aspro648/KiCad/README.md

# KiCad
My design files. Abandon all hope ye who enter here.
