aspro648/KiCad/projects/translator/README.md

ISP Translator
----------------

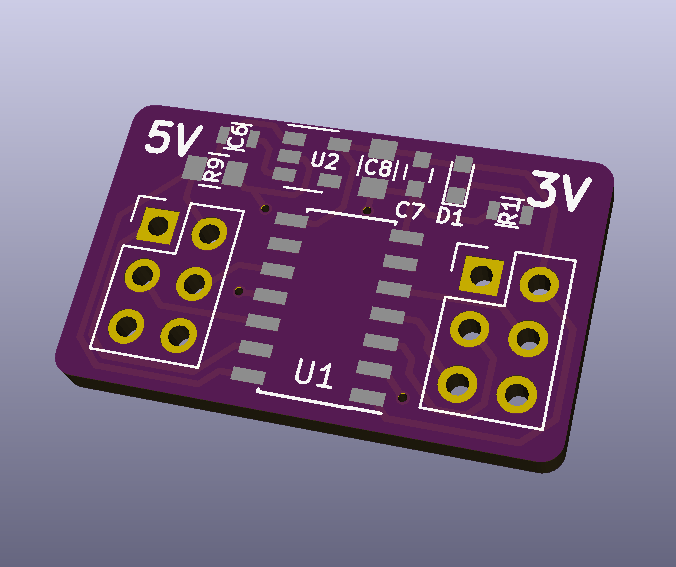
[picture p6: projects/translator/images/project.png]
 
Intro

Bill Of Materials
----------------
  
- 1 ea., Perfect Purple PCB from OSH Park, with not so perfect layout from [design_files](design_files/) folder.
- 1 ea., U1, IC TRNSLTR BIDIRECTIONAL 14SOIC, TI TXB0104D, https://www.digikey.com/short/j5d3ph
- 1 ea., U2, IC REG LINEAR 3.3V 150MA SOT23-5, MIC5225-3.3YM5-TR, https://www.digikey.com/short/jb2rq8
- 2 ea., C1, C3, 10uF SMD 0805, https://www.digikey.com/short/j5d39w 
- 1 ea., C2 1uF SMD 0603, https://www.digikey.com/short/j5d397
- 1 ea., R1, RES SMD 330 OHM 5% 1/10W 0603, Yageo RC0603JR-07330RL, https://www.digikey.com/short/3wzz20
- 1 ea., R2, 100K ohm 0603 SMD resistor, https://www.digikey.com/short/j5d3b3
- 1 ea., D1, 603 SMD LED amber, https://www.digikey.com/short/j5h3h5
- 2 ea., CON1, CON2, CONN HEADER 6POS .100 STR TIN, http://www.digikey.com/short/3m33n0
- 2 ea., CONN SOCKET IDC 6POS DL SR 30AU, https://www.digikey.com/short/71rdpt
- ribbon cable

Design Files
----------------
This project is designed using Open Source [KiCad](http://kicad-pcb.org/). Design files are located in the [design_files](design_files/) folder.  You can oogle the [schematic](docs/project.sch.pdf).

Firmware
----------------
TBD

Assembly Instructions
----------------
TBD

License
----------------
[Attribution-ShareAlike 3.0 United States (CC BY-SA 3.0 US)](https://creativecommons.org/licenses/by-sa/3.0/us/)

You are free to:

- Share — copy and redistribute the material in any medium or format
- Adapt — remix, transform, and build upon the material

Under the following terms:

- Attribution — You must give appropriate credit, provide a link to the license, and indicate if changes were made. You may do so in any reasonable manner, but not in any way that suggests the licensor endorses you or your use.
- ShareAlike — If you remix, transform, or build upon the material, you must distribute your contributions under the same license as the original.
