aspro648/KiCad/projects/Beetje/design_files_SD_card/readme.md

Beetje Blok SD Card Rev 0.0

Project website: https://hackaday.io/project/160638-beetje-bloks

Project website: https://hackaday.io/project/160638-beetje-bloks

https://learn.adafruit.com/adafruit-micro-sd-breakout-board-card-tutorial?view=all

Bill Of Materials
----------------
  
- 1 ea., Perfect Purple PCB from OSH Park, with not so perfect layout from [design_files](design_files/) folder.
- 1 ea., J1 CONN MICRO SD CARD PUSH-PULL, Hirose DM3D-SF, https://www.digikey.com/short/jfh304
- 1 ea., C1 CAP CER 0.1UF 50V X7R 0805, https://www.digikey.com/short/j58qjp
- 1 ea., D1 LED 0805 SMD
- 1 ea., R1 RES 1K OHM 5% 0805, https://www.digikey.com/short/j2d0wt
- 1 ea., R2 10K SMD 0805, https://www.digikey.com/short/j2d0w4 
- 1 ea., CONN HEADER .100" SNGL STR 40POS, https://www.digikey.com/short/jfcn42
- 1 ea., 64-pin header(enough for 4.5 boards) Mill-max 311-43-164-41-001000, https://www.digikey.com/short/jnqdm2

License
----------------
[Attribution-ShareAlike 3.0 United States (CC BY-SA 3.0 US)](https://creativecommons.org/licenses/by-sa/3.0/us/)

You are free to:

- Share — copy and redistribute the material in any medium or format
- Adapt — remix, transform, and build upon the material

Under the following terms:

- Attribution — You must give appropriate credit, provide a link to the license, and indicate if changes were made. You may do so in any reasonable manner, but not in any way that suggests the licensor endorses you or your use.
- ShareAlike — If you remix, transform, or build upon the material, you must distribute your contributions under the same license as the original.
