aspro648/KiCad/projects/Beetje/design_files_OLED/readme.md

Beetje OLED

Beetje Block 

Project website: https://hackaday.io/project/160638-beetje-bloks

Based on SparkFun's [Micro OLED Breakout](https://www.sparkfun.com/products/13003)

Bill Of Materials
----------------

- 1 ea., Perfect Purple PCB from OSH Park, with not so perfect layout from [design_files](design_files/) folder.
- 1 ea., CrystalFonts display CFAL4864A, https://www.crystalfontz.com/product/cfal6448a066bw-64x48-small-graphic-oled
- 2 ea., R1, R2 RES 4K7 OHM 5% 0805, https://www.digikey.com/short/j2d0wd 
- 4 ea., R3 - R6 RES 10K OHM 5% 0805, 
- 1 ea., C1 CAP 1uF 0805, https://www.digikey.com/short/jwjfn1
- 2 ea., C2, C3 CAP CER 0.1UF 0805
- 1 ea., CONN FPC TOP 12POS 0.50MM R/A, TE 1-1734839-2, https://www.digikey.com/short/pzh9vc

Optional
----------------

- Headers

Revisions
------------------

License
----------------
[Attribution-ShareAlike 3.0 United States (CC BY-SA 3.0 US)](https://creativecommons.org/licenses/by-sa/3.0/us/)

You are free to:

- Share — copy and redistribute the material in any medium or format
- Adapt — remix, transform, and build upon the material

Under the following terms:

- Attribution — You must give appropriate credit, provide a link to the license, and indicate if changes were made. You may do so in any reasonable manner, but not in any way that suggests the licensor endorses you or your use.
- ShareAlike — If you remix, transform, or build upon the material, you must distribute your contributions under the same license as the original.
