aspro648/KiCad/projects/Beetje/design_files_EEPROM/readme.md

Beetje Blok Template

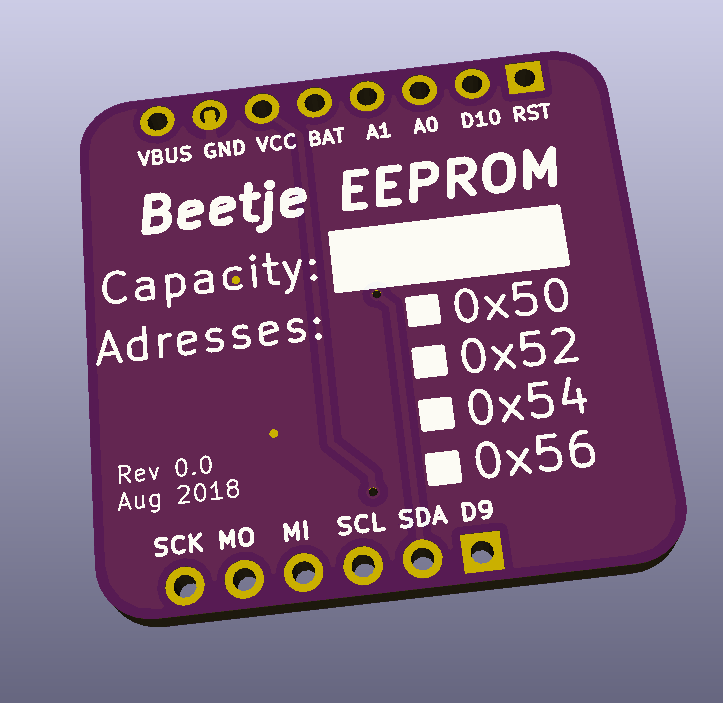
[picture p18: projects/Beetje/design_files_EEPROM/project.png]
Beetje Block


Based on https://jeelabs.org/2009/09/19/memory-plug-v1/

https://playground.arduino.cc/code/I2CEEPROM
https://www.instructables.com/id/Add-I2C-EEPROM-to-Arduino/
https://learn.sparkfun.com/tutorials/reading-and-writing-serial-eeproms

Bill Of Materials
----------------
  
- 1 ea., Perfect Purple PCB from OSH Park, with not so perfect layout from [project.kicad_pcb](project.kicad_pcb) file.
- 1 ea., C1 CAP CER 0.1UF 50V X7R 0805, https://www.digikey.com/short/j58qjp
- 1 ea., R1, R2 4K7 0805 SMD Resistor, https://www.digikey.com/short/j2d0wd

- 1 ea., U1, 24LC1025-I/SN-ND 1Mbit 8-SOIC, https://www.digikey.com/short/jwmp8v ($2.95), or
- 1 ea., U1, CAT24M01WI-GT3IC 1Mbit 8-SOIC, https://www.digikey.com/short/jwmpp7 ($1.33), or
RM24C512C FRAM 512K, https://www.digikey.com/short/jwmpqm ???
 or
- 1 ea., U1, IC EEPROM 1M I2C 400KHZ 8SOIC, https://www.digikey.com/short/jf10h0

Revisions
----------------
0.1 Sep 2018 Footprints from 0603 to 0805

License
----------------
[Attribution-ShareAlike 3.0 United States (CC BY-SA 3.0 US)](https://creativecommons.org/licenses/by-sa/3.0/us/)

You are free to:

- Share — copy and redistribute the material in any medium or format
- Adapt — remix, transform, and build upon the material

Under the following terms:

- Attribution — You must give appropriate credit, provide a link to the license, and indicate if changes were made. You may do so in any reasonable manner, but not in any way that suggests the licensor endorses you or your use.
- ShareAlike — If you remix, transform, or build upon the material, you must distribute your contributions under the same license as the original.
