aspro648/KiCad/projects/HotWheels/Attiny/readme.md

Hot Wheels Arduino

 

Project website: MakersBox.us

Bill Of Materials
----------------
- 1 ea., Perfect Purple PCB from OSH Park, with not so perfect layout from [design_files/project.kicad_pcb](project.kicad_pcb) file.
- 1 ea., IC MCU 8BIT 2KB FLASH 8SOIC, ATTINY25V-10SNR, https://www.digikey.com/short/33rrdb4v
- 1 ea., CAP CER 0.1UF 50V X7R 0805, https://www.digikey.com/short/0b2z0pmw
- 1 ea., Smallest 3.7 LiPo you can find (VERIFY CONNECTOR AND POLARITY).
	- TinyCircuits ASR0011 70mAh (16.0mm x 15.0mm x 5.0mm), https://www.digikey.com/short/z40wd0 (JST SH)
    - https://ebay.us/EZ1Aa7 (no connectors)
	
- 2 ea., PTC RESET FUSE 15V 100MA 0805, Bel Fuse 0ZCK0010FF2G, https://www.digikey.com/short/v24142q9
- 1 ea., JST SH CONN HEADER SMD R/A 2POS 1MM, SM02B-SRSS-TB(LF)(SN), https://www.digikey.com/short/z4vw0z
- 1 ea., PicoBlade CONN HEADER VERT 2POS 1.25MM, Molex 0530470210, https://www.digikey.com/short/bqtjcqnz
- 8 ea., RES SMD 100 OHM 5% 1/8W 0805, https://www.digikey.com/short/pm4bcz0b
- 3 ea., LED RED DIFFUSED 0805 SMD,  OSRAM LS R976-NR-1, https://www.digikey.com/short/438bvp
- 1 ea., LED blue SMD 0805, https://www.digikey.com/short/zz54h8 (UND, Dash) 
- 1 ea., SMD SPST switch, C&K JS102011SCQN, https://www.digikey.com/short/5m7mwm1b
- 2 ea., LED WHITE CLEAR 1204 SMD, Inlux IN-S124BRUW, https://www.digikey.com/short/5512nmf0 (headlights)

Revisions
------------------

License
----------------
[Attribution-ShareAlike 3.0 United States (CC BY-SA 3.0 US)](https://creativecommons.org/licenses/by-sa/3.0/us/)

You are free to:

- Share — copy and redistribute the material in any medium or format
- Adapt — remix, transform, and build upon the material

Under the following terms:

- Attribution — You must give appropriate credit, provide a link to the license, and indicate if changes were made. You may do so in any reasonable manner, but not in any way that suggests the licensor endorses you or your use.
- ShareAlike — If you remix, transform, or build upon the material, you must distribute your contributions under the same license as the original.
