aspro648/KiCad/projects/HotWheels/LiPo/readme.md

LiPo Battery Charger

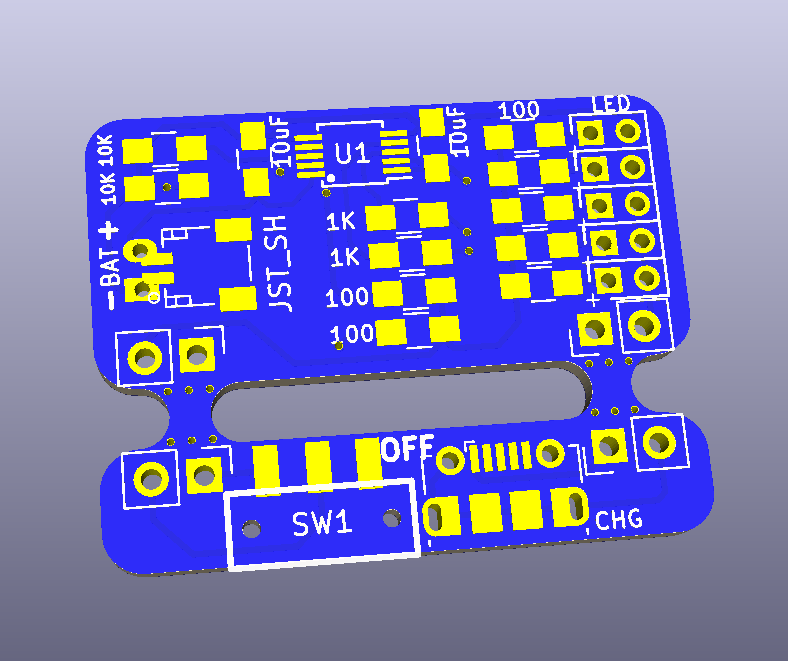
[picture p27: projects/HotWheels/LiPo/project.png]
LiPo
 

Project website: MakersBox.us

Based on Adafruit's [USB LiIon/LiPoly charger - v1.2](https://learn.adafruit.com/li-ion-and-lipoly-batteries/downloads)

Bill Of Materials
----------------
- 1 ea., Perfect Purple PCB from OSH Park, with not so perfect layout from [design_files/project.kicad_pcb](project.kicad_pcb) file.
- 2 ea., CAP CER 10UF 10V X5R 0805, https://www.digikey.com/short/zz5p5h
- 1 ea., U1 IC LI-ION/LI-POLY CTRLR 10MSOP, MCP73833T-AMI/UN, https://www.digikey.com/short/zjdzwb
- 1 ea., Picoblade CONN HEADER R/A 2POS 1.25MM, Molex 0530480210, https://www.digikey.com/short/9zm95cz3
- 2 ea., Resistor 10K SMD 0805, https://www.digikey.com/short/j2d0w4
- 2 ea., Resistor 1K SMD 0805, https://www.digikey.com/short/j2d0wt
- 1 ea., LED green SMD 0805, https://www.digikey.com/short/j20p1h
- 1 ea., LED RED DIFFUSED 0805 SMD,  OSRAM LS R976-NR-1, https://www.digikey.com/short/438bvp
- 1 ea., CONN RCPT MICRO USB R/A SMD, Molex 1050170001, https://www.digikey.com/short/jb2205
- 2 ea., Picoblade CONN HOUSING 3POS 1.25MM NATURAL, Molex 0510210200, https://www.digikey.com/short/bbprj5rf
- 1 ea., 10" PRE-CRIMP 1852 RED, https://www.digikey.com/short/p937zh
- 1 ea., 10" PRE-CRIMP 1852 BLACK, https://www.digikey.com/short/p937zv

Revisions
------------------
- 0.0 April 2020 Initial Design (untested, but based on working Beetje LiPo schematic).
- 0.6 Feb 2021 Simplfied layout for charging only

License
----------------
[Attribution-ShareAlike 3.0 United States (CC BY-SA 3.0 US)](https://creativecommons.org/licenses/by-sa/3.0/us/)

You are free to:

- Share — copy and redistribute the material in any medium or format
- Adapt — remix, transform, and build upon the material

Under the following terms:

- Attribution — You must give appropriate credit, provide a link to the license, and indicate if changes were made. You may do so in any reasonable manner, but not in any way that suggests the licensor endorses you or your use.
- ShareAlike — If you remix, transform, or build upon the material, you must distribute your contributions under the same license as the original.
