aspro648/KiCad/projects/HotWheels/IR/readme.md

IR Track Sensor
============

Project 

Bill Of Materials
=================
  
- 1 ea. Perfect Purple PCB from OSH Park, https://oshpark.com/shared_projects/lpA38MDw

- 1 ea., U1, ATMEGA32U4-AU, IC MCU 8BIT 32KB FLASH 44TQFP, https://www.digikey.com/short/jb25pc
- 1 ea,, CAP CER 10UF 16V X5R 0805, https://www.digikey.com/short/j5d39w 
- 1 ea., CAP CER 1UF 16V Y5V 0805, https://www.digikey.com/short/z9ff39
- 1 ea., CAP CER 0.1UF 25V Y5V 0805, https://www.digikey.com/short/z9fft1
- 1 ea., F1 PTC 1206, Bel 0ZCJ0025AF2E, https://www.digikey.com/short/jfcbc8
- 1 ea., CONN RCPT MICRO USB R/A SMD, Molex 1050170001, https://www.digikey.com/short/jb2205
- 1 ea., Resonator 8MHZ, CSTNE8M00G55Z000R0, https://www.digikey.com/short/jb22j1
- 2 ea., Photo Transistor, [Everlight PT928-6B-F](https://www.digikey.com/short/qtrp5m)
- 2 ea., IR Emitter, [Everlight IR928-6C-F](https://www.digikey.com/short/jzr3b8)
- 1 ea., CONN MOD JACK 8P8C R/A UNSHLD, https://www.digikey.com/short/z9fffp
- 2 ea., RES SMD 4.7K OHM 5% 1/8W 0805, https://www.digikey.com/short/z9ffzz
- 2 ea., 22 Ohm 5% 0805 SMD resistor, https://www.digikey.com/short/z9ffp2
- 2 ea., RES SMD 330 OHM 5% 1/8W 0805, Yageo RC0805JR-07330RL, https://www.digikey.com/short/3wzz2f 
- 2 ea., RES SMD 180 OHM 5% 1/8W 0805, Yageo RC0805JR-07180RL, https://www.digikey.com/short/zmwcbj
- 2 ea., RES SMD 10K OHM 5% 1/4W 0805, Yageo RC0805JR-0710KL, https://www.digikey.com/short/zmwc28
- 1 ea., 6mm tactile
- 2 ea., 5 mm LED
- 2 ea., 3 pin RA
- 1 ea., CONN HEADER R/A 4POS 1.25MM, https://www.digikey.com/short/z9f2qn
- 1 ea., CONN HOUSING 4POS 1.25MM NATURAL, https://www.digikey.com/short/z9f2j3
- 4 ea., 12" PRE-CRIMP 1852 BLACK, https://www.digikey.com/short/z9f2mj

Design Files
============
This project is designed using Open Source [KiCad](http://kicad-pcb.org/). Design files are located in the [design_files](design_files/) folder.  You can oogle the [schematic](images/base.sch.png).

Firmware
========
This project is programed using the Open Source [Arduino](https://www.arduino.cc/). I use my Open Source [AVR Programming Shield](https://www.tindie.com/products/MakersBox/yet-another-programming-shield/) to program the Attiny85. The firmware is located in the [firmware](firmware/) folder.

Assembly Instructions
=====================
You are on your own for now . . .

License
=======
[Attribution-ShareAlike 3.0 United States (CC BY-SA 3.0 US)](https://creativecommons.org/licenses/by-sa/3.0/us/)

You are free to:

- Share — copy and redistribute the material in any medium or format
- Adapt — remix, transform, and build upon the material

Under the following terms:

- Attribution — You must give appropriate credit, provide a link to the license, and indicate if changes were made. You may do so in any reasonable manner, but not in any way that suggests the licensor endorses you or your use.
- ShareAlike — If you remix, transform, or build upon the material, you must distribute your contributions under the same license as the original.
