aspro648/KiCad/projects/Nerf/ArduStryfe_MOSFET/readme.md

ArduStryfe MOSFET

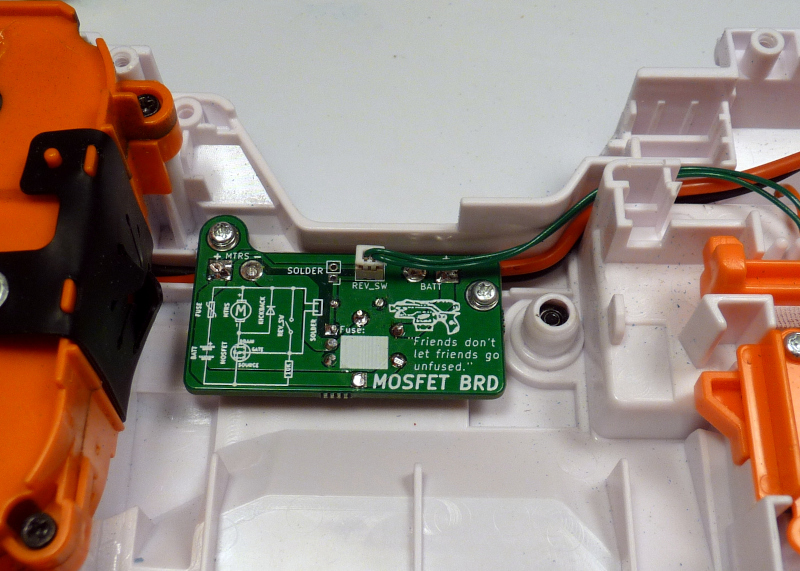
[picture p30: projects/Nerf/ArduStryfe_MOSFET/project.jpg]
 

Main Board
----------------
- 1 ea., 1N4001 1A Gen Purpose diode, https://www.digikey.com/short/p9ffm9
- 1 ea., MOSFET N-CH 30V 62A TO-220AB, Infineon IRLB8721PBF, https://www.digikey.com/short/p4fhcm
- 1 ea., PTC RESET FUSE, based on use case:
  - 2.5A @ 2s: AHEF050: https://www.digikey.com/short/prwn0r
  - 3.5A @ 2s: AHEF070: https://www.digikey.com/short/prwnv9
  - 5A @ 2s: MF-R090-2: https://www.digikey.com/short/prd0d7
  - 5A @ 3s: AHEF100: https://www.digikey.com/short/prd00r
- 1 ea., 10K Resistors, 1/8W 5% generic, https://www.digikey.com/short/p4frj2 
- 1 ea., 2POS Picoblade vertical header, https://www.digikey.com/short/p9twrj
- 1 ea., 2POS PicoBlade housing, https://www.digikey.com/short/p4wz0d
- 2 ea., 12" PRE-CRIMP 1852 BLACK, https://www.digikey.com/short/pbfbnd

Instructions:
---------------
- Introduction: https://youtu.be/5wztz3zYocw
- Board Assembly: https://youtu.be/rl1lUju0amI
- Blaster Prep: https://youtu.be/Yv6PZLno3lg
- Board Integration: https://youtu.be/C6j1vpwMKu0

Revisions
----------------

License
----------------
[Attribution-ShareAlike 3.0 United States (CC BY-SA 3.0 US)](https://creativecommons.org/licenses/by-sa/3.0/us/)

You are free to:

- Share — copy and redistribute the material in any medium or format
- Adapt — remix, transform, and build upon the material

Under the following terms:

- Attribution — You must give appropriate credit, provide a link to the license, and indicate if changes were made. You may do so in any reasonable manner, but not in any way that suggests the licensor endorses you or your use.
- ShareAlike — If you remix, transform, or build upon the material, you must distribute your contributions under the same license as the original.
