aspro648/KiCad/projects/Nerf/Ardu RapidStrike/readme.md

ArduStrike

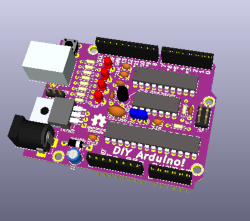
[picture p36: projects/Nerf/Ardu RapidStrike/images/project.png]
 

MOSFET Board
-------------
- 1 ea., MOSFET N-CH 30V 62A TO-220AB, Infineon IRLB8721PBF, https://www.digikey.com/short/p4fhcm
- 1 ea., 1N4001 1A Gen Purpose diode, https://www.digikey.com/short/p9ffm9
- 1 ea., 10K Resistors, 1/8W 5% generic, https://www.digikey.com/short/p4frj2 
- 1 ea., PTC RESET FUSE 16V 5A RADIAL, https://www.digikey.com/short/ph7qmn
- 3 ea., 2 POS 5.08mm terminal, https://www.digikey.com/short/p9tv29
high current options:
	- PTC RESET FUSE 16V 10A RADIAL, https://www.digikey.com/short/p9t07c
	- PTC RESET FUSE 16V 14A RADIAL, https://www.digikey.com/short/p9t07f
	or: Automotive Mini Blade Fuses
	- FUSE HOLDER BLADE 500V PCB, Keystone 3568, https://www.digikey.com/short/pmwt83
	- FUSE AUTO 15A 32VDC BLADE MINI, https://www.digikey.com/short/p9t0tm
	- FUSE AUTO 20A 32VDC BLADE MINI, https://www.digikey.com/short/p9t07f
	- FUSE AUTO 30A 32VDC BLADE MINI, https://www.digikey.com/short/pmwt4h

Pusher Board
-------------
- 1 ea., L293 H-Bridge, STMicroelectronics L293NE, https://www.digikey.com/short/pm20fd
- 2 ea., 10K Resistors, 1/8W 5% generic, https://www.digikey.com/short/p4frj2 
- 1 ea., CER 0.1UF 25V Y5V RADIAL 2.5mm lead spacing, generic, https://www.digikey.com/short/jn9pm2
- 1 ea., CER 1UF 25V X7R RADIAL 2.5 lead spacing, generic https://www.digikey.com/short/p4fr3w
- 1 ea., 5POS Picoblade header VERT, Molex 0530470510, https://www.digikey.com/short/pm2n8f
- 1 ea., PTC RESET FUSE 16V 2.5A RADIAL, https://www.digikey.com/short/pm20nc
- 2 ea., 2 POS 3.5mm terminal, https://www.digikey.com/short/p9tvn0
- 1 ea., 2 POS 5.08mm header, https://www.digikey.com/short/p9tv29

Trigger Board
--------------
- 1 ea., IC INVERTER SCHMITT 6CH 14DIP, TI SN74HC14N, https://www.digikey.com/short/pmzjfv
- 4 ea., CER 0.1UF 25V Y5V RADIAL 2.5mm lead spacing, generic, https://www.digikey.com/short/jn9pm2
- 4 ea., 1K Ohm Resistors, 1/8W 5% generic, https://www.digikey.com/short/p4fr81
- 4 ea., 10K Resistors, 1/8W 5% generic, https://www.digikey.com/short/p4frj2 
- 1 ea., 6POS PicoBlade header, https://www.digikey.com/short/p4wz22
- 1 ea., 2POS Picoblade header, https://www.digikey.com/short/p4wz0w

Main Board
----------------
- 1 ea., Atmega328P-PU https://www.digikey.com/short/jn57wj
- 1 ea., CER RES 16.0000MHZ 30PF T/H, ECS ZTT-16.00MX, https://www.digikey.com/short/jn9pjv
- 1 ea., IC REG LINEAR 5V 250MA TO92-3, Microchip MCP1702-5002E/TO, https://www.digikey.com/short/pm2nmj
- 3 ea., Hall Effect Sensor, Diodes Incorporated AH9246-P-B, https://www.digikey.com/short/p4f5dw
- 1 ea., 0.96 Inch 128x64 I2C OLED, https://www.amazon.com/gp/product/B072Q2X2LL/
- 1 ea., Header 6 POS RA, 

- 2 ea., CER 0.1UF 25V Y5V RADIAL 2.5mm lead spacing, generic, https://www.digikey.com/short/jn9pm2
- 2 ea., CER 1UF 25V X7R RADIAL 2.5 lead spacing, generic https://www.digikey.com/short/p4fr3w

- 1 ea., 3mm LED red, https://www.digikey.com/short/pmwzdf
- 1 ea., 3mm IR LED, https://www.digikey.com/short/pmwzdq
- 1 ea., NPN photo transistor, https://www.digikey.com/short/pmwzdb

- 1 ea., 100 ohm resistor 1/8W 5% generic, https://www.digikey.com/short/pmwz22
- 1 ea., 1K ohm resistor 1/8W 5% generic, https://www.digikey.com/short/pmwzwq
- 2 ea., 10K Resistors, 1/8W 5% generic, https://www.digikey.com/short/p4frj2 

- 1 ea., 10K Resistors, 1/4W 1%, https://www.digikey.com/short/p4fr2q
- 1 ea., 100K Resistors, 1/4W 1%, https://www.digikey.com/short/p9tnc3

- 1 ea., SWITCH TACTILE SPST-NO 0.05A 24V, https://www.digikey.com/short/p4w42v
- 1 ea., Piezo speaker, TDK PS1240P02CT3,  https://www.digikey.com/short/pmwzfc

- 1 ea., 2POS Picoblade header, https://www.digikey.com/short/p4wz0w
- 1 ea., 2POS PicoBlade housing, https://www.digikey.com/short/p4wz0d

- 1 ea., 3POS Picoblade header, https://www.digikey.com/short/pmwzfb
- 1 ea., 3POS PicoBlade housing, https://www.digikey.com/short/pmwzf2

- 1 ea., 4POS Picoblade header, https://www.digikey.com/short/p4wz0m
- 2 ea., 4POS PicoBlade housing, https://www.digikey.com/short/p4wzd1

- 1 ea., 5POS Picoblade header, https://www.digikey.com/short/p4wzdp
- 2 ea., 5POS PicoBlade housing, https://www.digikey.com/short/p4wzdb

- 1 ea., 6POS PicoBlade header, https://www.digikey.com/short/p4wz22
- 2 ea., 6POS PicoBlade housing, https://www.digikey.com/short/p4wz28

12" PRE-CRIMP 1853 RED, https://www.digikey.com/short/p4wzvf
12" PRE-CRIMP 1853 BLACK, https://www.digikey.com/short/p4wz1p
12" PRE-CRIMP 1853 BLUE, https://www.digikey.com/short/p4wz14
12" PRE-CRIMP 1853 ORANGE, https://www.digikey.com/short/p4wz1r
12" PRE-CRIMP 1853 GREEN, https://www.digikey.com/short/p4w4c4

10" PRE-CRIMP 1852 RED, https://www.digikey.com/short/p937zh
10" PRE-CRIMP 1852 BLACK, https://www.digikey.com/short/p937zv
10" PRE-CRIMP 1852 YELLOW, https://www.digikey.com/short/p9374t
10" PRE-CRIMP 1852 GREEN, https://www.digikey.com/short/p9374z
10" PRE-CRIMP 1852 ORANGE, https://www.digikey.com/short/p9374f
10" PRE-CRIMP 1852 BLUE, https://www.digikey.com/short/p937mc

16 AWG Silicone wire, https://www.amazon.com/BNTECHGO-Silicone-Flexible-Strands-Stranded/dp/B00TG1TRL2
18 AWG Silicone wire (7.5A, $0.40/ft), https://www.amazon.com/Silicone-Electrical-Conductor-Parallel-Flexible/dp/B07FMRDP87
16 AWG Silicone wire (12A, $0.70/ft), https://www.amazon.com/Silicone-Electrical-Conductor-Parallel-Flexible/dp/B07FMLVF84

XT60 connector male

Optional:
FTDI SERIAL TTL-232 USB CABLE, https://www.digikey.com/short/p4w47d
SPARKFUN FT231X BREAKOUT, https://www.digikey.com/short/p4w4qb

Motor Spec Sheet:
----------------
https://docs.google.com/spreadsheets/d/12gOU-GbuqdGVzpOjZJvQ_gq1Nmw63c_sd13Wt4bfn1E/edit#gid=0

Revisions
----------------
0.1 Added push button to A0.
0.3 Removed XT30 connectors, added PTC, fuse holder.
0.4 Major component repositioning
0.5 Trigger moved clip connector
	Pusher Bat conn to 5.08mm.
	Mosfet layout change

License
----------------
[Attribution-ShareAlike 3.0 United States (CC BY-SA 3.0 US)](https://creativecommons.org/licenses/by-sa/3.0/us/)

You are free to:

- Share — copy and redistribute the material in any medium or format
- Adapt — remix, transform, and build upon the material

Under the following terms:

- Attribution — You must give appropriate credit, provide a link to the license, and indicate if changes were made. You may do so in any reasonable manner, but not in any way that suggests the licensor endorses you or your use.
- ShareAlike — If you remix, transform, or build upon the material, you must distribute your contributions under the same license as the original.
