aspro648/KiCad/projects/Nerf/NerfMuzzleFlash/readme.md

Muzzle Flash for Nerf

Project 

Bill Of Materials
----------------
  
- 1 ea., Perfect Purple PCB from OSH Park, with not so perfect layout from [design_files/project.kicad_pcb](design_files/project.kicad_pcb) file.
- 1 ea., Q1 MOSFET N-CH 20V 530MA TO92-3, Microchip TN0702N3-G, https://www.digikey.com/short/pjvt3t
- 5 ea., White 5mm LED, large viewing angle, high intensity, https://www.digikey.com/short/pjvt8v
- 5 ea., current limiting resistors, based on 3Vf, 20mA:
  - 3.7V (1S) = 39 ohm
  - 4.5V (3AA) = 82 ohm
  - 7.2V (2S) = 220 ohm 
  - 11V (3S) = 470 ohm
- 1 ea., 10K pulldown resistor, https://www.digikey.com/short/7thw1q

Revisions
------------------

License
----------------
[Attribution-ShareAlike 3.0 United States (CC BY-SA 3.0 US)](https://creativecommons.org/licenses/by-sa/3.0/us/)

You are free to:

- Share — copy and redistribute the material in any medium or format
- Adapt — remix, transform, and build upon the material

Under the following terms:

- Attribution — You must give appropriate credit, provide a link to the license, and indicate if changes were made. You may do so in any reasonable manner, but not in any way that suggests the licensor endorses you or your use.
- ShareAlike — If you remix, transform, or build upon the material, you must distribute your contributions under the same license as the original.
