aspro648/KiCad/projects/Nerf/NerfMuzzleFlash 2/readme.md

Muzzle Flash for Nerf

Project 

Bill Of Materials
----------------
  
- 1 ea., Perfect Purple PCB from OSH Park, with not so perfect layout from [design_files/project.kicad_pcb](design_files/project.kicad_pcb) file.
- 1 ea., Q1 MOSFET N-CH 20V 530MA TO92-3, Microchip TN0702N3-G, https://www.digikey.com/short/pjvt3t
- 5 ea., White 5mm LED, large viewing angle, high intensity, https://www.digikey.com/short/pjvt8v
- 5 ea., 39 ohm 1/8W 5% current limiting resistors, based on 3Vf, 20mA, https://www.digikey.com/short/pzhb8q
- 1 ea., 10K 1/8W 5% pulldown resistor, https://www.digikey.com/short/7thw1q
- 1 ea. Photo Transistor, [Everlight PT928-6B-F](https://www.digikey.com/short/qtrp5m)
- 1 ea. IR Emitter, [Everlight IR928-6C-F](https://www.digikey.com/short/jzr3b8)
- 1 ea. 100 ohm resistor 1/8W 5%, [Stackpole CF18JT100R](https://www.digikey.com/short/q72818)
- 1 ea., male-male 12" jumper wires, [Adafruit 1955], (https://www.digikey.com/short/pzhhrt)
- 1 ea., Adafruit ItsyBitys 8Mhz 3V, [Adafruit 3675], (https://www.digikey.com/short/pzhhwj )

Revisions
------------------
0.1 - Moved Mosfet to low-side. Resized to fit over 3/4" PVC.  Added photo gate.

License
----------------
[Attribution-ShareAlike 3.0 United States (CC BY-SA 3.0 US)](https://creativecommons.org/licenses/by-sa/3.0/us/)

You are free to:

- Share — copy and redistribute the material in any medium or format
- Adapt — remix, transform, and build upon the material

Under the following terms:

- Attribution — You must give appropriate credit, provide a link to the license, and indicate if changes were made. You may do so in any reasonable manner, but not in any way that suggests the licensor endorses you or your use.
- ShareAlike — If you remix, transform, or build upon the material, you must distribute your contributions under the same license as the original.
