aspro648/KiCad/projects/Attiny/Cylon sew 2/README.md

Introduction
============

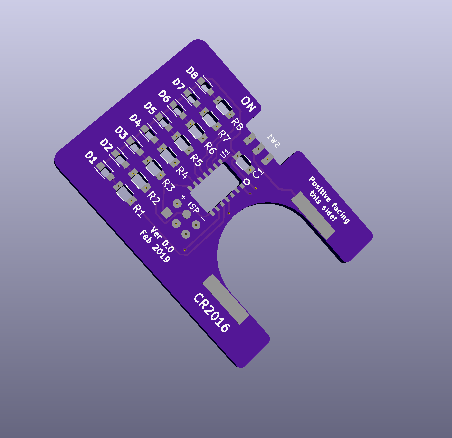
[picture p38: projects/Attiny/Cylon sew 2/images/project.png]
Project
 

A test PCB to see about mounting components in cutouts.

Bill Of Materials
================= 

Design Files
============
This project is designed using Open Source [KiCad](http://kicad-pcb.org/). Design files are located in the [design_files](design_files/) folder.  You can oogle the [schematic](images/project.sch.png).

Firmware
========
This project is programed using the Open Source [Arduino](https://www.arduino.cc/). I use my Open Source [AVR Programming Shield](https://www.tindie.com/products/MakersBox/yet-another-programming-shield/) to program the Attiny. The firmware is located in the [firmware](firmware/) folder.

Assembly Instructions
=====================
I have posted [minimal instructions at HackADay](https://hackaday.io/project/25265-an-unfortunate-smd-project).

License
=======
[Attribution-ShareAlike 3.0 United States (CC BY-SA 3.0 US)](https://creativecommons.org/licenses/by-sa/3.0/us/)

You are free to:

- Share — copy and redistribute the material in any medium or format
- Adapt — remix, transform, and build upon the material

Under the following terms:

- Attribution — You must give appropriate credit, provide a link to the license, and indicate if changes were made. You may do so in any reasonable manner, but not in any way that suggests the licensor endorses you or your use.
- ShareAlike — If you remix, transform, or build upon the material, you must distribute your contributions under the same license as the original.
