aspro648/KiCad/projects/HotWheels/Attiny/design_files Attiny826 LIS2 V1/readme.md

LIS2 board for LED Lights

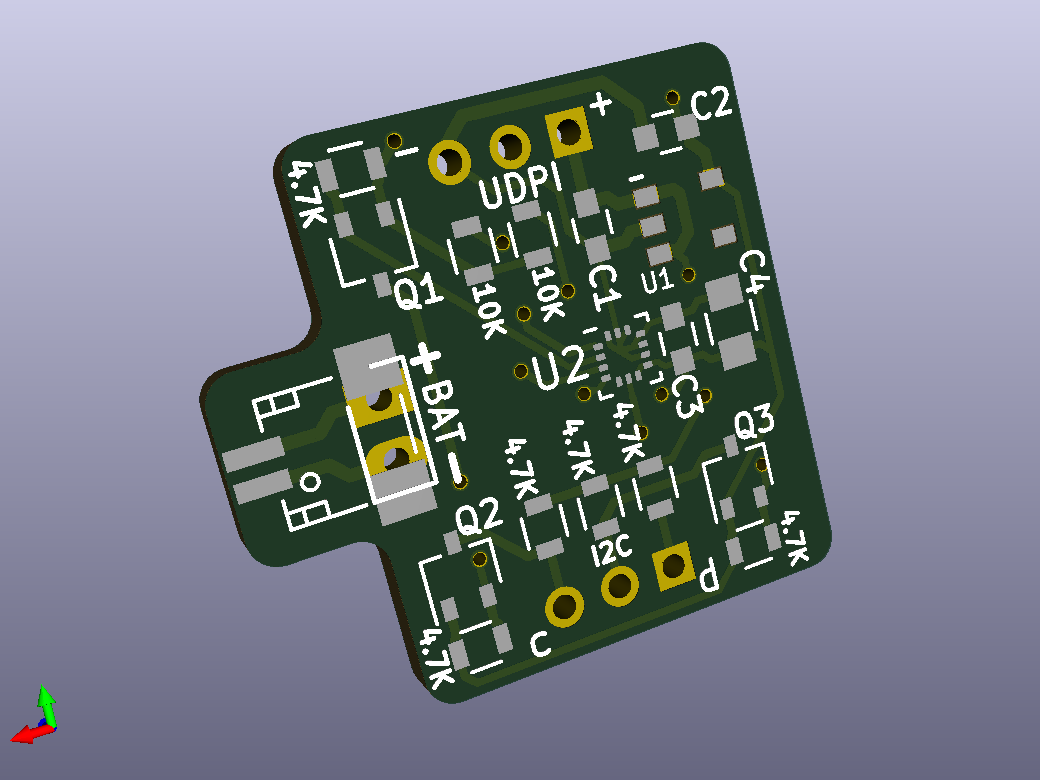
[picture p48: projects/HotWheels/Attiny/design_files Attiny826 LIS2 V1/project.png]
 

Project website: MakersBox.us

Bill Of Materials
----------------
- 1 ea., Perfect Purple PCB from OSH Park, with not so perfect layout from [design_files/project.kicad_pcb](project.kicad_pcb) file.
- 1 ea., LIS2DH12TR, ACCEL 2-16G I2C/SPI 12LGA, https://www.digikey.com/short/2hhnjtq9
- 1 ea., LIS2HH12TR, ACCELEROMETER 2-8G I2C/SPI 12LGA, https://www.digikey.com/short/5dww281d
- 1 ea., IC REG LINEAR 3.3V 200MA SMV SOT-753
    - Toshiba TCR2EF33, https://www.digikey.com/short/twnnv0q2
	- Diodes Incorporated AP7354-33W5-7, https://www.digikey.com/short/mwt0cr4v
- 3 ea., MOSFET N-CH 60V 280MA SOT323-3
    - Nexperia USA Inc., BSS138PW, https://www.digikey.com/short/zbn8bp5t
    - Infineon Technologies, BSS138WH6433XTMA1, https://www.digikey.com/short/9pr0qbn3
	- Diodes Inc BSS138W-7-F, https://www.digikey.com/short/ptn4zw78 
- 1 ea., CAP CER 10uF 0805, https://www.digikey.com/short/hbvp3nn5 
- 3 ea., CAP CER 0.1uF 0605, https://www.digikey.com/short/h3jddqhm 
- 6 ea., 4.7K SMD 0605, https://www.digikey.com/short/54v5jbfm
- 2 ea., 10K SMD 0605, https://www.digikey.com/short/2cd3frf7

Revisions
------------------

License
----------------
[Attribution-ShareAlike 3.0 United States (CC BY-SA 3.0 US)](https://creativecommons.org/licenses/by-sa/3.0/us/)

You are free to:

- Share — copy and redistribute the material in any medium or format
- Adapt — remix, transform, and build upon the material

Under the following terms:

- Attribution — You must give appropriate credit, provide a link to the license, and indicate if changes were made. You may do so in any reasonable manner, but not in any way that suggests the licensor endorses you or your use.
- ShareAlike — If you remix, transform, or build upon the material, you must distribute your contributions under the same license as the original.
