aspro648/KiCad/projects/Nerf/ArduStryfe/design_files Stryfe V05/readme.md

ArduStryfe 

 

Main Board
----------------
- 1 ea., Atmega328P-PU https://www.digikey.com/short/jn57wj
- 1 ea., CER RES 16.0000MHZ 30PF T/H, ECS ZTT-16.00MX, https://www.digikey.com/short/jn9pjv
- 1 ea., IC REG LINEAR 5V 250MA TO92-3, Microchip MCP1702-5002E/TO, https://www.digikey.com/short/pm2nmj
- 1 ea., 1N4001 1A Gen Purpose diode, https://www.digikey.com/short/p9ffm9
- 3 ea., Hall Effect Sensor, Diodes Incorporated AH9246-P-B, https://www.digikey.com/short/p4f5dw
- 1 ea., MOSFET N-CH 30V 58A DPAK, Infineon IRLR8729, https://www.digikey.com/short/pm0rdq
- 1 ea., PTC RESET FUSE 16V 2.5A RADIAL, Littlefuse RGEF250, https://www.digikey.com/short/pbfb9c
- 4 ea., CER 0.1UF 25V Y5V RADIAL 2.5mm lead spacing, generic, https://www.digikey.com/short/jn9pm2
- 2 ea., CER 1UF 25V X7R RADIAL 2.5 lead spacing, generic https://www.digikey.com/short/p4fr3w
- 1 ea., 0.96 Inch 128x64 I2C OLED, https://www.amazon.com/gp/product/B072Q2X2LL/
- 1 ea., Header 40POS, https://www.digikey.com/short/p9tntc
- 1 ea., 3mm LED red, https://www.digikey.com/short/pmwzdf
- 1 ea., 3mm IR LED, https://www.digikey.com/short/pmwzdq
- 1 ea., NPN photo transistor, https://www.digikey.com/short/pmwzdb

- 1 ea., 100 ohm resistor 1/8W 5% generic, https://www.digikey.com/short/pmwz22
- 1 ea., 330 ohm resistor 1/8W 5% generic, 
- 2 ea., 1K ohm resistor 1/8W 5% generic, https://www.digikey.com/short/pmwzwq
- 5 ea., 10K Resistors, 1/8W 5% generic, https://www.digikey.com/short/p4frj2 

- 1 ea., 10K Resistors, 1/4W 1%, https://www.digikey.com/short/p4fr2q
- 1 ea., 100K Resistors, 1/4W 1%, https://www.digikey.com/short/p9tnc3

- 1 ea., SWITCH TACTILE SPST-NO 0.05A 24V, https://www.digikey.com/short/p4w42v
- 1 ea., Piezo speaker, TDK PS1240P02CT3,  https://www.digikey.com/short/pmwzfc

- 4 ea., 2POS Picoblade vertical header, https://www.digikey.com/short/p9twrj
- 4 ea., 2POS PicoBlade housing, https://www.digikey.com/short/p4wz0d

- 1 ea., 3POS Picoblade vertical header, https://www.digikey.com/short/p9twr2
- 1 ea., 3POS PicoBlade housing, https://www.digikey.com/short/pmwzf2

- 1 ea., 4POS Picoblade header, https://www.digikey.com/short/p9tw2z or https://www.mouser.com/ProductDetail/Molex/53047-0410?qs=DcEdecHHM4i8IPBxVAuJtg%3D%3D#.XR5yWR8Gu1Y.gmail
- 1 ea., 4POS PicoBlade housing, https://www.digikey.com/short/p4wzd1

- 2 ea., 12" PRE-CRIMP 1852 RED, https://www.digikey.com/short/pbfbnb
- 2 ea., 12" PRE-CRIMP 1852 BLACK, https://www.digikey.com/short/pbfbnd
- 1.5 ea., 12" PRE-CRIMP 1852 BLUE, https://www.digikey.com/short/pbfb03
- 2 ea., 12" PRE-CRIMP 1852 ORANGE, https://www.digikey.com/short/pbfb0m
- 2 ea., 12" PRE-CRIMP 1852 GREEN, https://www.digikey.com/short/pbfbdj
- 1 ea., 12" PRE-CRIMP 1852 YELLOW, https://www.digikey.com/short/pbfbdn

18 AWG Silicone wire https://www.amazon.com/gp/product/B01C5CANVG/ref=ox_sc_act_title_1?smid=AITZO53LNBA1K&psc=1

XT60 connector male, https://hobbyking.com/en_us/xt60u-xt60-upgrade-male-5-pieces.html
https://www.banggood.com/5X-Upgraded-Amass-XT60U-Male-Female-Bullet-Connectors-Plugs-for-Lipo-Battery-1-Pairs-p-1045338.html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

Optional:
FTDI SERIAL TTL-232 USB CABLE, https://www.digikey.com/short/p4w47d
SPARKFUN FT231X BREAKOUT, https://www.digikey.com/short/p4w4qb
PTC RESET FUSE 16V 5A RADIAL, https://www.digikey.com/short/ph7qmn
PTC RESET FUSE 16V 900MA RADIAL, https://www.digikey.com/short/pbw32n

Motor Spec Sheet:
----------------
https://docs.google.com/spreadsheets/d/12gOU-GbuqdGVzpOjZJvQ_gq1Nmw63c_sd13Wt4bfn1E/edit#gid=0

Revisions
----------------

License
----------------
[Attribution-ShareAlike 3.0 United States (CC BY-SA 3.0 US)](https://creativecommons.org/licenses/by-sa/3.0/us/)

You are free to:

- Share — copy and redistribute the material in any medium or format
- Adapt — remix, transform, and build upon the material

Under the following terms:

- Attribution — You must give appropriate credit, provide a link to the license, and indicate if changes were made. You may do so in any reasonable manner, but not in any way that suggests the licensor endorses you or your use.
- ShareAlike — If you remix, transform, or build upon the material, you must distribute your contributions under the same license as the original.
