aspro648/KiCad/projects/ICanSolder/iTeam I Can Solder/design_files/readme.md

 - Designed with [KiCad 4.0.7](http://kicad-pcb.org/).  
 - All footprints located in [/footprints.pretty](/footprints.pretty) folder. 
 - All schematic symbols locaated in [/lib_sch](/lib_sch) folder.
 -  See [Anool Mahidharia's post](https://hackaday.com/2017/05/18/kicad-best-practises-library-management/) for hints on KiCad workflow and library management.
