aspro648/KiCad/projects/clock/design_files_MCP7940/project.html

# C:/Users/Maker's Box/Documents/git/KiCad/projects/MCP7940/design_files/project.sch

2/25/2018 4:36:58 PM

Eeschema 4.0.7

Component Count:17

Ref | Qnty | Value | Part | Datasheet | Description | Vendor
C1 | 1 | 0.1uF | device:C | | Unpolarized capacitor
C2 | 1 | 100pF | device:C | | Unpolarized capacitor
CX1, CX2 | 2 | 10pF | device:C | | Unpolarized capacitor
Crystal1 | 1 | 32.768 | device:Crystal | | Two pin crystal
D1 | 1 | D_Schottky | device:D_Schottky | | Schottky diode
JL1, JR1 | 2 | Conn_01x04 | conn:Conn_01x04 | | Generic connector, single row, 01x04
P1, P2, P3, P4 | 4 | Pin | conn:Conn_01x01 | | Generic connector, single row, 01x01
R1 | 1 | 1K | device:R | | Resistor
R2, R3 | 2 | 2K | device:R | | Resistor
R4 | 1 | 10K | device:R | | Resistor
U1 | 1 | RTC | maxim:DS1307+
