aspro648/KiCad/projects/Beetje/design_files_press_diff/resistors.ods

Vin | r1 | r2 | Vout | Val
3.3 | 10000 | 0 | 0.00 | 1023
3.3 | 10000 | 470 | 0.15 | 977
3.3 | 10000 | 1000 | 0.30 | 930
3.3 | 4700 | 1000 | 0.58 | 844
3.3 | 10000 | 4700 | 1.06 | 696
3.3 | 4700 | 4700 | 1.65 | 512
3.3 | 4700 | 10000 | 2.24 | 327
3.3 | 1000 | 10000 | 3.00 | 93
3.3 | NP | 10000 | 3.30 | 0
