aspro648/KiCad/projects/Nerf/Ardu RapidStrike/design_files V08 SMD 2 MOSFET/MOSFET_duracell_unfused.csv

Adafruit INA260 Test
Found INA260 chip
time (ms) | rpm | mA | V
1352 | 0 | 0.00 | 6.33
1363 | 0 | 1187.50 | 6.33
1374 | 0 | 3040.00 | 4.82
1385 | 0 | 2985.00 | 4.84
1396 | 0 | 2868.75 | 4.86
1408 | 0 | 2826.25 | 4.89
1420 | 42 | 2722.50 | 4.97
1432 | 42 | 2585.00 | 4.93
1444 | 1988 | 2598.75 | 5.03
1455 | 1988 | 2488.75 | 5.02
1466 | 2773 | 2393.75 | 4.98
1477 | 2773 | 2352.50 | 5.08
1488 | 3315 | 2308.75 | 5.09
1499 | 3783 | 2203.75 | 5.12
1511 | 4156 | 2263.75 | 5.10
1523 | 4503 | 2131.25 | 5.15
1534 | 4807 | 2038.75 | 5.16
1545 | 4807 | 2026.25 | 5.16
1556 | 5084 | 1968.75 | 5.18
1567 | 5574 | 1903.75 | 5.22
1579 | 5793 | 1895.00 | 5.24
1590 | 6000 | 1791.25 | 5.24
1601 | 6195 | 1795.00 | 5.25
1612 | 6377 | 1760.00 | 5.29
1623 | 6550 | 1692.50 | 5.28
1634 | 6874 | 1718.75 | 5.32
1645 | 7029 | 1628.75 | 5.34
1656 | 7190 | 1583.75 | 5.35
1667 | 7299 | 1556.25 | 5.35
1679 | 7591 | 1551.25 | 5.39
1690 | 7712 | 1491.25 | 5.38
1702 | 7936 | 1518.75 | 5.37
1713 | 8156 | 1450.00 | 5.41
1724 | 8264 | 1402.50 | 5.42
1735 | 8474 | 1435.00 | 5.45
1746 | 8556 | 1353.75 | 5.43
1757 | 8741 | 1341.25 | 5.45
1768 | 8833 | 1333.75 | 5.46
1780 | 9003 | 1358.75 | 5.49
1793 | 9168 | 1333.75 | 5.49
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
