aspro648/KiCad/projects/LEGO/design_files_attiny826_LiPo V0/readme.md

Beetje Blok 32U4

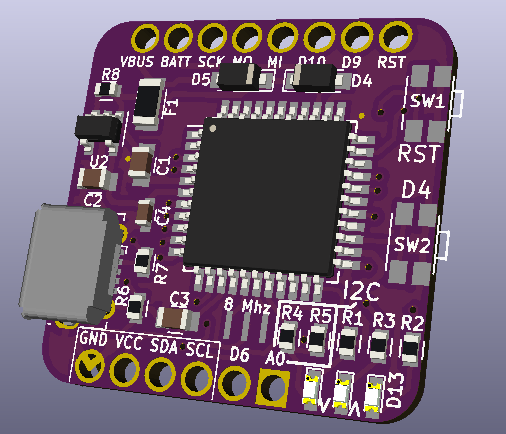
[picture p49: projects/LEGO/design_files_attiny826_LiPo V0/project.png]
Beetje Block
 

Based on Adafruit's [ItsyBitsy](https://learn.adafruit.com/introducting-itsy-bitsy-32u4) and SparkFun's [Pro Micro](https://www.sparkfun.com/products/12587) 3.3V/8Mhz versions.

Project page on [Hack-A-Day](https://hackaday.io/project/160638-beetje-bloks).

This is the first "dev blok" for this proof-of-concept project.  It is a KiCad mash-up of Adafruit's [ItsyBity](https://learn.adafruit.com/introducting-itsy-bitsy-32u4) and SparkFun's [Pro Micro](https://www.sparkfun.com/products/12587), jammed into Hack-A-Day's [Once Square Inch Scheme](https://hackaday.io/project/7813-the-square-inch-project) ("HADOSIS").

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

Headers:
--------

- J2, CONN HEADER FEMALE 6POS .1" GOLD, https://www.digikey.com/short/jfcnz3
- J4, CONN HEADER FEMALE 8POS .1" GOLD, https://www.digikey.com/short/jfcnzj
   or
- Stacking Arduino headers like https://www.digikey.com/short/jfcnz3
   or
- 1 ea., 64-pin header(enough for 4.5 boards) Mill-max 311-43-164-41-001000, https://www.digikey.com/short/jnqdm2
   or
- 1 ea., CONN SOCKET SIP 8POS GOLD, Mill-Max 315-47-108-41-001000, https://www.digikey.com/short/jn51q5
- 1 ea., CONN SOCKET SIP 6POS GOLD, Mill-Max 315-47-106-41-001000, https://www.digikey.com/short/jn5188

Revisions
----------------
- Revision 0.1 - Diodes and polyfuse to front.
- Revision 0.2 - I2C pullups, added SW2, enlarge holes for headers.
- Revision 0.3 - Pinout change, rerouted. NOT BACKWARD COMPATIBLE.
- Revision 0.4 - Renumbering, reordering references.
- Revision 0.5 - Enlarge holes again (for 801 series headers).
                 Switch to global beetje_footprints library.

License
----------------
[Attribution-ShareAlike 3.0 United States (CC BY-SA 3.0 US)](https://creativecommons.org/licenses/by-sa/3.0/us/)

You are free to:

- Share — copy and redistribute the material in any medium or format
- Adapt — remix, transform, and build upon the material

Under the following terms:

- Attribution — You must give appropriate credit, provide a link to the license, and indicate if changes were made. You may do so in any reasonable manner, but not in any way that suggests the licensor endorses you or your use.
- ShareAlike — If you remix, transform, or build upon the material, you must distribute your contributions under the same license as the original.
