aspro648/KiCad/Inkscape/63Chevy2/body and chassis.jpg

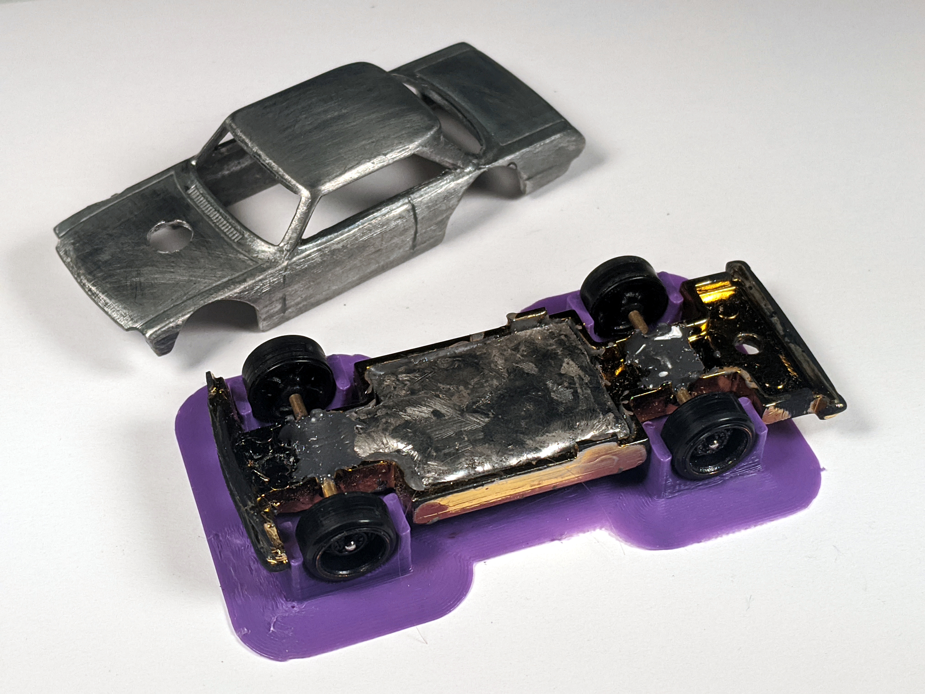
Inkscape/63Chevy2/body and chassis.jpg
