aspro648/KiCad/Inkscape/63Chevy2/chassis and weight.jpg

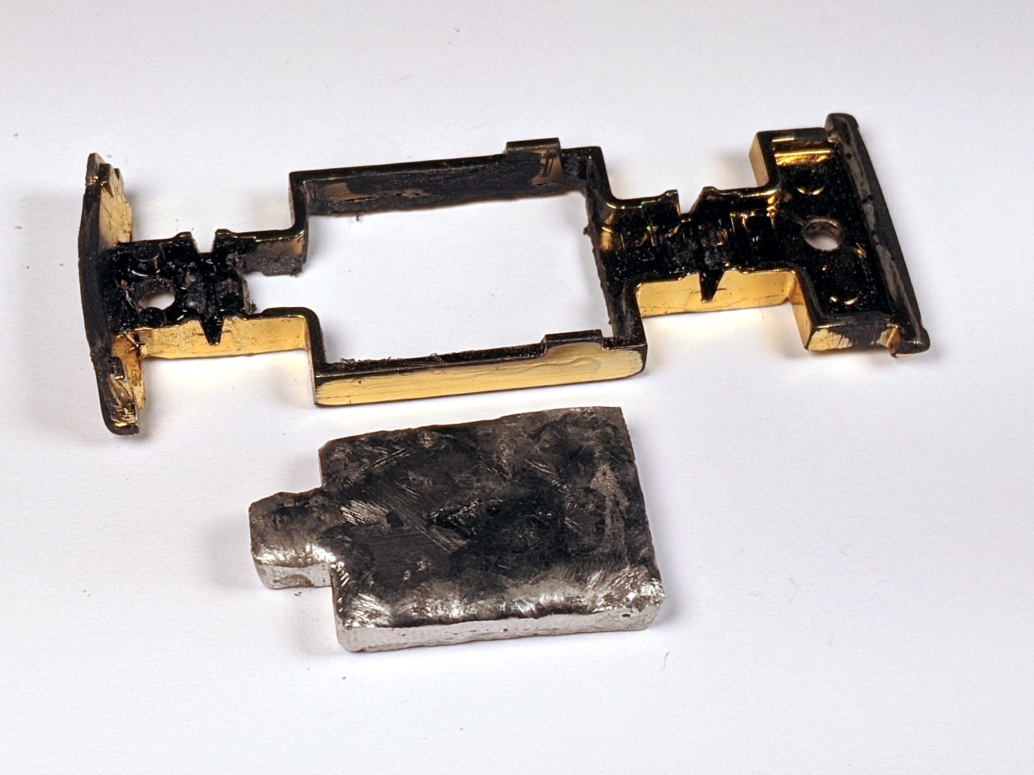
Inkscape/63Chevy2/chassis and weight.jpg
