aspro648/KiCad/Inkscape/Catzilla/seamless-grunge-stained-paper-texture.jpg

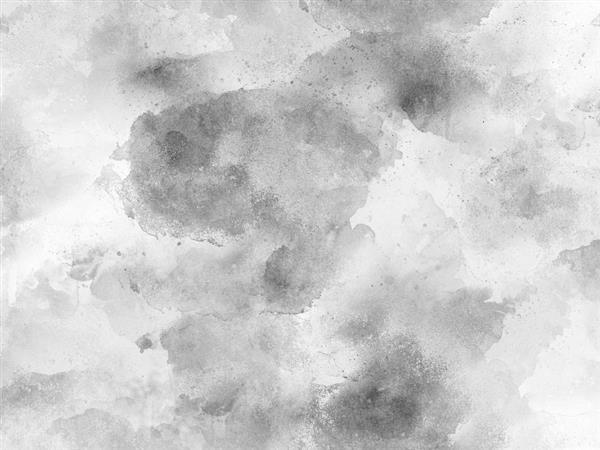
Inkscape/Catzilla/seamless-grunge-stained-paper-texture.jpg
