aspro648/KiCad/projects/Altimeter2/images/LEDeyes2.jpg

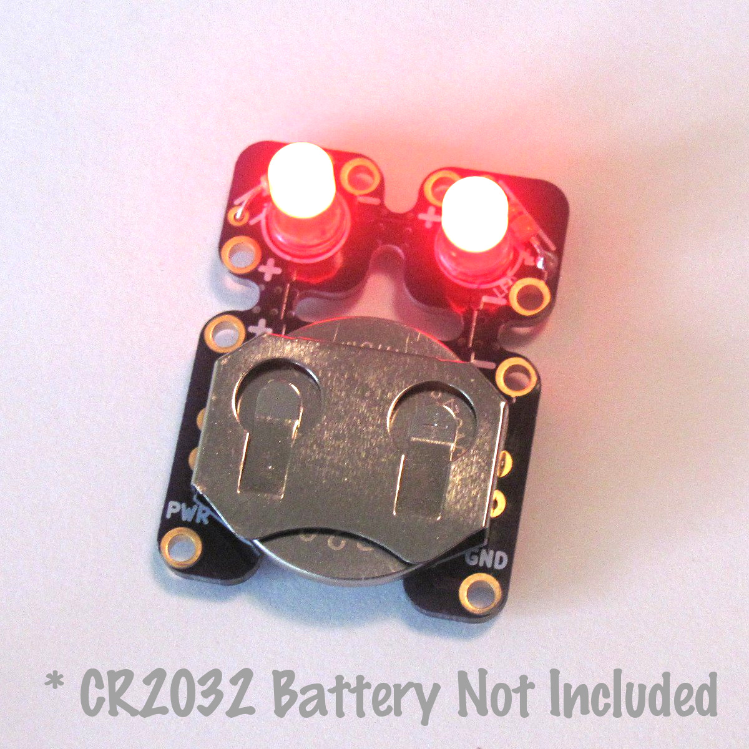
projects/Altimeter2/images/LEDeyes2.jpg
