aspro648/KiCad/projects/Altimeter2/images/LEDeyes label.png

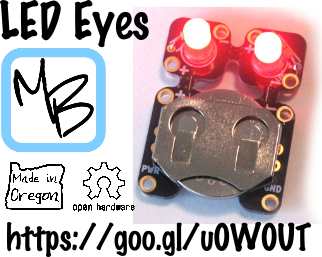
projects/Altimeter2/images/LEDeyes label.png
