aspro648/KiCad/projects/Altimeter2/images/LEDeyes.jpg

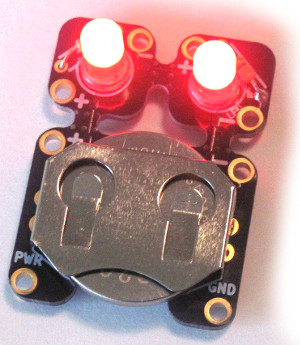
projects/Altimeter2/images/LEDeyes.jpg
