aspro648/KiCad/projects/Art/images/cube_copper.png

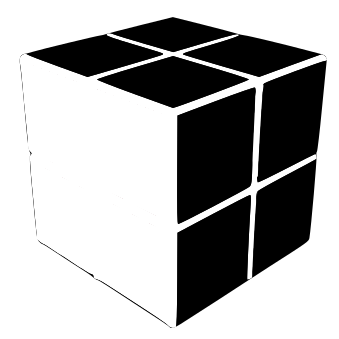
projects/Art/images/cube_copper.png
