aspro648/KiCad/projects/Art/images/cube_mask.png

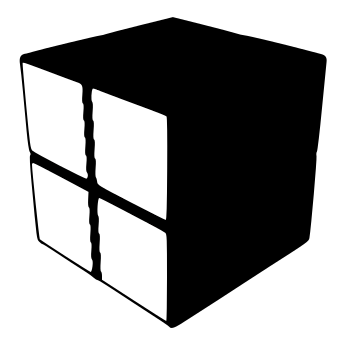
projects/Art/images/cube_mask.png
