aspro648/KiCad/projects/Art/images/cube_paste.png

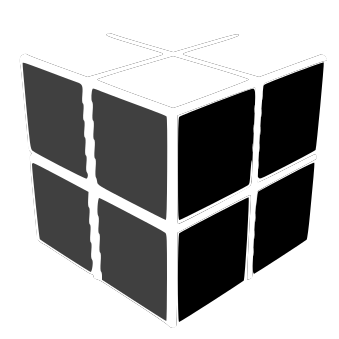
projects/Art/images/cube_paste.png
