aspro648/KiCad/projects/Art/images/cube_silk.png

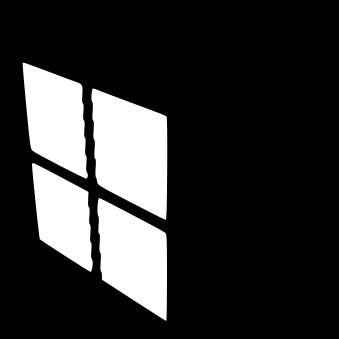
projects/Art/images/cube_silk.png
