aspro648/KiCad/projects/Art/images/layers.png

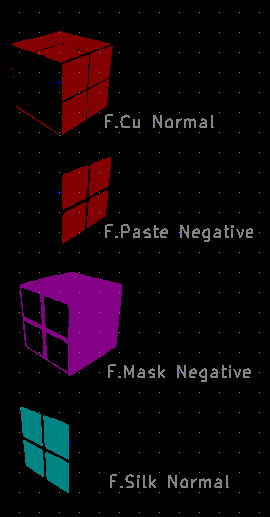
projects/Art/images/layers.png
