aspro648/KiCad/projects/Attiny/Attiny84SpinnerSMD_R2 AVI/images/01_GeekSpinnerSMD.JPG

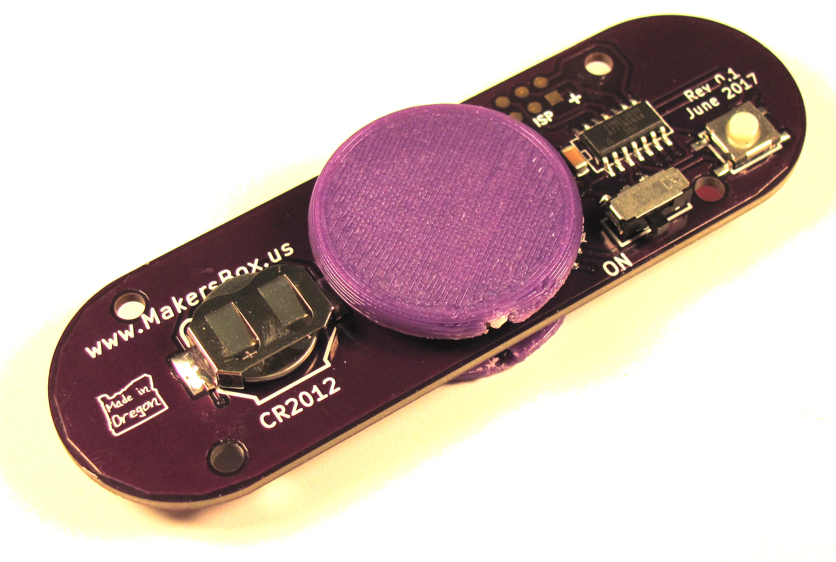
projects/Attiny/Attiny84SpinnerSMD_R2 AVI/images/01_GeekSpinnerSMD.JPG
