aspro648/KiCad/projects/Attiny/Attiny84SpinnerSMD_R2 AVI/images/spinner SMD label.png

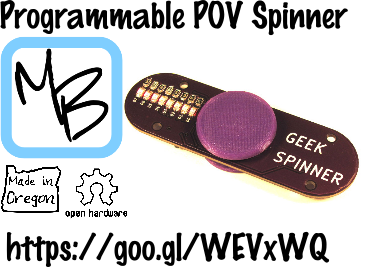
projects/Attiny/Attiny84SpinnerSMD_R2 AVI/images/spinner SMD label.png
