aspro648/KiCad/projects/Attiny/Attiny84SpinnerSMD_R2/images/00_GeekSpinnerSMD text.JPG

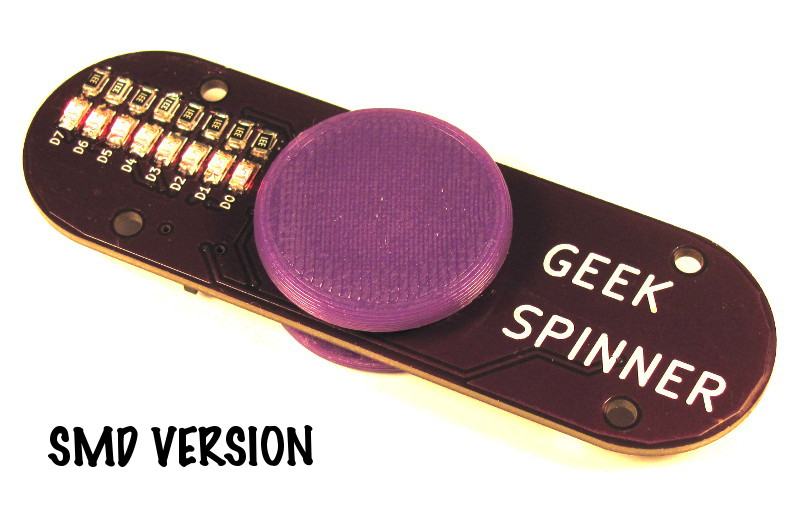
projects/Attiny/Attiny84SpinnerSMD_R2/images/00_GeekSpinnerSMD text.JPG
