aspro648/KiCad/projects/Attiny/Attiny84ToorCon/images/3.png

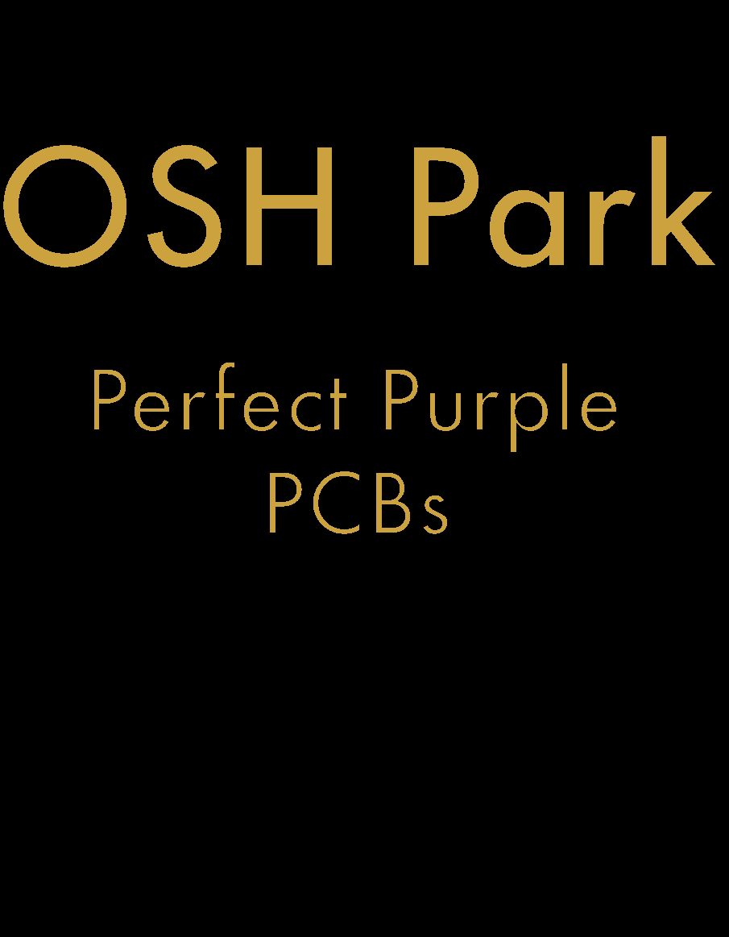
projects/Attiny/Attiny84ToorCon/images/3.png
