aspro648/KiCad/projects/Attiny/Attiny84ToorCon/images/fingerprint2.png

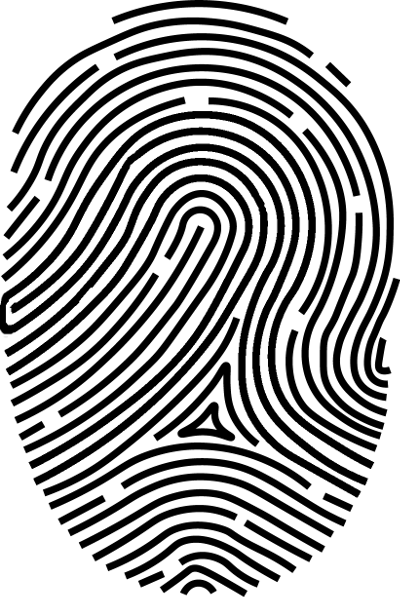
projects/Attiny/Attiny84ToorCon/images/fingerprint2.png
