aspro648/KiCad/projects/Attiny/Attiny84ToorCon/images/schematic.png

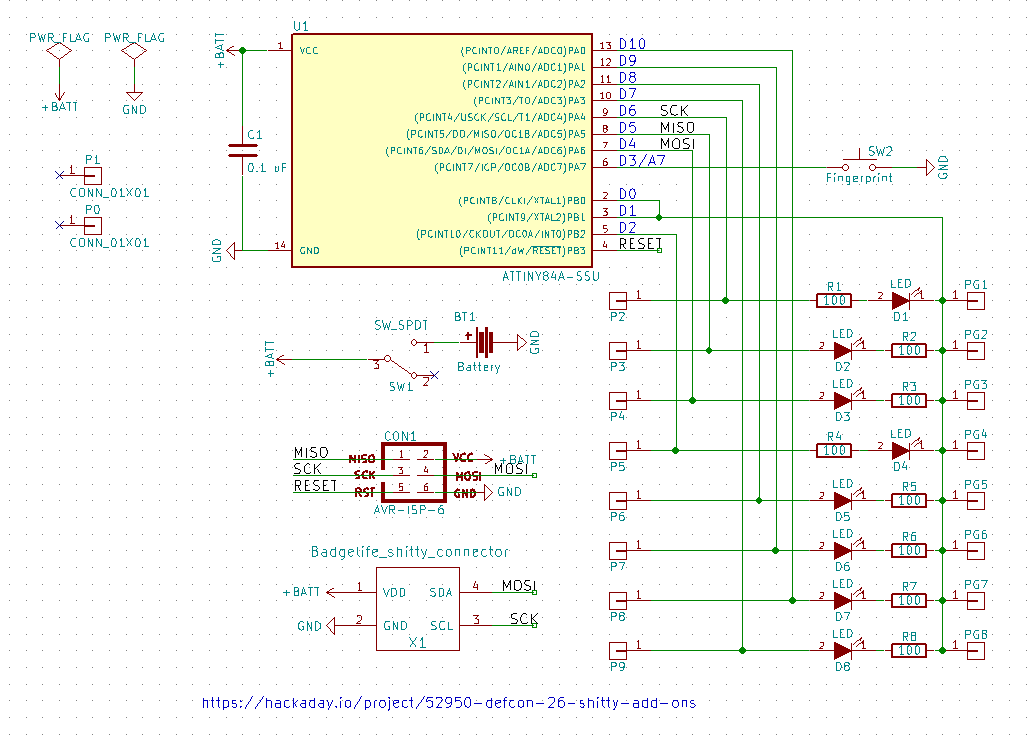
projects/Attiny/Attiny84ToorCon/images/schematic.png
