aspro648/KiCad/projects/Attiny/Attiny84ToorCon/images/ToorCon.jpg

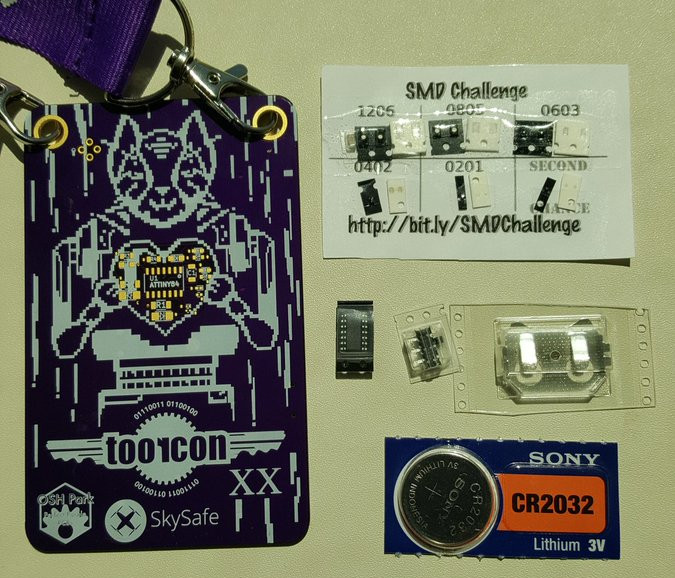
projects/Attiny/Attiny84ToorCon/images/ToorCon.jpg
