aspro648/KiCad/projects/Attiny/Attiny85Challenge2/docs/certificates/Adam Sachitano.png

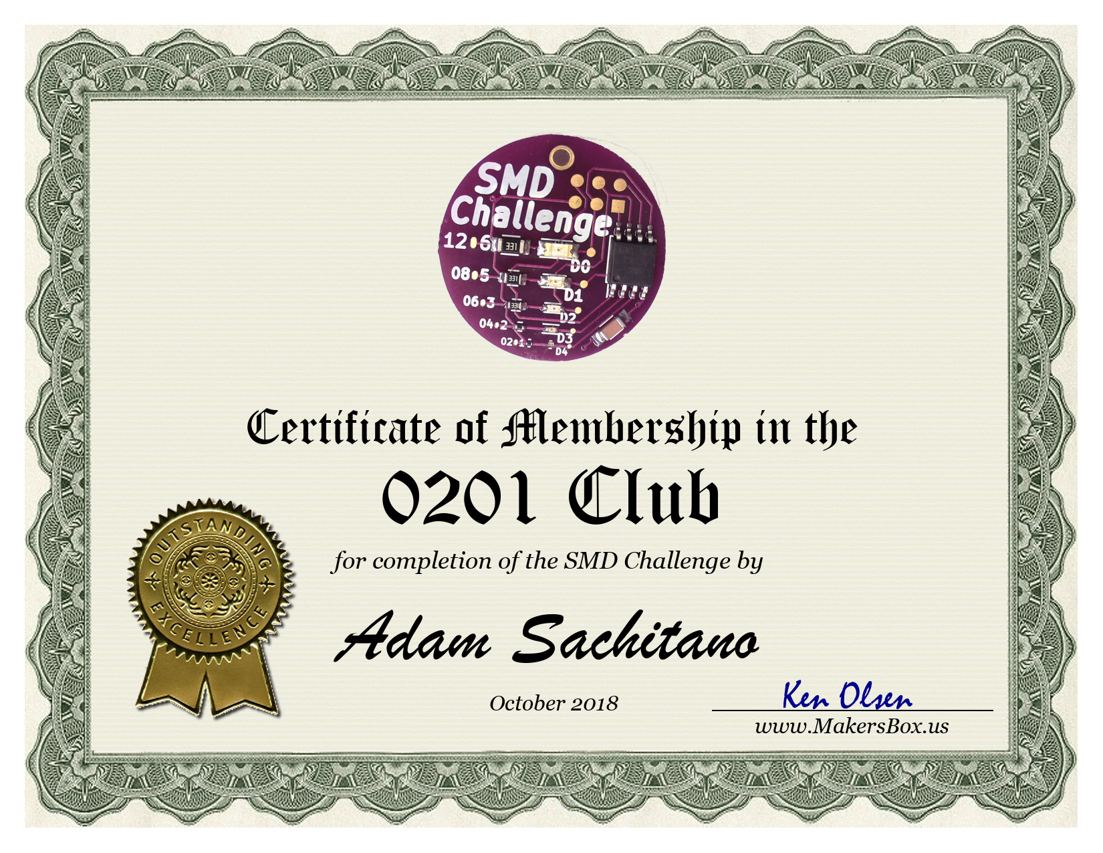
projects/Attiny/Attiny85Challenge2/docs/certificates/Adam Sachitano.png
