aspro648/KiCad/projects/Attiny/Attiny85Challenge2/docs/certificates/Andrew Mackenzie.png

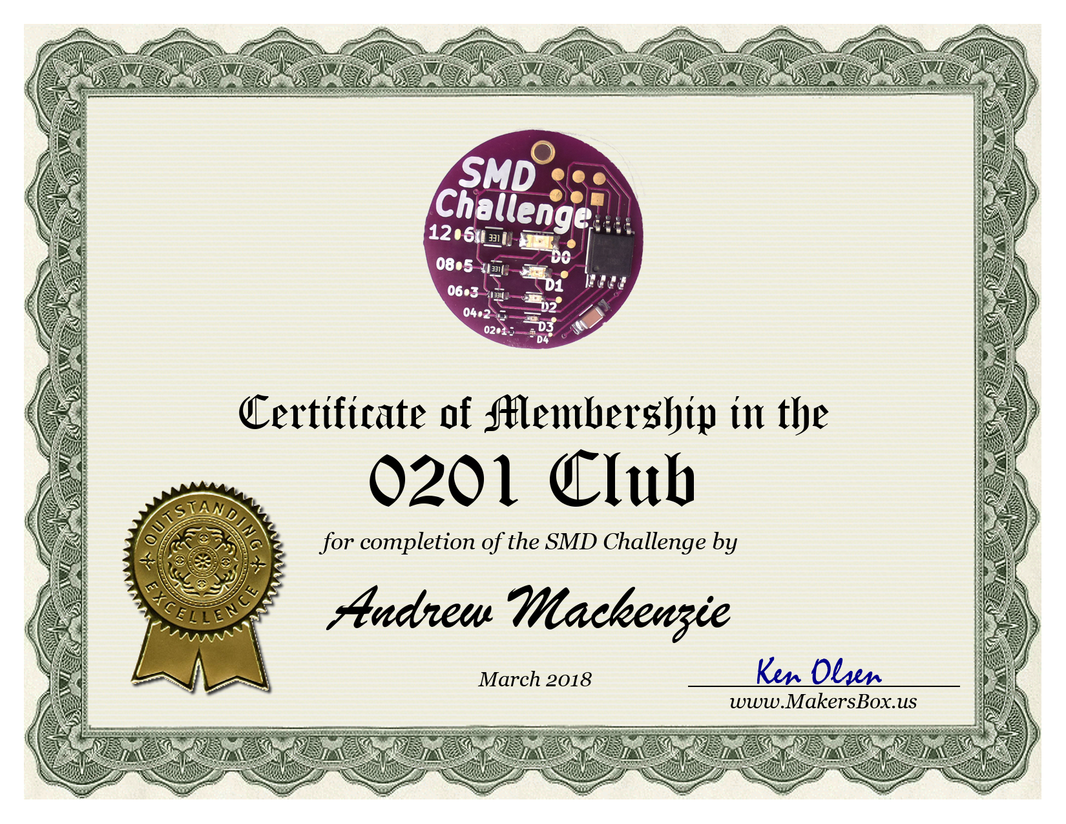
projects/Attiny/Attiny85Challenge2/docs/certificates/Andrew Mackenzie.png
