aspro648/KiCad/projects/Attiny/Attiny85Challenge2/docs/certificates/Dave Adams.png

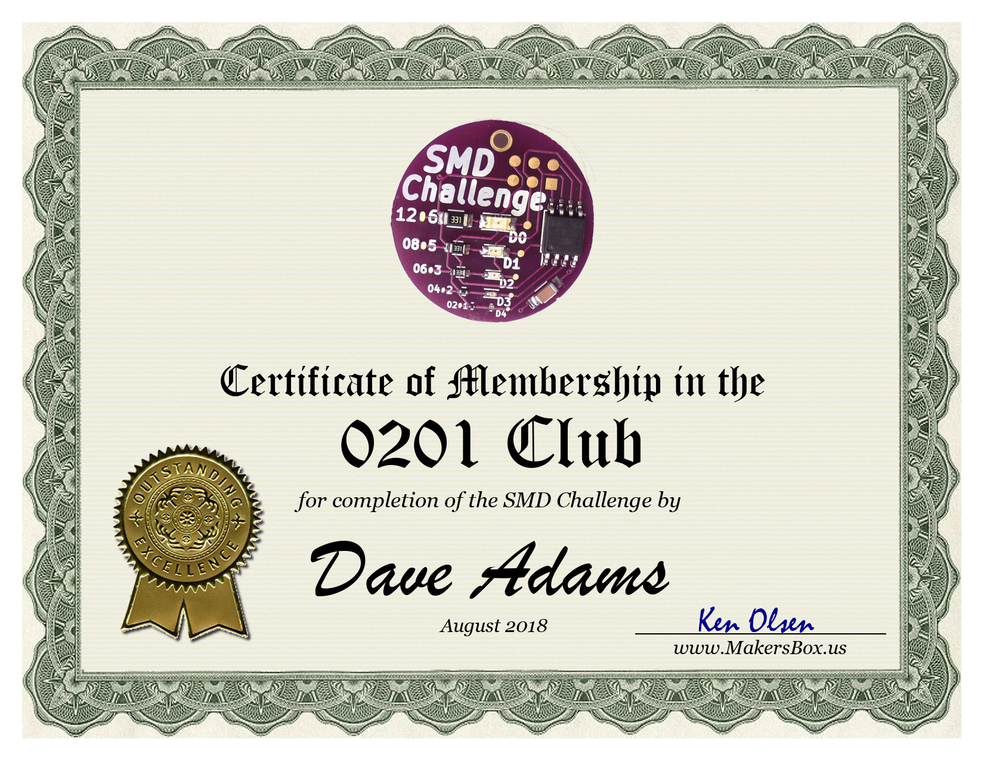
projects/Attiny/Attiny85Challenge2/docs/certificates/Dave Adams.png
