aspro648/KiCad/projects/Attiny/Attiny85Challenge2/docs/certificates/Jeff Bogusz.png

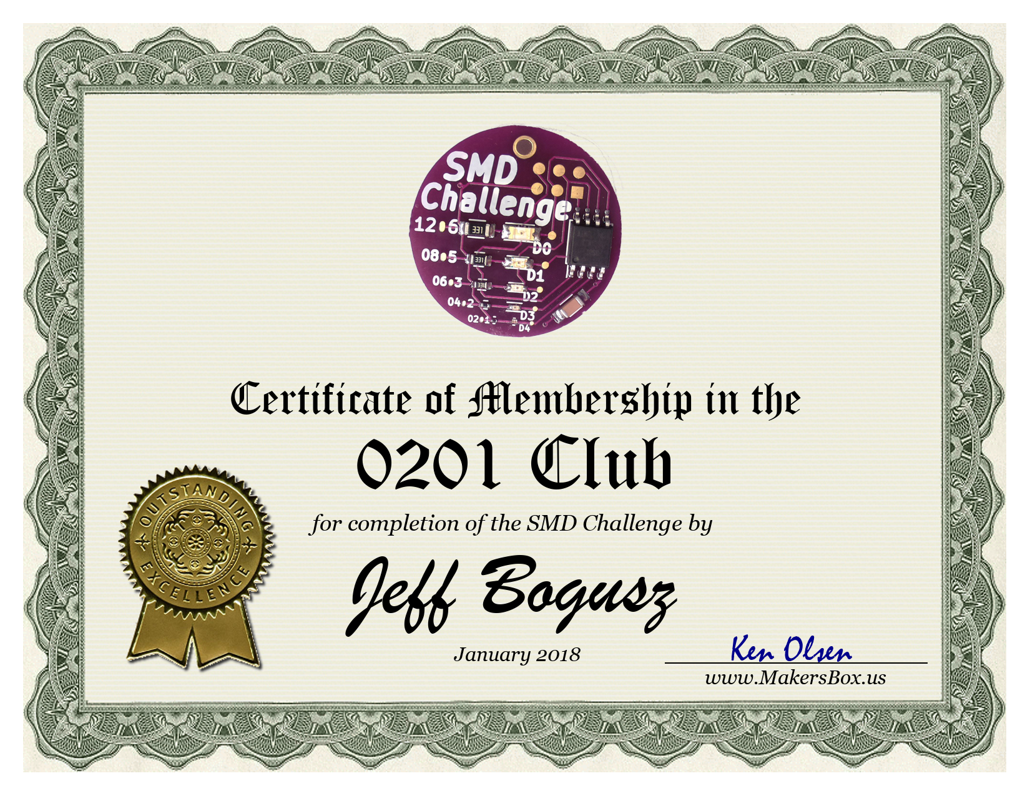
projects/Attiny/Attiny85Challenge2/docs/certificates/Jeff Bogusz.png
