aspro648/KiCad/projects/Attiny/Attiny85Challenge2/docs/files/2014cake - Copy.png

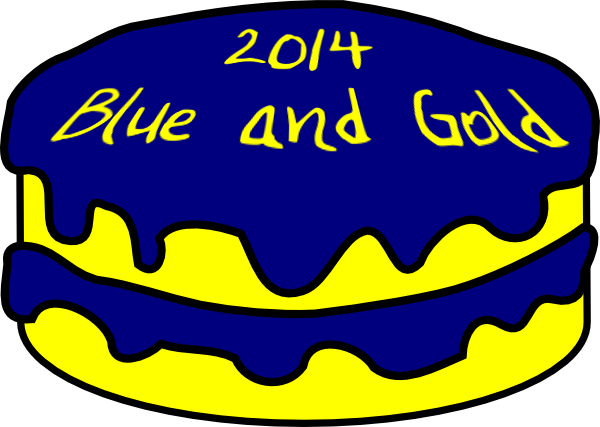
projects/Attiny/Attiny85Challenge2/docs/files/2014cake - Copy.png
