aspro648/KiCad/projects/Attiny/Attiny85Challenge2/docs/files/HP.jpg

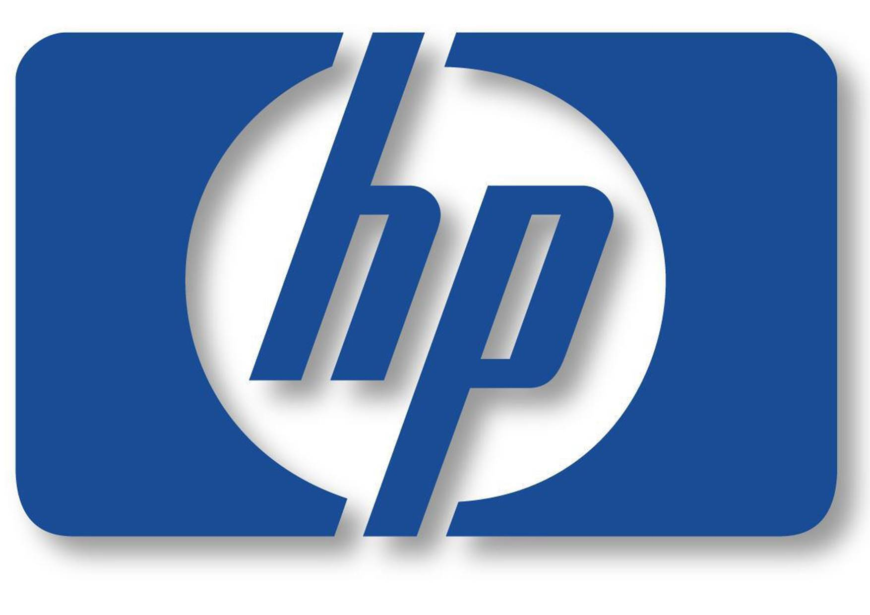
projects/Attiny/Attiny85Challenge2/docs/files/HP.jpg
