aspro648/KiCad/projects/Attiny/Attiny85Challenge2/docs/files/seal.png

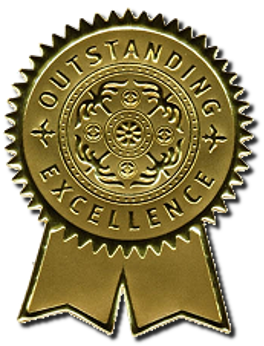
projects/Attiny/Attiny85Challenge2/docs/files/seal.png
