aspro648/KiCad/projects/Attiny/Attiny85Challenge2/docs/SMD Challenge Green Label.png

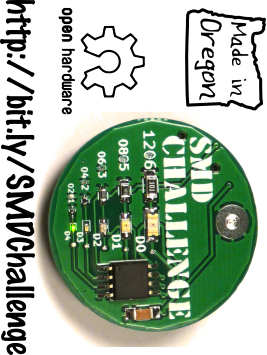
projects/Attiny/Attiny85Challenge2/docs/SMD Challenge Green Label.png
