aspro648/KiCad/projects/Attiny/Attiny85Challenge2/docs/SMD Challenge Purple Label.png

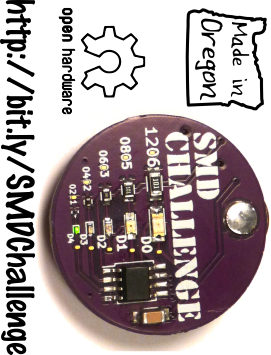
projects/Attiny/Attiny85Challenge2/docs/SMD Challenge Purple Label.png
