aspro648/KiCad/projects/Attiny/Attiny85Challenge2/images/Challenge_OSHPark.JPG

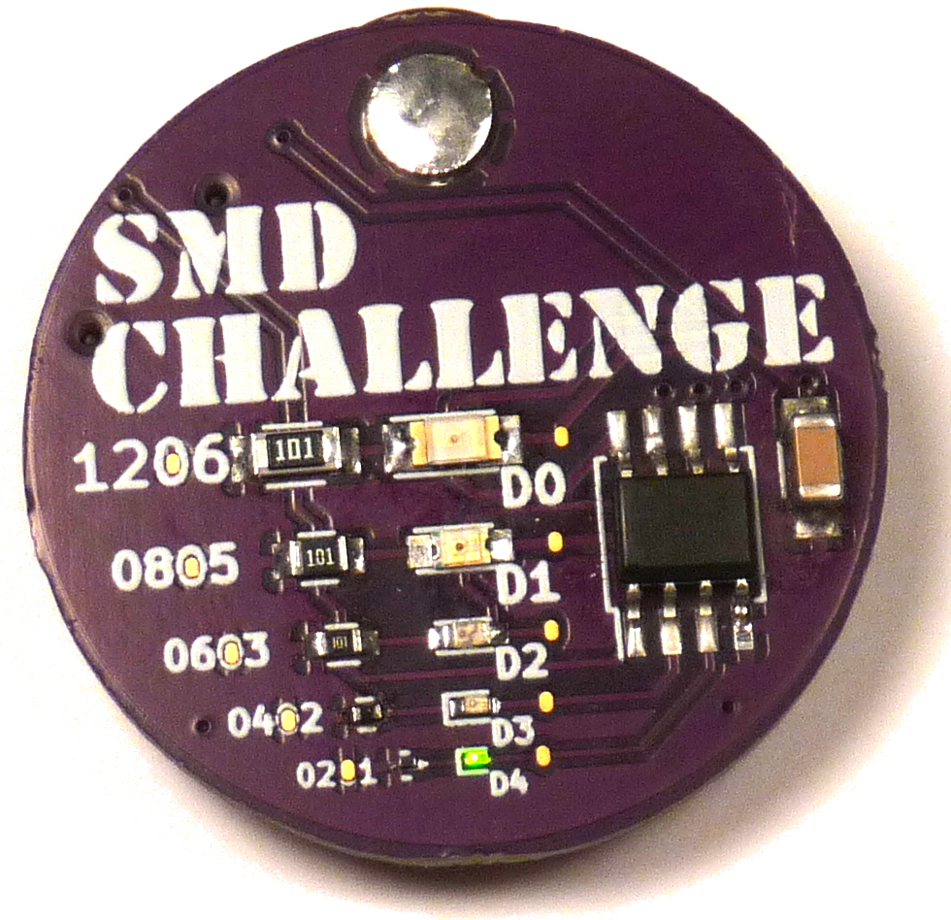
projects/Attiny/Attiny85Challenge2/images/Challenge_OSHPark.JPG
