aspro648/KiCad/projects/Attiny/Attiny85Challenge2019/docs/SMD Challenge Label.png

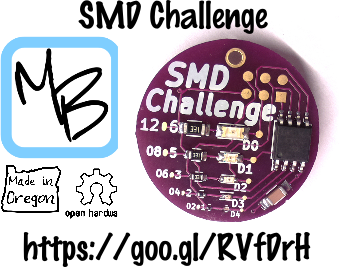
projects/Attiny/Attiny85Challenge2019/docs/SMD Challenge Label.png
