aspro648/KiCad/projects/Attiny/Attiny85Challenge2019/images/received_10215317138695330.png

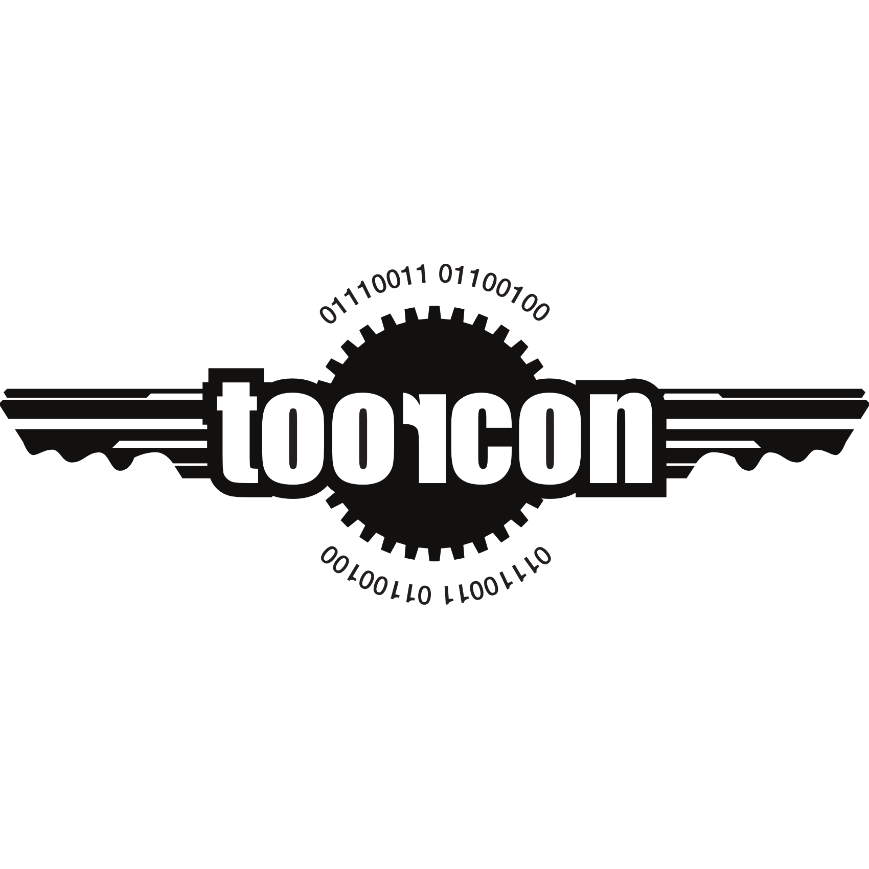
projects/Attiny/Attiny85Challenge2019/images/received_10215317138695330.png
