aspro648/KiCad/projects/Attiny/Attiny85Challenge2019/images/toorcamp_invert.gif

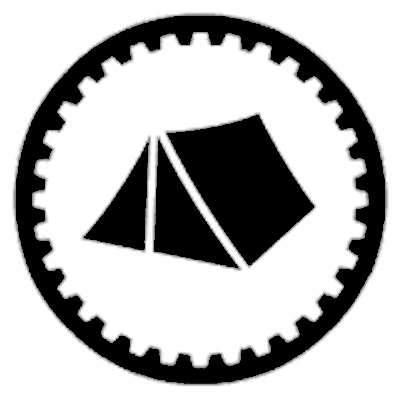
projects/Attiny/Attiny85Challenge2019/images/toorcamp_invert.gif
