aspro648/KiCad/projects/Attiny/Attiny85Challenge2019/images/toorcamp_notext_400x400.gif

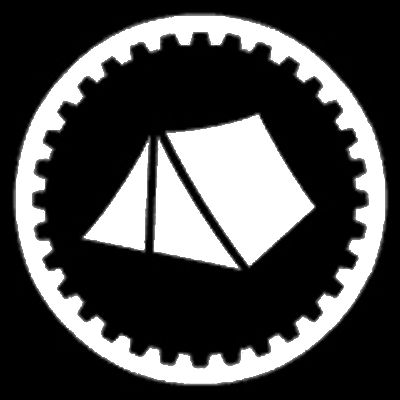
projects/Attiny/Attiny85Challenge2019/images/toorcamp_notext_400x400.gif
