aspro648/KiCad/projects/Attiny/Attiny85Challenge2019/images/toorcon.png

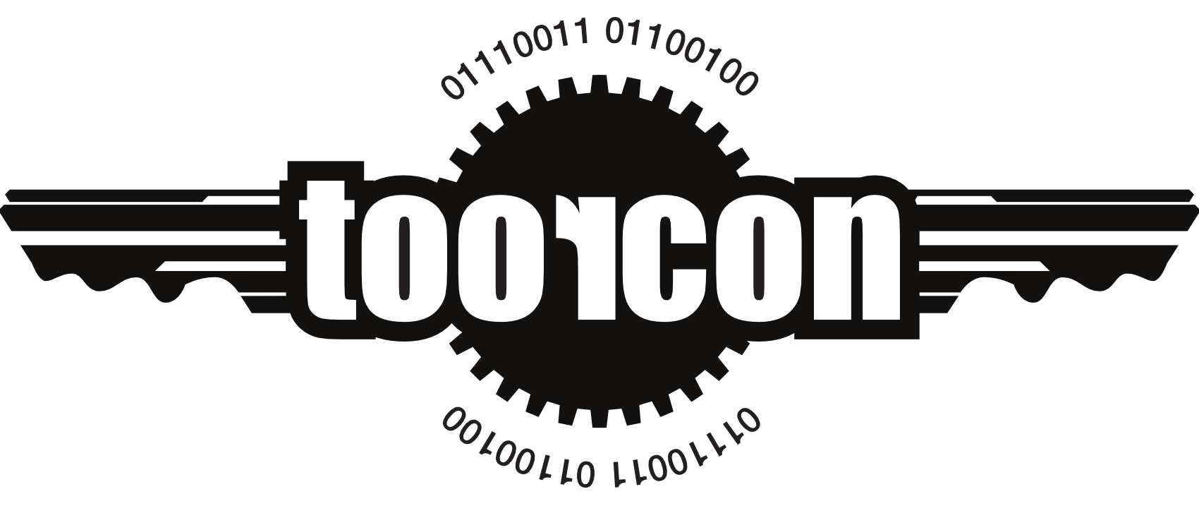
projects/Attiny/Attiny85Challenge2019/images/toorcon.png
