aspro648/KiCad/projects/Attiny/Attiny85Challenge/docs/SMD Challenge Label2.png

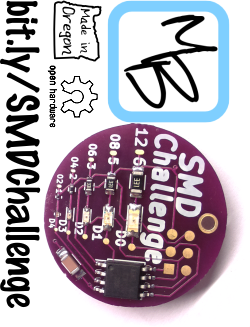
projects/Attiny/Attiny85Challenge/docs/SMD Challenge Label2.png
