aspro648/KiCad/projects/Attiny/Attiny85Challenge/docs/SMD Challenge Label Lemon.png

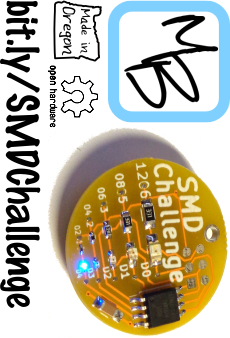
projects/Attiny/Attiny85Challenge/docs/SMD Challenge Label Lemon.png
