aspro648/KiCad/projects/Attiny/Attiny85Challenge/docs/SMD challenge part 2.png

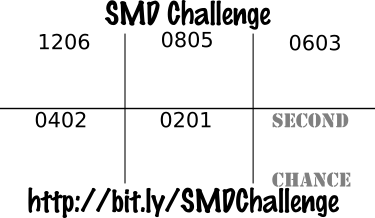
projects/Attiny/Attiny85Challenge/docs/SMD challenge part 2.png
