aspro648/KiCad/projects/Attiny/Attiny85ChallengeBodge/docs/SMD Bodge part card.png

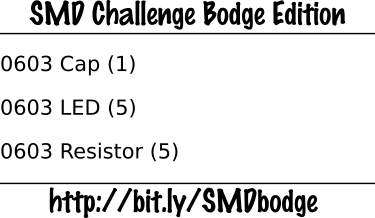
projects/Attiny/Attiny85ChallengeBodge/docs/SMD Bodge part card.png
