aspro648/KiCad/projects/Attiny/Attiny85ChallengeHackaday2020/design_files/Hackaday Challenge.png

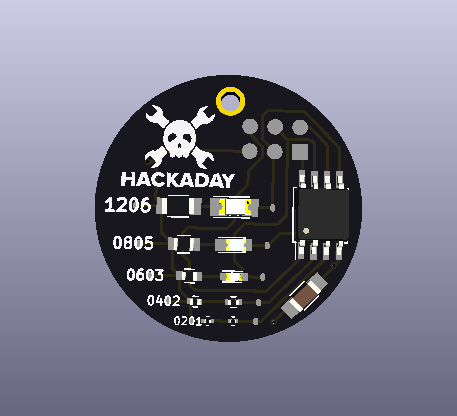
projects/Attiny/Attiny85ChallengeHackaday2020/design_files/Hackaday Challenge.png
