aspro648/KiCad/projects/Attiny/Attiny85ChallengeHackaday2020/docs/Hackaday_label2.png

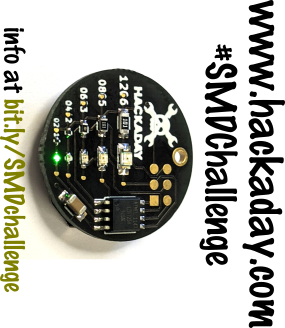
projects/Attiny/Attiny85ChallengeHackaday2020/docs/Hackaday_label2.png
