aspro648/KiCad/projects/Attiny/Attiny85ChallengeHackaday2020/images/hackaday-min.jpg

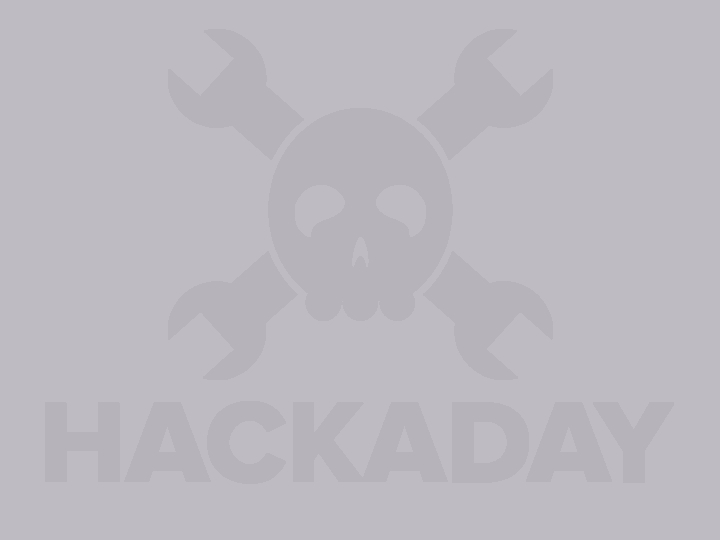
projects/Attiny/Attiny85ChallengeHackaday2020/images/hackaday-min.jpg
