aspro648/KiCad/projects/Attiny/Attiny85ChallengeHackaday/images/HackadaySMDChallenge-label2.jpg

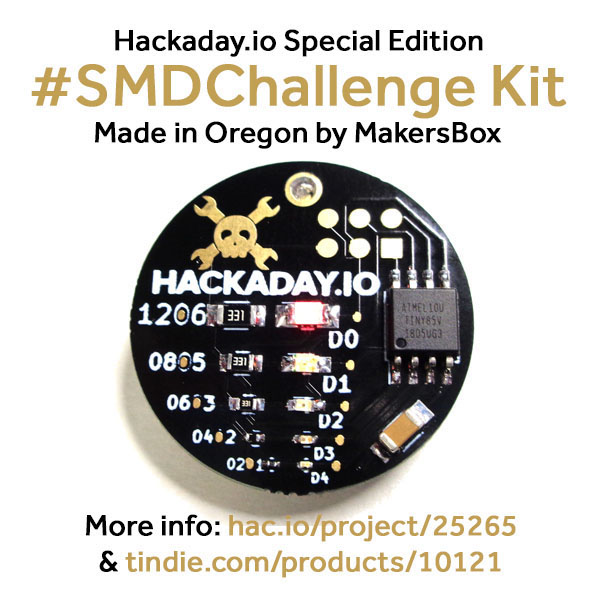
projects/Attiny/Attiny85ChallengeHackaday/images/HackadaySMDChallenge-label2.jpg
