aspro648/KiCad/projects/Attiny/Attiny85ChallengeHackFest/design_files/panel/pannel_Combined_Bottom.png

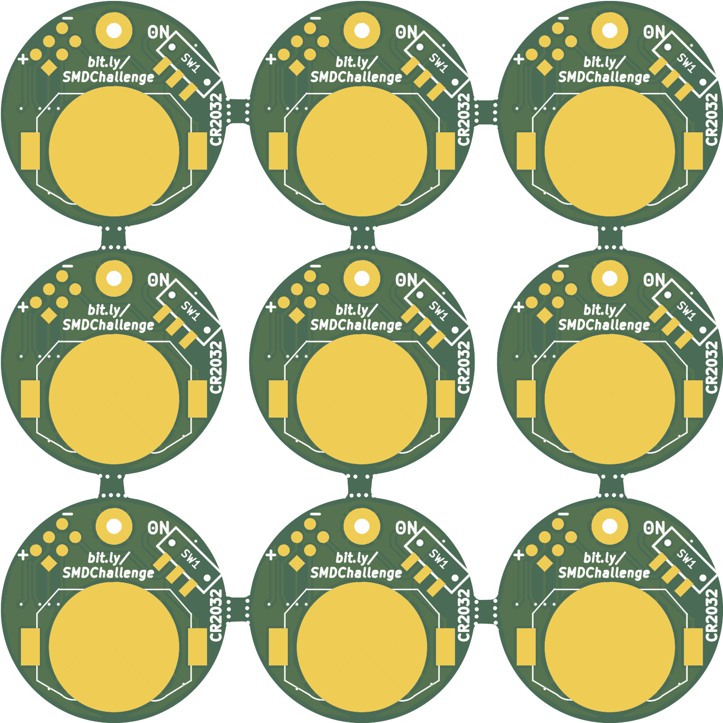
projects/Attiny/Attiny85ChallengeHackFest/design_files/panel/pannel_Combined_Bottom.png
