aspro648/KiCad/projects/Attiny/Attiny85ChallengeHackFest/design_files/panel/pannel_Combined_Top.png

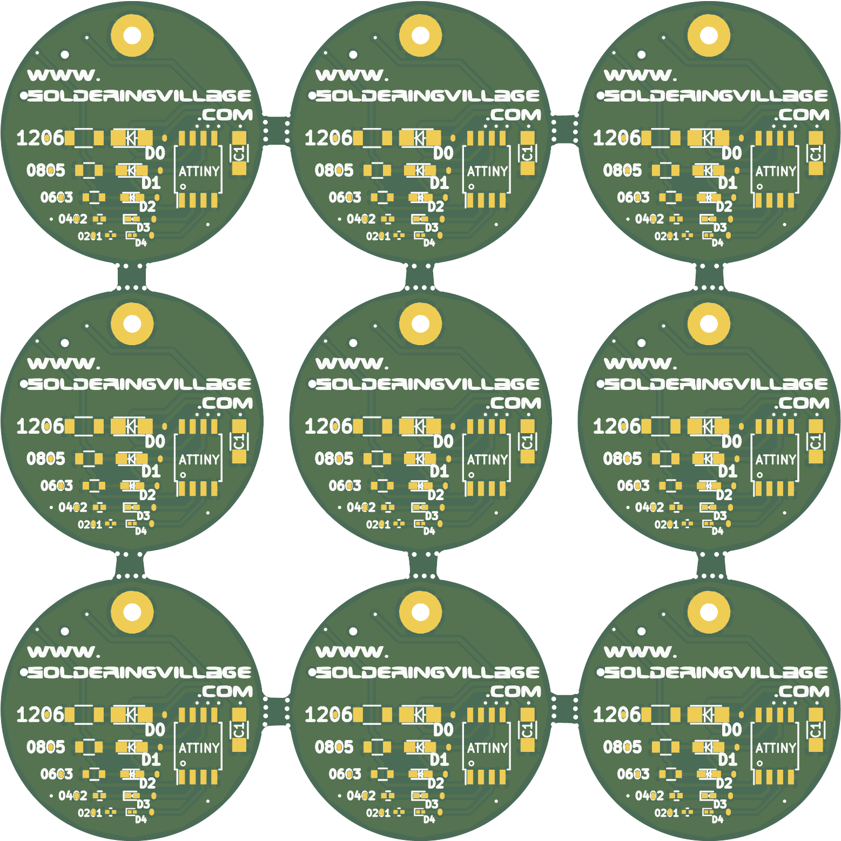
projects/Attiny/Attiny85ChallengeHackFest/design_files/panel/pannel_Combined_Top.png
