aspro648/KiCad/projects/Attiny/Attiny85ChallengeHackFest/design_files/panel/Untitled_Combined_Top.png

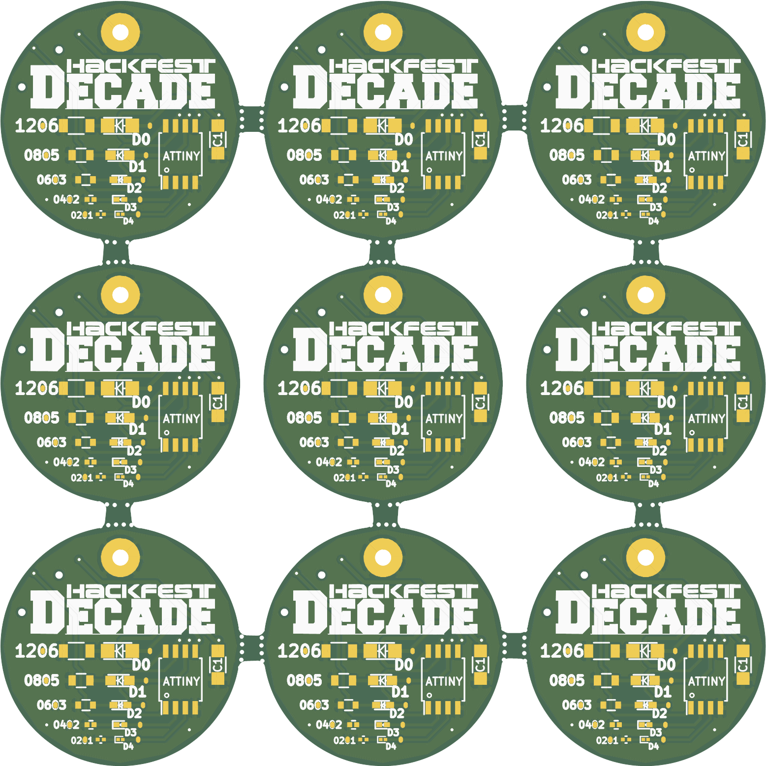
projects/Attiny/Attiny85ChallengeHackFest/design_files/panel/Untitled_Combined_Top.png
