aspro648/KiCad/projects/Attiny/Attiny85ChallengeHackFest/images/DSC02445.JPG

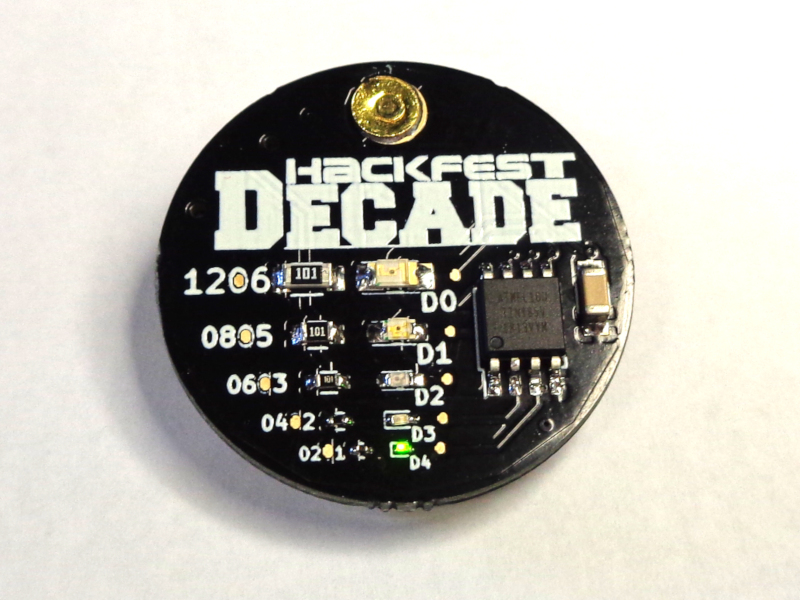
projects/Attiny/Attiny85ChallengeHackFest/images/DSC02445.JPG
