aspro648/KiCad/projects/Attiny/Attiny85ChallengeTindie/design_files/panel/panel_Combined_Top.png

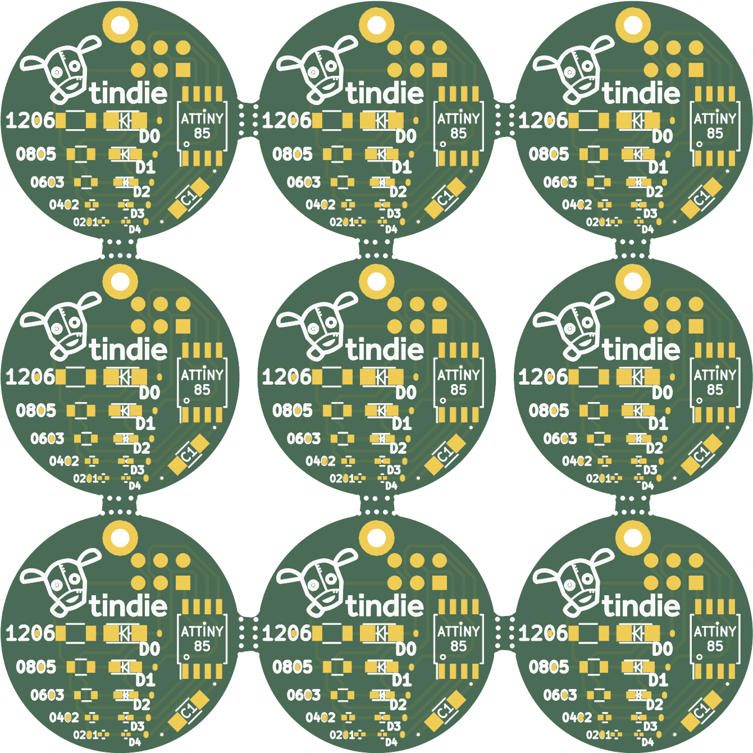
projects/Attiny/Attiny85ChallengeTindie/design_files/panel/panel_Combined_Top.png
