aspro648/KiCad/projects/Attiny/Attiny85ChallengeTindie/images/tindie-invert.png

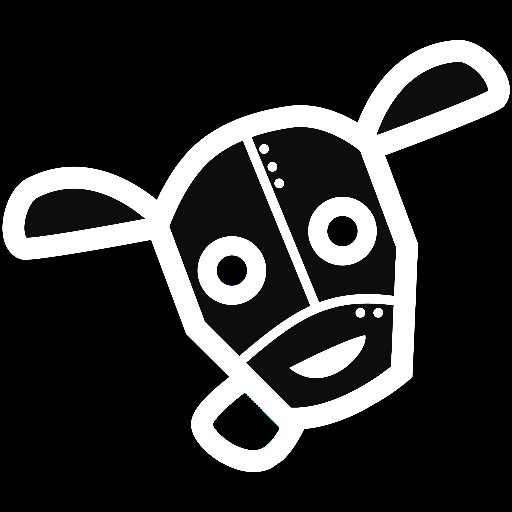
projects/Attiny/Attiny85ChallengeTindie/images/tindie-invert.png
