aspro648/KiCad/projects/Attiny/Attiny85ChallengeToorCamp/images/tindie.jpg

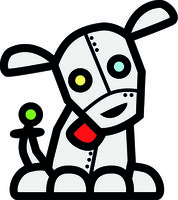
projects/Attiny/Attiny85ChallengeToorCamp/images/tindie.jpg
