aspro648/KiCad/projects/Attiny/Attiny85HeartSMD1/docs/0047_20170609_1449.png

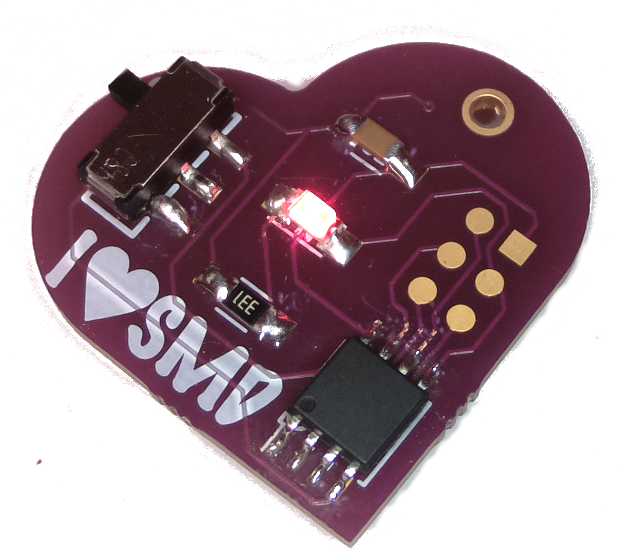
projects/Attiny/Attiny85HeartSMD1/docs/0047_20170609_1449.png
