aspro648/KiCad/projects/Attiny/Attiny85HeartSMD1/images/base.sch.png

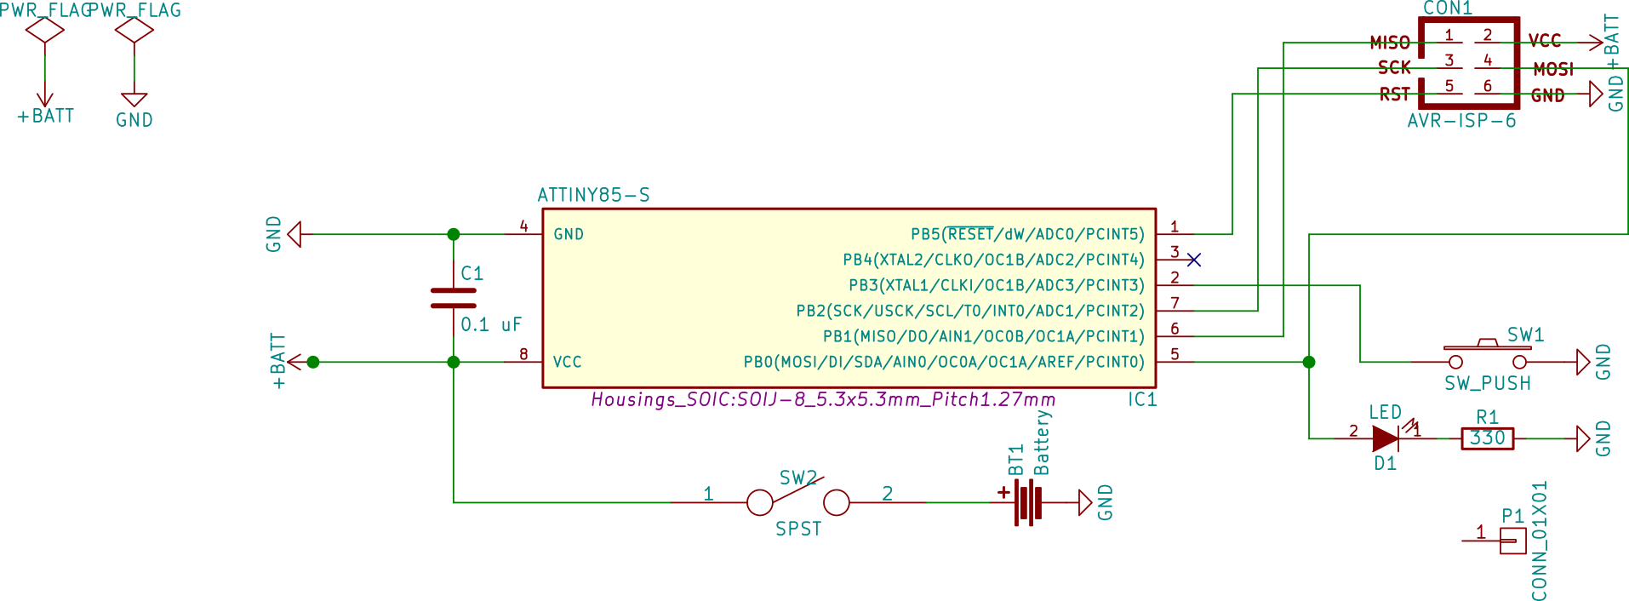
projects/Attiny/Attiny85HeartSMD1/images/base.sch.png
