aspro648/KiCad/projects/Attiny/Attiny85HeartSMD/design_files/panel/panel_Combined_Bottom.png

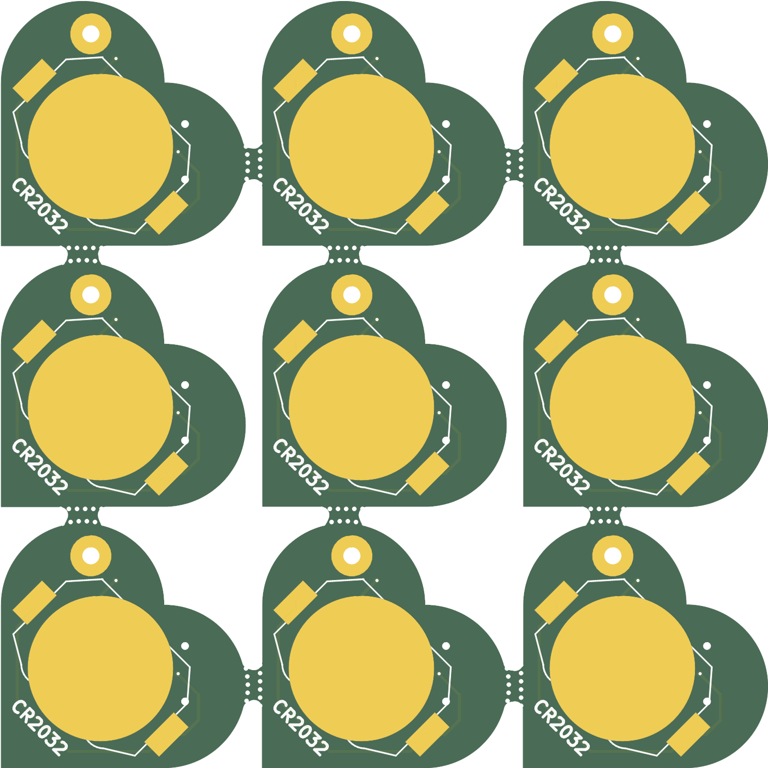
projects/Attiny/Attiny85HeartSMD/design_files/panel/panel_Combined_Bottom.png
