aspro648/KiCad/projects/Attiny/Attiny85HeartSMD/docs/ICanSMD Purple Label.png

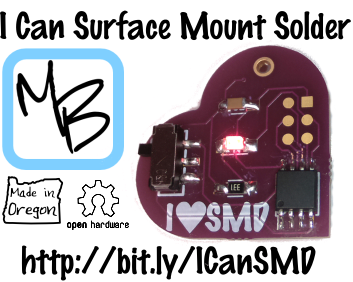
projects/Attiny/Attiny85HeartSMD/docs/ICanSMD Purple Label.png
