aspro648/KiCad/projects/Attiny/Attiny85HeartSMD/images/heart_red_sm.JPG

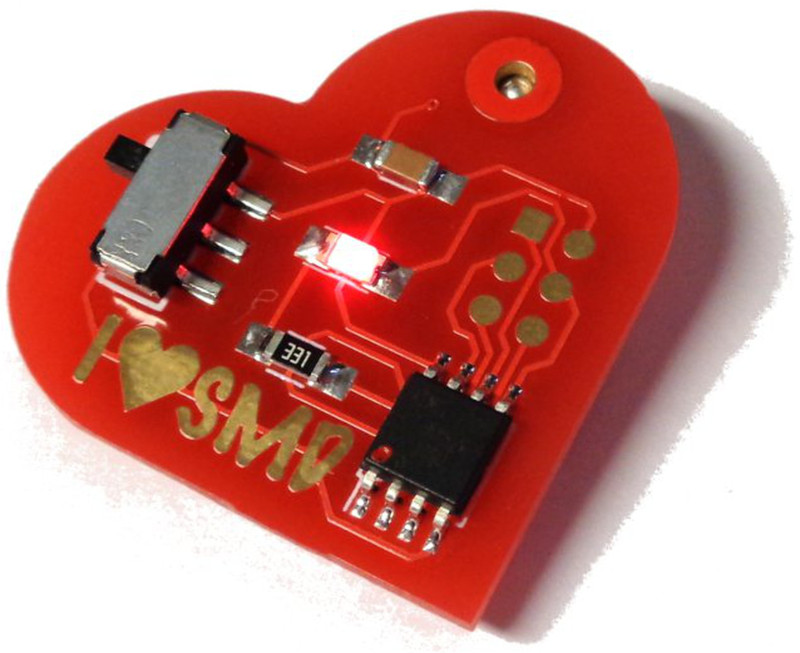
projects/Attiny/Attiny85HeartSMD/images/heart_red_sm.JPG
