aspro648/KiCad/projects/Attiny/Attiny85HeartSMD/images/P1090202.JPG

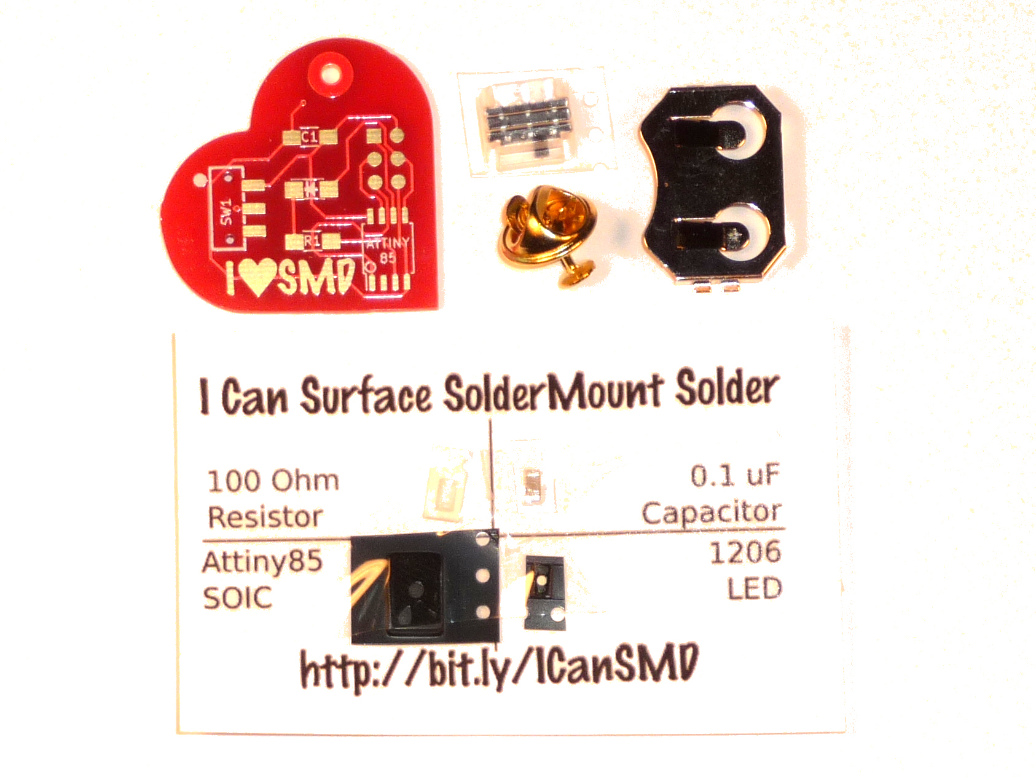
projects/Attiny/Attiny85HeartSMD/images/P1090202.JPG
