aspro648/KiCad/projects/Attiny/Attiny85SMD_OSHPark/docs/OHS17_1.png

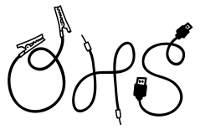
projects/Attiny/Attiny85SMD_OSHPark/docs/OHS17_1.png
