aspro648/KiCad/projects/Attiny/Attiny85SMD_OSHPark/docs/OSHWAcert.png

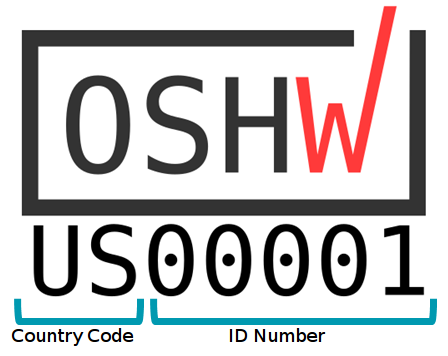
projects/Attiny/Attiny85SMD_OSHPark/docs/OSHWAcert.png
