aspro648/KiCad/projects/Attiny/Cylon sew 2/design_files - MCU/project.png

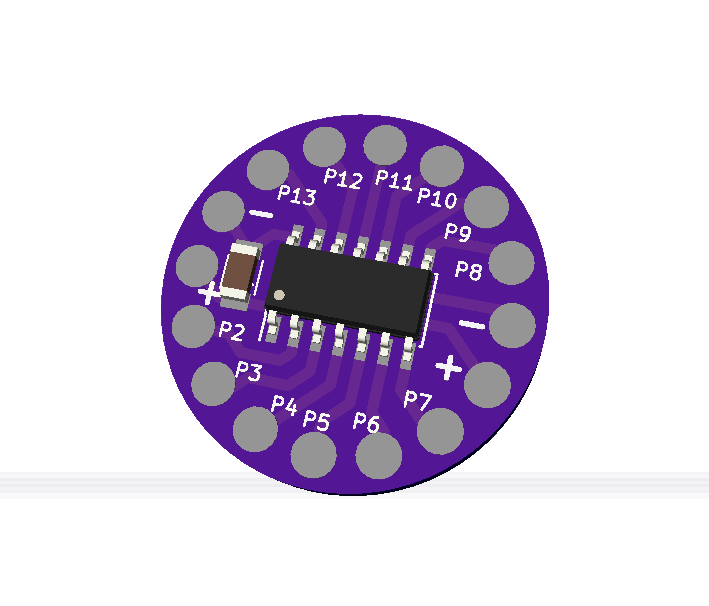
projects/Attiny/Cylon sew 2/design_files - MCU/project.png
