aspro648/KiCad/projects/Attiny/Cylon sew 2/docs/SMD Misery Label.png

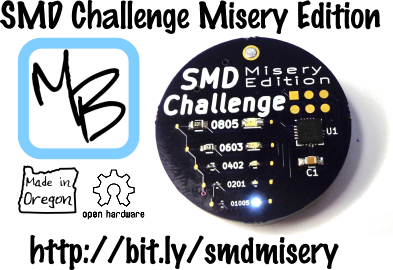
projects/Attiny/Cylon sew 2/docs/SMD Misery Label.png
