aspro648/KiCad/projects/Attiny/Cylon sew 2/images/project_front.png

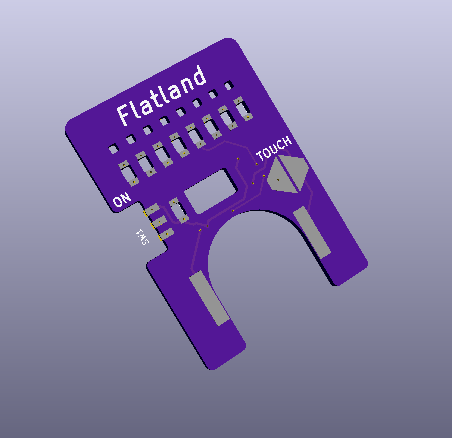
projects/Attiny/Cylon sew 2/images/project_front.png
