aspro648/KiCad/projects/Attiny/Cylon sew/docs/SMD Misery Second Chance.png

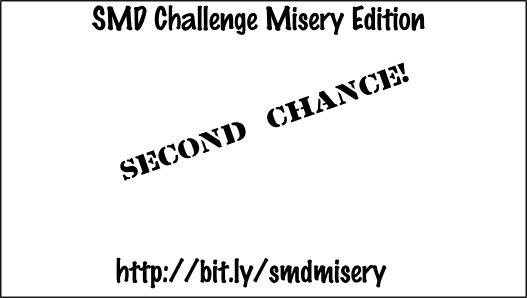
projects/Attiny/Cylon sew/docs/SMD Misery Second Chance.png
