aspro648/KiCad/projects/Attiny/GeekHeart/images/Screenshot_20170912-104640.jpg

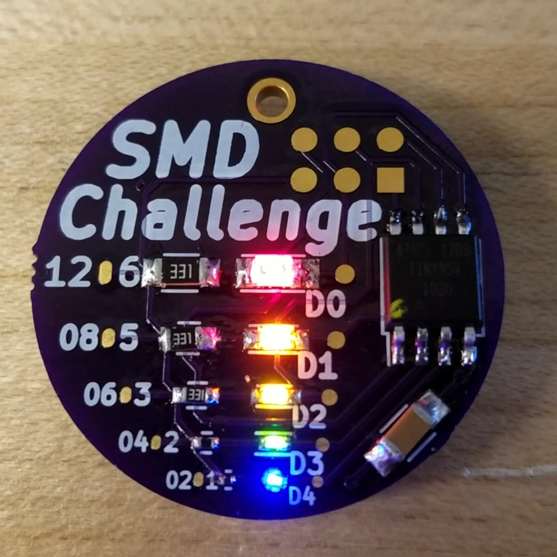
projects/Attiny/GeekHeart/images/Screenshot_20170912-104640.jpg
