aspro648/KiCad/projects/Attiny/TARDIS/images/back.JPG

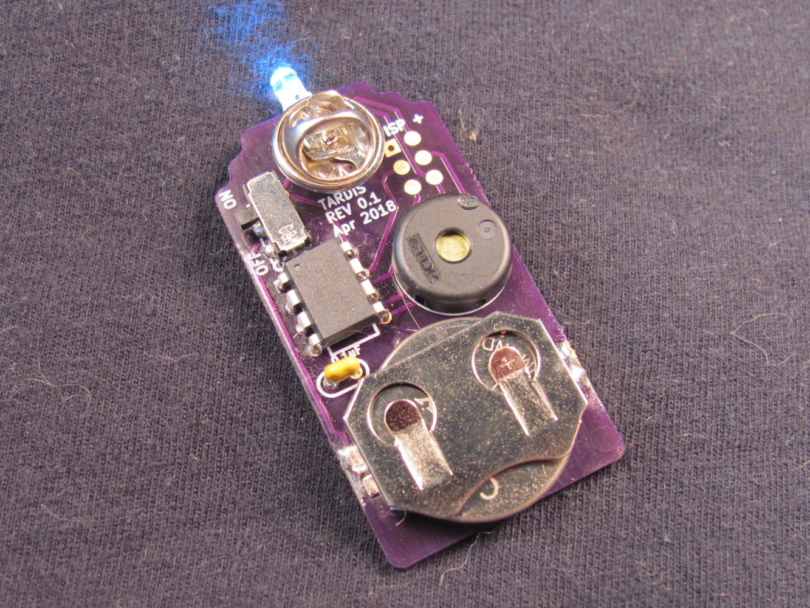
projects/Attiny/TARDIS/images/back.JPG
