aspro648/KiCad/projects/Attiny/TARDIS/images/front.JPG

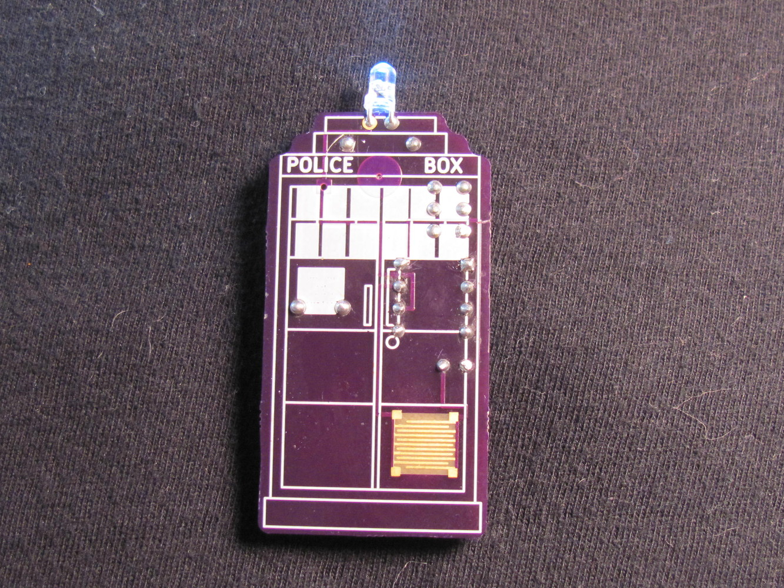
projects/Attiny/TARDIS/images/front.JPG
