aspro648/KiCad/projects/Attiny/TARDIS/images/IMG_0756.JPG

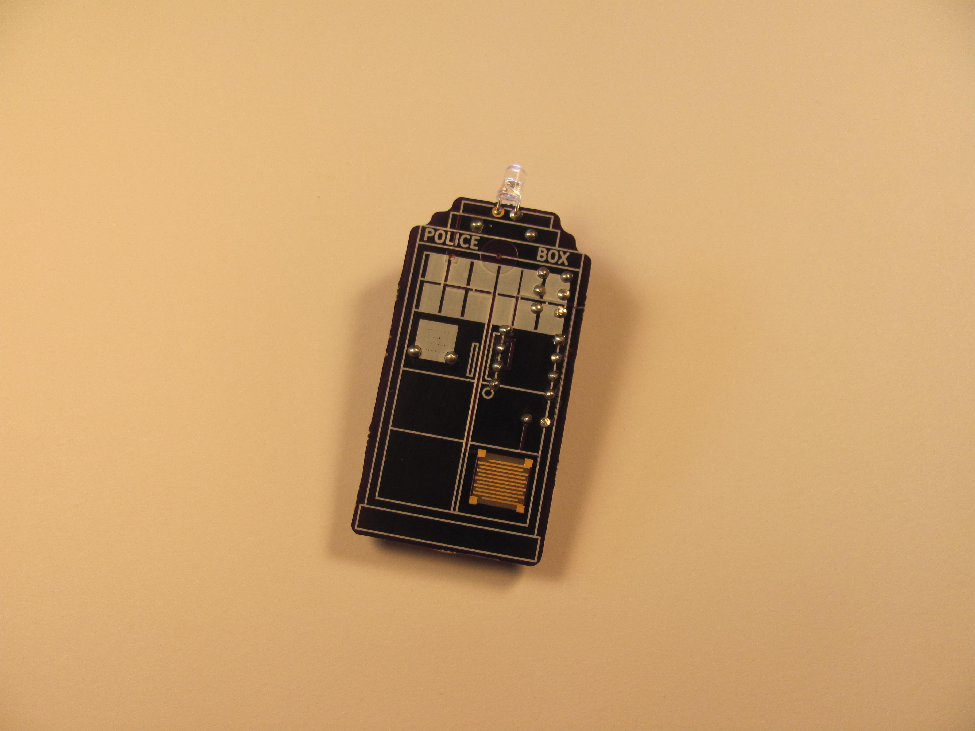
projects/Attiny/TARDIS/images/IMG_0756.JPG
