aspro648/KiCad/projects/Attiny/TARDIS/images/P1080612.JPG

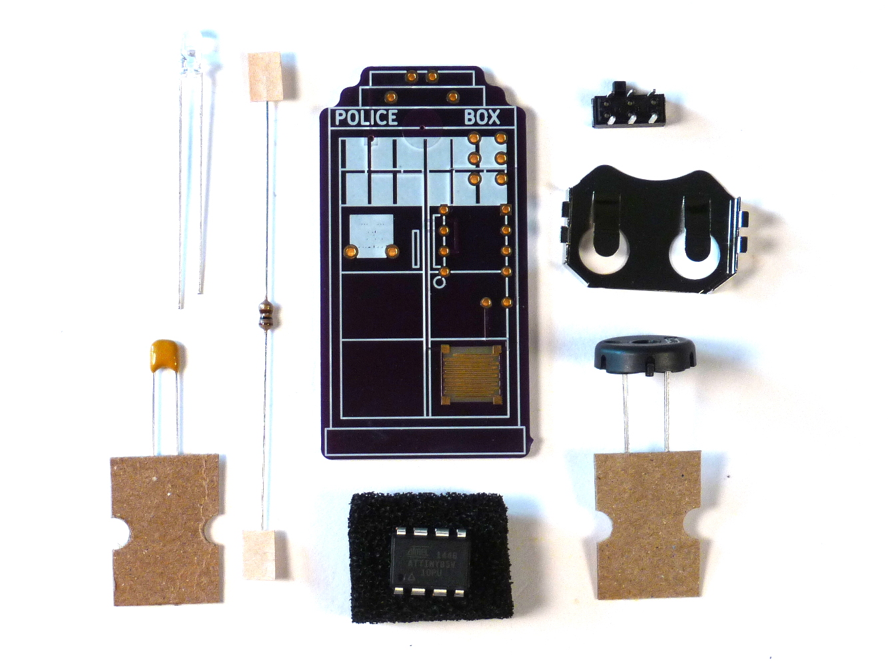
projects/Attiny/TARDIS/images/P1080612.JPG
