aspro648/KiCad/projects/Attiny/TARDIS/images/P1080614.JPG

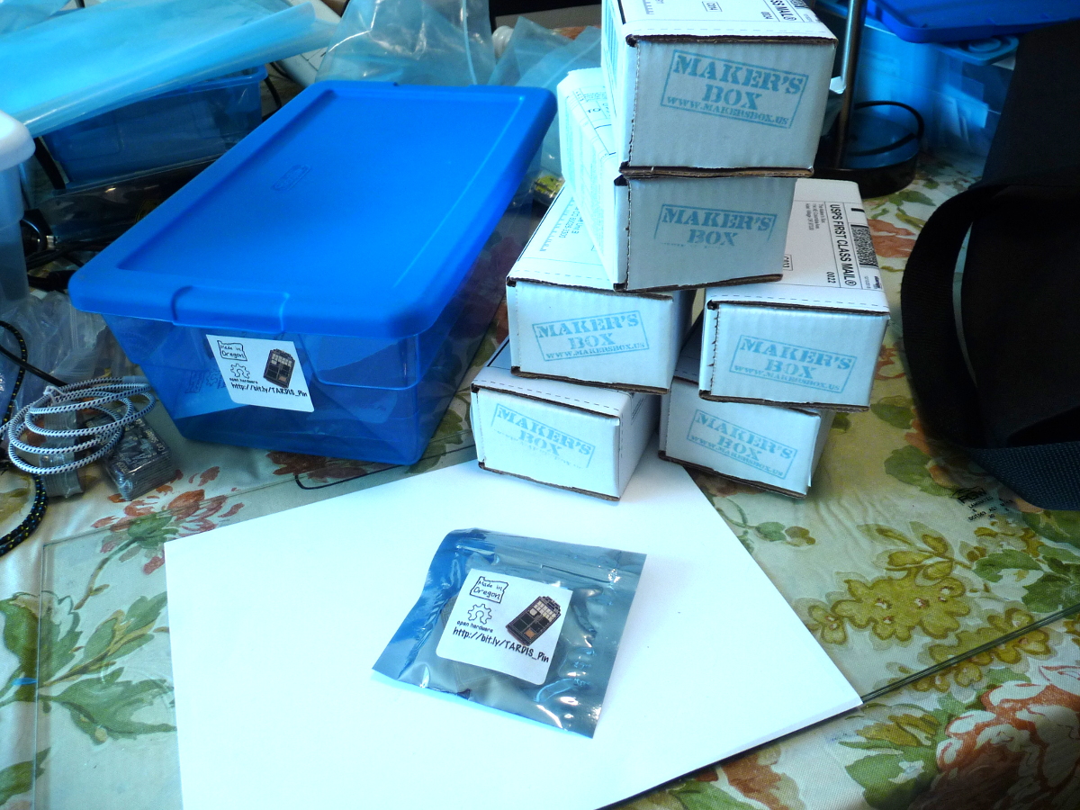
projects/Attiny/TARDIS/images/P1080614.JPG
