aspro648/KiCad/projects/Attiny/TARDIS/images/project.sch.png

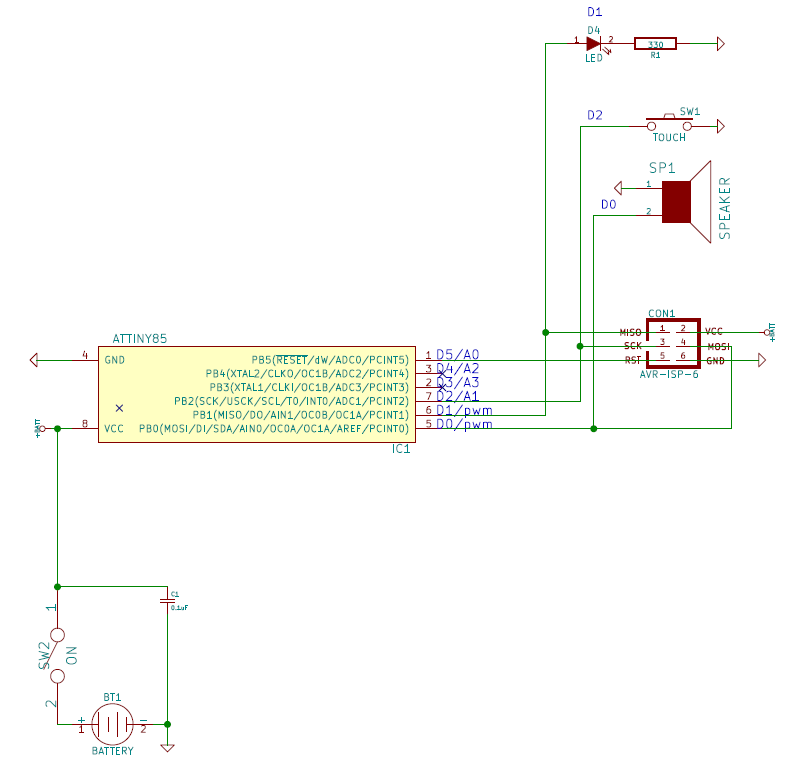
projects/Attiny/TARDIS/images/project.sch.png
