aspro648/KiCad/projects/Beetje/design_files_CNTRL-ATL-DEL/schematic.png

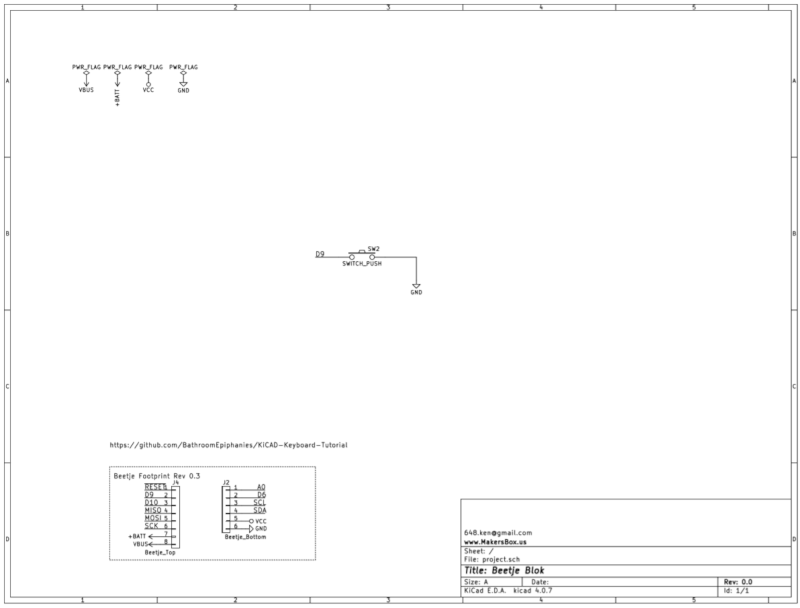
projects/Beetje/design_files_CNTRL-ATL-DEL/schematic.png
