aspro648/KiCad/projects/Beetje/design_files_Full_Bridge/docs/adafruit_products_schem.png

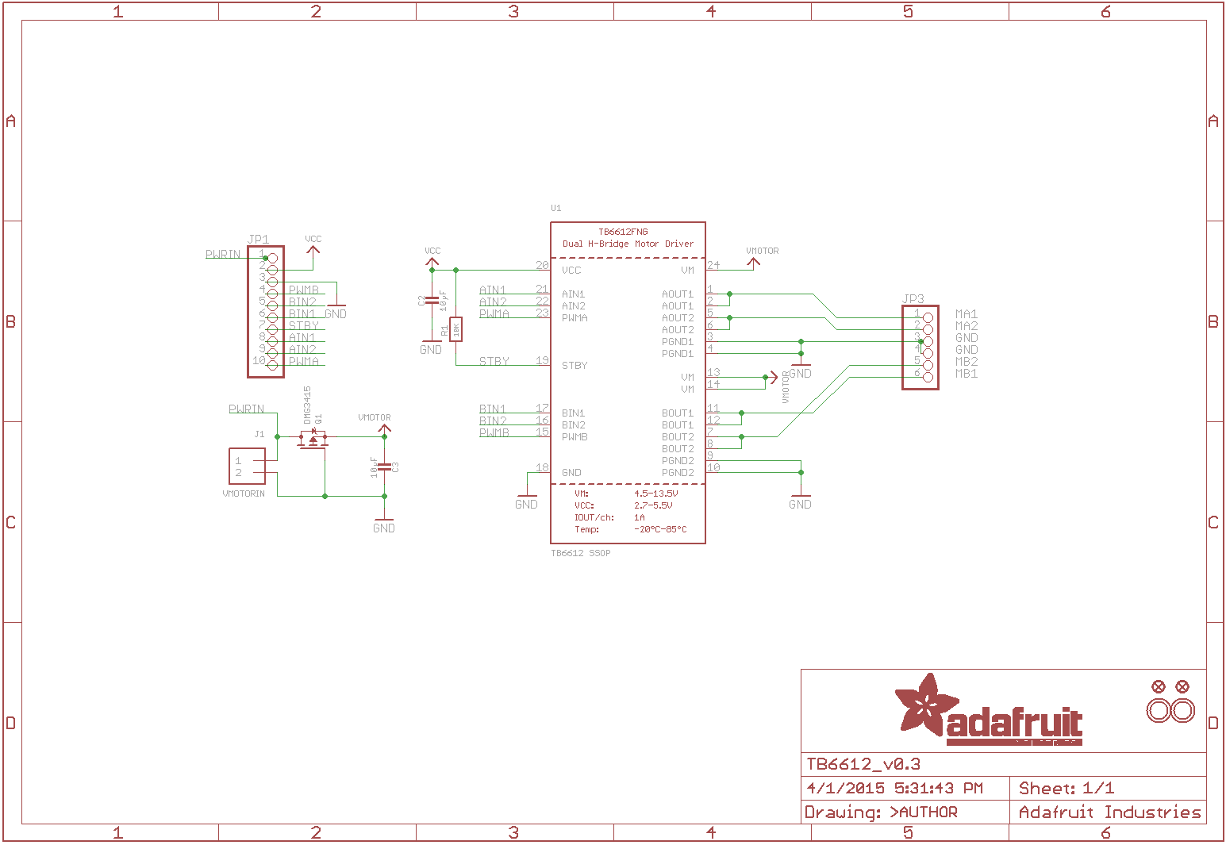
projects/Beetje/design_files_Full_Bridge/docs/adafruit_products_schem.png
