aspro648/KiCad/projects/Beetje/design_files_shield/project.sch.png

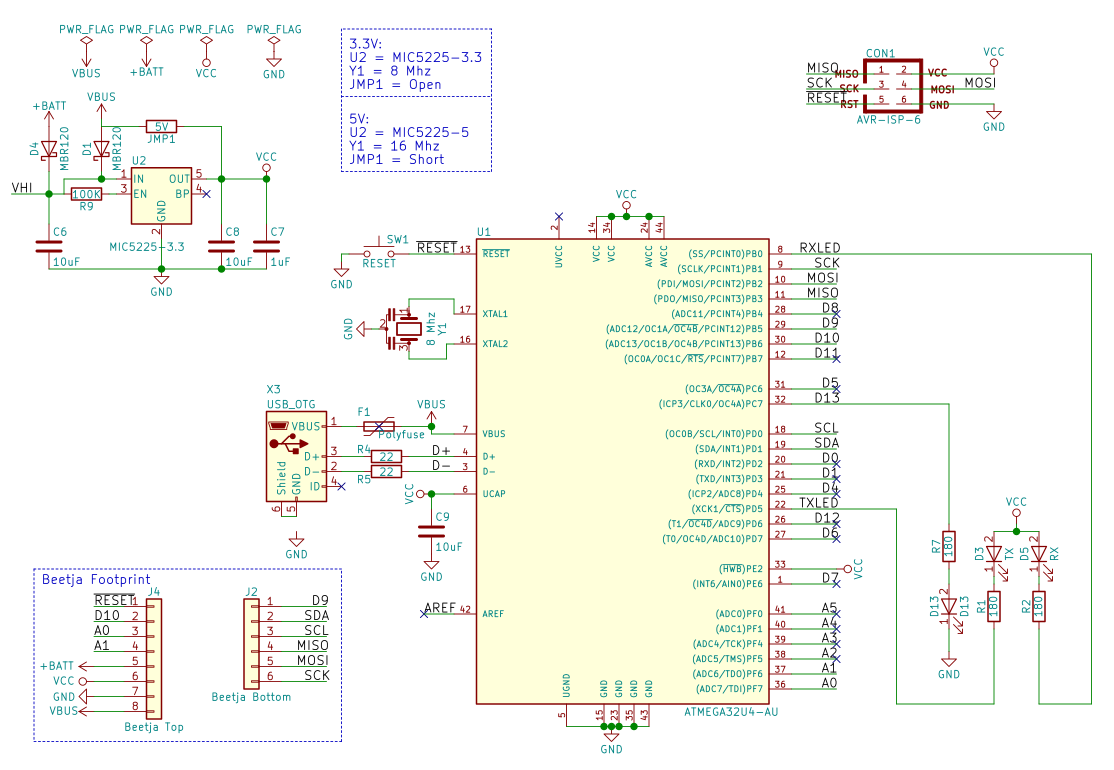
projects/Beetje/design_files_shield/project.sch.png
