aspro648/KiCad/projects/clock2/images/project.png

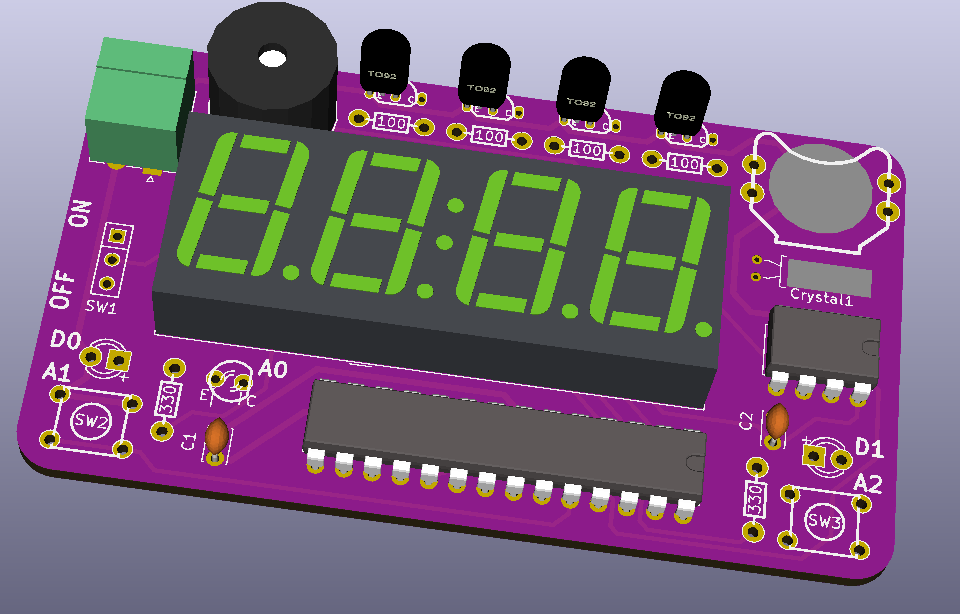
projects/clock2/images/project.png
