aspro648/KiCad/projects/clock/design_files_clock_shield_DS1302/images/project.png

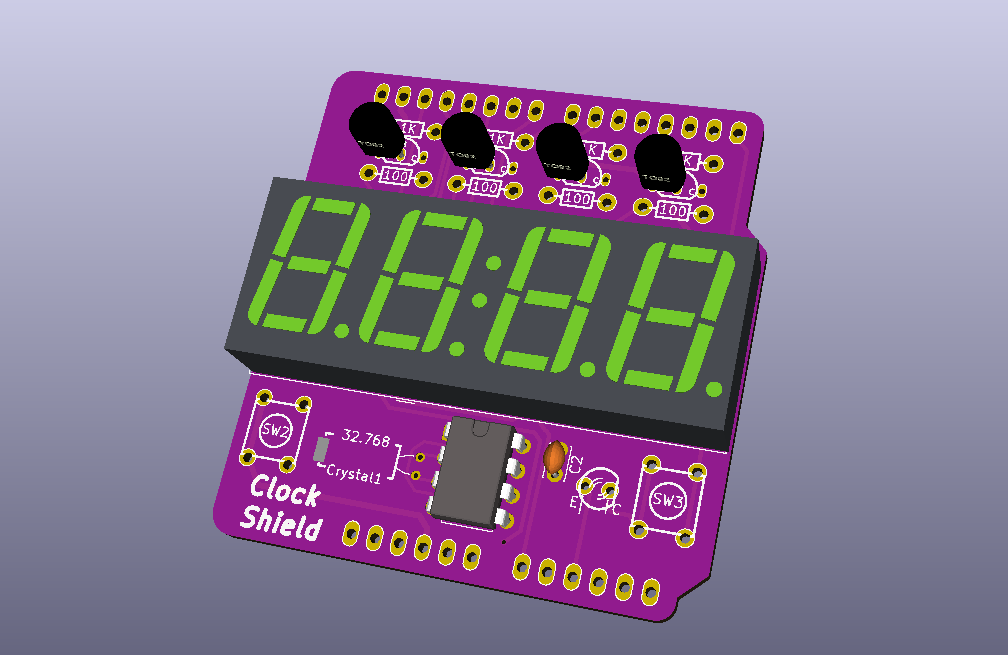
projects/clock/design_files_clock_shield_DS1302/images/project.png
