aspro648/KiCad/projects/HotWheels/IR/design_files/project.png

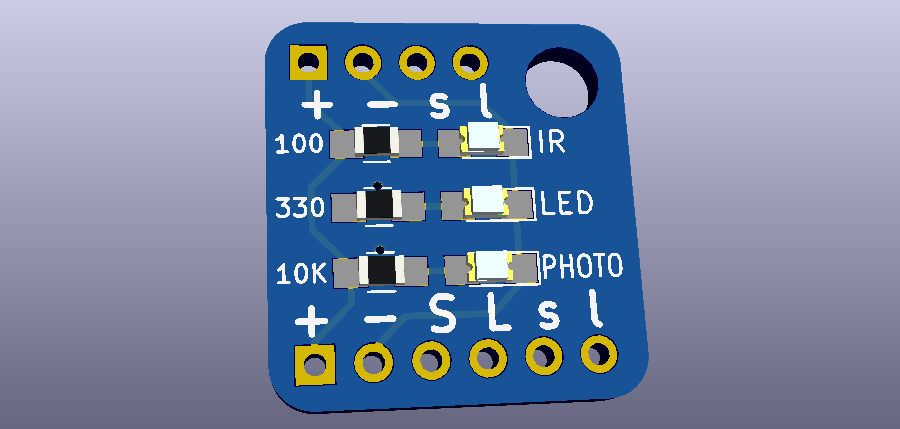
projects/HotWheels/IR/design_files/project.png
