aspro648/KiCad/projects/ICanSolder/design_files 0-2/pannel/Untitled_Combined_Bottom.png

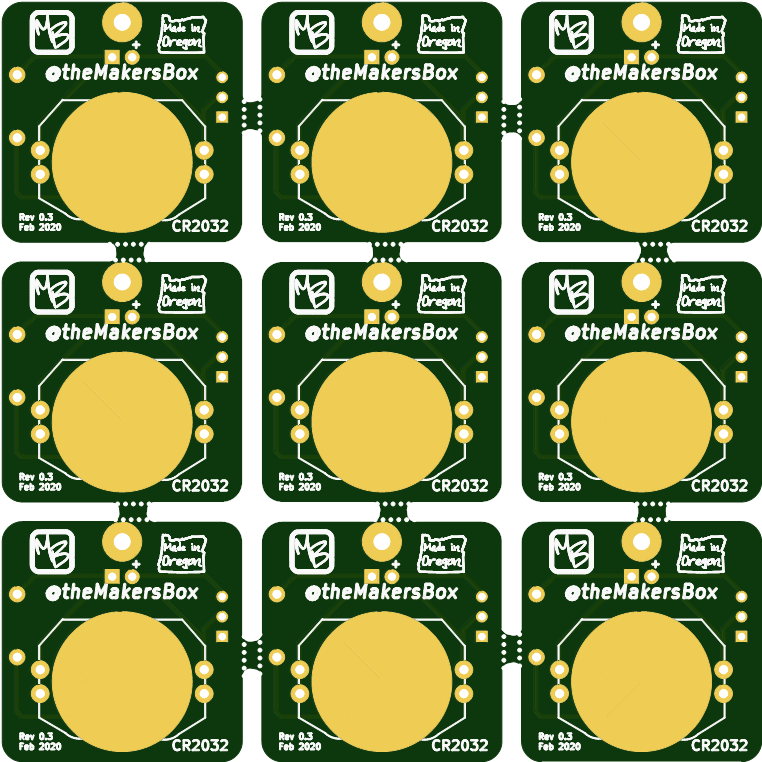
projects/ICanSolder/design_files 0-2/pannel/Untitled_Combined_Bottom.png
