aspro648/KiCad/projects/ICanSolder/design_files NJ State Fair/pannel/pannel_Combined_Top.png

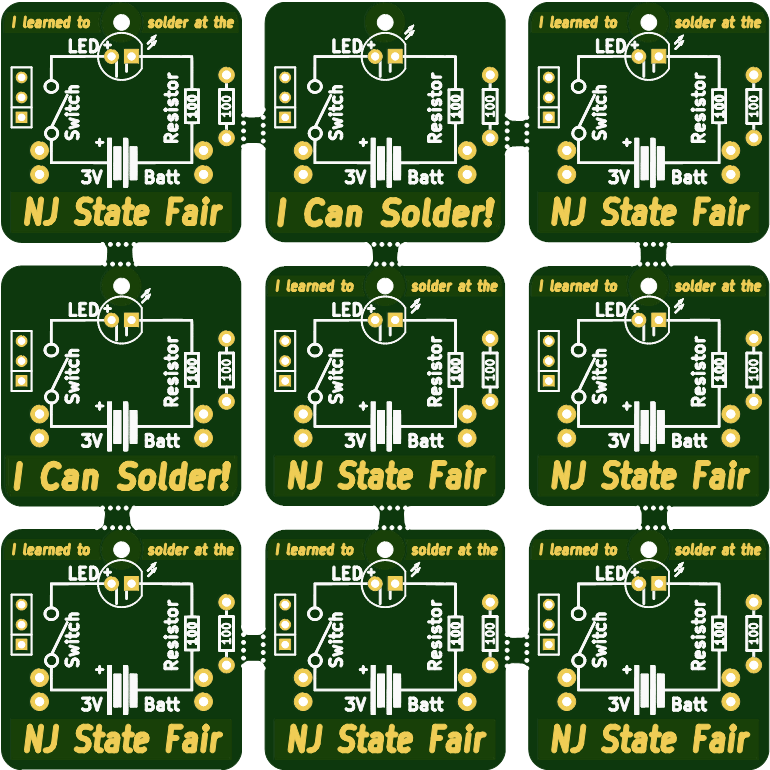
projects/ICanSolder/design_files NJ State Fair/pannel/pannel_Combined_Top.png
