aspro648/KiCad/projects/ICanSolder/design_files Saintcon2022/controller.png

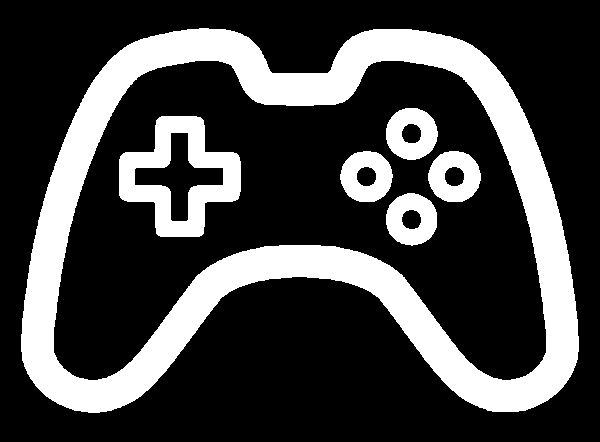
projects/ICanSolder/design_files Saintcon2022/controller.png
