aspro648/KiCad/projects/ICanSolder/design_files Saintcon2022/esports_only.png

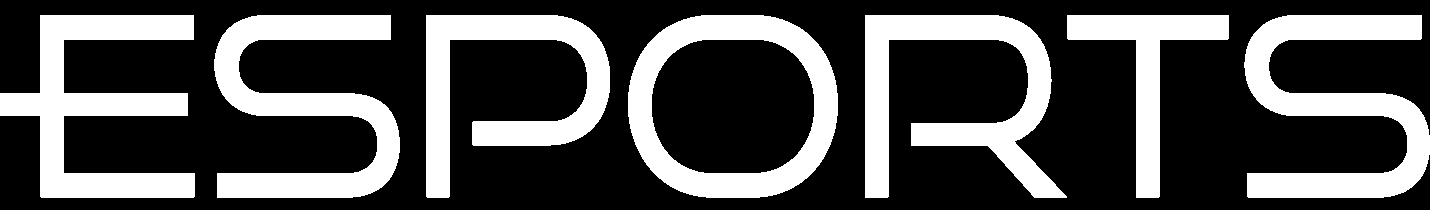
projects/ICanSolder/design_files Saintcon2022/esports_only.png
