aspro648/KiCad/projects/ICanSolder/design_files Saintcon2022/pannel/Untitled_Combined_Top.png

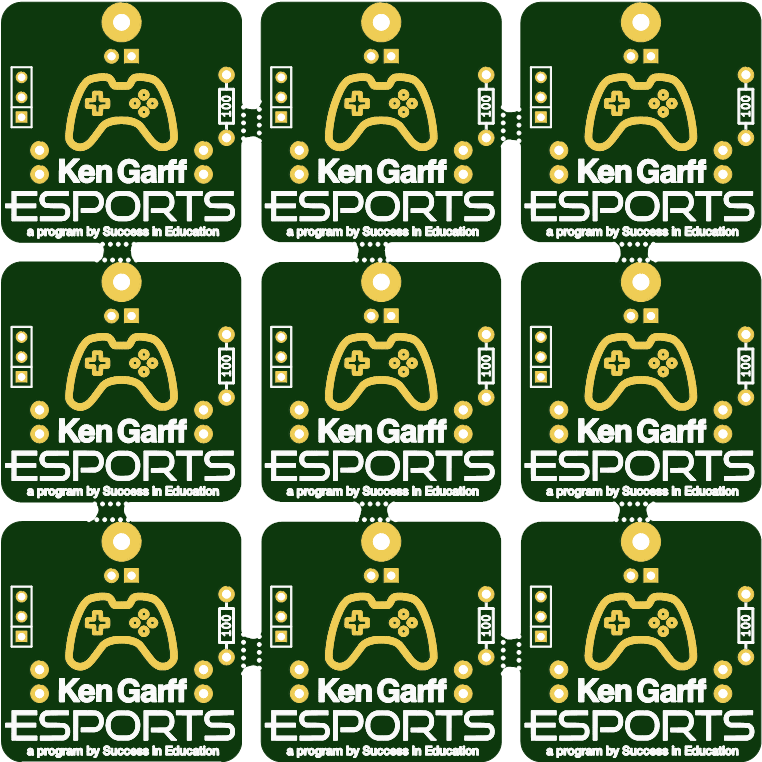
projects/ICanSolder/design_files Saintcon2022/pannel/Untitled_Combined_Top.png
