aspro648/KiCad/projects/ICanSolder/design_files Saintcon2022/project.png

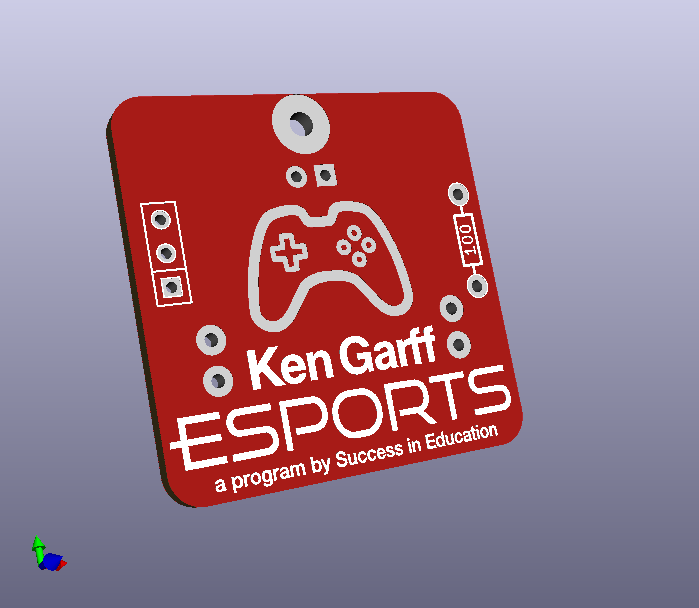
projects/ICanSolder/design_files Saintcon2022/project.png
