aspro648/KiCad/projects/JouleThief/docs/JouleThiefLabel3.png

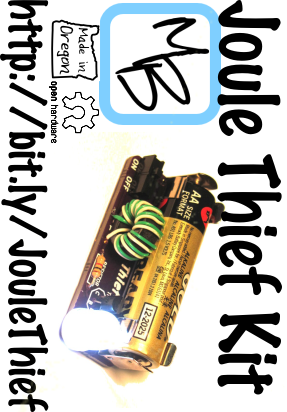
projects/JouleThief/docs/JouleThiefLabel3.png
