aspro648/KiCad/projects/JouleThief/Images/01_coil.png

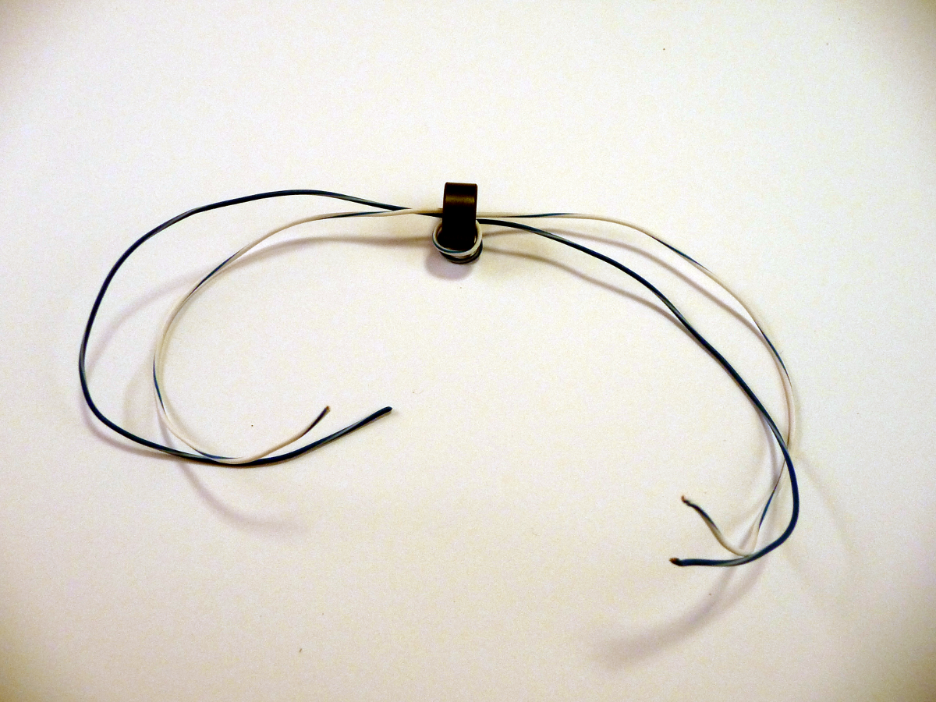
projects/JouleThief/Images/01_coil.png
