aspro648/KiCad/projects/JouleThief/Images/02_wind.png

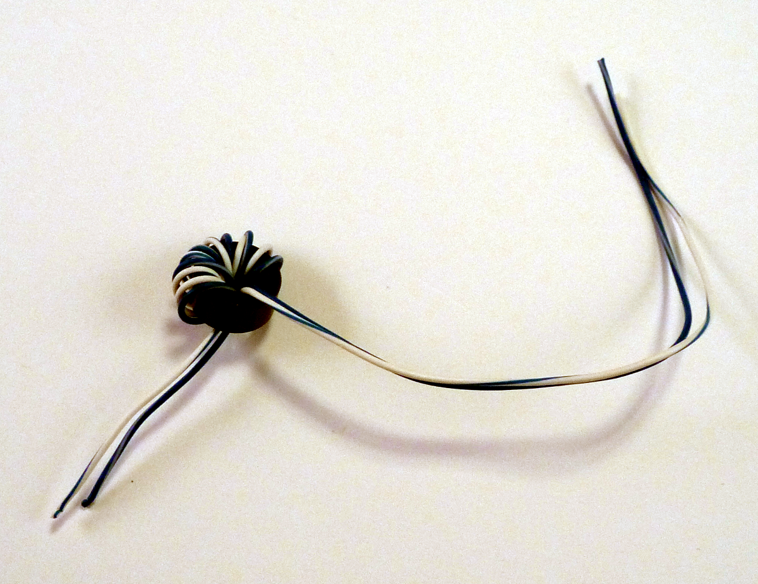
projects/JouleThief/Images/02_wind.png
