aspro648/KiCad/projects/JouleThief/Images/04_tin.png

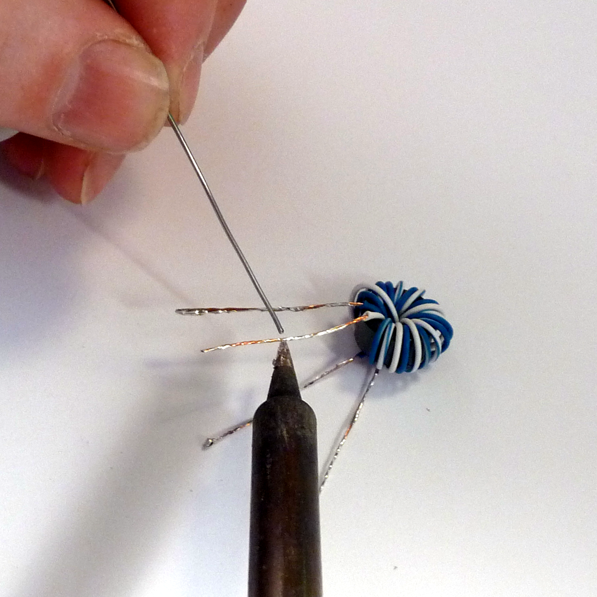
projects/JouleThief/Images/04_tin.png
