aspro648/KiCad/projects/JouleThief/Images/07_coil_finished.png

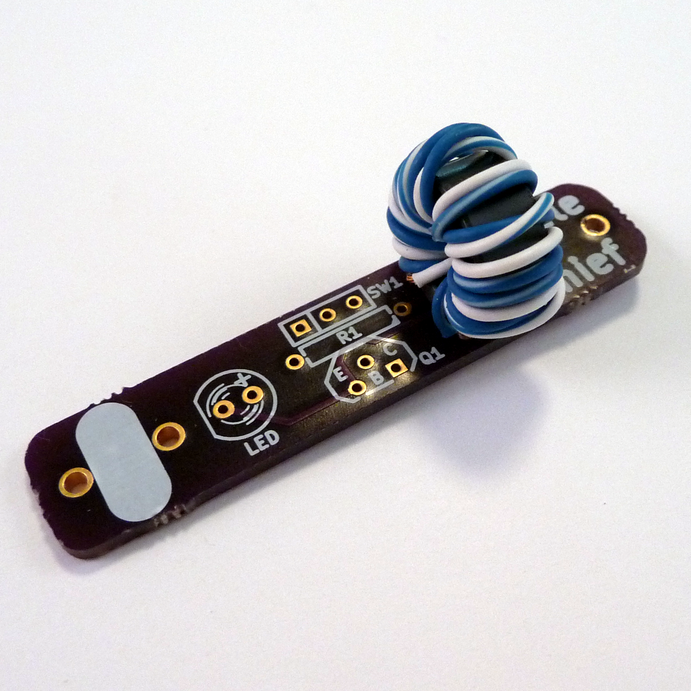
projects/JouleThief/Images/07_coil_finished.png
