aspro648/KiCad/projects/JouleThief/Images/08_resistor.png

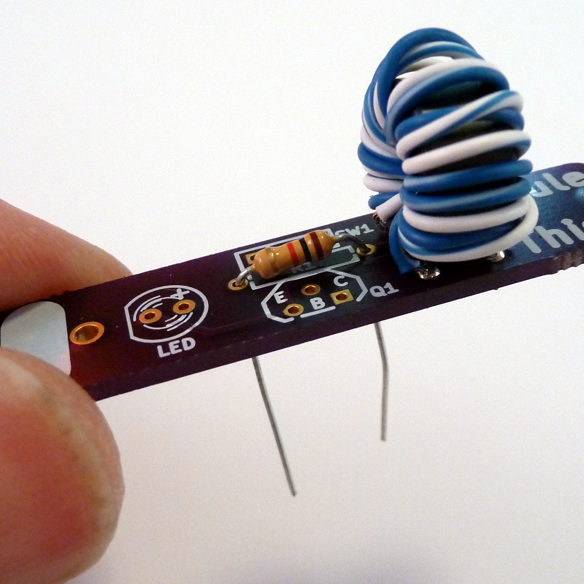
projects/JouleThief/Images/08_resistor.png
