aspro648/KiCad/projects/JouleThief/Images/11_LED.png

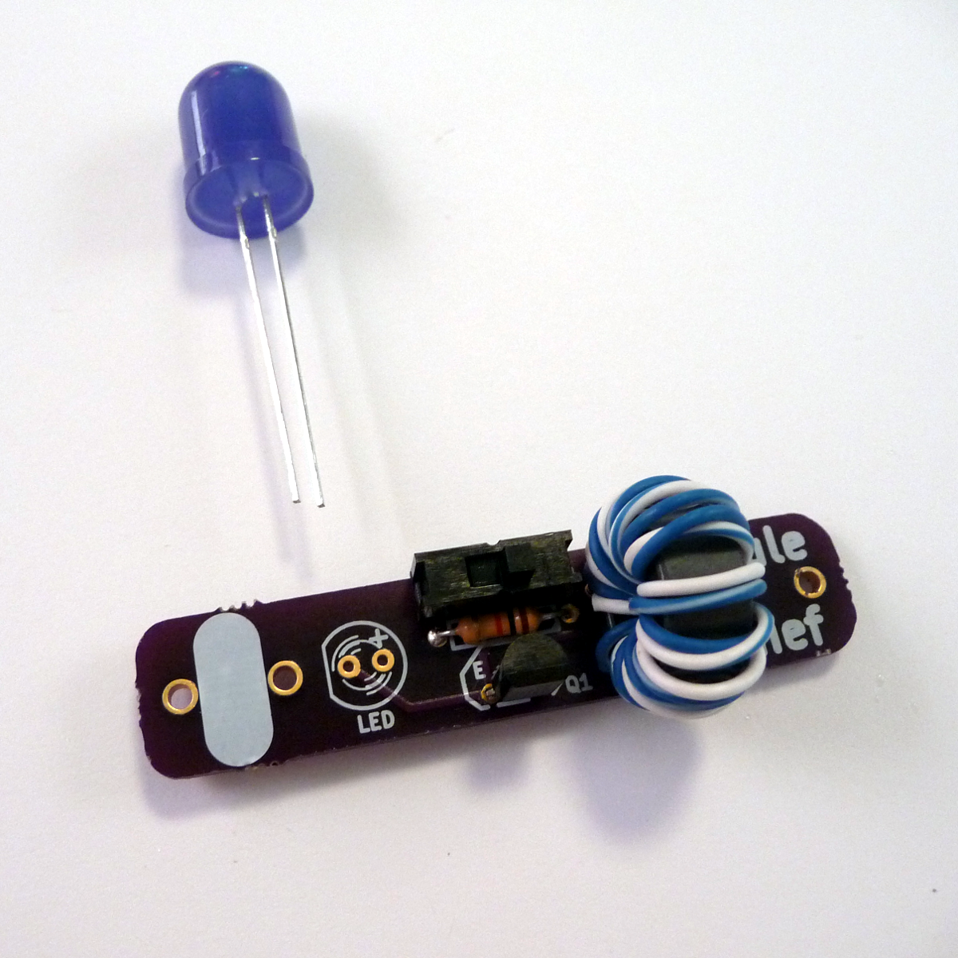
projects/JouleThief/Images/11_LED.png
