aspro648/KiCad/projects/JouleThief/Images/12_clips.png

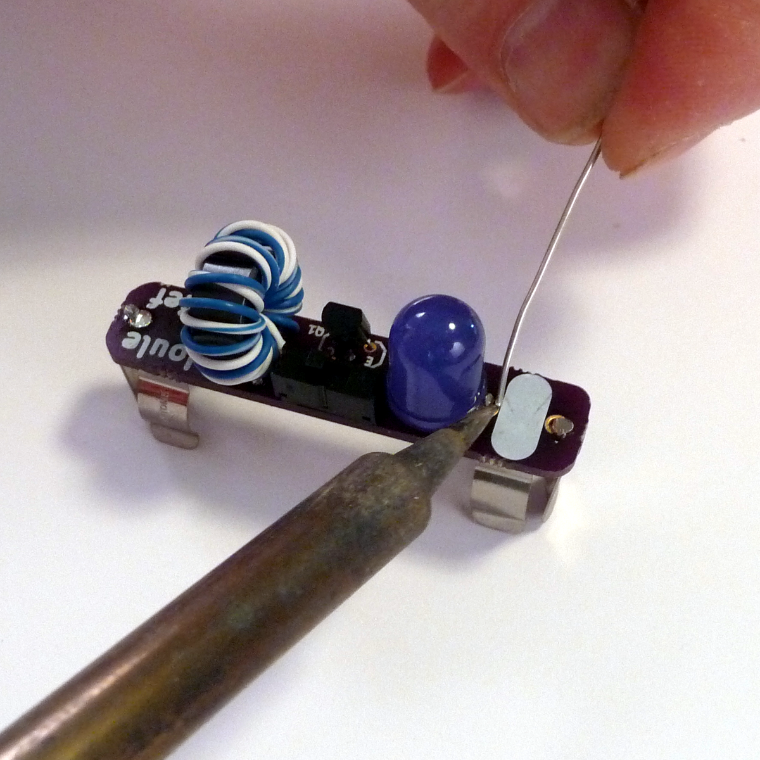
projects/JouleThief/Images/12_clips.png
