aspro648/KiCad/projects/JouleThief/Images/13_finished.png

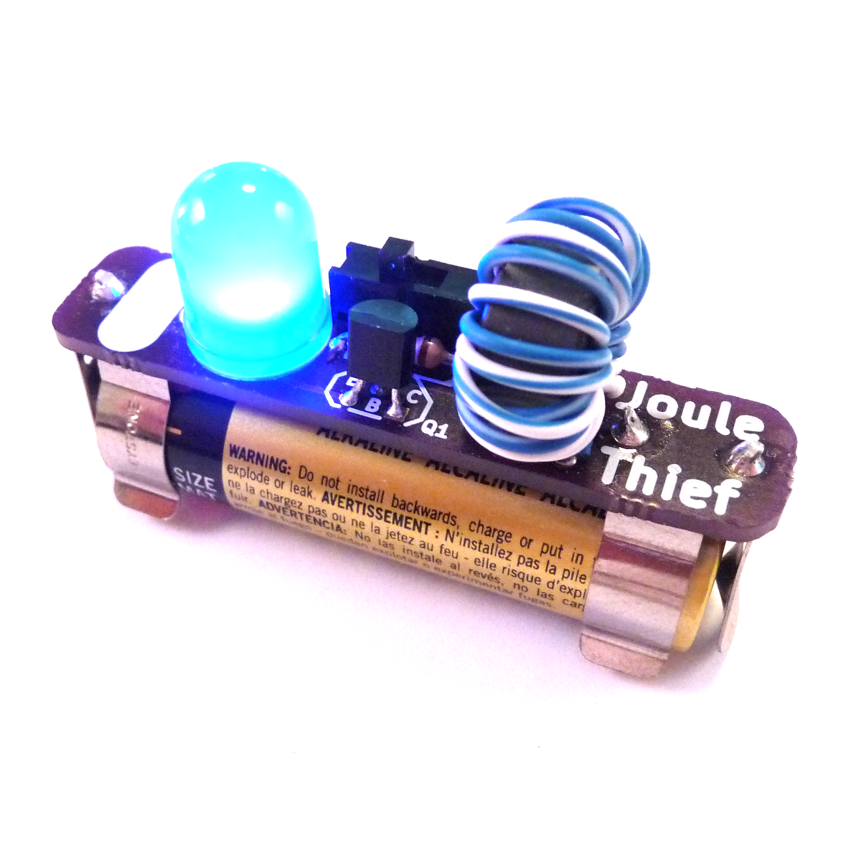
projects/JouleThief/Images/13_finished.png
