aspro648/KiCad/projects/JouleThief/Images/JouleThiefLabel.gif

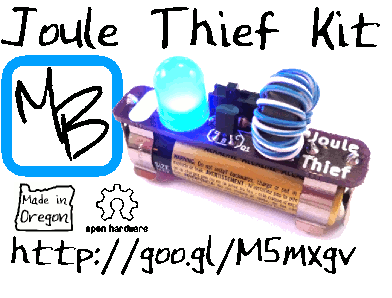
projects/JouleThief/Images/JouleThiefLabel.gif
