aspro648/KiCad/projects/JouleThief/Images/P1050560.JPG

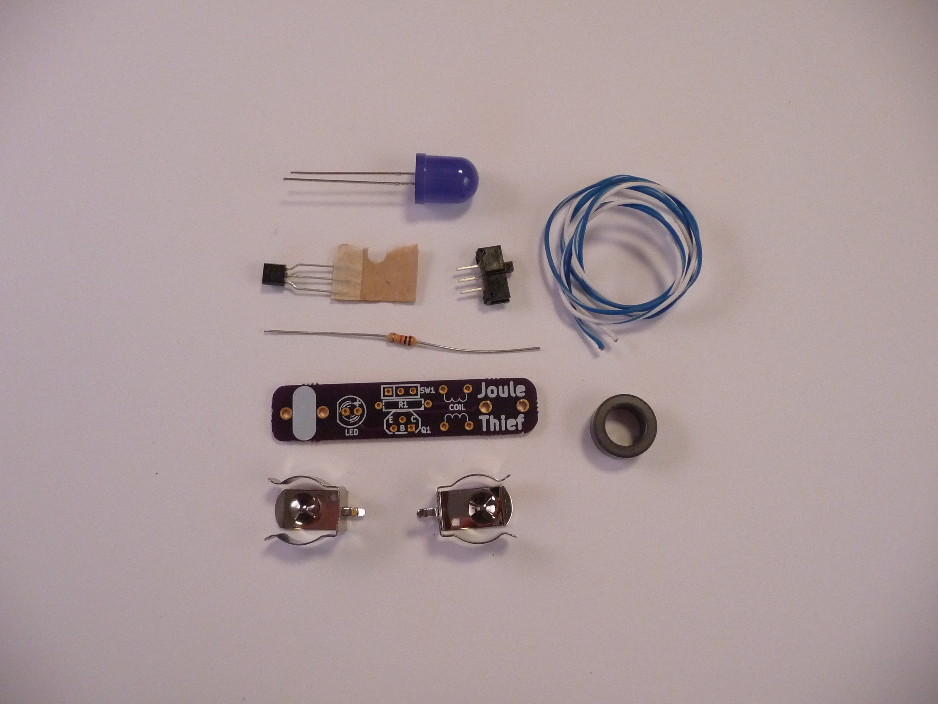
projects/JouleThief/Images/P1050560.JPG
