aspro648/KiCad/projects/JouleThief/Images/P1050562.JPG

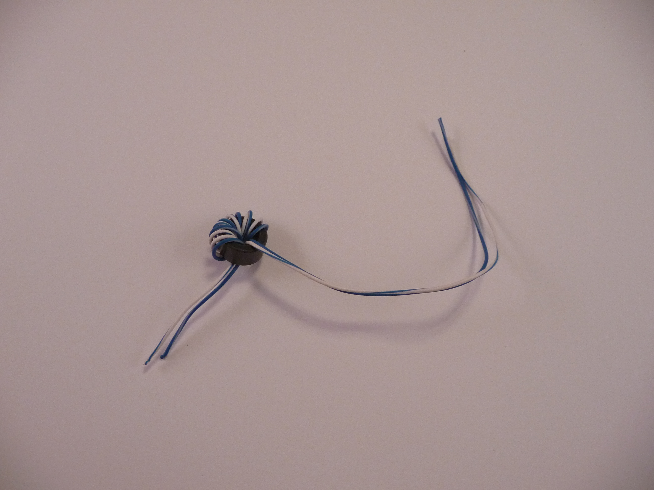
projects/JouleThief/Images/P1050562.JPG
