aspro648/KiCad/projects/JouleThief/Images/P1050565.JPG

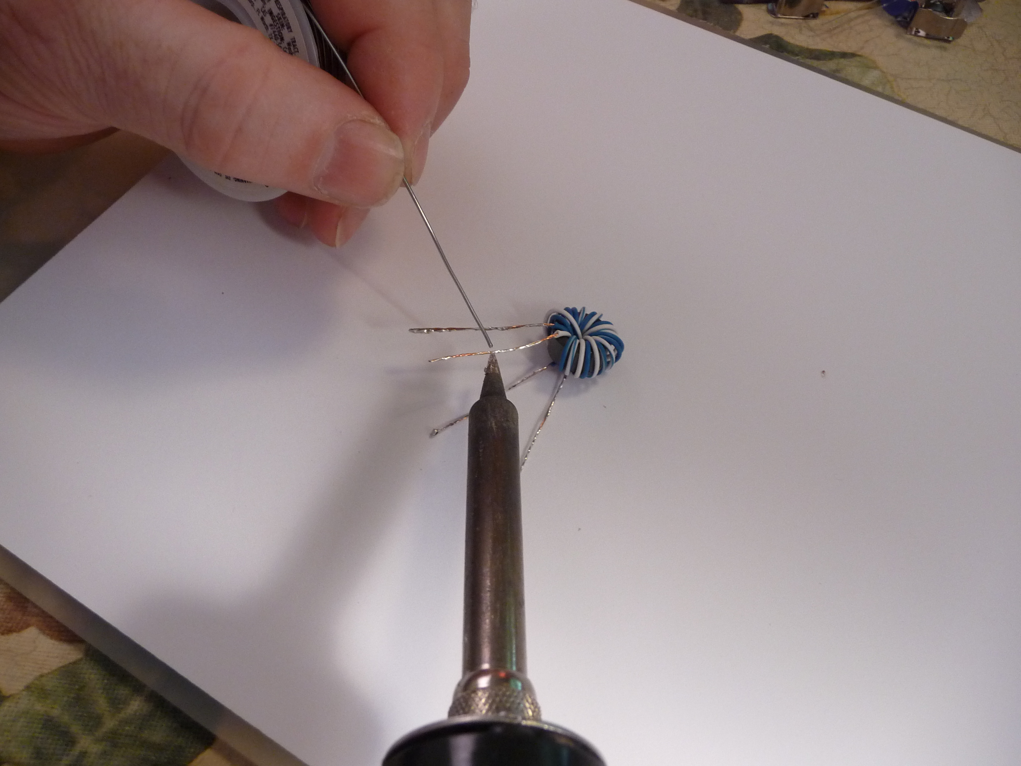
projects/JouleThief/Images/P1050565.JPG
