aspro648/KiCad/projects/JouleThief/Images/P1050573.JPG

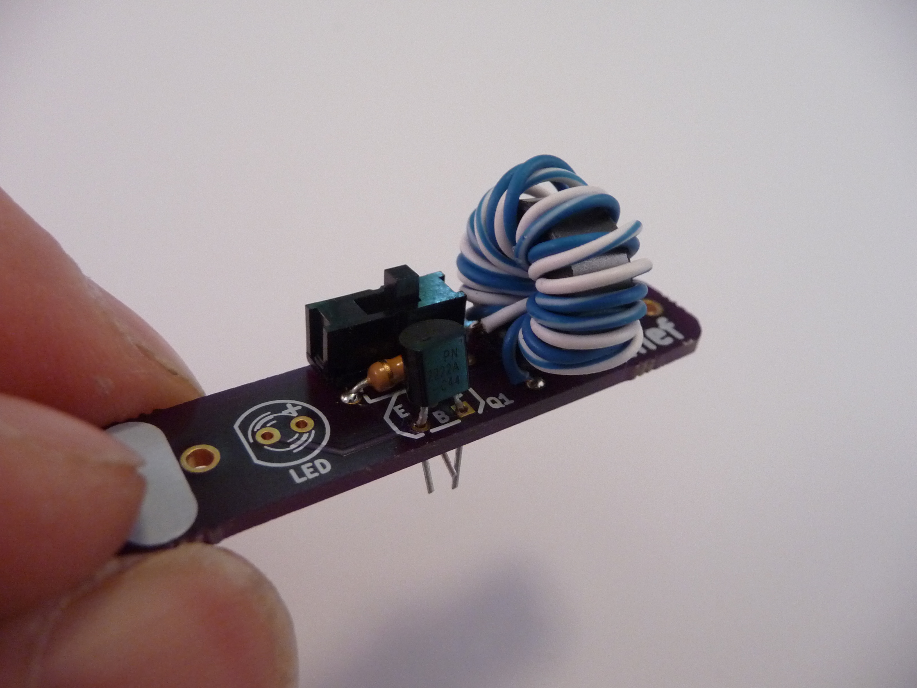
projects/JouleThief/Images/P1050573.JPG
