aspro648/KiCad/projects/JouleThief/Images/P1050575.JPG

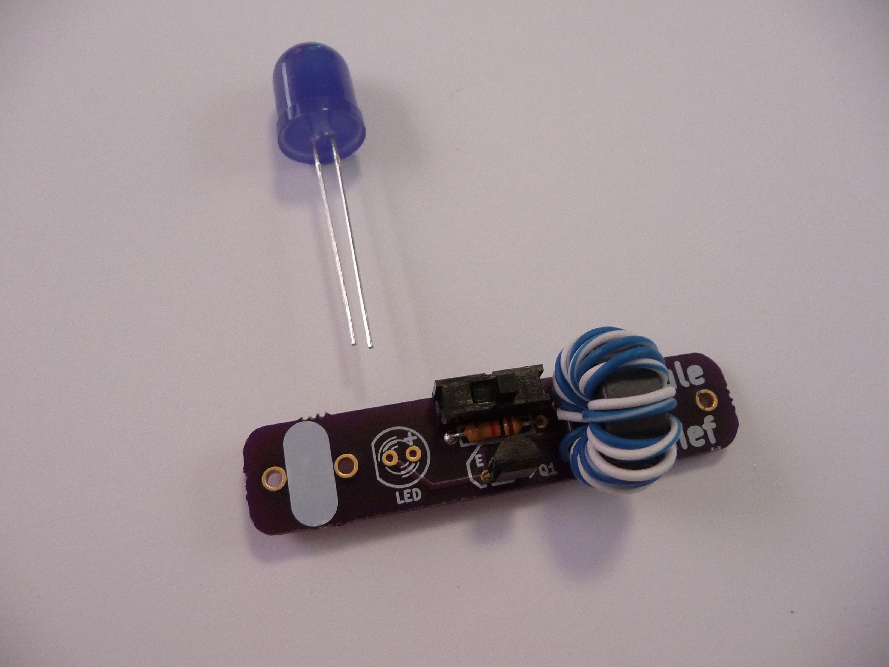
projects/JouleThief/Images/P1050575.JPG
