aspro648/KiCad/projects/JouleThief/Images/P1050577.JPG

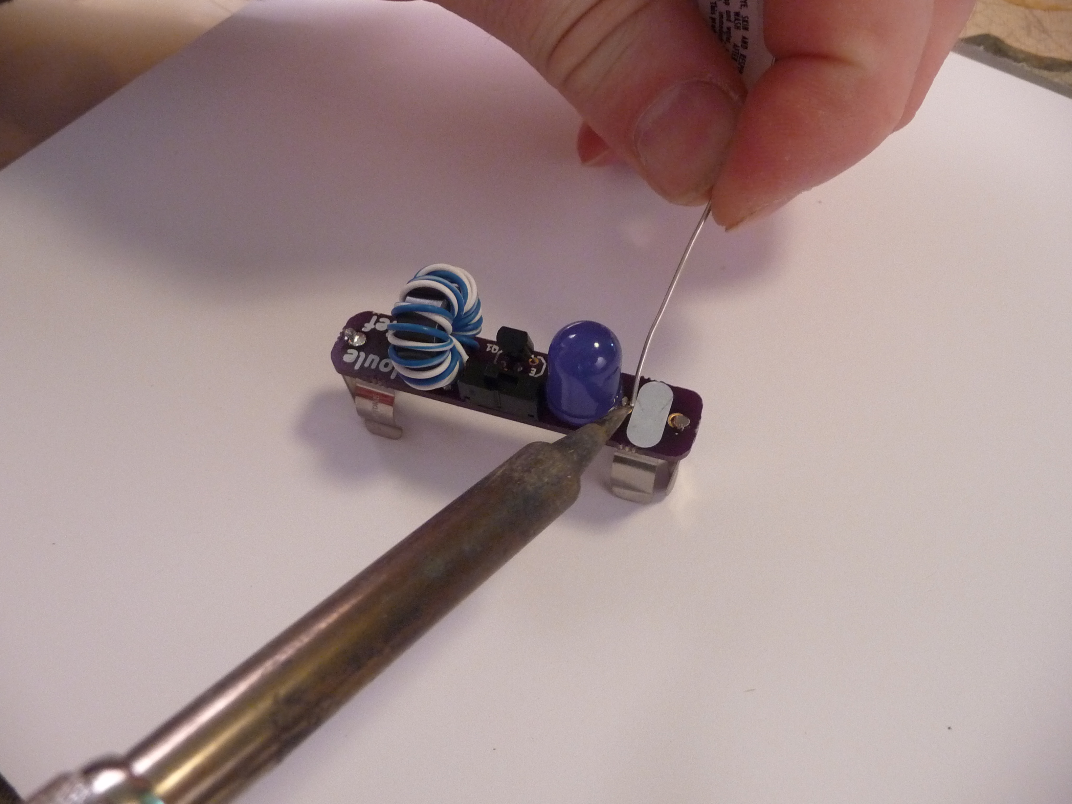
projects/JouleThief/Images/P1050577.JPG
