aspro648/KiCad/projects/JouleThief/Images/P1050579.JPG

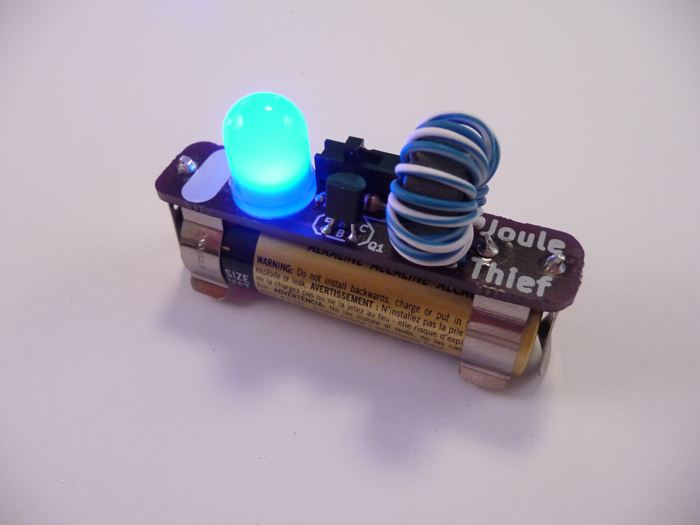
projects/JouleThief/Images/P1050579.JPG
