aspro648/KiCad/projects/LEGO/design_files_attiny826_LiPo V1/project.png

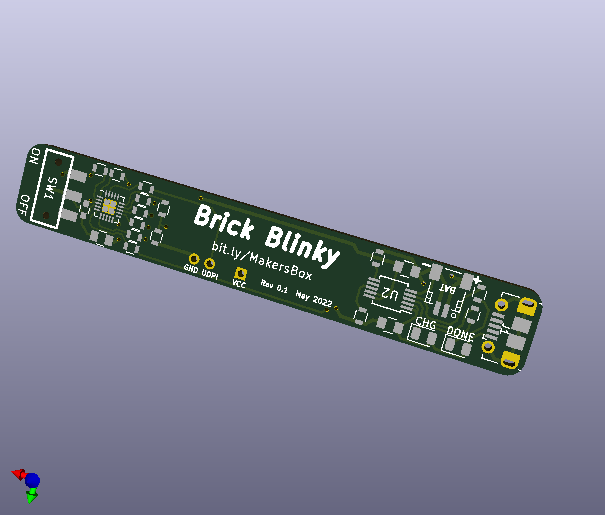
projects/LEGO/design_files_attiny826_LiPo V1/project.png
