aspro648/KiCad/projects/MOSFET_jr/images/Mosfet.png

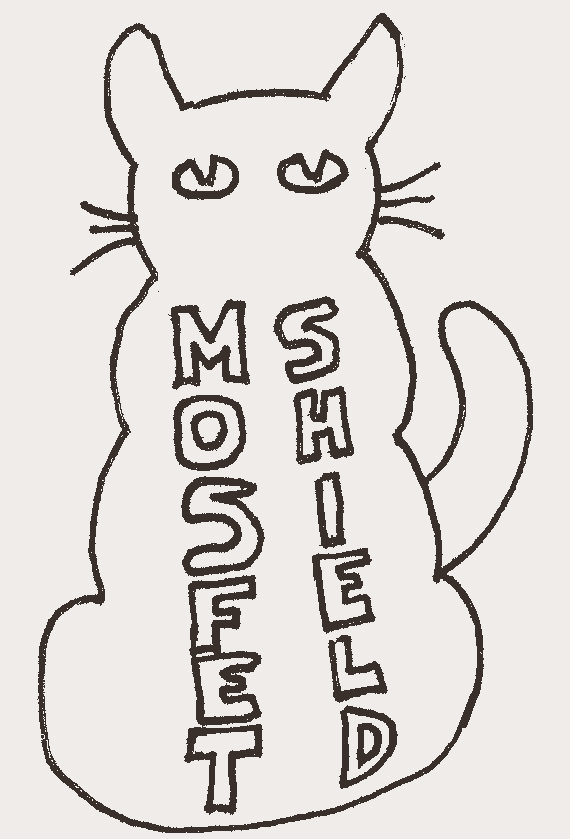
projects/MOSFET_jr/images/Mosfet.png
