aspro648/KiCad/projects/MOSFET_jr/images/MOSFET_3D.png

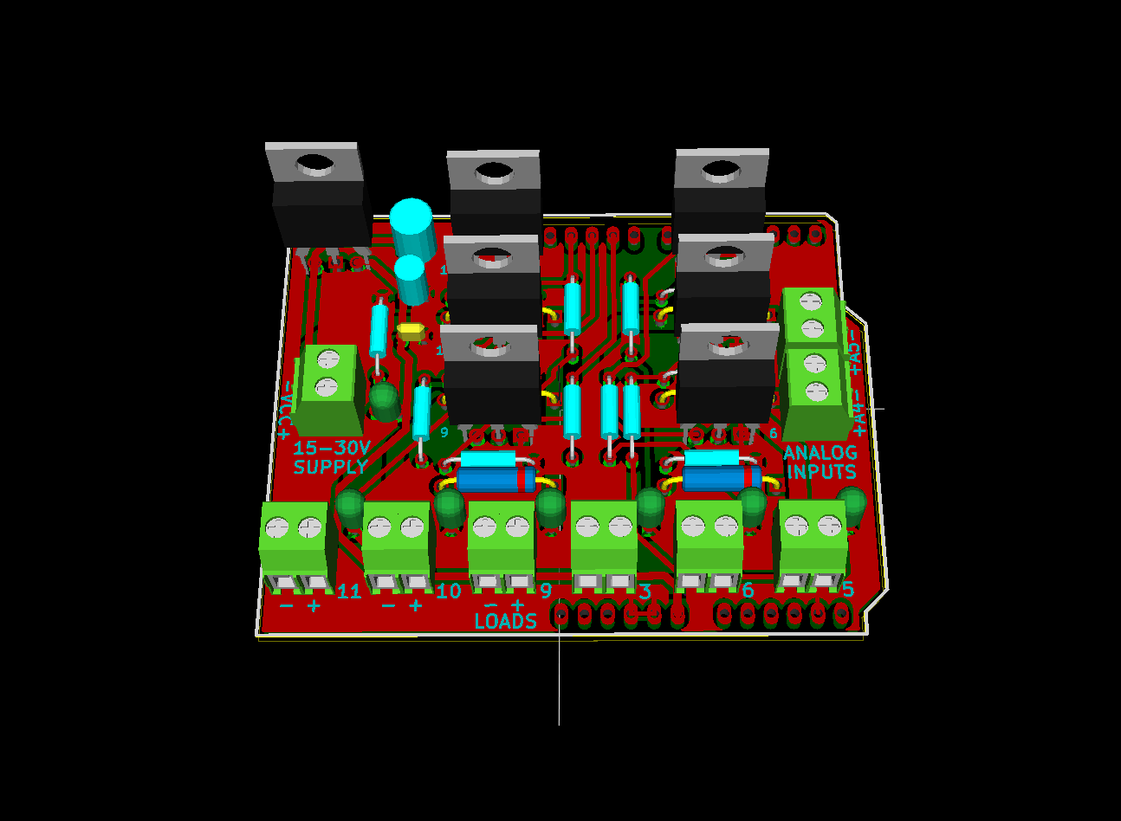
projects/MOSFET_jr/images/MOSFET_3D.png
