aspro648/KiCad/projects/MOSFET_jr/images/MOSFET_jr_schematic.png

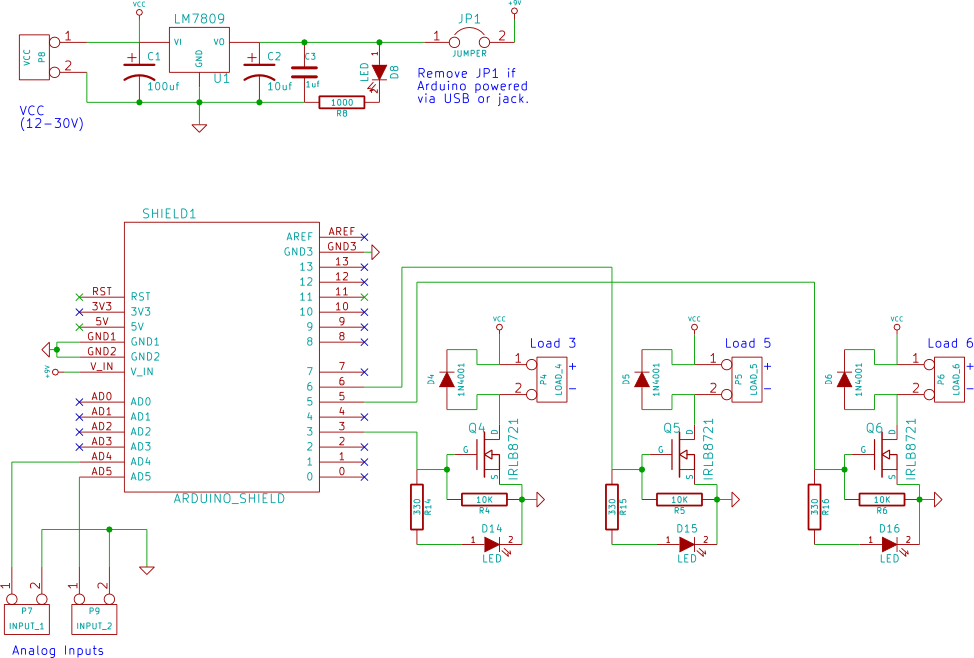
projects/MOSFET_jr/images/MOSFET_jr_schematic.png
