aspro648/KiCad/projects/MOSFET_jr/images/Mosfet_Label.png

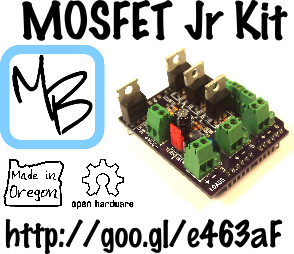
projects/MOSFET_jr/images/Mosfet_Label.png
