aspro648/KiCad/projects/Nerf/Ardu RapidStrike/design_files Stryfe V03pretearup/stryfe.bmp

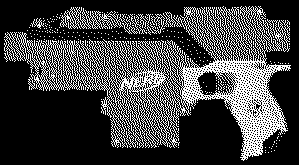
projects/Nerf/Ardu RapidStrike/design_files Stryfe V03pretearup/stryfe.bmp
