aspro648/KiCad/projects/Nerf/Ardu RapidStrike/images/02_1k_ohm.png

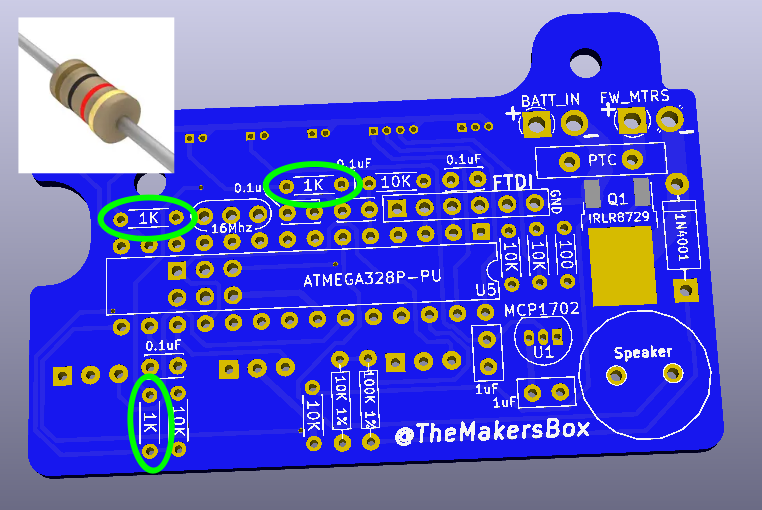
projects/Nerf/Ardu RapidStrike/images/02_1k_ohm.png
