aspro648/KiCad/projects/Nerf/Ardu RapidStrike/images/07_1N4001.png

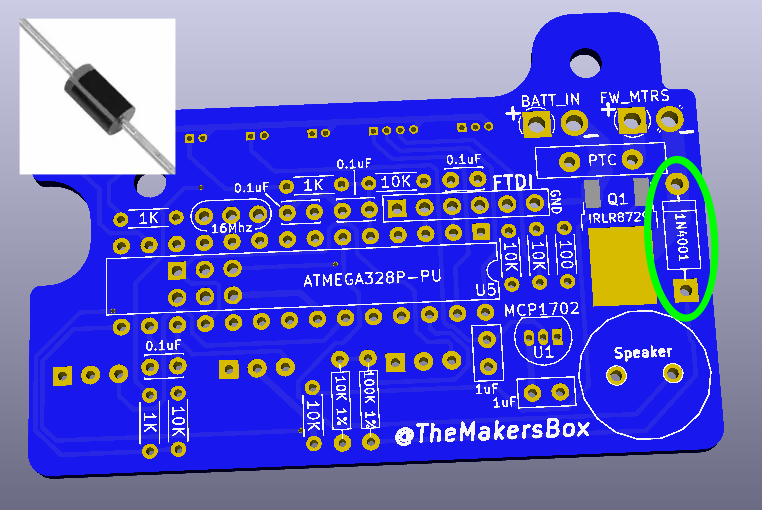
projects/Nerf/Ardu RapidStrike/images/07_1N4001.png
