aspro648/KiCad/projects/Nerf/Ardu RapidStrike/images/09_cap105.png

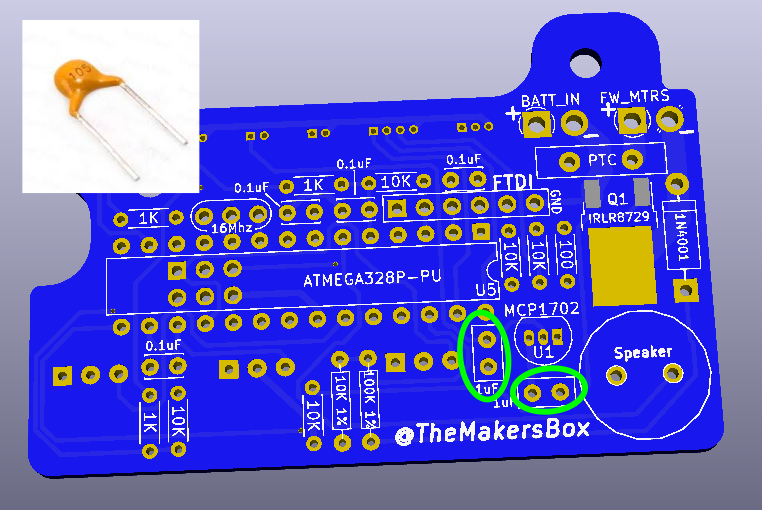
projects/Nerf/Ardu RapidStrike/images/09_cap105.png
