aspro648/KiCad/projects/Nerf/Ardu RapidStrike/images/10_328.png

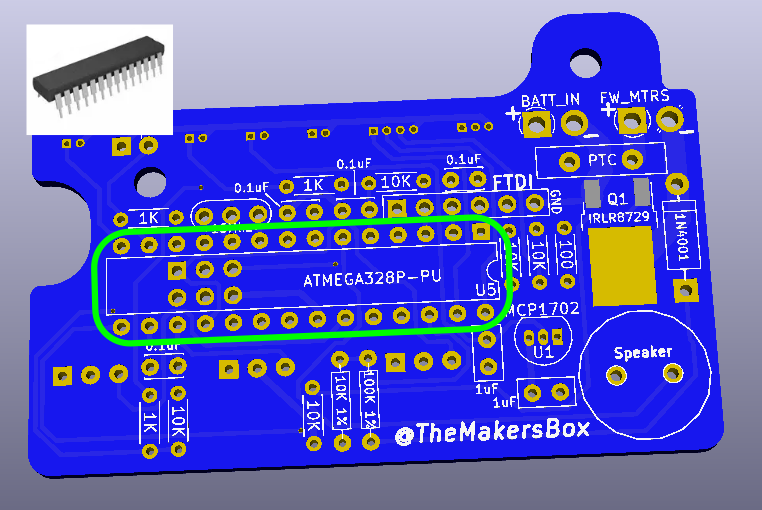
projects/Nerf/Ardu RapidStrike/images/10_328.png
