aspro648/KiCad/projects/Nerf/Ardu RapidStrike/images/12 piezo.png

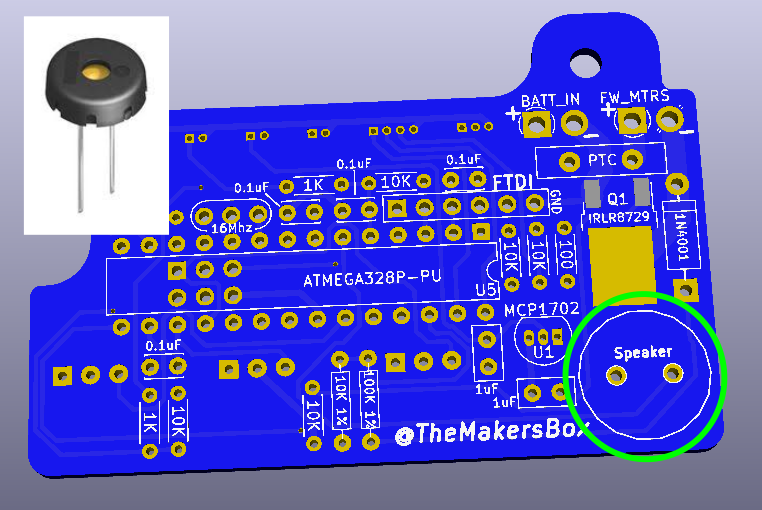
projects/Nerf/Ardu RapidStrike/images/12 piezo.png
