aspro648/KiCad/projects/Nerf/Ardu RapidStrike/images/14 PTC.png

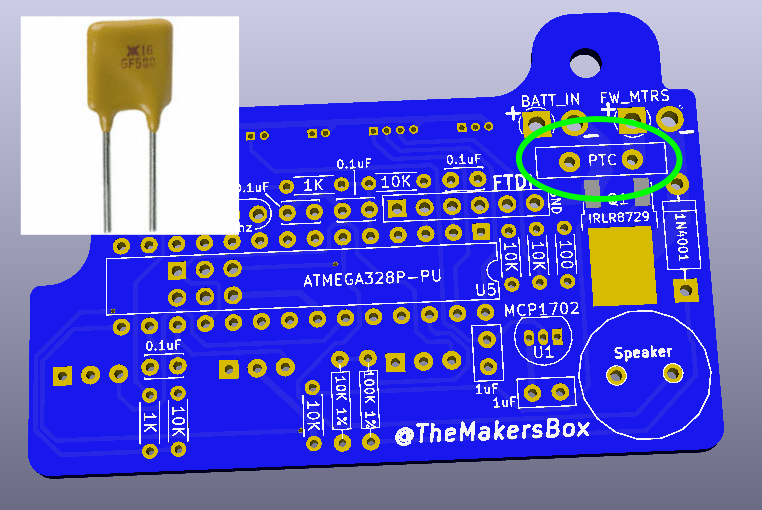
projects/Nerf/Ardu RapidStrike/images/14 PTC.png
