aspro648/KiCad/projects/Nerf/Ardu RapidStrike/images/20 Hall.png

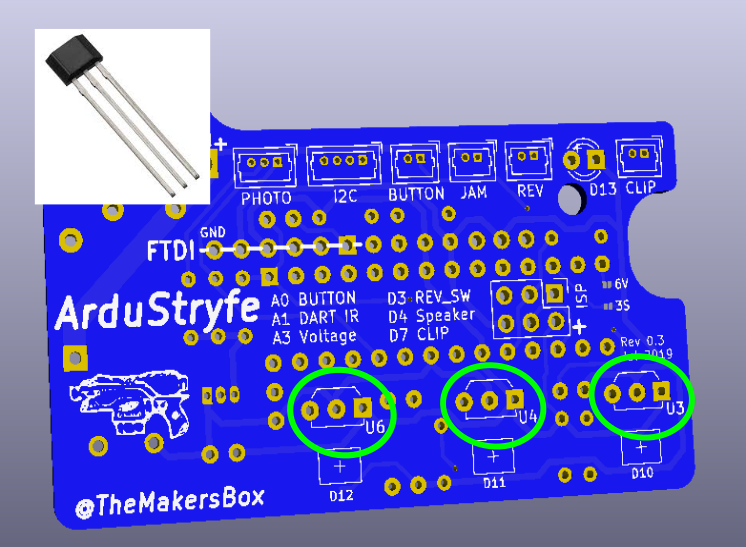
projects/Nerf/Ardu RapidStrike/images/20 Hall.png
