aspro648/KiCad/projects/Nerf/Ardu RapidStrike/images/22 2PIN.png

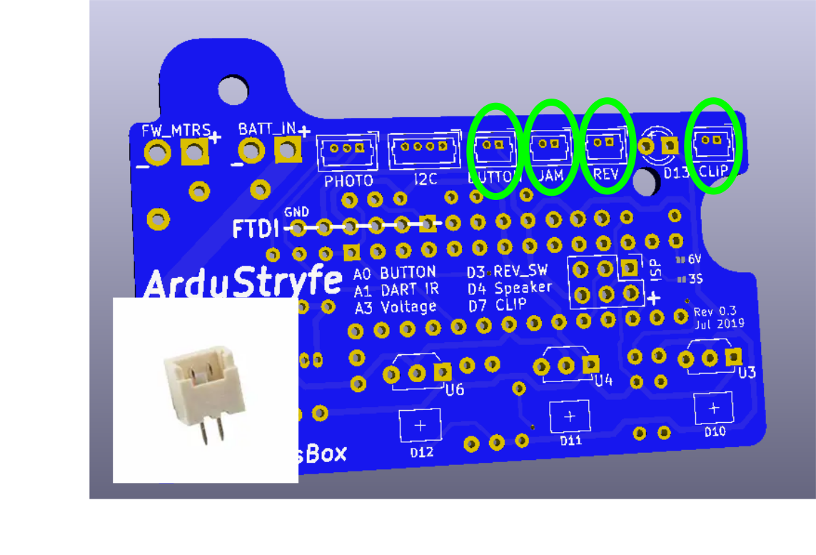
projects/Nerf/Ardu RapidStrike/images/22 2PIN.png
