aspro648/KiCad/projects/Nerf/Ardu RapidStrike/images/stryfe_instrument.JPG

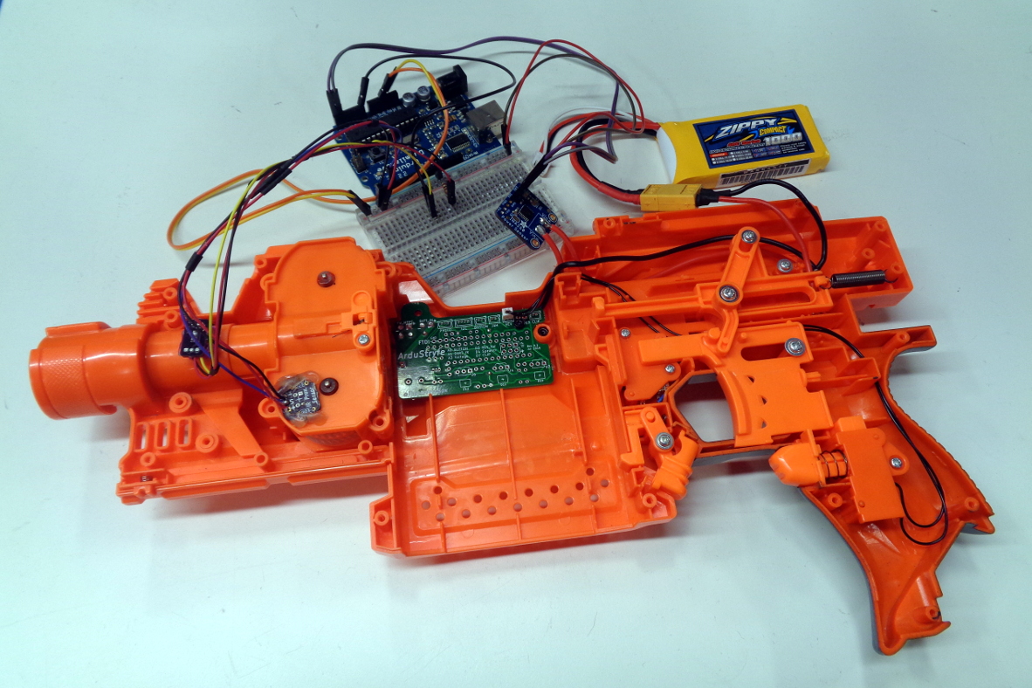
projects/Nerf/Ardu RapidStrike/images/stryfe_instrument.JPG
