aspro648/KiCad/projects/Nerf/ArduStryfe_MOSFET/design_files Stryfe MOSFET V01/img/P1090154.JPG

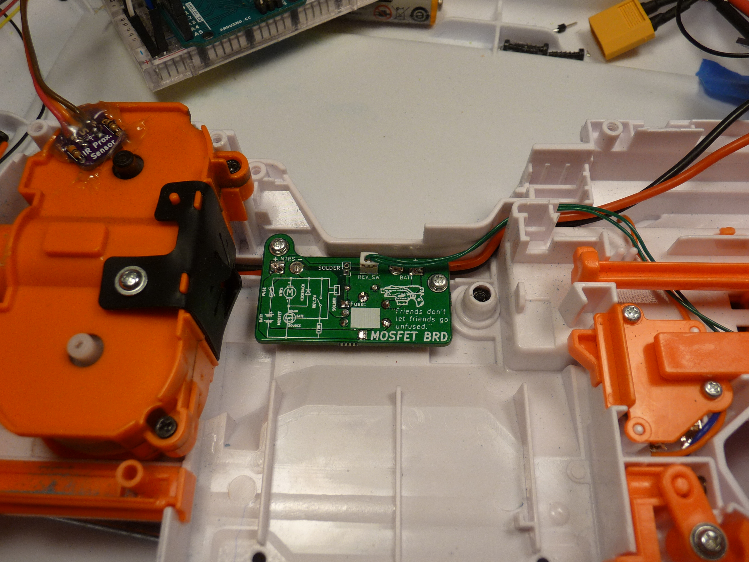
projects/Nerf/ArduStryfe_MOSFET/design_files Stryfe MOSFET V01/img/P1090154.JPG
