aspro648/KiCad/projects/Nerf/ArduStryfe_MOSFET/design_files Stryfe MOSFET V01/pannel/pannell_Combined_Top.png

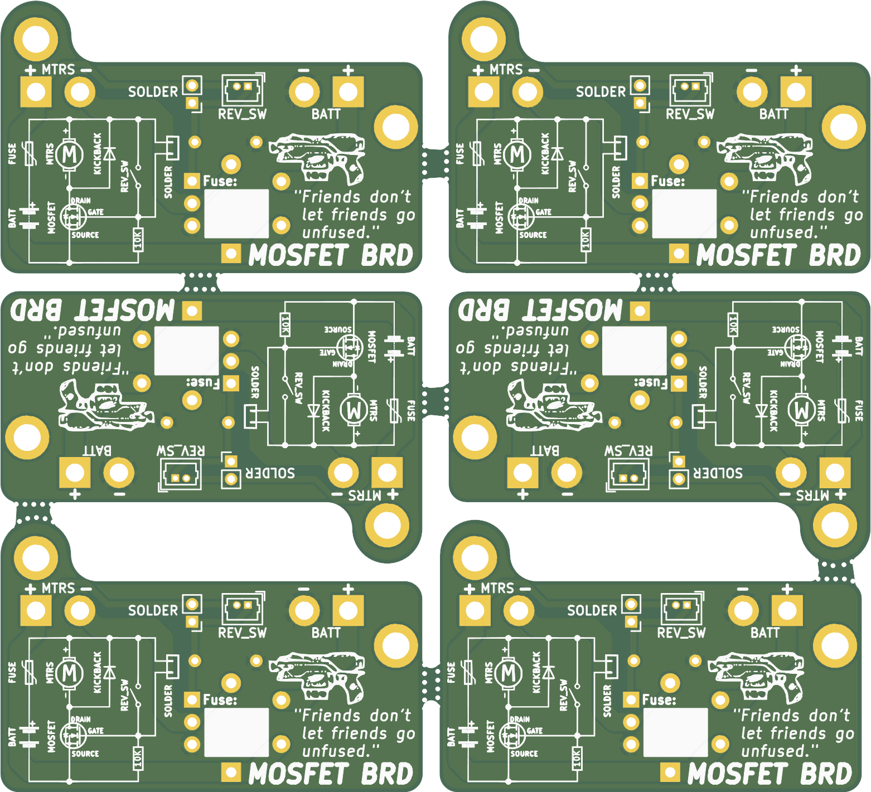
projects/Nerf/ArduStryfe_MOSFET/design_files Stryfe MOSFET V01/pannel/pannell_Combined_Top.png
