aspro648/KiCad/projects/Nerf/ArduStryfe_MOSFET/design_files Stryfe MOSFET V01/project_front.png

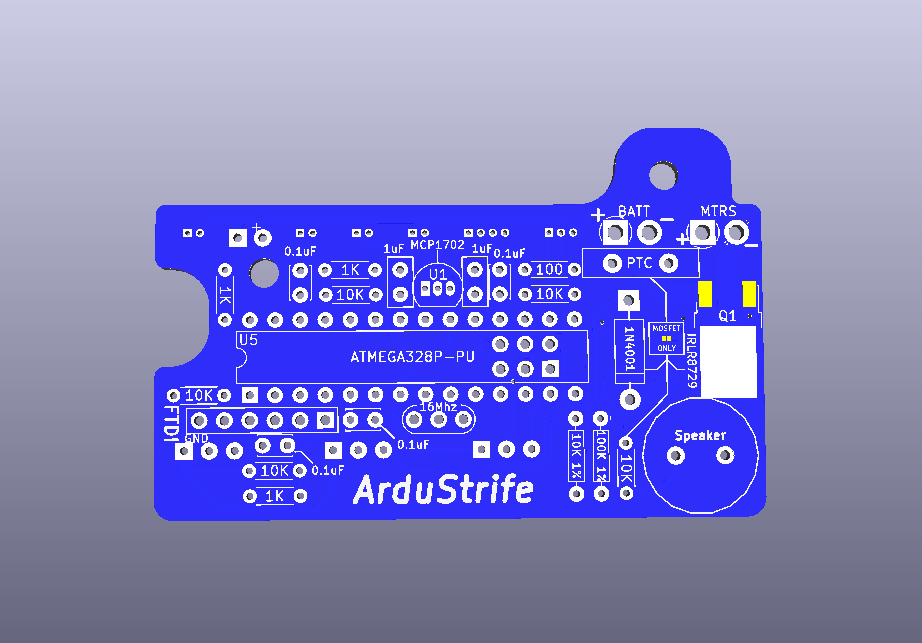
projects/Nerf/ArduStryfe_MOSFET/design_files Stryfe MOSFET V01/project_front.png
