aspro648/KiCad/projects/Nerf/ArduStryfe_MOSFET/design_files Stryfe MOSFET V01/schematic.png

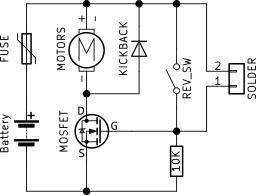
projects/Nerf/ArduStryfe_MOSFET/design_files Stryfe MOSFET V01/schematic.png
