aspro648/KiCad/projects/Nerf/NerfChrono3/design_files/project.png

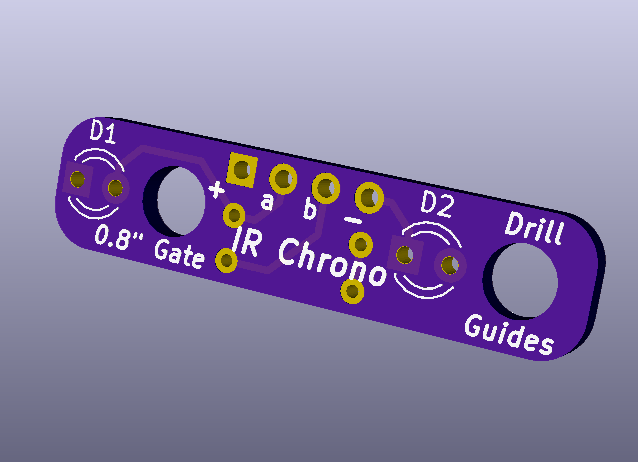
projects/Nerf/NerfChrono3/design_files/project.png
