aspro648/KiCad/projects/Nerf/NerfLED/design_files/project.png

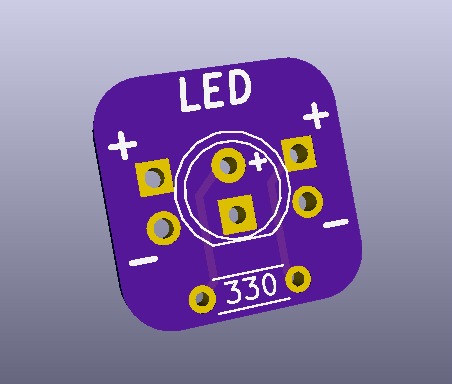
projects/Nerf/NerfLED/design_files/project.png
