aspro648/KiCad/projects/Nerf/NerfMuzzleFlash 2/design_files/images/connector.png

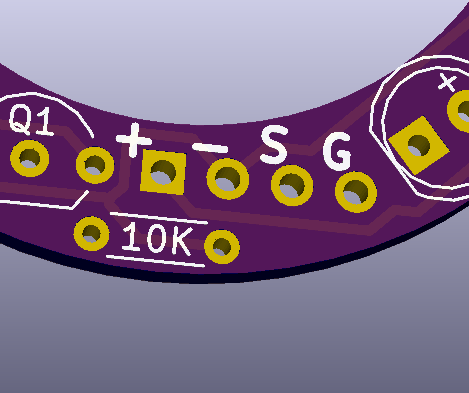
projects/Nerf/NerfMuzzleFlash 2/design_files/images/connector.png
