aspro648/KiCad/projects/Nerf/NerfMuzzleFlash 2/design_files/images/detect.png

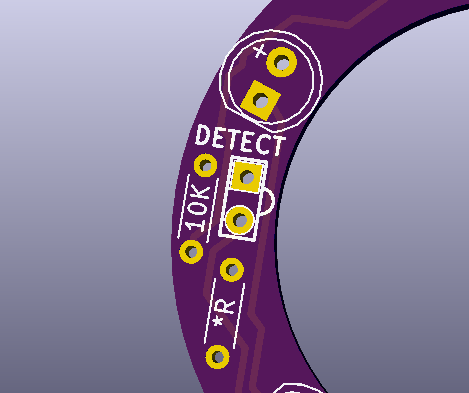
projects/Nerf/NerfMuzzleFlash 2/design_files/images/detect.png
