aspro648/KiCad/projects/Nerf/NerfMuzzleFlash 2/design_files/images/emitter.png

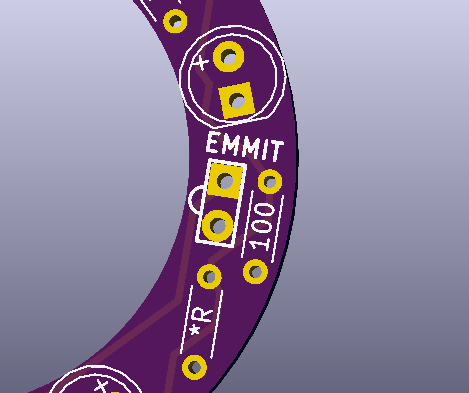
projects/Nerf/NerfMuzzleFlash 2/design_files/images/emitter.png
