aspro648/KiCad/projects/Nerf/NerfMuzzleFlash 2/design_files/images/NPN.png

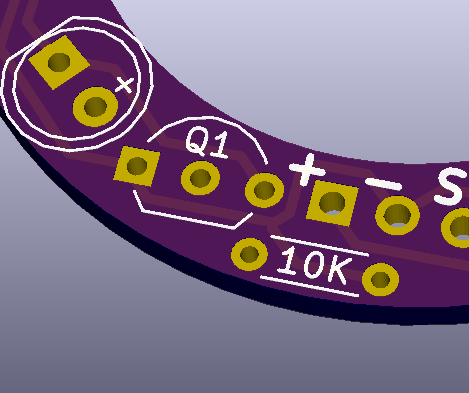
projects/Nerf/NerfMuzzleFlash 2/design_files/images/NPN.png
