aspro648/KiCad/projects/Nerf/NerfMuzzleFlash 2/design_files/pannel/pannel_Combined_Bottom.png

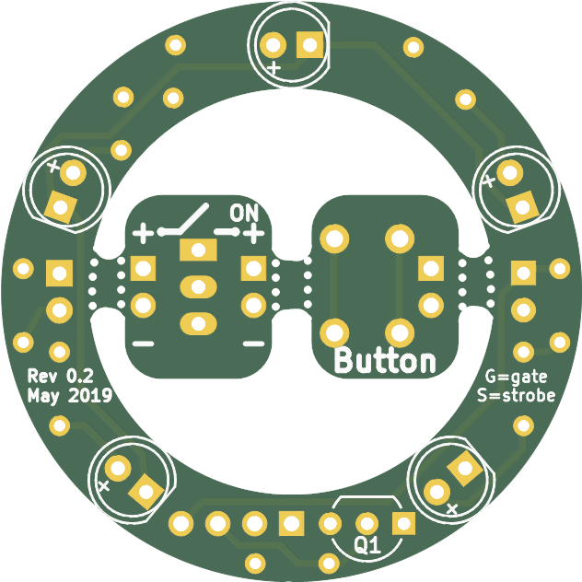
projects/Nerf/NerfMuzzleFlash 2/design_files/pannel/pannel_Combined_Bottom.png
