aspro648/KiCad/projects/Nerf/NerfMuzzleFlash 2/design_files/pannel/pannel_Combined_Top.png

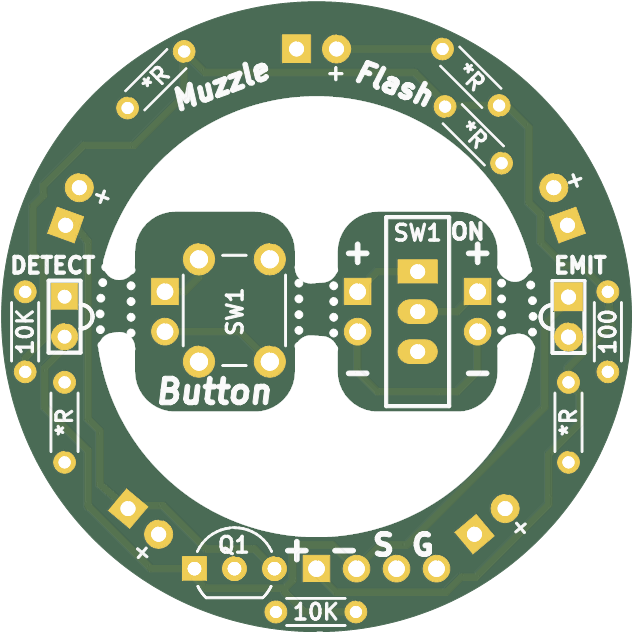
projects/Nerf/NerfMuzzleFlash 2/design_files/pannel/pannel_Combined_Top.png
