aspro648/KiCad/projects/Nerf/NerfMuzzleFlash 2/design_files/project.png

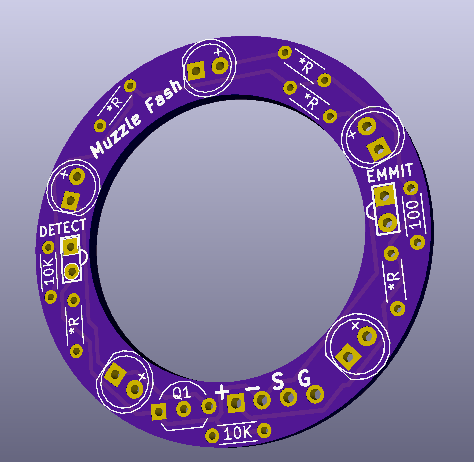
projects/Nerf/NerfMuzzleFlash 2/design_files/project.png
