aspro648/KiCad/projects/Nerf/NerfMuzzleFlash/design_files/project.png

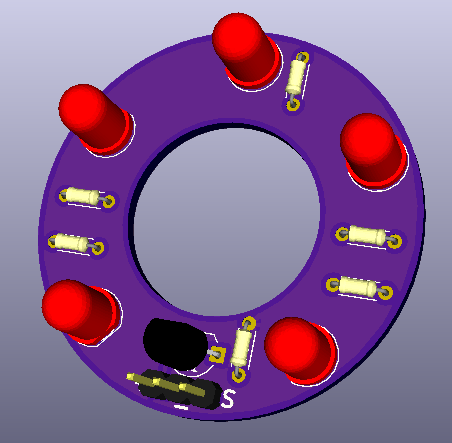
projects/Nerf/NerfMuzzleFlash/design_files/project.png
