aspro648/KiCad/projects/OSH Park I Can Solder/images/schematic.png

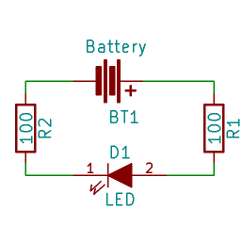
projects/OSH Park I Can Solder/images/schematic.png
