aspro648/KiCad/projects/tacuino R3/Docs/tacuino.sch.png

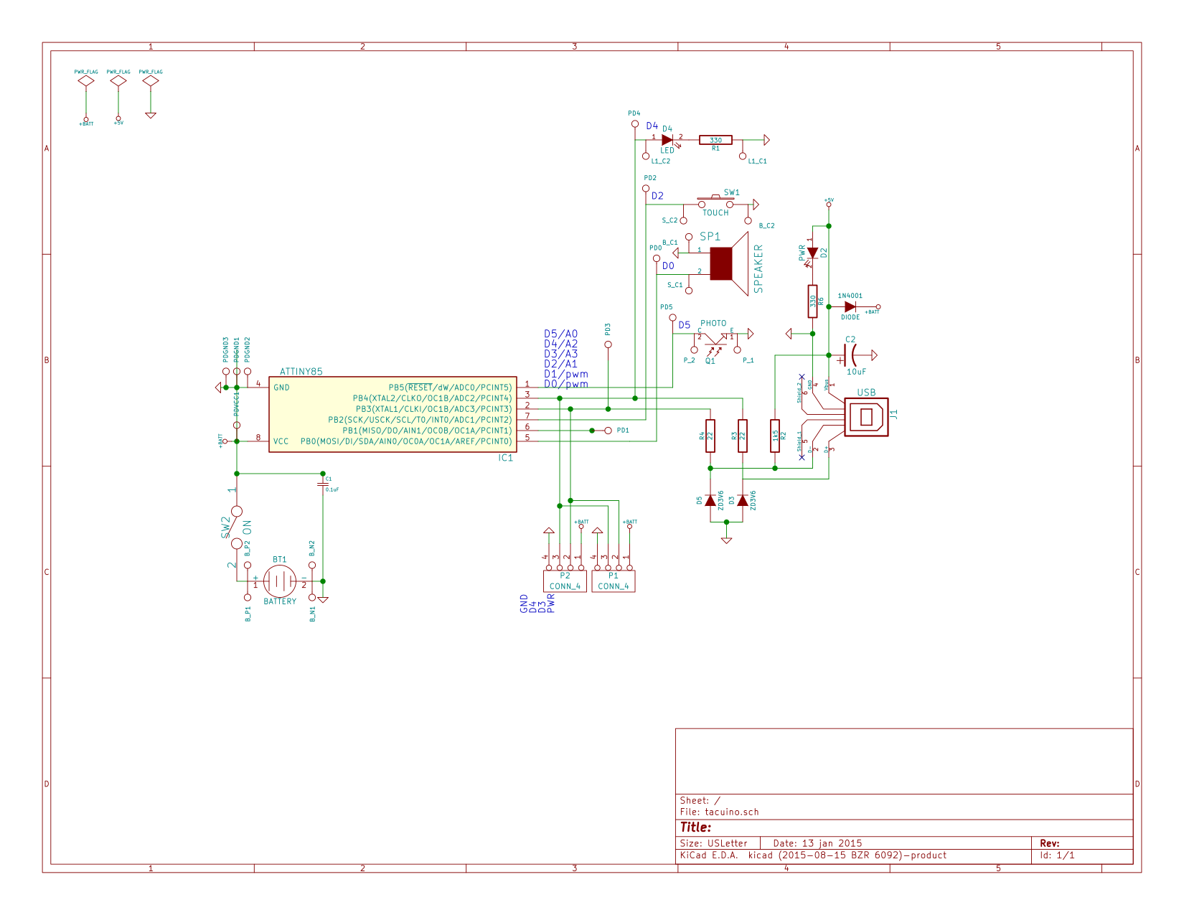
projects/tacuino R3/Docs/tacuino.sch.png
