aspro648/KiCad/projects/tacuino R3/Docs/tacuino_clip2.png

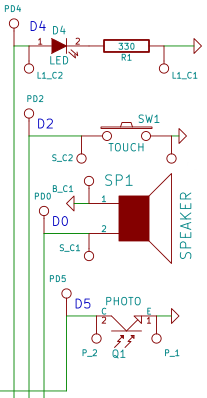
projects/tacuino R3/Docs/tacuino_clip2.png
