aspro648/KiCad/projects/tacuino R3/Docs/Tacuino_schematic.png

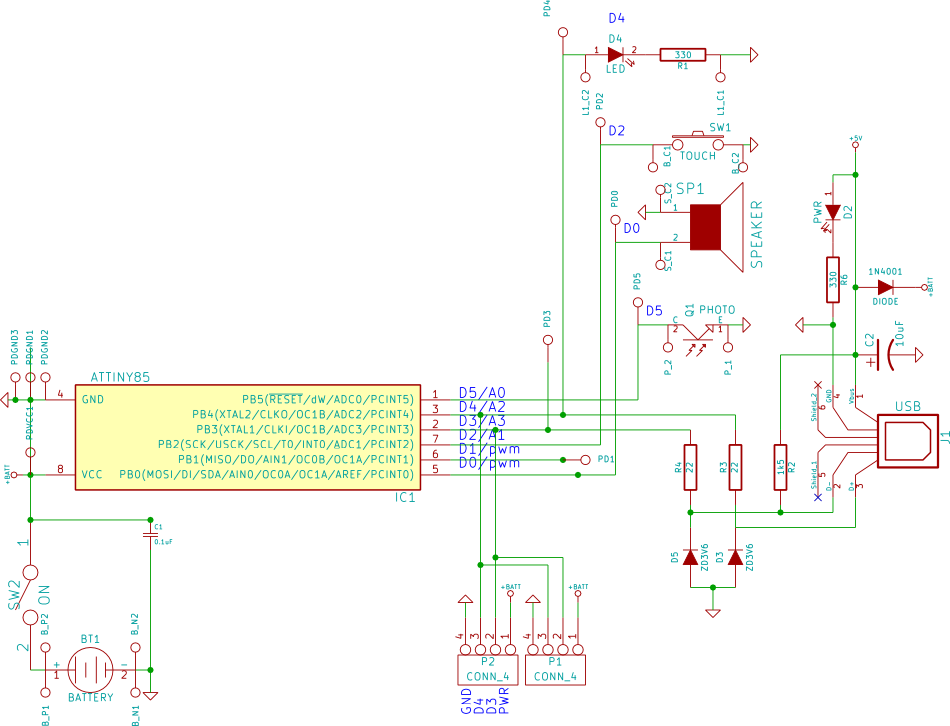
projects/tacuino R3/Docs/Tacuino_schematic.png
