aspro648/KiCad/projects/tacuino R3/Docs/Tacunio_R3_top.png

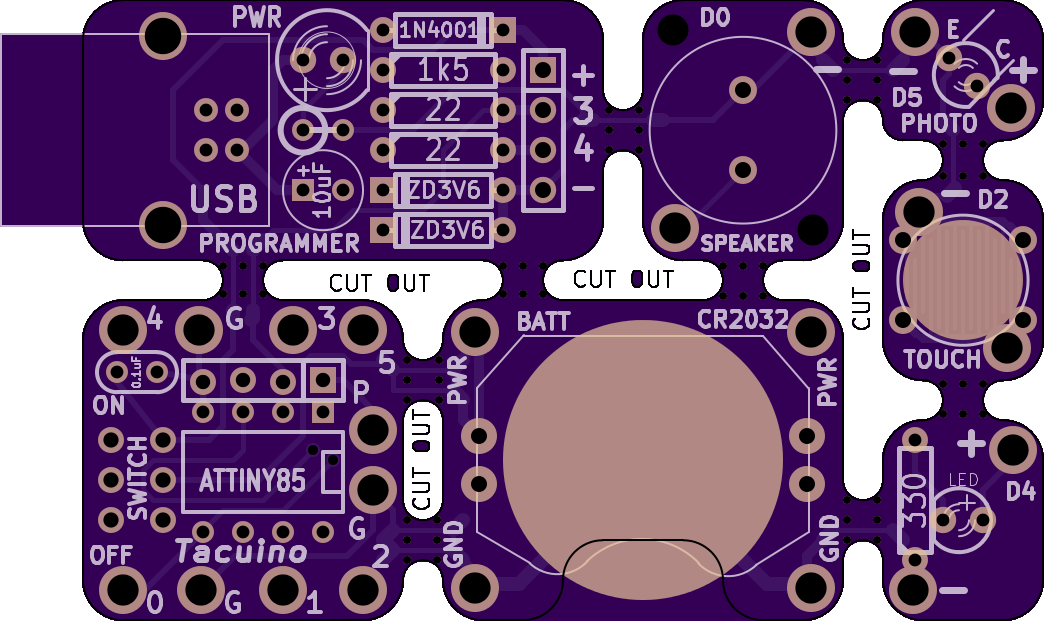
projects/tacuino R3/Docs/Tacunio_R3_top.png
