aspro648/KiCad/projects/tester/UCT3/design_files26/3D/aztec-snake.jpg

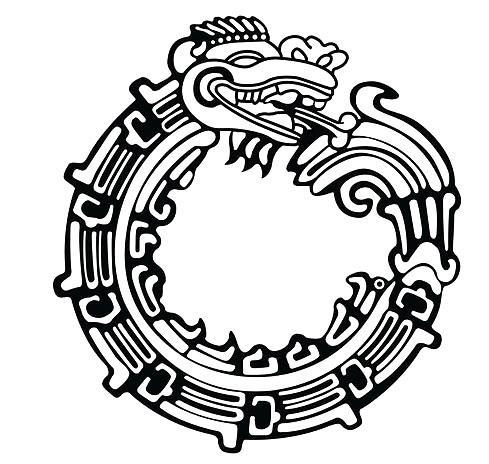
projects/tester/UCT3/design_files26/3D/aztec-snake.jpg
