aspro648/KiCad/projects/tester/UCT3/design_files26/3D/quetzalcoatl-mark-holsapple.jpg

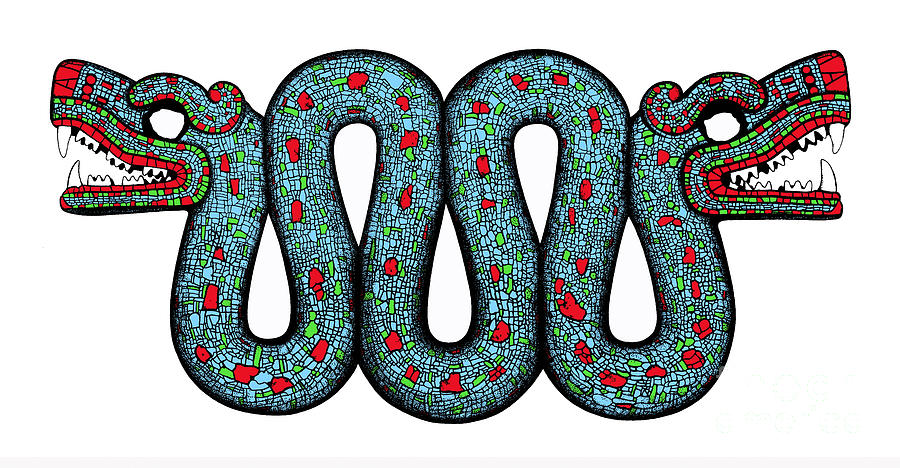
projects/tester/UCT3/design_files26/3D/quetzalcoatl-mark-holsapple.jpg
