aspro648/KiCad/projects/tester/UCT3/design_files26/3D/quetzalcotal.png

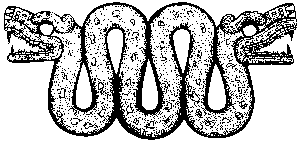
projects/tester/UCT3/design_files26/3D/quetzalcotal.png
