aspro648/KiCad/projects/Badge SAM/BOM.md

Badge V0 Bill of Materials 
===============================================

Electronics:

- 1 ea., Park Purfect Purple PCB, 
- 1 ea., ATMEGA328P-AU-ND 32TQFP, https://www.digikey.com/short/jbpvp7
- 1 ea., SWITCH TACTILE SPST, C&K PTS525SM15SMTR2 LFS, Digikey CKN9104CT-ND
- 1 ea., SWITCH SLIDE SPDT, C&K JS102011SAQN, http://www.digikey.com/short/3rbvmh
- 1 ea., SMD Battery holder, Linx BAT-HLD-001, Digikey BAT-HLD-001-ND
- 1 ea., CAP CER 0.1UF 50V X8R 0805, TDK C2012X8R1H104K125AA, https://www.digikey.com/short/j4vc1n
- 16 ea., TRANS NPN 40V 0.2A SOT23, MMBT3904-TP, https://www.digikey.com/short/jbpvh0
- 8 ea., 100 ohm 0805 resistors, RMCF0805JT100R, https://www.digikey.com/short/jbp100
- 64 ea., 0805 Blue SMD LED, 150080BS75000, https://www.digikey.com/short/jbp11p
- 1 ea., Tie tack (optional)

* Substitute at your own risk
