aspro648/KiCad/projects/clock2/Clock BOM.txt

Arduino Clock Bill Of Materials
=================
  
- 1 ea. Perfect Purple PCB from OSH Park
- 1 ea., Atmega328P-PU, https://www.digikey.com/product-detail/en/microchip-technology/ATMEGA328P-PU/ATMEGA328P-PU-ND/1914589
- 1 ea., MCP7940N RTC, https://www.digikey.com/product-detail/en/microchip-technology/MCP7940N-I-P/MCP7940N-I-P-ND/3872279
- 1 ea., 0.56in 4-Digit 7-Segment Display https://www.digikey.com/product-detail/en/adafruit-industries-llc/811/1528-1509-ND/5774235
- 1 ea., CRYSTAL 32.7680KHZ 12.5PF T/H, http://www.digikey.com/short/39p5fr
- 1 ea., RETAINER BATT CR1216/1225 PC PIN, http://www.digikey.com/short/39p52t
- 2 ea., 6mm Tactile button, https://www.digikey.com/product-detail/en/te-connectivity-alcoswitch-switches/1825910-6/450-1650-ND/1632536
- 2 ea., 0.1uF Cap, http://www.digikey.com/short/7j4hb0
- 1 ea., Photo transistor, www.digikey.com/product-detail/en/LTR-4206/160-1988-ND/214965

- 2 ea., RES 330 OHM 1/8W 5% CF AXIAL, 
- 4 ea., TRANS NPN 40V 1A TO92, https://www.digikey.com/product-detail/en/PN2222ATA/PN2222ATACT-ND/3042489
- 1 ea., TERMINAL BLOCK 3.5MM 2POS PCB, On Shore ED555/2DS, http://www.digikey.com/short/7zj1f4
- 1 ea., SWITCH SLIDE SPDT 200MA 30V, E-Switch EG128, https://www.digikey.com/product-detail/en/EG1218/EG1903-ND/101726

- 1 ea., AUDIO PIEZO TRANSDUCER 30V TH, TDK PS1240P02CT3, http://www.digikey.com/short/7hcrp1
- 2 ea., 3mm LEDS
- 4 ea., RES 100 OHM 1/8W 5% CF AXIAL, Stackpole CF18JT100R, https://www.digikey.com/product-detail/en/stackpole-electronics-inc/CF18JT100R/CF18JT100RCT-ND/2022718 
- 2 ea., RES 330 OHM 1/8W 5% CF AXIAL, Stackpole CF18JT330R, https://www.digikey.com/product-detail/en/stackpole-electronics-inc/CF18JT330R/CF18JT330RCT-ND/2022730
- 4 ea., RES 1K OHM 1/8W 5% CF AXIAL, Stackpole CF18JT1K00, https://www.digikey.com/product-detail/en/stackpole-electronics-inc/CF18JT1K00/CF18JT1K00CT-ND/2022742
- 2 ea., RES 4K7 OHM 1/8W 5% CF AXIAL, Stackpole CF18JT4K70, https://www.digikey.com/product-detail/en/stackpole-electronics-inc/CF18JT4K70/CF18JT4K70CT-ND/2022758
- 1 ea., 28-pin socket, https://www.digikey.com/product-detail/en/on-shore-technology-inc/ED281DT/ED3050-5-ND/4147600
- 1 ea., 8-pin socket, https://www.digikey.com/product-detail/en/assmann-wsw-components/A-08-LC-TR/AE9988-ND/821742
