aspro648/KiCad/projects/buzz/BIZZ_PCB_BOM.txt

QTY   Description   Link
2     10MM LED
1     Piezo   http://www.digikey.com/product-detail/en/0/445-2525-1-ND
