aspro648/KiCad/projects/HW/HW_Breakout/BOM.md

BOM Breakout

- 1 ea. PCB

- 2 ea., 6POS PicoBlade header, https://www.digikey.com/short/p4wz22
- 2 ea. CONN MOD JACK 4P4C R/A UNSHLD, https://www.digikey.com/short/4j55m43v
- 1 ea. CONN MOD JACK 8P8C R/A UNSHLD, https://www.digikey.com/short/q0tzftqt
- 1 ea. CONN HDR 4POS 0.1 GOLD PCB, https://www.digikey.com/short/vjtb59qp
- 1 ea. CABLE MOD 4P4C PLUG TO PLUG 7', https://www.digikey.com/short/pv3q20v2

Ethernet Cable: 
	https://www.amazon.com/Cables-Go-09600-Straight-Modular/dp/B0002J1QV6 or
	https://www.amazon.com/dp/B086JV1HTS

Note: Phone cable is normaly RJ14 (6P4C), and the handset RJ10 (4P4C).  They are different sizes!
