aspro648/KiCad/projects/HW/HW_IR Featherwing/BOM.md

BOM IR Gate Featherwing

- 1 ea. PCB
- 1 ea. ADAFRUIT FEATHER NRF52840 EXPRES, Adafruit 4062 https://www.digikey.com/short/nfj7dzdr
- 1 ea. FEATHER HEADER KIT FML, Adafruit 2886, https://www.digikey.com/short/fr42fq1v
- 5 ea. RES SMD 10K OHM 5% 1/8W 0805, https://www.digikey.com/short/r4qfbrrn
- 1 ea. Tactitle switch, [TE 1825910-6](https://www.digikey.com/short/q32j9w)
- 1 ea. pin male header, [Sullins PREC040SAAN-RC](https://www.digikey.com/short/jzr38f)
- 2 ea., 6POS PicoBlade header, https://www.digikey.com/short/p4wz22
- 2 ea., 5POS Picoblade header, https://www.digikey.com/short/p4wzdp
- 1 ea. 3mm LED (blue or green)
- 1 ea. Molex SL 171971-0003 vertical connector (optional, remote)

RJ-12 https://www.digikey.com/en/products/detail/stewart-connector/SS-90000-003/14548962
Cable: https://www.amazon.com/Cables-Go-09600-Straight-Modular/dp/B0002J1QV6
