aspro648/KiCad/projects/HW/HW_Light Tree 2/BOM.md

BOM Light Tree

1 ea. PCB

- 1 ea. MCP23018 24QFN, https://www.digikey.com/short/2zmq0qvm
- 4 ea. Blue 3mm LED
- 6 ea. Yellow 3mm LED
- 2 ea. Green 3mm LED
- 2 ea. Red 3mm LED

- 14 ea. RES SMD 330 OHM 5% 0.4W 0805, https://www.digikey.com/short/znfwv2tw
- 2 ea. RES SMD 4.7K OHM 5% 1/8W 0805, https://www.digikey.com/short/pmj5mfz8

- 1 ea. CONN HEADER R/A 4POS 2.54MM, https://www.digikey.com/short/7jp9z3q3
