aspro648/KiCad/projects/HW/HW_Shield/BOM.md

BOM HW Shield

- 1 ea. PCB
- 1 ea. Arduino Uno
- 2 ea. Tactitle switch, [TE 1825910-6](https://www.digikey.com/short/q32j9w)
- 1 ea. pin male header, [Sullins PREC040SAAN-RC](https://www.digikey.com/short/jzr38f)
- 2 ea. 6POS PicoBlade header, https://www.digikey.com/short/p4wz22
- 2 ea. RJ-45 8POS, https://www.digikey.com/short/q0tzftqt
- 1 ea. CONN HDR 4POS 0.1 GOLD PCB, https://www.digikey.com/short/vjtb59qp
- 2 ea. 3mm or 5mm LED
- 2 ea. CONN HEADER VERT 3POS 2.54MM, https://www.digikey.com/short/5hr08f4v
- 2 ea. CONN HSG 3POS .100 SINGLE VER C, https://www.digikey.com/short/0z0znjph
- 2 ea. CONN HOUSING 2POS .100 W/LATCH, https://www.digikey.com/short/5q3hrb93
- 2 ea. CONN HEADER VERT 2POS 2.54MM, 
- 2 ea. SL 2POS VERT
- 8 ea. 10K resistors
- 2 ea. 4K7 resistors
- 2 ea. 330 resistors

RJ-12 https://www.digikey.com/en/products/detail/stewart-connector/SS-90000-003/14548962
Cable: https://www.amazon.com/Cables-Go-09600-Straight-Modular/dp/B0002J1QV6
