aspro648/KiCad/projects/HW/HW_Light Tree/BOM.md

BOM Light Tree

1 ea. PCB

- 1 ea. MCP23017 SSOP-28, https://www.digikey.com/short/9crv9dzn 
- 8 ea. LED WHITE DIFFUSED 0402 SMD, https://www.digikey.com/short/9mf79r25
- 6 ea. LED YELLOW CLEAR 0805 SMD 79mcd 130deg https://www.digikey.com/short/q498phqj
- 2 ea. LED GREEN DIFFUSED 0805 SMD 50mcd 170deg, https://www.digikey.com/short/8jwdnhtd
- 2 ea. LED RED CLEAR 0805 SMD 69mcd 140deg, https://www.digikey.com/short/4m5474qw

- 8 ea. CRGCQ 0402 330R 5%, https://www.digikey.com/short/q74cfp3b
- 10 ea. RES SMD 330 OHM 5% 0.4W 0805, https://www.digikey.com/short/znfwv2tw
- 2 ea. RES SMD 4.7K OHM 5% 1/8W 0805, https://www.digikey.com/short/pmj5mfz8 (optional)

- 1 ea., 5POS Picoblade header, https://www.digikey.com/short/p4wzdp
- 2 ea., 5POS PicoBlade housing, https://www.digikey.com/short/p4wzdb
- 12" PRE-CRIMP 1853 BLACK, https://www.digikey.com/short/p4wz1p
