aspro648/KiCad/projects/BinDecHex/design_files/BOM V0.txt

BinDecHex Clock Bill Of Materials
=================
  
- 1 ea. Perfect Purple PCB from OSH Park
- 2 ea. 7-segment LED CC 0.56" green, https://www.digikey.com/product-detail/en/kingbright/SC56-21GWA/754-1704-5-ND/3084593 
- 3 ea., RES 100 OHM 1/8W 5% CF AXIAL, Stackpole CF18JT100R, https://www.digikey.com/product-detail/en/stackpole-electronics-inc/CF18JT100R/CF18JT100RCT-ND/2022718
- 8 ea., RES 470 OHM 1/8W 5% CF AXIAL, https://www.digikey.com/product-detail/en/stackpole-electronics-inc/CF18JT470R/CF18JT470RCT-ND/2022734
- 1 ea., RES 10K OHM 1/8W 5% CF AXIAL,  https://www.digikey.com/product-detail/en/stackpole-electronics-inc/CF18JT10K0/CF18JT10K0CT-ND/2022766
- 3 ea., TRANS NPN 40V 1A TO92, https://www.digikey.com/product-detail/en/PN2222ATA/PN2222ATACT-ND/3042489
- 3 ea., SWITCH SLIDE SPDT 200MA 30V, E-Switch EG128, https://www.digikey.com/product-detail/en/EG1218/EG1903-ND/101726
- 2 ea., SWITCH TACTILE SPST-NO 6mm black, https://www.digikey.com/short/q32j9w
- 1 ea., SWITCH TACTILE SPST-NO 6mm red https://www.digikey.com/product-detail/en/te-connectivity-alcoswitch-switches/1825910-7/450-1804-ND/1731414
- 1 ea., AUDIO PIEZO TRANSDUCER 30V TH, TDK PS1240P02CT3, http://www.digikey.com/short/7hcrp1
- 8 ea., 3mm LED green, http://www.digikey.com/short/3335hz
- 1 ea., IC 8-BIT SHIFT REGISTER 16-DIP 74HTC595, http://www.digikey.com/short/7htcpz
- 1 ea., CONN HEADER .100" SNGL STR 40POS, https://www.digikey.com/product-detail/en/PREC040SAAN-RC/S1012EC-40-ND/2774814
