aspro648/KiCad/projects/Altimeter/docs/Altimeter BOM.xlsx

Line | Parent Part Number | QTY | U/M | Description | Manufacture | Manufacture Part Number | Supplier | Supplier Part Number | CAT | SP | SING FAB | Unit Cost | Total Cost (USD) | Rev | PDF | Stock | Drawing File Name | Comments
 |  | 1 | EA | PCB | OSH Park | Altermeter V0 | OSH Park |  |  |  |  | 1.92 | $1.92 |  |  |  |  | https://oshpark.com/shared_projects/hurBuvG8
 |  | 1 | EA | I2C OLED Display Module 0.91 Inch | MakerFocus |  | Amazon |  |  |  |  | 5.50 | $5.50 |  |  |  |  | https://www.amazon.com/dp/B0761LV1SD/ref=cm_sw_r_cp_ep_dp_z.pwBb1FPK4CH
 |  | 1 | EA | SWITCH REED SPST-NO 500MA 140V | Coto | CT10-1530-G1 | Digikey | 306-1125-1-ND |  |  |  | 1.08 | $1.08 |  |  |  |  | https://www.digikey.com/short/j58cd0
 |  | 1 | EA | SWITCH SLIDE SPDT | C&K | JS102011SAQN | Digikey | 401-1999-1-ND |  |  |  | 0.59 | $0.59 |  |  |  |  | https://www.digikey.com/short/j58qp5
 |  | 1 | EA | IC MCU 8BIT 32KB FLASH 32TQFP | Microchip Technology | ATMEGA328P-AU | Digikey | ATMEGA328P-AU-ND |  |  |  | 2.07 | $2.07 |  |  |  |  | https://www.digikey.com/short/jbpvp7
 |  | 1 | EA | IC ALTIMETER I2C VERSION 8LGA | NXP USA Inc. | MPL3115A2R1 | Digikey | MPL3115A2R1CT-ND |  |  |  | 6.38 | $6.38 |  |  |  |  | https://www.digikey.com/short/j587bt
 |  | 3 | EA | CAP CER 0.1UF 50V X7R 0805 | Generic | Substituition OK | Digikey | 490-8049-1-ND |  |  |  | 0.37 | $1.11 |  |  |  |  | https://www.digikey.com/short/j58qjp
 |  | 1 | EA | CAP CER 10UF 10V X5R 1206 | Generic | Substituition OK | Digikey | 1276-1148-1-ND |  |  |  | 0.23 | $0.23 |  |  |  |  | https://www.digikey.com/short/j58q80
 |  | 1 | EA | LED ORANGE CLEAR 0805 SMD | Generic | Substituition OK | Digikey | 350-2040-1-ND |  |  |  | 0.44 | $0.44 |  |  |  |  | https://www.digikey.com/short/j58qzz
 |  | 3 | EA | RES 1K OHM 5% 1/8W 0805 | Generic | Substituition OK | Digikey | RMCF0805JT1K00CT-ND |  |  |  | 0.10 | $0.30 |  |  |  |  | https://www.digikey.com/short/j58q4m
 |  | 1 | EA | BATTERY RETAINER COIN 20MM SMD | Linx Technologies Inc. | BAT-HLD-001 | Digikey | BAT-HLD-001-ND |  |  |  | 0.29 | $0.29 |  |  |  |  | https://www.digikey.com/short/j58q42
 |  | 1 | EA | BATTERY LITHIUM 3V COIN 20MM | Generic | Substituition OK | Digikey | P189-ND |  |  |  | 0.35 | $0.35 |  |  |  |  | https://www.digikey.com/short/ppz8cd
 |  |  |  |  |  |  |  |  |  |  |  | Total | $20.25
