aspro648/KiCad/projects/ICanSolder/docs/I Can Solder kitting.ods

I Can Solder Kitting
 | 7 | Kit Part Count
 | 20 | Kits to Assemble
Kitting Quantity | BOM Quantity | Description | Manufacturer | Digi-Key Part Number | Unit Price | Extended Price
20 | 1 | I Can Solder PCB | OSH Park | 1.4 in2 | $1.41 | $1.41
20 | 1 | SWITCH SLIDE SPDT 200MA 30V | E-Switch | EG1903-ND | $0.61 | $0.61
20 | 1 | BATTERY RETAINER COIN PC PIN | Linx Technologies Inc. | BAT-HLD-001-THM-ND | $0.29 | $0.29
20 | 1 | RES 100 OHM 1/4W 5% AXIAL | Yageo | 100QBK-ND | $0.10 | $0.10
20 | 1 | BAG 3X3" ZIP STATIC SHIELD 1=1EA | SCS | SCP404-ND | $0.11 | $0.11
20 | 1 | 5mm RGB Multicolor Slow Flashing | Chanzon | http://a.co/d/8MpfUT4 | $0.08 | $0.08
20 | 1 | Tie-tack clutch pin & clasp | DHGate (https://www.dhgate.com/product/10mm-post-nails-post-gold-silver-brass-tie/391539398.html) |  | $0.10 | $0.10
 |  |  |  | TOTAL |  | $2.70
Prep:
 | PCBs Ordered, received: ___________________
 | Parts Ordered, received: ____________________
 | Separate PCBs, remove mouse-bites, file edges
 | Print labels | https://github.com/aspro648/KiCad/blob/master/projects/ICanSolder/docs/I Can Solder labels.odt
 | Labels on bags
 | Assemble clutch pin & clasp
Notes:
