aspro648/KiCad/projects/Attiny/Attiny85Challenge2/images/parts.JPG

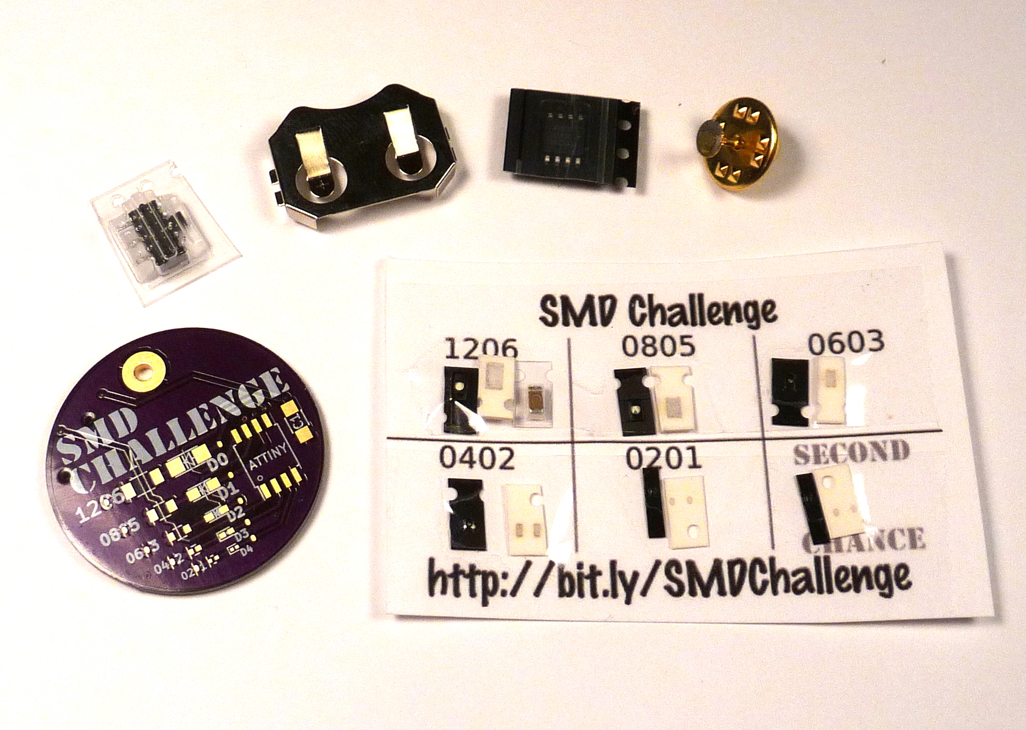
projects/Attiny/Attiny85Challenge2/images/parts.JPG
