aspro648/KiCad/projects/Attiny/Attiny85ChallengeBodge/images/Bodge Parts.JPG

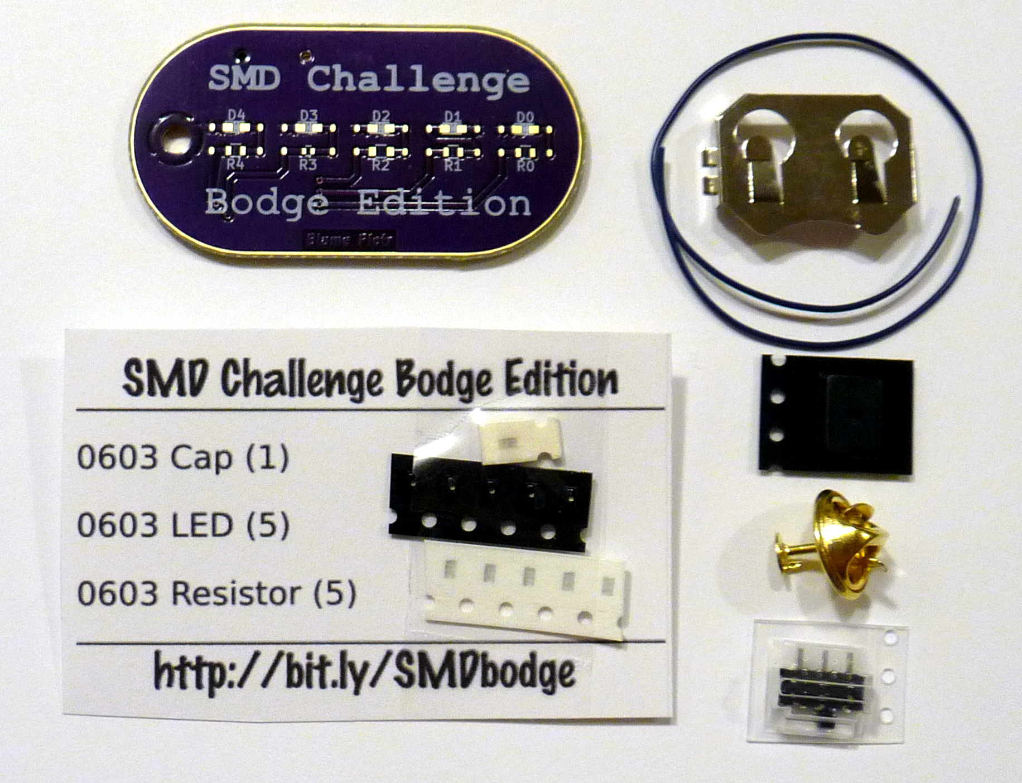
projects/Attiny/Attiny85ChallengeBodge/images/Bodge Parts.JPG
