aspro648/KiCad/projects/Attiny/Attiny85ChallengeHackaday2020/images/2018-11-22T19 25 25.932Z-parts.JPG

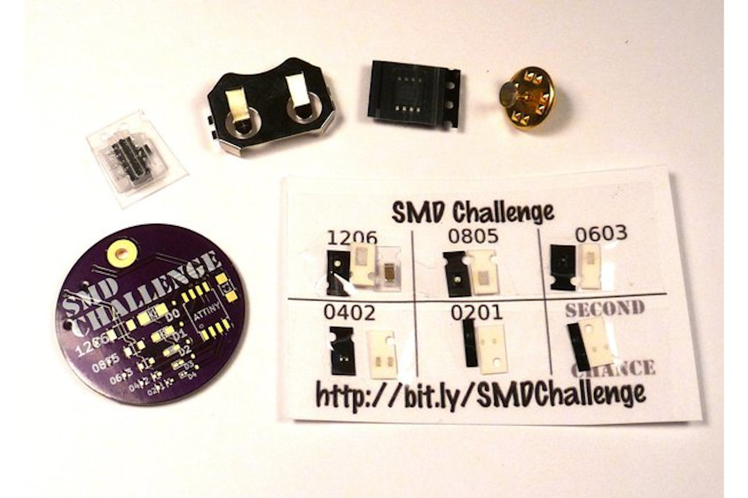
projects/Attiny/Attiny85ChallengeHackaday2020/images/2018-11-22T19 25 25.932Z-parts.JPG
