aspro648/KiCad/projects/Attiny/Attiny85ChallengeHackaday2020/images/parts.jpg

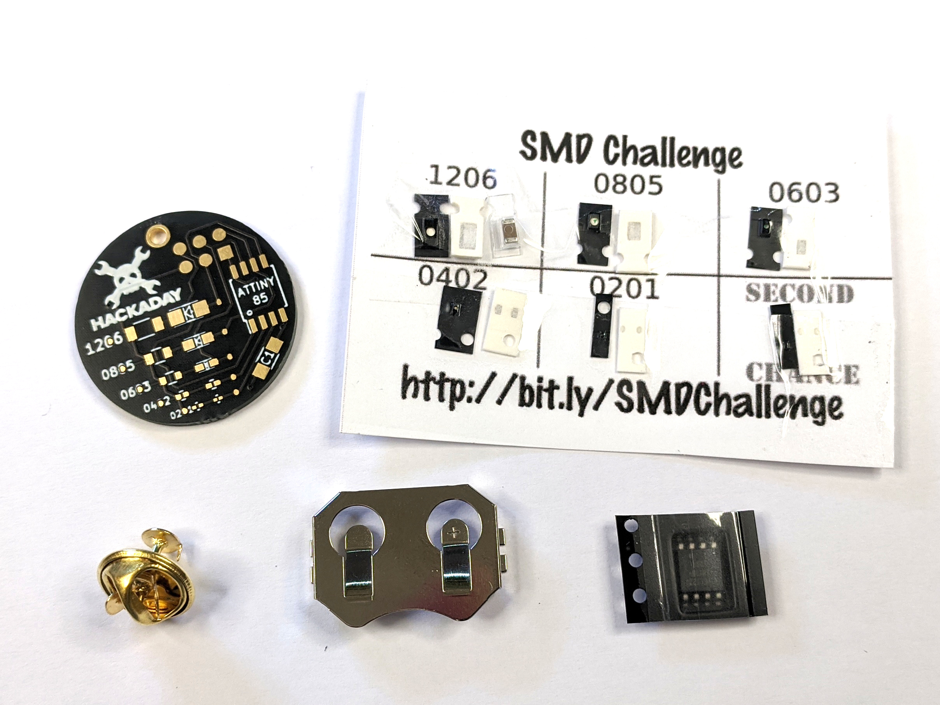
projects/Attiny/Attiny85ChallengeHackaday2020/images/parts.jpg
