aspro648/KiCad/projects/Attiny/Attiny85HeartSMD1/docs/Attiny85 Heart SMD Parts Card.png

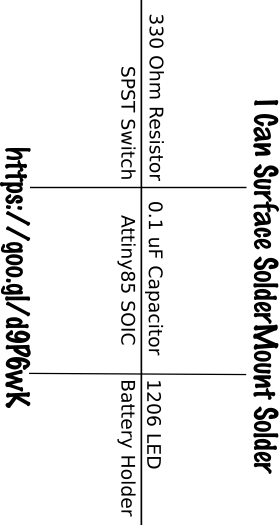
projects/Attiny/Attiny85HeartSMD1/docs/Attiny85 Heart SMD Parts Card.png
