aspro648/KiCad/projects/Attiny/Attiny85HeartSMD/docs/Attiny85 Heart SMD Parts Card 2.png

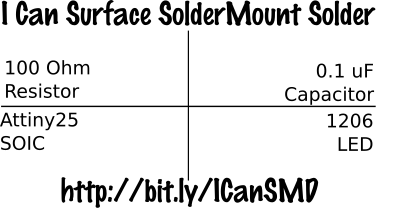
projects/Attiny/Attiny85HeartSMD/docs/Attiny85 Heart SMD Parts Card 2.png
