aspro648/KiCad/projects/JouleThief/Images/00_parts.png

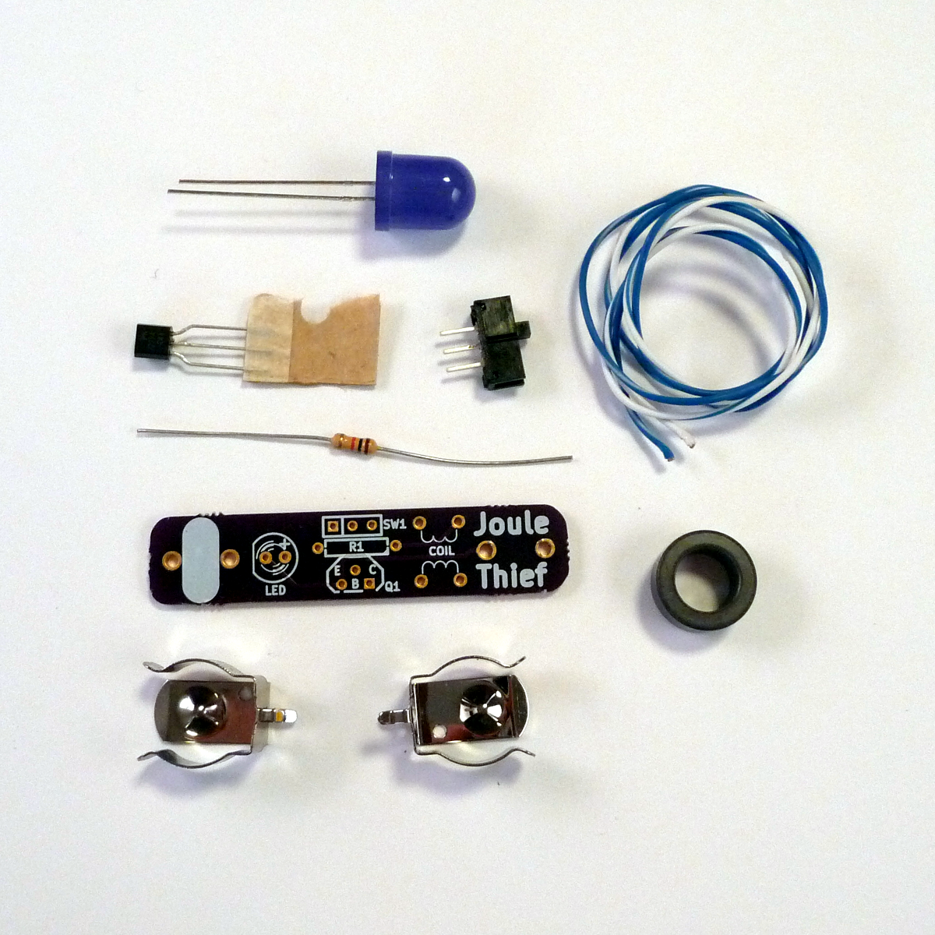
projects/JouleThief/Images/00_parts.png
