aspro648/KiCad/projects/Nerf/ArduStryfe_MOSFET/design_files Stryfe MOSFET V01/main_brd.stl

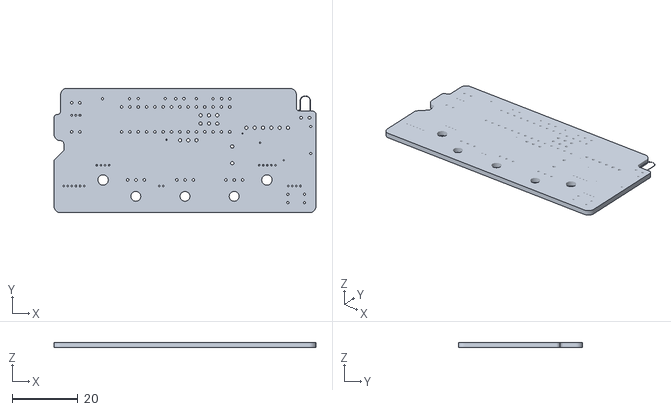
[picture p217: CAD file, 2019-06-26]
projects/Nerf/ArduStryfe_MOSFET/design_files Stryfe MOSFET V01/main_brd.stl
80.0 x 38.0 x 1.70
