aspro648/KiCad/FreeCad/pipes.FCStd

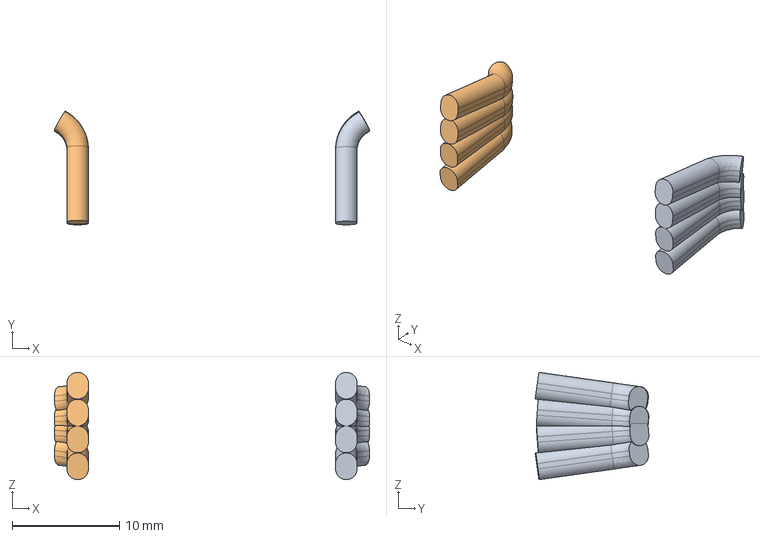
[picture p218: CAD file, 2021-11-24]
FreeCad/pipes.FCStd
29.3 x 10.6 x 9.98 mm
