aspro648/KiCad/FreeCad/stls/speeder.stl

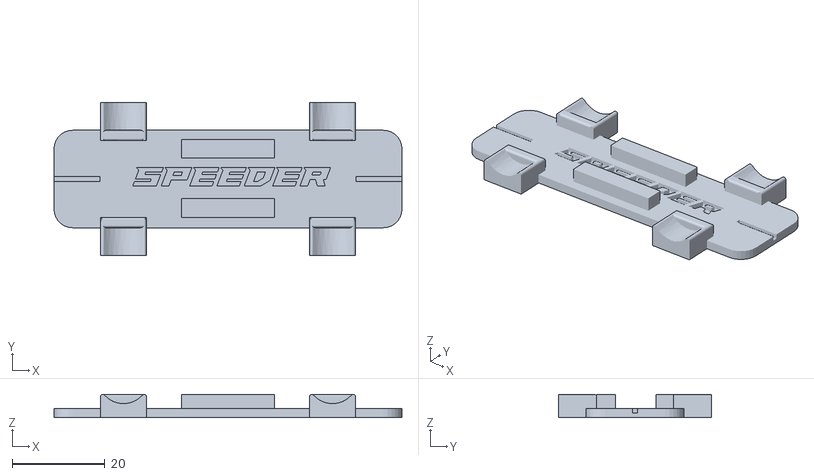
[picture p219: CAD file, 2021-09-26]
FreeCad/stls/speeder.stl
74.9 x 33.0 x 5.00
