aspro648/KiCad/projects/Attiny/SnapNSewSMD/design_files/gerbers/project-brd_R14.dxf

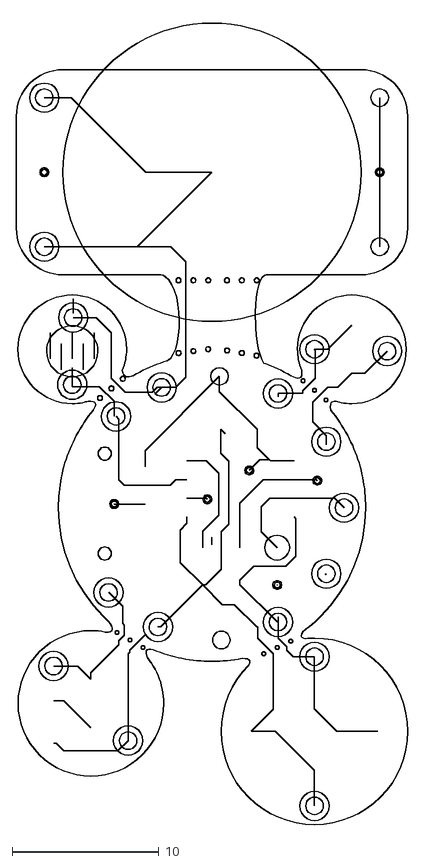
[picture p220: CAD file, 2019-04-09]
projects/Attiny/SnapNSewSMD/design_files/gerbers/project-brd_R14.dxf
26.7 x 55.1
