aspro648/KiCad/projects/HW/mechanical/Display/DisplayBase.FCStd

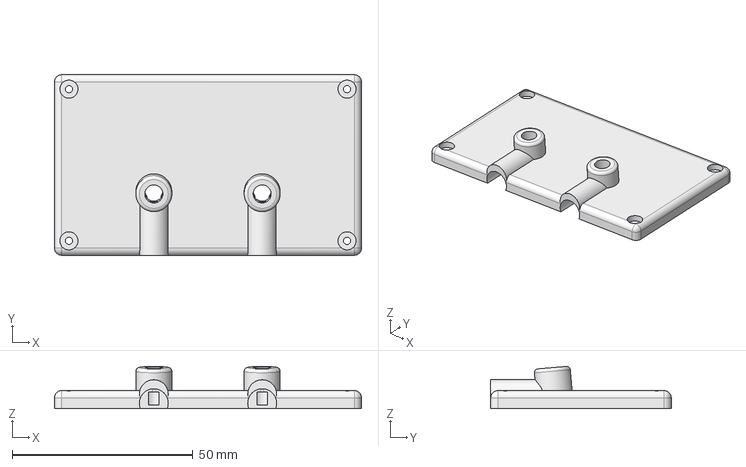
[picture p221: CAD file, 2021-12-08]
projects/HW/mechanical/Display/DisplayBase.FCStd
85.0 x 50.0 x 11.7 mm
