aspro648/KiCad/projects/HW/mechanical/ServoBase-Top.stl

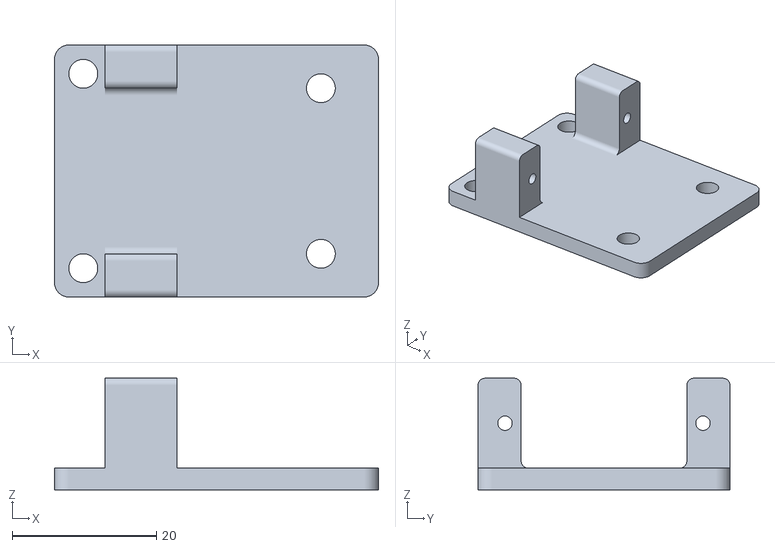
[picture p222: CAD file, 2021-11-24]
projects/HW/mechanical/ServoBase-Top.stl
45.0 x 35.0 x 15.5
