aspro648/KiCad/projects/ICanSolder/design_files SaintCon 2019/sc-logo-2019.dxf

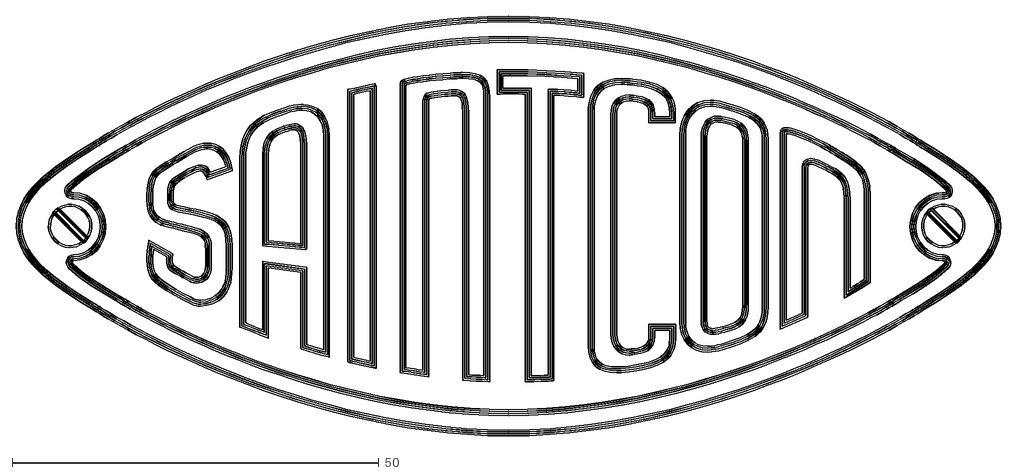
[picture p223: CAD file, 2019-10-06]
projects/ICanSolder/design_files SaintCon 2019/sc-logo-2019.dxf
134.3 x 57.2
