aspro648/KiCad/projects/MOSFET_jr/design_files/MOSFET_jr.stl

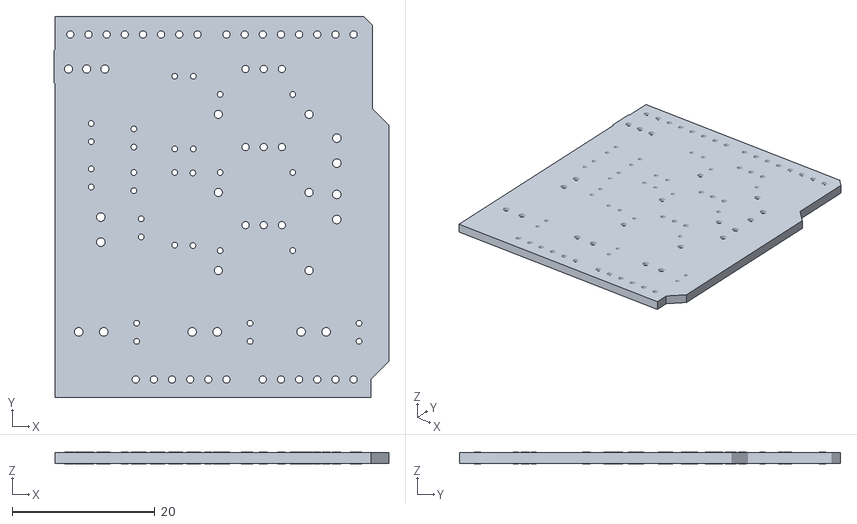
[picture p224: CAD file, 2019-05-10]
projects/MOSFET_jr/design_files/MOSFET_jr.stl
46.9 x 53.3 x 1.70
