aspro648/KiCad/projects/Nerf/ArduStryfe_MOSFET/design_files Stryfe MOSFET V01/3D/OLED_frame_face.stl

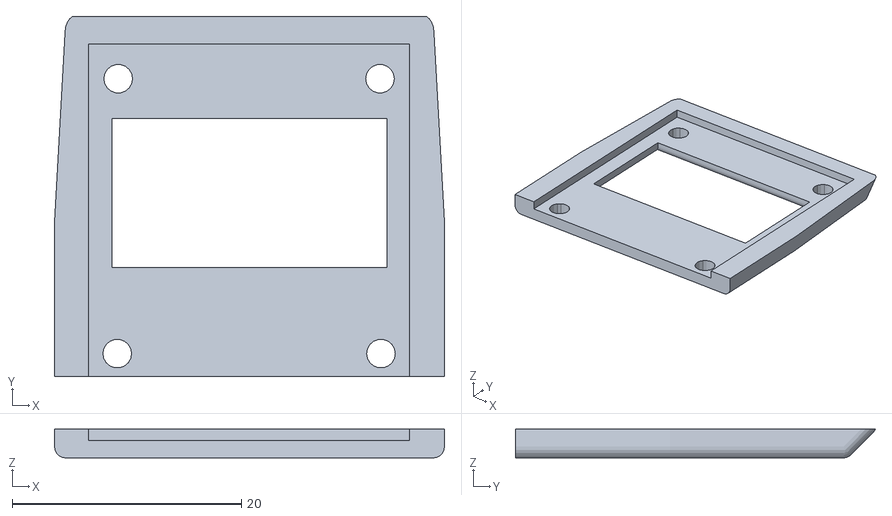
[picture p225: CAD file, 2019-08-01]
projects/Nerf/ArduStryfe_MOSFET/design_files Stryfe MOSFET V01/3D/OLED_frame_face.stl
34.0 x 31.4 x 2.52
