aspro648/KiCad/projects/Nerf/ArduStryfe_MOSFET/design_files Stryfe MOSFET V01/project.sch.dxf

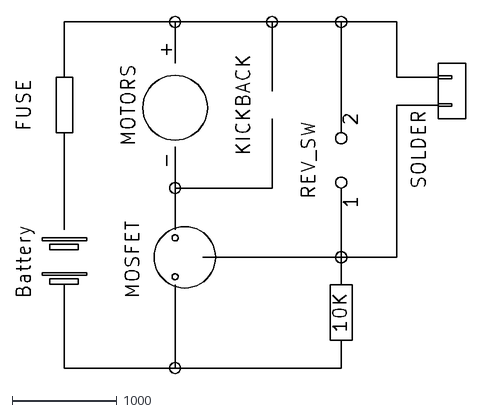
[picture p226: CAD file, 2019-08-24]
projects/Nerf/ArduStryfe_MOSFET/design_files Stryfe MOSFET V01/project.sch.dxf
4296.8 x 3417.9
