aspro648/KiCad/projects/Nerf/NerfMuzzleFlash 2/3D_files/Nerf Chrono Cap.stl

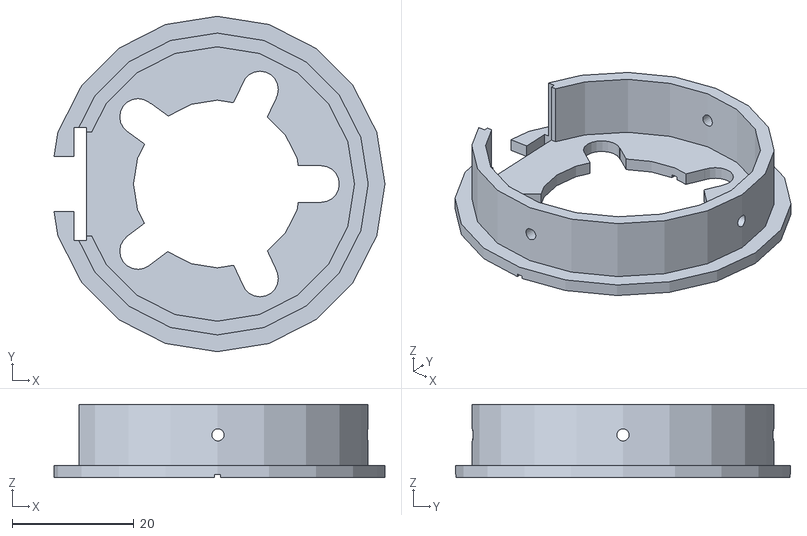
[picture p227: CAD file, 2019-05-31]
projects/Nerf/NerfMuzzleFlash 2/3D_files/Nerf Chrono Cap.stl
54.3 x 55.0 x 12.0
