aspro648/KiCad/projects/Nerf/NerfMuzzleFlash 2/design_files/board.stl

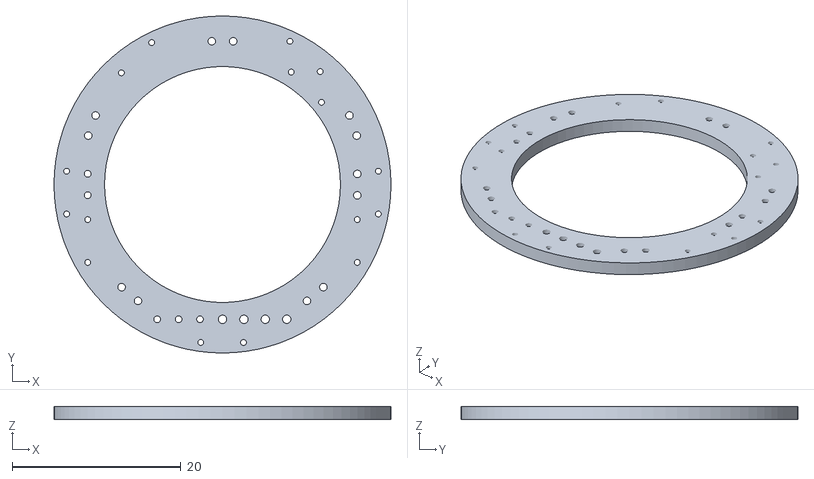
[picture p228: CAD file, 2019-05-10]
projects/Nerf/NerfMuzzleFlash 2/design_files/board.stl
40.0 x 40.0 x 1.60
