aspro648/KiCad/projects/OSTR/3D/Wheel.stl

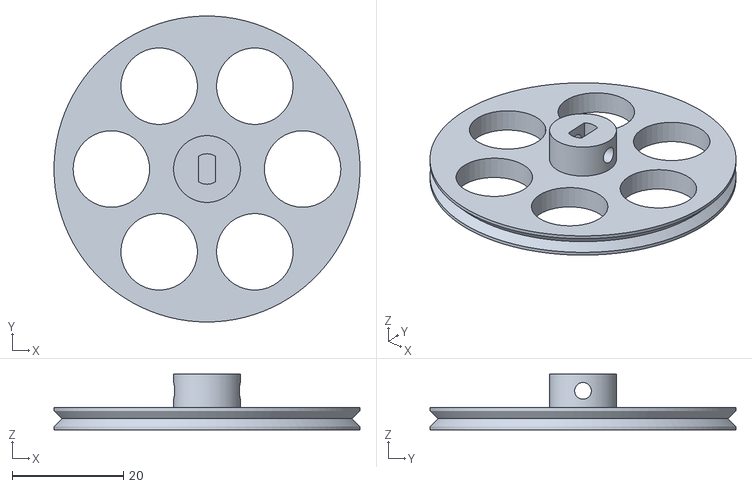
[picture p229: CAD file, 2018-04-21]
projects/OSTR/3D/Wheel.stl
55.0 x 55.0 x 10.0
