aspro648/KiCad/projects/tester/JST_XSRS/JST_XSRS breakout.step

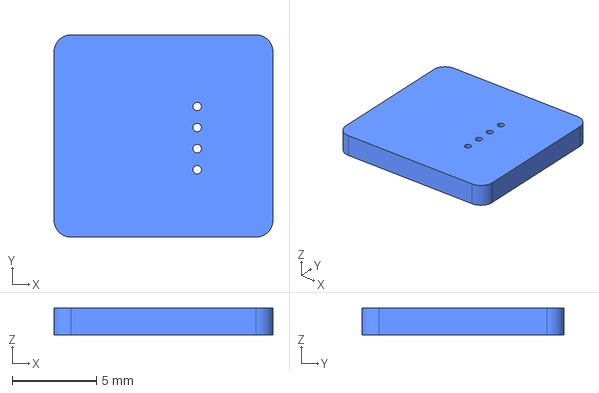
[picture p230: CAD file, 2021-02-09]
projects/tester/JST_XSRS/JST_XSRS breakout.step
13.0 x 12.0 x 1.60 mm
