aspro648/KiCad/projects/tester/UCT3/design_files/3D/mec8-113-02-l-d-ra1.stp

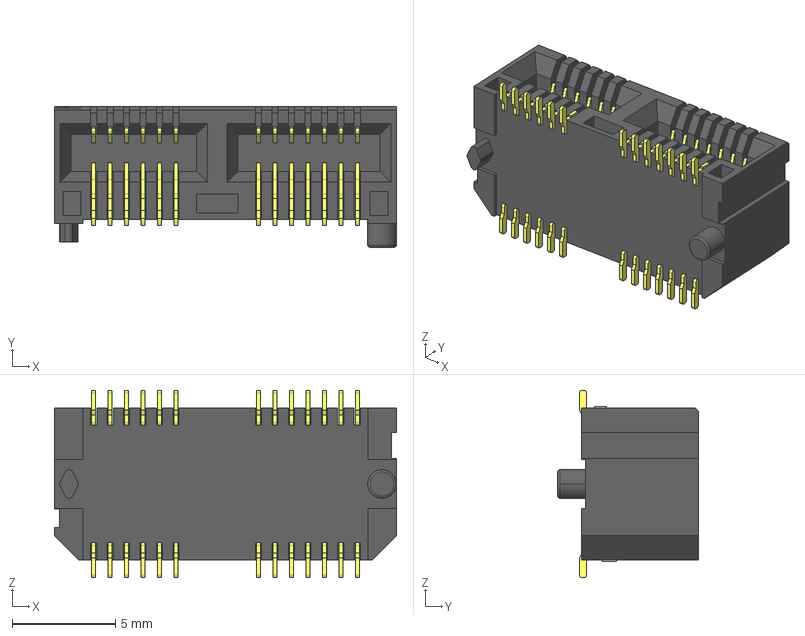
[picture p231: CAD file, 2022-12-13]
projects/tester/UCT3/design_files/3D/mec8-113-02-l-d-ra1.stp
16.6 x 6.83 x 9.10 mm
