aspro648/KiCad/projects/tester/UCT3/design_files_card Gecko/3D/G125-MV11005L0P.stp

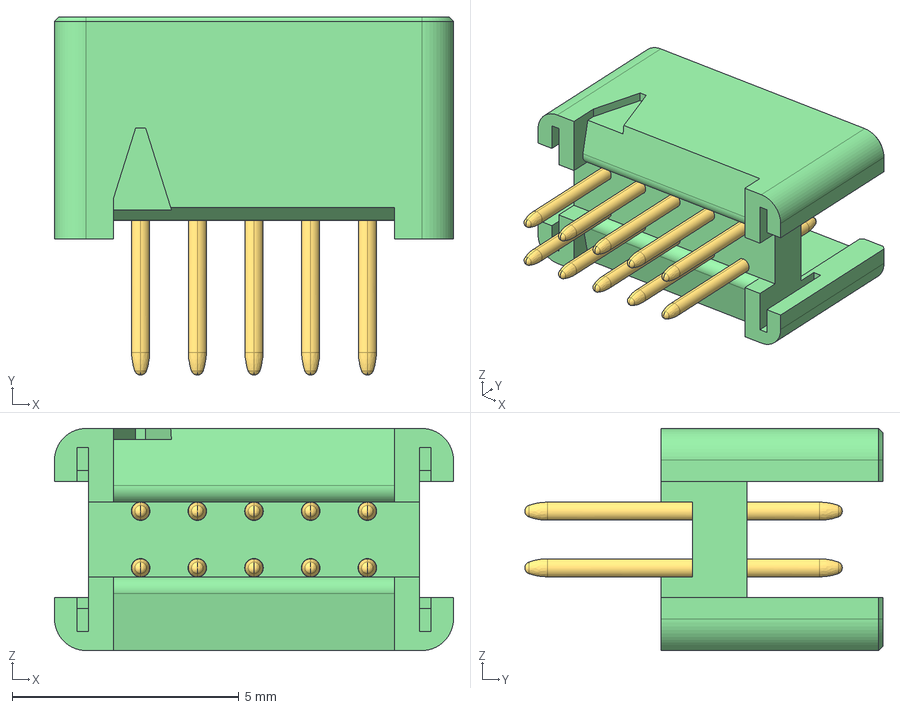
[picture p232: CAD file, 2022-12-13]
projects/tester/UCT3/design_files_card Gecko/3D/G125-MV11005L0P.stp
8.80 x 7.90 x 4.90 mm
G125-3011096
G125-1030005 x 10
