aspro648/KiCad/projects/tester/UCT3/design_files_card template/3D/G125-MV10605L0P.stp

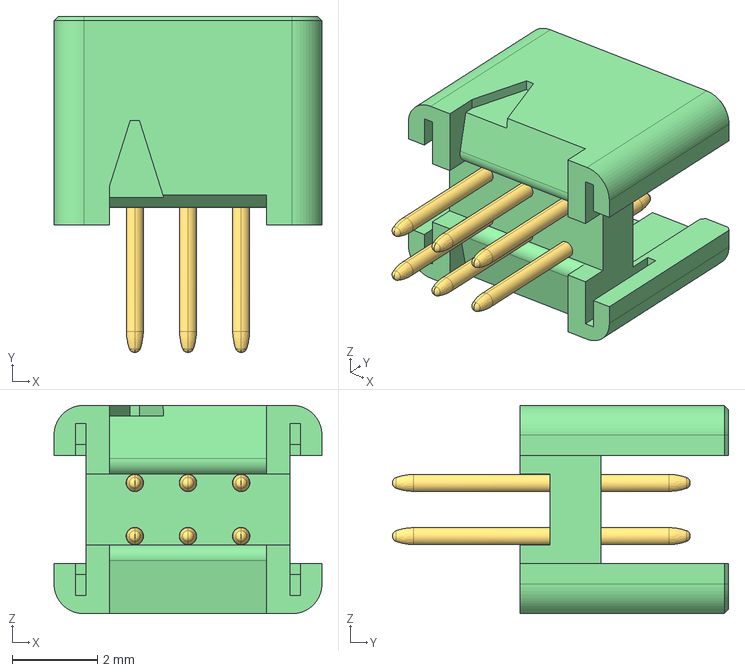
[picture p233: CAD file, 2022-11-14]
projects/tester/UCT3/design_files_card template/3D/G125-MV10605L0P.stp
6.30 x 7.90 x 4.90 mm
G125-3010696
G125-1030005 x 6
