aspro648/KiCad/FreeCad/axleJig6.FCStd

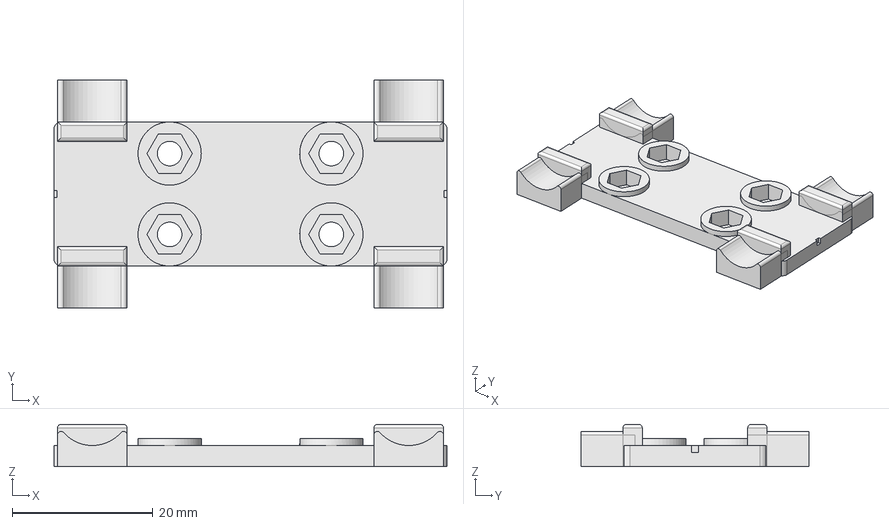
[picture p234: CAD file, 2021-11-24]
FreeCad/axleJig6.FCStd
55.9 x 32.5 x 6.00 mm
