aspro648/KiCad/FreeCad/stls/axleJig3c.stl

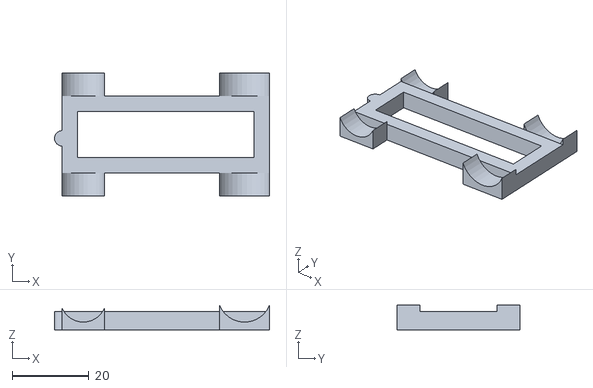
[picture p235: CAD file, 2021-09-07]
FreeCad/stls/axleJig3c.stl
56.0 x 32.0 x 6.40
