aspro648/KiCad/projects/Attiny/SnapNSewSMD/design_files/gerbers/project-brd_R12.dxf

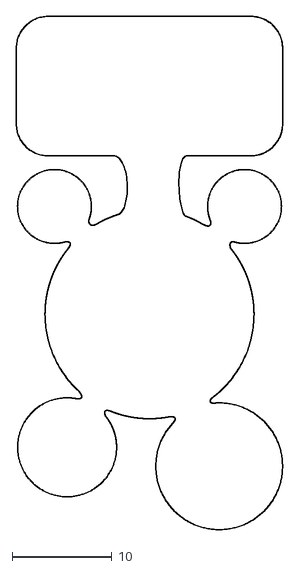
[picture p236: CAD file, 2019-04-09]
projects/Attiny/SnapNSewSMD/design_files/gerbers/project-brd_R12.dxf
26.7 x 51.4
