aspro648/KiCad/projects/HW/mechanical/Display/DisplayBack.FCStd

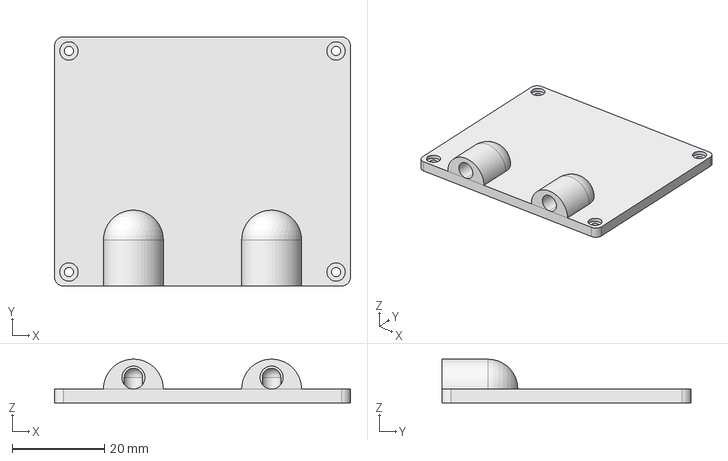
[picture p237: CAD file, 2021-12-08]
projects/HW/mechanical/Display/DisplayBack.FCStd
64.3 x 54.1 x 9.50 mm
