aspro648/KiCad/projects/HW/mechanical/ServoArm.FCStd

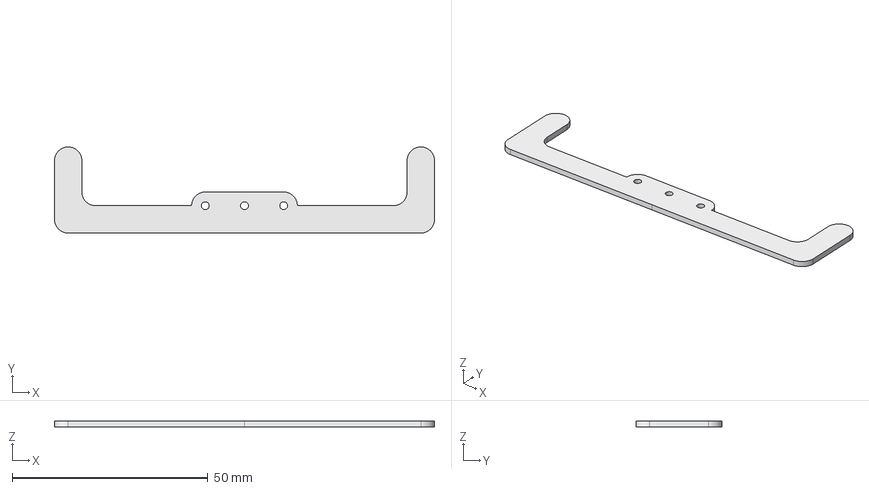
[picture p238: CAD file, 2021-11-24]
projects/HW/mechanical/ServoArm.FCStd
97.0 x 22.0 x 1.50 mm
