aspro648/KiCad/projects/Nerf/ArduStryfe_MOSFET/design_files Stryfe MOSFET V01/3D/OLED_frame_back.stl

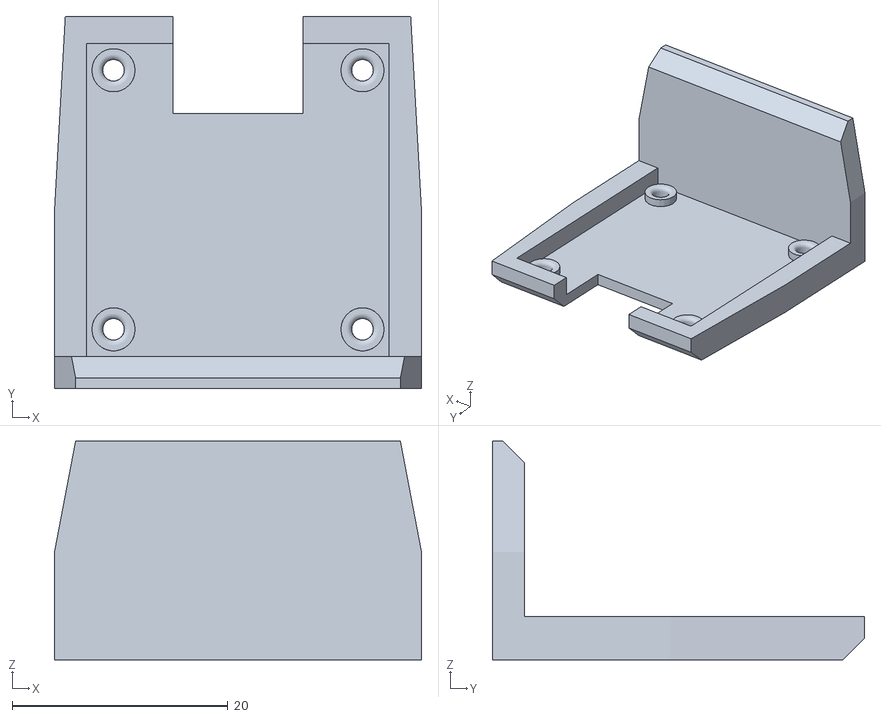
[picture p239: CAD file, 2019-08-01]
projects/Nerf/ArduStryfe_MOSFET/design_files Stryfe MOSFET V01/3D/OLED_frame_back.stl
34.0 x 34.5 x 20.2
