aspro648/KiCad/projects/Nerf/NerfMuzzleFlash 2/3D_files/Nerf Chrono Body.stl

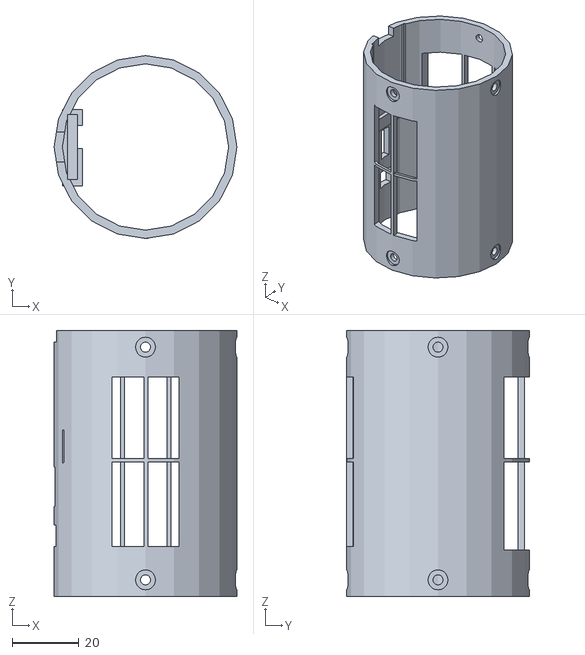
[picture p240: CAD file, 2019-05-31]
projects/Nerf/NerfMuzzleFlash 2/3D_files/Nerf Chrono Body.stl
55.0 x 55.0 x 80.0
