aspro648/KiCad/projects/OSTR/3D/Caster.stl

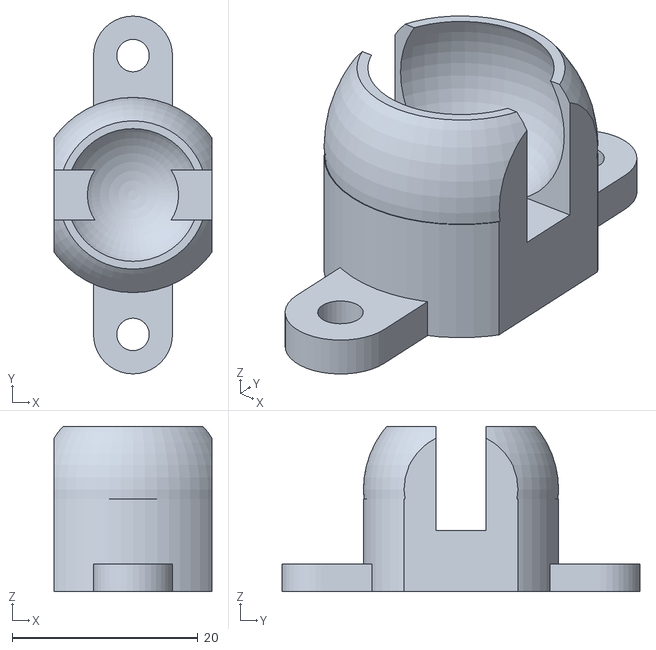
[picture p241: CAD file, 2018-04-21]
projects/OSTR/3D/Caster.stl
17.0 x 38.5 x 17.8
