aspro648/KiCad/projects/tester/RPB/Board/3D/1655.step

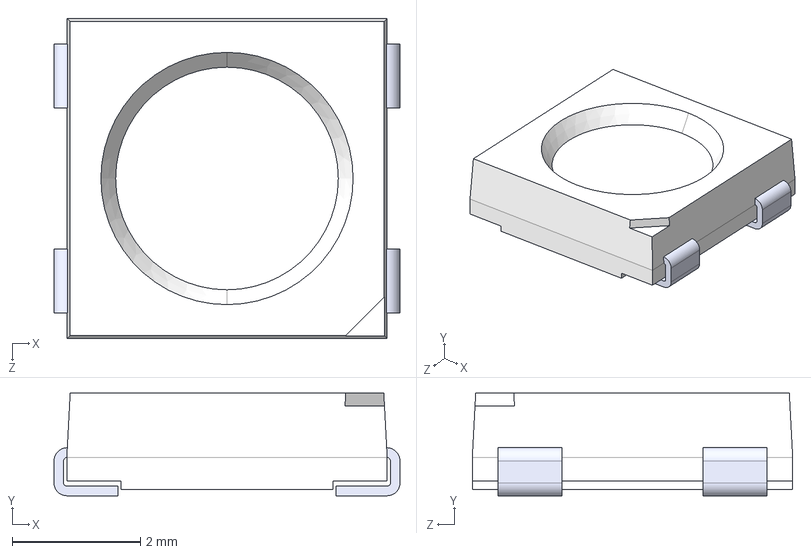
[picture p242: CAD file, 2022-12-13]
projects/tester/RPB/Board/3D/1655.step
5.40 x 1.60 x 5.00 mm
