aspro648/KiCad/projects/tester/UCT3/design_files_card 254 pitch/3D/G125-MS12005L0P.stp

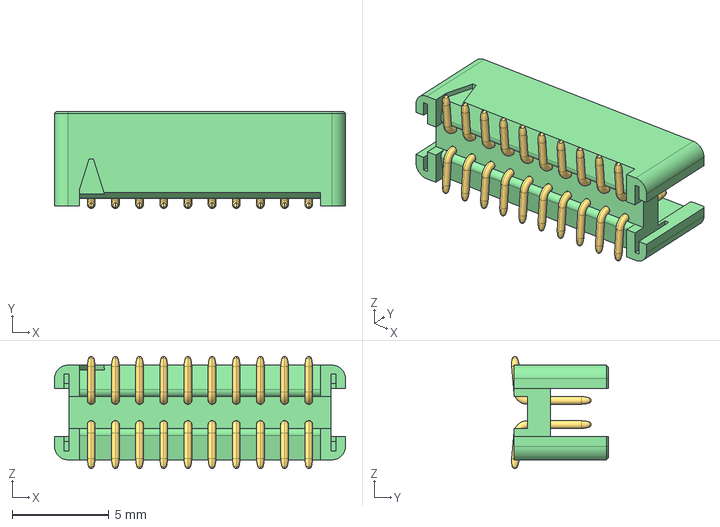
[picture p243: CAD file, 2022-11-14]
projects/tester/UCT3/design_files_card 254 pitch/3D/G125-MS12005L0P.stp
15.1 x 5.02 x 5.80 mm
G125-3012096
G125-1050005_BENT x 20
