aspro648/KiCad/projects/tester/UCT3/design_files_card Gecko/3D/G125-FV10605L0P.stp

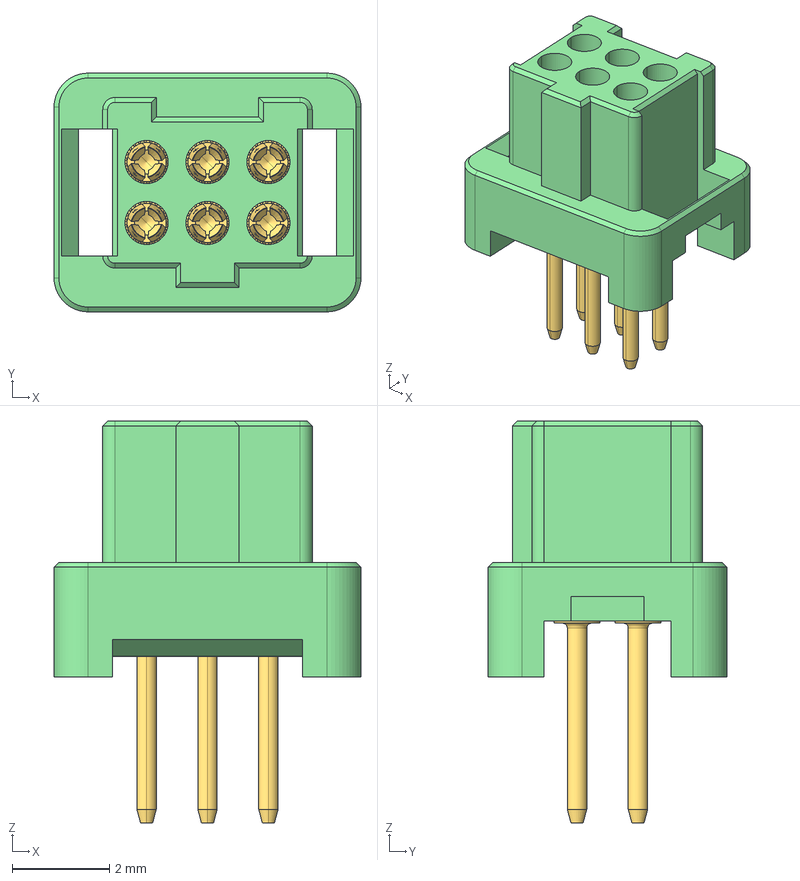
[picture p244: CAD file, 2022-12-13]
projects/tester/UCT3/design_files_card Gecko/3D/G125-FV10605L0P.stp
6.30 x 4.90 x 8.25 mm
G125-2010696
G125-0030005 x 6
