aspro648/KiCad/projects/tester/UCT3/design_files_card template/3D/G125-MV11205L0P.stp

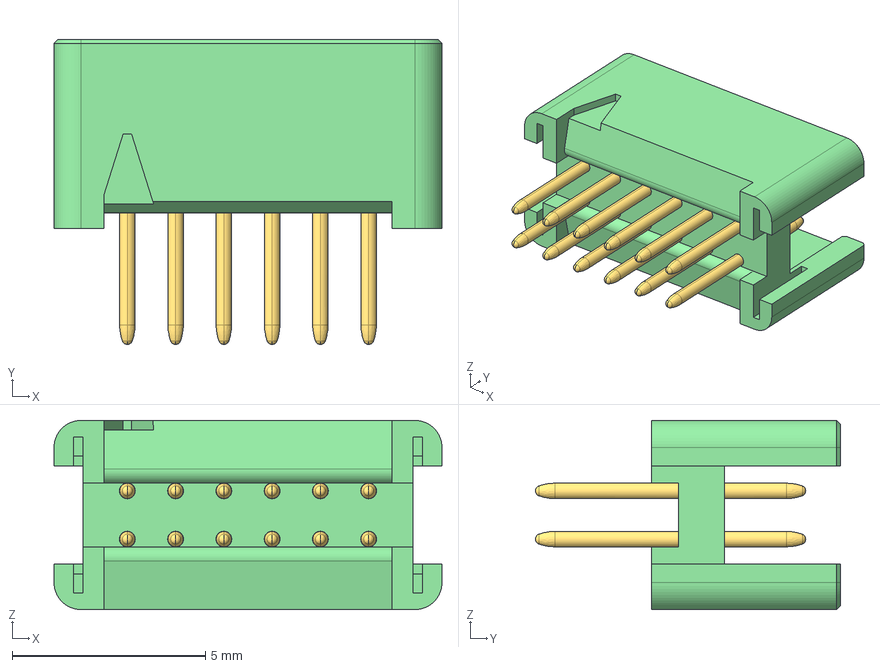
[picture p245: CAD file, 2022-11-14]
projects/tester/UCT3/design_files_card template/3D/G125-MV11205L0P.stp
10.1 x 7.90 x 4.90 mm
G125-3011296
G125-1030005 x 12
