aspro648/KiCad/FreeCad/SpeedDriverClip3.FCStd

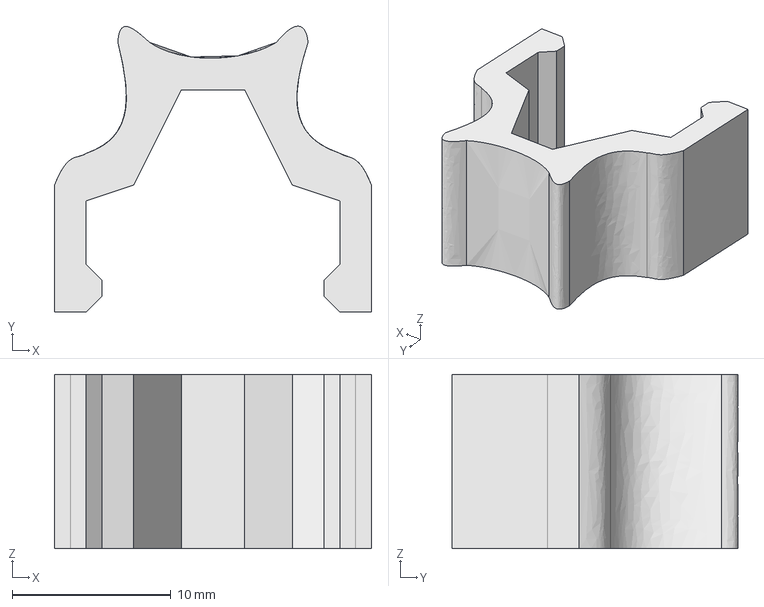
[picture p246: CAD file, 2021-11-01]
FreeCad/SpeedDriverClip3.FCStd
20.0 x 18.0 x 11.0 mm
