aspro648/KiCad/FreeCad/stls/axleJig-CivicSi.stl

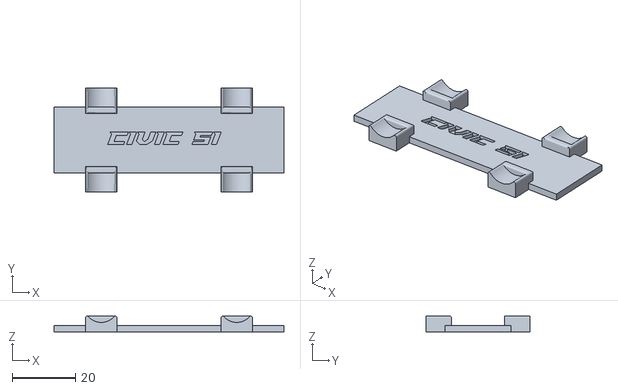
[picture p247: CAD file, 2021-09-07]
FreeCad/stls/axleJig-CivicSi.stl
72.8 x 33.0 x 5.00
