aspro648/KiCad/projects/HW/mechanical/Display/DisplayEnclosure.FCStd

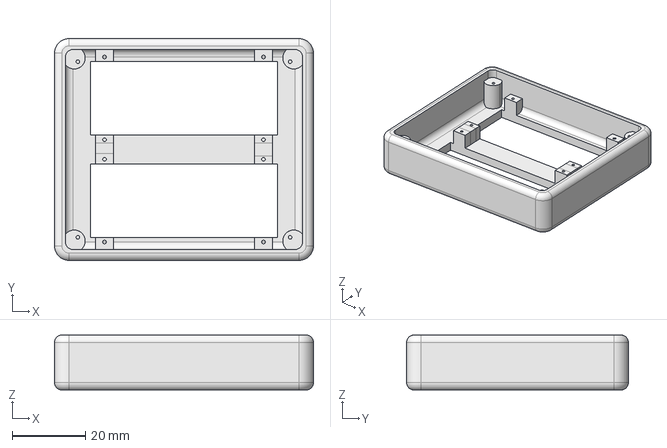
[picture p248: CAD file, 2021-12-08]
projects/HW/mechanical/Display/DisplayEnclosure.FCStd
70.8 x 60.6 x 15.0 mm
