aspro648/KiCad/projects/HW/mechanical/ServoBase-Bottom.stl

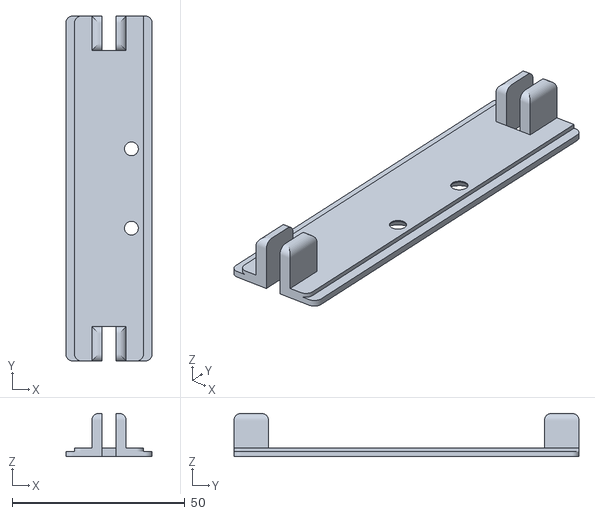
[picture p249: CAD file, 2021-11-24]
projects/HW/mechanical/ServoBase-Bottom.stl
25.0 x 100.0 x 12.5
