aspro648/KiCad/projects/Nerf/ArduStryfe_MOSFET/design_files Stryfe MOSFET V01/project.stl

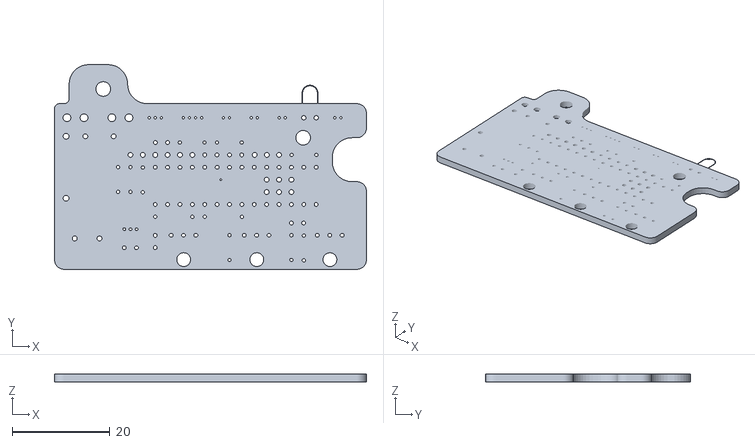
[picture p250: CAD file, 2019-06-26]
projects/Nerf/ArduStryfe_MOSFET/design_files Stryfe MOSFET V01/project.stl
64.0 x 42.0 x 1.70
