aspro648/KiCad/projects/Nerf/NerfMuzzleFlash 2/3D_files/Nerf Barrel Adapter.stl

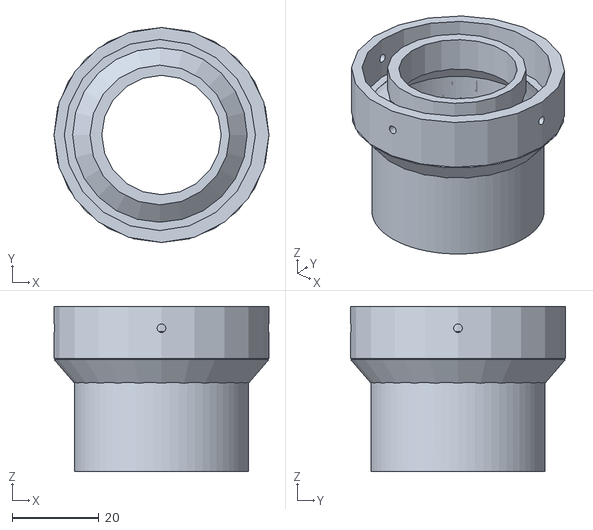
[picture p251: CAD file, 2019-05-31]
projects/Nerf/NerfMuzzleFlash 2/3D_files/Nerf Barrel Adapter.stl
49.5 x 49.5 x 38.0
