aspro648/KiCad/projects/OSTR/3D/Pen_Collar.stl

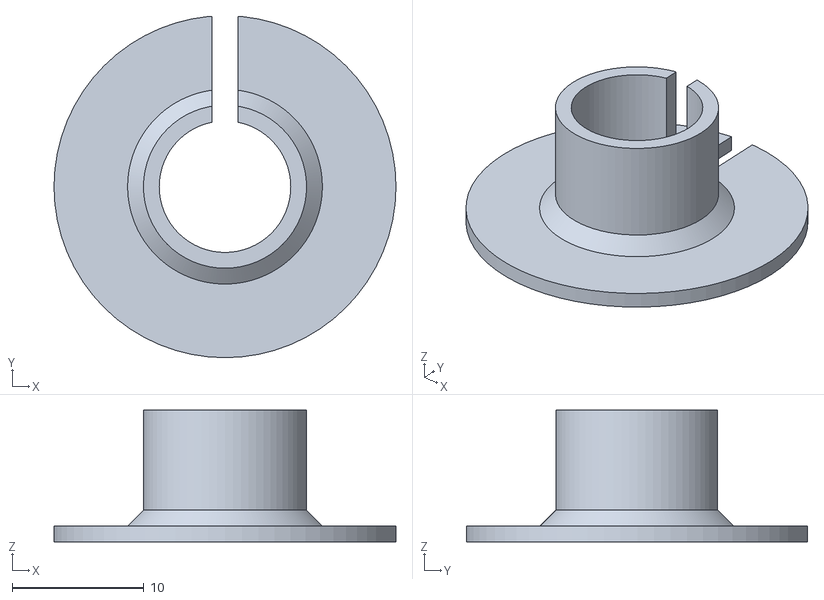
[picture p252: CAD file, 2018-04-21]
projects/OSTR/3D/Pen_Collar.stl
26.0 x 26.0 x 10.0
