aspro648/KiCad/projects/tester/UCT3/design_files_card Vectornav/3D/G125-MV11605L0P.stp

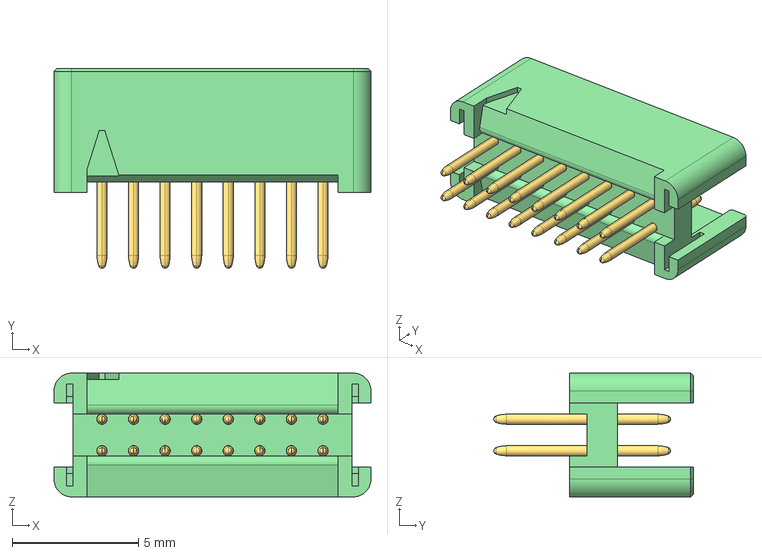
[picture p253: CAD file, 2022-11-14]
projects/tester/UCT3/design_files_card Vectornav/3D/G125-MV11605L0P.stp
12.6 x 7.90 x 4.90 mm
G125-3011696
G125-1030005 x 16
