aspro648/KiCad/FreeCad/SpeedDriverInvert2.FCStd

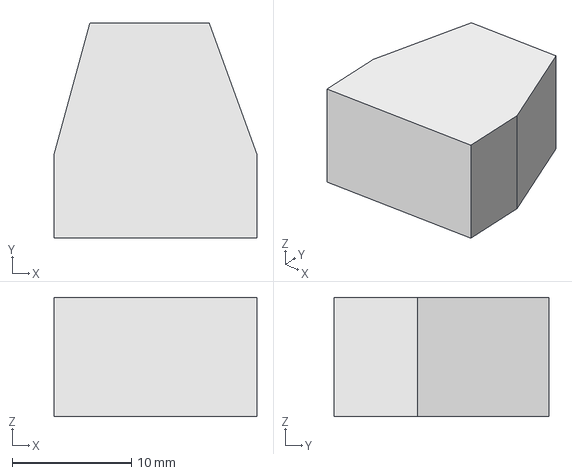
[picture p254: CAD file, 2021-11-01]
FreeCad/SpeedDriverInvert2.FCStd
17.0 x 18.0 x 10.0 mm
