aspro648/KiCad/FreeCad/stls/axleJig5-Cut007.stl

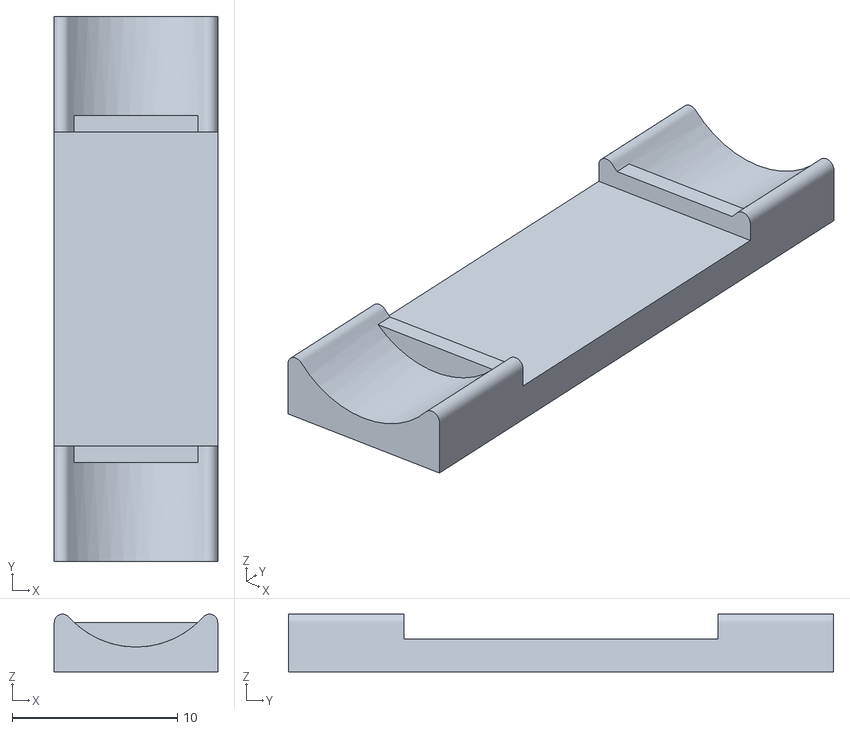
[picture p255: CAD file, 2021-09-07]
FreeCad/stls/axleJig5-Cut007.stl
9.90 x 33.0 x 3.50
