aspro648/KiCad/projects/OSTR/3D/Blank_Badge.stl

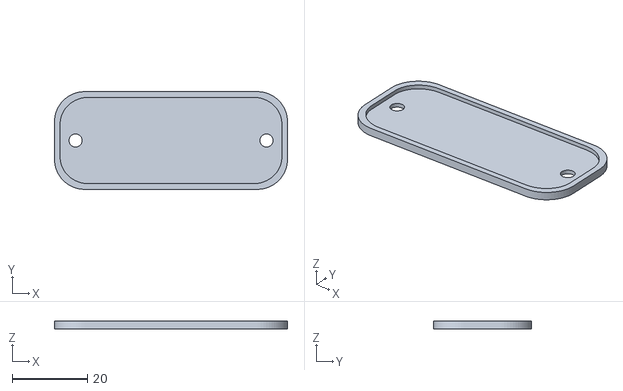
[picture p256: CAD file, 2017-10-24]
projects/OSTR/3D/Blank_Badge.stl
62.0 x 26.0 x 2.00
