aspro648/KiCad/projects/tester/RPB/Board/3D/R_0805_2012Metric.step

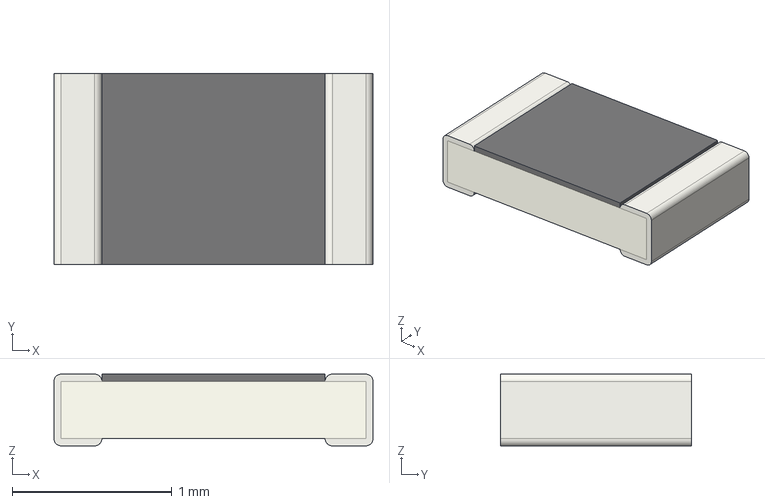
[picture p257: CAD file, 2022-11-14]
projects/tester/RPB/Board/3D/R_0805_2012Metric.step
2.00 x 1.20 x 0.45 mm
