aspro648/KiCad/projects/tester/UCT3/design_files26/3D/resontator_CSTNE16M0V530000R0.STEP

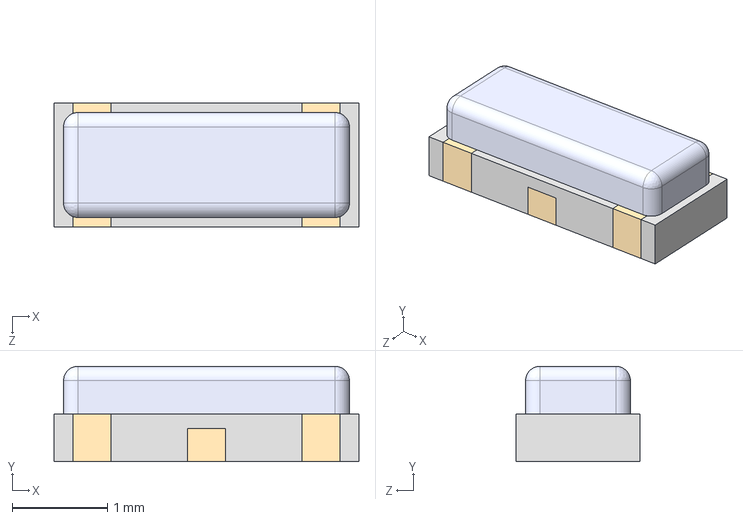
[picture p258: CAD file, 2022-11-14]
projects/tester/UCT3/design_files26/3D/resontator_CSTNE16M0V530000R0.STEP
3.20 x 1.00 x 1.30 mm
