aspro648/KiCad/projects/tester/UCT3/design_files_card 254 pitch/3D/G125-MV12005L0P.stp

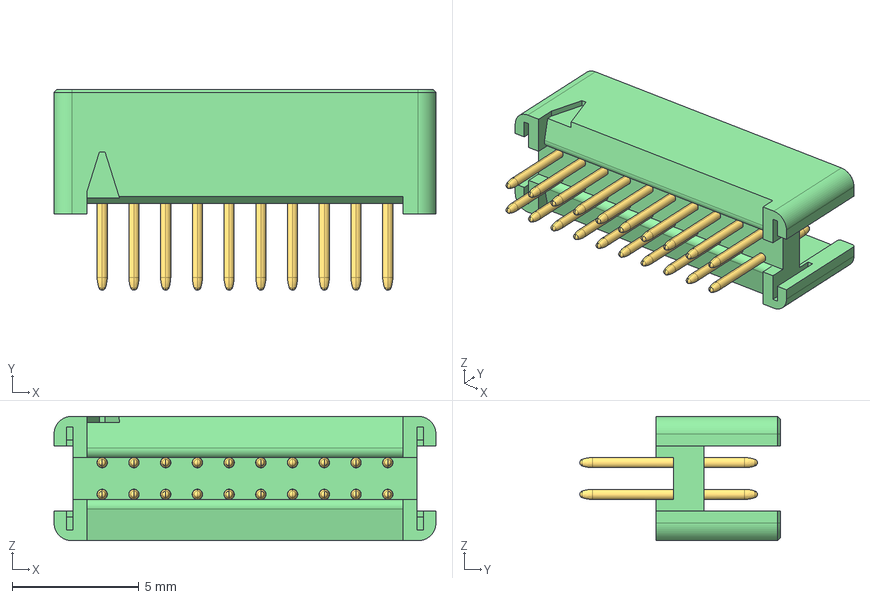
[picture p259: CAD file, 2022-11-14]
projects/tester/UCT3/design_files_card 254 pitch/3D/G125-MV12005L0P.stp
15.1 x 7.90 x 4.90 mm
G125-3012096
G125-1030005 x 20
