aspro648/KiCad/FreeCad/SpeedDriverInvert.FCStd

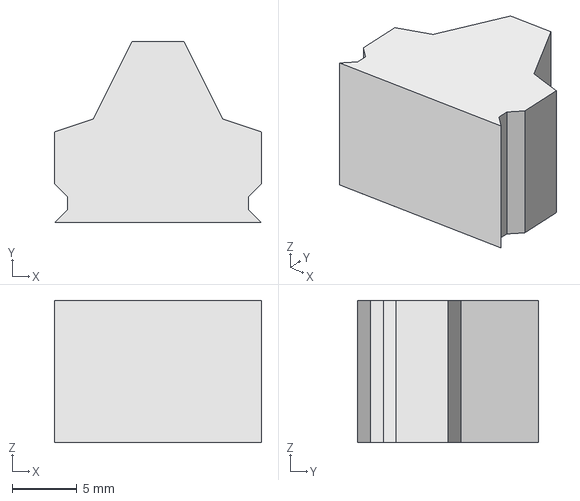
[picture p260: CAD file, 2021-11-01]
FreeCad/SpeedDriverInvert.FCStd
16.0 x 14.0 x 11.0 mm
