aspro648/KiCad/FreeCad/stls/axleJig5-FrontAxle.stl

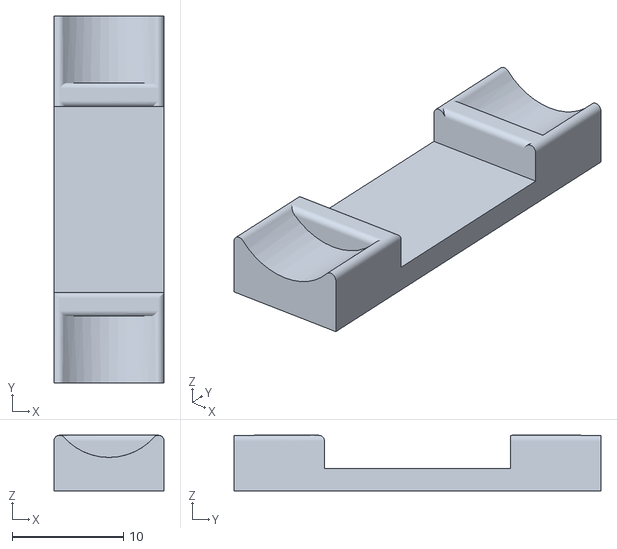
[picture p261: CAD file, 2021-09-07]
FreeCad/stls/axleJig5-FrontAxle.stl
9.90 x 33.0 x 5.00
