aspro648/KiCad/projects/HW/mechanical/ServoBase.FCStd

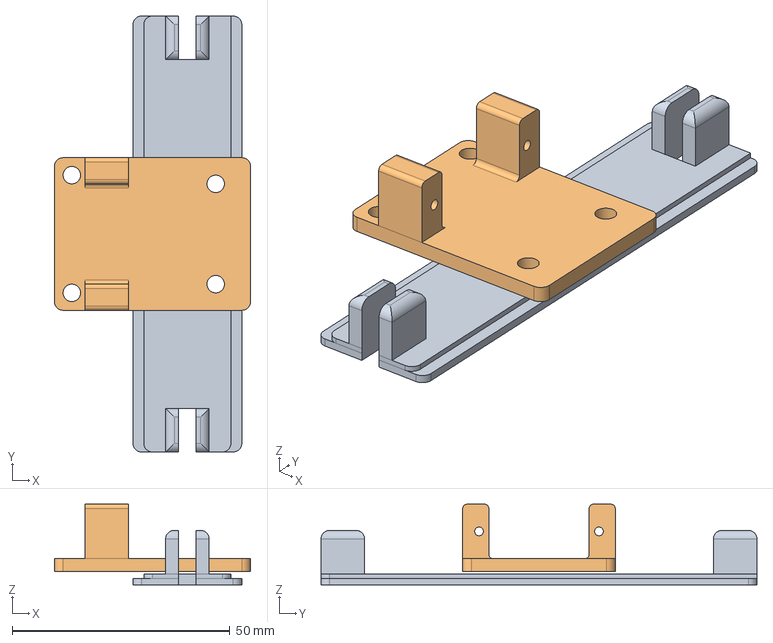
[picture p262: CAD file, 2021-11-24]
projects/HW/mechanical/ServoBase.FCStd
45.0 x 100.0 x 18.5 mm
BOTTOM
TOP
