aspro648/KiCad/projects/OSTR/3D/Chassis.stl

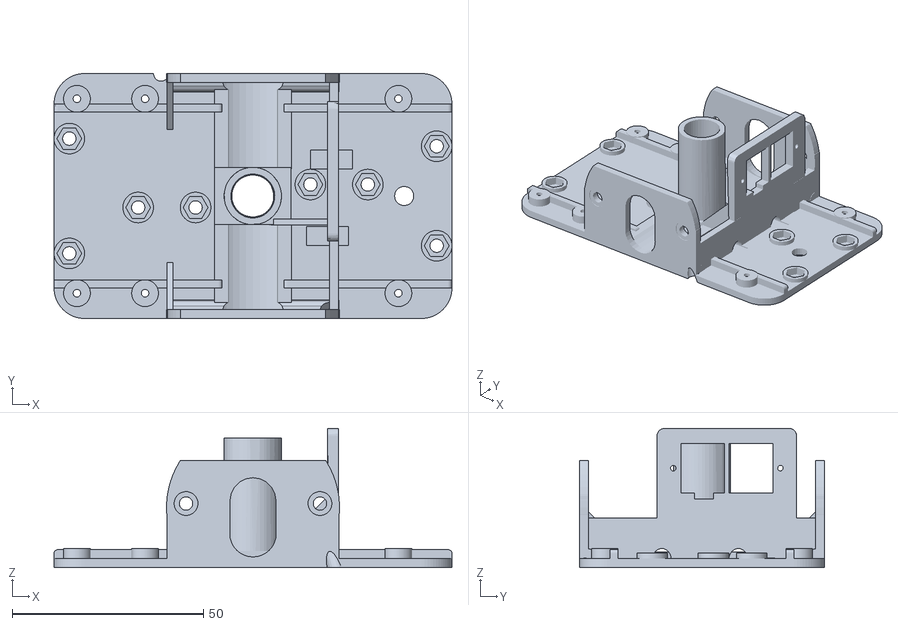
[picture p263: CAD file, 2017-10-24]
projects/OSTR/3D/Chassis.stl
104.0 x 64.0 x 36.4
