aspro648/KiCad/projects/tester/RPB/Board/3D/C_0603_1608Metric.step

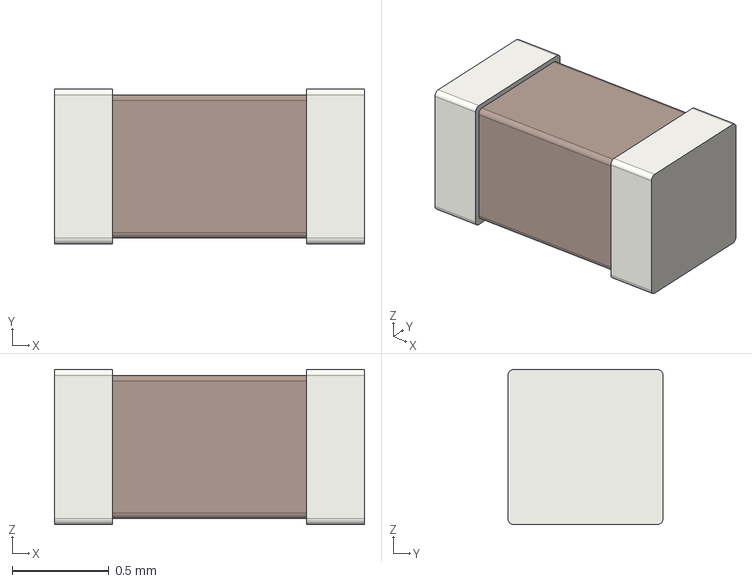
[picture p264: CAD file, 2022-11-14]
projects/tester/RPB/Board/3D/C_0603_1608Metric.step
1.60 x 0.8 x 0.8 mm
