aspro648/KiCad/projects/tester/UCT3/design_files26/3D/USB_micro_105017-0001.stp

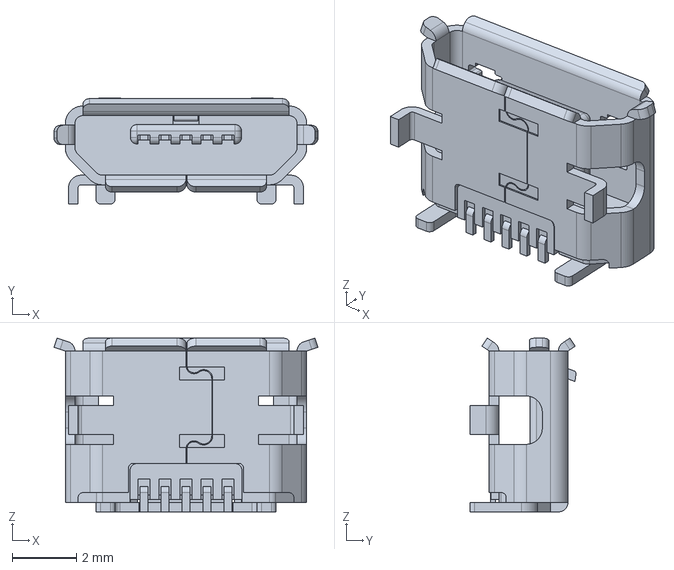
[picture p265: CAD file, 2022-11-14]
projects/tester/UCT3/design_files26/3D/USB_micro_105017-0001.stp
8.20 x 3.30 x 5.40 mm
