aspro648/KiCad/FreeCad/SpeedDriverClip.FCStd

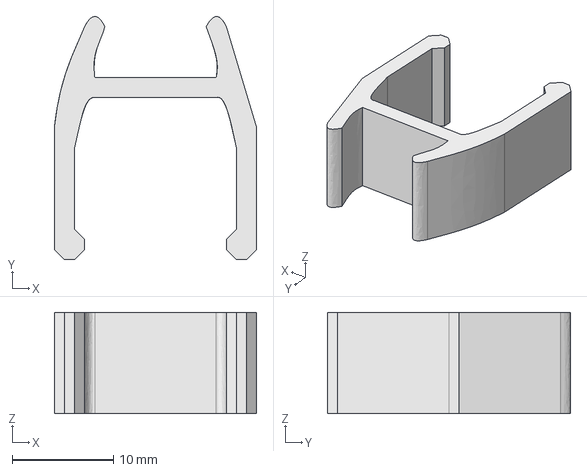
[picture p266: CAD file, 2021-11-01]
FreeCad/SpeedDriverClip.FCStd
20.0 x 24.0 x 10.0 mm
