aspro648/KiCad/FreeCad/stls/Chevy2short.stl

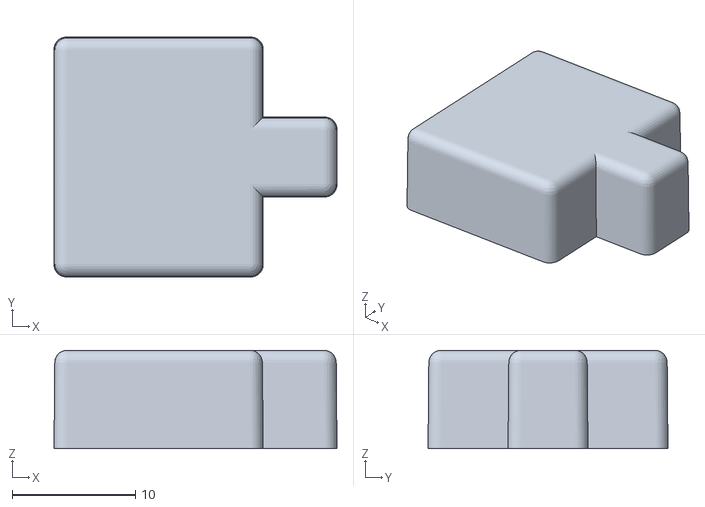
[picture p267: CAD file, 2021-07-11]
FreeCad/stls/Chevy2short.stl
23.0 x 19.5 x 8.00
