aspro648/KiCad/projects/HW/mechanical/standoff2.FCStd

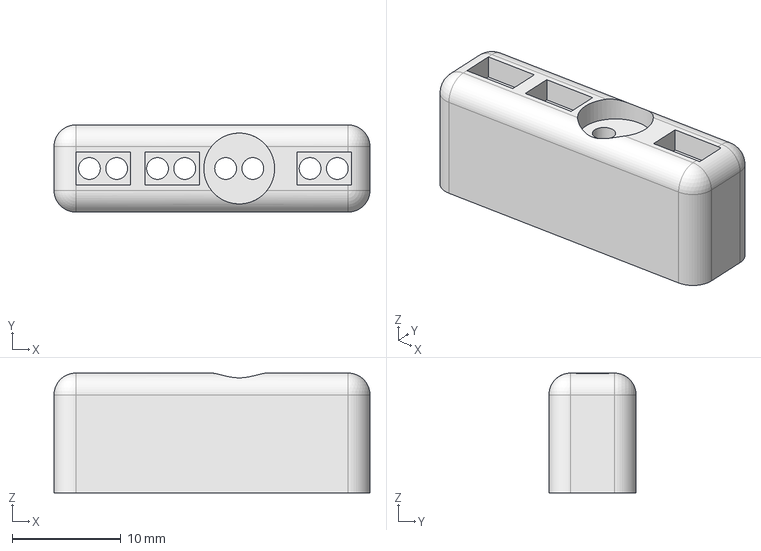
[picture p268: CAD file, 2021-10-29]
projects/HW/mechanical/standoff2.FCStd
29.0 x 8.00 x 11.0 mm
