aspro648/KiCad/projects/tester/RPB/Board/3D/ATMEGA32U4-AUR--3DModel-STEP-56544.STEP

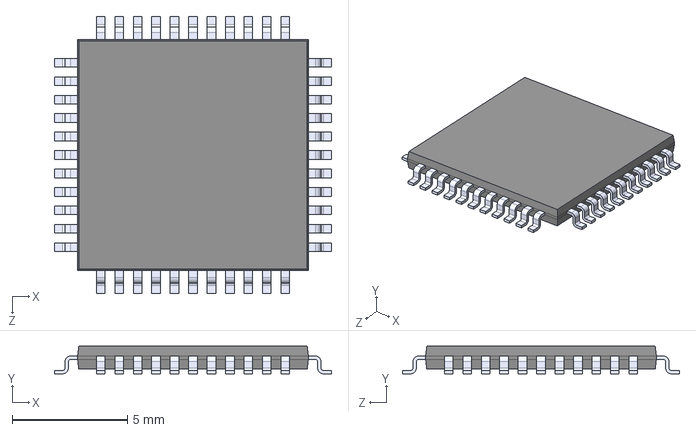
[picture p269: CAD file, 2022-11-14]
projects/tester/RPB/Board/3D/ATMEGA32U4-AUR--3DModel-STEP-56544.STEP
12.0 x 1.20 x 12.0 mm
