aspro648/KiCad/projects/tester/UCT3/design_files26/3D/standoff9774027151R (rev1).stp

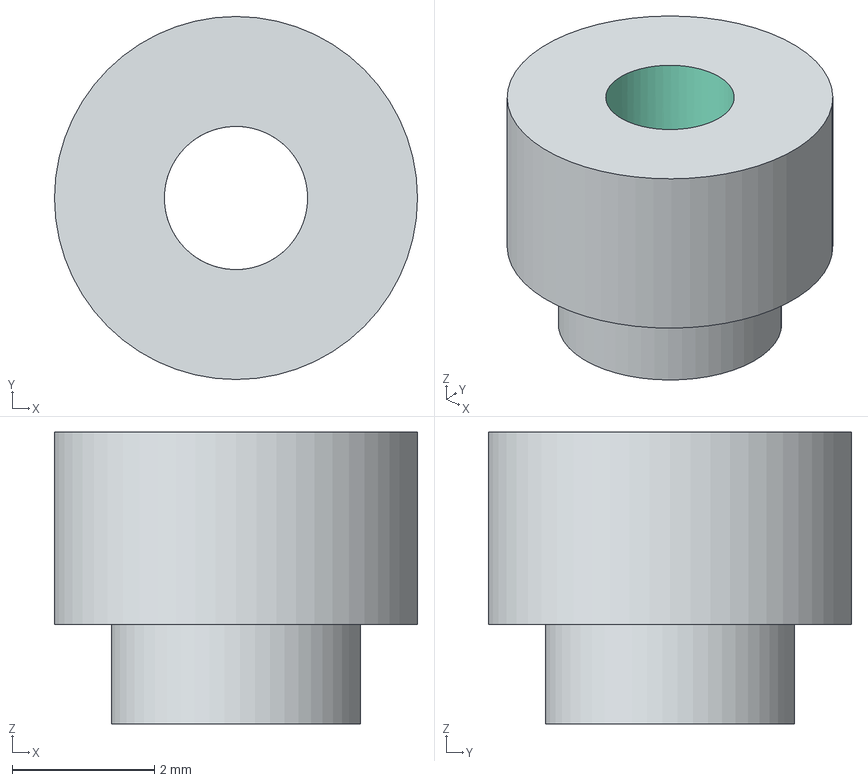
[picture p270: CAD file, 2022-11-14]
projects/tester/UCT3/design_files26/3D/standoff9774027151R (rev1).stp
5.10 x 5.10 x 4.10 mm
