aspro648/KiCad/FreeCad/axleJig5.FCStd

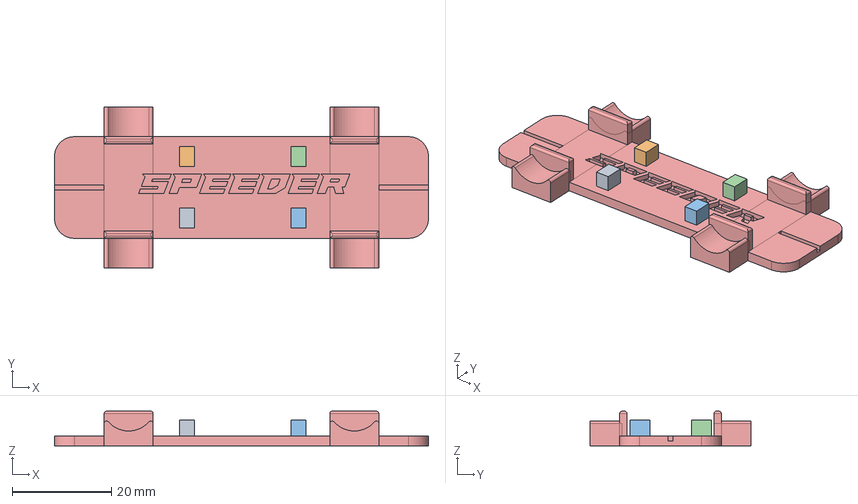
[picture p271: CAD file, 2021-10-04]
FreeCad/axleJig5.FCStd
75.4 x 32.5 x 7.00 mm
