aspro648/KiCad/FreeCad/stls/axlejig2b.stl

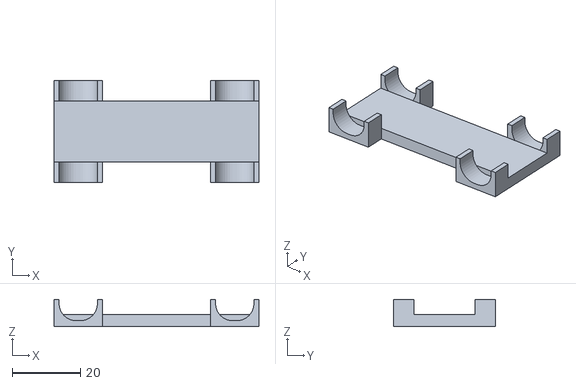
[picture p272: CAD file, 2021-07-11]
FreeCad/stls/axlejig2b.stl
60.2 x 30.0 x 8.00
