aspro648/KiCad/projects/HW/mechanical/standoff.FCStd

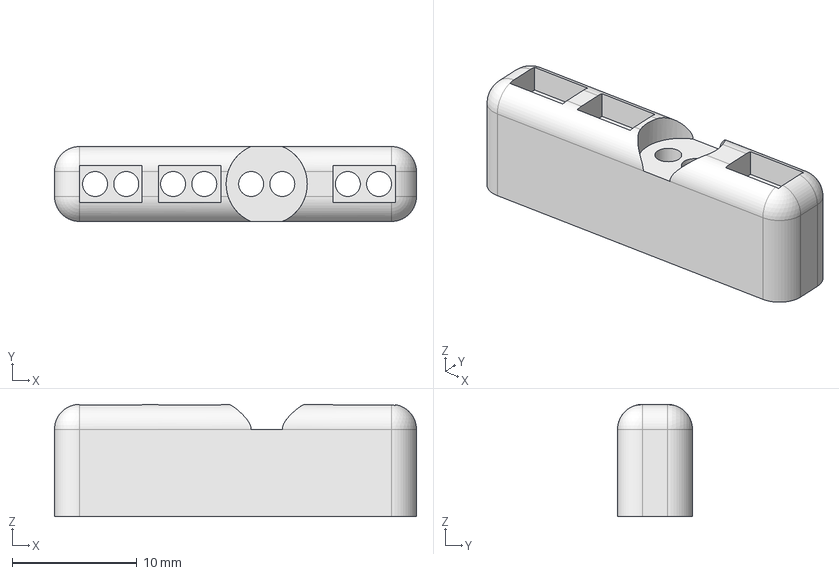
[picture p273: CAD file, 2021-10-28]
projects/HW/mechanical/standoff.FCStd
29.0 x 6.00 x 9.00 mm
