aspro648/KiCad/projects/tester/RPB/Board/3D/C_0805_2012Metric.step

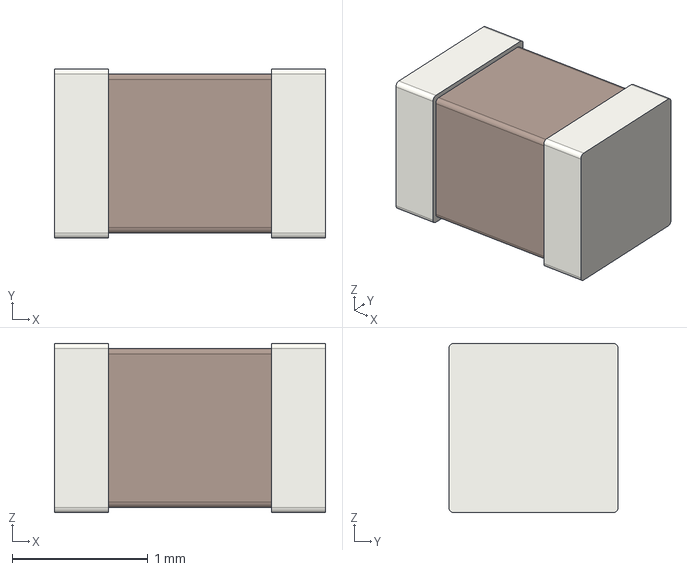
[picture p274: CAD file, 2022-11-14]
projects/tester/RPB/Board/3D/C_0805_2012Metric.step
2.00 x 1.25 x 1.25 mm
