aspro648/KiCad/projects/tester/UCT3/design_files26/3D/MEC6-110-02-L-D-RA1-TR.step

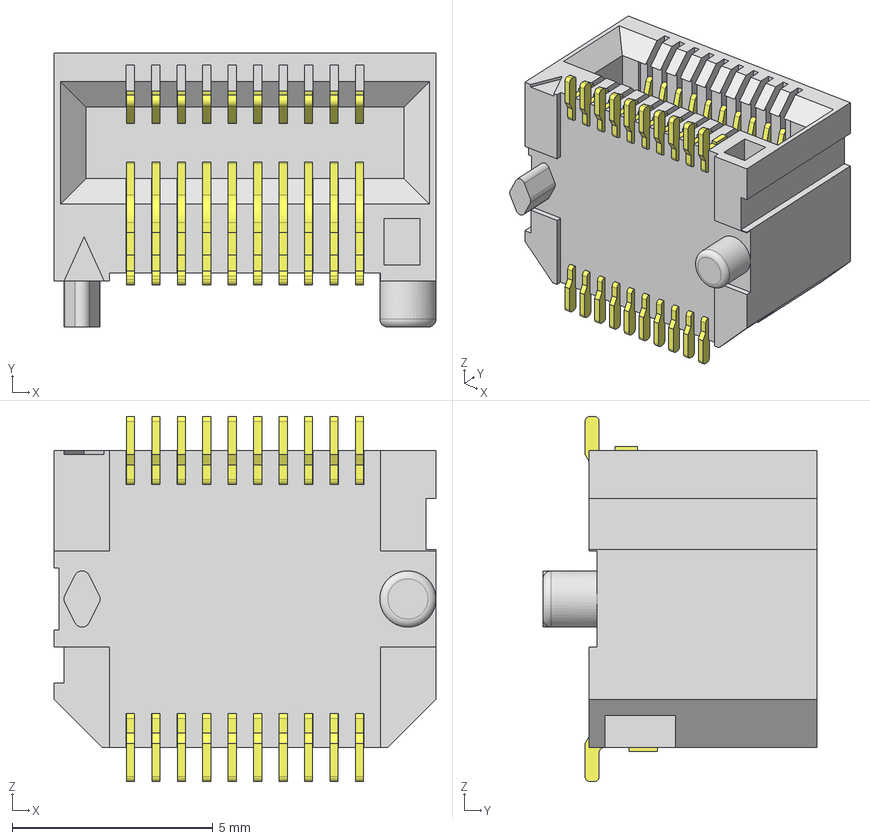
[picture p275: CAD file, 2022-11-14]
projects/tester/UCT3/design_files26/3D/MEC6-110-02-L-D-RA1-TR.step
9.52 x 6.83 x 9.10 mm
P2MEC6-10-02-D-RA1
P1MEC6-10-02-D-RA1
TMEC6-10-02-D-RA1
