aspro648/KiCad/FreeCad/axleJig4.FCStd

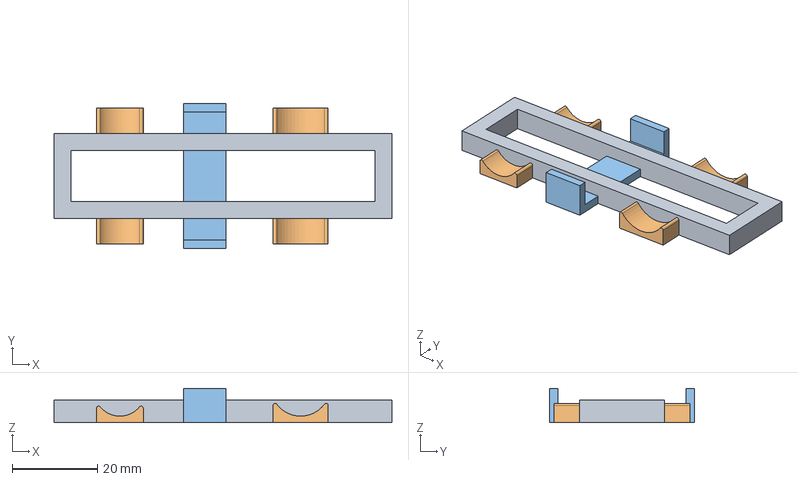
[picture p276: CAD file, 2021-09-07]
FreeCad/axleJig4.FCStd
79.5 x 34.0 x 8.00 mm
