aspro648/KiCad/FreeCad/stls/Chevy2.stl

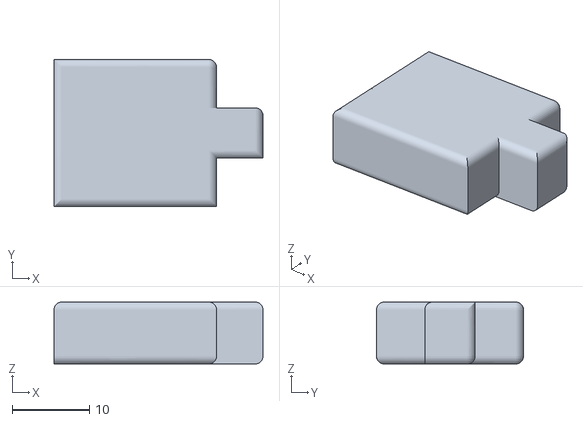
[picture p277: CAD file, 2021-07-11]
FreeCad/stls/Chevy2.stl
27.0 x 19.0 x 8.00
