aspro648/KiCad/FreeCad/stls/EVOs.stl

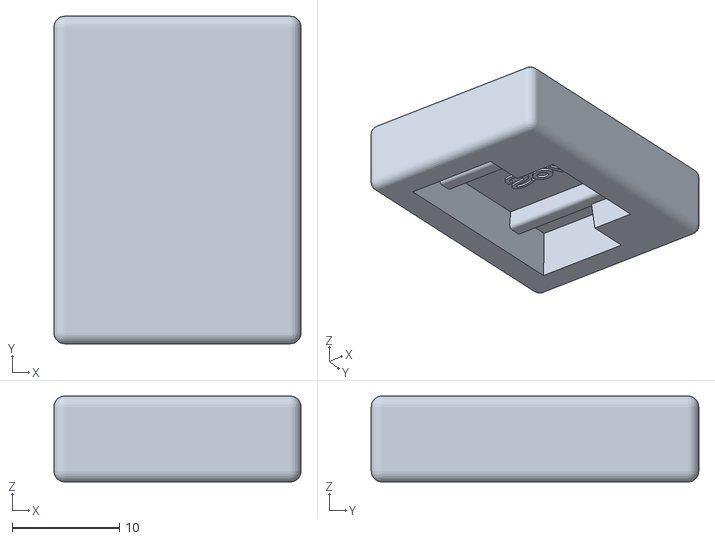
[picture p278: CAD file, 2021-05-05]
FreeCad/stls/EVOs.stl
23.0 x 30.5 x 8.00
