aspro648/KiCad/FreeCad/wheelJig.FCStd

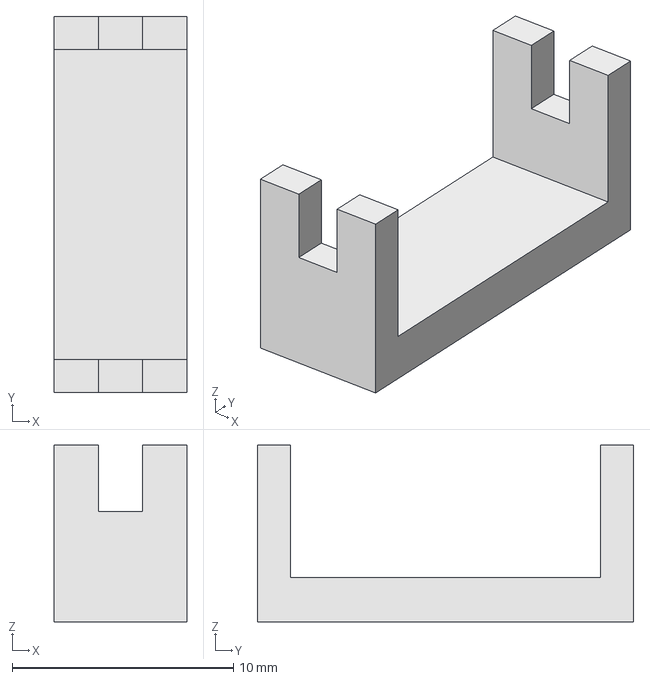
[picture p279: CAD file, 2021-09-07]
FreeCad/wheelJig.FCStd
6.00 x 17.0 x 8.00 mm
