aspro648/KiCad/FreeCad/axleJig3.FCStd

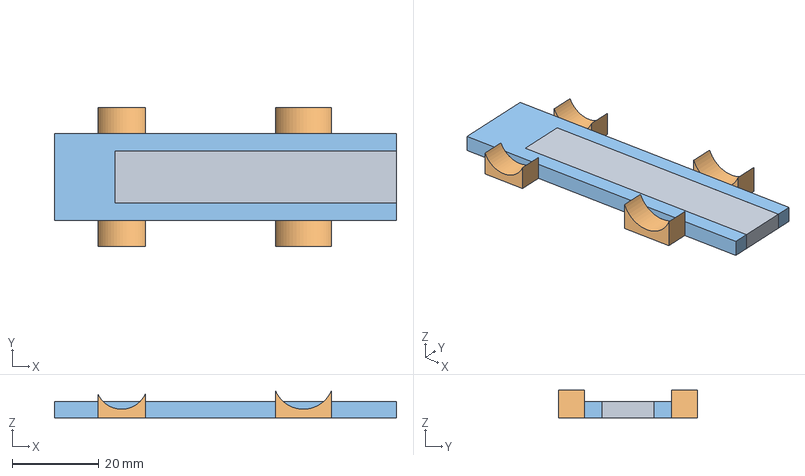
[picture p280: CAD file, 2021-09-07]
FreeCad/axleJig3.FCStd
79.0 x 32.0 x 6.40 mm
base
