aspro648/KiCad/FreeCad/stls/Wheel 3.stl

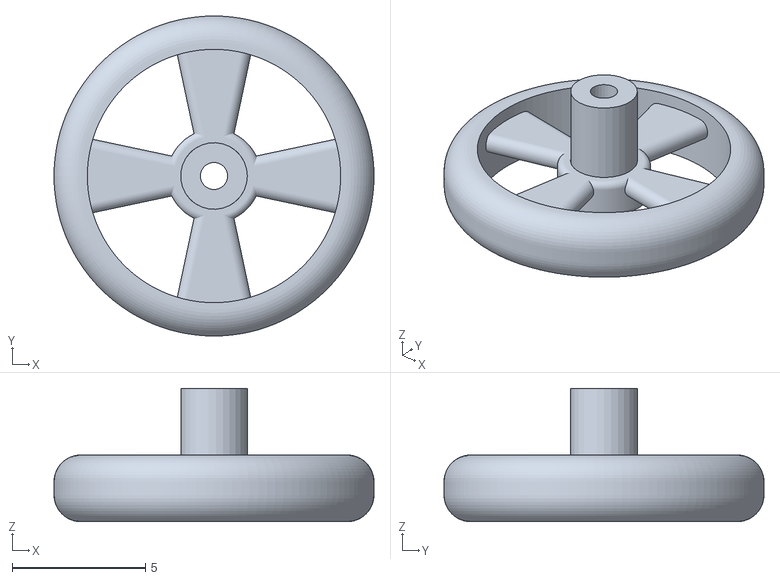
[picture p281: CAD file, 2021-05-04]
FreeCad/stls/Wheel 3.stl
12.0 x 12.0 x 5.00
