aspro648/KiCad/projects/tester/UCT3/design_files26/3D/R_0603_1608Metric.step

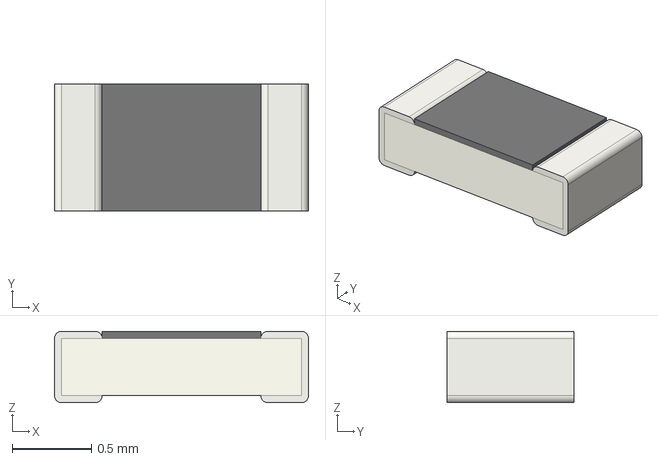
[picture p282: CAD file, 2022-11-14]
projects/tester/UCT3/design_files26/3D/R_0603_1608Metric.step
1.60 x 0.8 x 0.45 mm
