aspro648/KiCad/FreeCad/stls/Silvia.stl

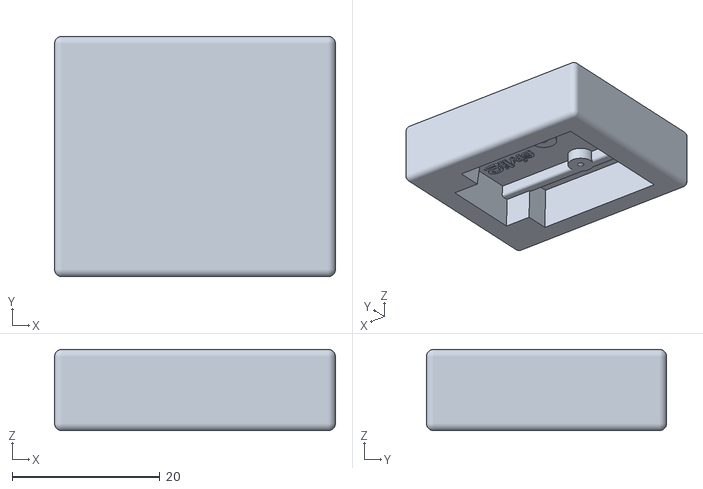
[picture p283: CAD file, 2021-04-30]
FreeCad/stls/Silvia.stl
38.0 x 32.5 x 11.0
