aspro648/KiCad/projects/tester/RPB/Board/3D/Button_b3s-1002p.stp

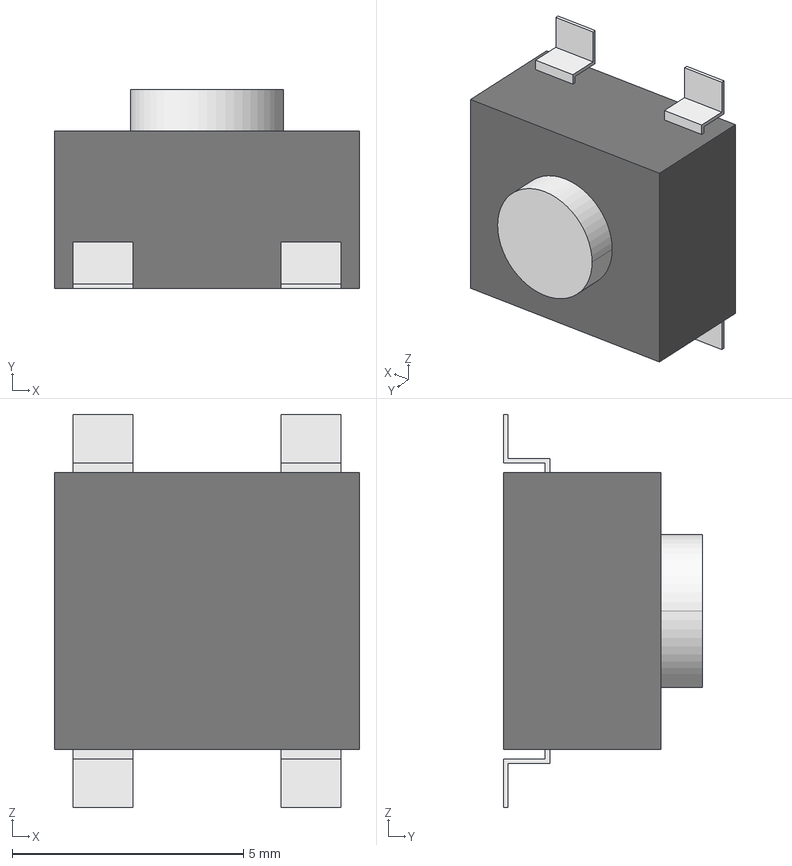
[picture p284: CAD file, 2022-11-14]
projects/tester/RPB/Board/3D/Button_b3s-1002p.stp
6.60 x 4.30 x 8.50 mm
