aspro648/KiCad/FreeCad/stls/Wheel102.stl

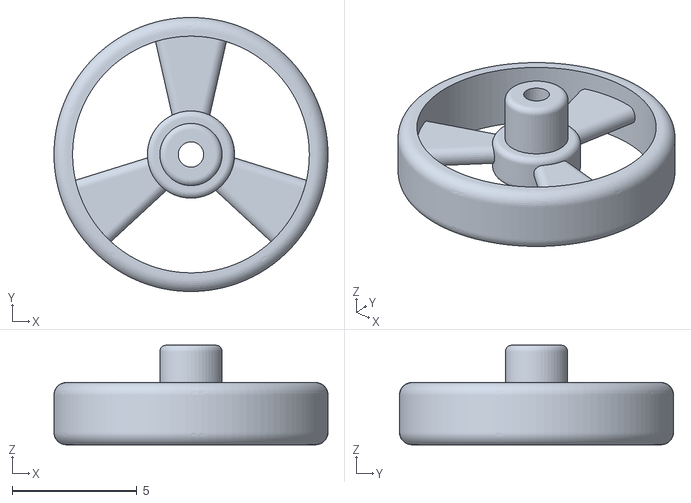
[picture p285: CAD file, 2021-04-28]
FreeCad/stls/Wheel102.stl
11.0 x 11.0 x 4.00
