aspro648/KiCad/FreeCad/axleJig.FCStd

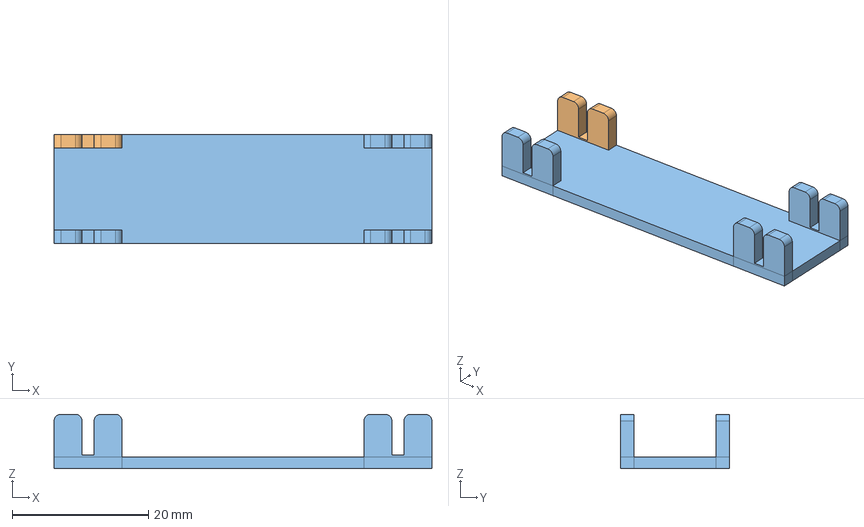
[picture p286: CAD file, 2021-07-11]
FreeCad/axleJig.FCStd
55.5 x 16.0 x 8.00 mm
post01
post002
axlejig
