aspro648/KiCad/FreeCad/stls/EVO.stl

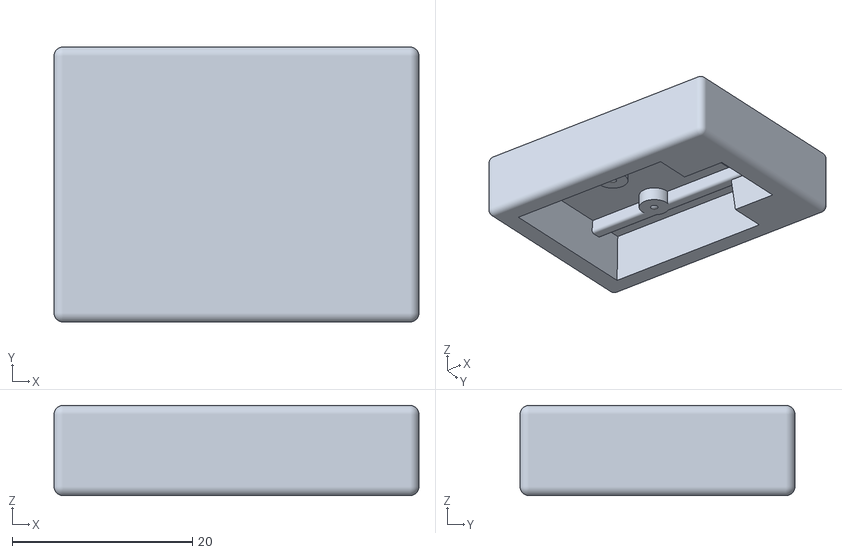
[picture p287: CAD file, 2021-04-28]
FreeCad/stls/EVO.stl
40.5 x 30.5 x 10.0
