aspro648/KiCad/FreeCad/stls/370z.stl

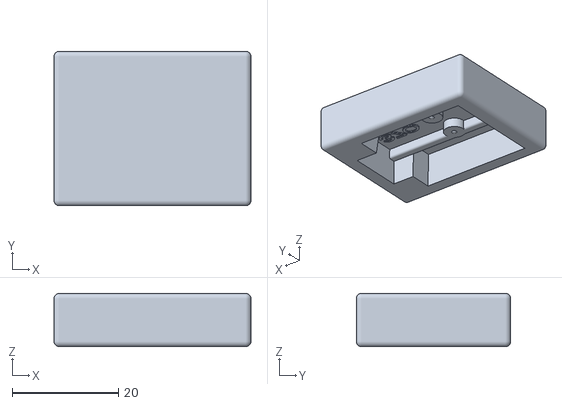
[picture p288: CAD file, 2021-04-27]
FreeCad/stls/370z.stl
37.0 x 29.0 x 10.0
