aspro648/KiCad/projects/tester/RPB/Board/3D/C_1206_3216Metric.step

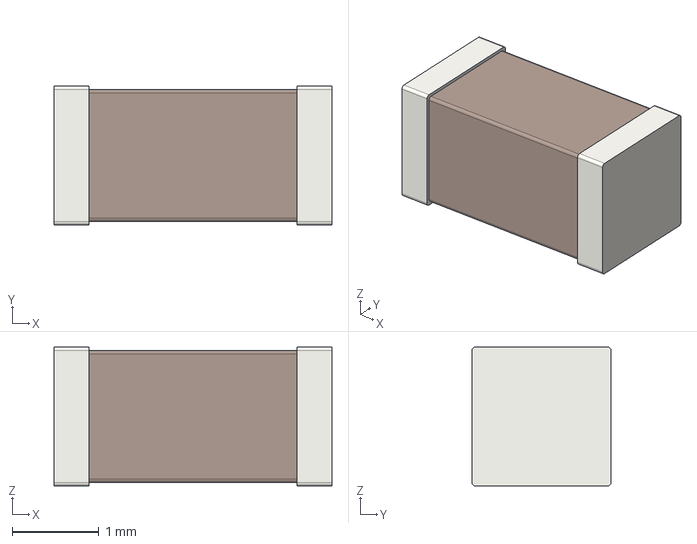
[picture p289: CAD file, 2022-11-14]
projects/tester/RPB/Board/3D/C_1206_3216Metric.step
3.20 x 1.60 x 1.60 mm
