aspro648/KiCad/FreeCad/stls/Urus_mold.stl

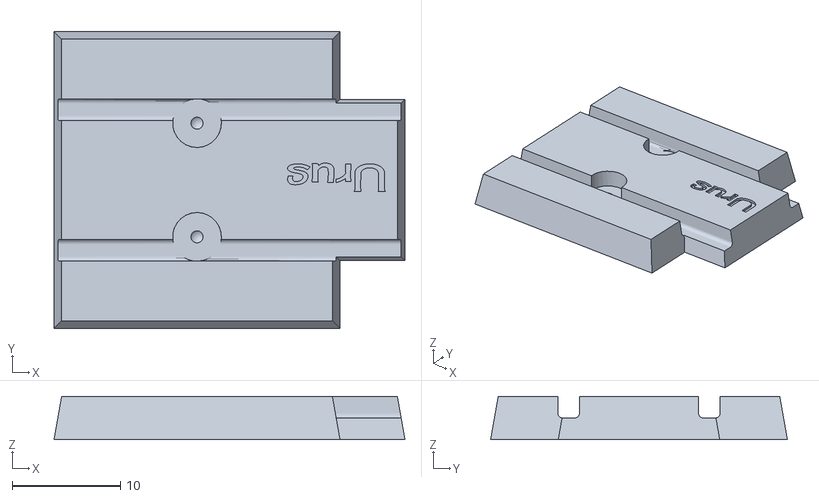
[picture p290: CAD file, 2021-04-19]
FreeCad/stls/Urus_mold.stl
32.4 x 27.4 x 4.00
