aspro648/KiCad/FreeCad/Wheel 2.FCStd

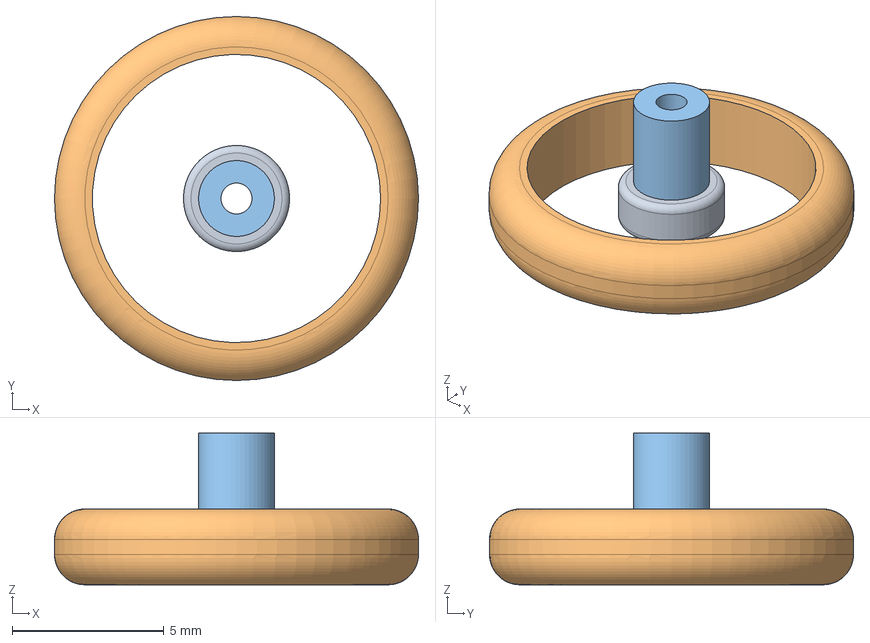
[picture p291: CAD file, 2021-05-05]
FreeCad/Wheel 2.FCStd
12.0 x 12.0 x 5.00 mm
Rivet_dish
Rim
