aspro648/KiCad/FreeCad/Mold_negative5bottom.FCStd

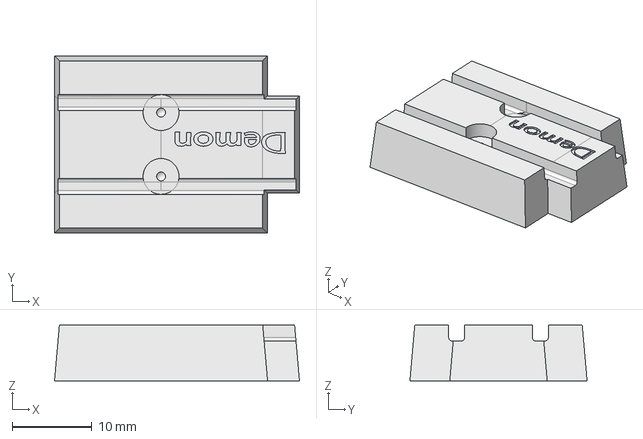
[picture p292: CAD file, 2021-04-30]
FreeCad/Mold_negative5bottom.FCStd
30.7 x 22.2 x 7.00 mm
