aspro648/KiCad/FreeCad/stls/DemonWeight.stl

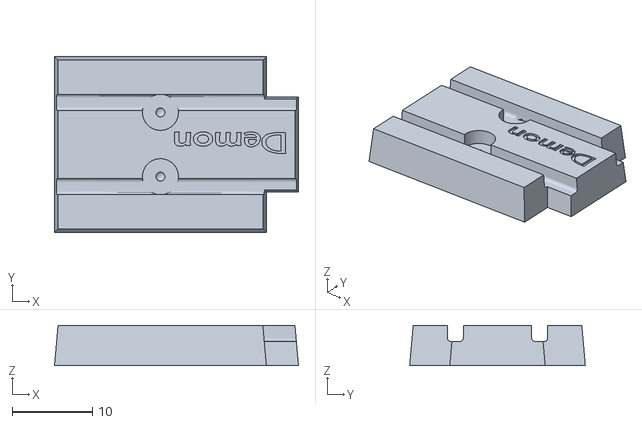
[picture p293: CAD file, 2021-04-19]
FreeCad/stls/DemonWeight.stl
30.4 x 21.9 x 5.00
