aspro648/KiCad/FreeCad/KuttingGuide.FCStd

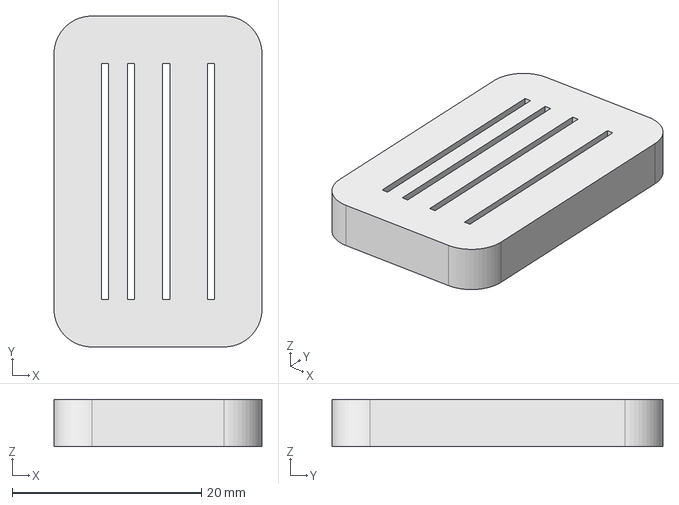
[picture p294: CAD file, 2021-04-23]
FreeCad/KuttingGuide.FCStd
22.0 x 35.0 x 5.00 mm
