aspro648/KiCad/FreeCad/stls/Urus_negative5.stl

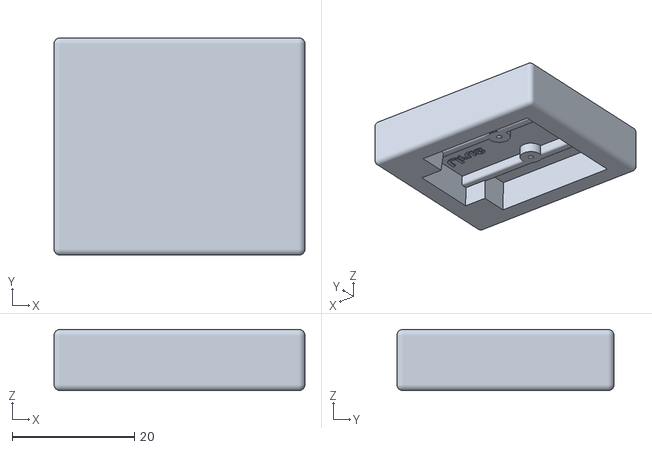
[picture p295: CAD file, 2021-04-19]
FreeCad/stls/Urus_negative5.stl
41.0 x 35.5 x 10.0
