aspro648/KiCad/FreeCad/stls/Nomad_mold.stl

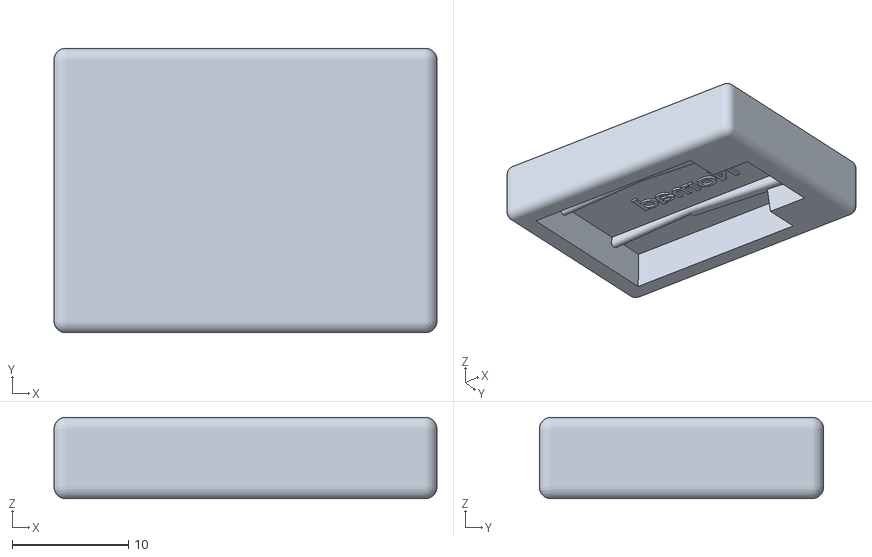
[picture p296: CAD file, 2021-04-16]
FreeCad/stls/Nomad_mold.stl
33.0 x 24.5 x 7.00
