aspro648/KiCad/FreeCad/Wheel.FCStd

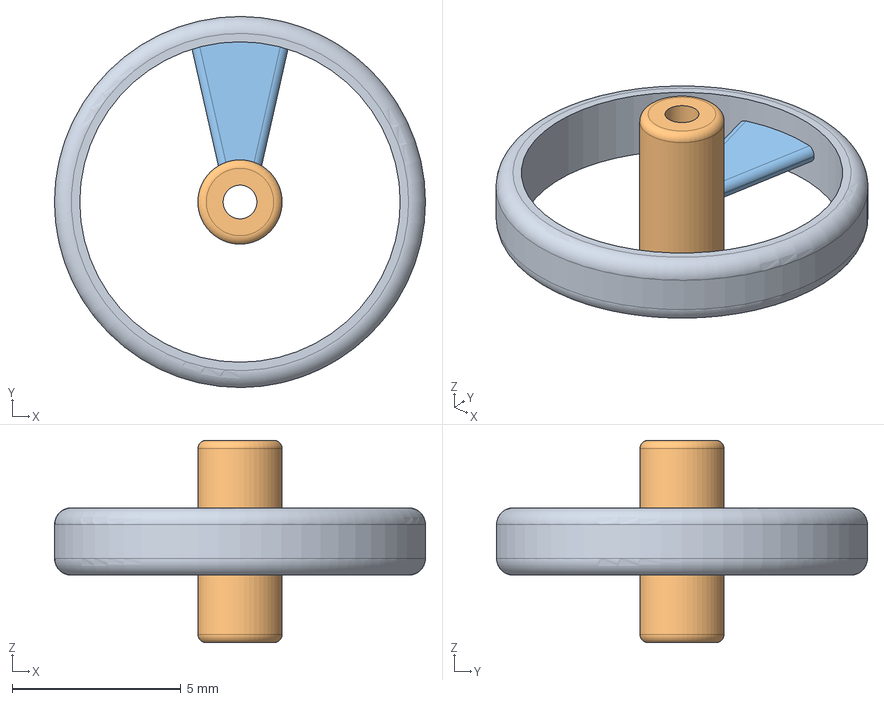
[picture p297: CAD file, 2021-04-23]
FreeCad/Wheel.FCStd
11.0 x 11.0 x 6.00 mm
