aspro648/KiCad/FreeCad/HoleTest.FCStd

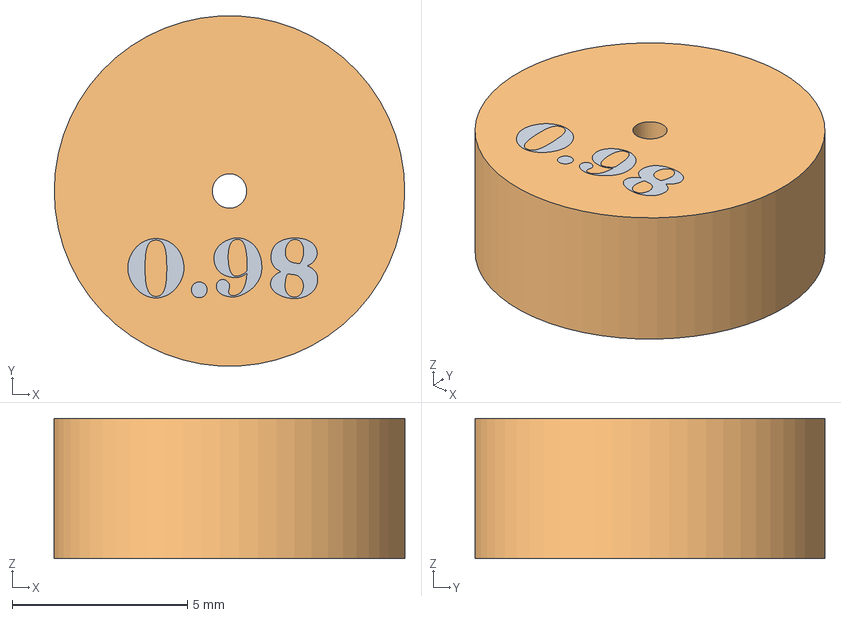
[picture p298: CAD file, 2021-04-22]
FreeCad/HoleTest.FCStd
10.0 x 9.99 x 4.00 mm
ShapeString001
