aspro648/KiCad/FreeCad/stls/Mold_negative5-Cut.stl

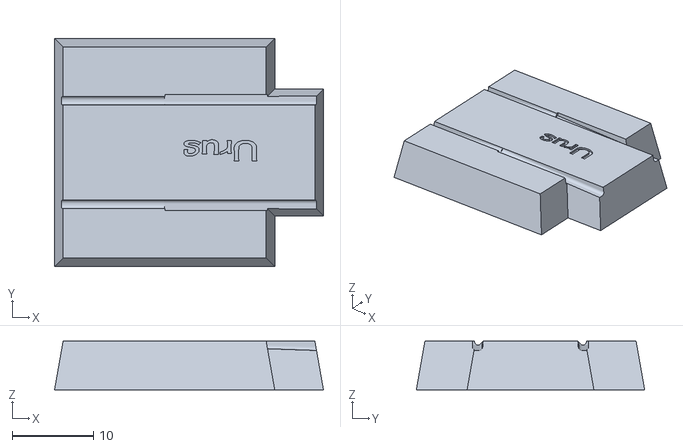
[picture p299: CAD file, 2021-04-15]
FreeCad/stls/Mold_negative5-Cut.stl
33.1 x 28.1 x 6.00
