aspro648/KiCad/FreeCad/Mold_negative5.FCStd

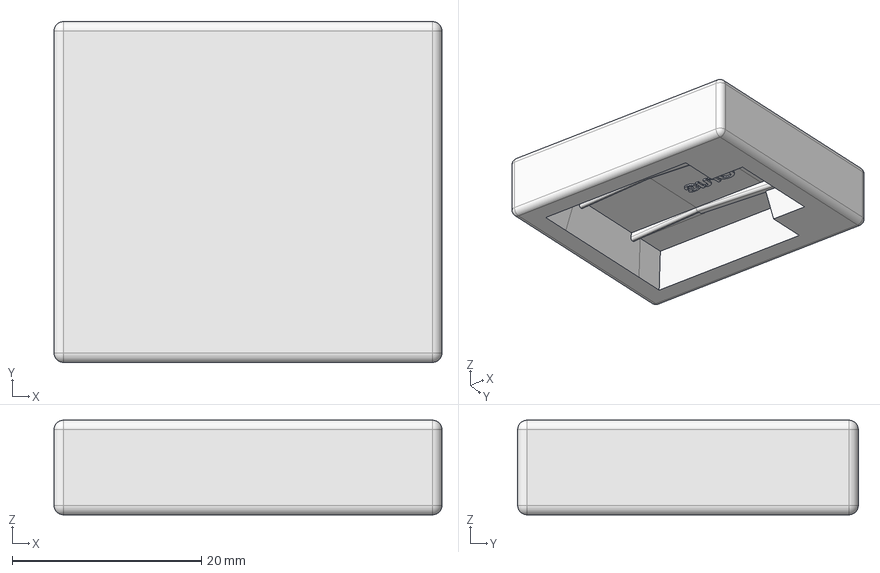
[picture p300: CAD file, 2021-04-16]
FreeCad/Mold_negative5.FCStd
41.0 x 36.0 x 10.0 mm
