aspro648/KiCad/FreeCad/Mold_negative4.FCStd

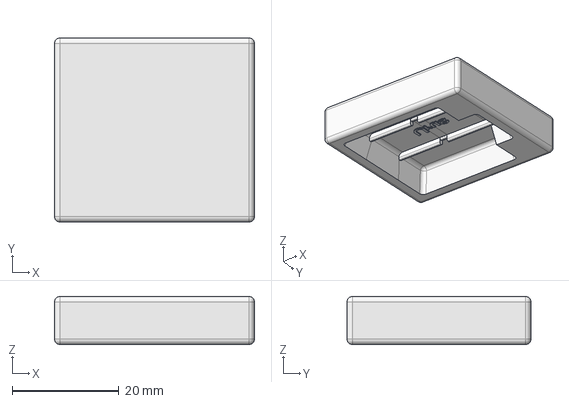
[picture p301: CAD file, 2021-04-14]
FreeCad/Mold_negative4.FCStd
37.5 x 34.5 x 9.00 mm
