aspro648/KiCad/FreeCad/stls/55 Nomad.stl

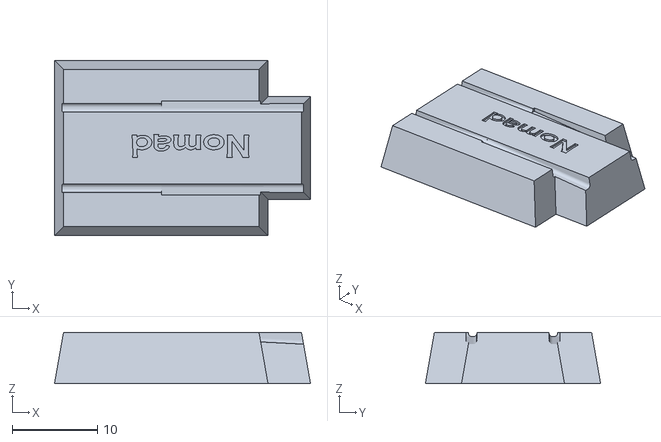
[picture p302: CAD file, 2021-04-15]
FreeCad/stls/55 Nomad.stl
30.1 x 20.6 x 6.00
