aspro648/KiCad/FreeCad/Mold_negative3.FCStd

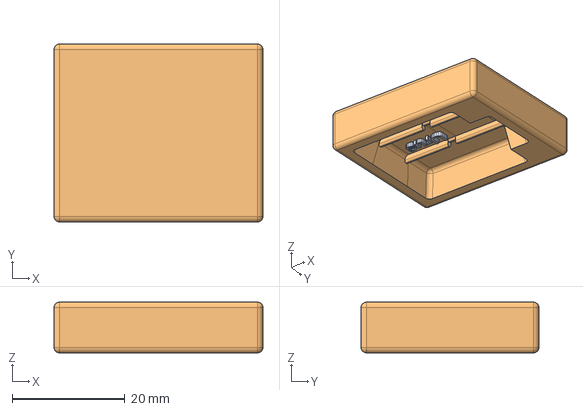
[picture p303: CAD file, 2021-04-14]
FreeCad/Mold_negative3.FCStd
37.0 x 31.5 x 9.00 mm
