aspro648/KiCad/FreeCad/pizza.FCStd

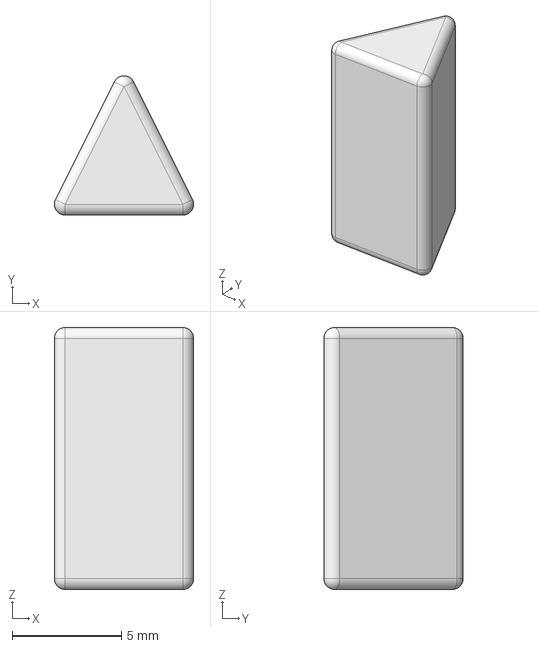
[picture p304: CAD file, 2021-04-09]
FreeCad/pizza.FCStd
6.38 x 6.38 x 12.0 mm
