aspro648/KiCad/FreeCad/Mold_negative2.FCStd

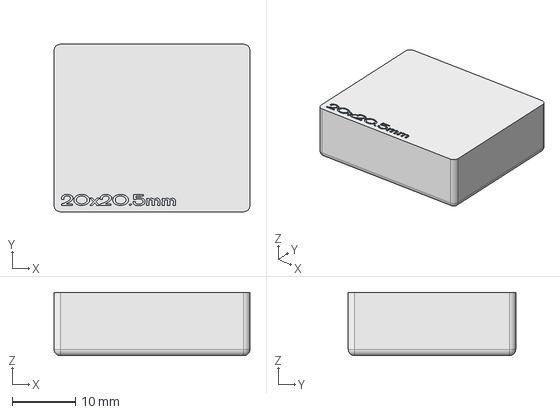
[picture p305: CAD file, 2021-04-08]
FreeCad/Mold_negative2.FCStd
31.0 x 26.5 x 10.0 mm
