aspro648/KiCad/FreeCad/stls/Urus_suspension3.stl

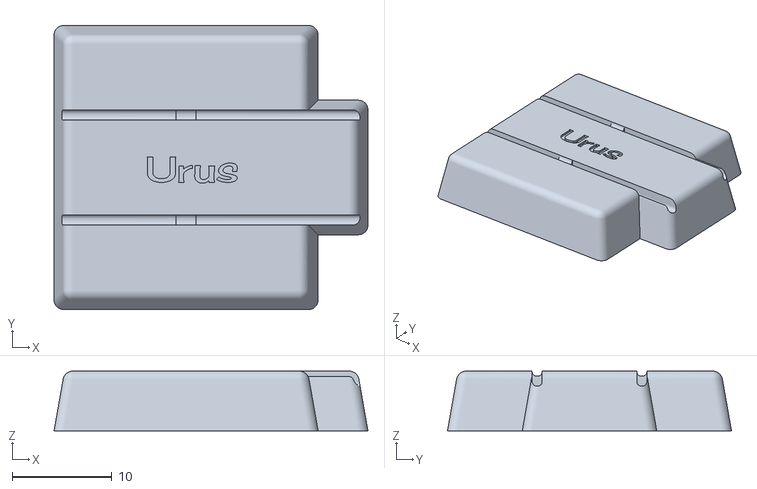
[picture p306: CAD file, 2021-04-14]
FreeCad/stls/Urus_suspension3.stl
31.5 x 28.5 x 6.00
