aspro648/KiCad/FreeCad/Rocket_stand.FCStd

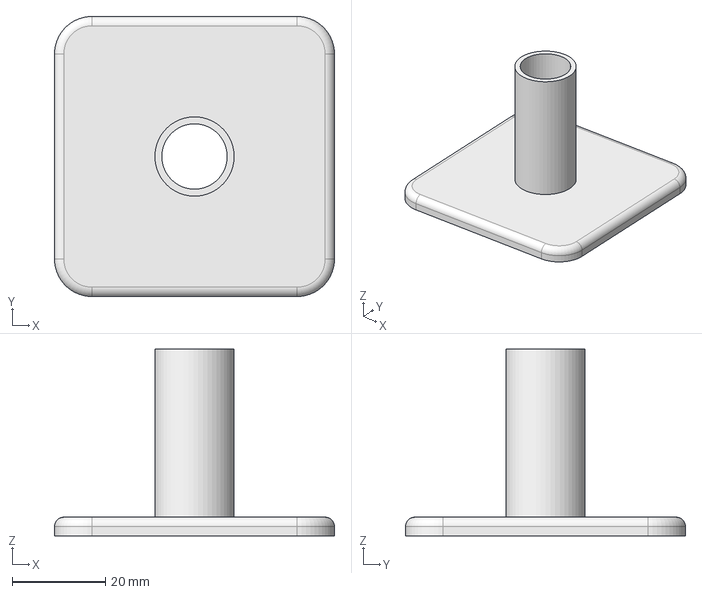
[picture p307: CAD file, 2021-04-02]
FreeCad/Rocket_stand.FCStd
60.0 x 60.0 x 40.0 mm
