aspro648/KiCad/FreeCad/stls/Urus_suspension2.stl

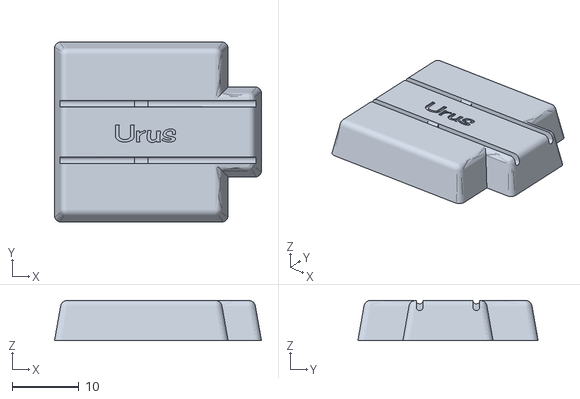
[picture p308: CAD file, 2021-04-14]
FreeCad/stls/Urus_suspension2.stl
31.0 x 27.0 x 6.00
