aspro648/KiCad/FreeCad/Mold_negative.FCStd

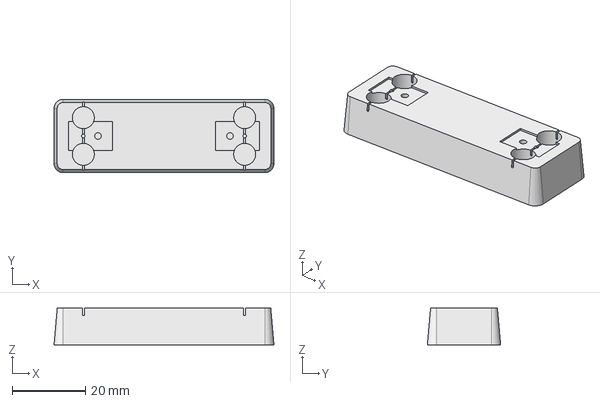
[picture p309: CAD file, 2021-03-01]
FreeCad/Mold_negative.FCStd
60.0 x 20.0 x 10.0 mm
