aspro648/KiCad/FreeCad/chassis.FCStd

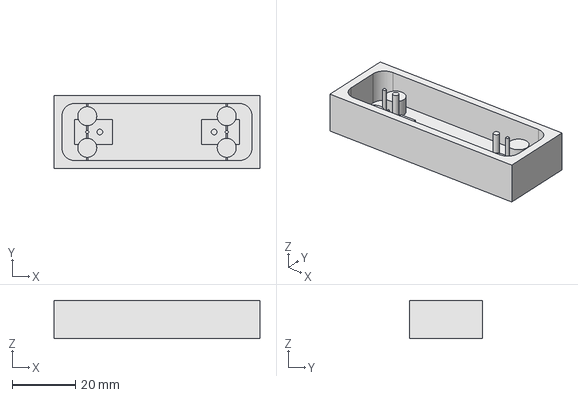
[picture p310: CAD file, 2021-02-16]
FreeCad/chassis.FCStd
65.0 x 23.0 x 12.0 mm
