aspro648/KiCad/FreeCad/stls/Urus_suspension.stl

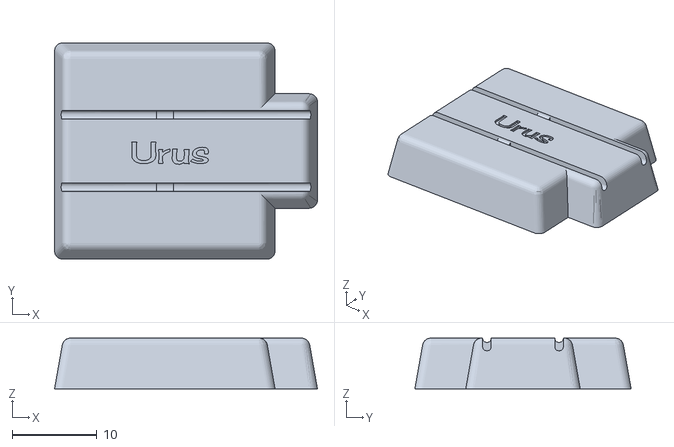
[picture p311: CAD file, 2021-04-14]
FreeCad/stls/Urus_suspension.stl
31.0 x 25.5 x 6.00
