aspro648/KiCad/FreeCad/jig.FCStd

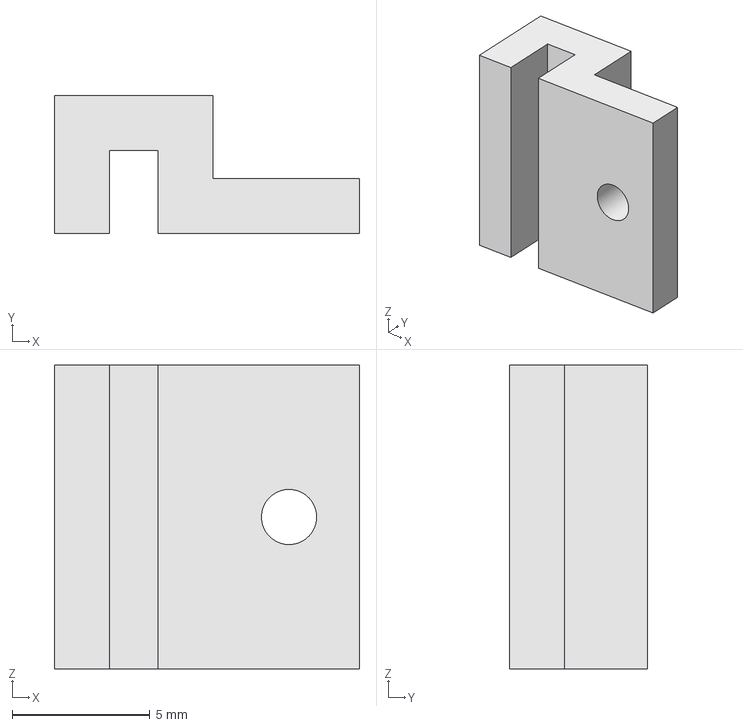
[picture p312: CAD file, 2021-02-11]
FreeCad/jig.FCStd
11.1 x 5.00 x 11.0 mm
