aspro648/KiCad/FreeCad/stls/Demon_supension2.stl

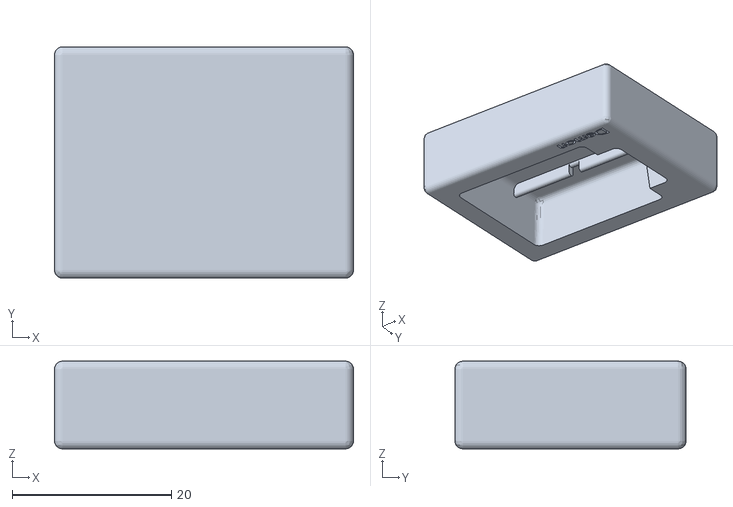
[picture p313: CAD file, 2021-04-12]
FreeCad/stls/Demon_supension2.stl
37.5 x 29.0 x 11.0
