aspro648/KiCad/FreeCad/stls/55 Nomad_supension2_4mm.stl

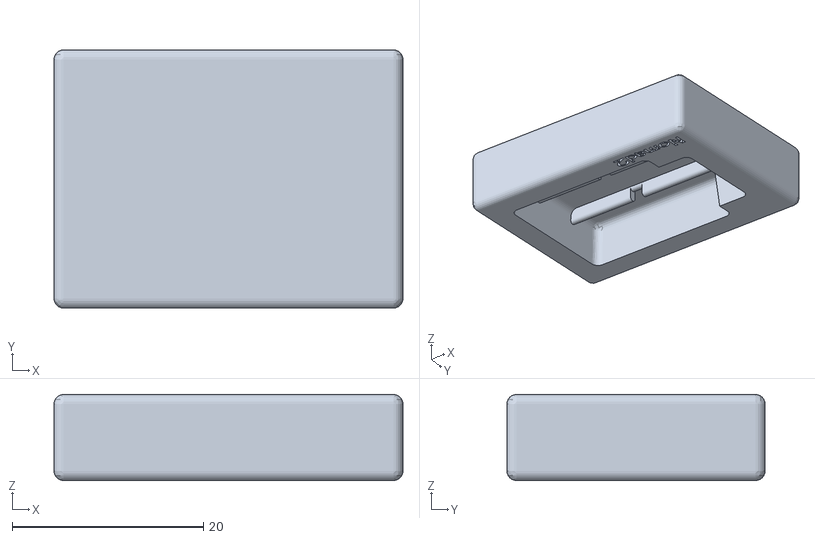
[picture p314: CAD file, 2021-04-12]
FreeCad/stls/55 Nomad_supension2_4mm.stl
36.5 x 27.0 x 9.00
