aspro648/KiCad/FreeCad/weight_matrix.FCStd

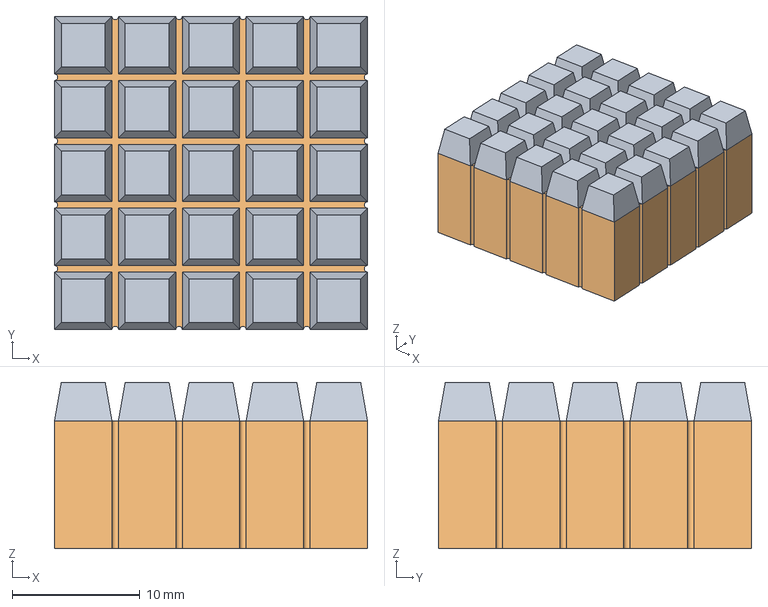
[picture p315: CAD file, 2021-02-11]
FreeCad/weight_matrix.FCStd
24.5 x 24.5 x 13.0 mm
