aspro648/KiCad/FreeCad/weight_matrix2.FCStd

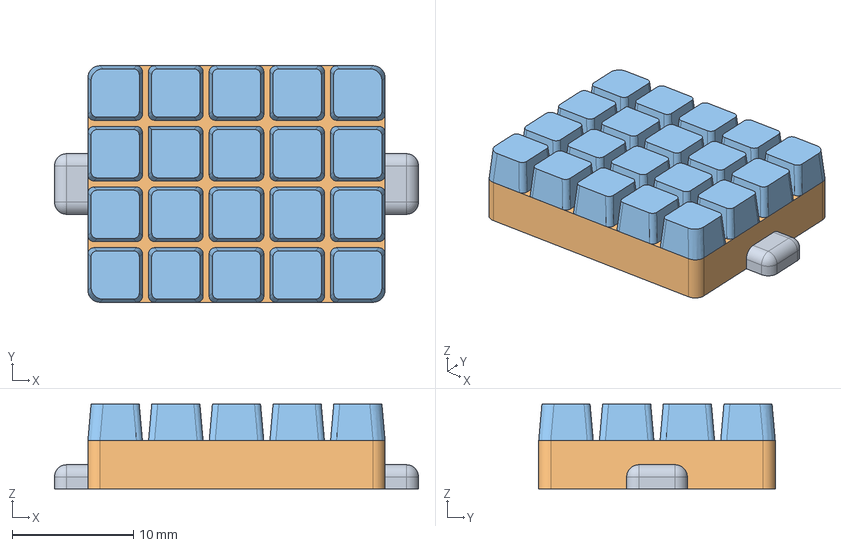
[picture p316: CAD file, 2021-02-10]
FreeCad/weight_matrix2.FCStd
30.0 x 19.5 x 7.00 mm
