aspro648/KiCad/FreeCad/clip.FCStd

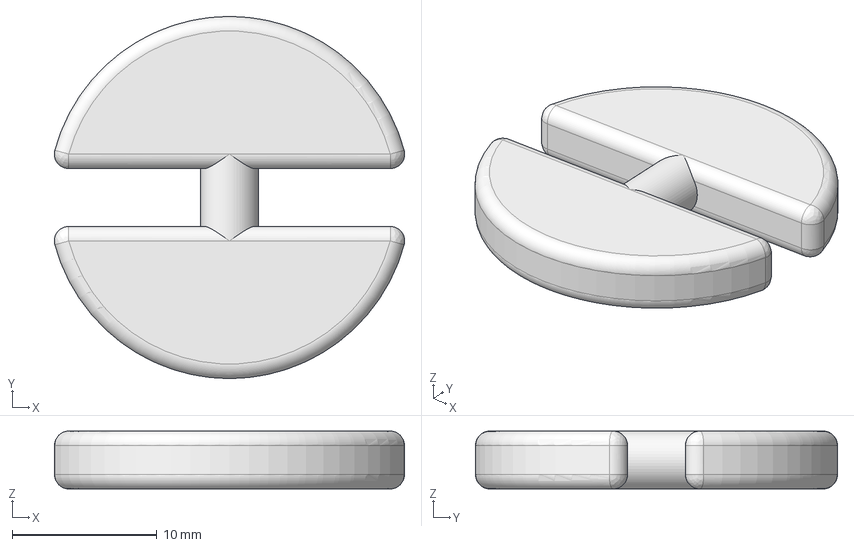
[picture p317: CAD file, 2021-02-10]
FreeCad/clip.FCStd
24.2 x 25.0 x 4.00 mm
