aspro648/KiCad/(list of files, cad)

Other CAD files:
projects/Nerf/NerfMuzzleFlash 2/design_files/project.FCStd
projects/tester/JST_XSRS/board.step
projects/Nerf/NerfMuzzleFlash 2/design_files/project1.step
projects/HW/mechanical/ServoArm-Body.stl
FreeCad/Mold2.FCStd
FreeCad/axleJig2.FCStd
FreeCad/Mold_negative6bottom.FCStd
FreeCad/stls/Urus.stl
FreeCad/stls/Urus_4mmpiece for weight.stl
FreeCad/stls/Urus_suspension4.stl
FreeCad/stls/Urus_suspension_mold.stl
FreeCad/stls/Audi_neg-5.stl
FreeCad/Bender.FCStd
FreeCad/Bender2.FCStd
FreeCad/Bender3.FCStd
FreeCad/Mold.FCStd
FreeCad/alignment jig 2 b.FCStd
FreeCad/stls/Audi_neg-5short.stl
FreeCad/stls/Bender.stl
FreeCad/stls/Bender3_10.stl
FreeCad/stls/Boss302_5mm.stl
FreeCad/stls/Boss302_negative.stl
FreeCad/stls/Boss302short_negative.stl
FreeCad/stls/Chassis.stl
FreeCad/stls/Chassis_negative.stl
FreeCad/stls/Demon_neg-5.stl
FreeCad/stls/Demon_neg-5short.stl
FreeCad/stls/Demon_short_5mm.stl
FreeCad/stls/Imapla_negative.stl
FreeCad/stls/Impala.stl
FreeCad/stls/Rocket_stand_17mm_dia.stl
FreeCad/stls/Uris_negative.stl
FreeCad/stls/Urus_neg-5.stl
FreeCad/stls/Urus_neg-5short.stl
FreeCad/stls/Wheel.stl
FreeCad/stls/Wheel2.stl
FreeCad/stls/axleJig3.stl
FreeCad/stls/axlejig.stl
FreeCad/stls/axlejig2.stl
FreeCad/stls/matrix_weight.stl
FreeCad/stls/pizza.stl
FreeCad/stls/pizza2.stl
FreeCad/stls/pizza3.stl
FreeCad/stls/pizza5.stl
FreeCad/weight_20x25_taper.FCStd
projects/HW/mechanical/Display/DisplayBack.stl
projects/HW/mechanical/Display/DisplayBase.stl
projects/HW/mechanical/Display/DisplayEnclosure.stl
projects/HW/mechanical/ServoArm.stl
projects/HW/mechanical/ServoBase.stl
projects/HW/mechanical/standoff.stl
projects/LEGO/design_files_attiny826_LEDs/3D/1050170001.stp
projects/LEGO/design_files_attiny826_LEDs/3D/530470210--3DModel-STEP-231308.STEP
projects/LEGO/design_files_attiny826_LEDs/3D/530470310--3DModel-STEP-231308.STEP
projects/LEGO/design_files_attiny826_LEDs/3D/JS102011SAQN--3DModel-Eagle-1.STEP
projects/Nerf/Ardu RapidStrike/design_files Stryfe V00/project.stl
projects/Nerf/Ardu RapidStrike/design_files V02/project.stl
projects/Nerf/ArduStryfe/archive/design_files MOSFET R0/Arduino.stl
projects/Nerf/ArduStryfe/archive/design_files MOSFET R0/MOSFET.stl
projects/Nerf/ArduStryfe/archive/design_files R0/Arduino.stl
projects/Nerf/ArduStryfe/archive/design_files R0/MOSFET.stl
projects/Nerf/ArduStryfe/archive/design_files Stryfe V00/project.stl
projects/Nerf/ArduStryfe/archive/design_files V01 MOSFET/Arduino.stl
projects/Nerf/ArduStryfe/archive/design_files V01/Arduino.stl
projects/Nerf/ArduStryfe/archive/design_files V01/MOSFET.stl
projects/Nerf/ArduStryfe/archive/design_files V02/project.stl
projects/Payload - Copy/svg2mod/edge_cuts2.dxf
projects/Payload - Copy/svg2mod/edge_cuts3.dxf
projects/tester/JST_XSRS/board.FCStd
projects/tester/JST_XSRS/board.stl
projects/tester/RPB/Board/3D/M2_5X6MM.step
projects/tester/UCT3/design_files26/3D/M2_5X6MM.step
projects/tester/UCT3/design_files_card 254 pitch/3D/M80-5T11042MC.stp
projects/tester/UCT3/design_files_card Gecko/3D/M80-5T11042MC.stp
projects/tester/UCT3/design_files_card Molex PicoBlade/3D/53047-0510.stp
projects/tester/UCT3/design_files_card Molex PicoBlade/3D/53047-1510.stp
projects/tester/UCT3/design_files_card Molex PicoBlade/3D/M80-5T11042MC.stp
projects/tester/UCT3/design_files_card Vectornav/3D/M80-5T11042MC.stp
projects/tester/UCT3/design_files_card template/3D/M80-5T11042MC.stp
