aspro648/KiCad/projects/ICanSolder SAO/readme.md

Introduction
============

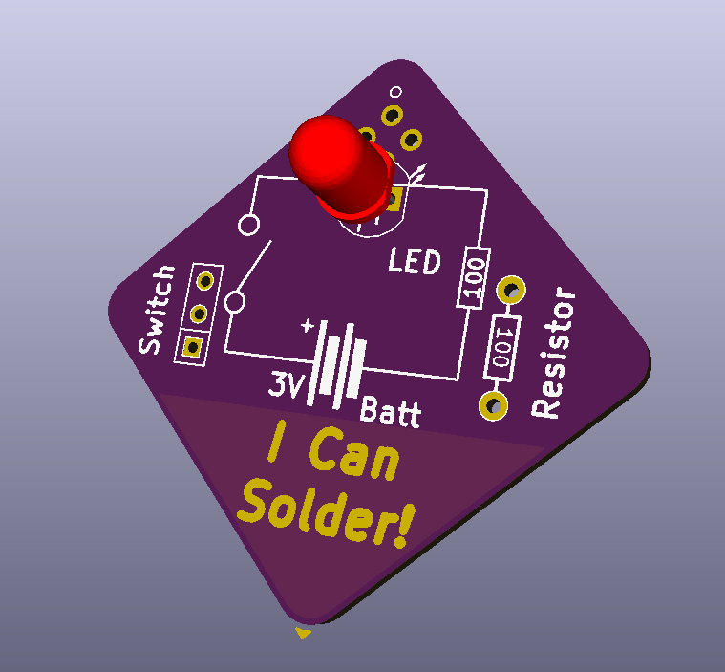
[picture p319: projects/ICanSolder SAO/images/project.png]
ICanSolder
 

An "I Can Solder" SAO board. Power provided by mother board.  Don't blame me.  Blame Benchoff: https://hackaday.io/project/52950-defcon-26-shitty-add-ons.

Bill Of Materials
=================
  
- 1 ea. Perfect Purple PCB from OSH Park
- 1 ea., SW1 SWITCH SLIDE SPDT, C&K JS102011SAQN, https://www.digikey.com/short/j58qp5
- 1 ea., D1 330 Ohm 1/8w resistor, Stackpole CF18JT330R, http://www.digikey.com/short/7zzrbn
- 1 ea., R1 5mm Red LED, SunLED XLUR12D, http://www.digikey.com/short/7hrv5j
- 1 ea., 4-POS Female header (for motherboard), https://www.digikey.com/short/jfh48j
- 1 ea., 4-POS Male header (for SAO), https://www.digikey.com/short/jfh48r

Design Files
============
This project is designed using Open Source [KiCad](http://kicad-pcb.org/). Design files are located in the [design_files](design_files/) folder.  

Firmware
========
None

Assembly Instructions
=====================
If you can't figure this out, I can't help you.

License
=======
[Attribution-ShareAlike 3.0 United States (CC BY-SA 3.0 US)](https://creativecommons.org/licenses/by-sa/3.0/us/)

You are free to:

- Share — copy and redistribute the material in any medium or format
- Adapt — remix, transform, and build upon the material

Under the following terms:

- Attribution — You must give appropriate credit, provide a link to the license, and indicate if changes were made. You may do so in any reasonable manner, but not in any way that suggests the licensor endorses you or your use.
- ShareAlike — If you remix, transform, or build upon the material, you must distribute your contributions under the same license as the original.
