aspro648/KiCad/Inkscape/63Chevy2/decals_print.png

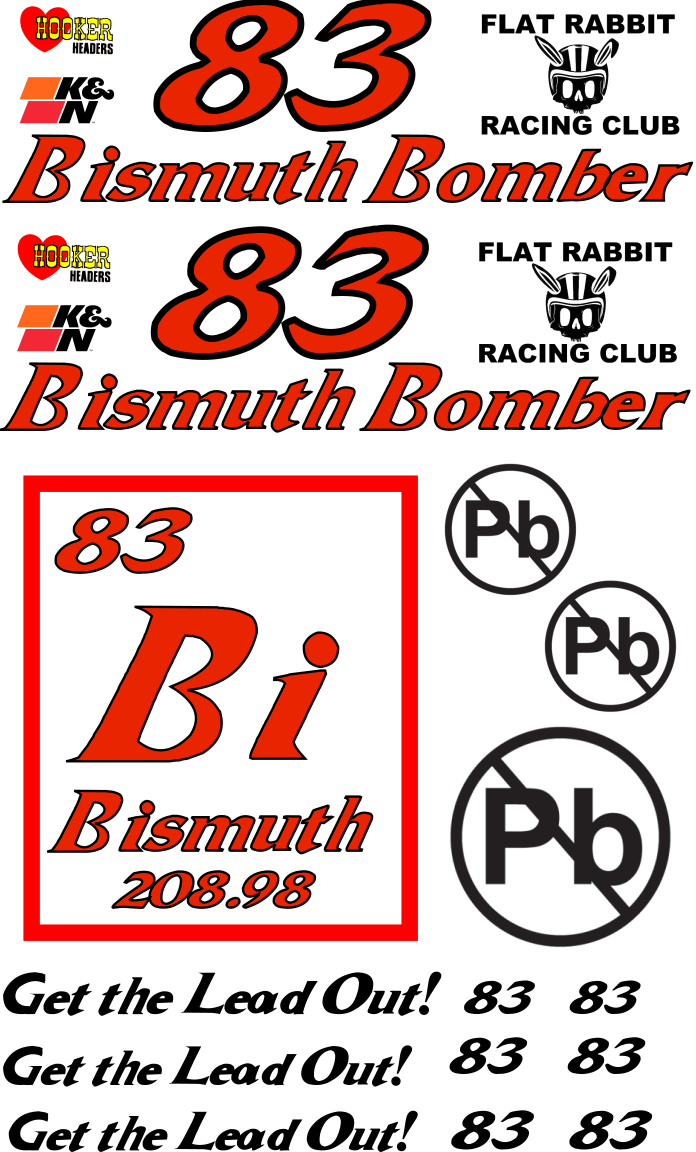
Inkscape/63Chevy2/decals_print.png
