aspro648/KiCad/Inkscape/Honda Civic Si/decals_print.png

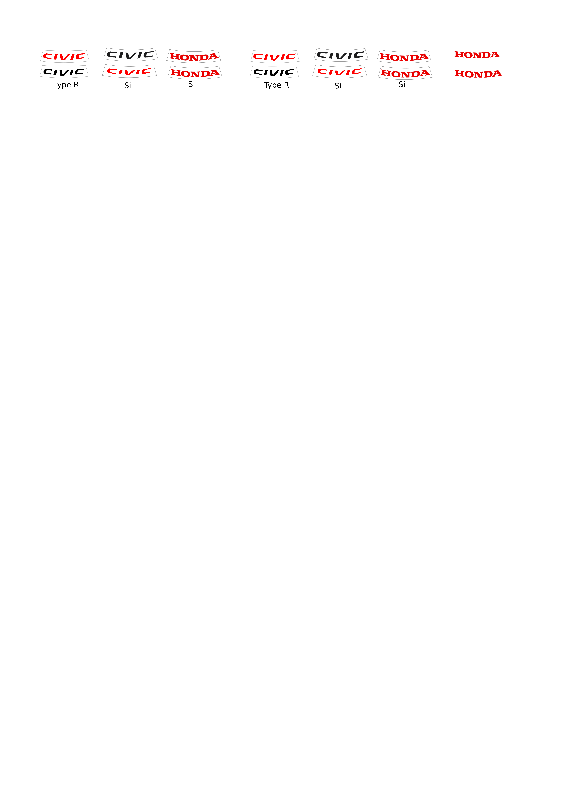
Inkscape/Honda Civic Si/decals_print.png
