aspro648/KiCad/Inkscape/MakersBoxMotors.png

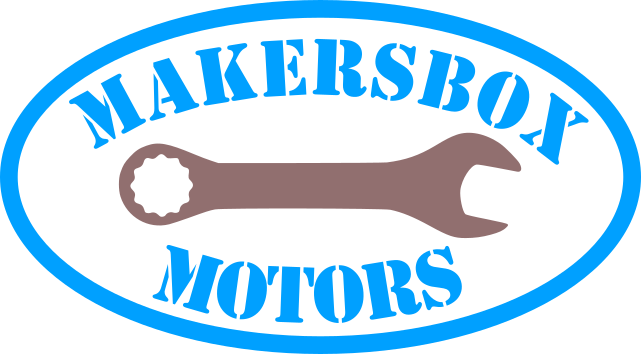
Inkscape/MakersBoxMotors.png
