aspro648/KiCad/Inkscape/Stinger/decals_print.png

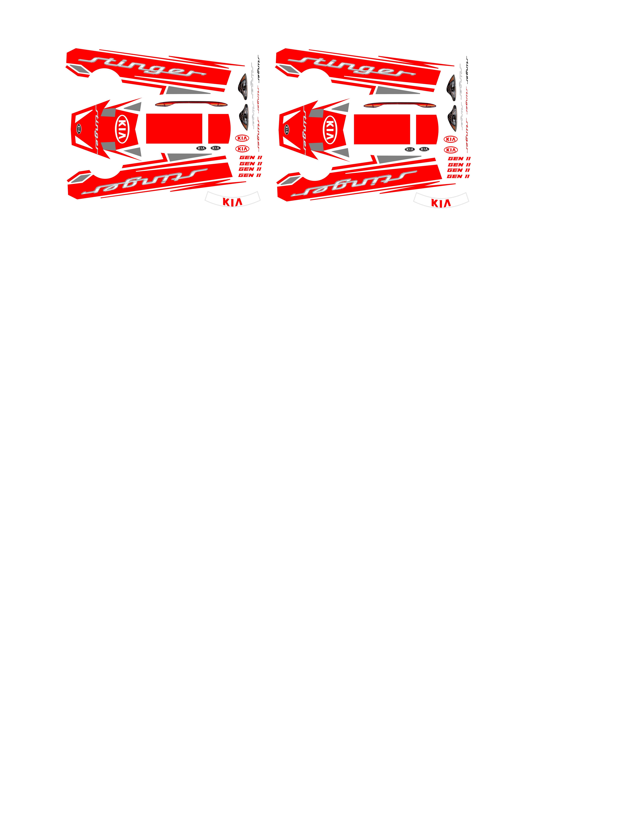
Inkscape/Stinger/decals_print.png
