aspro648/KiCad/projects/Attiny/Attiny84SolderChallenge/Docs/Geek Spinner label.png

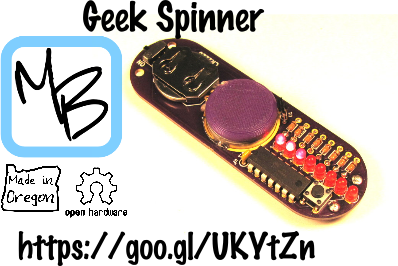
projects/Attiny/Attiny84SolderChallenge/Docs/Geek Spinner label.png
