aspro648/KiCad/projects/Attiny/Attiny84SolderChallenge/Docs/spinner label.png

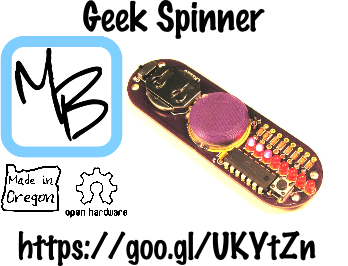
projects/Attiny/Attiny84SolderChallenge/Docs/spinner label.png
