aspro648/KiCad/projects/Attiny/Attiny84SolderChallenge/images/PinSelections.png

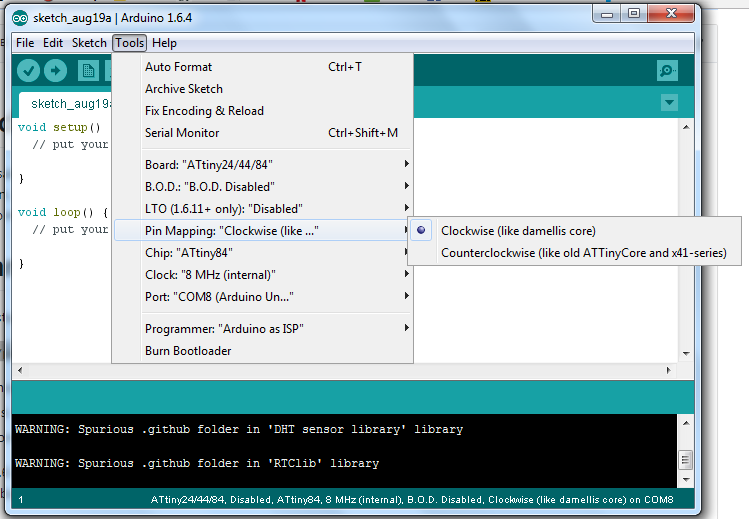
projects/Attiny/Attiny84SolderChallenge/images/PinSelections.png
