aspro648/KiCad/projects/Attiny/Attiny85ChallengeHackaday2020/images/Hackaday_assembled.JPG

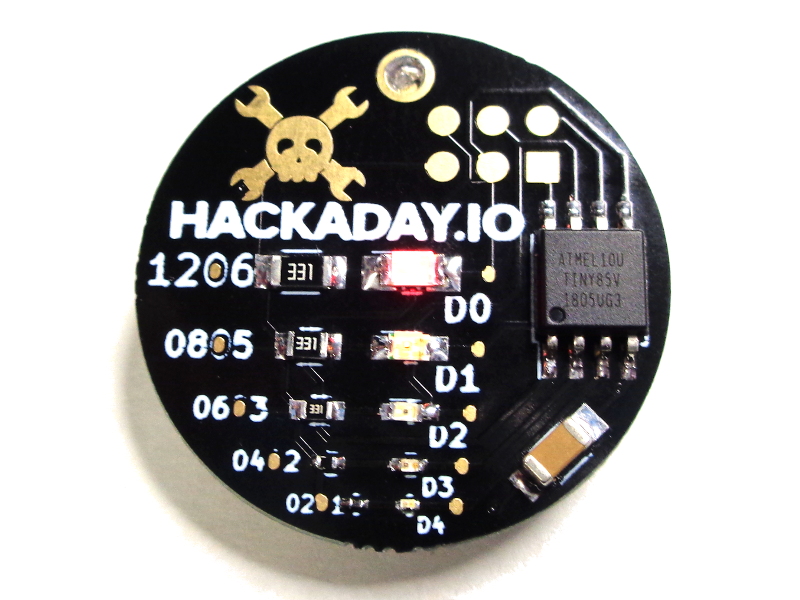
projects/Attiny/Attiny85ChallengeHackaday2020/images/Hackaday_assembled.JPG
