aspro648/KiCad/projects/Attiny/Attiny85ChallengeTindie/images/Tindie_assembled.JPG

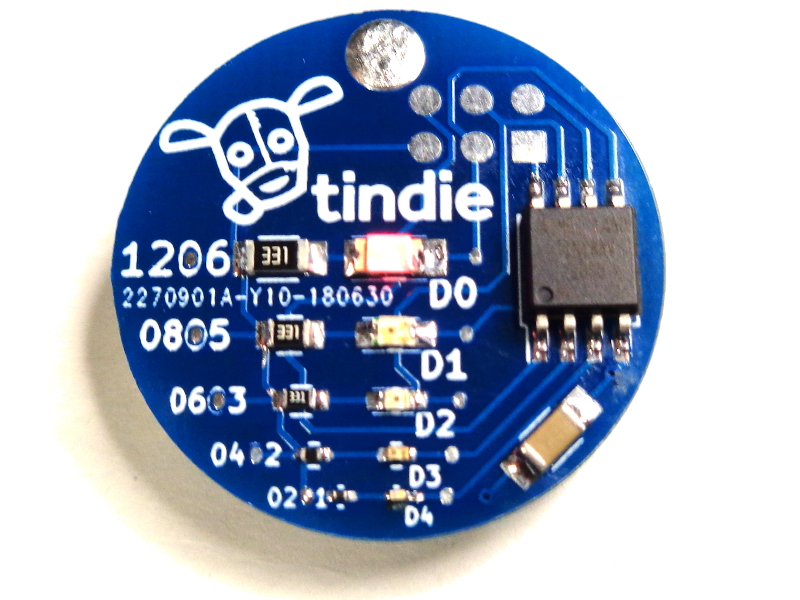
projects/Attiny/Attiny85ChallengeTindie/images/Tindie_assembled.JPG
