aspro648/KiCad/projects/buzz/soldering_sunday2.bmp

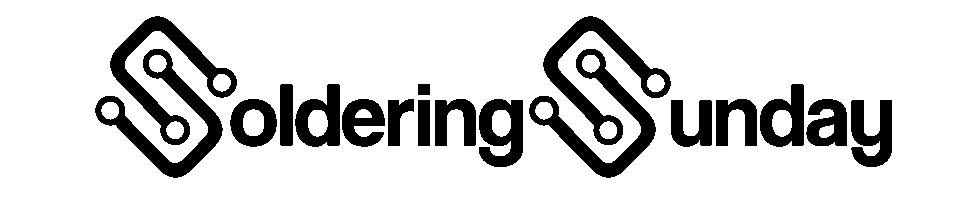
projects/buzz/soldering_sunday2.bmp
