aspro648/KiCad/projects/buzz/soldering_sunday.png

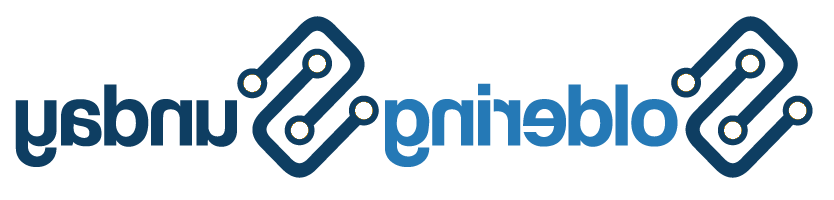
projects/buzz/soldering_sunday.png
