aspro648/KiCad/projects/buzz/soldering_sunday_final.png

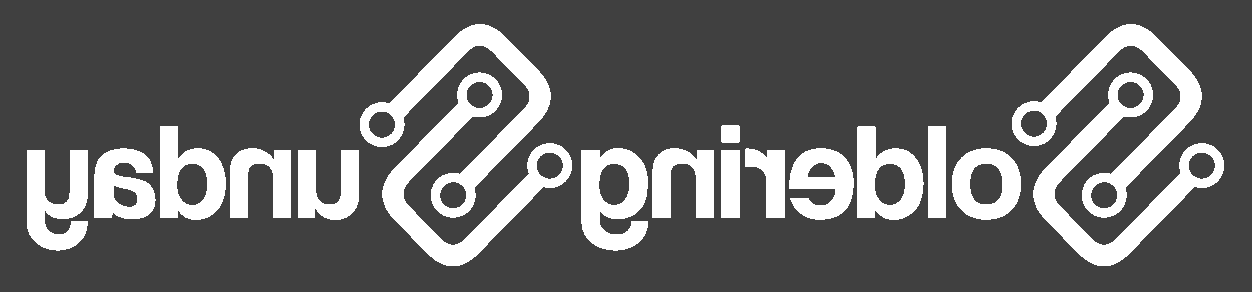
projects/buzz/soldering_sunday_final.png
