aspro648/KiCad/projects/ICanSolder SAO/docs/ICanSolderLabel.png

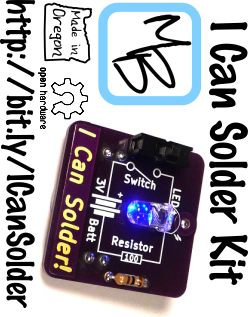
projects/ICanSolder SAO/docs/ICanSolderLabel.png
