aspro648/KiCad/projects/ICanSolder SAO/images/base.sch2.png

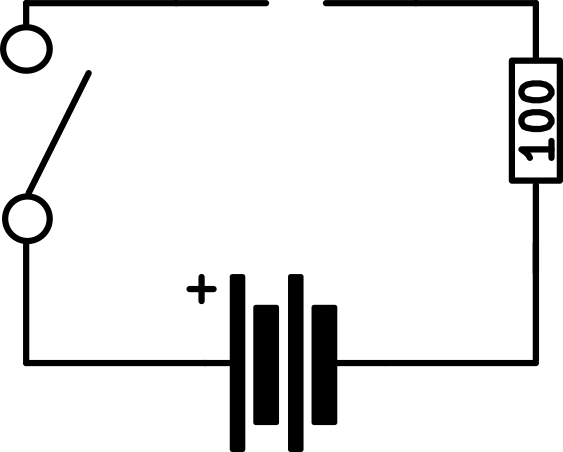
projects/ICanSolder SAO/images/base.sch2.png
