aspro648/KiCad/projects/ICanSolder SAO/images/base.sch3.png

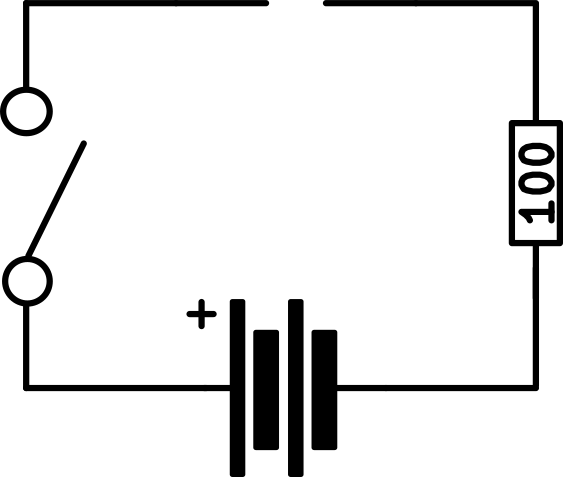
projects/ICanSolder SAO/images/base.sch3.png
