aspro648/KiCad/projects/ICanSolder SAO/images/project.JPG

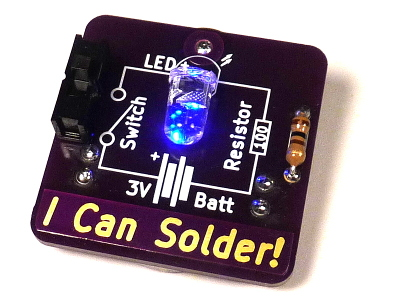
projects/ICanSolder SAO/images/project.JPG
