aspro648/KiCad/projects/ICanSolder SAO/images/project.sch.png

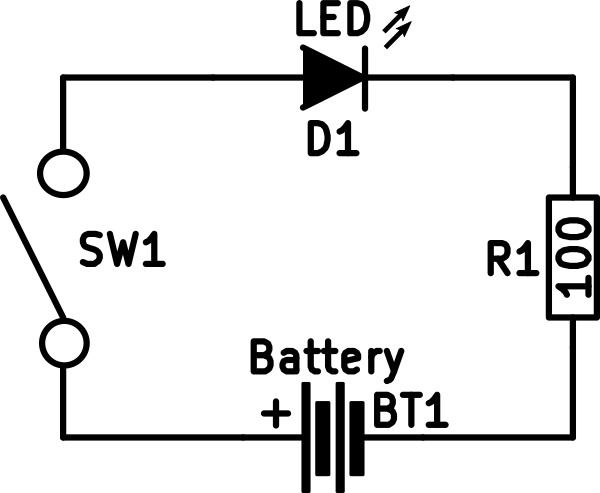
projects/ICanSolder SAO/images/project.sch.png
