aspro648/KiCad/projects/ICanSolder/docs/bulk.JPG

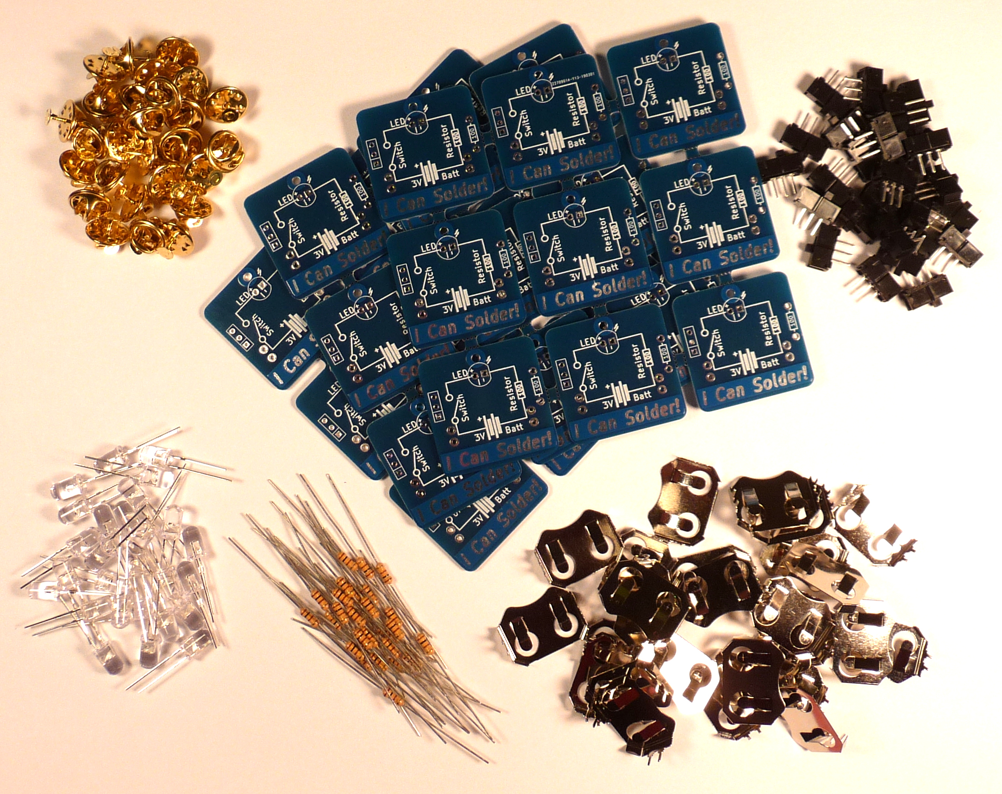
projects/ICanSolder/docs/bulk.JPG
