aspro648/KiCad/projects/ICanSolder/docs/ICanSolderLabel2.png

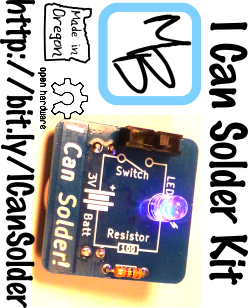
projects/ICanSolder/docs/ICanSolderLabel2.png
