aspro648/KiCad/projects/ICanSolder/images/Blue.png

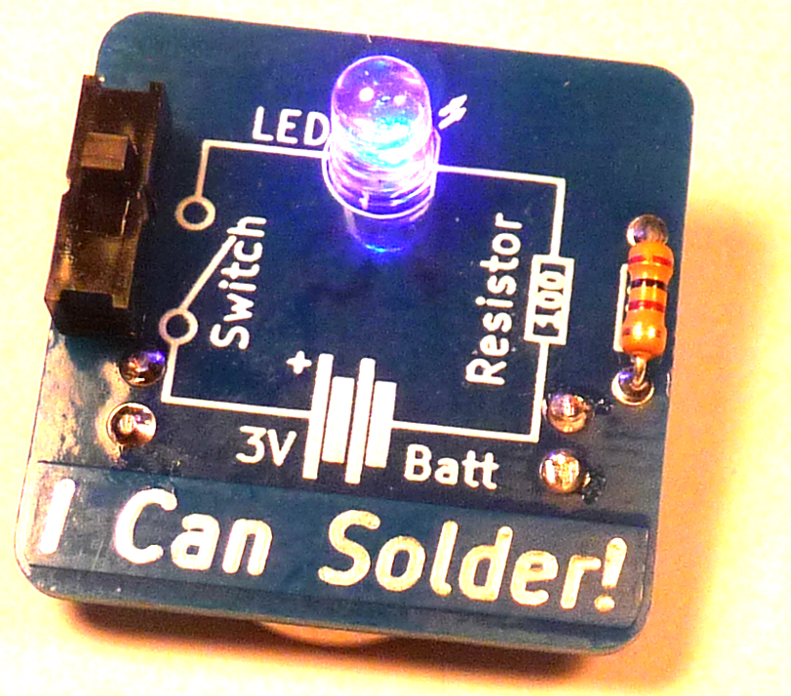
projects/ICanSolder/images/Blue.png
