aspro648/KiCad/projects/ICanSolder/images/P1080850.JPG

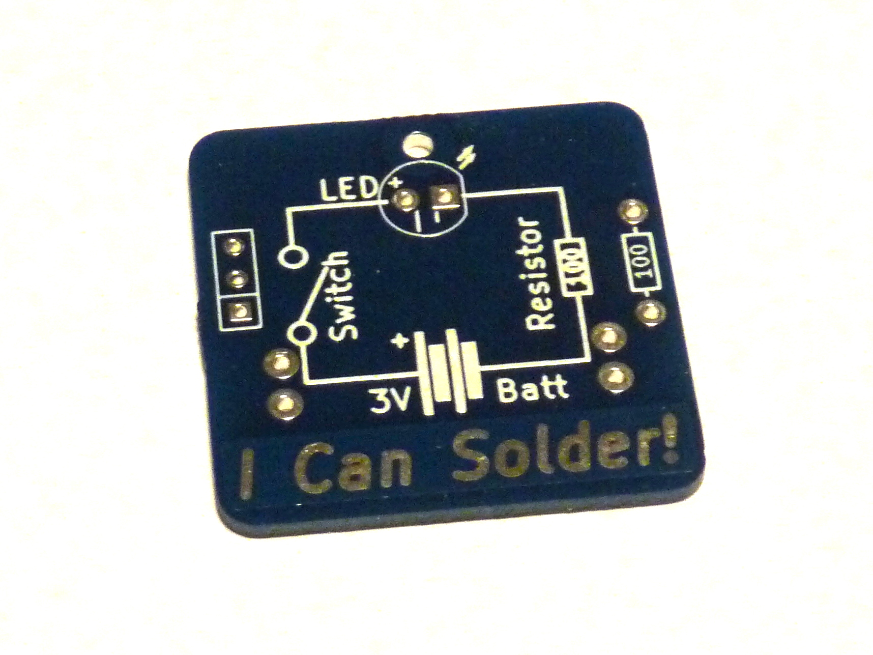
projects/ICanSolder/images/P1080850.JPG
