aspro648/KiCad/projects/ICanSolder/images/Troop7531.JPG

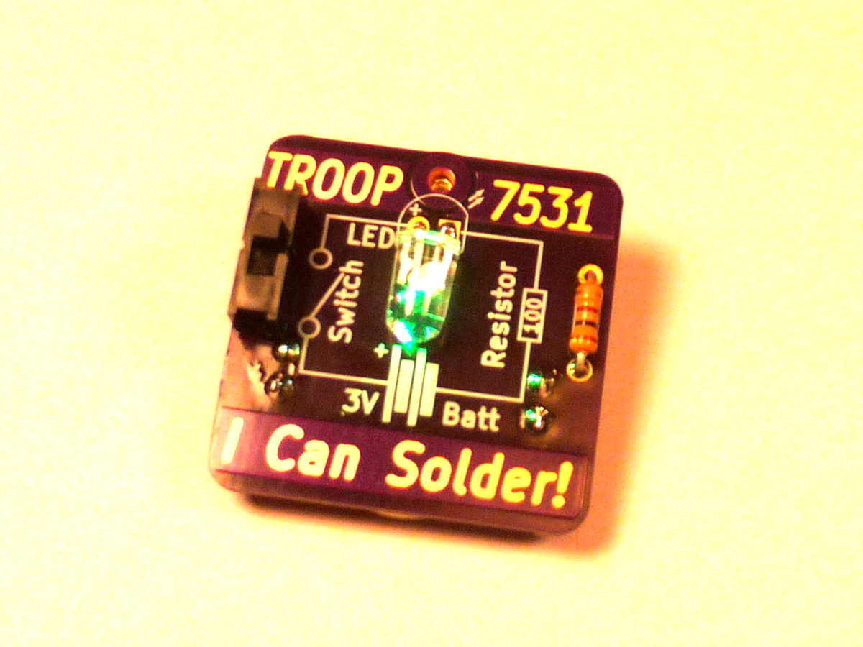
projects/ICanSolder/images/Troop7531.JPG
