aspro648/KiCad/projects/JouleThief/Images/06_solder_coil.png

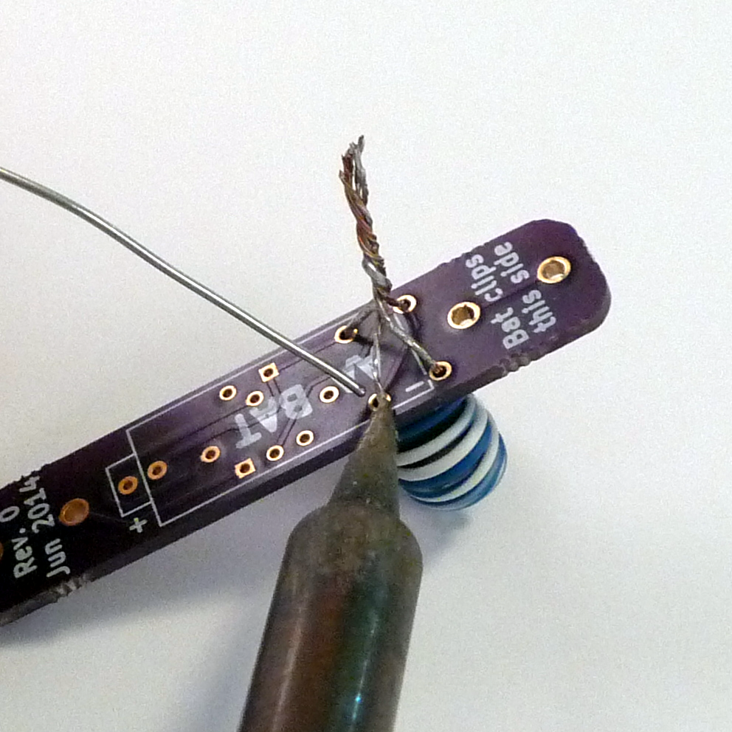
projects/JouleThief/Images/06_solder_coil.png
