aspro648/KiCad/projects/OSH Park I Can Solder/images/project.png

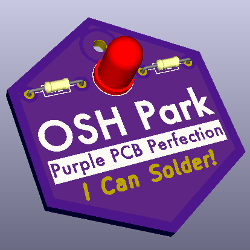
projects/OSH Park I Can Solder/images/project.png
