aspro648/KiCad/projects/Nerf/ArduStryfe/experiment.xlsx

Sheet: summary
 | Duracell Coppertop |  |  |  | Panasonic eneloop BK-3MCCA 1900 mAh |  |  |  | Coolook LiFePO4 (IFR) LFP 600mAh |  |  |  | NiteCore LiMn2O4 (IMR) 650mAh |  |  |  | Zippy 2S 45C 1000 mAh
Battery | AA x 4 | AA x 4 | AA x 4 | AA x 4 | NiMH x 4 | NiMH x 4 | NiMH x 4 | NiMH x 4 | IFR x 2 | IFR x 2 | IFR x 2 | IFR x 2 | IMR x 2 | IMR x 2 | IMR x 2 | IMR x2 | 2S LiPo | 2S LiPo | 2S LiPo | 2S LiPo
Motor Control | Stock switch | Stock Switch | MOSFET | MOSFET | Stock switch | Stock Switch | MOSFET | MOSFET | Stock switch | Stock Switch | MOSFET | MOSFET | Stock switch | Stock Switch | MOSFET | MOSFET | Stock switch | Stock Switch | MOSFET | MOSFET
Wiring | Stock 20 AWG | Stock 20 AWG | 18 AWG | 18 AWG | Stock 20 AWG | Stock 20 AWG | 18 AWG | 18 AWG | Stock 20 AWG | Stock 20 AWG | 18 AWG | 18 AWG | Stock 20 AWG | Stock 20 AWG | 18 AWG | 18 AWG | Stock 20 AWG | Stock 20 AWG | 18 AWG | 18 AWG
Fuse | Stock 1.6 A | None | 2.5A | None | Stock 1.6 A | None | 2.5A | None | Stock 1.6 A | None | 2.5A | None | Stock 1.6 A | None | 2.5A | None | Stock 1.6 A | None | 2.5A | None
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
