aspro648/KiCad/projects/Attiny/Attiny84SolderChallenge/images/solderTest.jpg

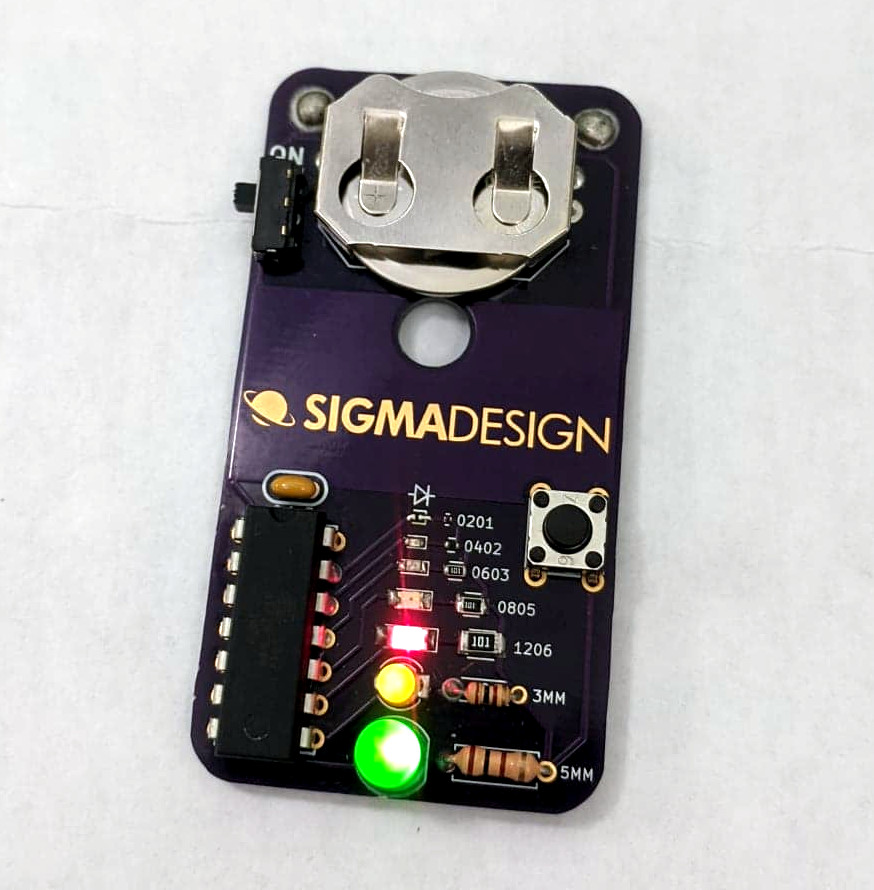
projects/Attiny/Attiny84SolderChallenge/images/solderTest.jpg
