aspro648/KiCad/projects/tester/B003-5002/B003-5002.png

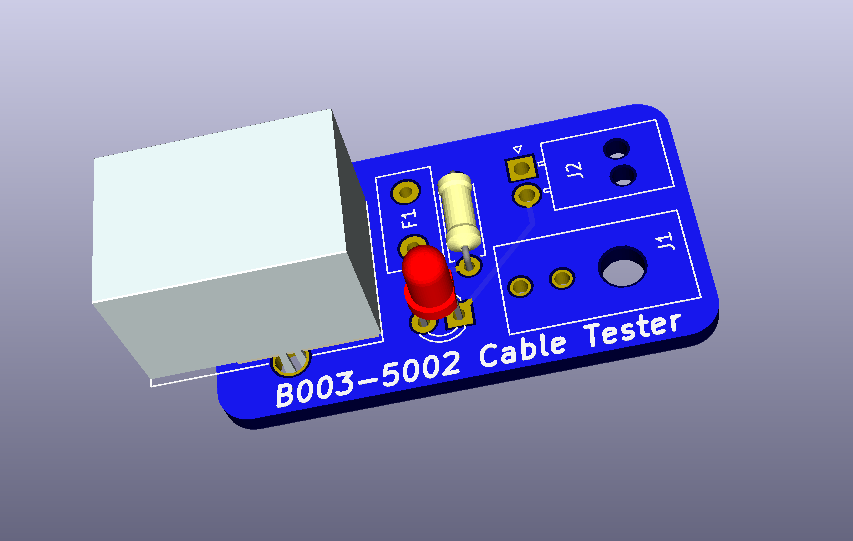
projects/tester/B003-5002/B003-5002.png
