aspro648/KiCad/projects/tester/H047-5004/H047-5004.png

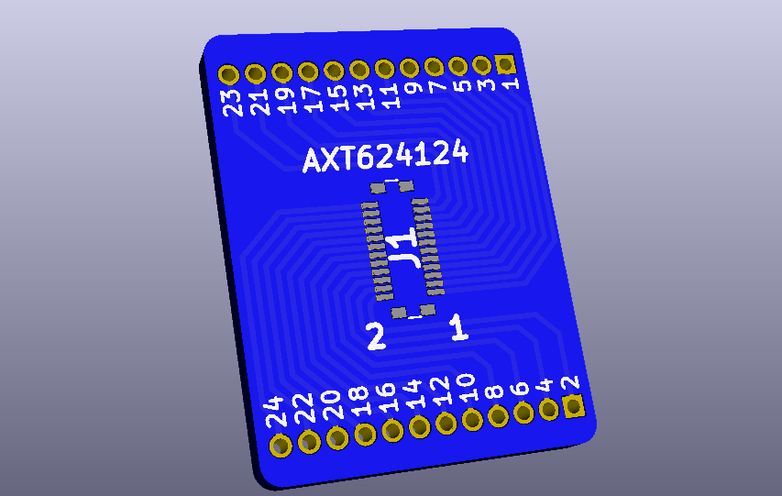
projects/tester/H047-5004/H047-5004.png
