aspro648/KiCad/projects/tester/JST_XSRS/board.png

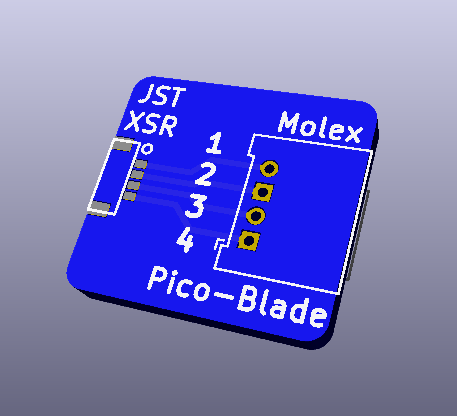
projects/tester/JST_XSRS/board.png
