aspro648/KiCad/projects/tester/JST_XSRS/board_back.png

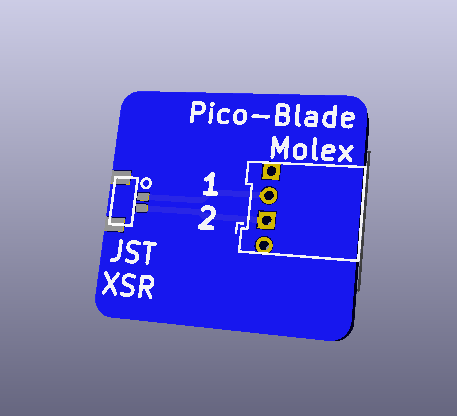
projects/tester/JST_XSRS/board_back.png
