aspro648/KiCad/projects/Attiny/Attiny85Challenge2/images/troubleshooting2.png

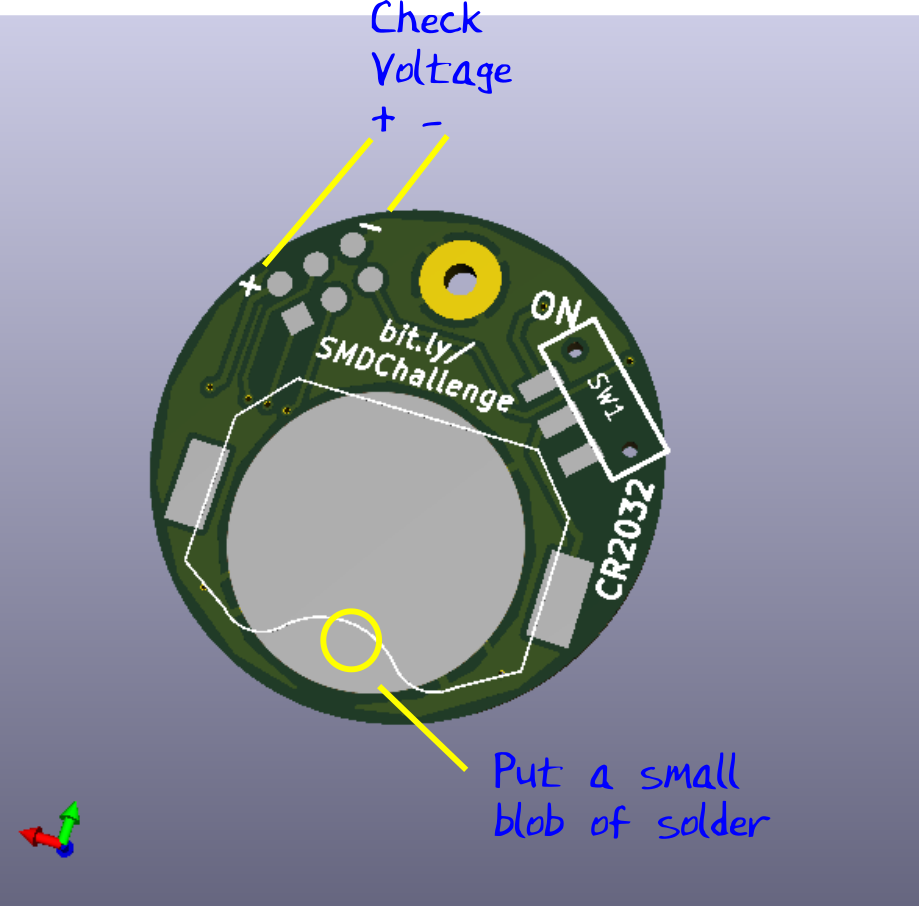
projects/Attiny/Attiny85Challenge2/images/troubleshooting2.png
