aspro648/KiCad/projects/Attiny/Attiny85Challenge2/images/troubleshooting.png

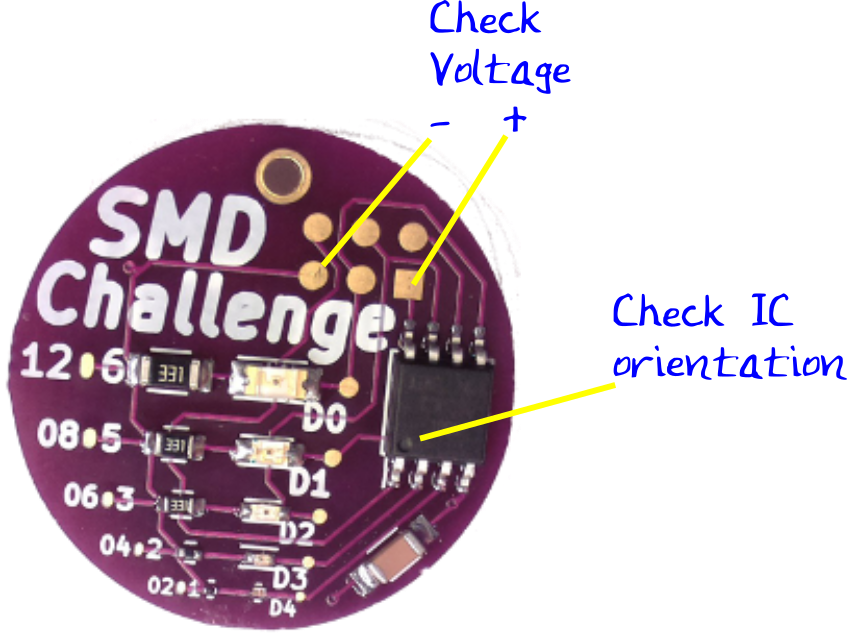
projects/Attiny/Attiny85Challenge2/images/troubleshooting.png
