aspro648/KiCad/projects/JouleThief/Images/Troubleshooter.jpg

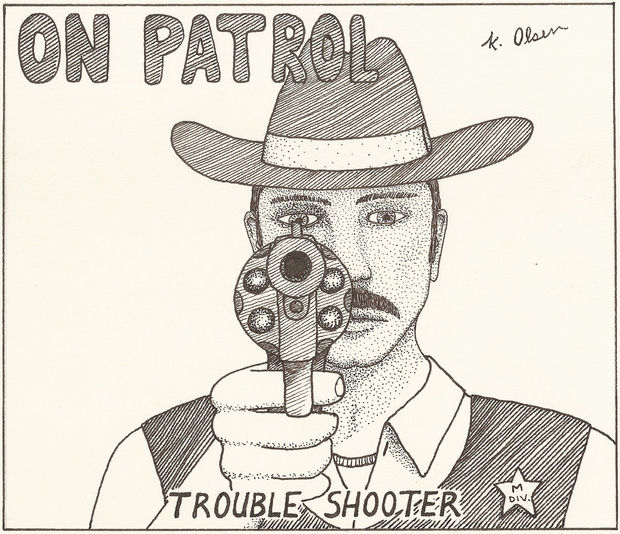
projects/JouleThief/Images/Troubleshooter.jpg
