aspro648/KiCad/(threads)

Thread 2 (2018-07-03):

Programming

Craftplorer, 2018-07-03:
Hi,
how did you program the attiny in qnf package?

aspro648, 2018-07-03:
I bought a pretty spendy (~$80USD) QFN20 socket adapter so I could program them before soldering (for the kits).  I also use my Arduino ISP shield (https://www.tindie.com/products/MakersBox/yet-another-programming-shield).  You can, as you figured out, program it through the ISP header after it is soldered.  For that, I use a pogo adapter with the ISP shield: https://www.tindie.com/products/nsayer/avr-isp-pogo-adapter-kit

Closed 2018-07-03.

Thread 3 (2025-02-13):

Attiny84SpinnerTHD_R3 firmware has incorrect pin assignments

The--Captain, 2025-02-13:
projects/Attiny/Attiny84SpinnerTHD_R3/firmaware/SMD_spinner_THT_R21/SMD_spinner_THT_R21.ino

The rest of the pin assignments in this firmware have been updated to clockwise enumeration, but it appears the tactile button and hall sensor pins were overlooked:

Line 68 should read:

byte magPin = 8;     // PB2/INTO Hall effect sensor, pulled-up, goes low when magnet passes

Line 69 should read:

byte buttonPin = 10;  // PB0 Tactile button, pulled up

I do appreciate this updated firmware.  The version linked from Instructables with CCW enumeration caused my tactile button to malfunction, but this newer firmware makes everything work perfectly (once lines 68 and 69 are updated)
