aspro648/KiCad/projects/buzz/buzz_schematic.pdf

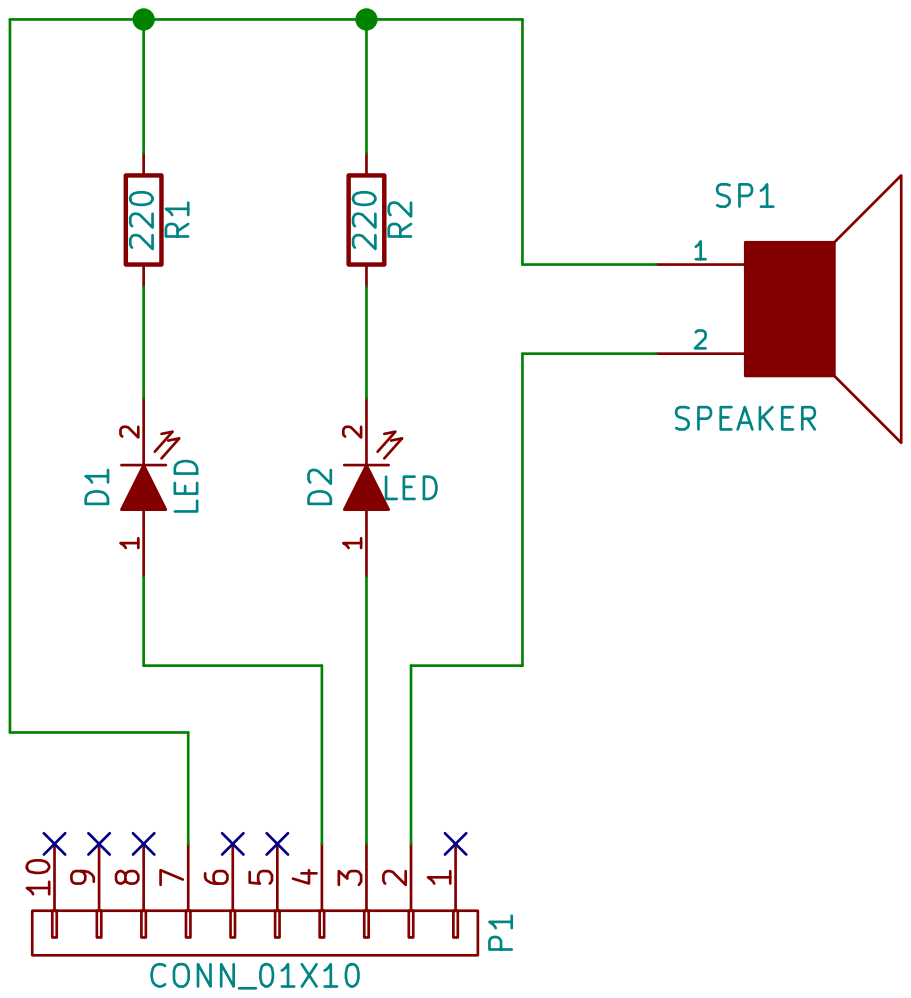
[picture p354: page 1]

File: buzz.sch Sheet: / Soldering Sunday
