aspro648/KiCad/projects/LEGO/design_files_attiny826_LEDs/schematic.pdf

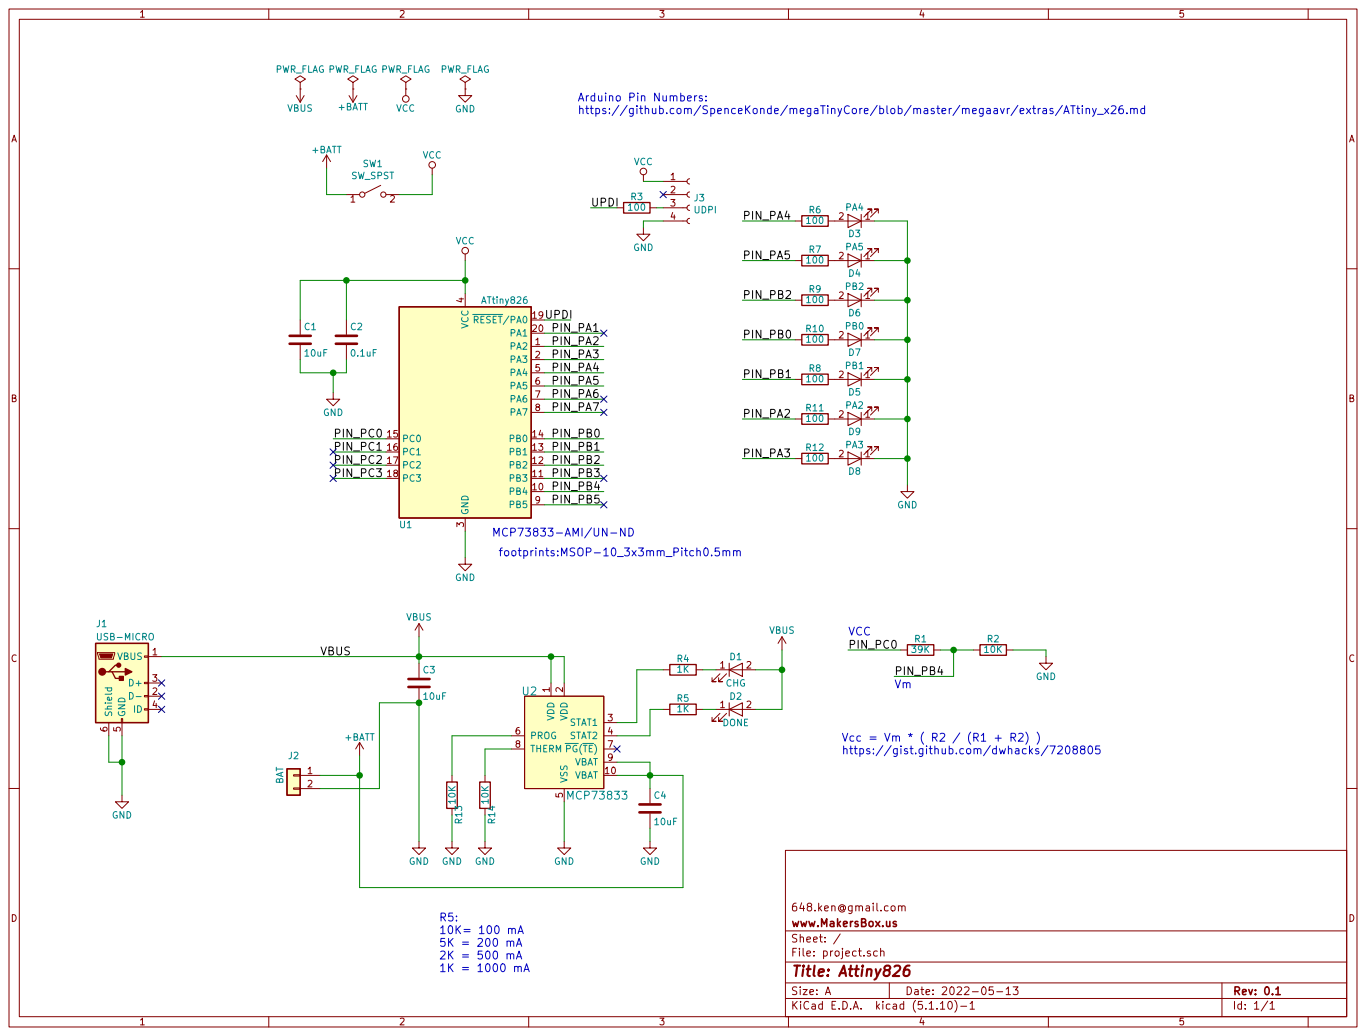
[picture p355: page 1]

Arduino Pin Numbers: https://github.com/SpenceKonde/megaTinyCore/blob/master/megaavr/extras/ATtiny_x26.md Vm

Vcc = Vm * ( R2 / (R1 + R2) )
https://gist.github.com/dwhacks/7208805

File: project.sch Sheet: / www.MakersBox.us
