aspro648/KiCad/projects/LEGO/design_files_attiny826_LiPo badge/schematic.pdf

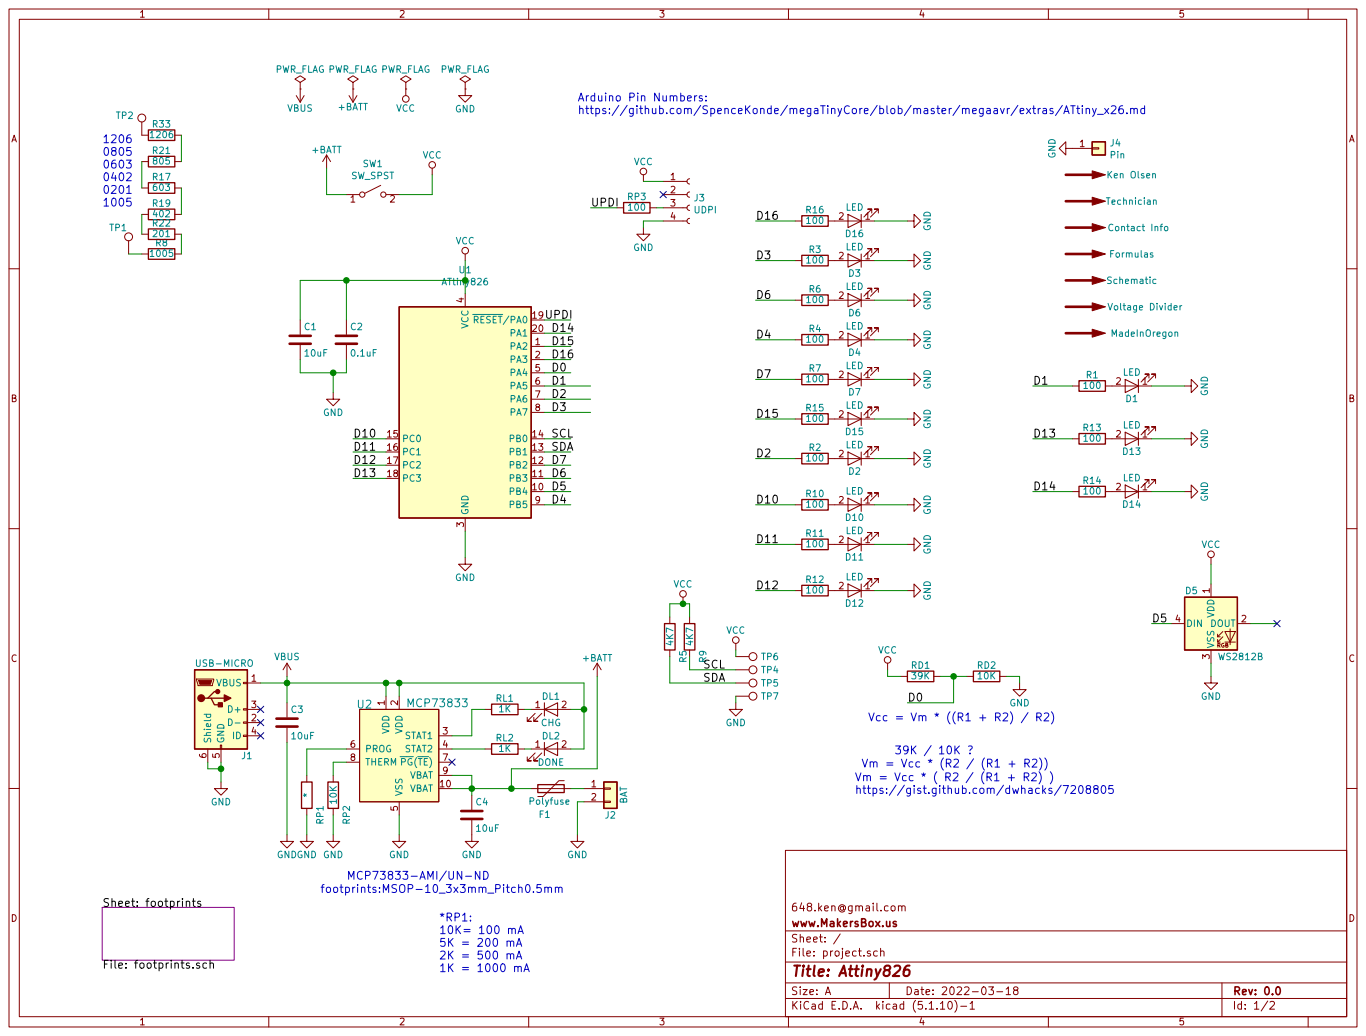
[picture p356: page 1]

Arduino Pin Numbers: https://github.com/SpenceKonde/megaTinyCore/blob/master/megaavr/extras/ATtiny_x26.md

100 GND
Ken Olsen Technician Contact Info Formulas Schematic Voltage Divider

5 PROG 6 PG(TE) 7 THERM 8 VBAT 9 U2 MCP73833
10uF VDD

Vm = Vcc * ( R2 / (R1 + R2) )
https://gist.github.com/dwhacks/7208805

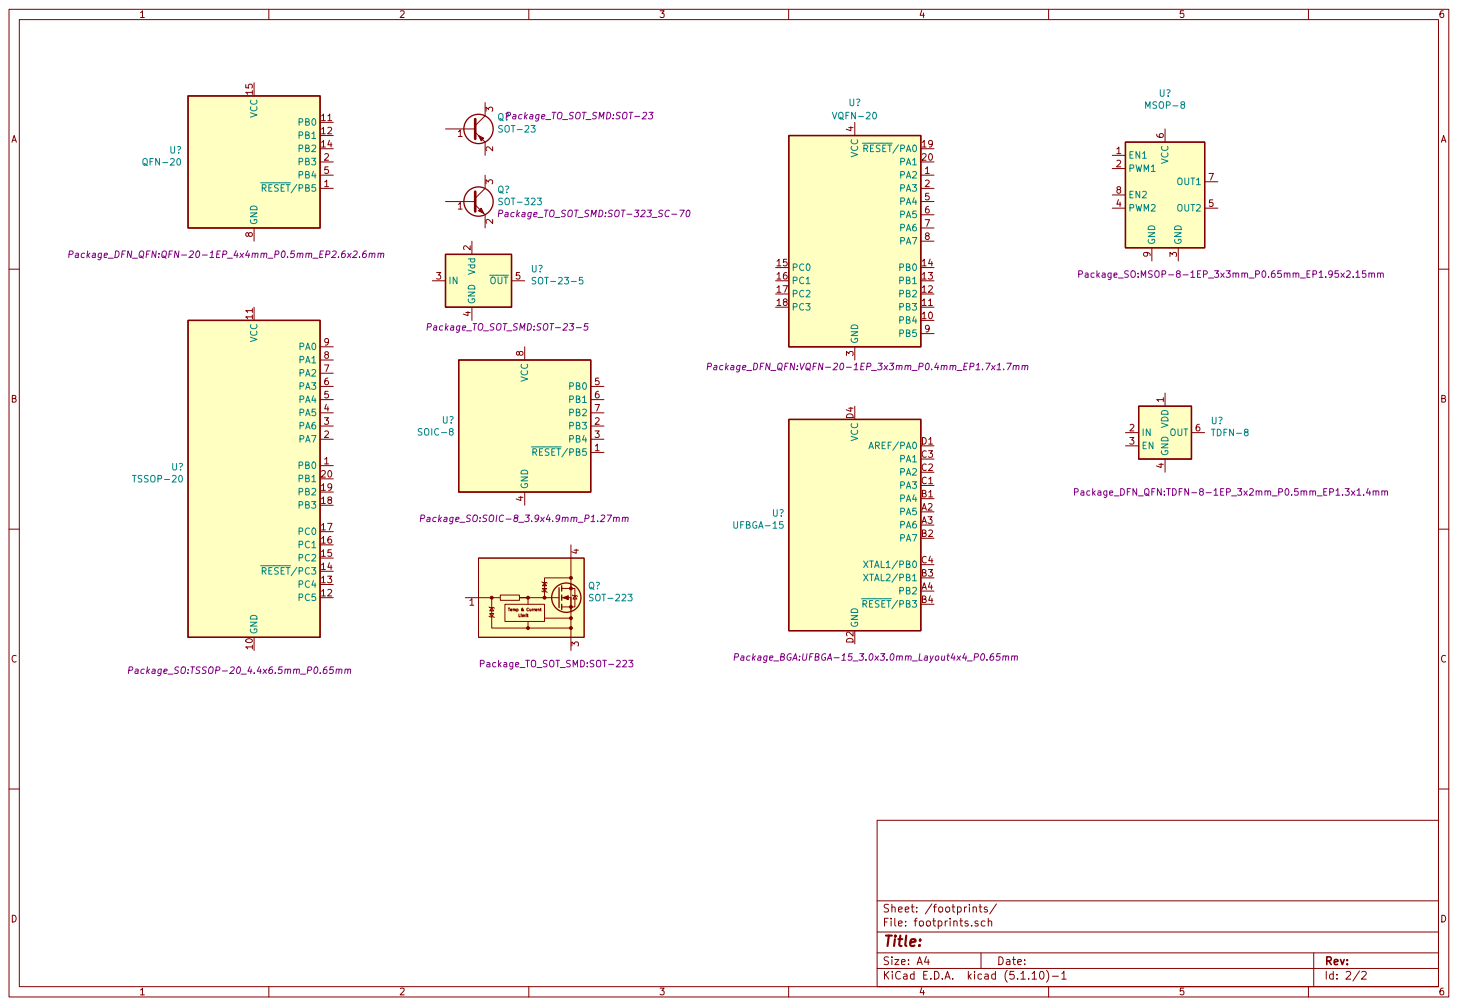
[picture p357: page 2]
