aspro648/KiCad/projects/Altimeter/docs/20830_Vacuum_Sensor_Schematic.pdf

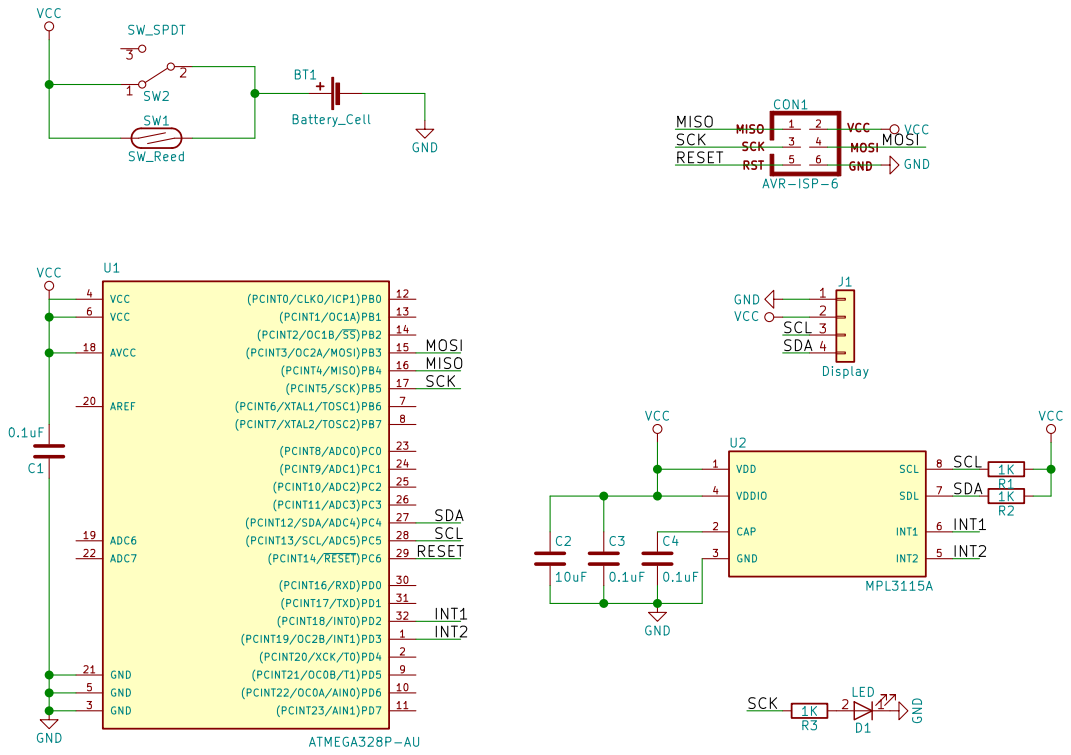
[picture p358: page 1]

File: project.sch Sheet: / Sigma Design

Id: 1/1 Title: Vacuum Sensor
