aspro648/KiCad/projects/Attiny/Attiny85HeartSMD/design_files/schematic.pdf

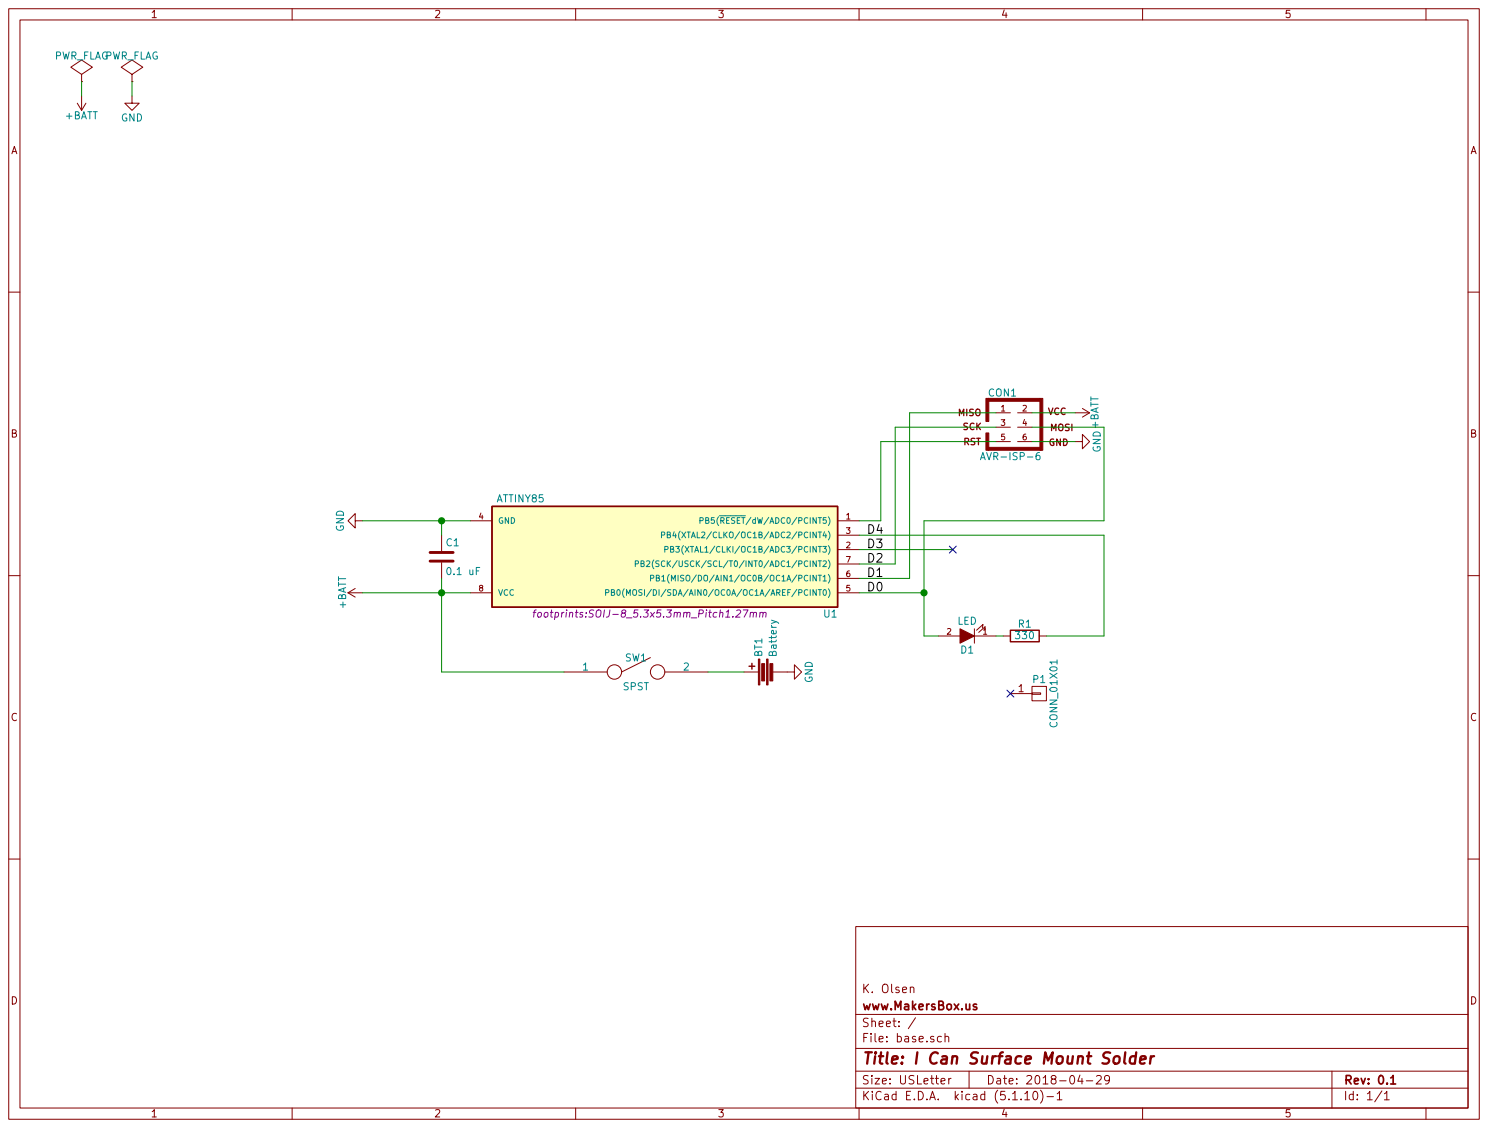
[picture p359: page 1]

Id: 1/1 Title: I Can Surface Mount Solder File: base.sch Sheet: / www.MakersBox.us K. Olsen GND
