aspro648/KiCad/projects/ICanSolder/iTeam I Can Solder/docs/project.pdf

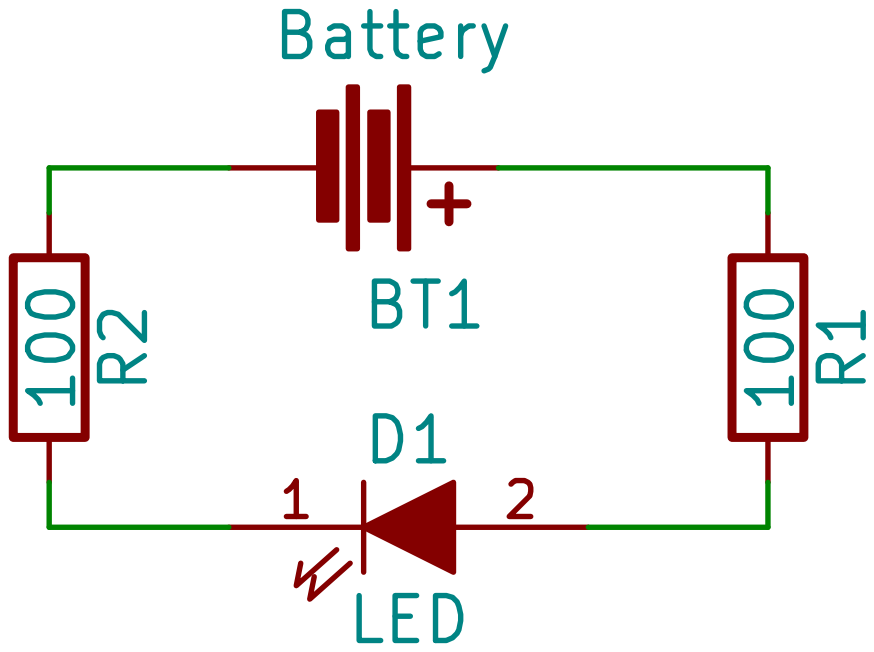
[picture p360: page 1]

File: project.sch Sheet: / www.MakersBox.us K. Olsen100 R1BT1 Battery

Id: 1/1 Title: OSH Park I Can Solder Badge
