aspro648/KiCad/projects/brain_board LEGO/base.pdf

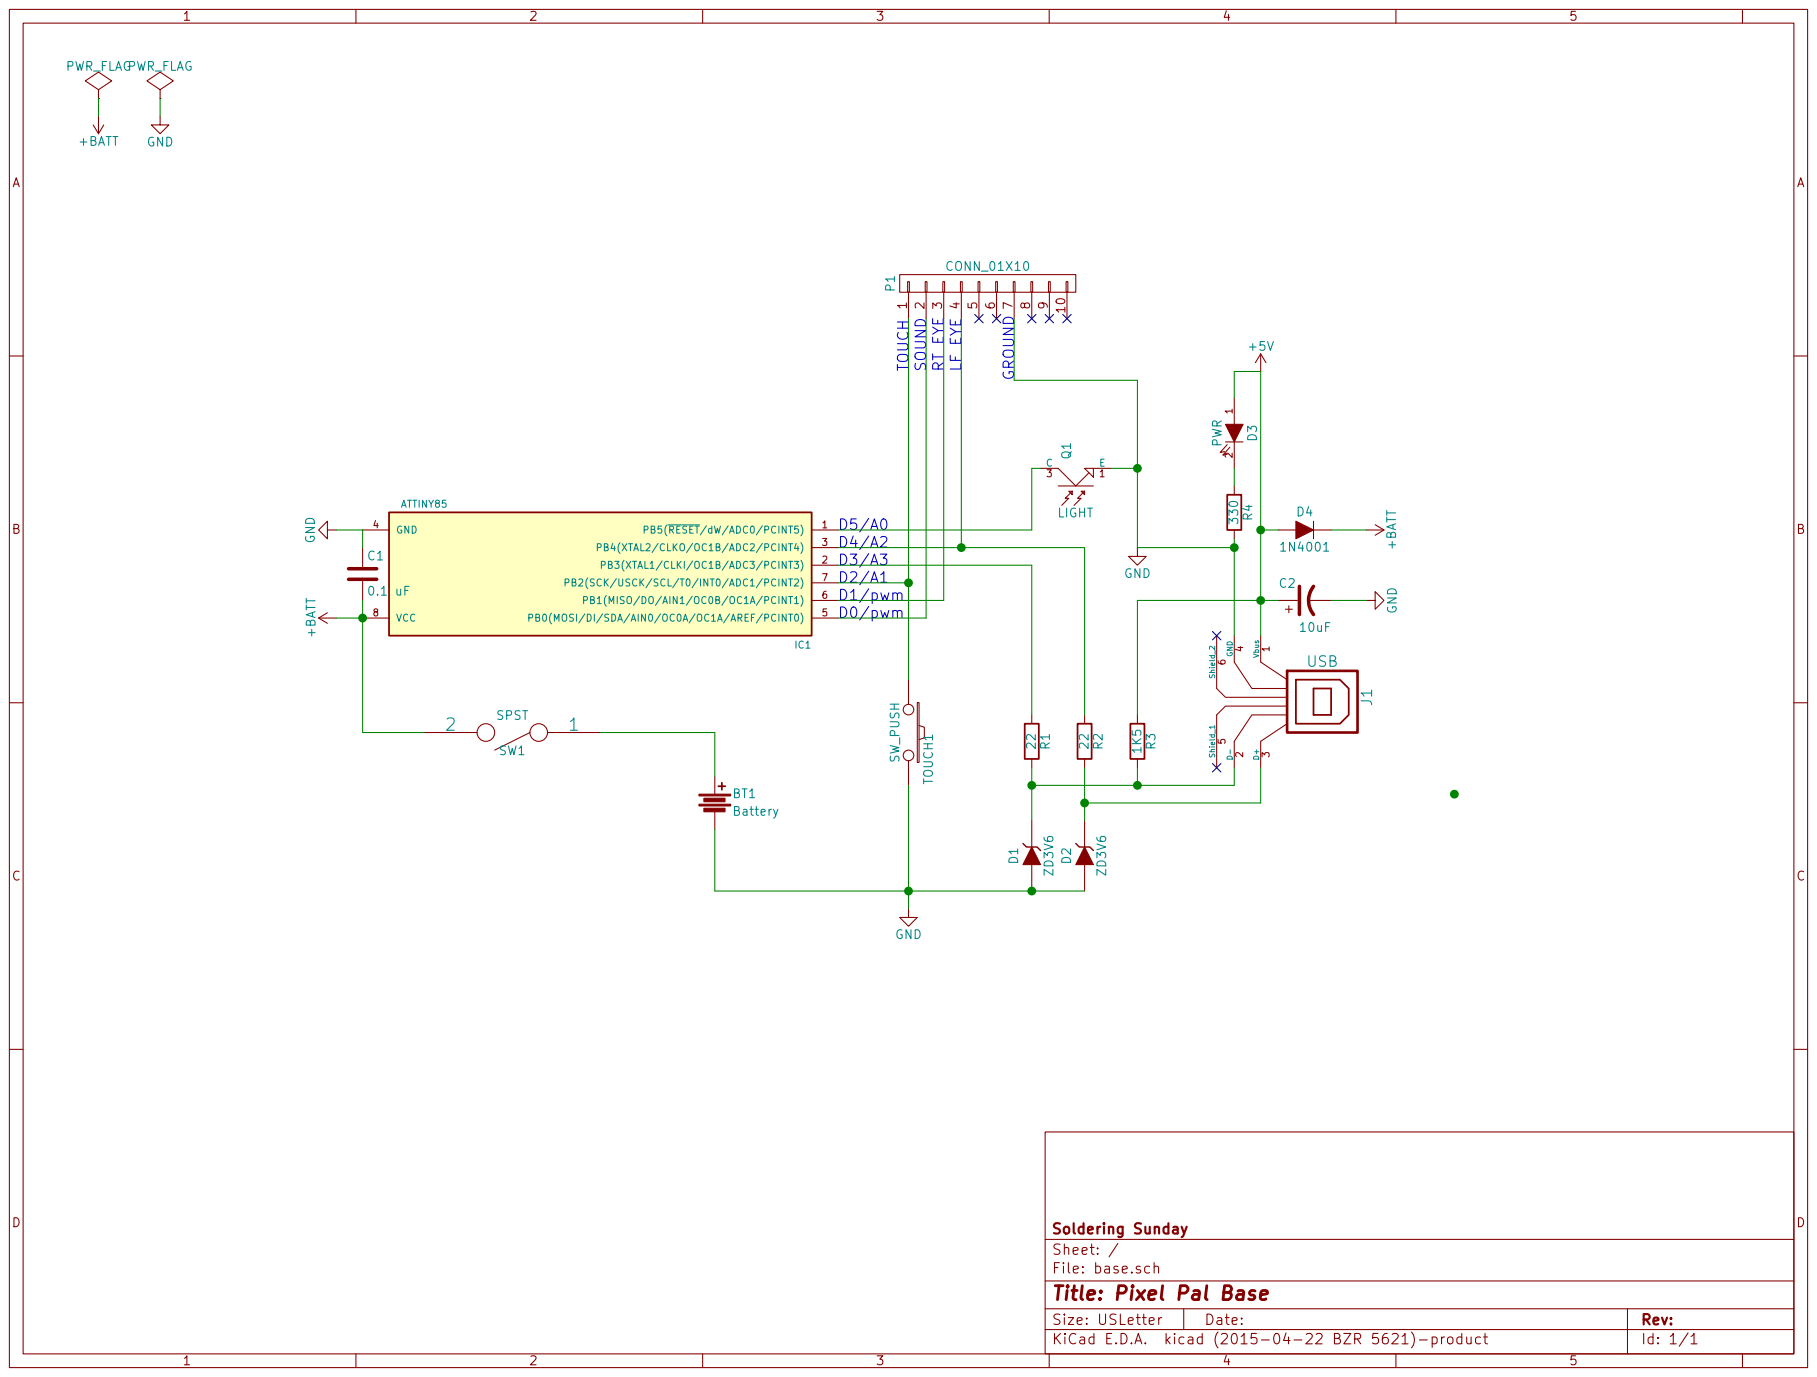
[picture p361: page 1]

File: base.sch Sheet: / Soldering Sunday

Id: 1/1 Title: Pixel Pal Base
