aspro648/KiCad/projects/Altimeter2/docs/project.pdf

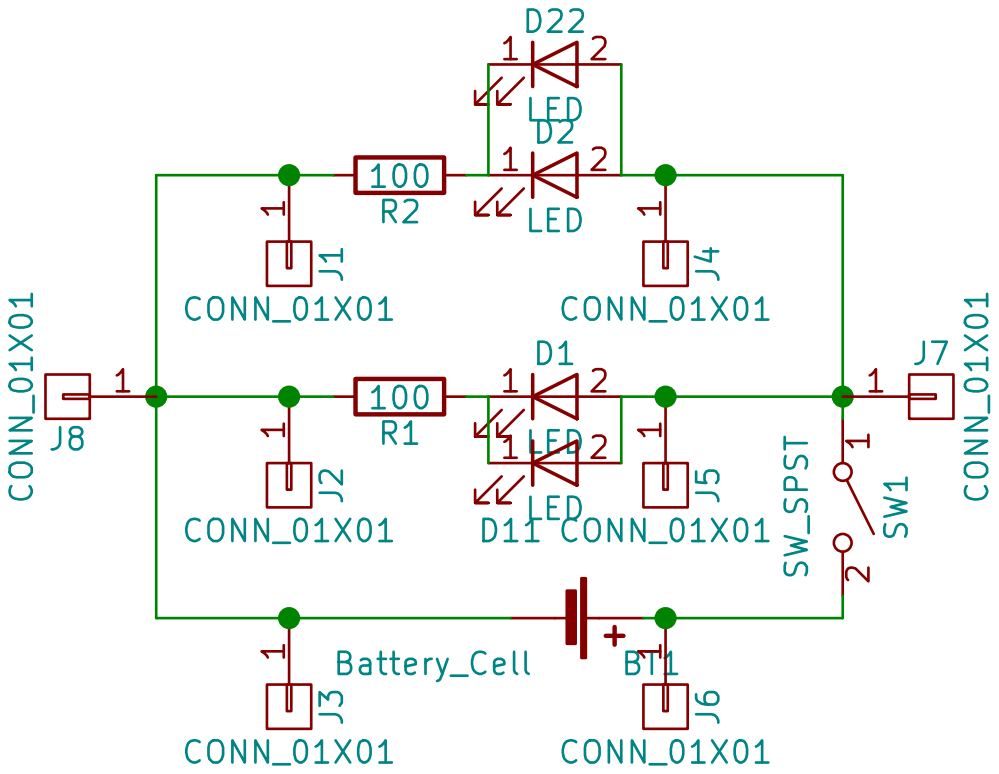
[picture p362: page 1]

File: project.sch Sheet: / www.MakersBox.us

Id: 1/1 Title: LED Eyes
