aspro648/KiCad/projects/tacuino R3/Docs/tacuino.pdf

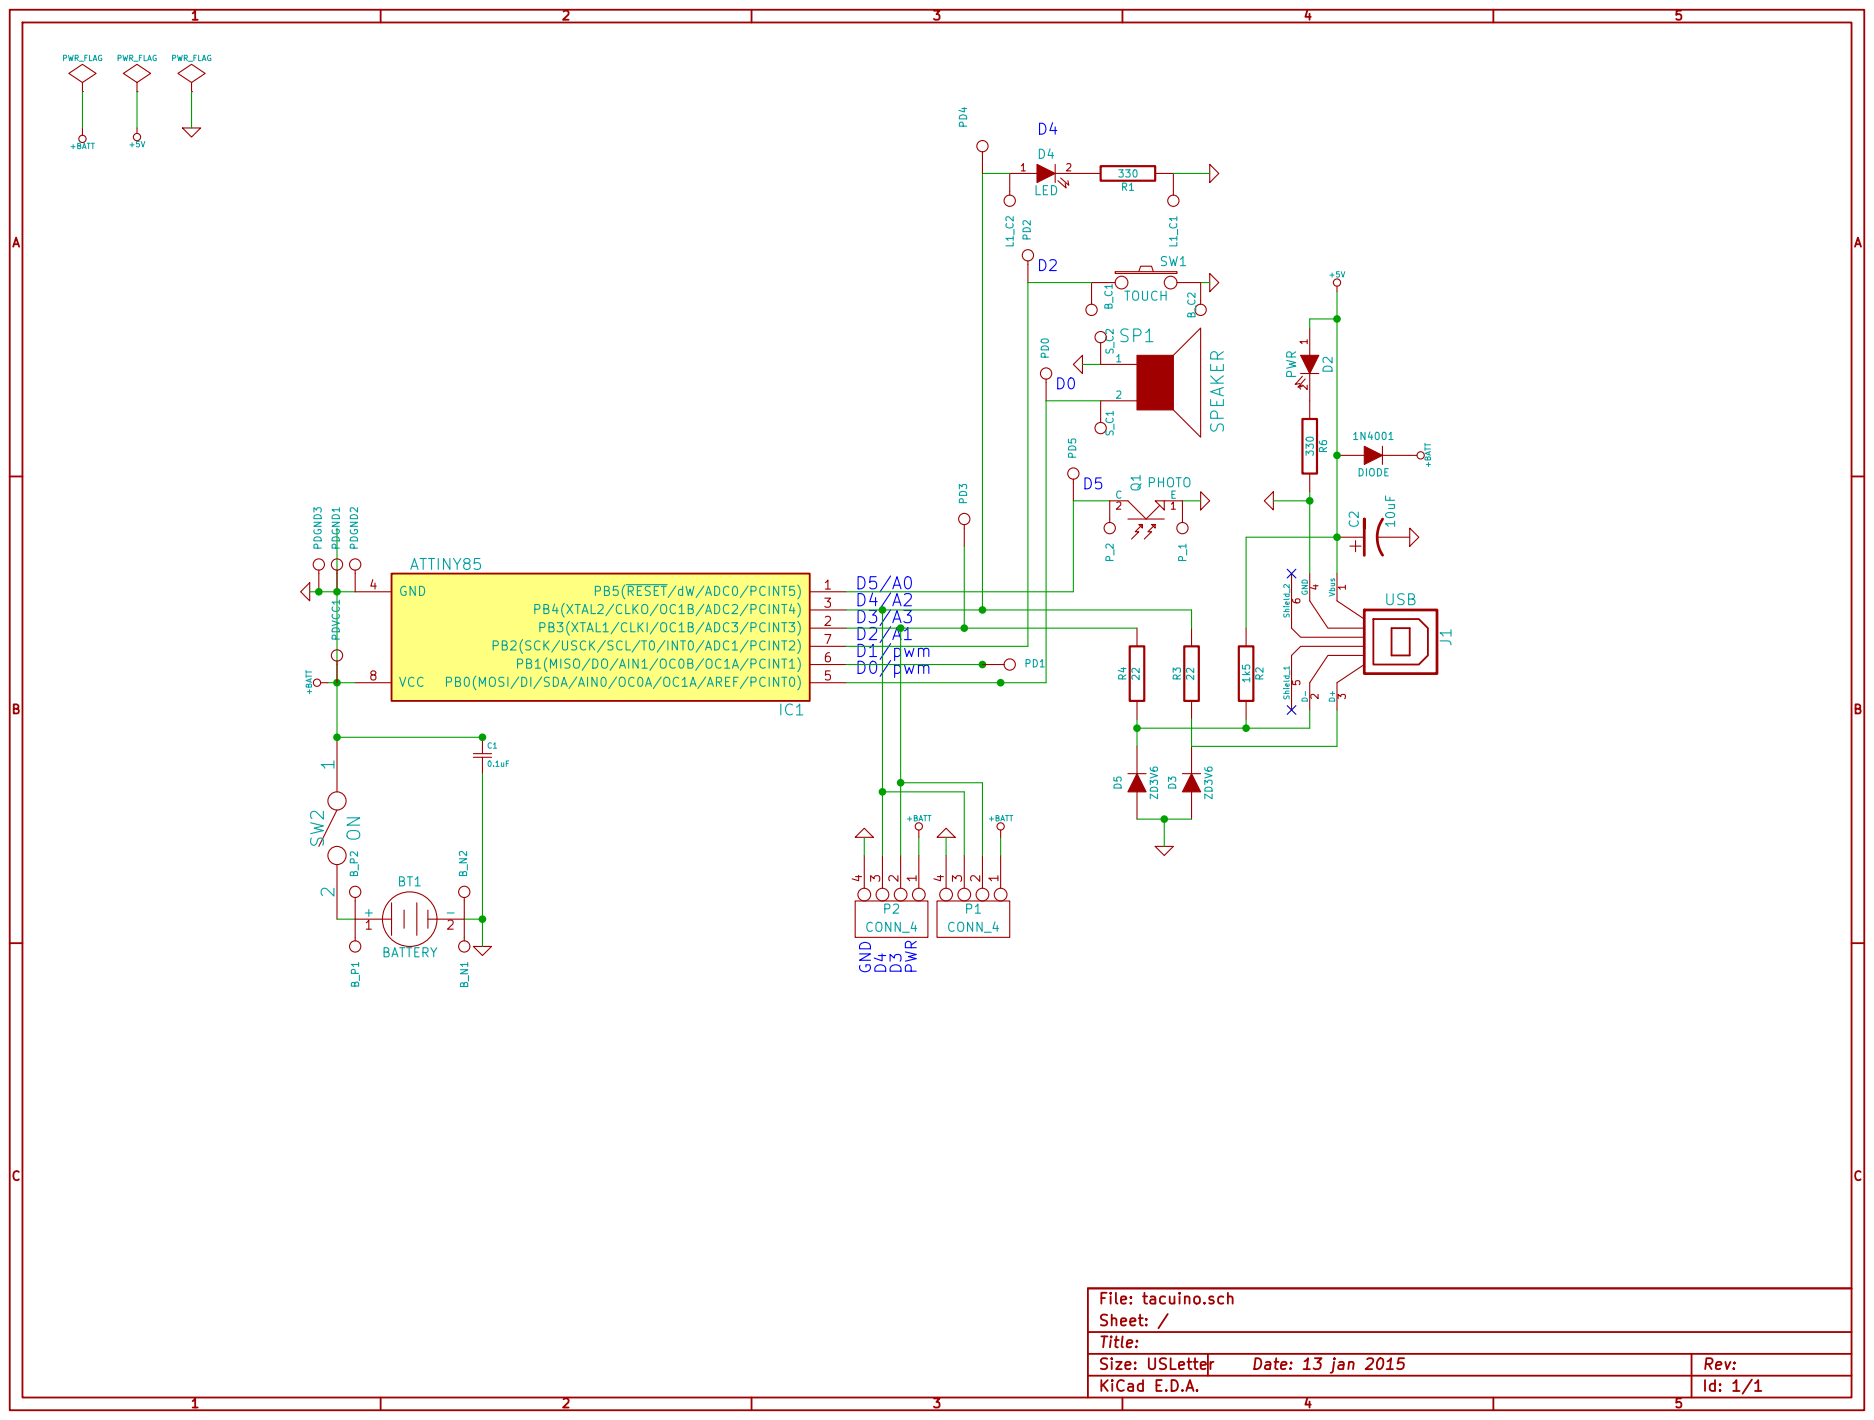
[picture p363: page 1]

D4/A2
D3/A3
D2/A1
D1/pwm
D0/pwm
