aspro648/KiCad/projects/BinDecHex/schematic.pdf

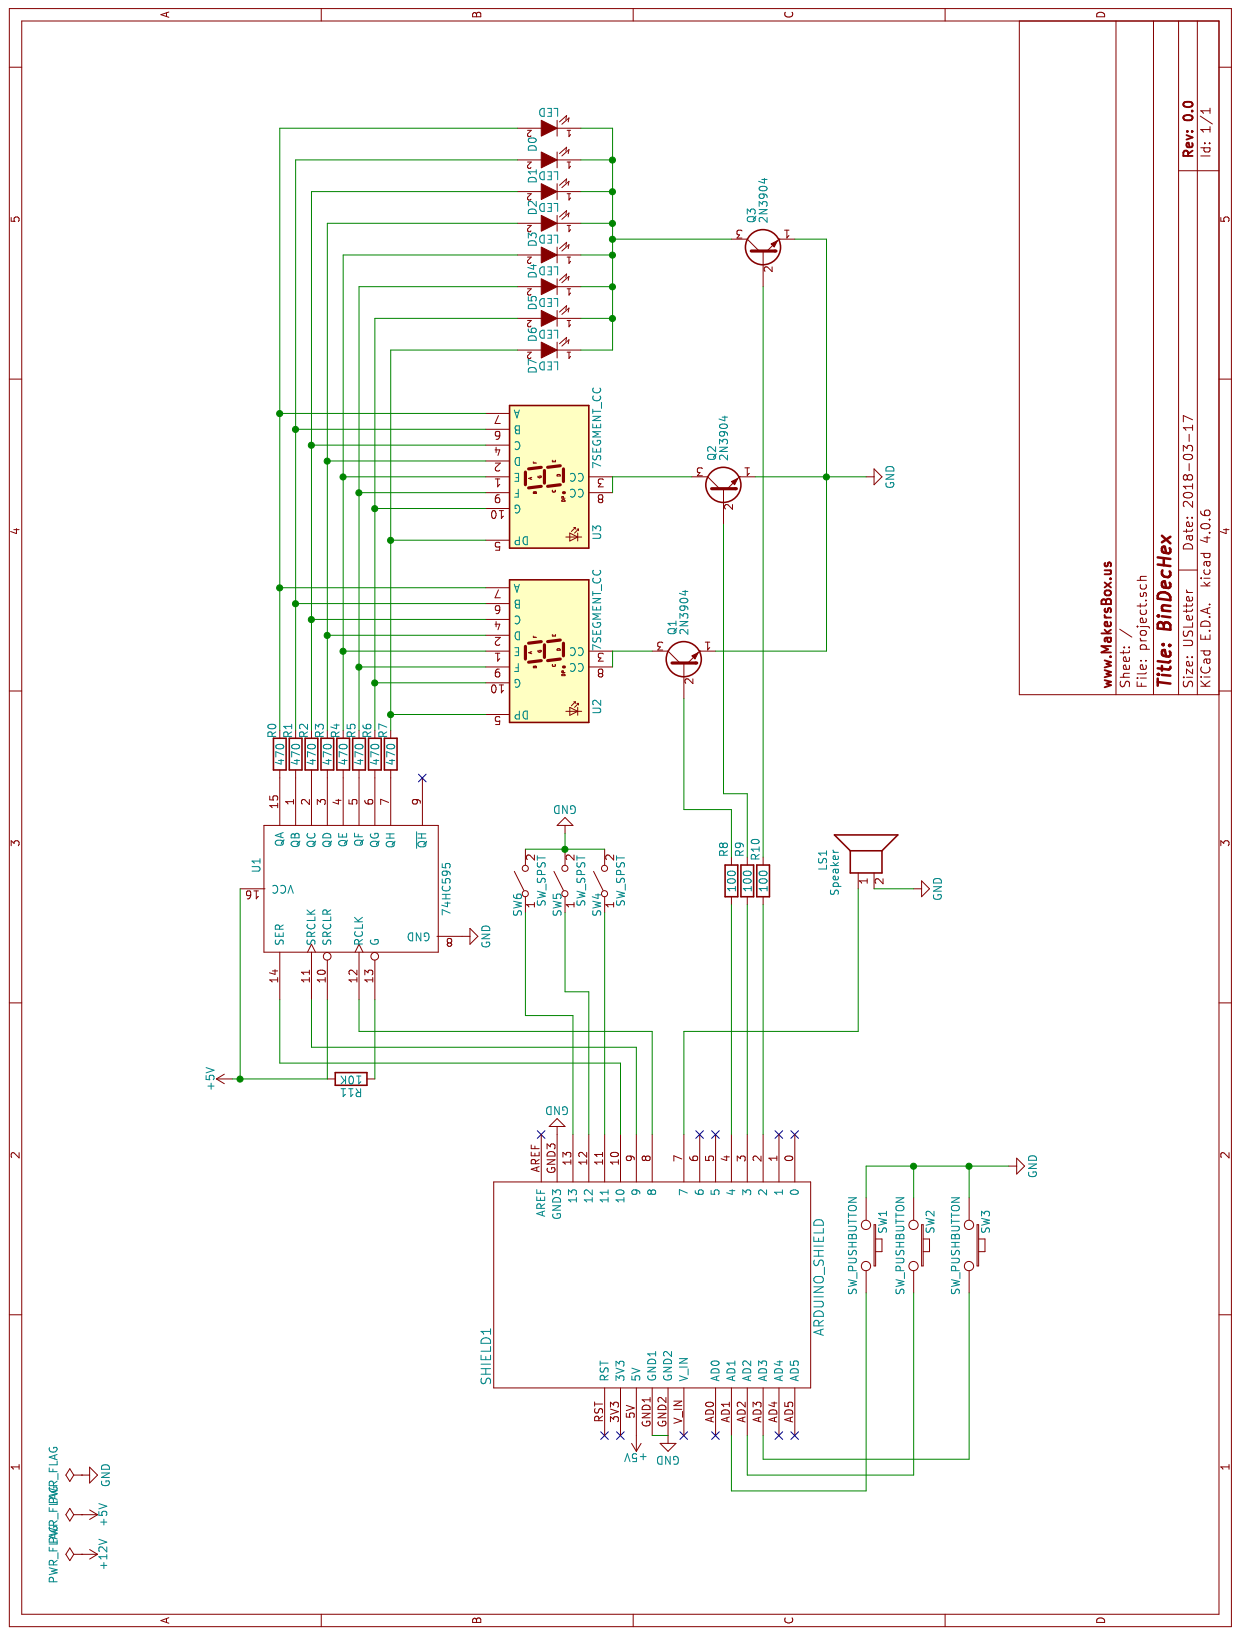
[picture p364: page 1]
