aspro648/KiCad/projects/LEGO/design_files_attiny826_LEDs/fab.pdf

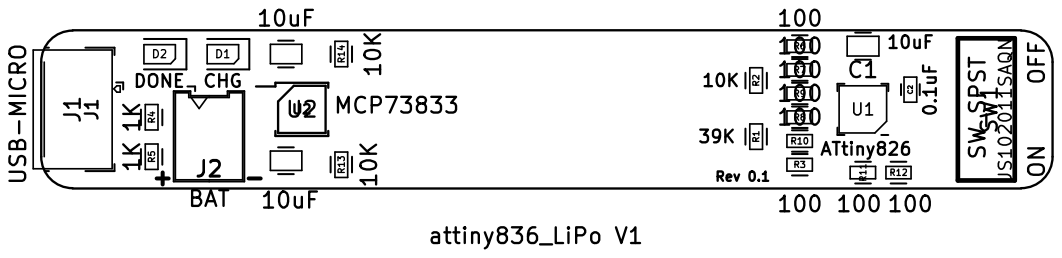
[picture p365: page 1]
