aspro648/KiCad/projects/LEGO/design_files_attiny826_LiPo badge/fab.pdf

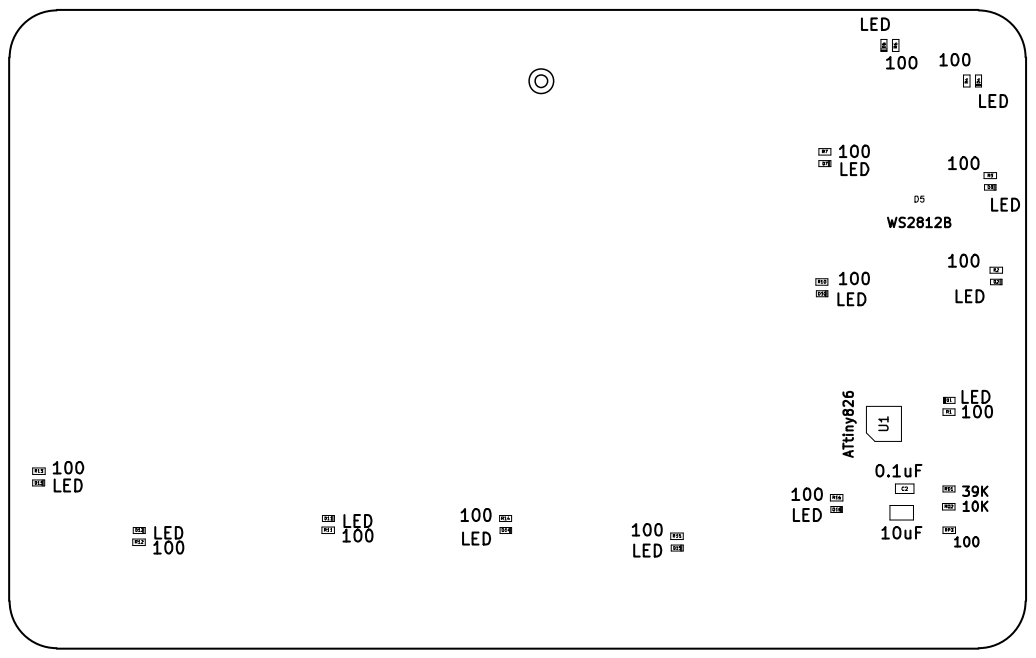
[picture p366: page 1]
