aspro648/KiCad/projects/Beetje/design_files_HBridgeX2 TC78H651/schematic.pdf

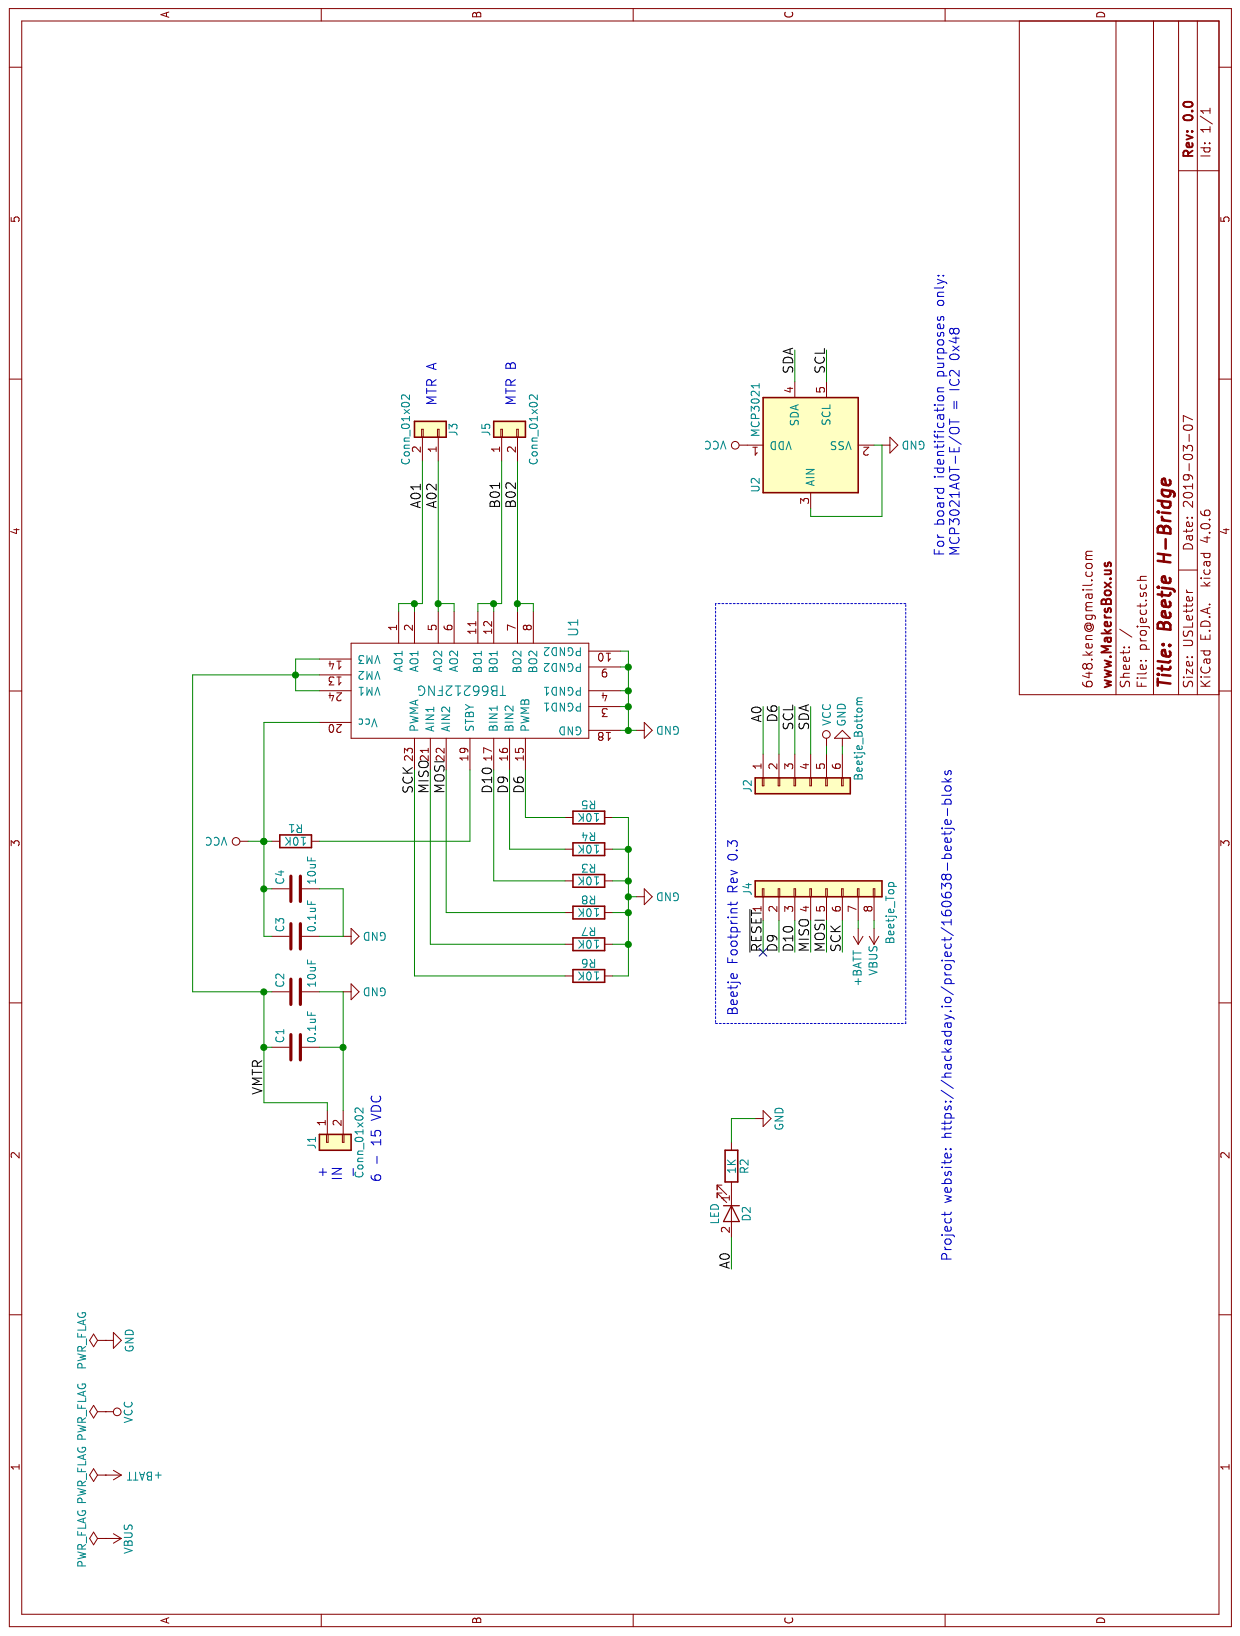
[picture p367: page 1]
