aspro648/KiCad/projects/Beetje/design_files_Full_Bridge/schematic.pdf

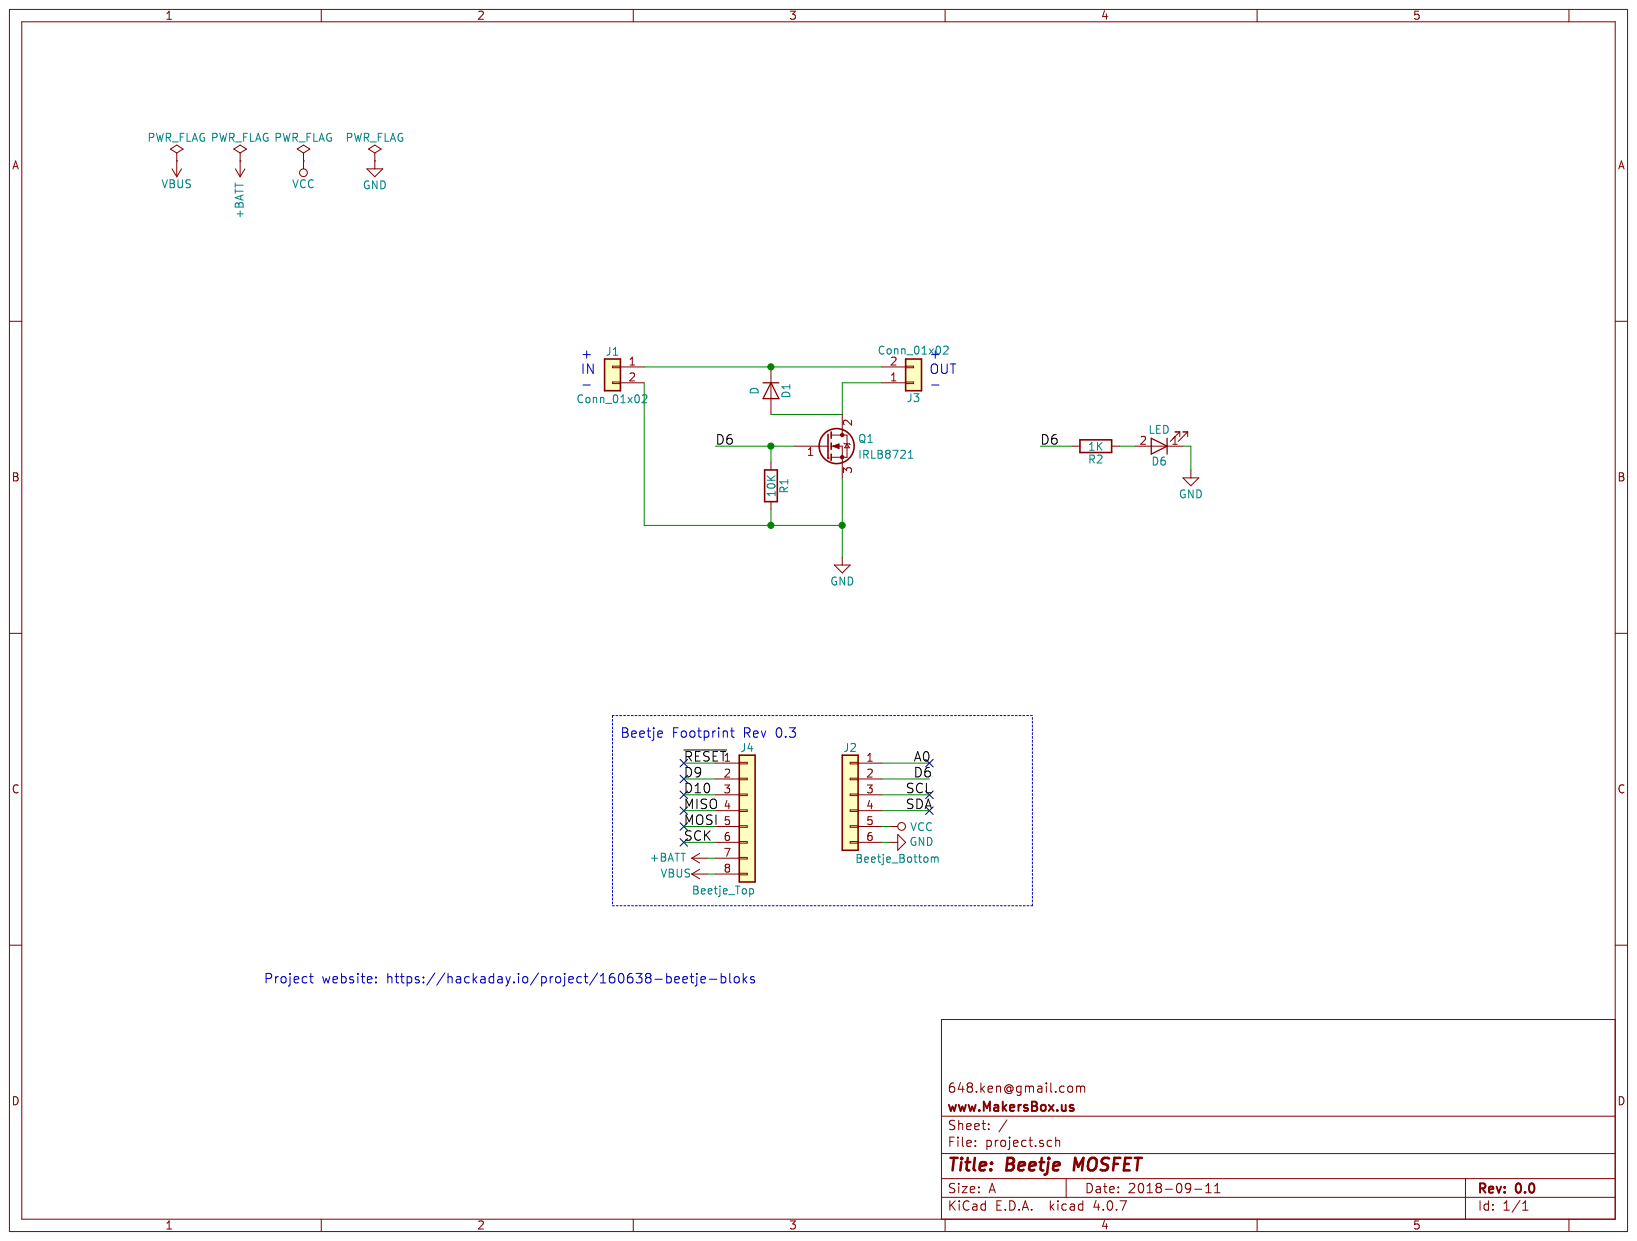
[picture p368: page 1]
