aspro648/KiCad/projects/Beetje/design_files_Accel/schematic.pdf

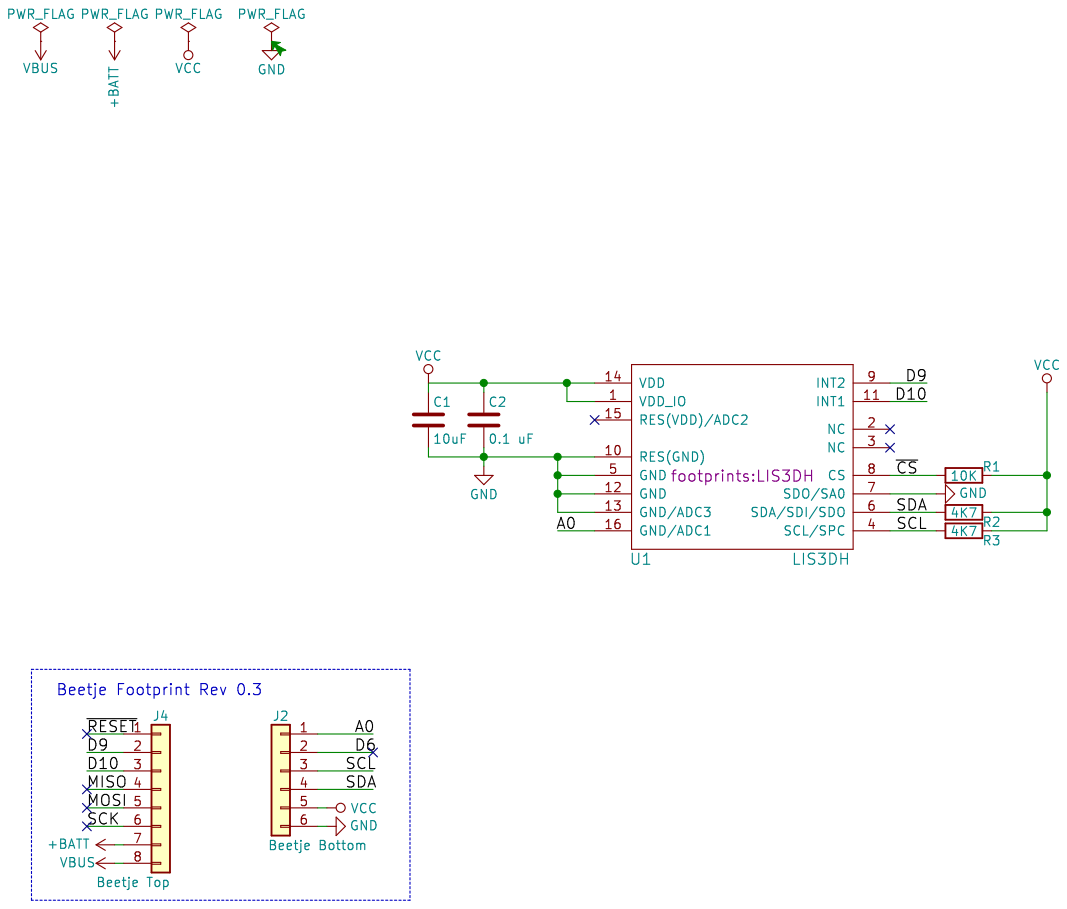
[picture p369: page 1]
