aspro648/KiCad/projects/Beetje/design_files_CNTRL-ATL-DEL/schematic.pdf

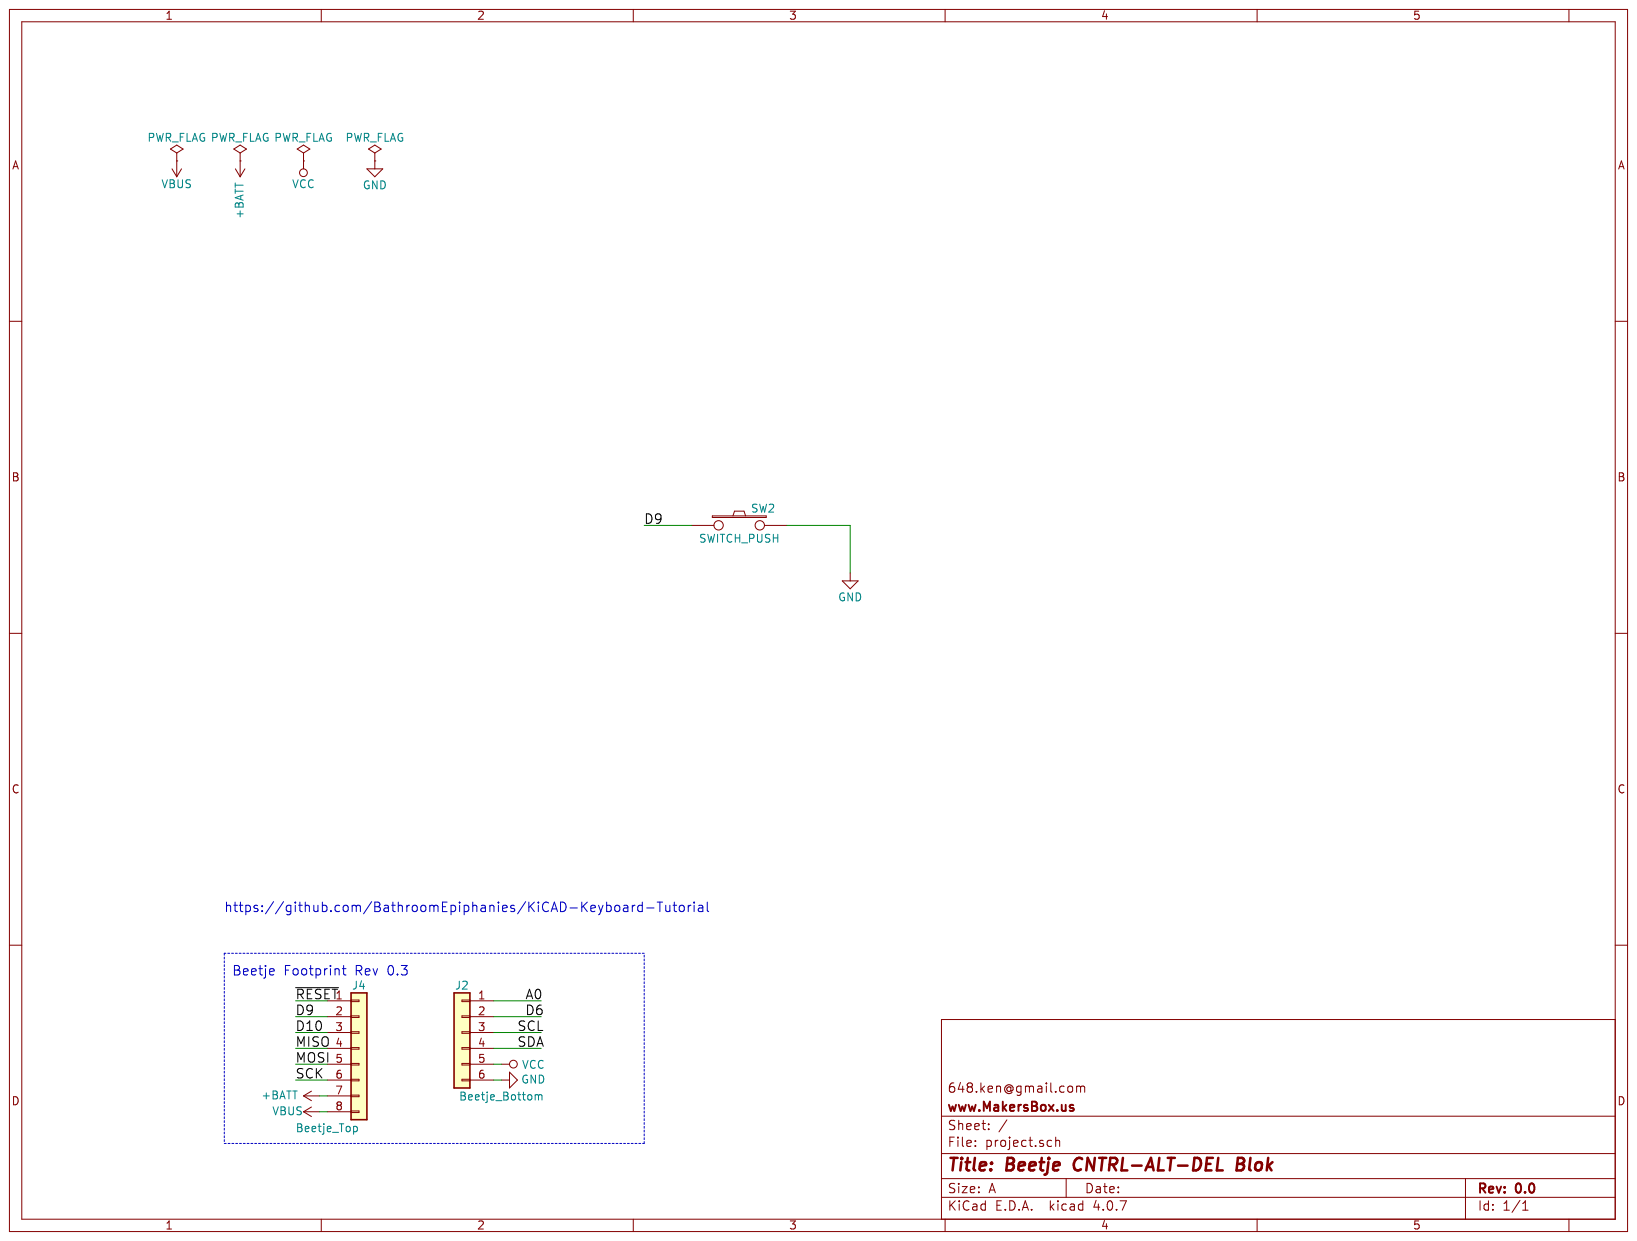
[picture p370: page 1]
