aspro648/KiCad/projects/Beetje/design_files_EEPROM/schematic V0.pdf

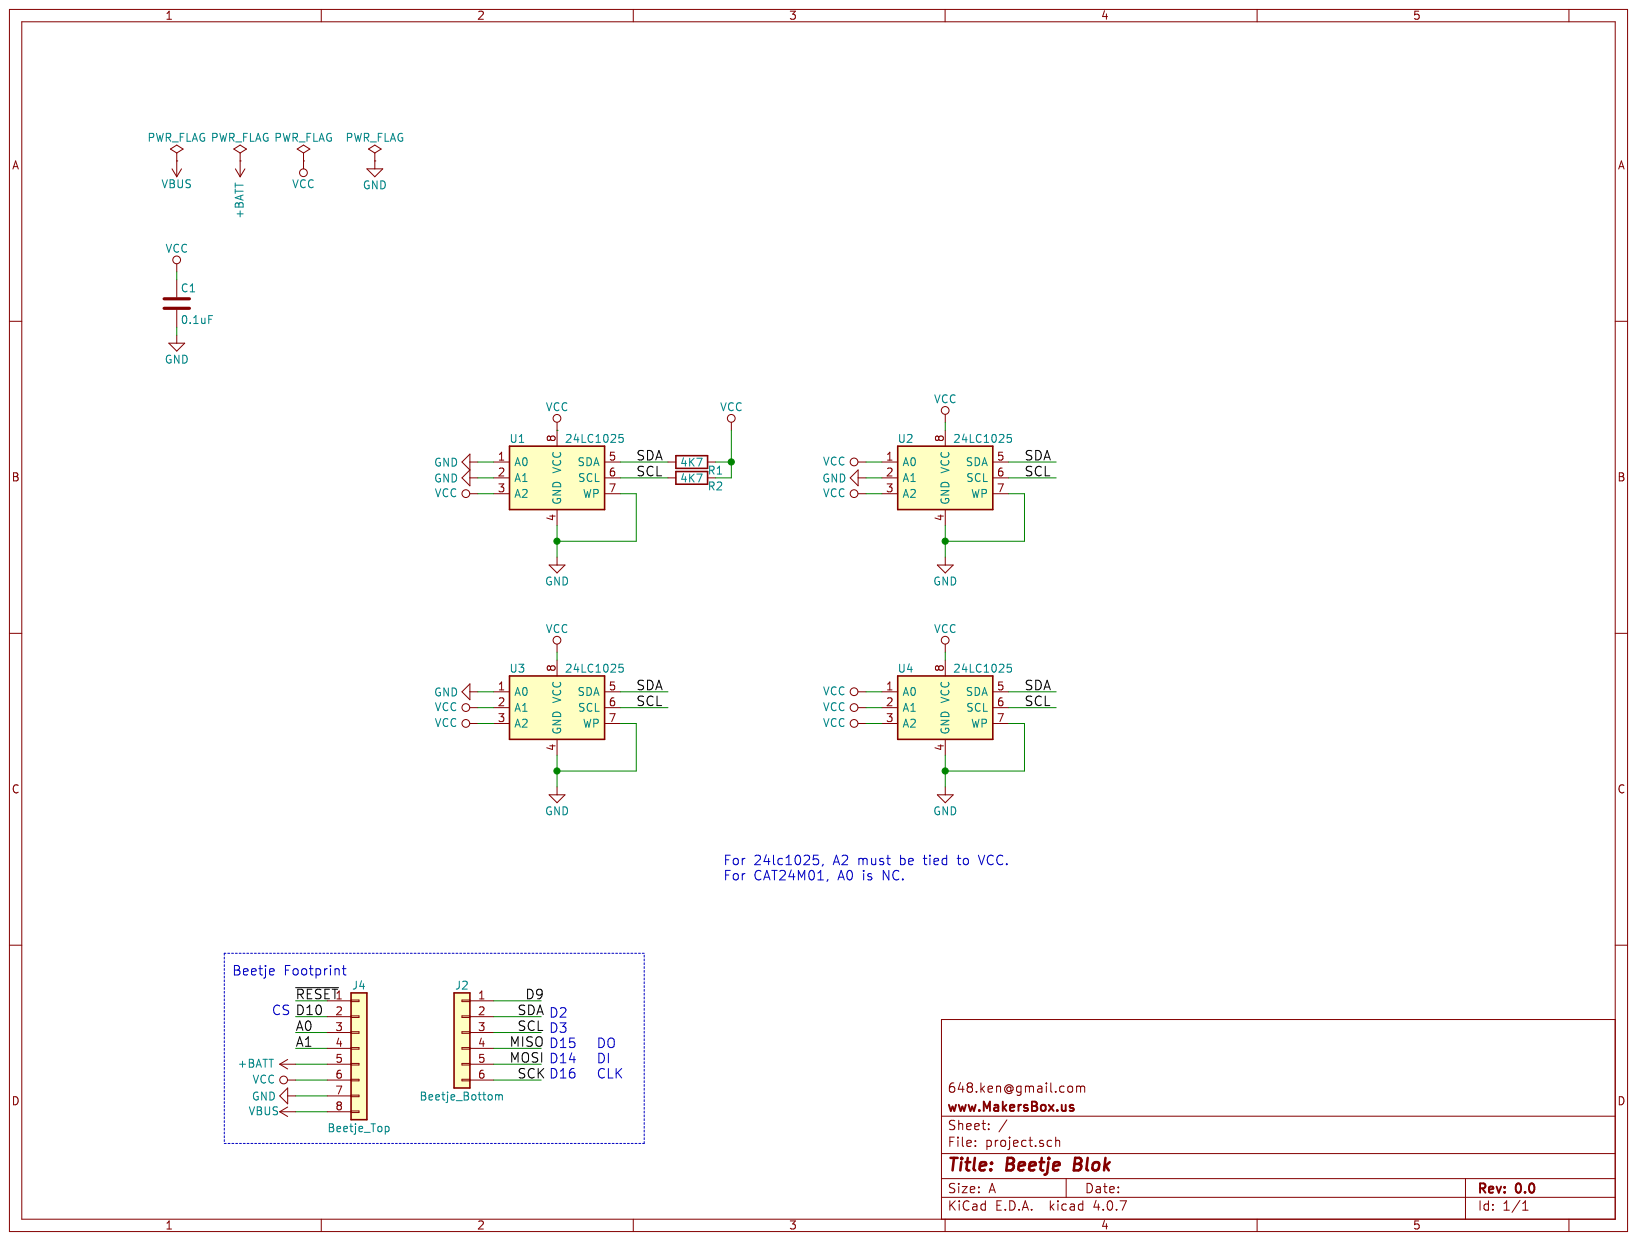
[picture p371: page 1]
