aspro648/KiCad/projects/Beetje/design_files_Relay/schematic.pdf

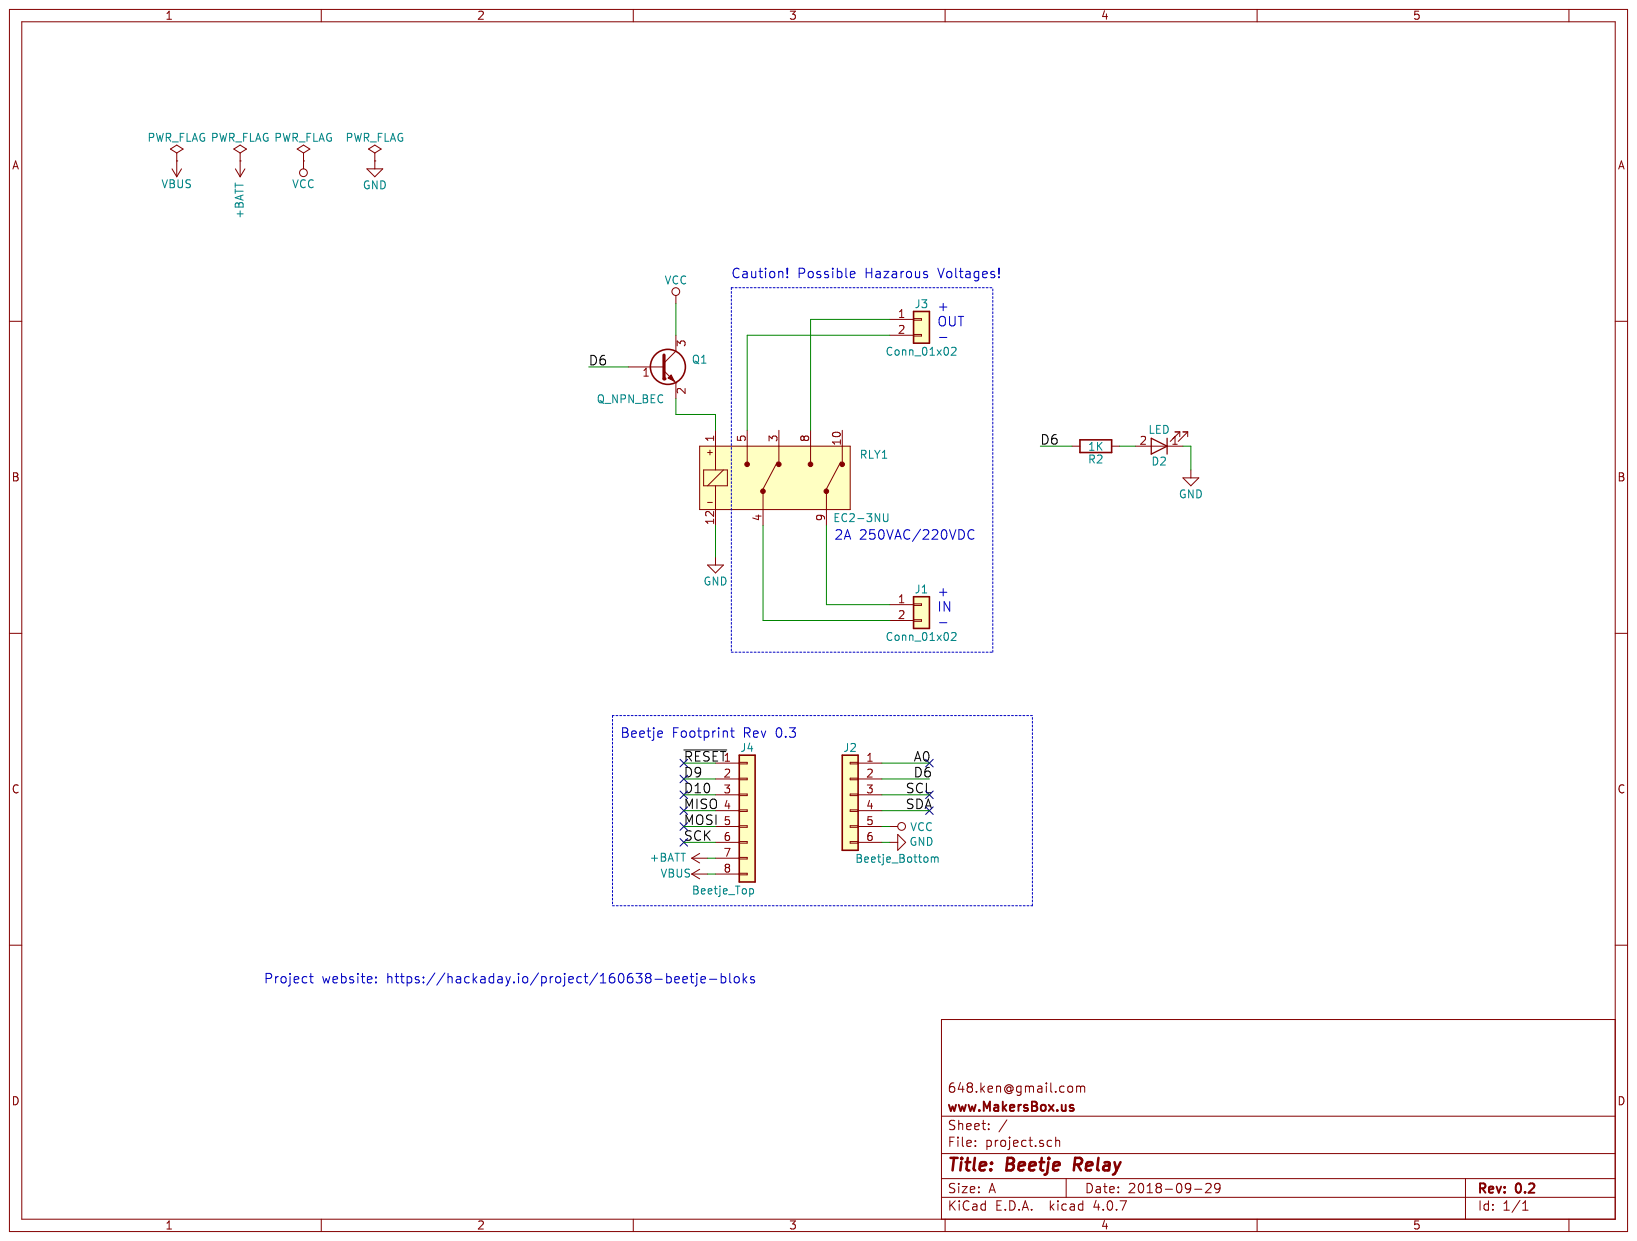
[picture p372: page 1]
