aspro648/KiCad/projects/Beetje/design_files_OLED/schematic.pdf

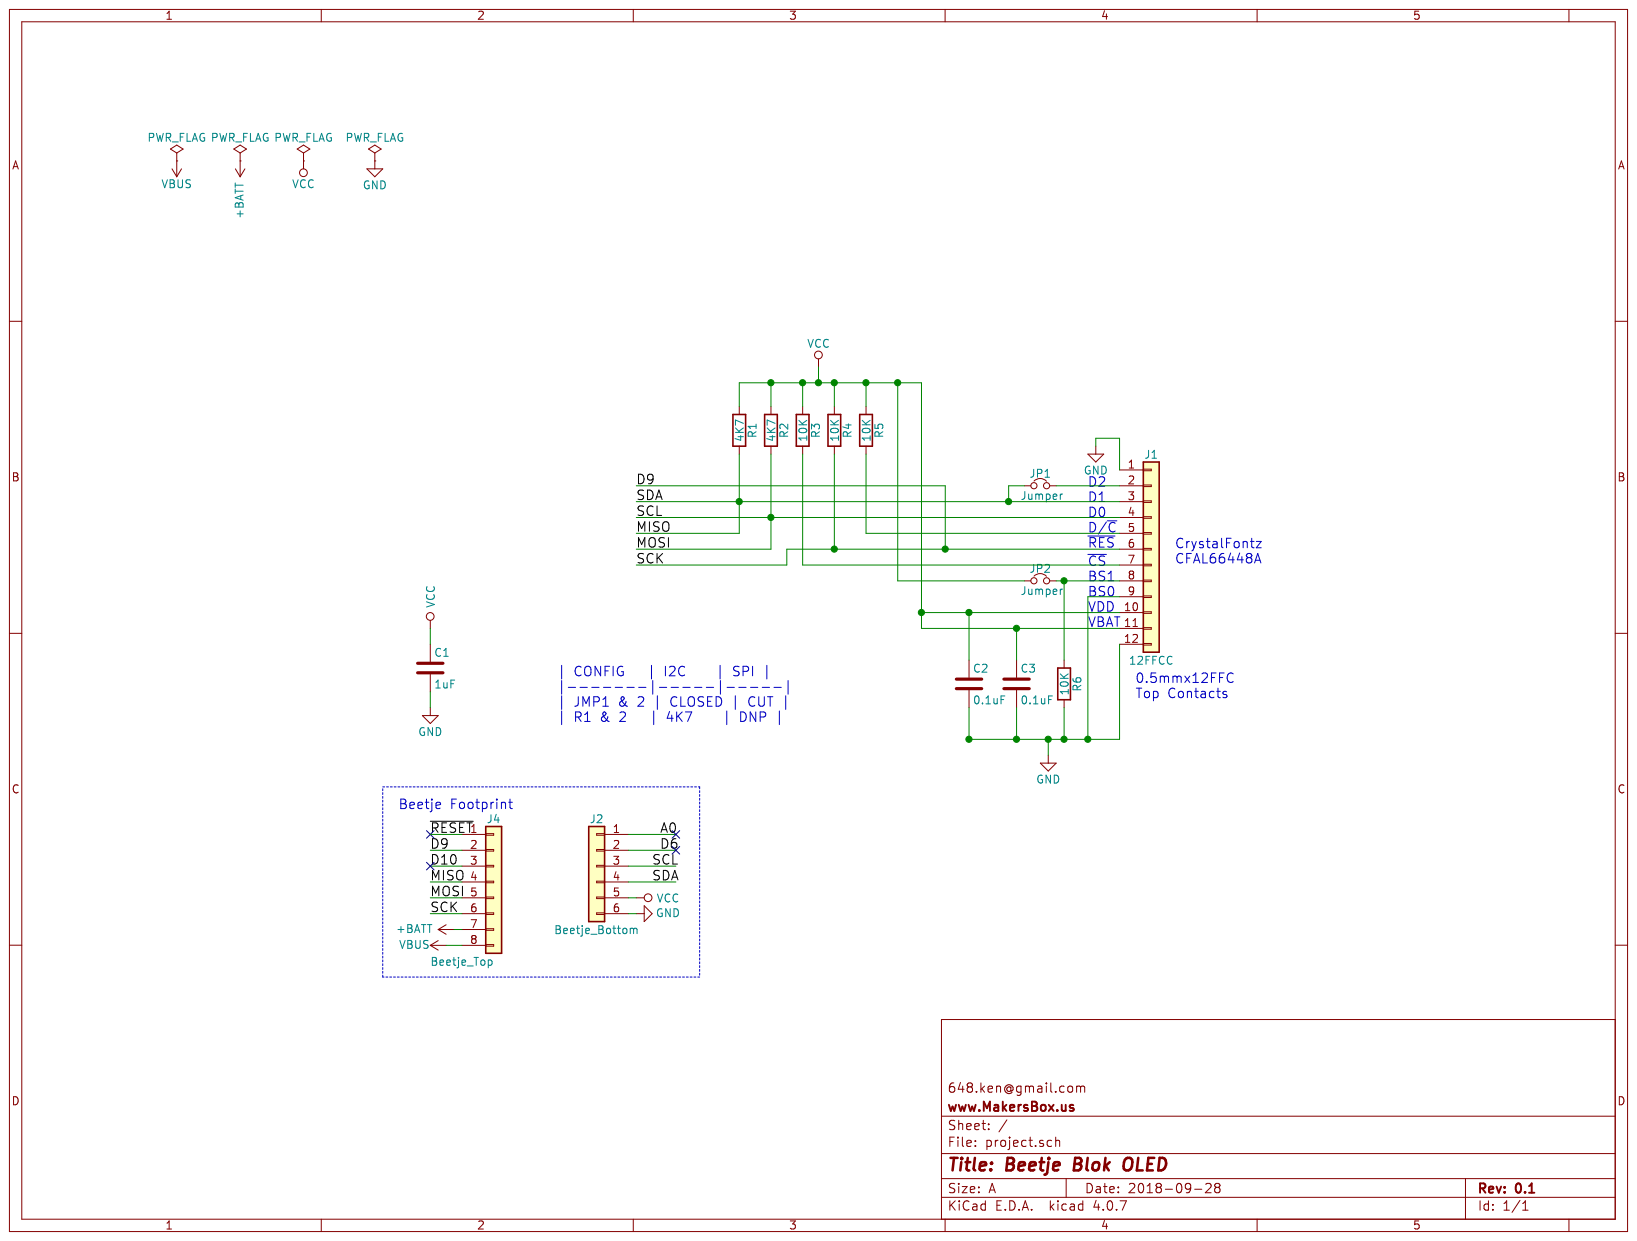
[picture p373: page 1]
