aspro648/KiCad/projects/Beetje/design_files_PCF8532_RTC/schematic.pdf

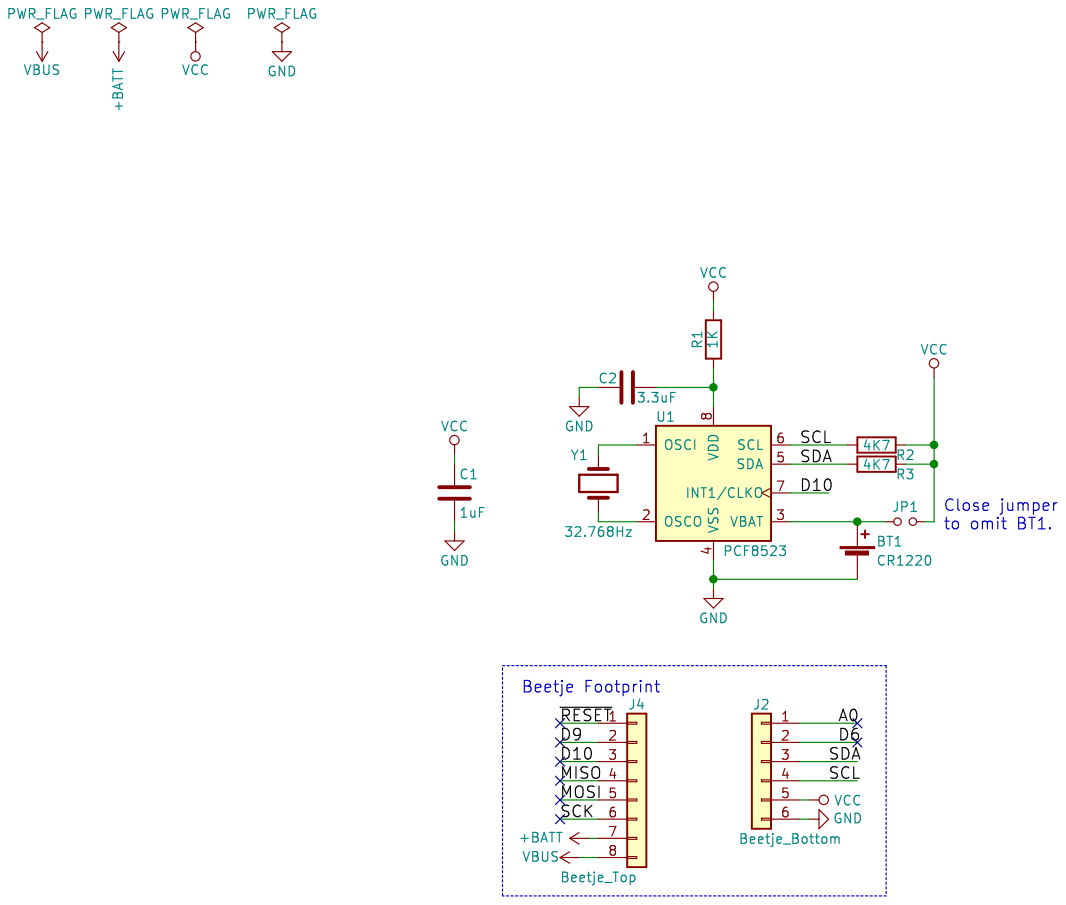
[picture p374: page 1]
