aspro648/KiCad/projects/Beetje/design_files_CNTRL-ATL-DEL/project.pdf

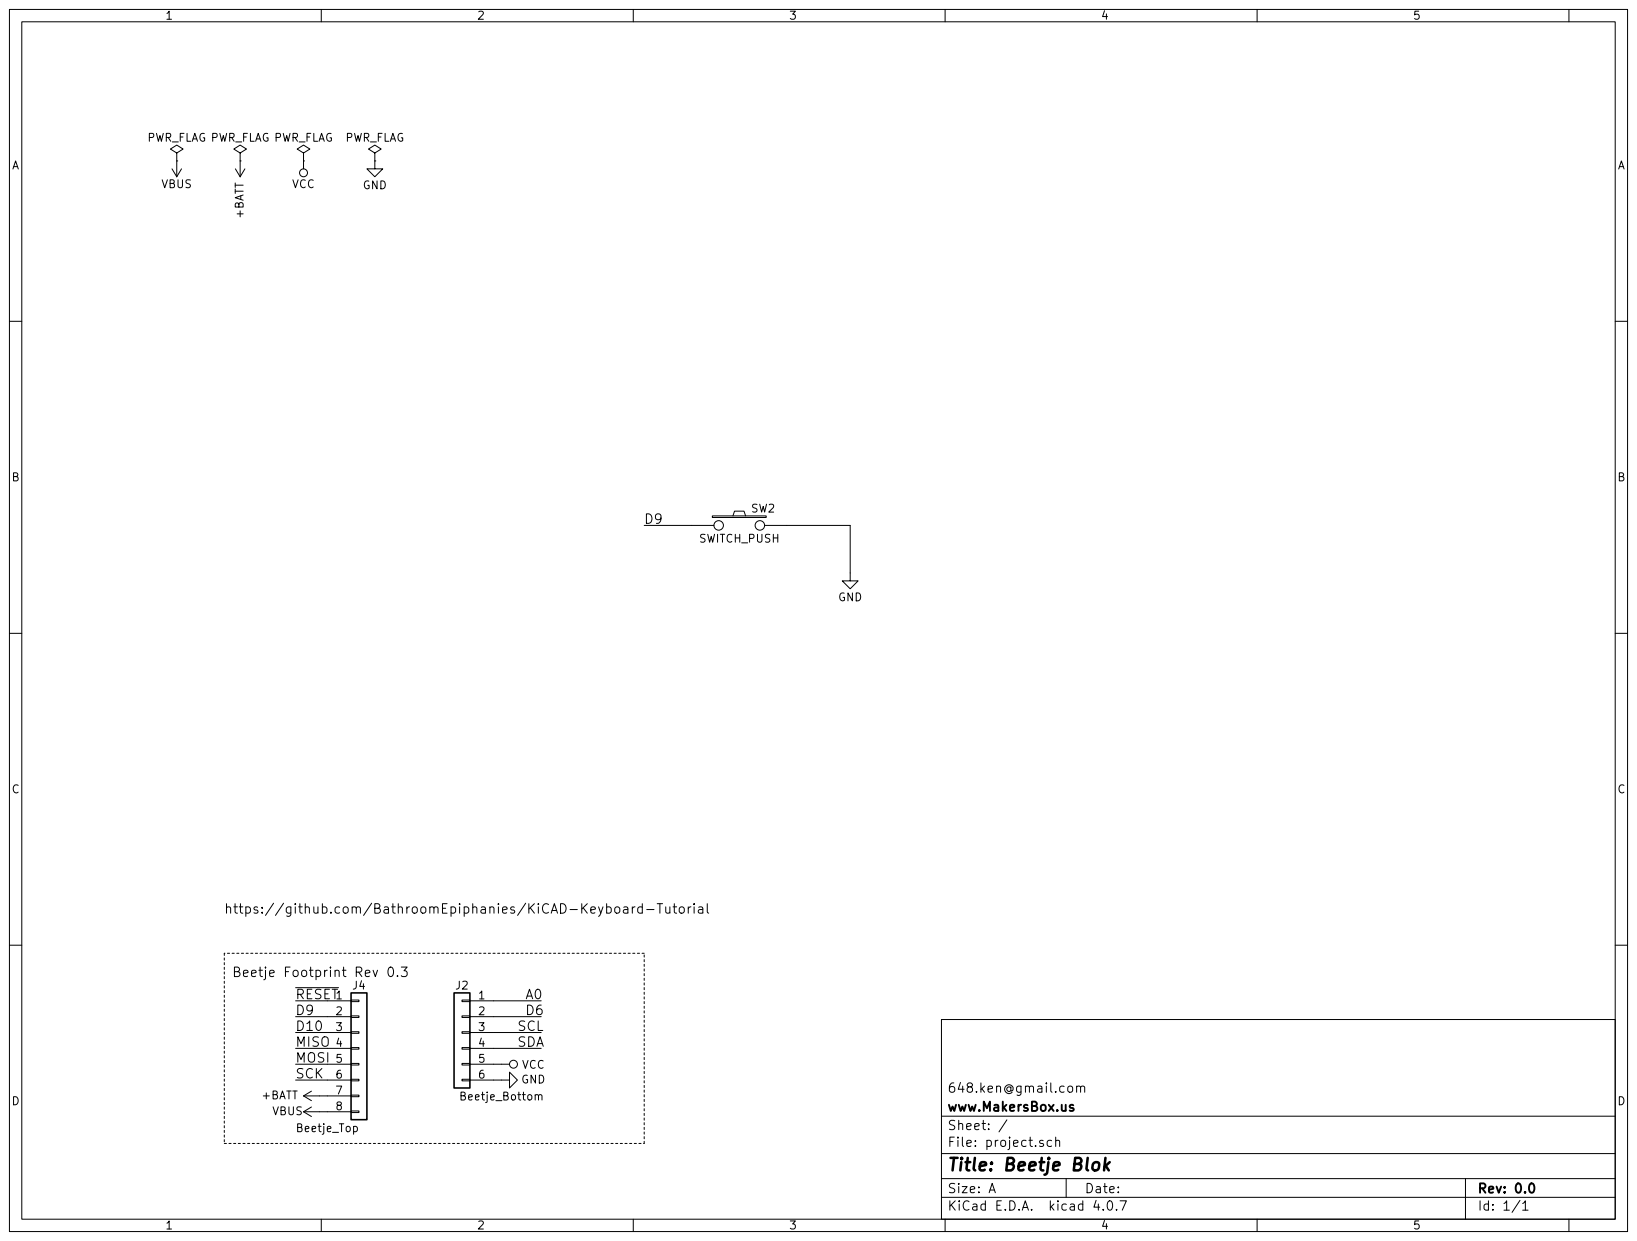
[picture p375: page 1]
