aspro648/KiCad/projects/Beetje/design_files_32U4/schematic 0.3.pdf

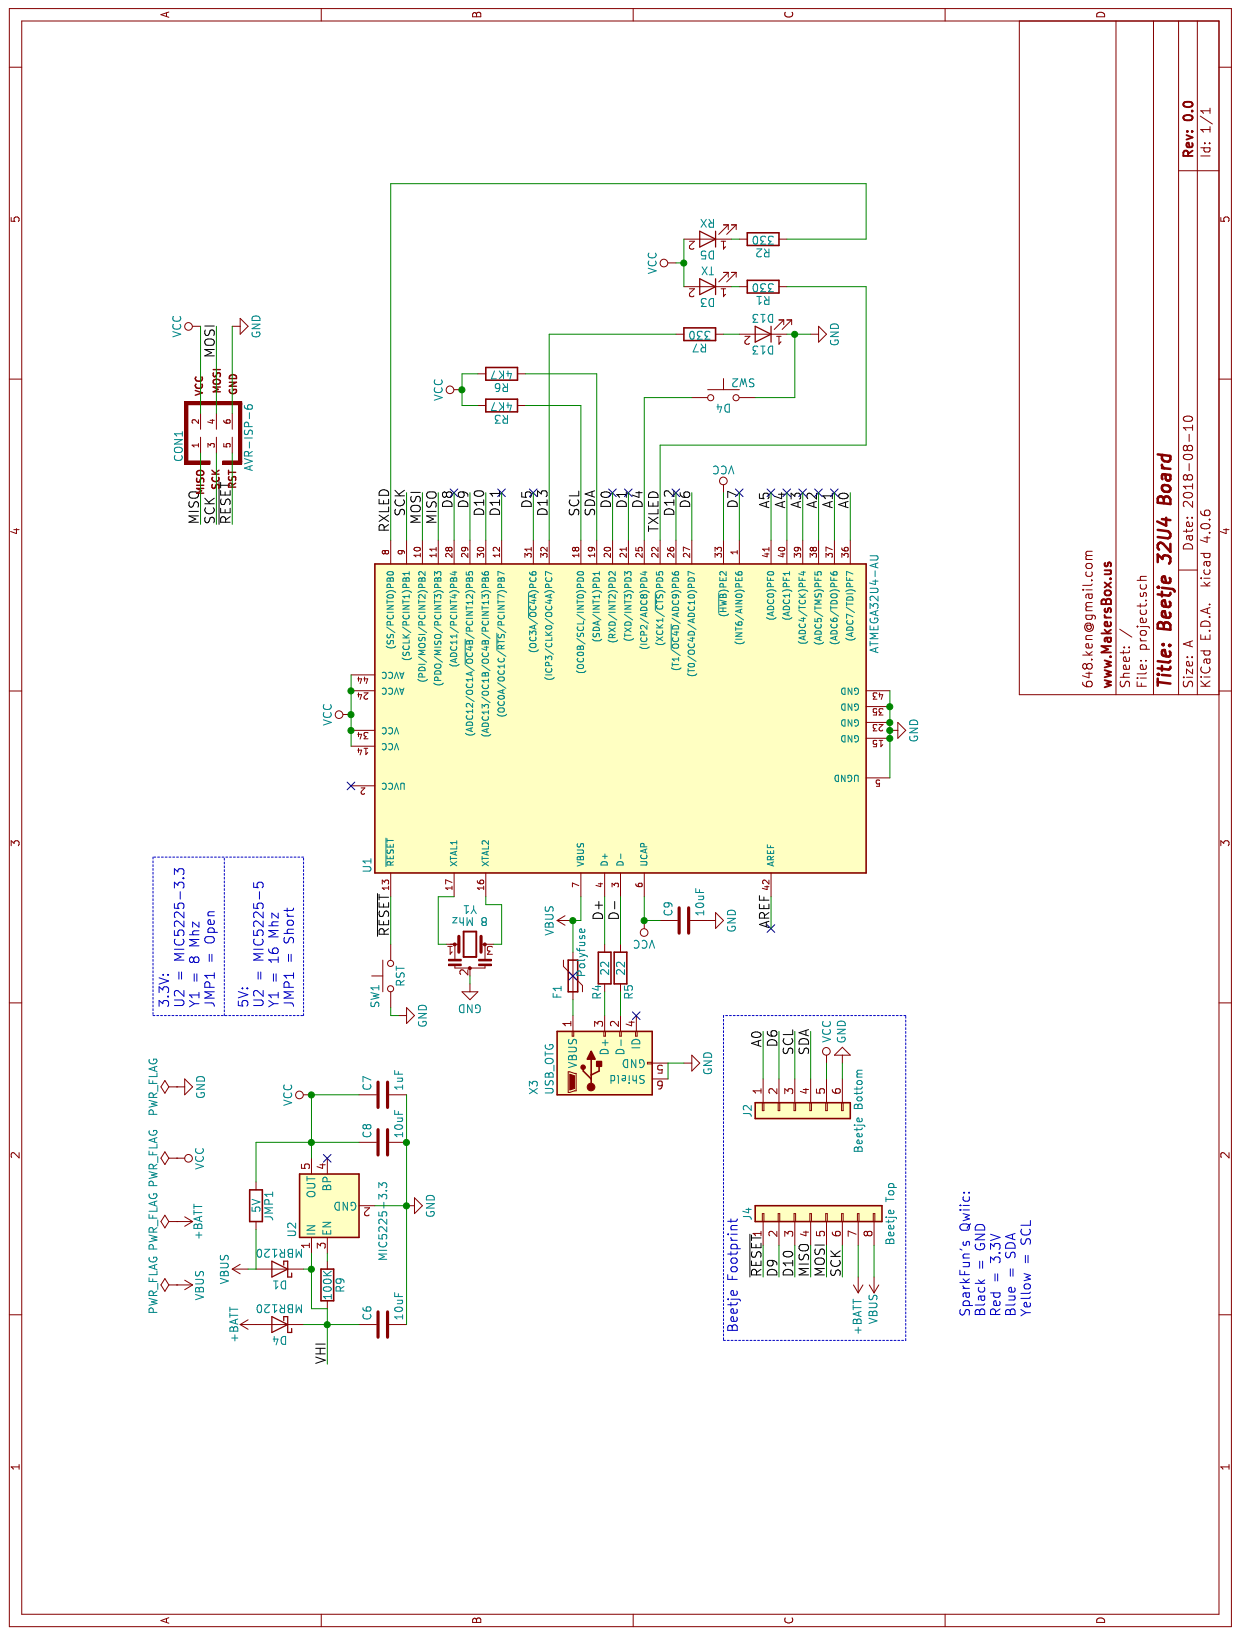
[picture p376: page 1]
