aspro648/KiCad/projects/Beetje/design_files_8x8/schematic.pdf

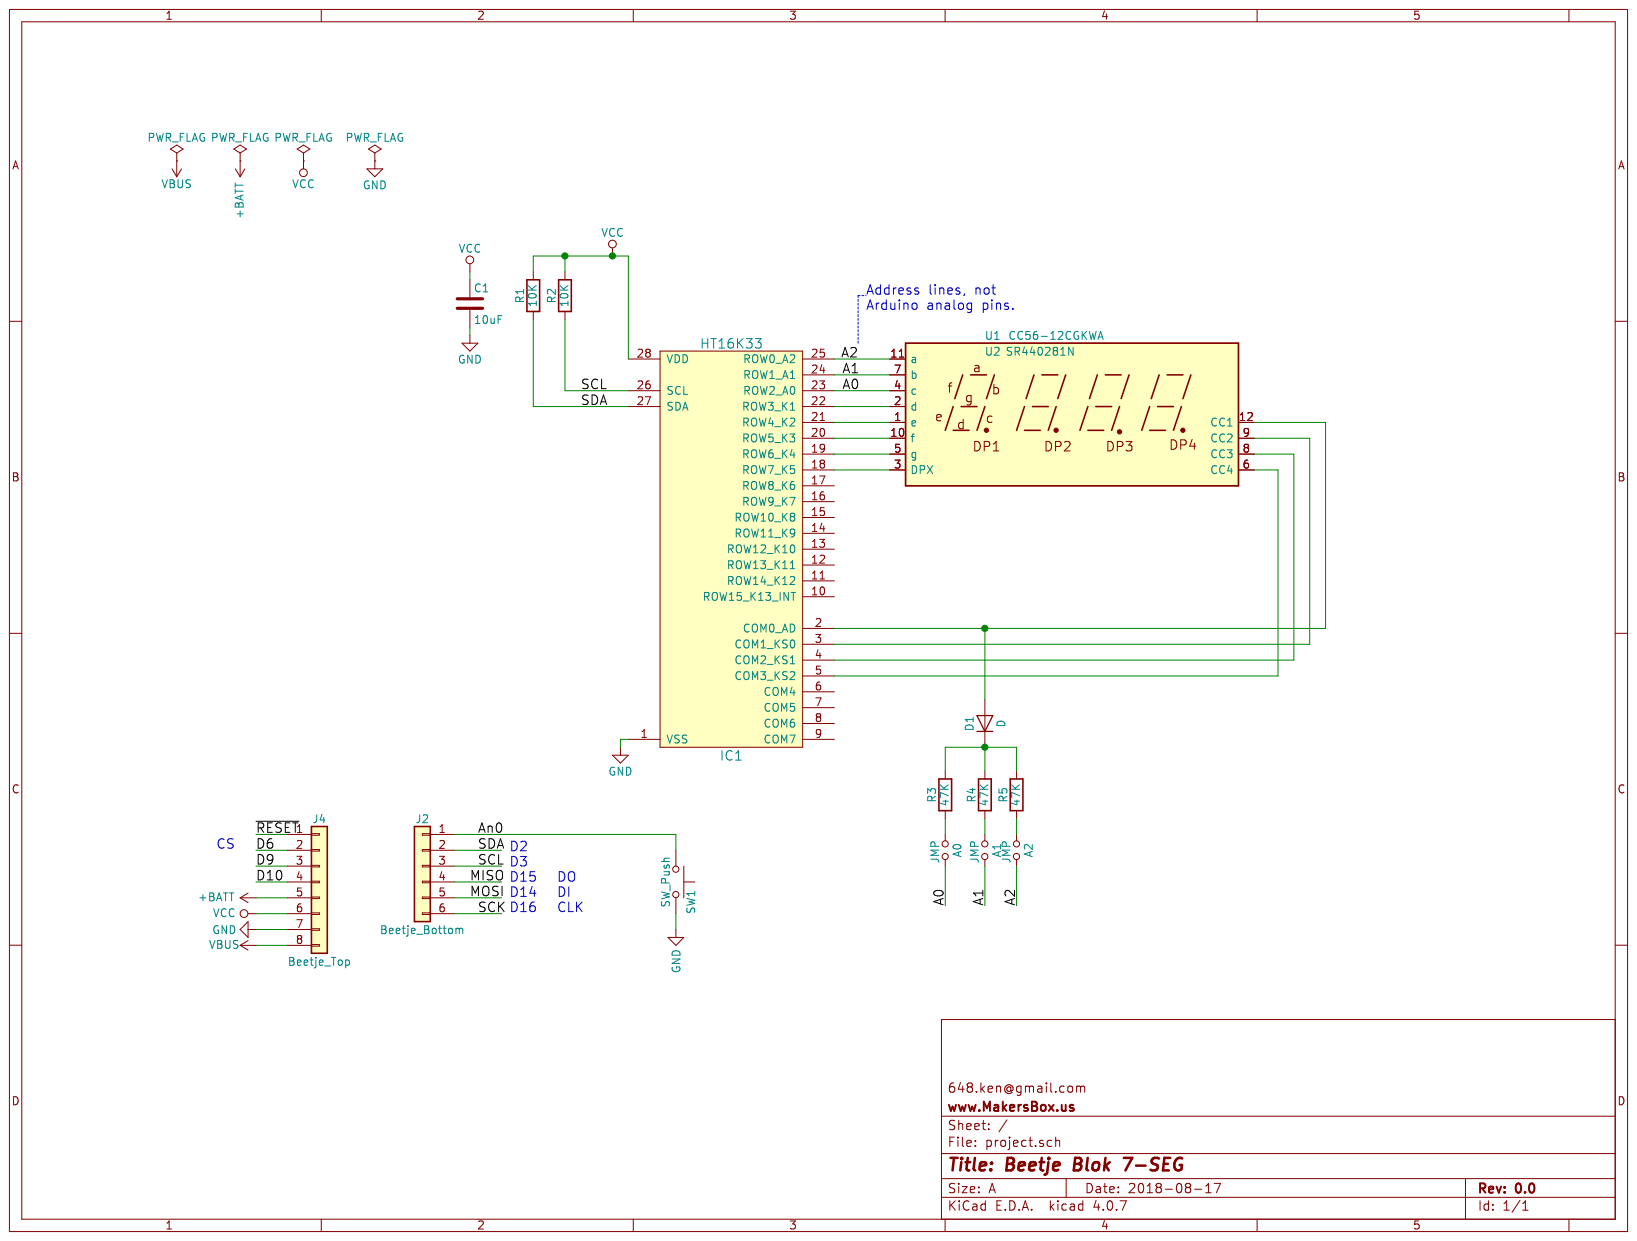
[picture p377: page 1]
