aspro648/KiCad/projects/Beetje/design_files_press_LPS25HB breakout/schematic.pdf

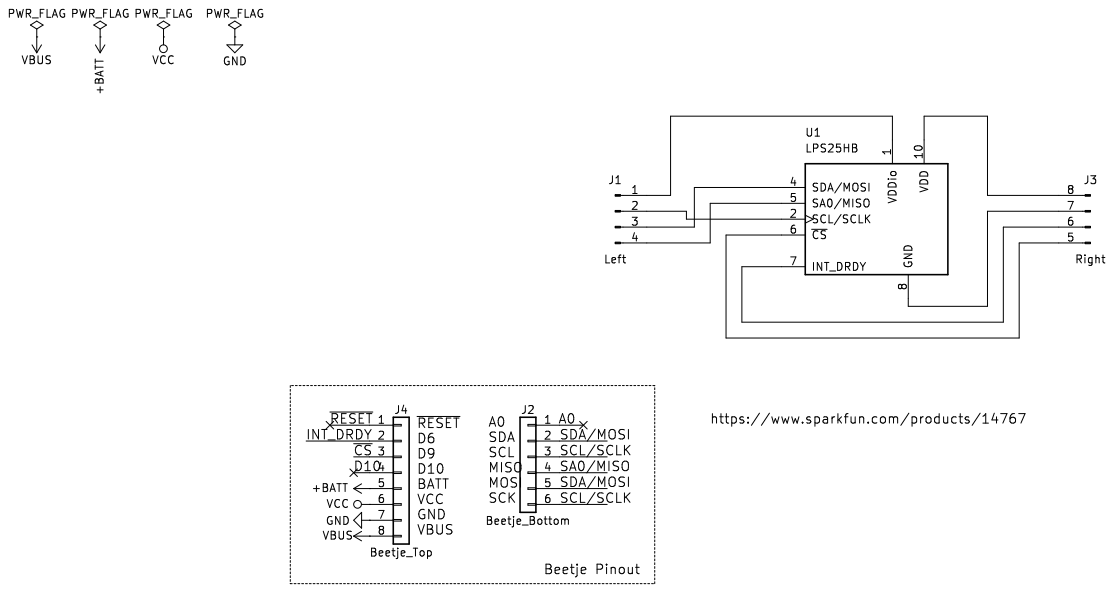
[picture p378: page 1]
