aspro648/KiCad/projects/Beetje/design_files_shield/schematic.pdf

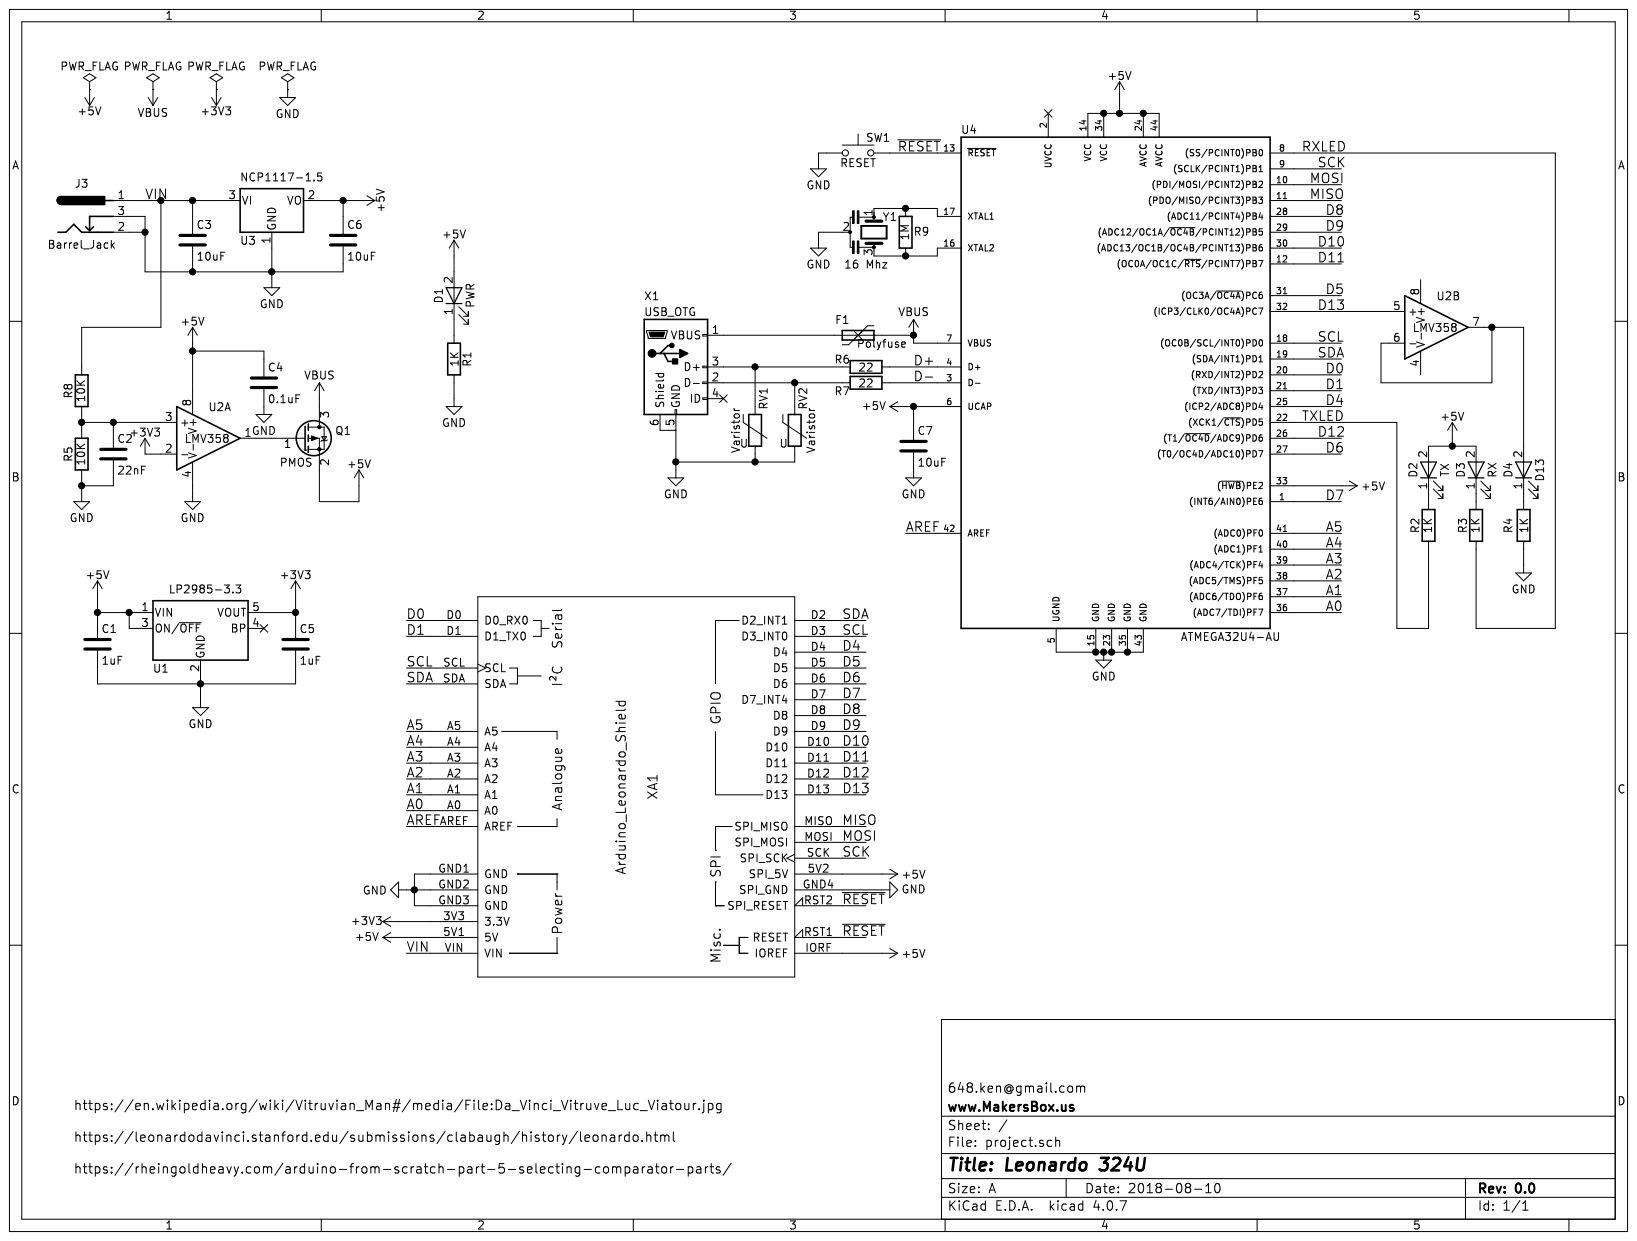
[picture p379: page 1]
