aspro648/KiCad/projects/Altimeter/docs/Project Schematic.pdf

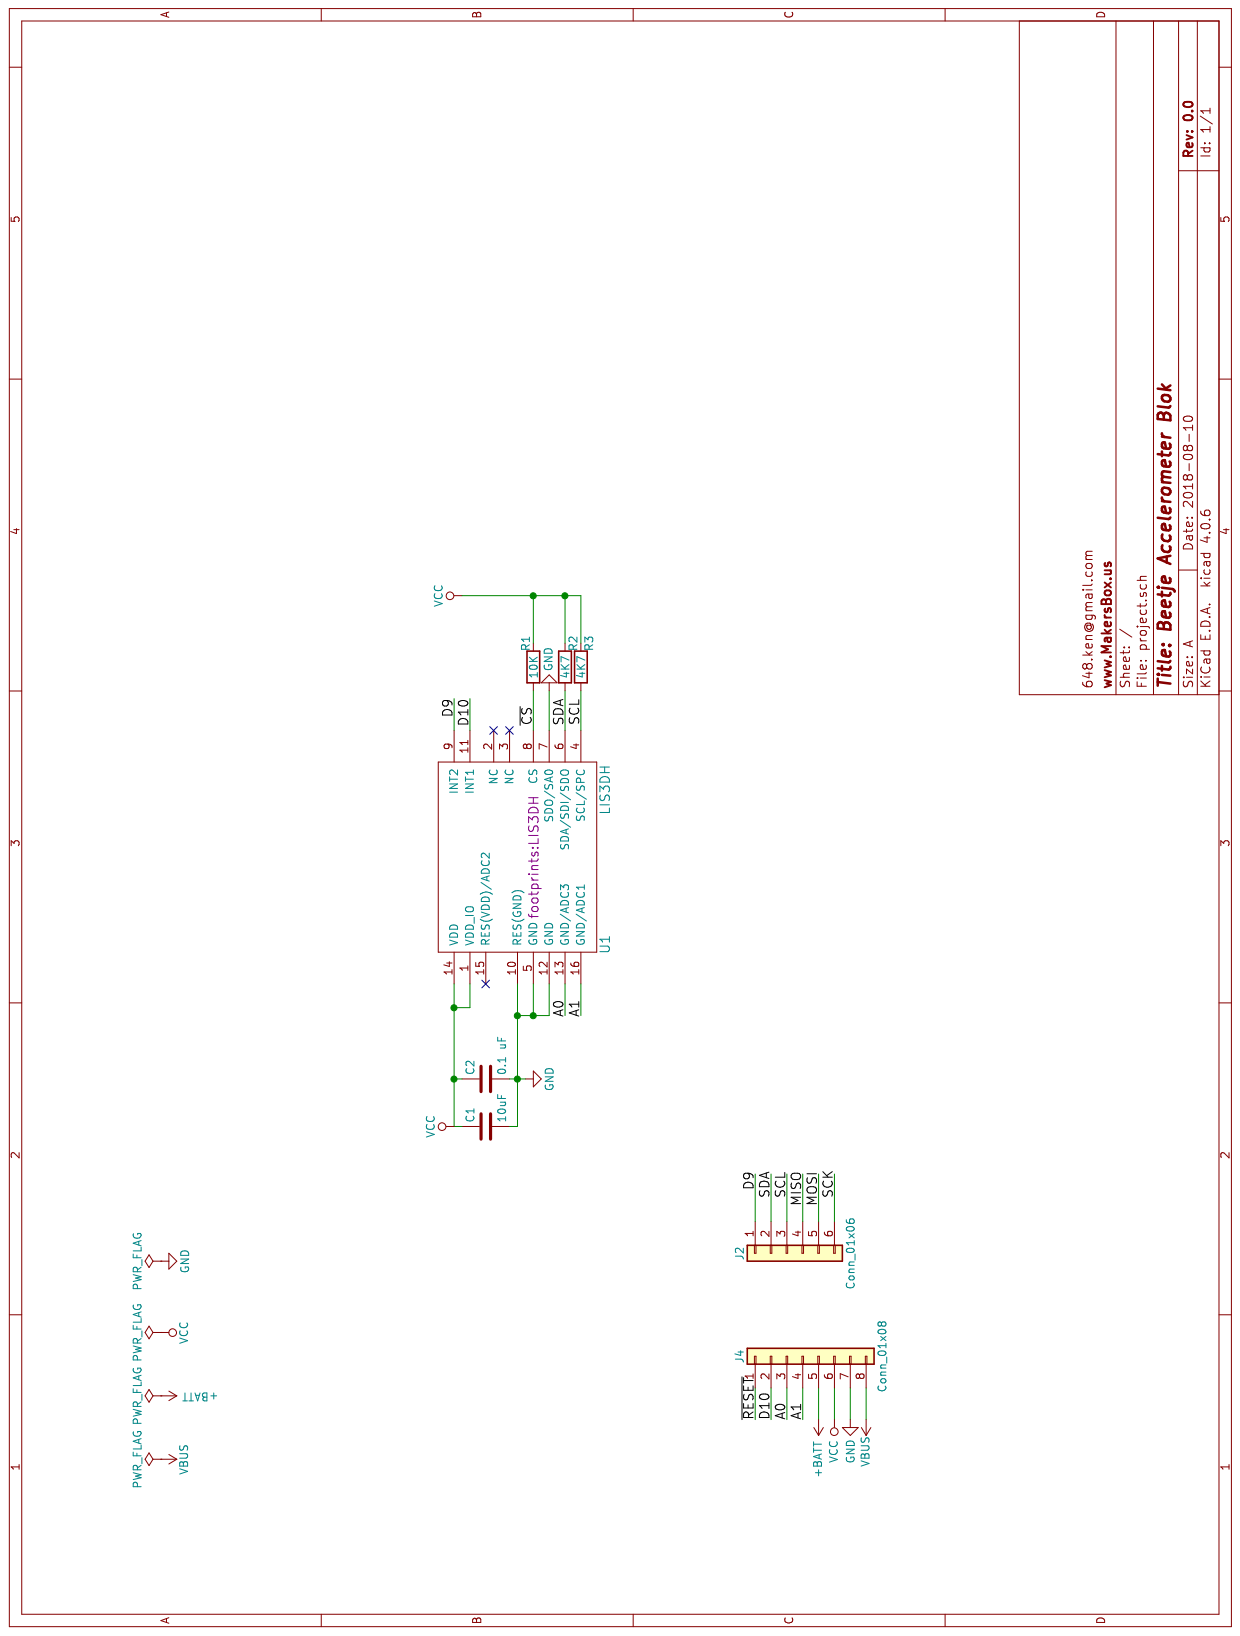
[picture p380: page 1]
