aspro648/KiCad/projects/Altimeter/docs/schematic.pdf

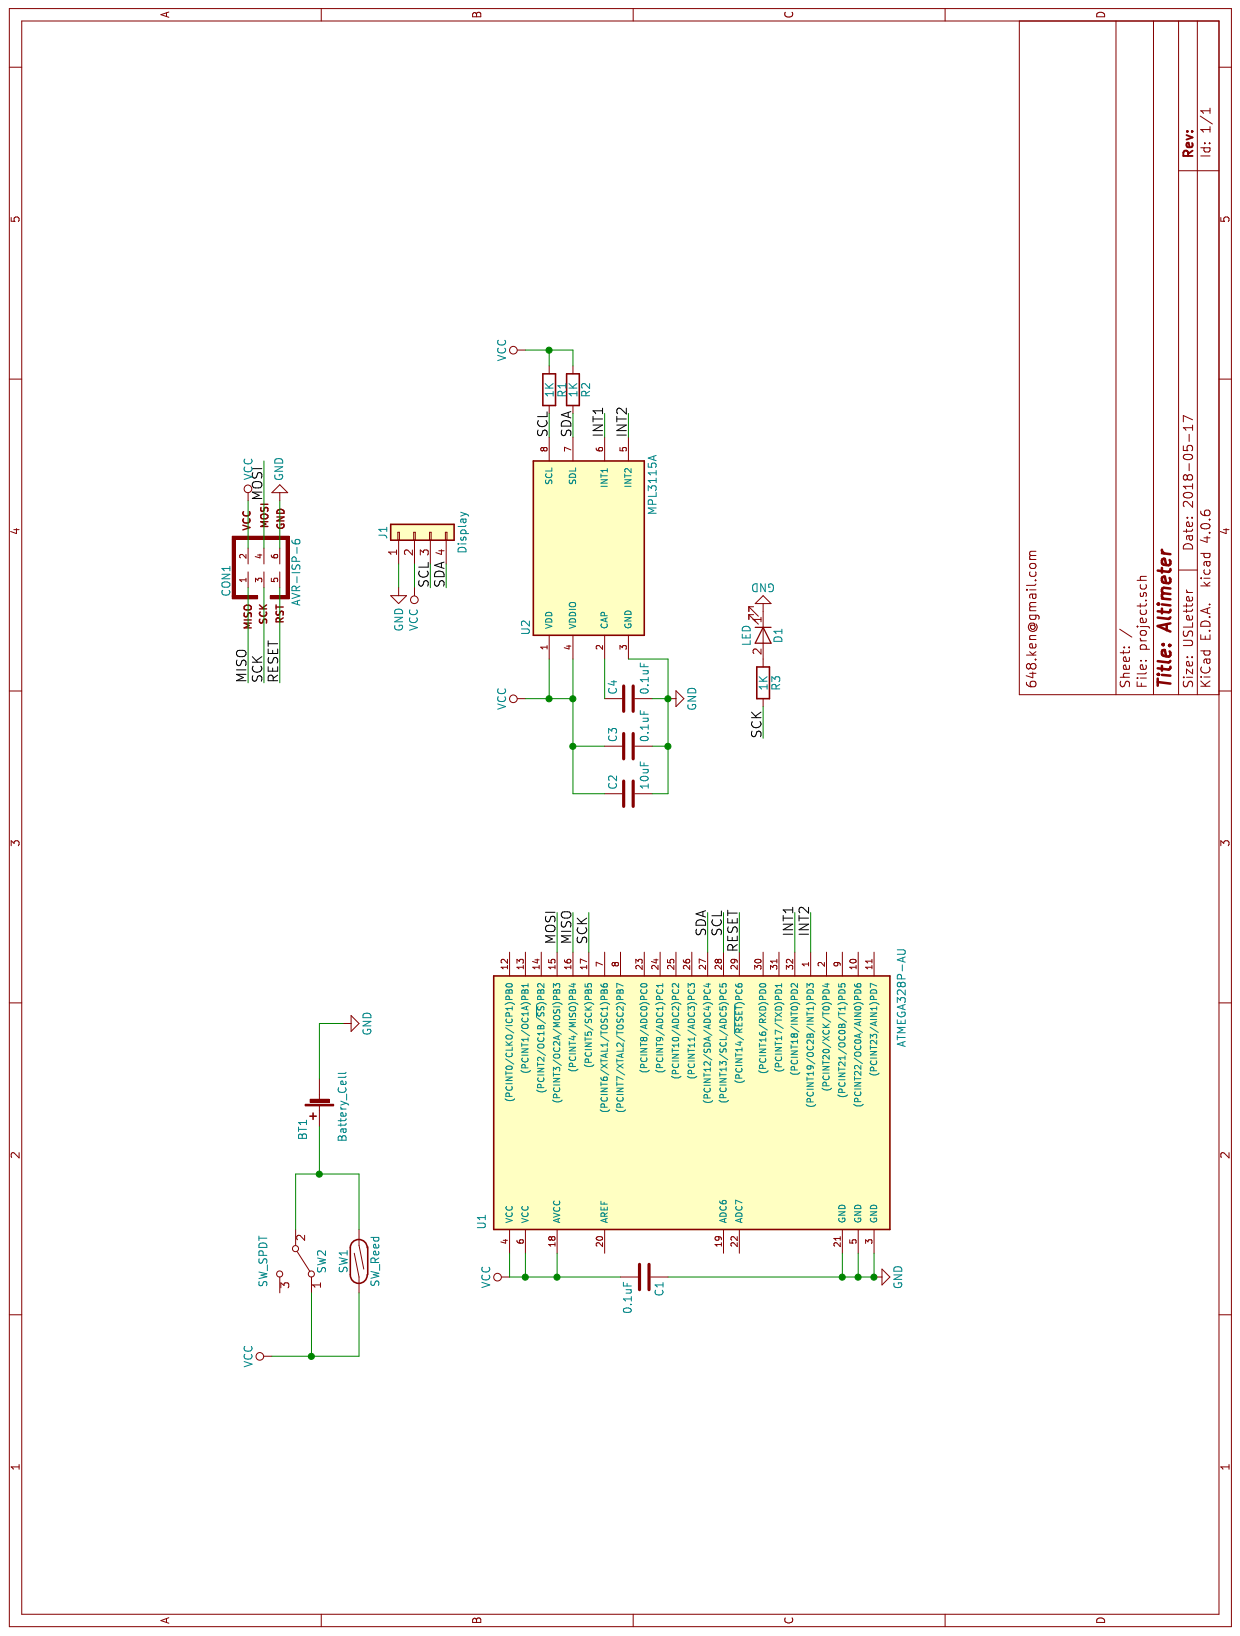
[picture p381: page 1]
