aspro648/KiCad/projects/Beetje/docs/schematic.pdf

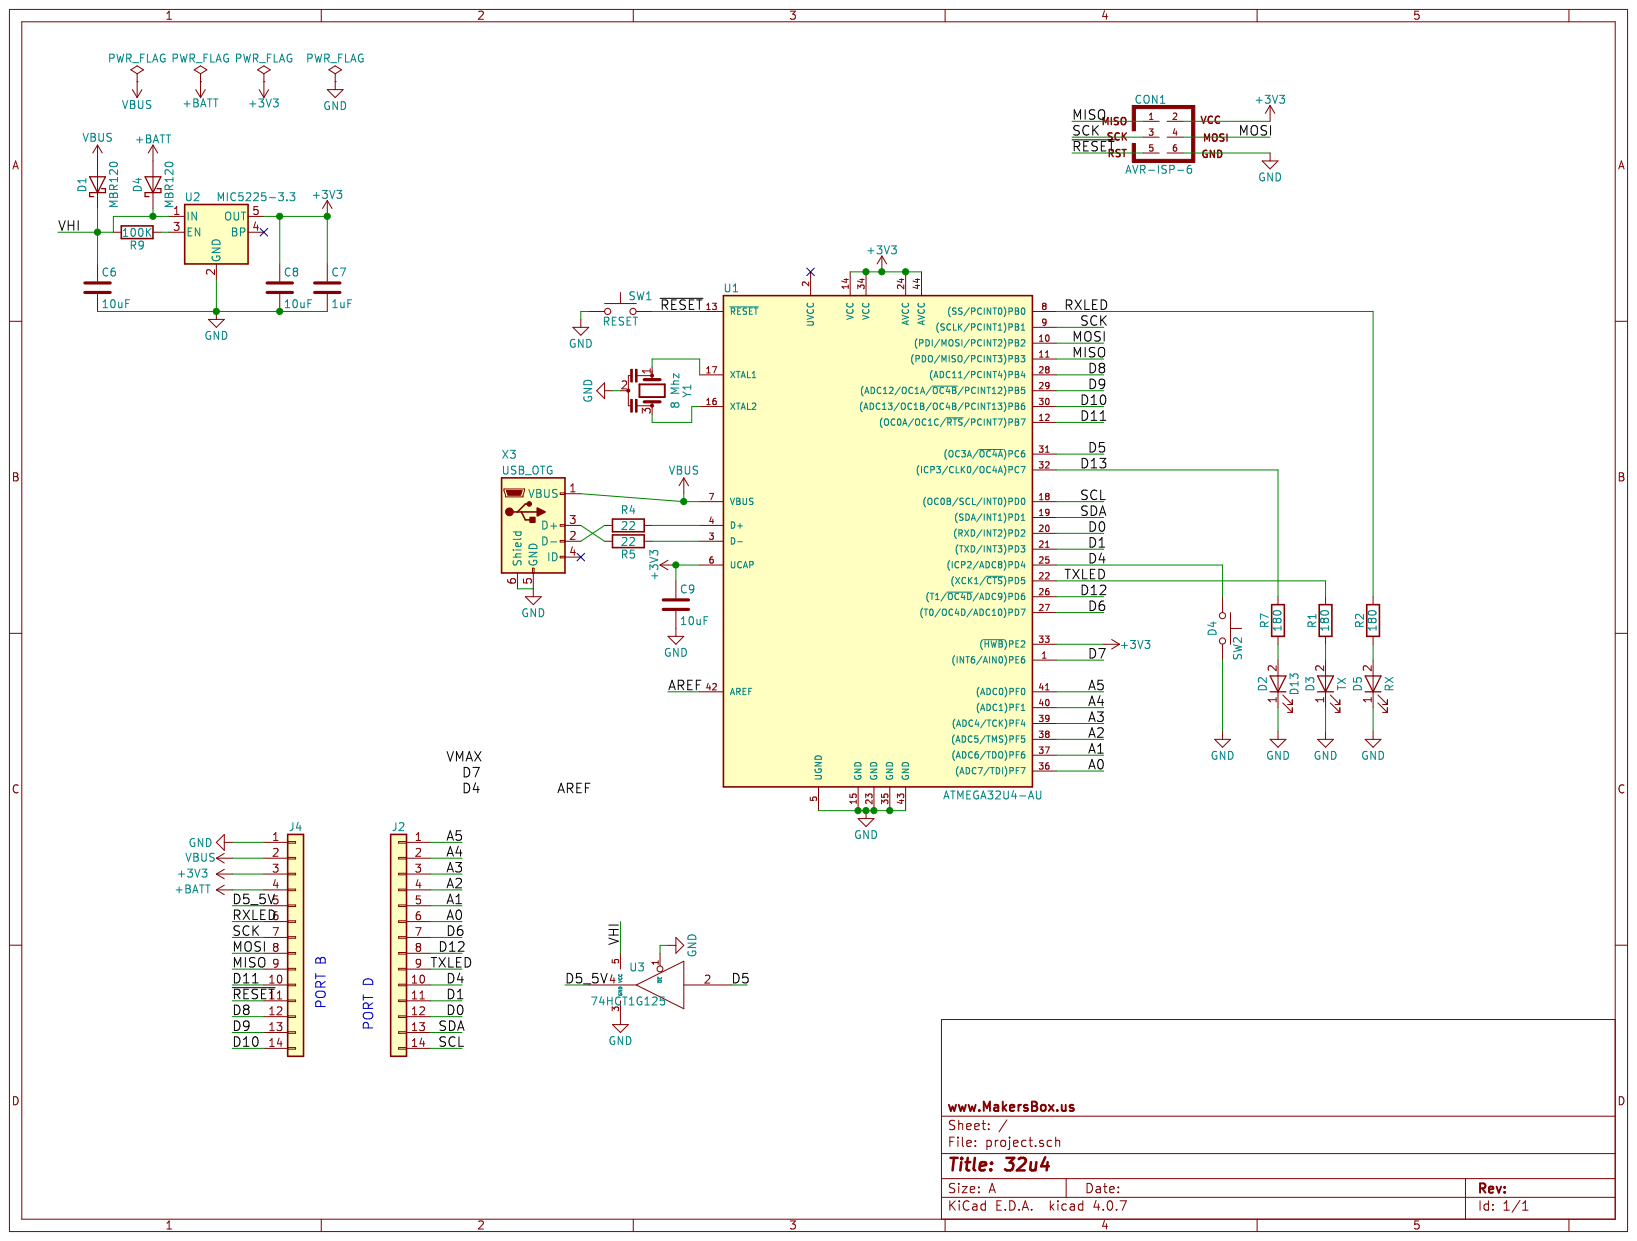
[picture p382: page 1]
