aspro648/KiCad/projects/translator/docs/schematics.pdf

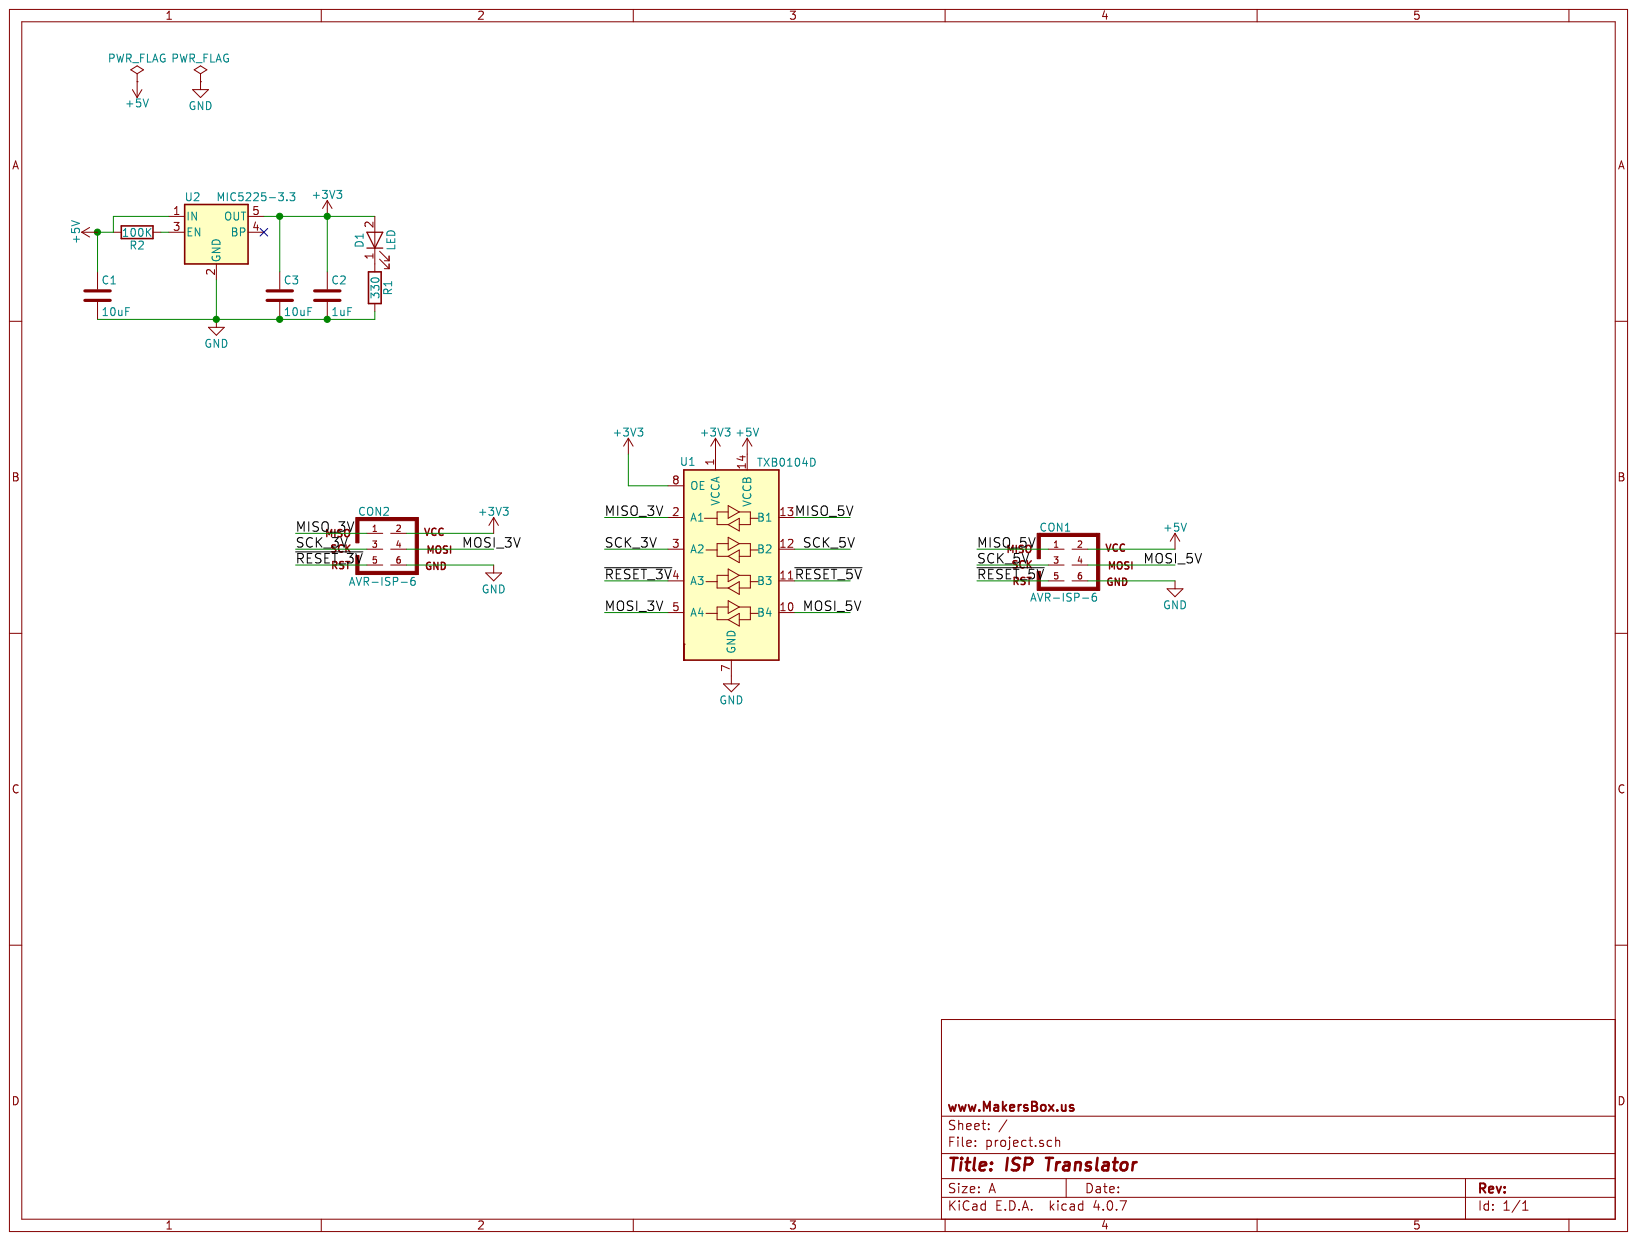
[picture p383: page 1]
