aspro648/KiCad/projects/clock/docs/clock_schematic.pdf

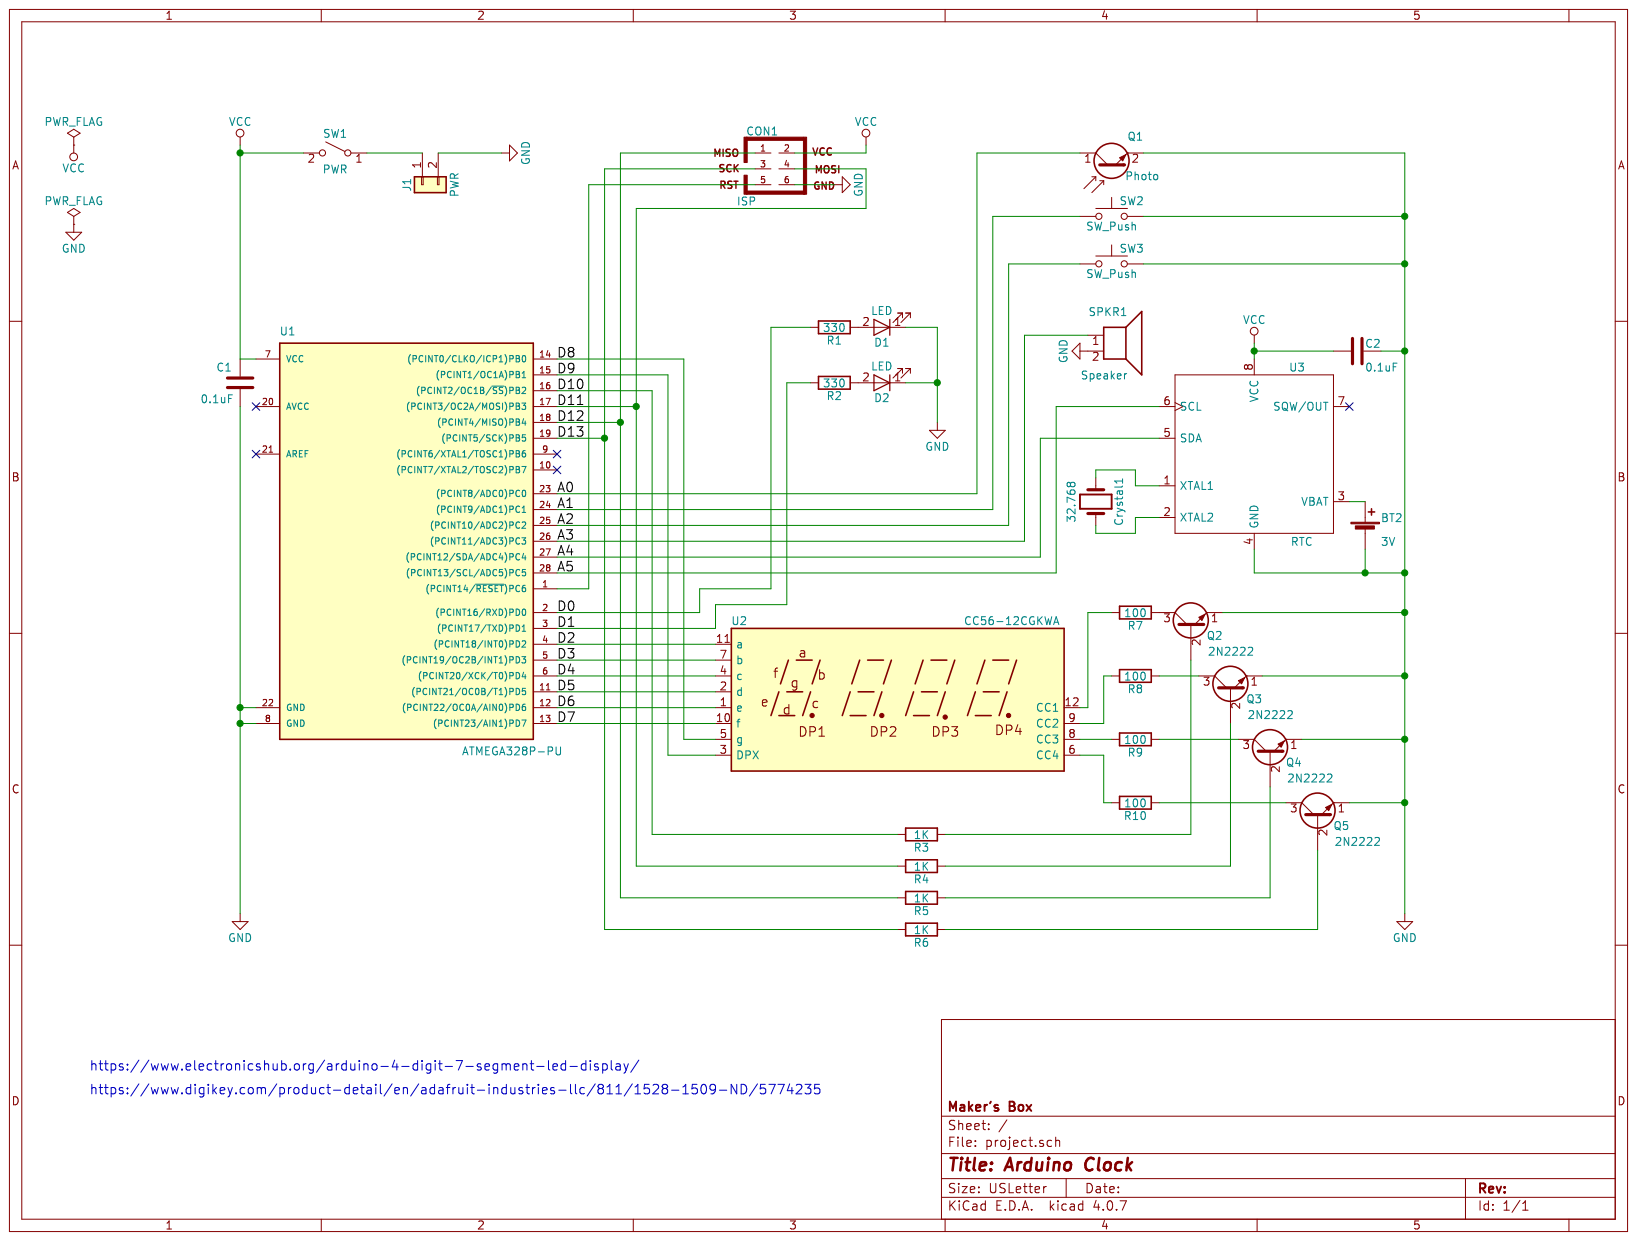
[picture p384: page 1]
