aspro648/KiCad/projects/JouleThief/design_files/Bat_clip_92.PDF

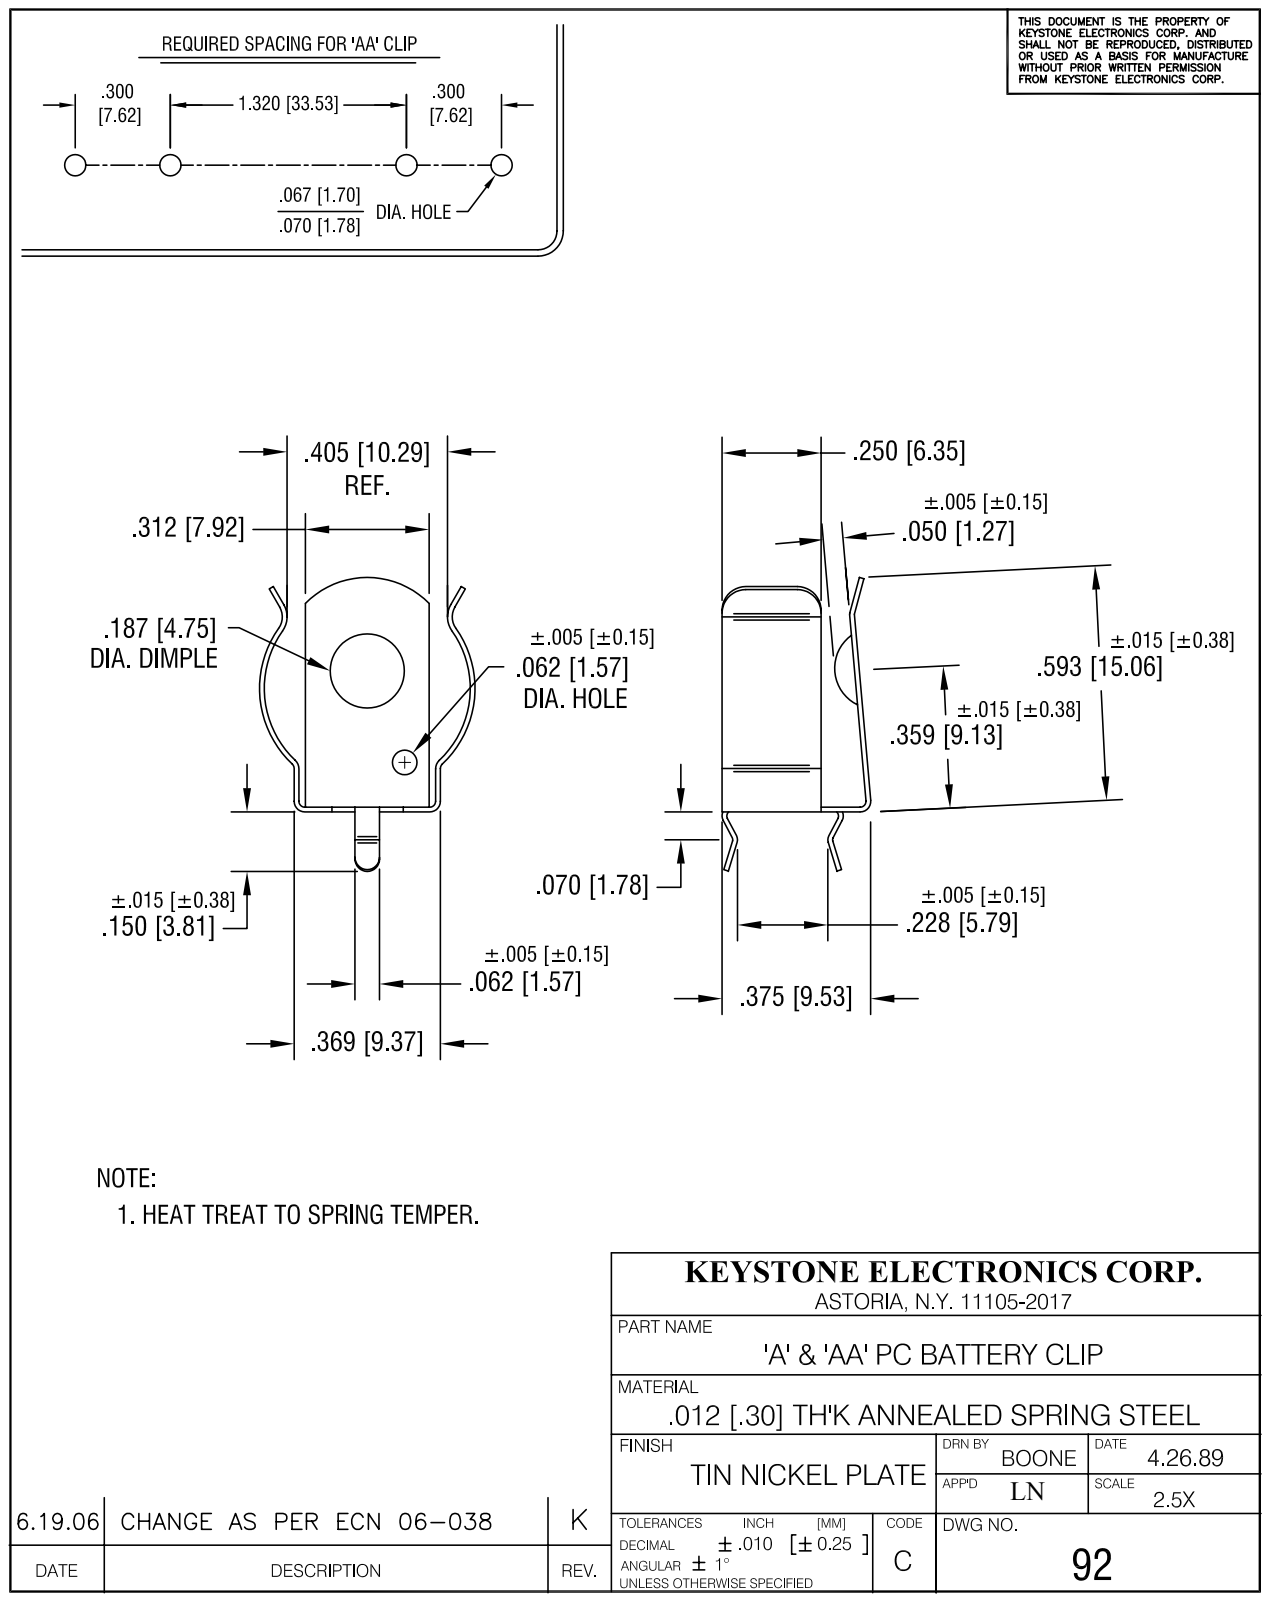
[picture p385: page 1]
