aspro648/KiCad/projects/JouleThief/design_files/JouleThief.pdf

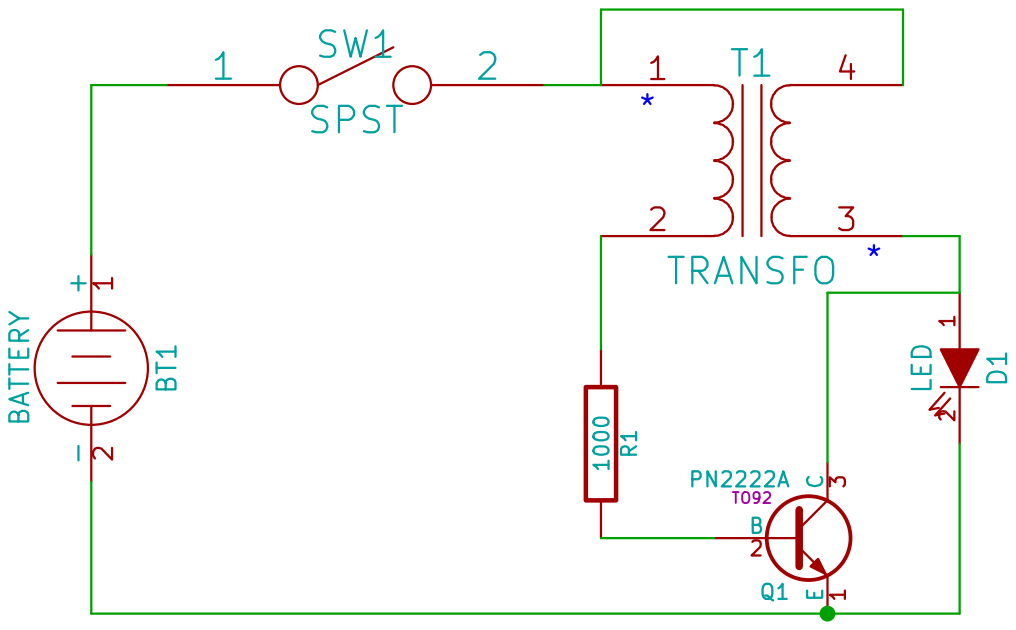
[picture p386: page 1]

Id: 1/1 Title: Joule Thief File: JouleThief.sch Sheet: /
