aspro648/KiCad/projects/HotWheels/Attiny/design_files Attiny826 LIS2 V1/locations.pdf

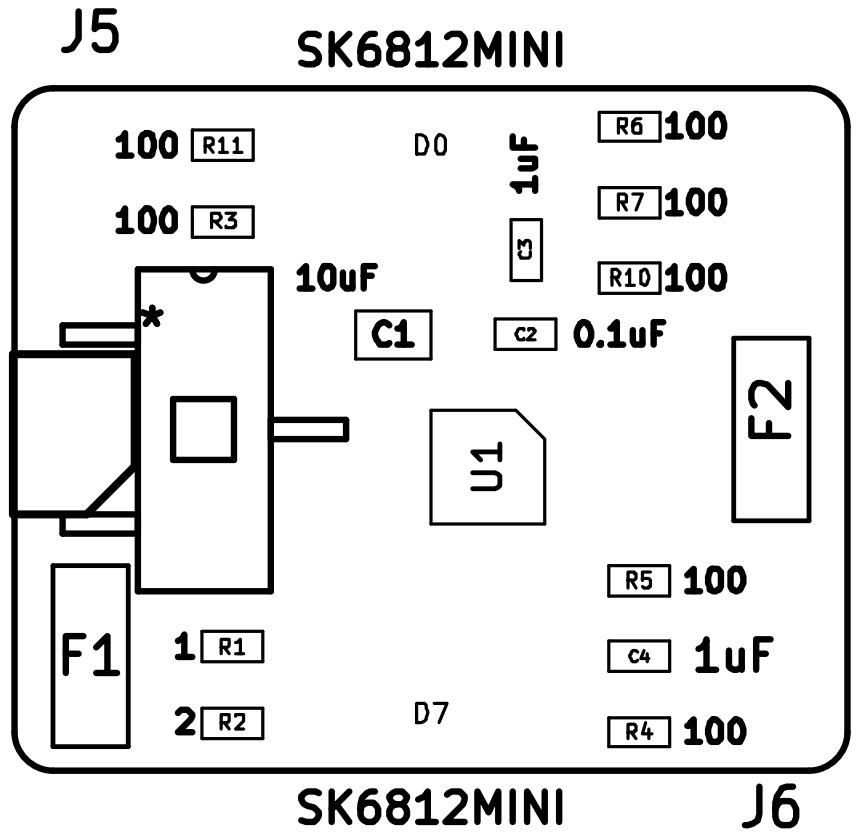
[picture p387: page 1]
