aspro648/KiCad/projects/HotWheels/Attiny/design_files Attiny826 V1/locations.pdf

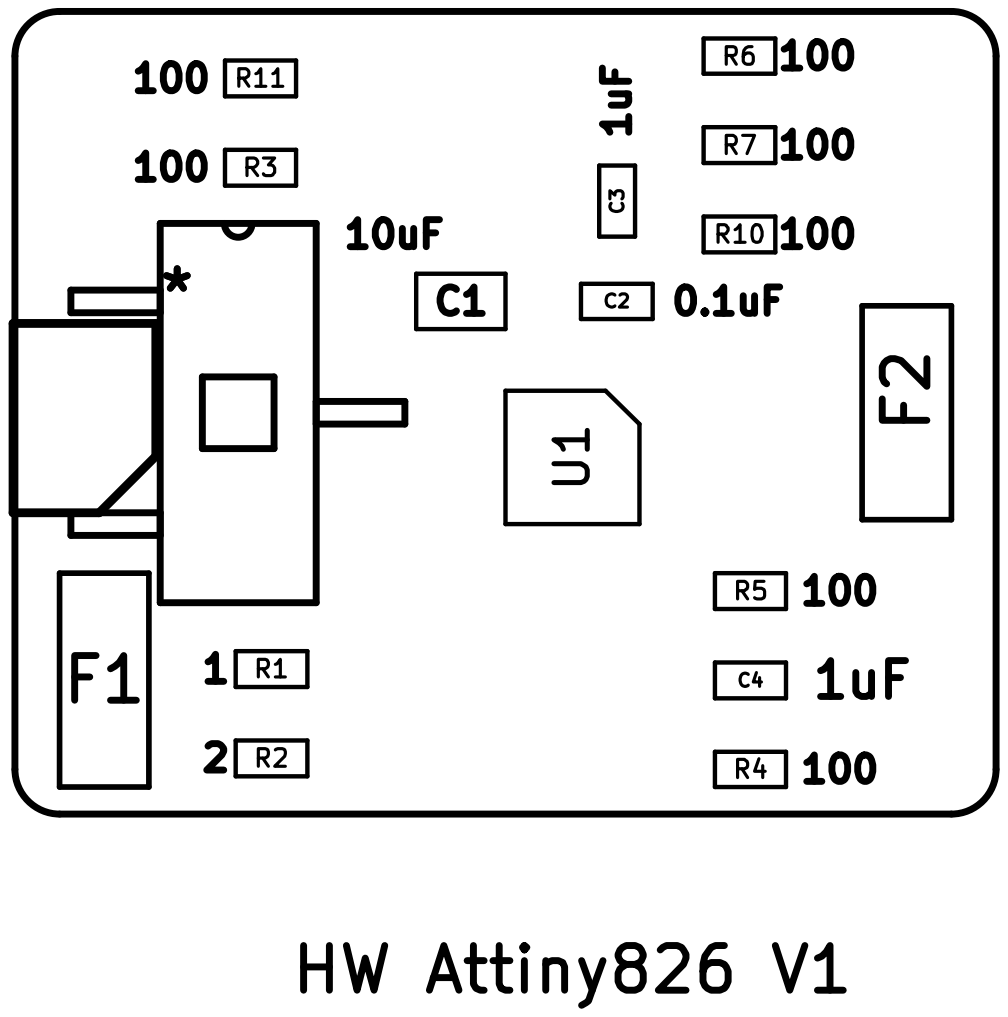
[picture p388: page 1]
