aspro648/KiCad/projects/HotWheels/Attiny/design_files Attiny826 V1/schematic.pdf

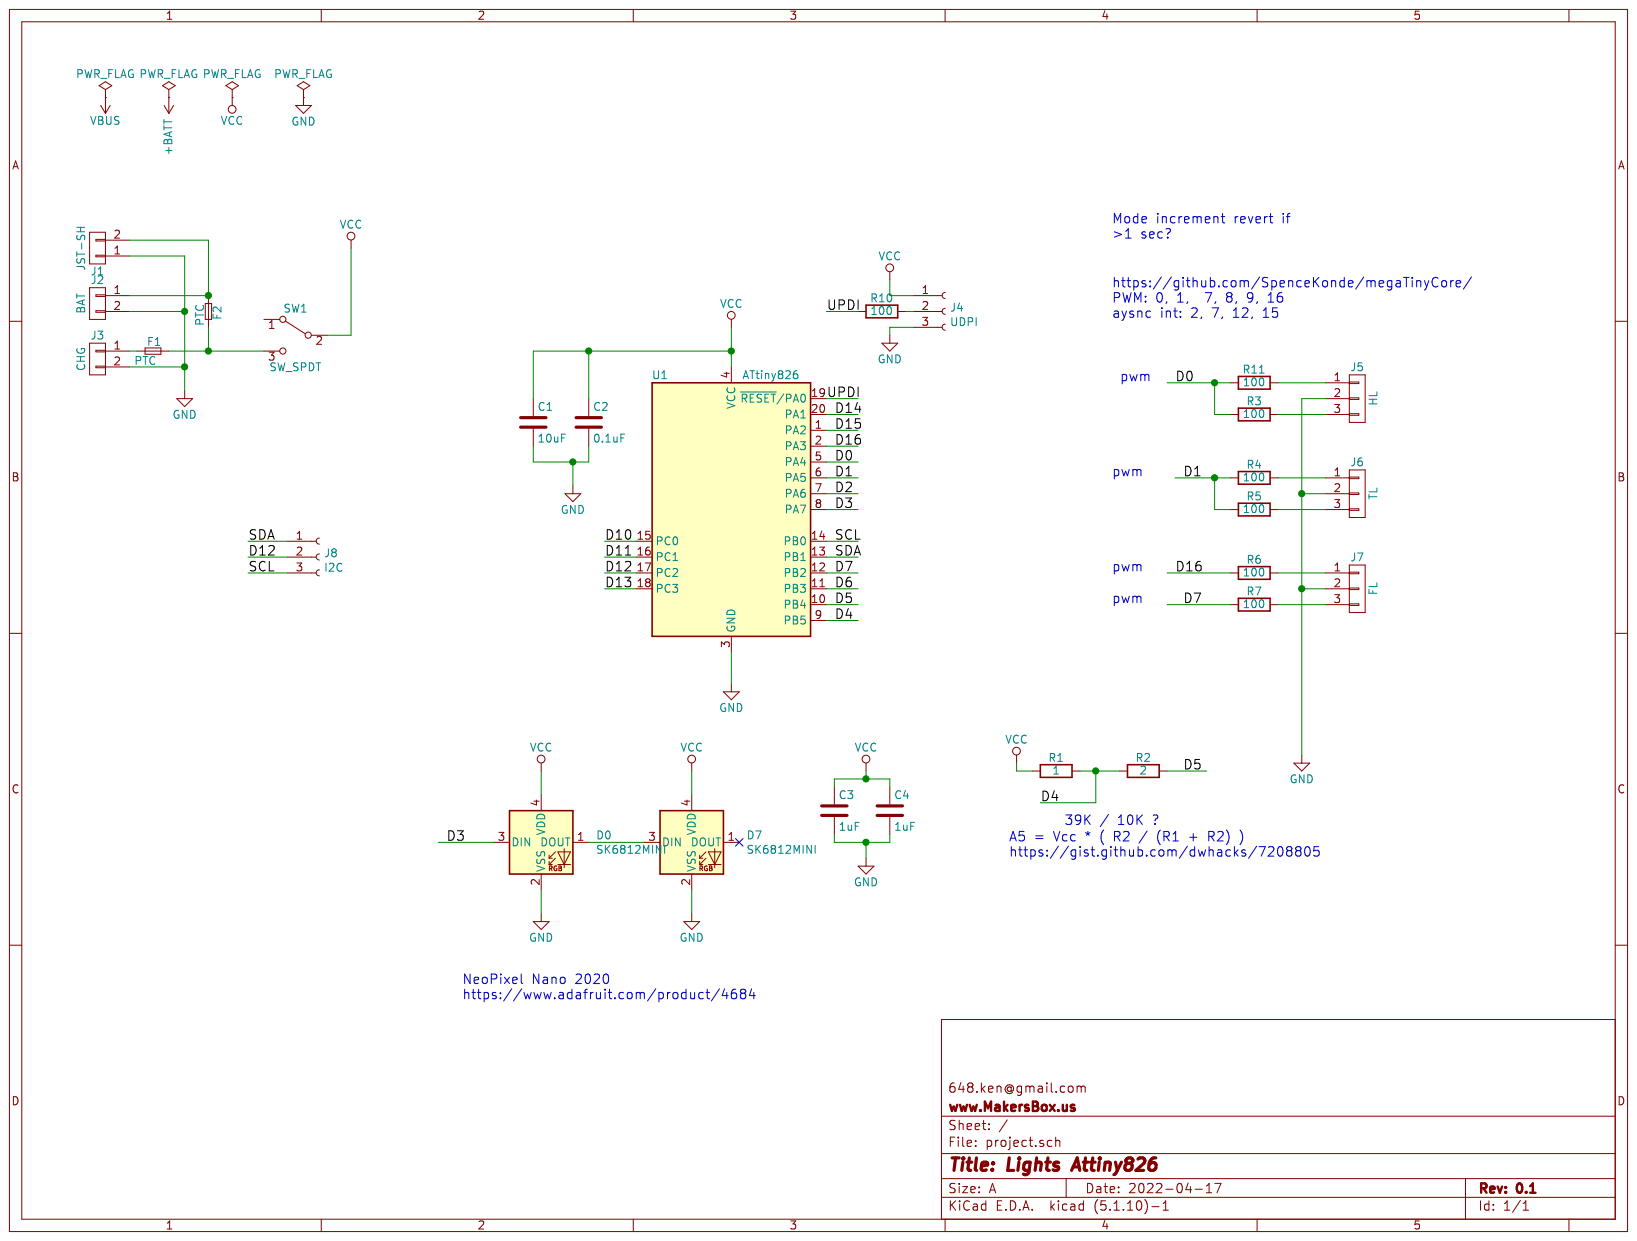
[picture p389: page 1]
