aspro648/KiCad/projects/HotWheels/Attiny/design_files Attiny826 LIS3DH V0/template.pdf

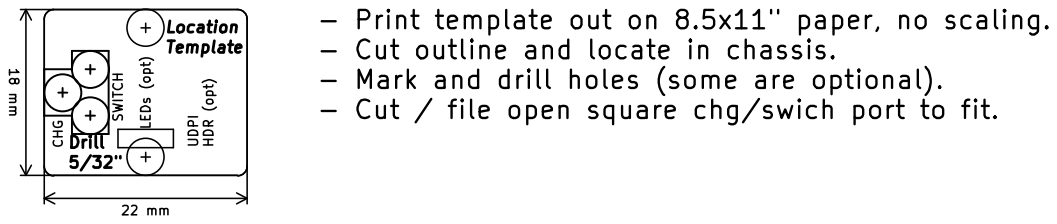
[picture p390: page 1]
