aspro648/KiCad/projects/Attiny/Cylon sew 2/docs/schematic.pdf

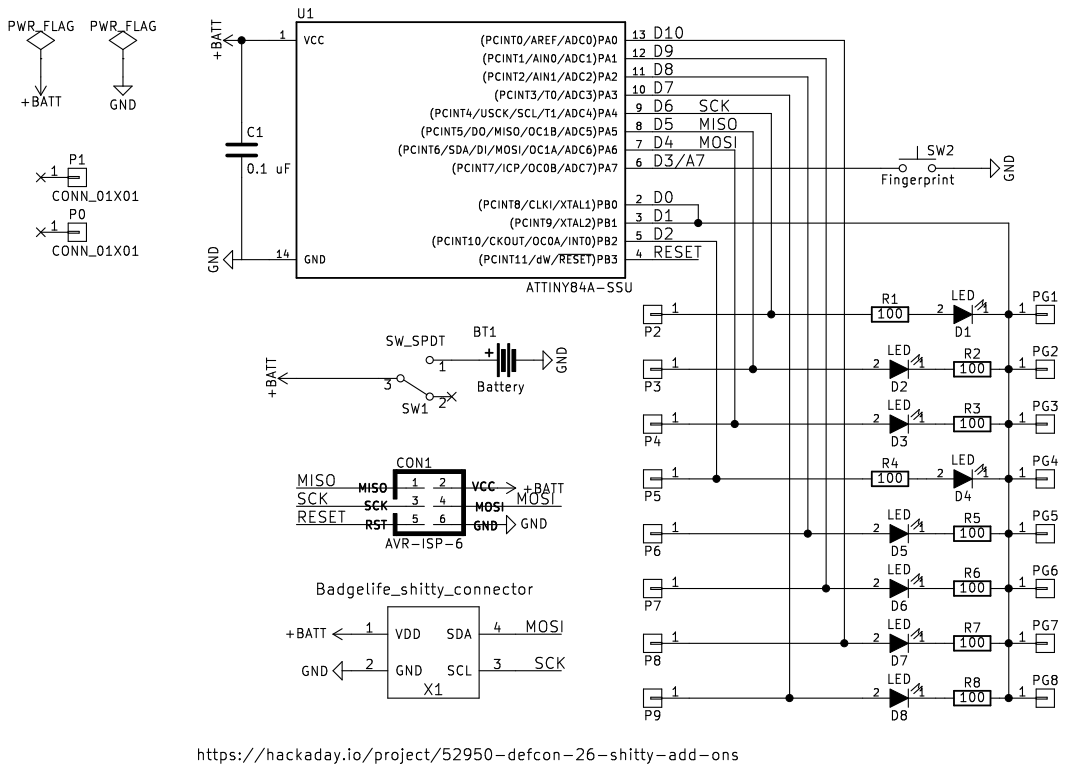
[picture p391: page 1]
