aspro648/KiCad/projects/Attiny/ISP_Pogo/docs/Schematic.pdf

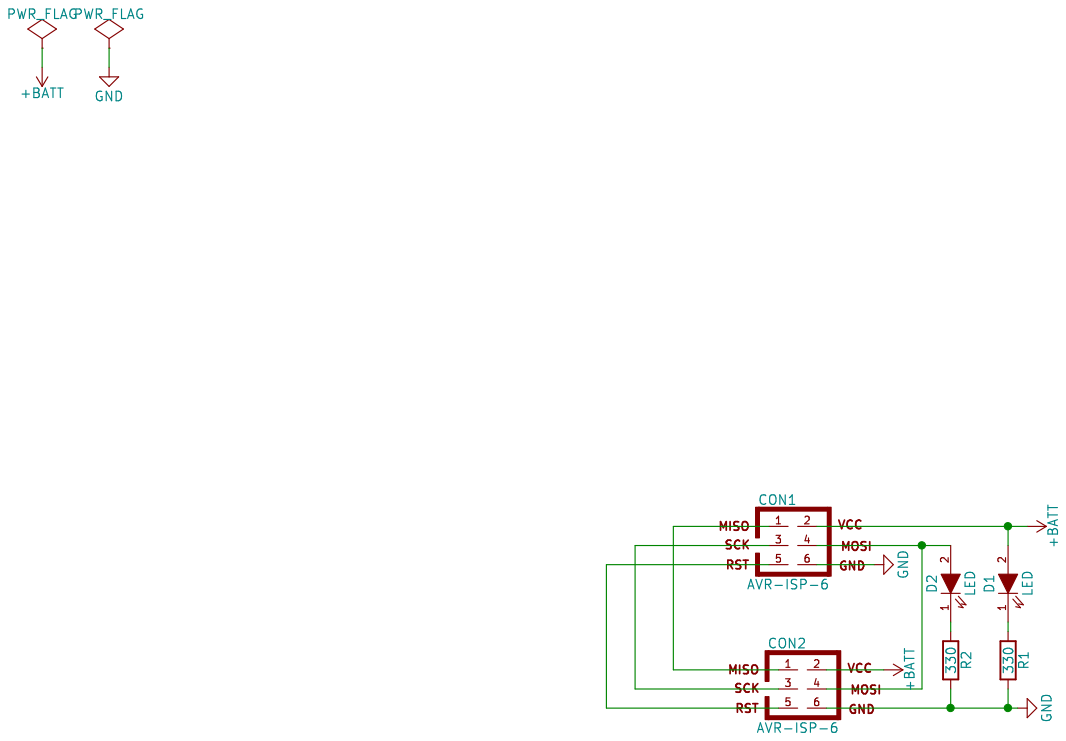
[picture p392: page 1]
