aspro648/KiCad/projects/Taillight/images/project.pdf

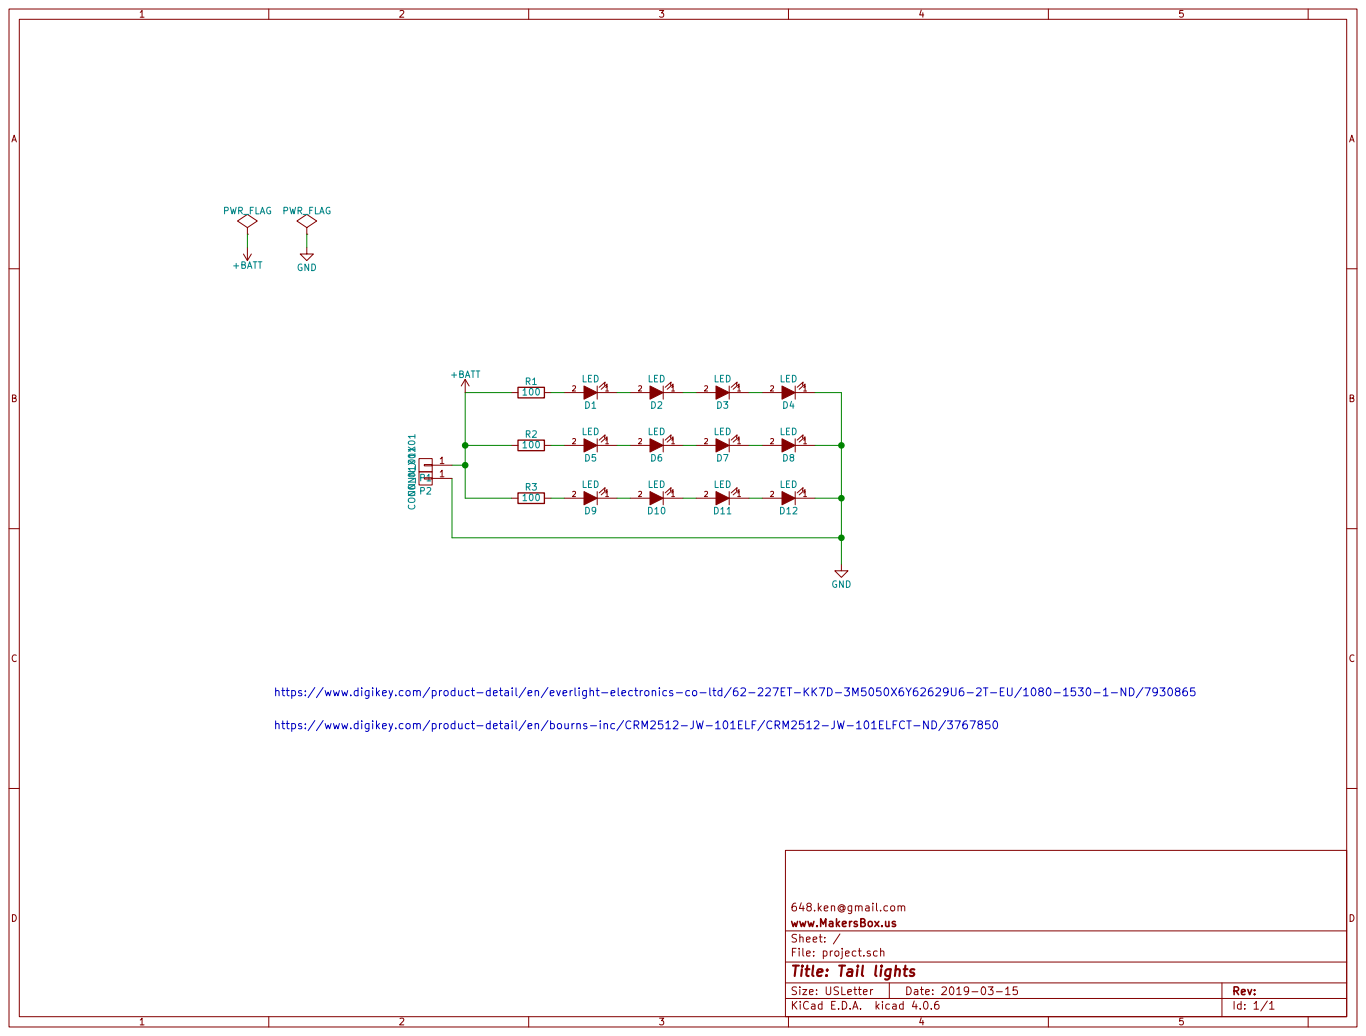
[picture p393: page 1]

https://www.digikey.com/product-detail/en/everlight-electronics-co-ltd/62-227ET-KK7D-3M5050X6Y62629U6-2T-EU/1080-1530-1-ND/7930865

https://www.digikey.com/product-detail/en/bourns-inc/CRM2512-JW-101ELF/CRM2512-JW-101ELFCT-ND/3767850

648.ken@gmail.com
File: project.sch Sheet: / www.MakersBox.us

Id: 1/1 Title: Tail lights
