aspro648/KiCad/projects/Arduino/Arduino/Turtle maze.pdf

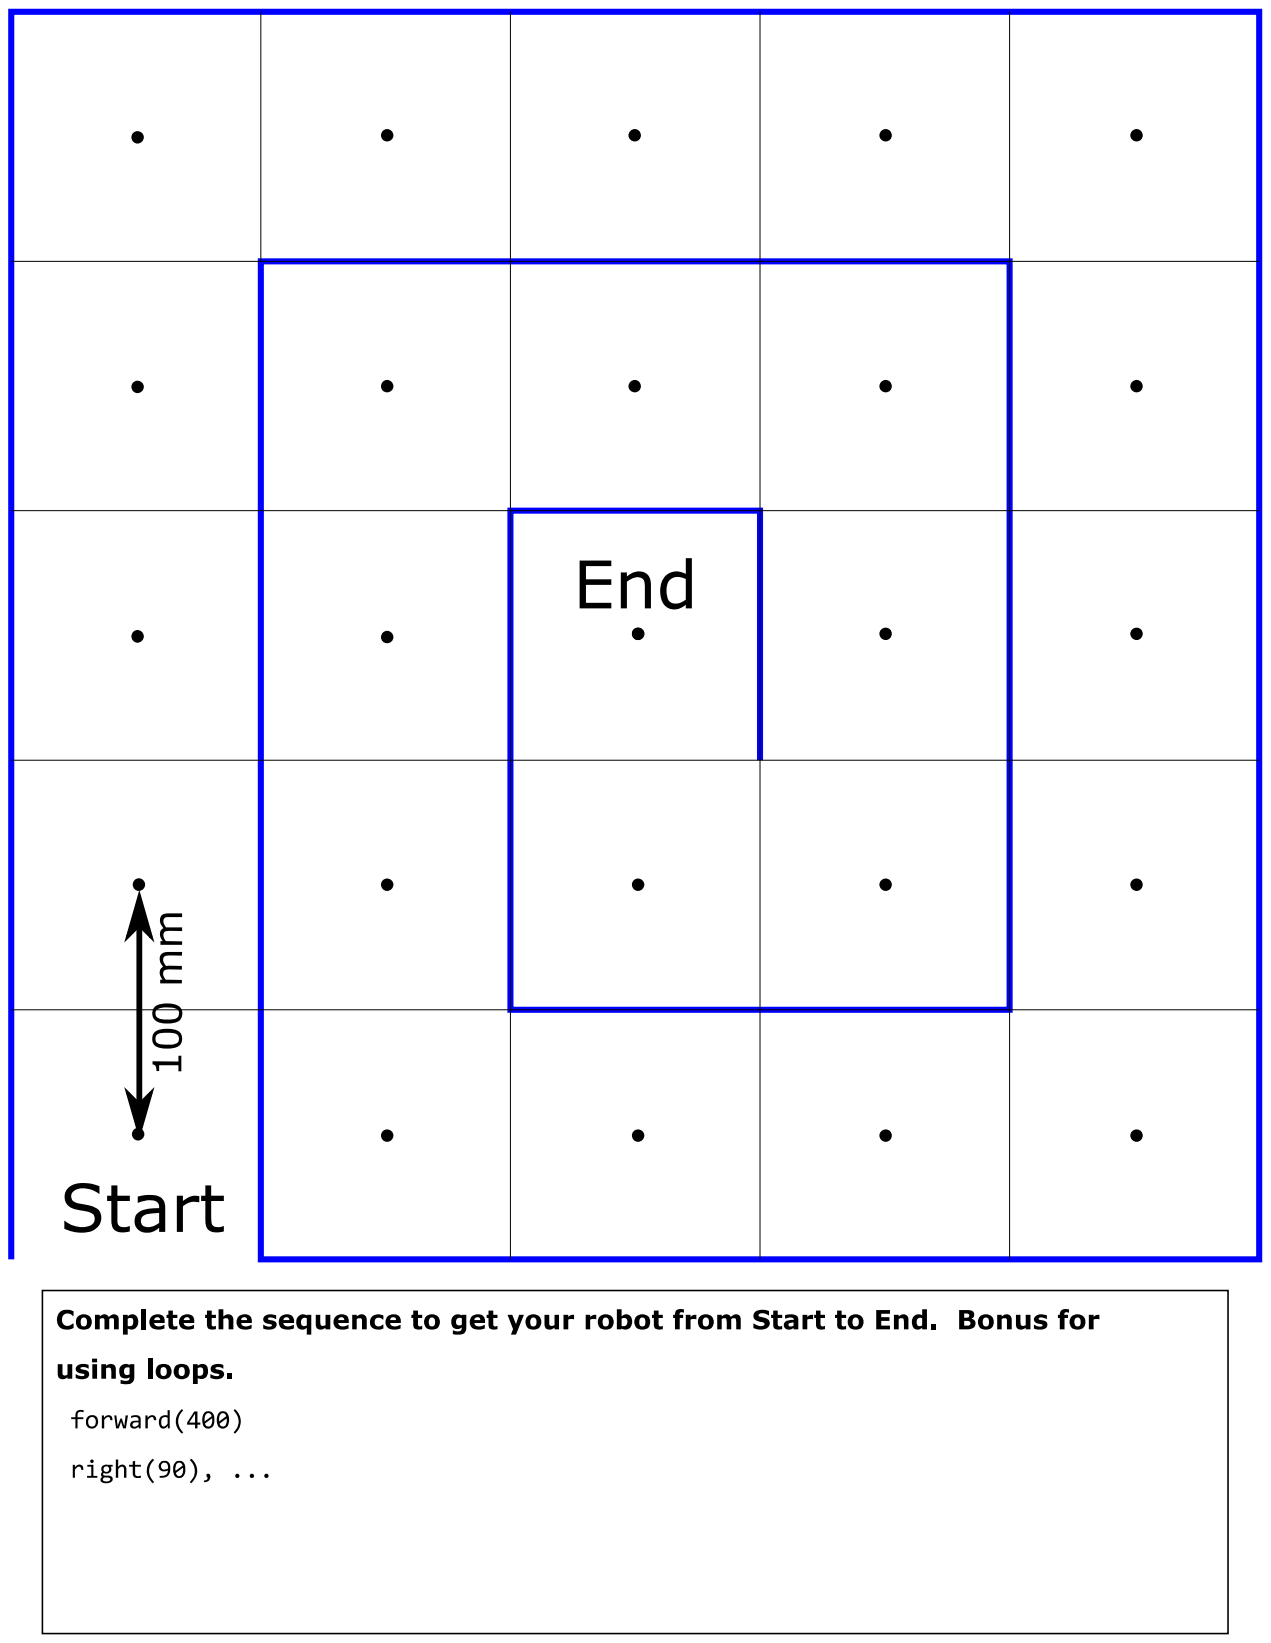
[picture p394: page 1]
