aspro648/KiCad/projects/Attiny/Attiny84SpinnerSMD/GeekSpinnerSMD_01.pdf

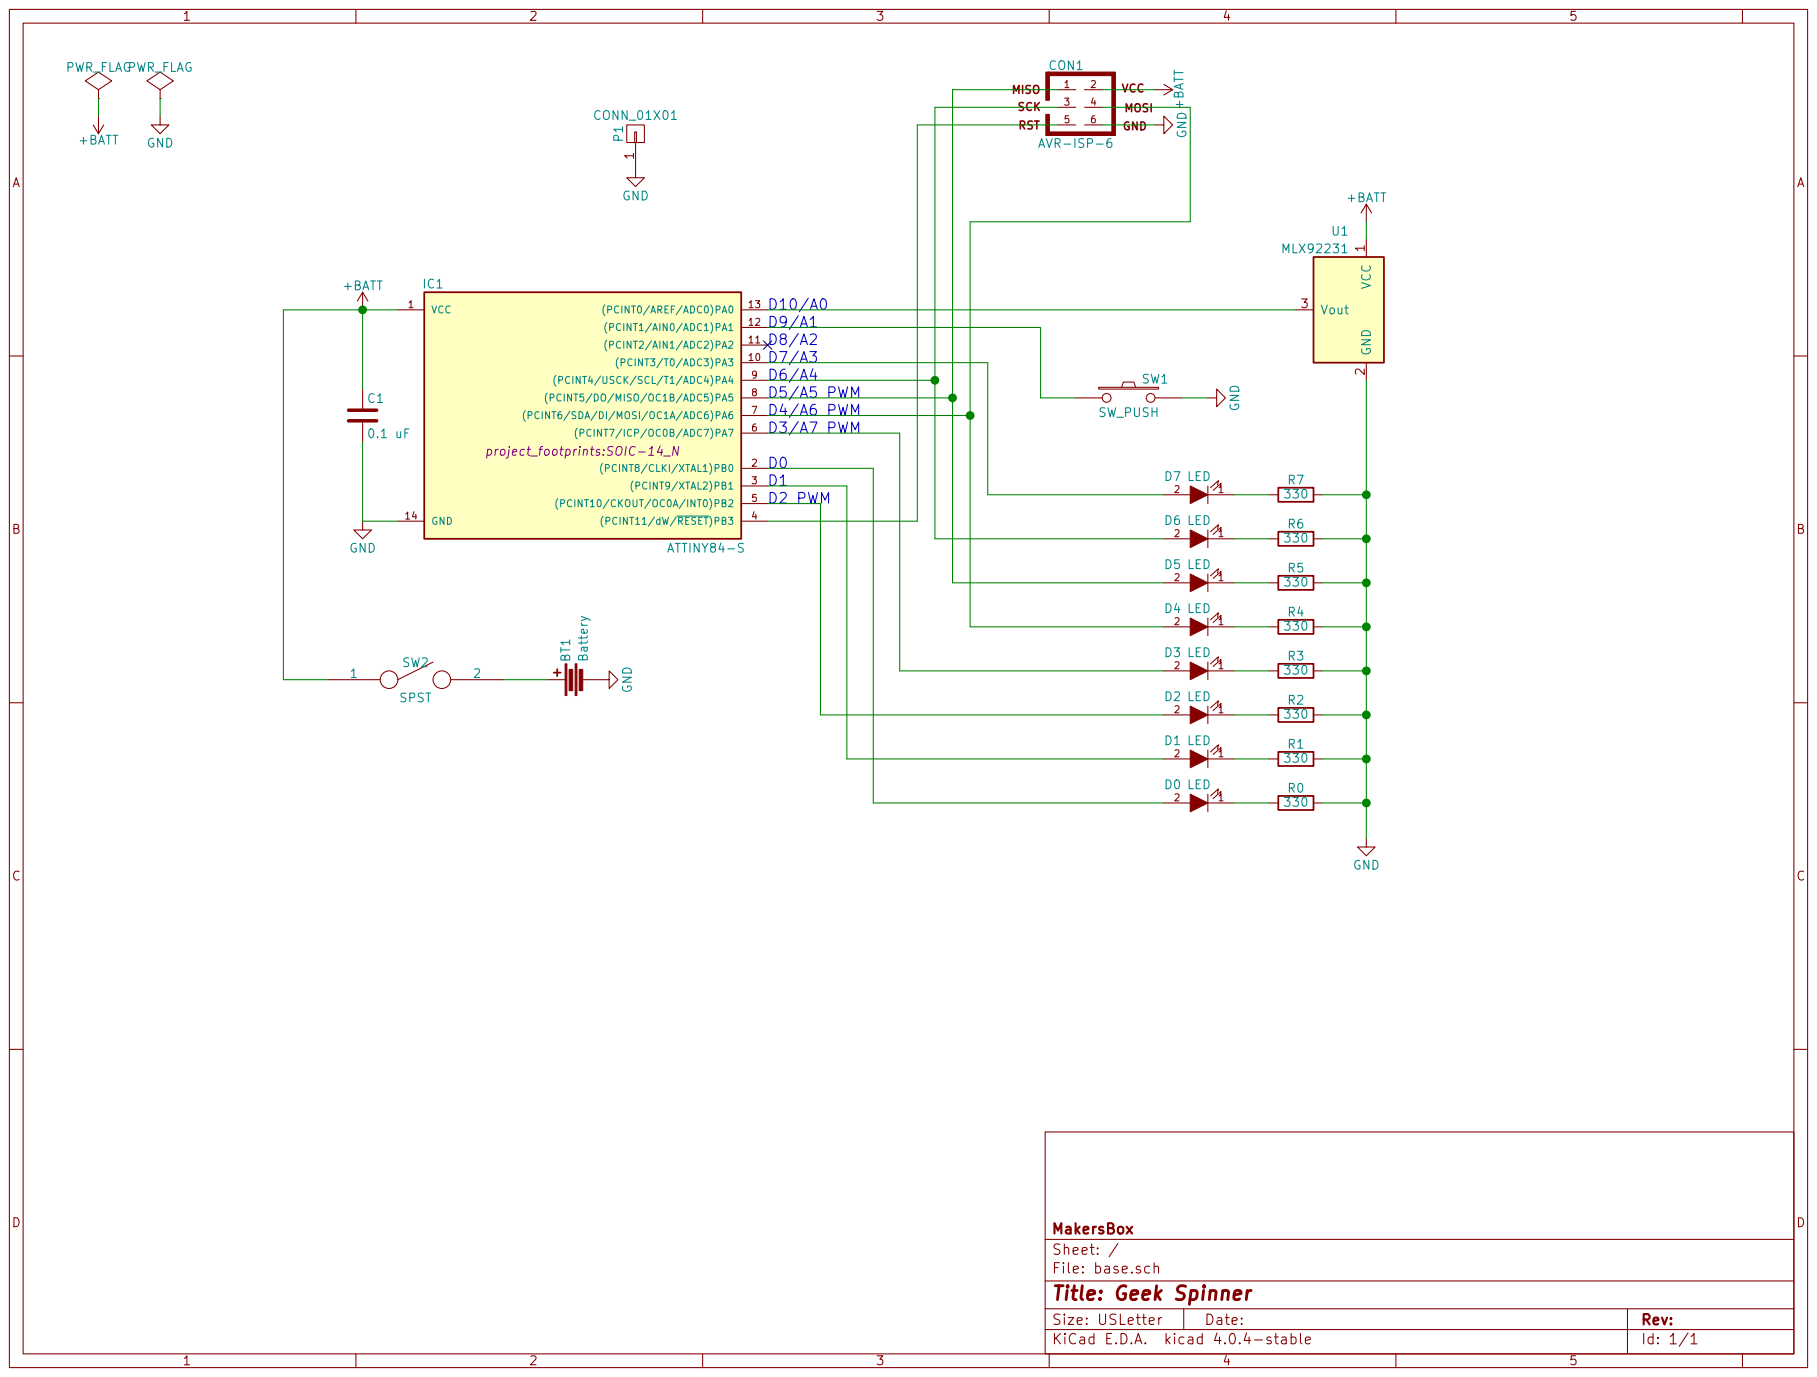
[picture p395: page 1]

Id: 1/1 Title: Geek Spinner File: base.sch Sheet: / MakersBox
