aspro648/KiCad/(list of files, drawings)

Other design files:
projects/Nerf/NerfChrono3/documents/Fritzing Sketch Single Gate.fzz
projects/Nerf/NerfChrono3/documents/Fritzing Sketch.fzz
projects/Nerf/NerfChrono4/documents/Fritzing Sketch.fzz
