aspro648/KiCad/projects/LEGO/design_files_attiny826_LEDs/project.kicad_pcb

## KiCad design projects/LEGO/design_files_attiny826_LEDs/project.kicad_pcb (2022-12-13)

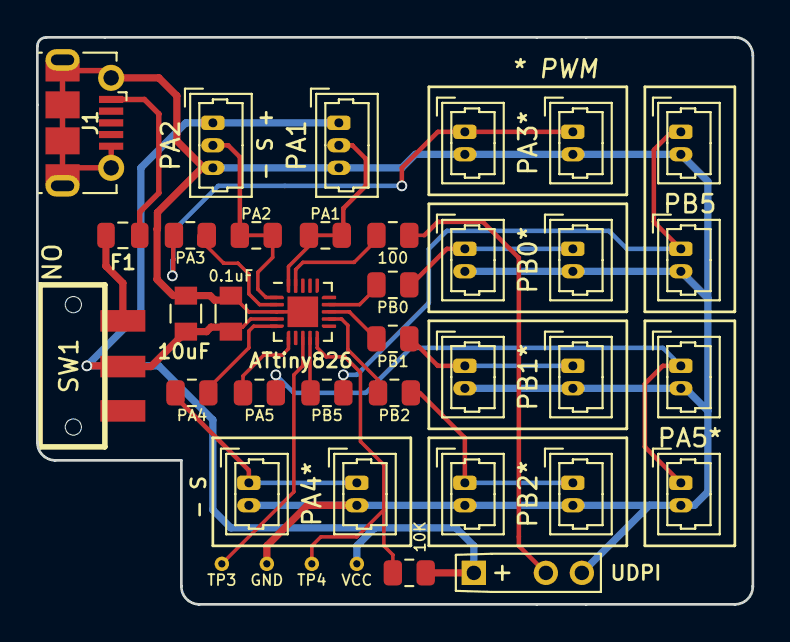
[picture p396: board projects/LEGO/design_files_attiny826_LEDs/project.kicad_pcb from above]

Board: 2 copper layers, 39.8 x 31.5 mm, 38 parts (0 on the bottom side), 24 nets.

Parts:
C1: 10uF; C_0805
C2: 0.1uF; C_0805
F1: Polyfuse; Fuse_0805_2012Metric
J1: USB-MICRO; USB_Micro-B_Molex-105017-0001
J2, J10: PA4*; Molex_PicoBlade_53047-0210_1x02_P1.25mm_Vertical
J3: UDPI; UDPI_header
J4, J11: PA5*; Molex_PicoBlade_53047-0210_1x02_P1.25mm_Vertical
J5, J12: PB2*; Molex_PicoBlade_53047-0210_1x02_P1.25mm_Vertical
J6, J13: PB0*; Molex_PicoBlade_53047-0210_1x02_P1.25mm_Vertical
J7, J15: PB1*; Molex_PicoBlade_53047-0210_1x02_P1.25mm_Vertical
J8, J16: PA3*; Molex_PicoBlade_53047-0210_1x02_P1.25mm_Vertical
J9: PA2; Molex_PicoBlade_53047-0310_1x03_P1.25mm_Vertical
J14: PA1; Molex_PicoBlade_53047-0310_1x03_P1.25mm_Vertical
J17, J18: PB5; Molex_PicoBlade_53047-0210_1x02_P1.25mm_Vertical
JP1: PA2; J_0805
JP2: PA1; J_0805
R1: PA5; R_0805_2012Metric
R2: PB2; R_0805_2012Metric
R3: 100; R_0805_2012Metric
R4: PB0; R_0805_2012Metric
R5: PB1; R_0805_2012Metric
R6: PA4; R_0805_2012Metric
R7: PA3; R_0805_2012Metric
R8: PB5; R_0805_2012Metric
R9: 10K; R_0805_2012Metric
SW1: SW_SPST; SPST_SMD
TP1: GND; TestPoint
TP2: VCC; TestPoint
TP3: PA7; TestPoint
TP4: PB4; TestPoint
U1: ATtiny826; VQFN-20-1EP_3x3mm_P0.4mm_EP1.7x1.7mm

Connections:
/PIN_PA1: J14.2, JP2.1, JP2.2, U1.20
/PIN_PA2: J9.2, JP1.1, JP1.2, U1.1
/PIN_PA3: R7.1, U1.2
/PIN_PA4: R6.1, U1.5
/PIN_PA5: R1.1, U1.6
/PIN_PA7: TP3.1, U1.8
/PIN_PB0: R4.1, U1.14
/PIN_PB1: R5.1, U1.13
/PIN_PB2: R2.1, U1.12
/PIN_PB4: R9.2, TP4.1, U1.10
/PIN_PB5: R8.1, U1.9
/UPDI: R3.1, U1.19
GND: C1.2, C2.2, J1.5, J1.6, J2.2, J3.4, J4.2, J5.2, J6.2, J7.2, J8.2, J9.3, J10.2, J11.2, J12.2, J13.2, J14.3, J15.2, J16.2, J17.2, J18.2, TP1.1, U1.3, U1.21
unnamed: F1.2, J1.1
unnamed: J3.3, R3.2
unnamed: J2.1, J10.1, R6.2
unnamed: J4.1, J11.1, R1.2
unnamed: J5.1, J12.1, R2.2
unnamed: J6.1, J13.1, R4.2
unnamed: J7.1, J15.1, R5.2
unnamed: J8.1, J16.1, R7.2
unnamed: J17.1, J18.1, R8.2
VBUS: F1.1, SW1.1
VCC: C1.1, C2.1, J3.1, J9.1, J14.1, R9.1, SW1.2, TP2.1, U1.4
