aspro648/KiCad/projects/tester/UCT3/design_files_card Gecko/project.kicad_pcb

## KiCad design projects/tester/UCT3/design_files_card Gecko/project.kicad_pcb (2022-12-13)

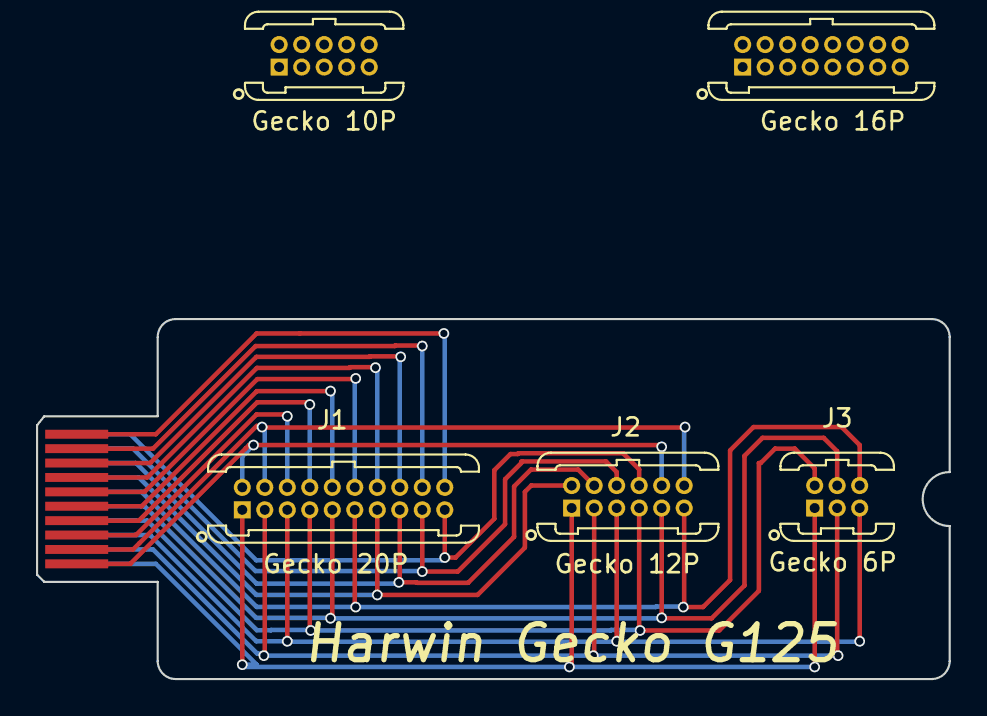
[picture p397: board projects/tester/UCT3/design_files_card Gecko/project.kicad_pcb from above]

Board: 2 copper layers, 50.7 x 20.0 mm, 4 parts (0 on the bottom side), 20 nets.

Parts:
J0: Edge; MEC8_card
J1: Gecko 20P; Harwin_Gecko-G125-MVX2005L0X_2x10_P1.25mm_Vertical
J2: Gecko 12P; Harwin_Gecko-G125-MVX1205L0X_2x06_P1.25mm_Vertical
J3: Gecko 6P; Harwin_Gecko-G125-MVX0605L0X_2x03_P1.25mm_Vertical

Connections:
/01: J0.1, J1.1, J2.1, J3.1
/02: J0.2, J1.2, J2.2, J3.2
/03: J0.3, J1.3, J2.3, J3.3
/04: J0.4, J1.4, J2.4, J3.4
/05: J0.5, J1.5, J2.5, J3.5
/06: J0.6, J1.6, J2.6, J3.6
/07: J0.7, J1.7, J2.7
/08: J0.8, J1.8, J2.8
/09: J0.9, J1.9, J2.9
/10: J0.10, J1.10, J2.10
/11: J0.11, J1.11, J2.11
/12: J0.12, J1.12, J2.12
/13: J0.13, J1.13
/14: J0.14, J1.14
/15: J0.15, J1.15
/16: J0.16, J1.16
/17: J0.17, J1.17
/18: J0.18, J1.18
/19: J0.19, J1.19
/20: J0.20, J1.20
