aspro648/KiCad/projects/tester/UCT3/design_files/project.kicad_pcb

## KiCad design projects/tester/UCT3/design_files/project.kicad_pcb (2022-12-13)

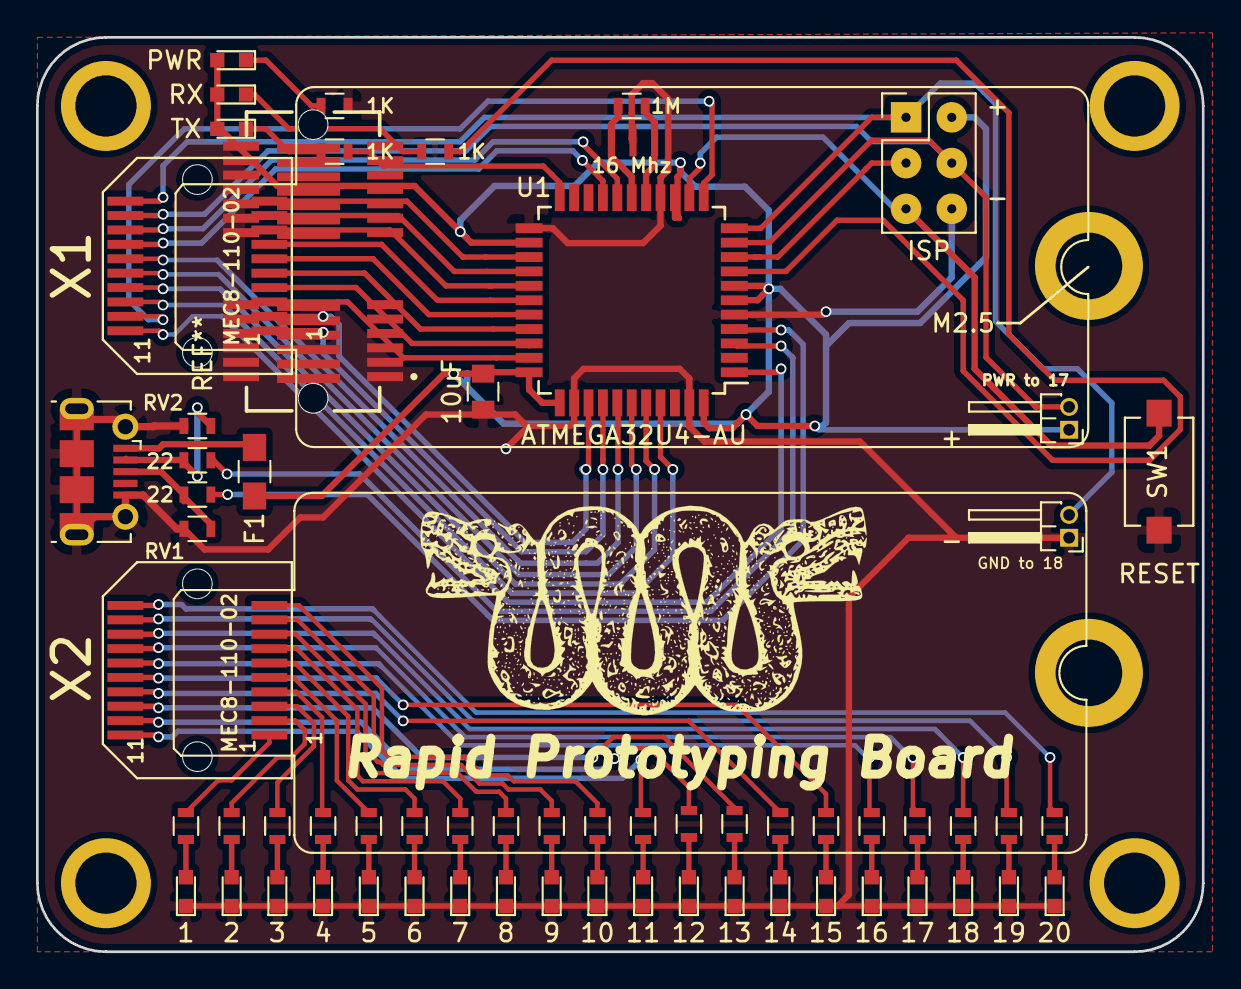
[picture p398: board projects/tester/UCT3/design_files/project.kicad_pcb from above]

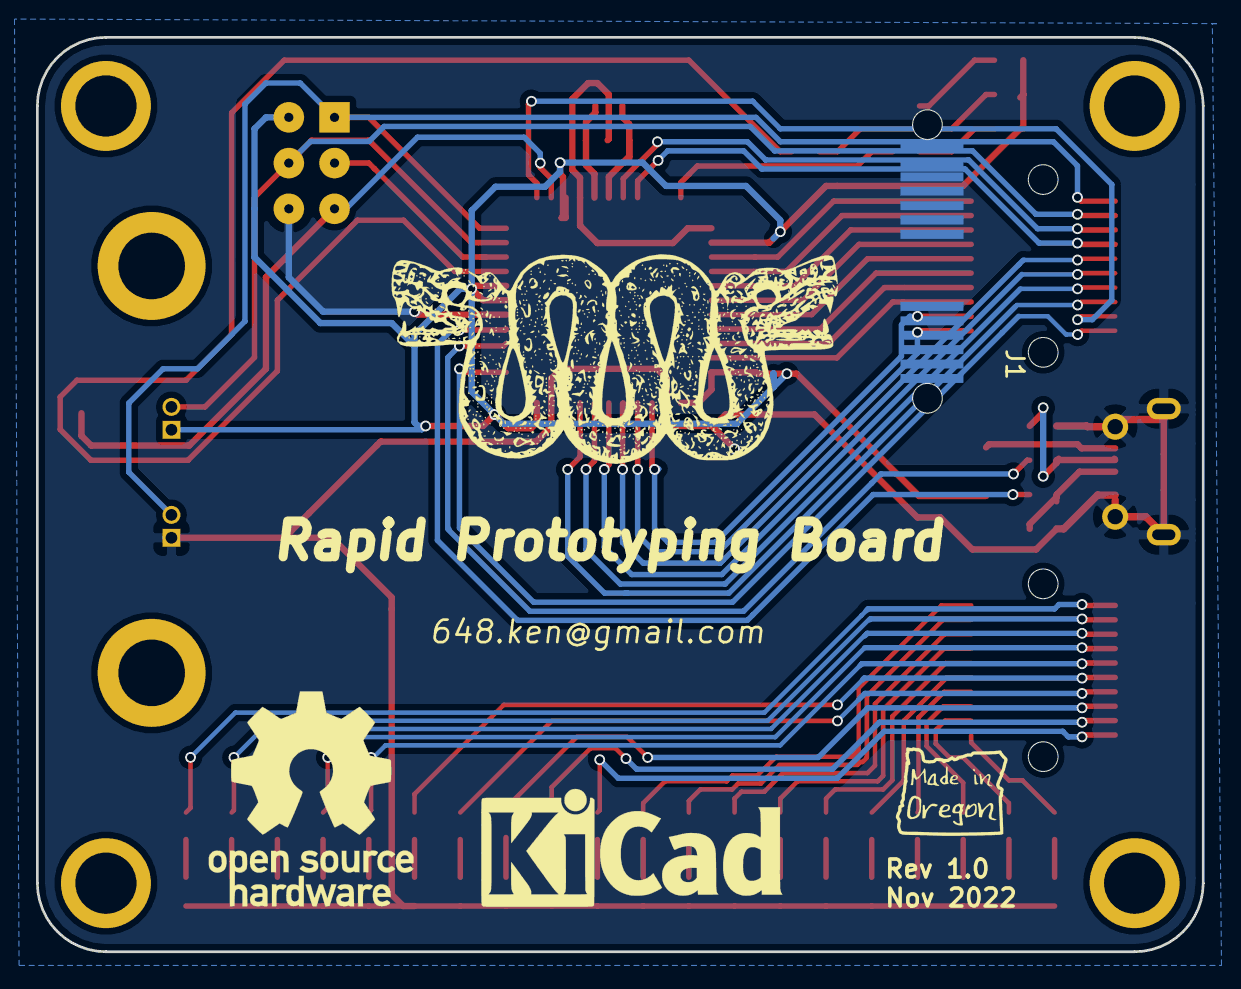
[picture p399: board projects/tester/UCT3/design_files/project.kicad_pcb from below]

Board: 2 copper layers, 64.8 x 50.8 mm, 76 parts (3 on the bottom side), 76 nets.

Parts:
C1: 10uF; C_0805
CardOutline1, CardOutline2: SYM_Arrow_Large; MEC8_card
D1: 1; LED_0603
D2: 2; LED_0603
D3: 3; LED_0603
D4: 4; LED_0603
D5: 5; LED_0603
D6: 6; LED_0603
D7: 7; LED_0603
D8: 8; LED_0603
D9: 9; LED_0603
D10: 10; LED_0603
D11: 11; LED_0603
D12: 12; LED_0603
D13: 13; LED_0603
D14: 14; LED_0603
D15: 15; LED_0603
D16: 16; LED_0603
D17: 17; LED_0603
D18: 18; LED_0603
D19: 19; LED_0603
D20: 20; LED_0603
D21: PWR; LED_0603
D22: TX; LED_0603
D23: RX; LED_0603
F1: Polyfuse; R_0805_HandSoldering
J1: Conn_02x13_Top_Bottom; MEC8-113-CARD
J1#2: USB_OTG; USB_Micro-B_Molex-105017-0001
J2: ISP; Pin_Header_Straight_2x03_Pitch2.54mm
JP1: PWR to 17; PinHeader_1x02_P1.27mm_Horizontal
JP2: GND to 18; PinHeader_1x02_P1.27mm_Horizontal
MadeInOregon1: SYM_Arrow_Large; MadeInOregonRev25
MadeWithKiCAD1: SYM_Arrow_Large; KiCad-Logo2_8mm_SilkScreen
OSHW1: SYM_Arrow_Large; OSHW-Logo_11.4x12mm_SilkScreen
P1, P2, P3, P4: M3; M3mount
P5, P6: Standoff; M25standoff
R1, R2, R3, R4, R5, R6, R7, R8, R9, R10, R11, R12, R13, R14, R15, R16, R17, R18, R19, R20, R21, R22, R23: 1K; R_0603
R24, R25: 22; R_0603
R26: 1M; R_0603
RV1, RV2: Varistor; R_0603
SW1: RESET; SW_TS10-63-26-BE-250-SMT-TR
SnakeBack1: SYM_Arrow_Large; Snake
SnakeFront1: SYM_Arrow_Large; Snake
U1: ATMEGA32U4-AU; TQFP-44_10x10mm_Pitch0.8mm
X1, X2: MEC8-110-02; MEC8_top_bottom
Y1: 16 Mhz; Resonator_SMD_CTSC_1.3mmx3.2mm

Connections:
+5V: C1.1, D21.2, D22.2, D23.2, F1.1, J2.2, JP1.1, U1.6, U1.7, U1.14, U1.24, U1.33, U1.34, U1.44
/A0: U1.36, X1.2
/A1: U1.37, X1.1
/A2: U1.38, X1.16
/A3: U1.39, X1.15
/A4: U1.40, X1.14
/A5: U1.41, X1.13
/D2_SDA: U1.19, X1.17
/D3_SCL: U1.18, X1.18
/D4: U1.25, X1.10
/D5: U1.31, X1.4
/D6: U1.27, X1.8
/D7: U1.1, X1.11
/D8: U1.28, X1.7
/D9: U1.29, X1.6
/D10: U1.30, X1.5
/D11: U1.12, X1.12
/D12: U1.26, X1.9
/D13: U1.32, X1.3
/D+: R24.1, U1.4
/D-: R25.1, U1.3
/MISO: J2.1, JP2.2, U1.11, X1.20
/MOSI: J2.4, JP1.2, U1.10, X1.19
/RXLED: R23.1, U1.8
/SCK: J2.3, U1.9
/TXLED: R22.1, U1.22
/~RESET: J2.5, SW1.2, U1.13
GND: C1.2, D1.1, D2.1, D3.1, D4.1, D5.1, D6.1, D7.1, D8.1, D9.1, D10.1, D11.1, D12.1, D13.1, D14.1, D15.1, D16.1, D17.1, D18.1, D19.1, D20.1, J1#2.5, J1#2.6, J2.6, JP2.1, R21.2, RV1.2, RV2.2, SW1.1, U1.5, U1.15, U1.23, U1.35, U1.43, Y1.2
unnamed: D1.2, R1.1
unnamed: D2.2, R2.1
unnamed: D3.2, R3.1
unnamed: D4.2, R4.1
unnamed: D5.2, R5.1
unnamed: D6.2, R6.1
unnamed: D7.2, R7.1
unnamed: D8.2, R8.1
unnamed: D9.2, R9.1
unnamed: D10.2, R10.1
unnamed: D11.2, R11.1
unnamed: D12.2, R12.1
unnamed: D13.2, R13.1
unnamed: D14.2, R14.1
unnamed: D15.2, R15.1
unnamed: D16.2, R16.1
unnamed: D17.2, R17.1
unnamed: D18.2, R18.1
unnamed: D19.2, R19.1
unnamed: D20.2, R20.1
unnamed: D21.1, R21.1
unnamed: D22.1, R22.2
unnamed: D23.1, R23.2
unnamed: F1.2, J1#2.1
unnamed: J1#2.2, R25.2, RV2.1
unnamed: J1#2.3, R24.2, RV1.1
unnamed: R1.2, X2.1
unnamed: R2.2, X2.2
unnamed: R3.2, X2.3
unnamed: R4.2, X2.4
unnamed: R5.2, X2.5
unnamed: R6.2, X2.6
unnamed: R7.2, X2.7
unnamed: R8.2, X2.8
unnamed: R9.2, X2.9
unnamed: R10.2, X2.10
unnamed: R11.2, X2.11
unnamed: R12.2, X2.12
unnamed: R13.2, X2.13
unnamed: R14.2, X2.14
unnamed: R15.2, X2.15
unnamed: R16.2, X2.16
unnamed: R17.2, X2.17
unnamed: R18.2, X2.18
unnamed: R19.2, X2.19
unnamed: R20.2, X2.20
unnamed: R26.1, U1.16, Y1.3
unnamed: R26.2, U1.17, Y1.1
