aspro648/KiCad/projects/tester/UCT3/design_files_card26/project.kicad_pcb

## KiCad design projects/tester/UCT3/design_files_card26/project.kicad_pcb (2022-12-13)

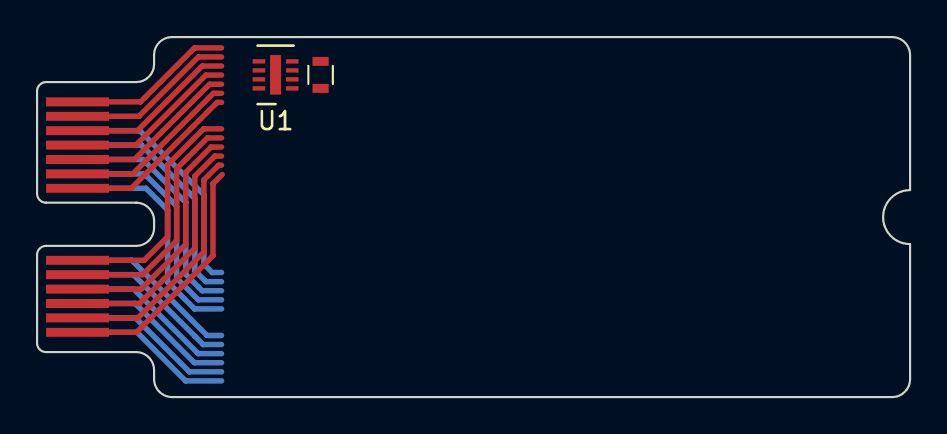
[picture p400: board projects/tester/UCT3/design_files_card26/project.kicad_pcb from above]

Board: 2 copper layers, 48.5 x 20.0 mm, 3 parts (0 on the bottom side), 6 nets.

Parts:
R1: 10K; R_0603
U1: 24LC32; DFN-8-1EP_2x3mm_P0.5mm_EP0.61x2.2mm
X0: Card Edge; MEC8-113-CARD

Connections:
+5V: U1.8, X0.13
/A: R1.2, X0.12
/D2_SDA: U1.5, X0.25
/D3_SCL: U1.6, X0.24
GND: U1.2, U1.3, U1.4, X0.26
unnamed: R1.1, U1.1
