aspro648/KiCad/projects/tester/UCT3/design_files_card Molex PicoBlade/project.kicad_pcb

## KiCad design projects/tester/UCT3/design_files_card Molex PicoBlade/project.kicad_pcb (2022-11-14)

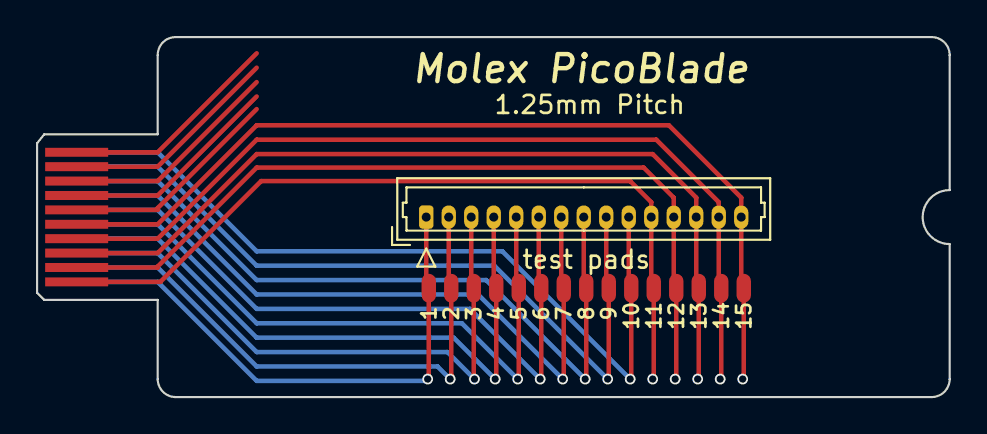
[picture p401: board projects/tester/UCT3/design_files_card Molex PicoBlade/project.kicad_… from above]

Board: 2 copper layers, 50.7 x 20.0 mm, 3 parts (0 on the bottom side), 15 nets.

Parts:
J0: Card Edge; MEC8_card
J1: 1.25mm Pitch; Molex_PicoBlade_53047-1510_1x15_P1.25mm_Vertical
J3: test pads; Molex_PicoBlade_53261-1571_1x15-1MP_P1.25mm_Horizontal

Connections:
/01: J0.1, J1.1, J3.1
/02: J0.2, J1.2, J3.2
/03: J0.3, J1.3, J3.3
/04: J0.4, J1.4, J3.4
/05: J0.5, J1.5, J3.5
/06: J0.6, J1.6, J3.6
/07: J0.7, J1.7, J3.7
/08: J0.8, J1.8, J3.8
/09: J0.9, J1.9, J3.9
/10: J0.10, J1.10, J3.10
/11: J0.11, J1.11, J3.11
/12: J0.12, J1.12, J3.12
/13: J0.13, J1.13, J3.13
/14: J0.14, J1.14, J3.14
/15: J0.15, J1.15, J3.15
