aspro648/KiCad/projects/tester/UCT3/design_files_card/project.kicad_pcb

## KiCad design projects/tester/UCT3/design_files_card/project.kicad_pcb (2022-11-14)

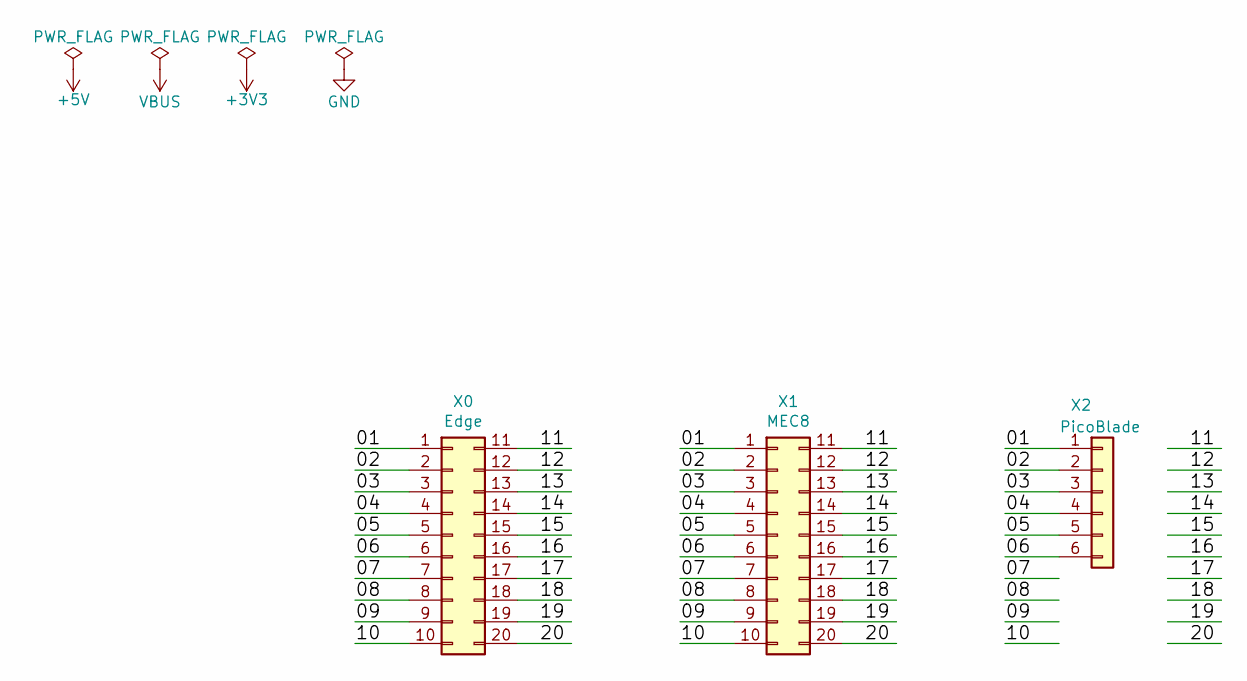
[picture p402: schematic project.sch, Leonardo 324U]

Parts:
X0: Edge; MEC8_card
X1: MEC8; MEC8_top_bottom
X2: PicoBlade; Molex_PicoBlade_53047-0610_1x06_P1.25mm_Vertical

Connections:
/01: X0.1, X1.1, X2.1
/02: X0.2, X1.2, X2.2
/03: X0.3, X1.3, X2.3
/04: X0.4, X1.4, X2.4
/05: X0.5, X1.5, X2.5
/06: X0.6, X1.6, X2.6
/07: X0.7, X1.7
/08: X0.8, X1.8
/09: X0.9, X1.9
/10: X0.10, X1.10
/11: X0.11, X1.11
/12: X0.12, X1.12
/13: X0.13, X1.13
/14: X0.14, X1.14
/15: X0.15, X1.15
/16: X0.16, X1.16
/17: X0.17, X1.17
/18: X0.18, X1.18
/19: X0.19, X1.19
/20: X0.20, X1.20

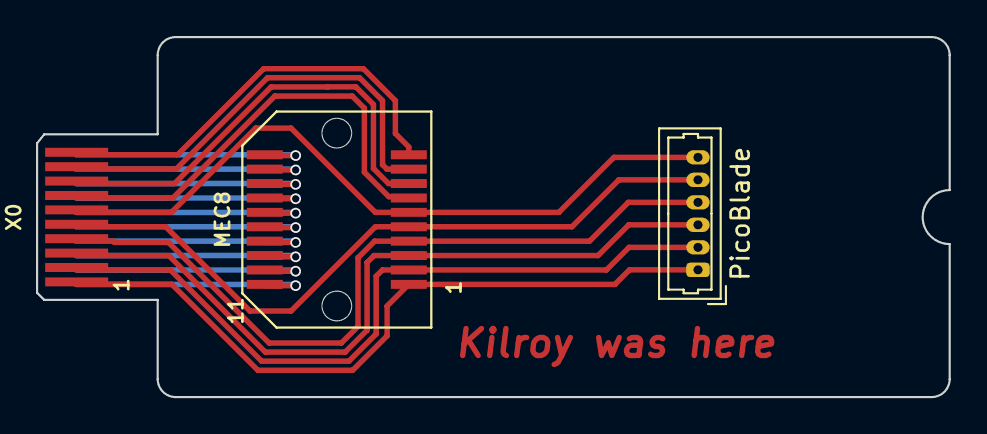
[picture p403: board projects/tester/UCT3/design_files_card/project.kicad_pcb from above]

Board: 2 copper layers, 50.7 x 20.0 mm, 3 parts (0 on the bottom side), 20 nets.
