aspro648/KiCad/projects/tester/UCT3/design_files_card Vectornav/project.kicad_pcb

## KiCad design projects/tester/UCT3/design_files_card Vectornav/project.kicad_pcb (2022-11-14)

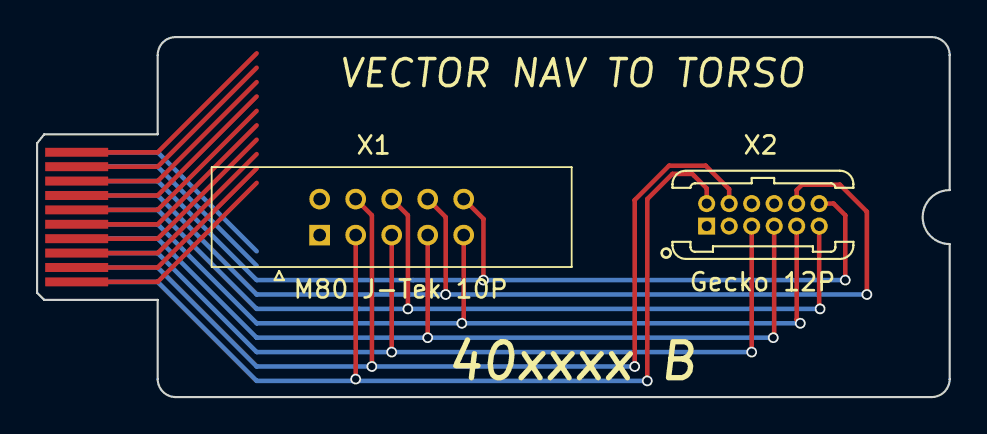
[picture p404: board projects/tester/UCT3/design_files_card Vectornav/project.kicad_pcb from above]

Board: 2 copper layers, 50.7 x 20.0 mm, 3 parts (0 on the bottom side), 8 nets.

Parts:
J0: Edge; MEC8_card
X1: M80 J-Tek 10P; M80-5T110YYMC
X2: Gecko 12P; Harwin_Gecko-G125-MVX1205L0X_2x06_P1.25mm_Vertical

Connections:
/01: J0.1, X1.2, X2.7
/02: J0.2, X1.7, X2.8
/03: J0.3, X1.3, X2.3
/04: J0.4, X1.4, X2.4
/05: J0.5, X1.5, X2.5
/06: J0.6, X1.8, X2.6
/07: J0.7, X1.9, X2.11
/08: J0.8, X1.10, X2.12
