aspro648/KiCad/projects/LEGO/design_files_attiny826_LiPo V1/project.kicad_pcb

## KiCad design projects/LEGO/design_files_attiny826_LiPo V1/project.kicad_pcb (2022-05-25)

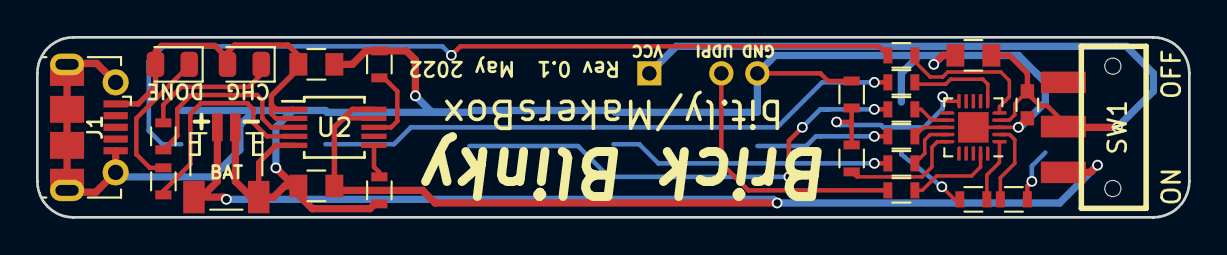
[picture p405: board projects/LEGO/design_files_attiny826_LiPo V1/project.kicad_pcb from above]

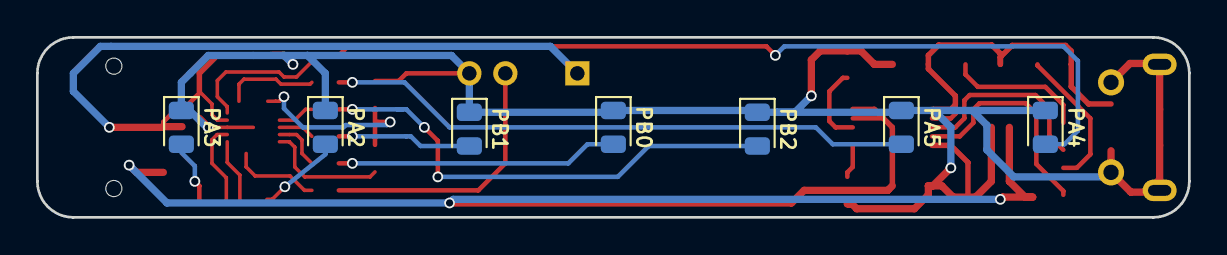
[picture p406: board projects/LEGO/design_files_attiny826_LiPo V1/project.kicad_pcb from below]

Board: 2 copper layers, 64.0 x 10.0 mm, 33 parts (8 on the bottom side), 28 nets.

Parts:
C1, C3, C4: 10uF; C_0805
C2: 0.1uF; C_0603
D1: CHG; LED_0805_2012Metric
D2: DONE; LED_0805_2012Metric
D3: PA4; LED_0805_2012Metric
D4: PA5; LED_0805_2012Metric
D5: PB1; LED_0805_2012Metric
D6: PB2; LED_0805_2012Metric
D7: PB0; LED_0805_2012Metric
D8: PA3; LED_0805_2012Metric
D9: PA2; LED_0805_2012Metric
J1: USB-MICRO; USB_Micro-B_Molex-105017-0001
J2: BAT; JST_SH_SM02B-SRSS-TB_02x1.00mm_Angled
J3: UDPI; UDPI_header
R1: 39K; R_0603
R2, R13, R14: 10K; R_0603
R3, R6, R7, R8, R9, R10, R11, R12: 100; R_0603
R4, R5: 1K; R_0603
SW1: SW_SPST; SPST_SMD
U1: ATtiny826; VQFN-20-1EP_3x3mm_P0.4mm_EP1.7x1.7mm
U2: MCP73833; MSOP-10_3x3mm_Pitch0.5mm

Connections:
+BATT: C4.1, J2.1, SW1.1, U2.9, U2.10
/PIN_PA2: R11.1, U1.1
/PIN_PA3: R12.1, U1.2
/PIN_PA4: R6.1, U1.5
/PIN_PA5: R7.1, U1.6
/PIN_PB0: R10.1, U1.14
/PIN_PB1: R8.1, U1.13
/PIN_PB2: R9.1, U1.12
/PIN_PB4: R1.2, R2.1, U1.10
/PIN_PC0: R1.1, U1.15
/UPDI: R3.1, U1.19
GND: C1.2, C2.2, C3.2, C4.2, D3.1, D4.1, D5.1, D6.1, D7.1, D8.1, D9.1, J1.5, J1.6, J2.2, J3.4, R2.2, R13.2, R14.2, U1.3, U1.21, U2.5
unnamed: D1.1, R4.2
unnamed: D2.1, R5.2
unnamed: D3.2, R6.2
unnamed: D4.2, R7.2
unnamed: D5.2, R8.2
unnamed: D6.2, R9.2
unnamed: D7.2, R10.2
unnamed: D8.2, R12.2
unnamed: D9.2, R11.2
unnamed: J3.3, R3.2
unnamed: R4.1, U2.3
unnamed: R5.1, U2.4
unnamed: R13.1, U2.6
unnamed: R14.1, U2.8
VBUS: C3.1, D1.2, D2.2, J1.1, U2.1, U2.2
VCC: C1.1, C2.1, J3.1, SW1.2, U1.4
