aspro648/KiCad/projects/LEGO/design_files_attiny826_LiPo badge/project.kicad_pcb

## KiCad design projects/LEGO/design_files_attiny826_LiPo badge/project.kicad_pcb (2022-05-13)

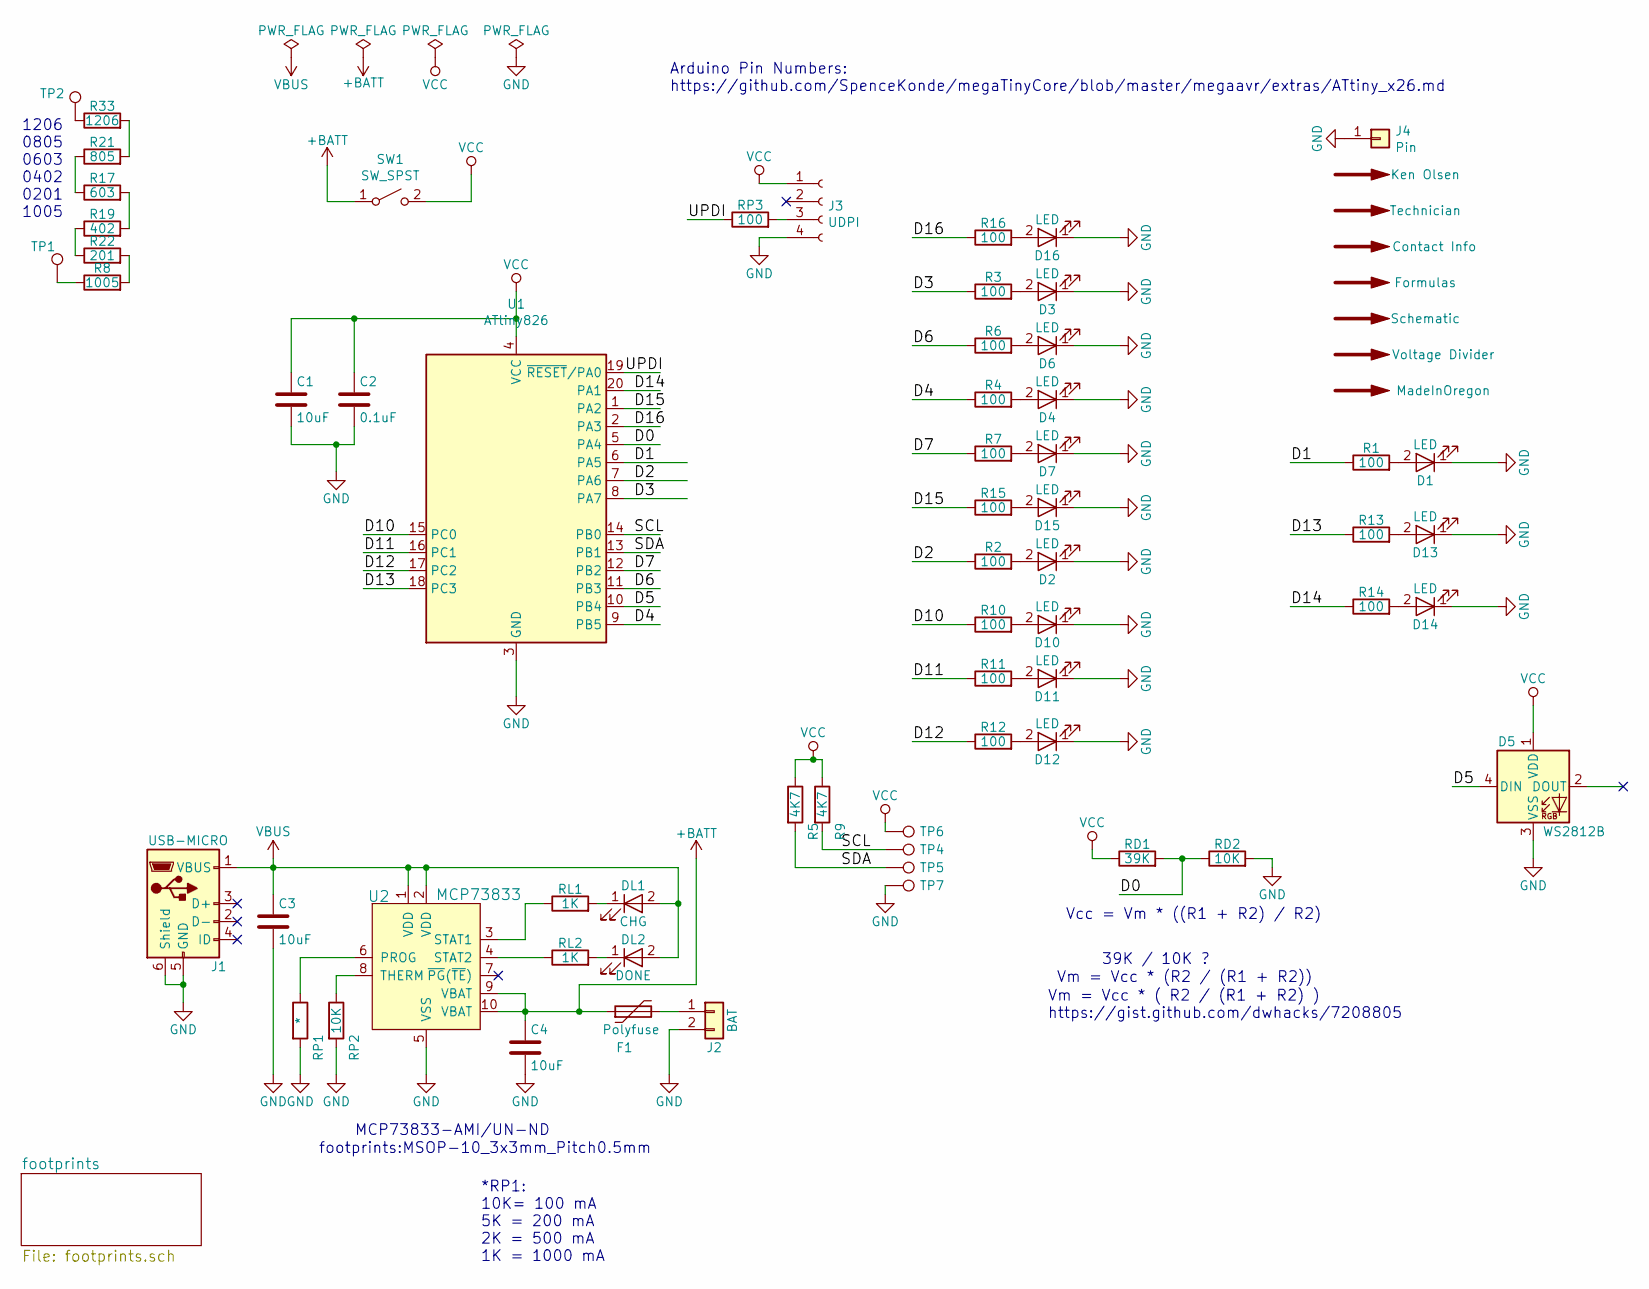
[picture p407: schematic project.sch, Attiny826]

Parts:
C1, C3, C4: 10uF; C_0805
C2: 0.1uF; C_0603
D1, D2, D3, D4, D6, D7, D10, D11, D12, D13, D14, D15, D16: LED; LED_0402_1005Metric
D5: WS2812B; WS2812B-2020
DL1: CHG; LED_0603
DL2: DONE; LED_0603
F1: Polyfuse; Fuse_0805_2012Metric
J1: USB-MICRO; USB_Micro-B_Molex-105017-0001
J2: BAT; JST_SH_SM02B-SRSS-TB_02x1.00mm_Angled
J3: UDPI; UDPI_header
J4: Pin; Pin_holder_SMD
R1, R2, R3, R4, R6, R7, R10, R11, R12, R13, R14, R15, R16: 100; R_0402_1005Metric
R5, R9: 4K7; R_0603
R8: 1005; R_01005_0402Metric
R17: 603; R_0603_1608Metric
R19: 402; R_0402
R21: 805; R_0805_2012Metric
R22: 201; R_0201_0603Metric
R33: 1206; R_1206_3216Metric
RD1: 39K; R_0402_1005Metric
RD2: 10K; R_0402_1005Metric
RL1, RL2: 1K; R_0603
RP1: *; R_0603
RP2: 10K; R_0603
RP3: 100; R_0402_1005Metric
SW1: SW_SPST; SPST_SMD
SYM1: Ken Olsen; KenOlsen
SYM2: Technician; ElectronicTechnician
SYM3: Contact Info; contact
SYM4: Formulas; PieChart
SYM5: Schematic; schematic
SYM6: Voltage Divider; schematic2
SYM7: MadeInOregon; MadeInOregonRev25
TP1, TP2: TestPoint; TestPoint_Pad_D1.0mm
TP4: SCL; TestPoint_Pad_D1.0mm
TP5: SDA; TestPoint_Pad_D1.0mm
TP6: VCC; TestPoint_Pad_D1.0mm
TP7: GND; TestPoint_Pad_D1.0mm
U1: ATtiny826; VQFN-20-1EP_3x3mm_P0.4mm_EP1.7x1.7mm
U2: MCP73833; MSOP-10_3x3mm_Pitch0.5mm

Connections:
+BATT: C4.1, F1.1, SW1.1 (A), U2.9 (VBAT), U2.10 (VBAT)
/D0: RD1.2, RD2.1, U1.5 (PA4)
/D1: R1.1, U1.6 (PA5)
/D2: R2.1, U1.7 (PA6)
/D3: R3.1, U1.8 (PA7)
/D4: R4.1, U1.9 (PB5)
/D5: D5.4 (DIN), U1.10 (PB4)
/D6: R6.1, U1.11 (PB3)
/D7: R7.1, U1.12 (PB2)
/D10: R10.1, U1.15 (PC0)
/D11: R11.1, U1.16 (PC1)
/D12: R12.1, U1.17 (PC2)
/D13: R13.1, U1.18 (PC3)
/D14: R14.1, U1.20 (PA1)
/D15: R15.1, U1.1 (PA2)
/D16: R16.1, U1.2 (PA3)
/SCL: R9.2, TP4.1, U1.14 (PB0)
/SDA: R5.2, TP5.1, U1.13 (PB1)
/UPDI: RP3.1, U1.19 (~RESET~/PA0)
GND: C1.2, C2.2, C3.2, C4.2, D1.1 (K), D2.1 (K), D3.1 (K), D4.1 (K), D5.3 (VSS), D6.1 (K), D7.1 (K), D10.1 (K), D11.1 (K), D12.1 (K), D13.1 (K), D14.1 (K), D15.1 (K), D16.1 (K), J1.5 (GND), J1.6 (Shield), J2.2, J3.4, J4.1, RD2.2, RP1.2, RP2.2, TP7.1, U1.3 (GND), U1.21 (GND), U2.5 (VSS)
unnamed: D1.2 (A), R1.2
unnamed: D2.2 (A), R2.2
unnamed: D3.2 (A), R3.2
unnamed: D4.2 (A), R4.2
unnamed: D6.2 (A), R6.2
unnamed: D7.2 (A), R7.2
unnamed: D10.2 (A), R10.2
unnamed: D11.2 (A), R11.2
unnamed: D12.2 (A), R12.2
unnamed: D13.2 (A), R13.2
unnamed: D14.2 (A), R14.2
unnamed: D15.2 (A), R15.2
unnamed: D16.2 (A), R16.2
unnamed: DL1.1 (K), RL1.2
unnamed: DL2.1 (K), RL2.2
unnamed: F1.2, J2.1
unnamed: J3.3, RP3.2
unnamed: R8.1, TP1.1
unnamed: R17.1, R21.1
unnamed: R17.2, R19.2
unnamed: R19.1, R22.1
unnamed: R21.2, R33.2
unnamed: R8.2, R22.2
unnamed: R33.1, TP2.1
unnamed: RL1.1, U2.3 (STAT1)
unnamed: RL2.1, U2.4 (STAT2)
unnamed: RP1.1, U2.6 (PROG)
unnamed: RP2.1, U2.8 (THERM)
VBUS: C3.1, DL1.2 (A), DL2.2 (A), J1.1 (VBUS), U2.1 (VDD), U2.2 (VDD)
VCC: C1.1, C2.1, D5.1 (VDD), J3.1, R5.1, R9.1, RD1.1, SW1.2 (B), TP6.1, U1.4 (VCC)

Notes on the sheet:
Arduino Pin Numbers: https://github.com/SpenceKonde/megaTinyCore/blob/master/megaavr/extras/ATtiny_x26.md
*RP1: 10K= 100 mA 5K = 200 mA 2K = 500 mA 1K = 1000 mA
footprints:MSOP-10_3x3mm_Pitch0.5mm
MCP73833-AMI/UN-ND
39K / 10K ?
Vm = Vcc * ( R2 / (R1 + R2) ) https://gist.github.com/dwhacks/7208805
1206 0805 0603 0402 0201 1005
Vm = Vcc * (R2 / (R1 + R2))
Vcc = Vm * ((R1 + R2) / R2)

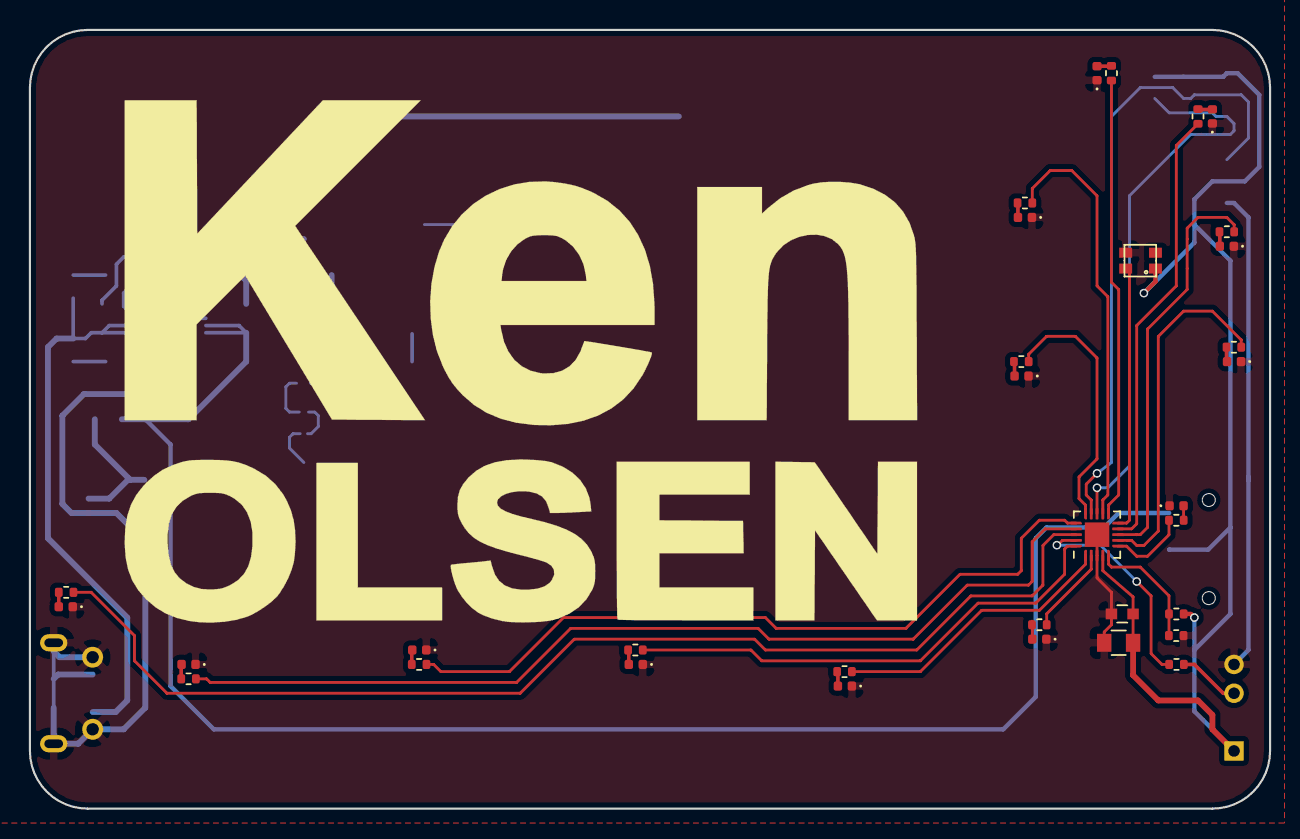
[picture p408: board projects/LEGO/design_files_attiny826_LiPo badge/project.kicad_pcb from above]

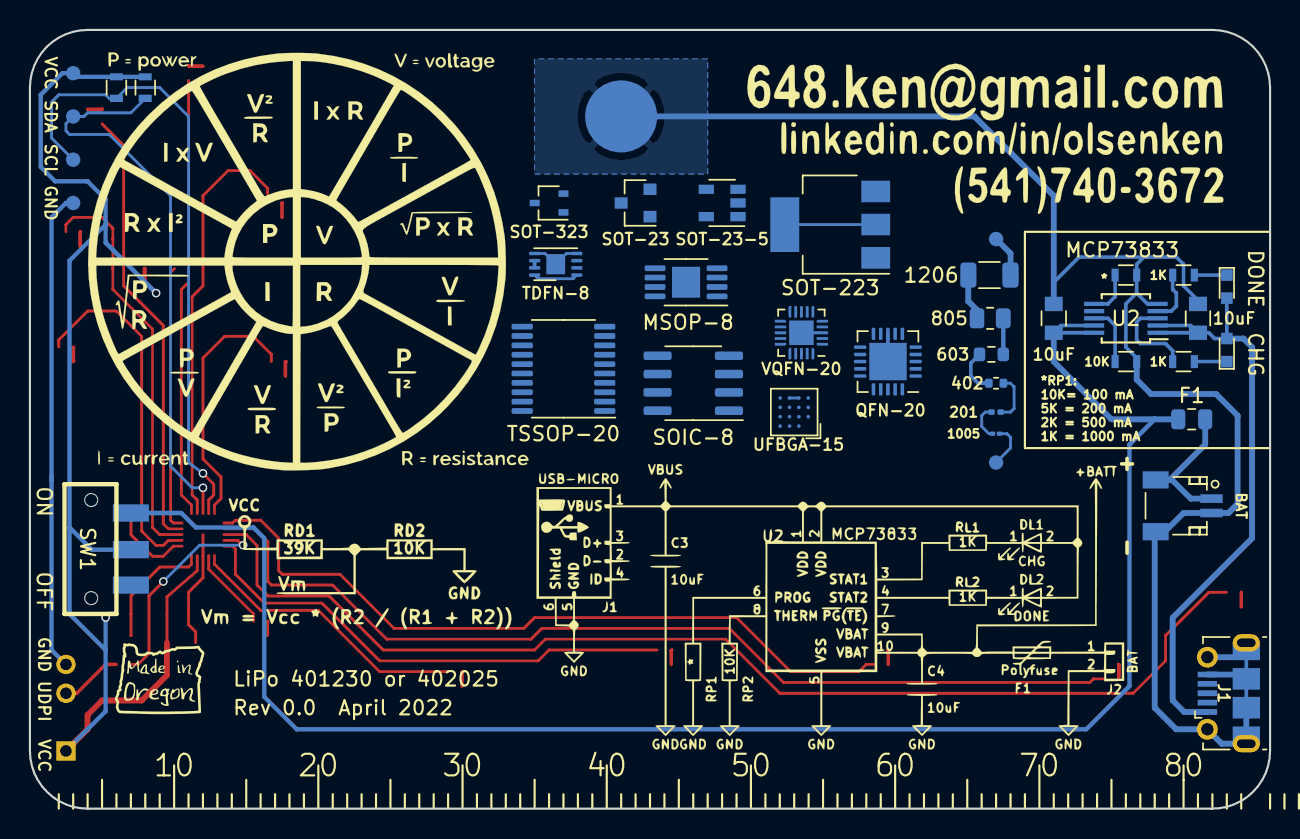
[picture p409: board projects/LEGO/design_files_attiny826_LiPo badge/project.kicad_pcb from below]

Board: 2 copper layers, 86.0 x 54.0 mm, 80 parts (43 on the bottom side), 57 nets.

Other parts of the board:
Q1: SOT-23
Q2: SOT-323; SOT-323_SC-70
Q3: SOT-223
U3: VQFN-20; VQFN-20-1EP_3x3mm_P0.4mm_EP1.7x1.7mm
U4: UFBGA-15; UFBGA-15_3.0x3.0mm_Layout4x4_P0.65mm
U5: QFN-20; QFN-20-1EP_4x4mm_P0.5mm_EP2.6x2.6mm
U6: TSSOP-20; TSSOP-20_4.4x6.5mm_P0.65mm
U7: SOT-23-5
U8: TDFN-8; TDFN-8-1EP_3x2mm_P0.5mm_EP1.3x1.4mm
U9: MSOP-8; MSOP-8-1EP_3x3mm_P0.65mm_EP1.95x2.15mm
U10: SOIC-8; SOIC-8_3.9x4.9mm_P1.27mm

Their connections:
unnamed: Q3.2, Q3.4
unnamed: U3.3, U3.21
unnamed: U4.D2, U4.D3
unnamed: U5.8, U5.21
unnamed: U8.1, U8.8
unnamed: U8.4, U8.5, U8.9
unnamed: U8.6, U8.7
