aspro648/KiCad/projects/HotWheels/Attiny/design_files Attiny826 LIS2 V1/project.kicad_pcb

## KiCad design projects/HotWheels/Attiny/design_files Attiny826 LIS2 V1/project.kicad_pcb (2022-05-12)

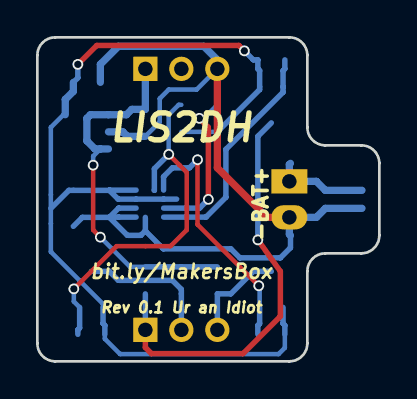
[picture p410: board projects/HotWheels/Attiny/design_files Attiny826 LIS2 V1/project.kica… from above]

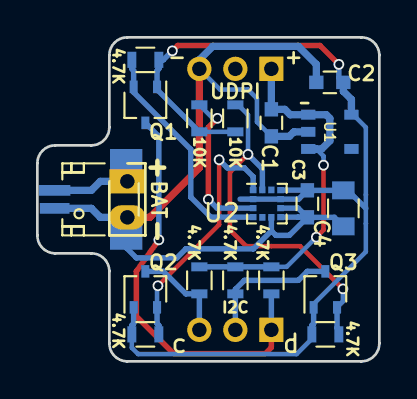
[picture p411: board projects/HotWheels/Attiny/design_files Attiny826 LIS2 V1/project.kica… from below]

Board: 2 copper layers, 19.0 x 18.0 mm, 21 parts (21 on the bottom side), 11 nets.

Parts:
C1, C2, C3: 0.1uF; C_0603
C4: 10uF; C_0805
J1: JST-SH; JST_SH_SM02B_hand_solder
J2: BAT; PIN_HEADER_LED
J4: UDPI; PinHeader_1x03_P2.00mm_Vertical
J8: I2C; PinHeader_1x03_P2.00mm_Vertical
Q1, Q2, Q3: BSS138; SOT-323_SC-70
R1, R2, R3, R4, R5, R6: 4.7K; R_0603
R7, R8: 10K; R_0603
U1: Linear 3.3V; SOT-753
U2: LIS2HH12; LGA-12_2x2mm_P0.5mm

Connections:
+3V3: C2.1, C3.1, C4.1, Q1.1, Q2.1, Q3.1, R4.1, R5.1, R6.1, R7.1, R8.1, U1.5, U2.2, U2.9, U2.10
/INT: J8.2, Q3.3, R3.2
/INT_3V3: Q3.2, R6.2, R8.2, U2.12
/SCL: J8.3, Q2.3, R2.2
/SCL_3V3: Q2.2, R5.2, U2.1
/SDA: J8.1, Q1.3, R1.2
/SDA_3V3: Q1.2, R4.2, U2.4
GND: C1.2, C2.2, C3.2, C4.2, J1.1, J2.2, J4.3, U1.2, U2.6, U2.7, U2.8
unnamed: J1.2, J2.1
unnamed: R7.2, U2.3
VCC: C1.1, J4.1, R1.1, R2.1, R3.1, U1.1, U1.3
