aspro648/KiCad/projects/HotWheels/Attiny/design_files Attiny826 V1/project.kicad_pcb

## KiCad design projects/HotWheels/Attiny/design_files Attiny826 V1/project.kicad_pcb (2022-05-09)

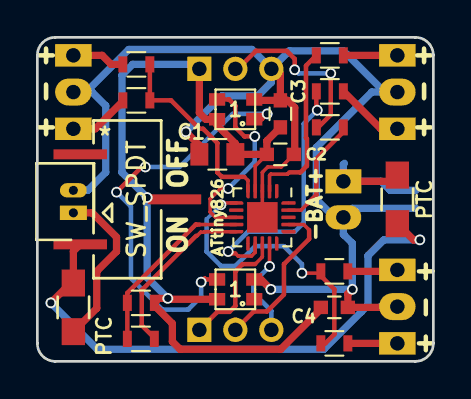
[picture p412: board projects/HotWheels/Attiny/design_files Attiny826 V1/project.kicad_pcb from above]

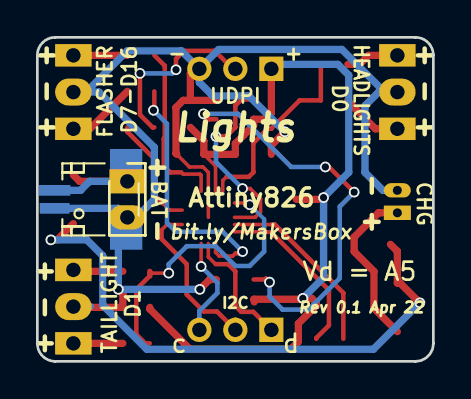
[picture p413: board projects/HotWheels/Attiny/design_files Attiny826 V1/project.kicad_pcb from below]

Board: 2 copper layers, 22.0 x 18.0 mm, 27 parts (4 on the bottom side), 24 nets.

Parts:
C1: 10uF; C_0805
C2: 0.1uF; C_0603
C3, C4: 1uF; C_0603
D0, D7: SK6812MINI; WS2812B-2020
F1, F2: PTC; R_0805_HandSoldering
J1: JST-SH; JST_SH_SM02B_hand_solder
J2: BAT; PIN_HEADER_LED
J3: CHG; Connector_Molex_PicoBlade_53047-0210
J4: UDPI; PinHeader_1x03_P2.00mm_Vertical
J5: HL; Pin_Header_THD_1x03
J6: TL; Pin_Header_THD_1x03
J7: FL; Pin_Header_THD_1x03
J8: I2C; PinHeader_1x03_P2.00mm_Vertical
R1: 1; R_0603
R2: 2; R_0603
R3, R4, R5, R6, R7, R10, R11: 100; R_0603
SW1: SW_SPDT; JS102011SCQN
U1: ATtiny826; VQFN-20-1EP_3x3mm_P0.4mm_EP1.7x1.7mm

Connections:
/D0: R3.1, R11.1, U1.5
/D1: R4.1, R5.1, U1.6
/D3: D0.3, U1.8
/D4: R1.2, R2.1, U1.9
/D5: R2.2, U1.10
/D7: R7.1, U1.12
/D12: J8.2, U1.17
/D16: R6.1, U1.2
/SCL: J8.3, U1.14
/SDA: J8.1, U1.13
/UPDI: R10.1, U1.19
GND: C1.2, C2.2, C3.2, C4.2, D0.2, D7.2, J1.1, J2.2, J3.2, J4.3, J5.2, J6.2, J7.2, U1.3, U1.21
unnamed: D0.1, D7.3
unnamed: F1.1, J3.1
unnamed: F1.2, F2.2, SW1.3
unnamed: F2.1, J1.2, J2.1
unnamed: J4.2, R10.2
unnamed: J5.1, R11.2
unnamed: J5.3, R3.2
unnamed: J6.1, R4.2
unnamed: J6.3, R5.2
unnamed: J7.1, R6.2
unnamed: J7.3, R7.2
VCC: C1.1, C2.1, C3.1, C4.1, D0.4, D7.4, J4.1, R1.1, SW1.2, U1.4
