aspro648/KiCad/projects/LEGO/design_files_attiny826/project.kicad_pcb

## KiCad design projects/LEGO/design_files_attiny826/project.kicad_pcb (2022-03-31)

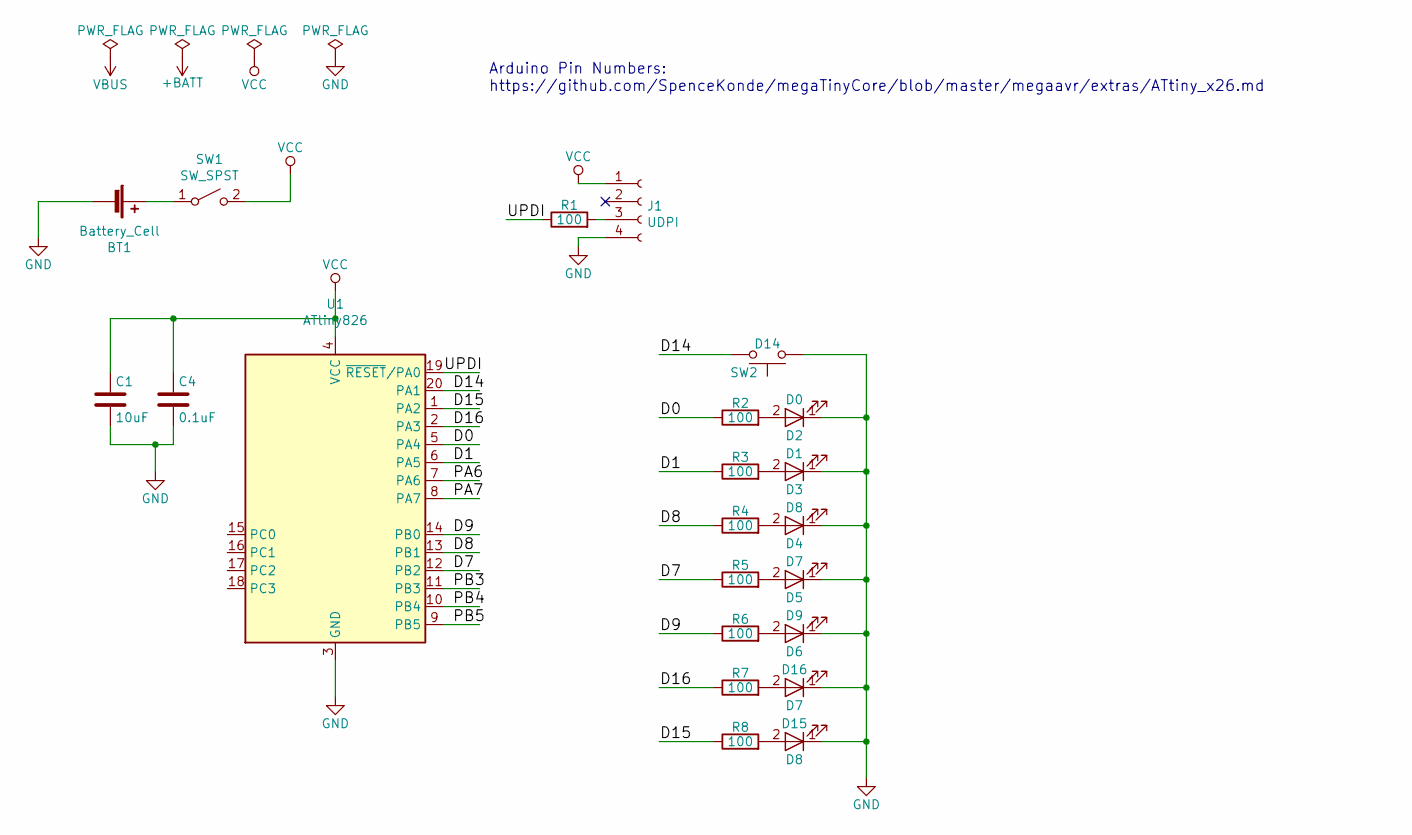
[picture p414: schematic project.sch, Attiny826]

Parts:
BT1: Battery_Cell; BatteryHolder_Keystone_3034_1x20mm
C1: 10uF; C_0805
C4: 0.1uF; C_0603
D2: D0; LED_1206_3216Metric
D3: D1; LED_1206_3216Metric
D4: D8; LED_1206_3216Metric
D5: D7; LED_1206_3216Metric
D6: D9; LED_1206_3216Metric
D7: D16; LED_1206_3216Metric
D8: D15; LED_1206_3216Metric
J1: UDPI; UDPI_header
R1, R2, R3, R4, R5, R6, R7, R8: 100; R_0603
SW1: SW_SPST; SPST_SMD
SW2: D14; EVQ-P7A
U1: ATtiny826; VQFN-20-1EP_3x3mm_P0.4mm_EP1.7x1.7mm

Connections:
/D0: R2.1, U1.5 (PA4)
/D1: R3.1, U1.6 (PA5)
/D7: R5.1, U1.12 (PB2)
/D8: R4.1, U1.13 (PB1)
/D9: R6.1, U1.14 (PB0)
/D14: SW2.2, U1.20 (PA1)
/D15: R8.1, U1.1 (PA2)
/D16: R7.1, U1.2 (PA3)
/PA6: U1.7 (PA6)
/PA7: U1.8 (PA7)
/PB3: U1.11 (PB3)
/PB4: U1.10 (PB4)
/PB5: U1.9 (PB5)
/UPDI: R1.1, U1.19 (~RESET~/PA0)
GND: BT1.2 (-), C1.2, C4.2, D2.1 (K), D3.1 (K), D4.1 (K), D5.1 (K), D6.1 (K), D7.1 (K), D8.1 (K), J1.4, SW2.1, U1.3 (GND), U1.21 (GND)
unnamed: BT1.1 (+), SW1.1 (A)
unnamed: D2.2 (A), R2.2
unnamed: D3.2 (A), R3.2
unnamed: D4.2 (A), R4.2
unnamed: D5.2 (A), R5.2
unnamed: D6.2 (A), R6.2
unnamed: D7.2 (A), R7.2
unnamed: D8.2 (A), R8.2
unnamed: J1.3, R1.2
VCC: C1.1, C4.1, J1.1, SW1.2 (B), U1.4 (VCC)

Notes on the sheet:
Arduino Pin Numbers: https://github.com/SpenceKonde/megaTinyCore/blob/master/megaavr/extras/ATtiny_x26.md

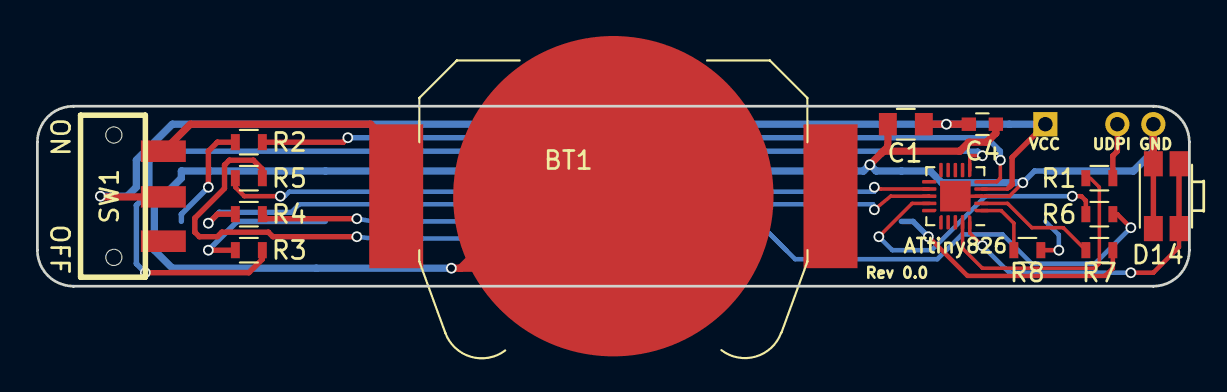
[picture p415: board projects/LEGO/design_files_attiny826/project.kicad_pcb from above]

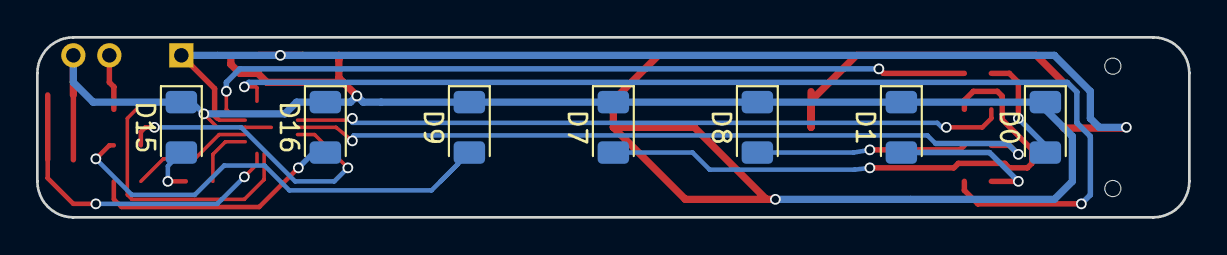
[picture p416: board projects/LEGO/design_files_attiny826/project.kicad_pcb from below]

Board: 2 copper layers, 64.0 x 10.0 mm, 22 parts (7 on the bottom side), 20 nets.
