aspro648/KiCad/projects/ICanSolder/design_files Saintcon2022/project.kicad_pcb

## KiCad design projects/ICanSolder/design_files Saintcon2022/project.kicad_pcb (2022-03-28)

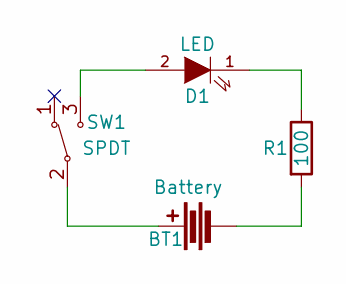
[picture p420: schematic project.sch, I Can Solder!]

Parts:
BT1: Battery; BATT_CR2032
D1: LED; LED_D5.0mm
R1: 100; Resistor_Horz
SW1: SPDT; SW_Micro_SPST

Connections:
unnamed: BT1.1, SW1.2
unnamed: BT1.2, R1.2
unnamed: D1.1 (K), R1.1
unnamed: D1.2 (A), SW1.3

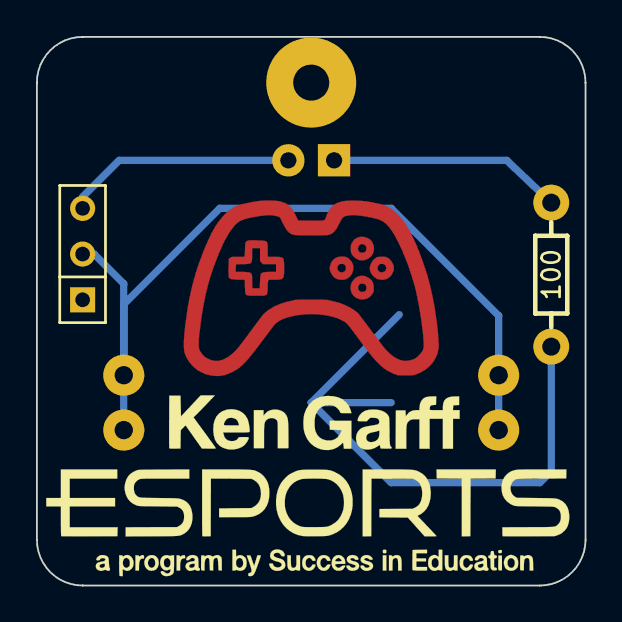
[picture p421: board projects/ICanSolder/design_files Saintcon2022/project.kicad_pcb from above]

Board: 2 copper layers, 30.5 x 30.5 mm, 6 parts (1 on the bottom side), 4 nets.

Other parts of the board:
VAL: MadeInOregonRev25
VAL#2: MB225rev
