aspro648/KiCad/projects/HW/HW_IR gate 3/project.kicad_pcb

## KiCad design projects/HW/HW_IR gate 3/project.kicad_pcb (2021-10-28)

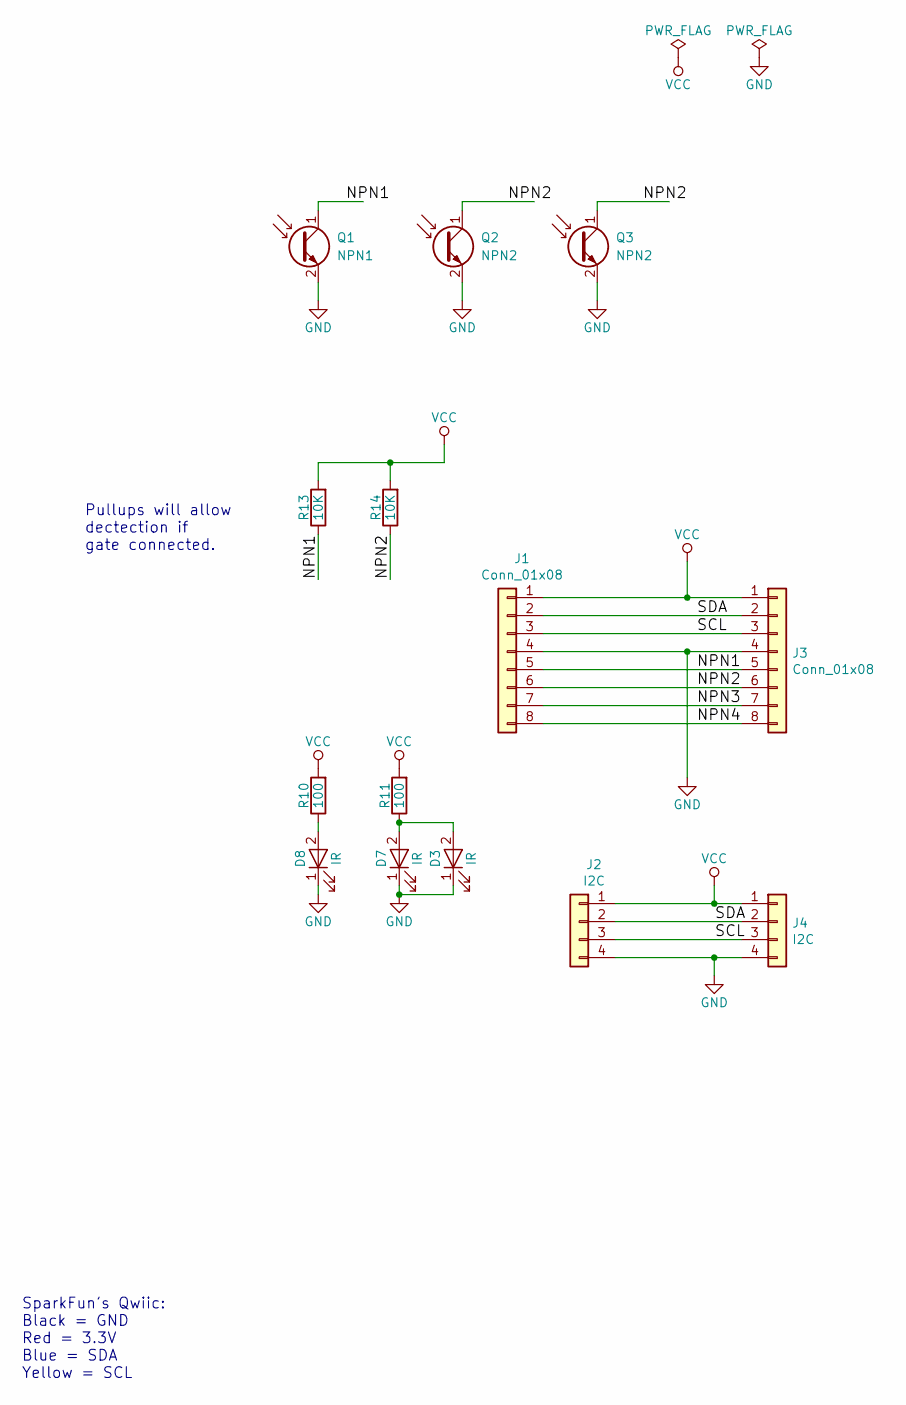
[picture p422: schematic project.sch, IR Gate]

Parts:
D3, D7, D8: IR; IR_LED
J1, J3: Conn_01x08; Molex_PicoBlade_53048-0810_1x08_P1.25mm_Horizontal
J2, J4: I2C; Molex_PicoBlade_53048-0410_1x04_P1.25mm_Horizontal
Q1: NPN1; PHOTOTRANS
Q2, Q3: NPN2; PHOTOTRANS
R10, R11: 100; R_Axial_DIN0204_L3.6mm_D1.6mm_P5.08mm_Horizontal
R13, R14: 10K; R_Axial_DIN0204_L3.6mm_D1.6mm_P5.08mm_Horizontal

Connections:
/NPN1: J1.5, J3.5, Q1.1 (C), R13.1
/NPN2: J1.6, J3.6, Q2.1 (C), Q3.1 (C), R14.1
/NPN3: J1.7, J3.7
/NPN4: J1.8, J3.8
/SCL: J1.3, J2.3, J3.3, J4.3
/SDA: J1.2, J2.2, J3.2, J4.2
GND: D3.1 (K), D7.1 (K), D8.1 (K), J1.4, J2.4, J3.4, J4.4, Q1.2 (E), Q2.2 (E), Q3.2 (E)
unnamed: D3.2 (A), D7.2 (A), R11.1
unnamed: D8.2 (A), R10.1
VCC: J1.1, J2.1, J3.1, J4.1, R10.2, R11.2, R13.2, R14.2

Notes on the sheet:
SparkFun's Qwiic: Black = GND Red = 3.3V Blue = SDA Yellow = SCL
Pullups will allow dectection if gate connected.

Board: 2 copper layers, 15 parts (0 on the bottom side), 10 nets, no tracks yet.

Other parts of the board:
VAL: MadeInOregonRev25
