aspro648/KiCad/projects/HW/HW_Light Tree 2/project.kicad_pcb

## KiCad design projects/HW/HW_Light Tree 2/project.kicad_pcb (2021-10-28)

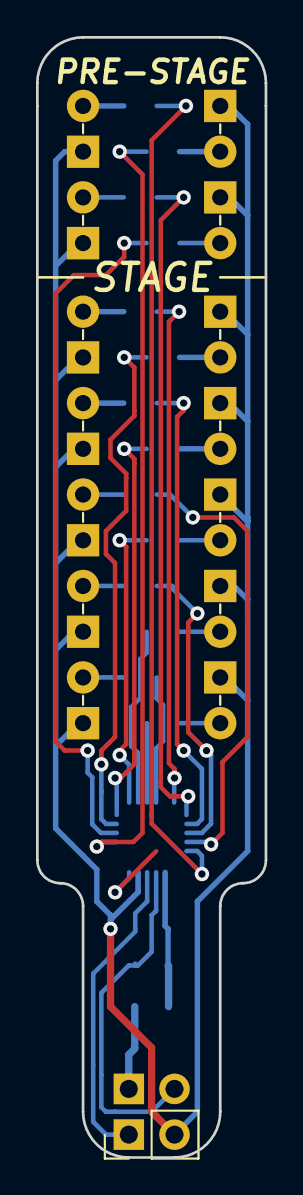
[picture p423: board projects/HW/HW_Light Tree 2/project.kicad_pcb from above]

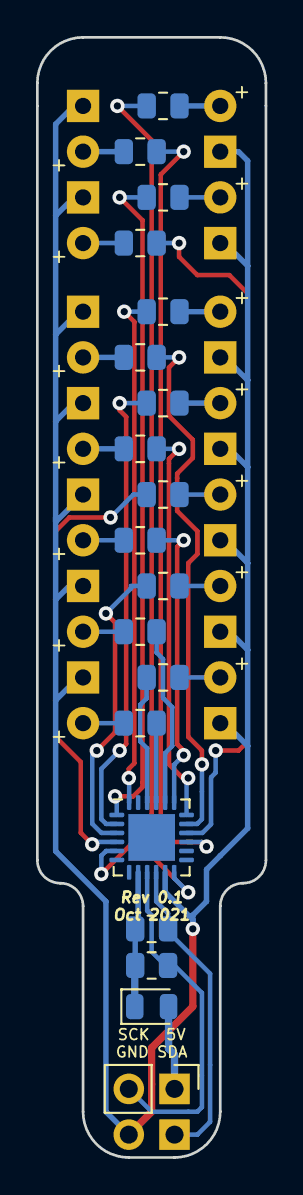
[picture p424: board projects/HW/HW_Light Tree 2/project.kicad_pcb from below]

Board: 2 copper layers, 12.7 x 62.2 mm, 34 parts (19 on the bottom side), 33 nets.

Parts:
D1, D2, D3, D4, D5, D6, D7, D8, D9, D10, D11, D12, D13, D14: LED; LED_D3.0mm
D15: D; D_0805_2012Metric
J1, J2: I2C; PinHeader_1x02_P2.54mm_Vertical
R1, R2, R3, R4, R5, R6, R7, R8, R9, R10, R11, R12, R13, R14: 330; R_0805_2012Metric
R15, R16: 4K7; R_0805_2012Metric
U1: MCP23018_ML; QFN-24-1EP_4x4mm_P0.5mm_EP2.6x2.6mm

Connections:
+5V: D15.1, R15.1, R16.1, U1.8, U1.12
/GP0: R5.1, U1.24
/GP1: R3.1, U1.1
/GP2: R7.1, U1.2
/GP3: R11.1, U1.3
/GP4: R9.1, U1.4
/GP5: R1.1, U1.5
/GP8: R2.1, U1.15
/GP9: R4.1, U1.16
/GP10: R6.1, U1.17
/GP11: R8.1, U1.18
/GP12: R10.1, U1.19
/GP13: R12.1, U1.20
/GP14: R14.1, U1.21
/GP15: R13.1, U1.22
/SCK: J1.2, R16.2, U1.9
/SDA: J2.1, R15.2, U1.10
GND: D1.1, D2.1, D3.1, D4.1, D5.1, D6.1, D7.1, D8.1, D9.1, D10.1, D11.1, D12.1, D13.1, D14.1, J2.2, U1.11, U1.23
unnamed: D1.2, R1.2
unnamed: D2.2, R2.2
unnamed: D3.2, R3.2
unnamed: D4.2, R4.2
unnamed: D5.2, R5.2
unnamed: D6.2, R6.2
unnamed: D7.2, R7.2
unnamed: D8.2, R8.2
unnamed: D9.2, R9.2
unnamed: D10.2, R10.2
unnamed: D11.2, R11.2
unnamed: D12.2, R12.2
unnamed: D13.2, R13.2
unnamed: D14.2, R14.2
unnamed: D15.2, J1.1
