aspro648/KiCad/projects/HW/HW_Shield/project.kicad_pcb

## KiCad design projects/HW/HW_Shield/project.kicad_pcb (2021-10-28)

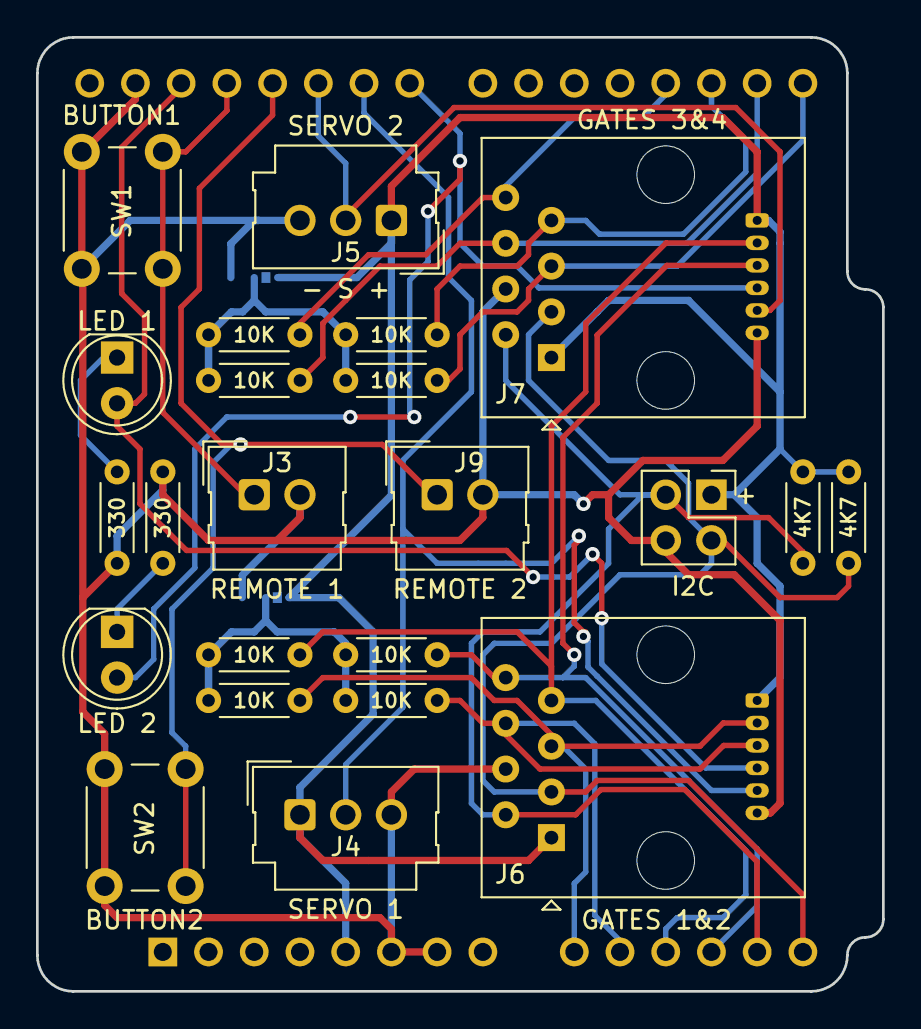
[picture p425: board projects/HW/HW_Shield/project.kicad_pcb from above]

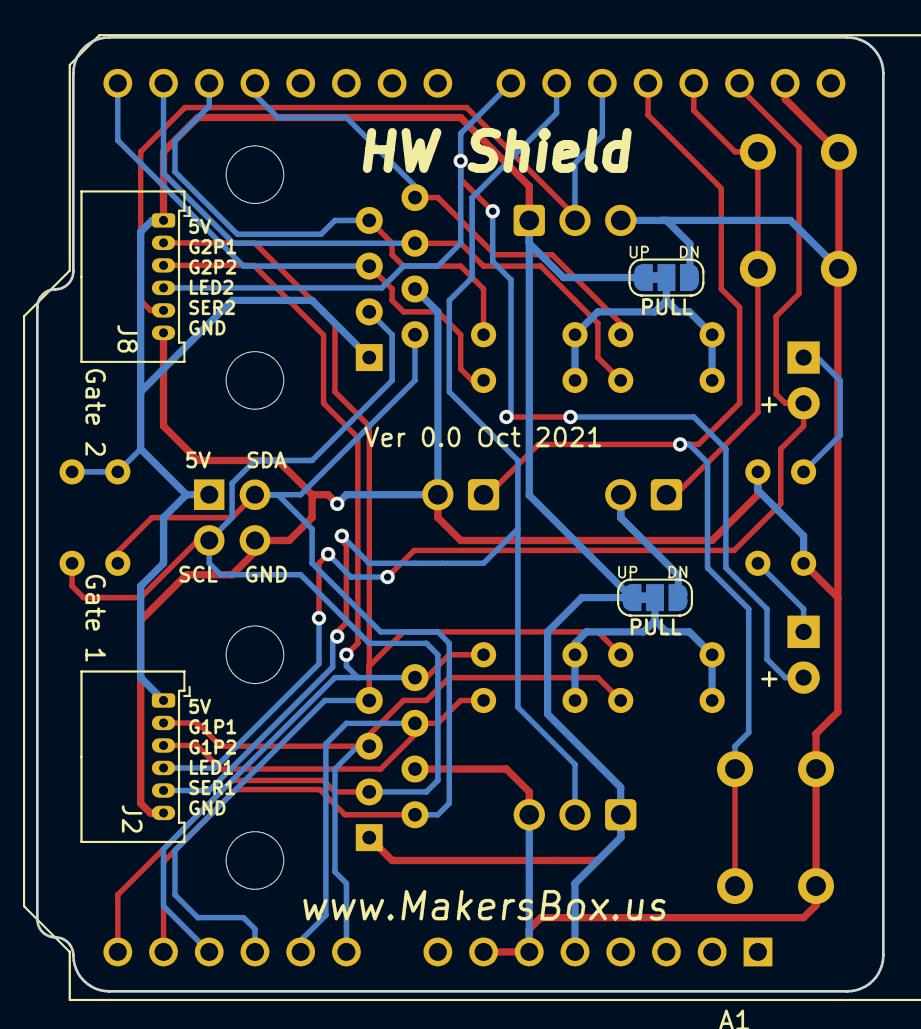
[picture p426: board projects/HW/HW_Shield/project.kicad_pcb from below]

Board: 2 copper layers, 47.0 x 53.0 mm, 28 parts (5 on the bottom side), 22 nets.

Parts:
A1: Arduino_UNO_R2
D1: LED 1; LED_D5.0mm
D2: LED 2; LED_D5.0mm
J1: I2C; PinSocket_2x02_P2.54mm_Vertical
J2: Gate 1; Molex_PicoBlade_53048-0610_1x06_P1.25mm_Horizontal
J3: REMOTE 1; Molex_SL_171971-0002_1x02_P2.54mm_Vertical
J4: SERVO 1; Molex_SL_171971-0003_1x03_P2.54mm_Vertical
J5: SERVO 2; Molex_SL_171971-0003_1x03_P2.54mm_Vertical
J6: GATES 1&2; RJ45_Amphenol_54602-x08_Horizontal
J7: GATES 3&4; RJ45_Amphenol_54602-x08_Horizontal
J8: Gate 2; Molex_PicoBlade_53048-0610_1x06_P1.25mm_Horizontal
J9: REMOTE 2; Molex_SL_171971-0002_1x02_P2.54mm_Vertical
JP1, JP2: PULL; SolderJumper-3_P1.3mm_Bridged12_RoundedPad1.0x1.5mm
R1, R2: 330; R_P5.08mm_Horizontal
R3, R4, R5, R6, R7, R8, R9, R10: 10K; R_P5.08mm_Horizontal
R11, R12: 4K7; R_P5.08mm_Horizontal
SW1: BUTTON1; SW_PUSH_6mm
SW2: BUTTON2; SW_PUSH_6mm

Connections:
+5V: A1.5, J1.1, J2.1, J4.1, J5.1, J6.1, J7.1, J8.1, JP1.1, JP2.1, R11.2, R12.2
/BUTTON1: A1.27, J3.1, SW1.1
/BUTTON2: A1.26, J9.1, SW2.1
/G1_P1: A1.9, J2.2, J6.5, R3.1
/G1_P2: A1.10, J2.3, J6.6, R4.1
/G2_P1: A1.11, J6.7, J8.2, R5.1
/G2_P2: A1.12, J6.8, J8.3, R6.1
/G3_P1: A1.15, J7.5, R7.1
/G3_P2: A1.16, J7.6, R8.1
/G4_P1: A1.17, J7.7, R9.1
/G4_P2: A1.18, J7.8, R10.1
/LED1: A1.28, D1.2, J2.4
/LED2: A1.23, D2.2, J8.4
/SCL: A1.14, J1.3, J6.3, J7.3, R12.1
/SDA: A1.13, J1.2, J6.2, J7.2, R11.1
/SERVO1: A1.24, J2.5, J4.2
/SERVO2: A1.25, J5.2, J8.5
GND: A1.6, A1.7, A1.29, J1.4, J2.6, J3.2, J4.3, J5.3, J6.4, J7.4, J8.6, J9.2, JP1.3, JP2.3, R1.2, R2.2, SW1.2, SW2.2
unnamed: D1.1, R1.1
unnamed: D2.1, R2.1
unnamed: JP1.2, R3.2, R4.2, R5.2, R6.2
unnamed: JP2.2, R7.2, R8.2, R9.2, R10.2
