aspro648/KiCad/projects/HW/HW_Breakout/project.kicad_pcb

## KiCad design projects/HW/HW_Breakout/project.kicad_pcb (2021-10-28)

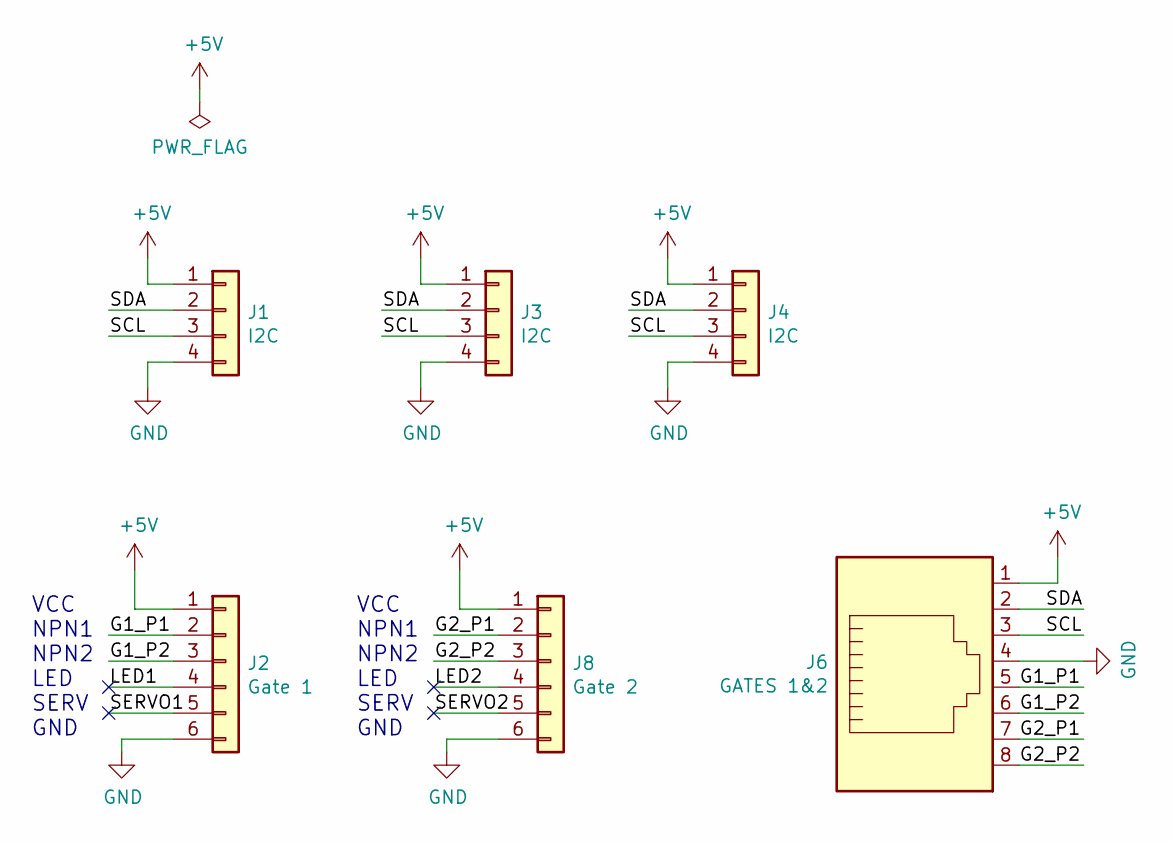
[picture p427: schematic project.sch]

Parts:
J1: I2C; PinSocket_2x02_P2.54mm_Vertical
J2: Gate 1; Molex_PicoBlade_53048-0610_1x06_P1.25mm_Horizontal
J3, J4: I2C; 4P4C_narrow
J6: GATES 1&2; RJ45_Amphenol_54602-x08_Horizontal
J8: Gate 2; Molex_PicoBlade_53048-0610_1x06_P1.25mm_Horizontal

Connections:
+5V: J1.1, J2.1, J3.1, J4.1, J6.1, J8.1
/G1_P1: J2.2, J6.5
/G1_P2: J2.3, J6.6
/G2_P1: J6.7, J8.2
/G2_P2: J6.8, J8.3
/LED1: J2.4
/LED2: J8.4
/SCL: J1.3, J3.3, J4.3, J6.3
/SDA: J1.2, J3.2, J4.2, J6.2
/SERVO1: J2.5
/SERVO2: J8.5
GND: J1.4, J2.6, J3.4, J4.4, J6.4, J8.6

Notes on the sheet:
VCC NPN1 NPN2 LED SERV GND

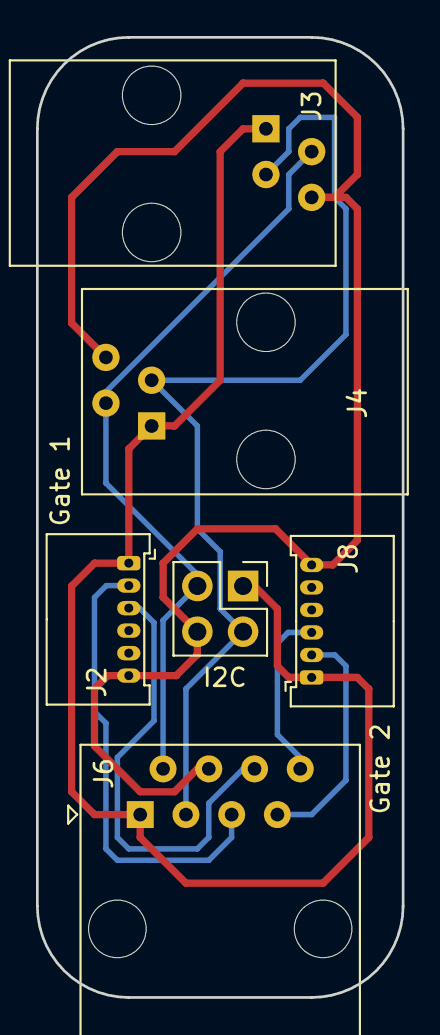
[picture p428: board projects/HW/HW_Breakout/project.kicad_pcb from above]

Board: 2 copper layers, 20.3 x 53.3 mm, 6 parts (0 on the bottom side), 8 nets.
