aspro648/KiCad/projects/HW/HW_IR Featherwing/HW_IR Featherwing.kicad_pcb

## KiCad design projects/HW/HW_IR Featherwing/HW_IR Featherwing.kicad_pcb (2021-09-23)

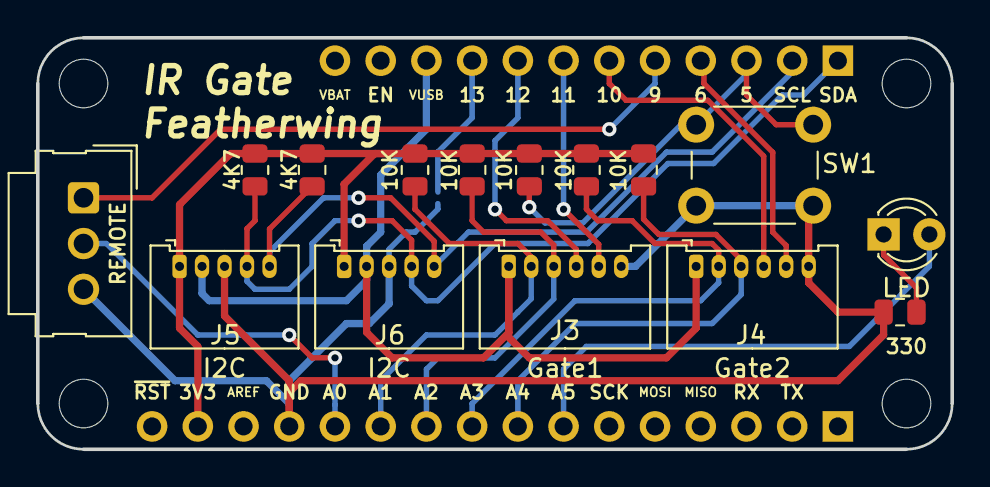
[picture p429: board HW_IR Featherwing.kicad_pcb from above]

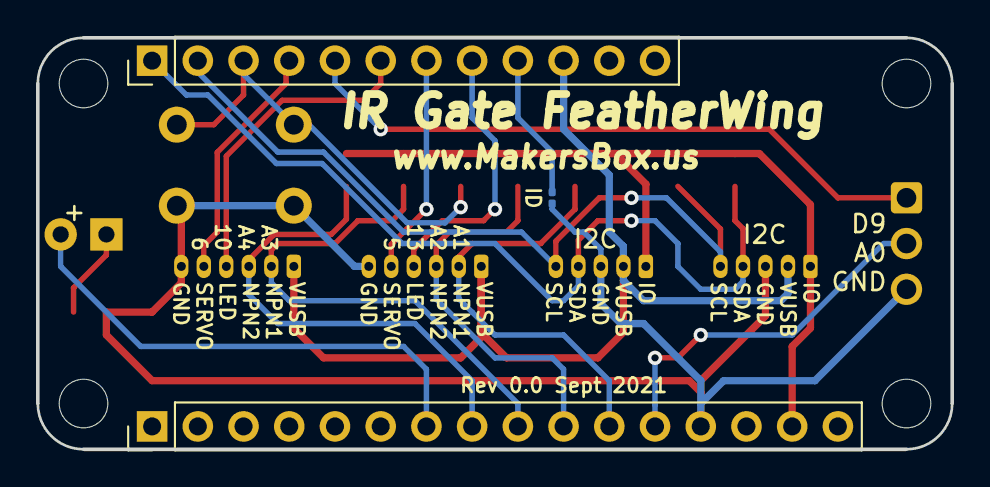
[picture p430: board HW_IR Featherwing.kicad_pcb from below]

Board: 2 copper layers, 50.8 x 22.9 mm, 18 parts (3 on the bottom side), 19 nets.

Parts:
D1: LED; LED_D3.0mm
J1: feather long; PinHeader_1x16_P2.54mm_Vertical
J2: feather short; PinHeader_1x12_P2.54mm_Vertical
J3: Gate1; Molex_PicoBlade_53048-0610_1x06_P1.25mm_Horizontal
J4: Gate2; Molex_PicoBlade_53048-0610_1x06_P1.25mm_Horizontal
J5, J6: I2C; Molex_PicoBlade_53048-0510_1x05_P1.25mm_Horizontal
J7: REMOTE; Molex_SL_171971-0003_1x03_P2.54mm_Vertical
JP1: ID; R_0201_0603Metric
R1, R2: 4K7; R_0805_2012Metric
R3: 330; R_0805_2012Metric
R4, R5, R6, R7, R8: 10K; R_0805_2012Metric
SW1: SW_Push; SW_PUSH_6mm

Connections:
+3V3: J1.15, J5.1, J6.1, R1.2, R2.2, R4.2, R5.2, R6.2, R7.2, R8.2
/5: J2.3, R4.1, SW1.1
/6: J2.4, J4.5
/9: J2.5, J7.1
/10: J2.6, J4.4
/11: J2.7, J3.5
/12: J2.8, J3.4
/13: J2.9, JP1.1
/A0: J1.12, J7.2
/A1: J1.11, J3.2, R6.1
/A2: J1.10, J3.3, R5.1
/A3: J1.9, J4.2, R8.1
/A4: J1.8, J4.3, R7.1
/A5: D1.2, J1.7
/SCL: J2.2, J5.5, J6.5, R1.1
/SDA: J2.1, J5.4, J6.4, R2.1
/VUSB: J2.10, J3.1, J4.1, J5.2, J6.2
GND: J1.13, J3.6, J4.6, J5.3, J6.3, J7.3, JP1.2, R3.2, SW1.2
unnamed: D1.1, R3.1
