aspro648/KiCad/projects/HotWheels/Attiny/design_files Attiny84 V0/project.kicad_pcb

## KiCad design projects/HotWheels/Attiny/design_files Attiny84 V0/project.kicad_pcb (2020-05-30)

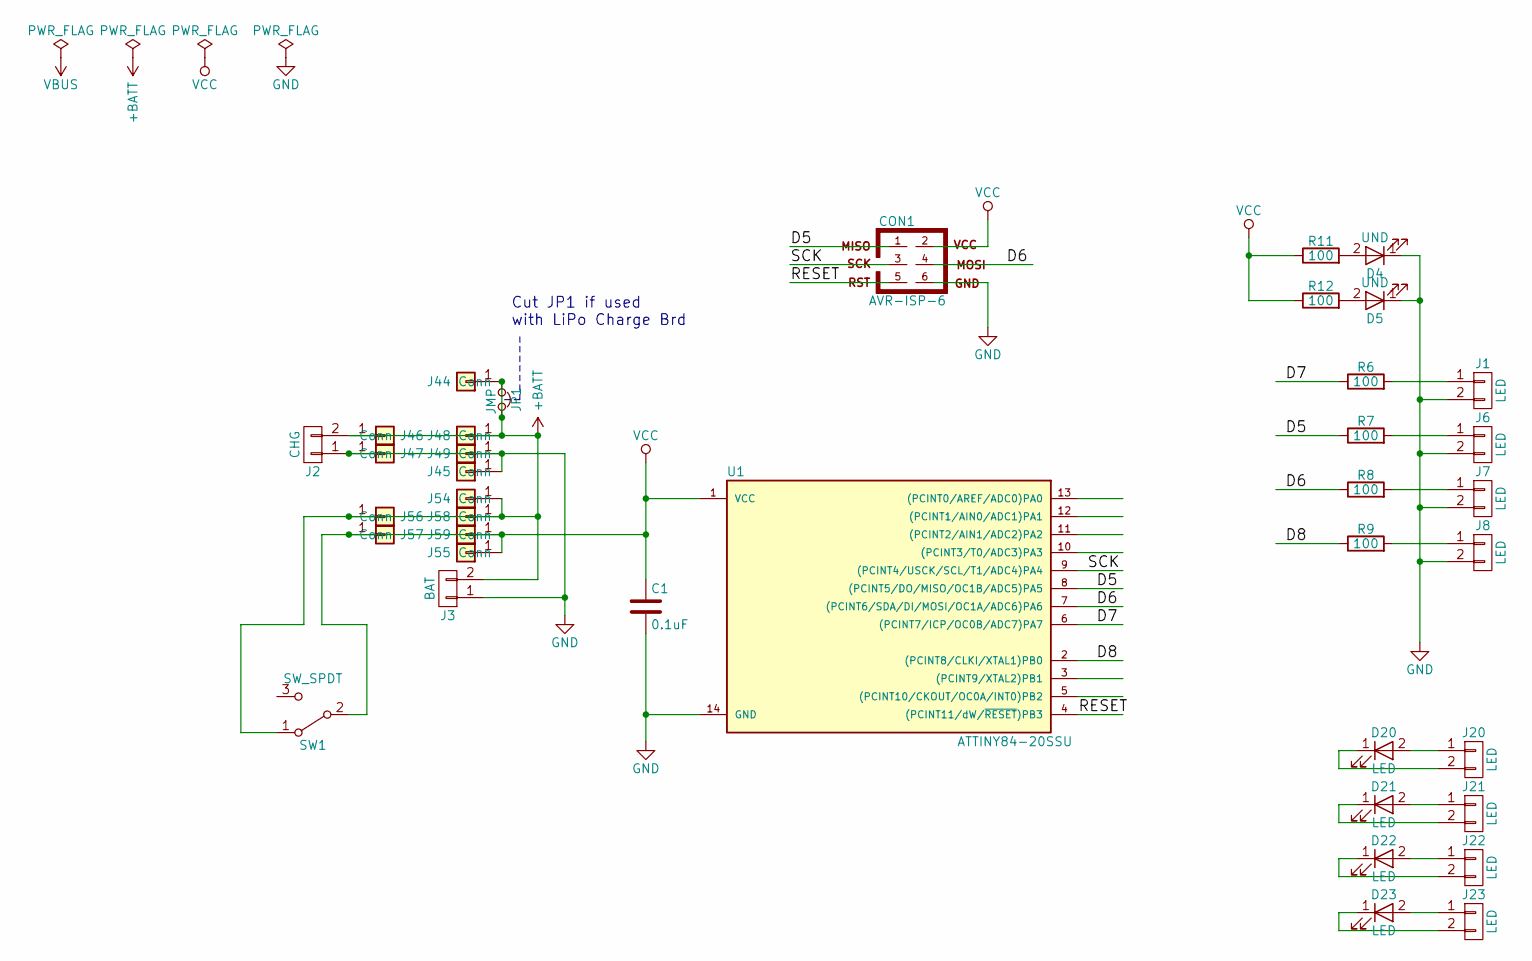
[picture p431: schematic project.sch, LiPo LED Board]

Parts:
C1: 0.1uF; C_0805
CON1: AVR-ISP-6; Pin_Header_Straight_2x03_Pitch2.54mm
D4, D5: UND; LED_0805_HandSoldering
D20, D21, D22, D23: LED; LED_0805_HandSoldering
J1, J6, J7, J8: LED; PIN_HEADER_LED
J2: CHG; JST_SH_SM02B-SRSS-TB_02x1.00mm_Angled
J3: BAT; JST_SH_SM02B-SRSS-TB_02x1.00mm_Angled
J20, J21, J22, J23: LED; LED_PADS
J44, J45, J46, J47, J48, J49, J54, J55, J56, J57, J58, J59: Conn; SolderWirePad_single_0-8mmDrill
JP1: JMP; Jumper
R6, R7, R8, R9, R11, R12: 100; R_0603
SW1: SW_SPDT; SPST_SMD
U1: ATTINY84-20SSU; SOIC-14_3.9x8.7mm_Pitch1.27mm

Connections:
+BATT: J2.2, J3.2, J44.1, J46.1, J48.1, J54.1, J56.1, J58.1, JP1.1, JP1.2, SW1.1 (A)
/D5: CON1.1, R7.1, U1.8 ((PCINT5/DO/MISO/OC1B/ADC5)PA5)
/D6: CON1.4, R8.1, U1.7 ((PCINT6/SDA/DI/MOSI/OC1A/ADC6)PA6)
/D7: R6.1, U1.6 ((PCINT7/ICP/OC0B/ADC7)PA7)
/D8: R9.1, U1.2 ((PCINT8/CLKI/XTAL1)PB0)
/RESET: CON1.5, U1.4 ((PCINT11/dW/~RESET~)PB3)
/SCK: CON1.3, U1.9 ((PCINT4/USCK/SCL/T1/ADC4)PA4)
GND: C1.2, CON1.6, D4.1 (K), D5.1 (K), J1.2, J2.1, J3.1, J6.2, J7.2, J8.2, J45.1, J47.1, J49.1, U1.14 (GND)
unnamed: D4.2 (A), R11.2
unnamed: D5.2 (A), R12.2
unnamed: D20.1 (K), J20.2
unnamed: D20.2 (A), J20.1
unnamed: D21.1 (K), J21.2
unnamed: D21.2 (A), J21.1
unnamed: D22.1 (K), J22.2
unnamed: D22.2 (A), J22.1
unnamed: D23.1 (K), J23.2
unnamed: D23.2 (A), J23.1
unnamed: J1.1, R6.2
unnamed: J6.1, R7.2
unnamed: J7.1, R8.2
unnamed: J8.1, R9.2
VCC: C1.1, CON1.2, J55.1, J57.1, J59.1, R11.1, R12.1, SW1.2 (B), U1.1 (VCC)

Notes on the sheet:
Cut JP1 if used with LiPo Charge Brd

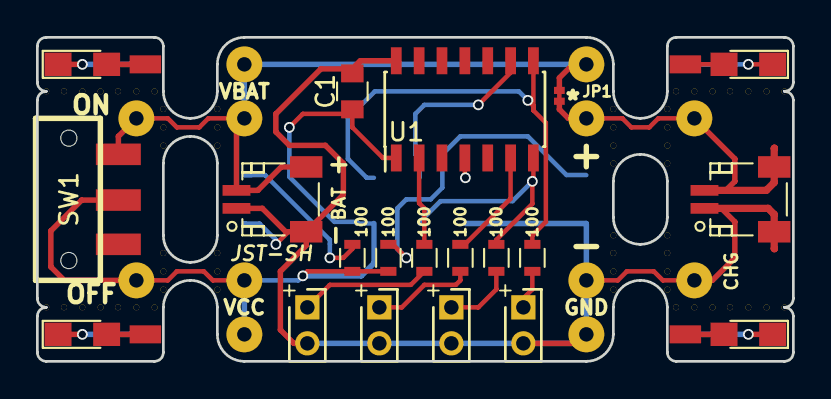
[picture p432: board projects/HotWheels/Attiny/design_files Attiny84 V0/project.kicad_pcb from above]

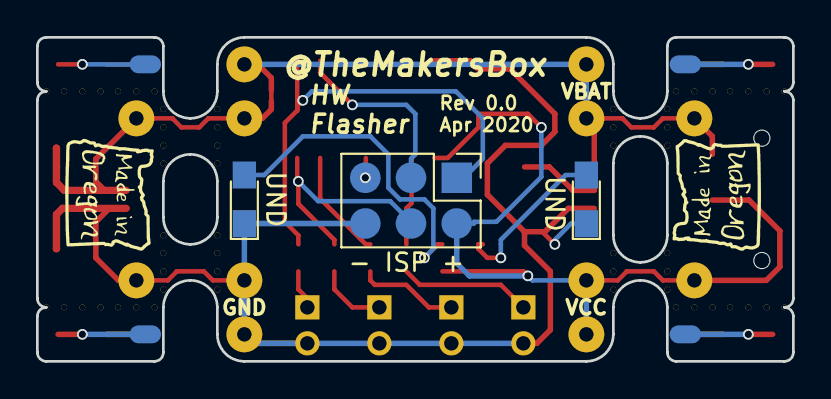
[picture p433: board projects/HotWheels/Attiny/design_files Attiny84 V0/project.kicad_pcb from below]

Board: 2 copper layers, 42.0 x 18.0 mm, 41 parts (3 on the bottom side), 23 nets.

Other parts of the board:
VAL: MadeInOregonRev25
VAL#2: MadeInOregonRev25
