aspro648/KiCad/projects/HotWheels/LiPo/design_files Charger/project.kicad_pcb

## KiCad design projects/HotWheels/LiPo/design_files Charger/project.kicad_pcb (2021-03-01)

Schematic: project.sch, HW LiPo LED Board

Parts:
C1, C2: 10uF; C_0805
D2: CHG; LED_0805_HandSoldering
D3: DONE; LED_0805_HandSoldering
J2: USB-MICRO; USB_Micro-B_Molex-105017-0001
J3: BAT; Connector_Molex_PicoBlade_53048-0210
R2, R3: 1K; R_0603
R4, R5: 10K; R_0603
U1: MCP73833; MSOP-10_3x3mm_Pitch0.5mm

Connections:
GND: C1.2, C2.2, J2.4, J2.5, J3.2, R4.2, R5.2, U1.5 (VSS)
unnamed: C2.1, J3.1, U1.9 (VBAT), U1.10 (VBAT)
unnamed: D2.1 (K), R2.2
unnamed: D3.1 (K), R3.2
unnamed: R2.1, U1.3 (STAT1)
unnamed: R3.1, U1.4 (STAT2)
unnamed: R4.1, U1.8 (THERM)
unnamed: R5.1, U1.6 (PROG)
VBUS: C1.1, D2.2 (A), D3.2 (A), J2.1, U1.1 (VDD), U1.2 (VDD)

Notes on the sheet:
R5: 10K= 100 mA 5K = 200 mA 2K = 500 mA 1K = 1000 mA
