aspro648/KiCad/projects/HotWheels/LiPo/design_files Charger/project.kicad_pcb

## KiCad design projects/HotWheels/LiPo/design_files Charger/project.kicad_pcb (continued)

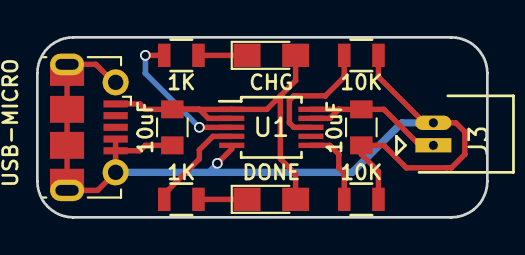
[picture p434: board projects/HotWheels/LiPo/design_files Charger/project.kicad_pcb from above]

Board: 2 copper layers, 25.0 x 10.0 mm, 11 parts (0 on the bottom side), 9 nets.
