aspro648/KiCad/projects/HotWheels/Attiny/design_files Attiny85 V0/project.kicad_pcb

## KiCad design projects/HotWheels/Attiny/design_files Attiny85 V0/project.kicad_pcb (2021-03-01, an earlier design)

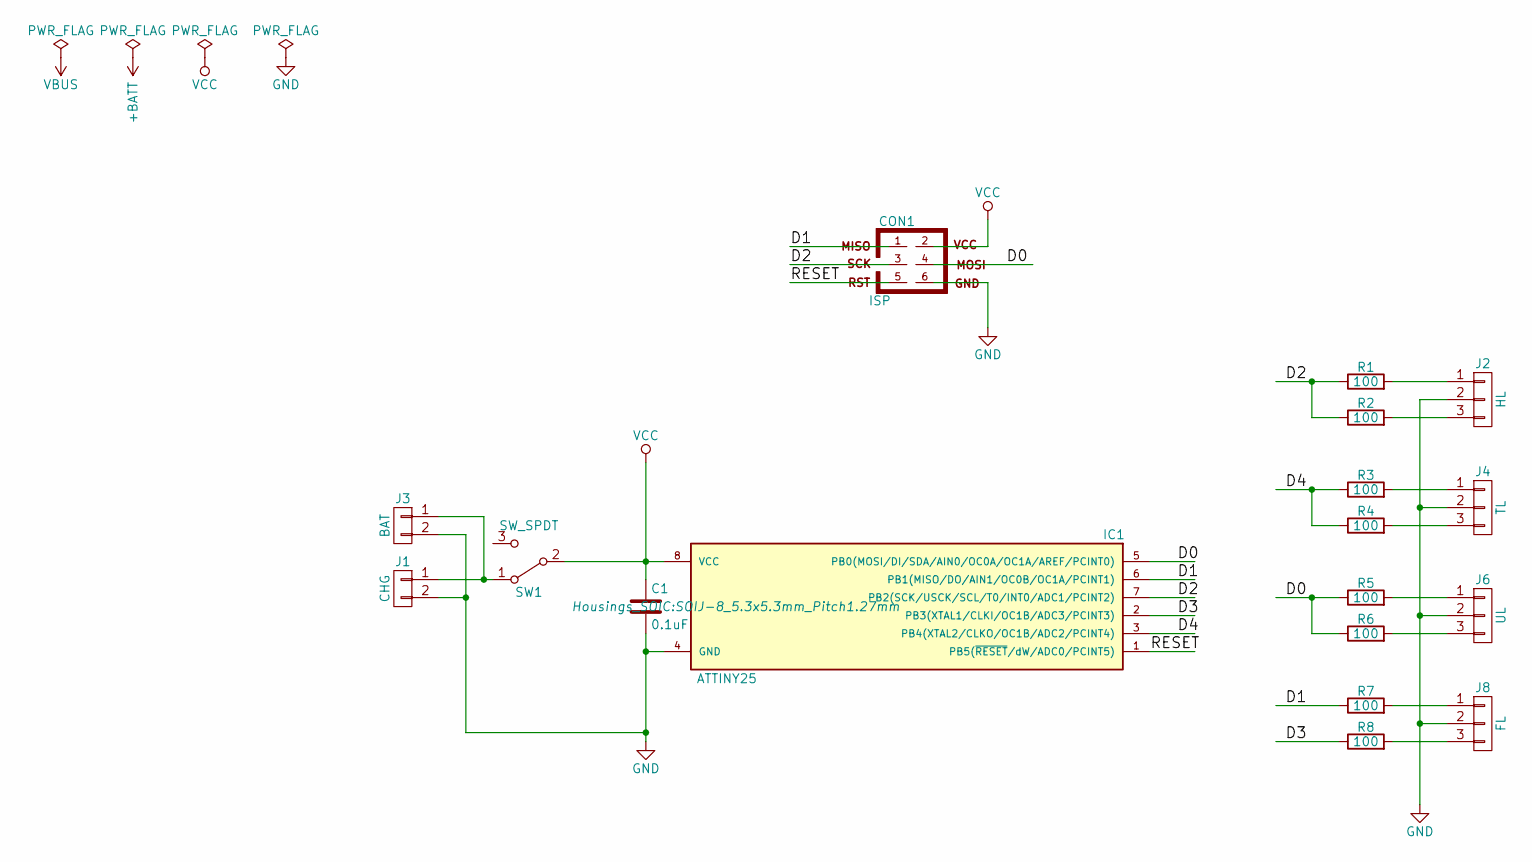
[picture p435: schematic project.sch, LiPo LED Board]

Parts:
C1: 0.1uF; C_0805
CON1: ISP; Pin_Header_Straight_2x03_Pitch2.54mm
IC1: ATTINY25; SOIJ-8_5.3x5.3mm_Pitch1.27mm
J1: CHG; Connector_Molex_PicoBlade_53047-0210
J2: HL; Pin_Header_SMD_1x03
J3: BAT; PIN_HEADER_LED
J4: TL; Pin_Header_SMD_1x03
J6: UL; Pin_Header_SMD_1x03
J8: FL; Pin_Header_SMD_1x03
R1: 100; R_0805_HandSoldering
R2, R3, R4, R5, R6, R7, R8: 100; R_0603
SW1: SW_SPDT; JS102011SCQN

Connections:
/D0: CON1.4, IC1.5 (PB0(MOSI/DI/SDA/AIN0/OC0A/OC1A/AREF/PCI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), R5.1, R6.1
/D1: CON1.1, IC1.6 (PB1(MISO/DO/AIN1/OC0B/OC1A/PCINT1)), R7.1
/D2: CON1.3, IC1.7 (PB2(SCK/USCK/SCL/T0/INT0/ADC1/PCINT2)), R1.1, R2.1
/D3: IC1.2 (PB3(XTAL1/CLKI/OC1B/ADC3/PCINT3)), R8.1
/D4: IC1.3 (PB4(XTAL2/CLKO/OC1B/ADC2/PCINT4)), R3.1, R4.1
/RESET: CON1.5, IC1.1 (PB5(~RESET~/dW/ADC0/PCINT5))
GND: C1.2, CON1.6, IC1.4 (GND), J1.2, J2.2, J3.2, J4.2, J6.2, J8.2
unnamed: J1.1, J3.1, SW1.1 (A)
unnamed: J2.1, R1.2
unnamed: J2.3, R2.2
unnamed: J4.1, R3.2
unnamed: J4.3, R4.2
unnamed: J6.1, R5.2
unnamed: J6.3, R6.2
unnamed: J8.1, R7.2
unnamed: J8.3, R8.2
VCC: C1.1, CON1.2, IC1.8 (VCC), SW1.2 (B)

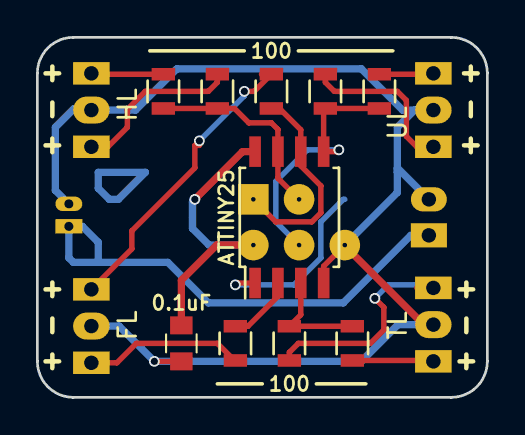
[picture p436: board projects/HotWheels/Attiny/design_files Attiny85 V0/project.kicad_pcb from above]

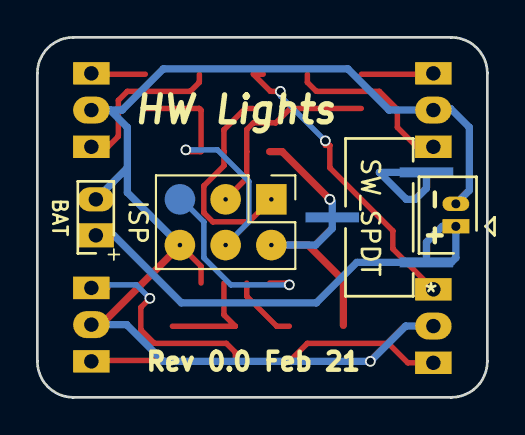
[picture p437: board projects/HotWheels/Attiny/design_files Attiny85 V0/project.kicad_pcb from below]

Board: 2 copper layers, 25.0 x 20.0 mm, 18 parts (4 on the bottom side), 17 nets.
