aspro648/KiCad/projects/HotWheels/328 Accel/design_files V0.6/project.kicad_pcb

## KiCad design projects/HotWheels/328 Accel/design_files V0.6/project.kicad_pcb (2021-02-11)

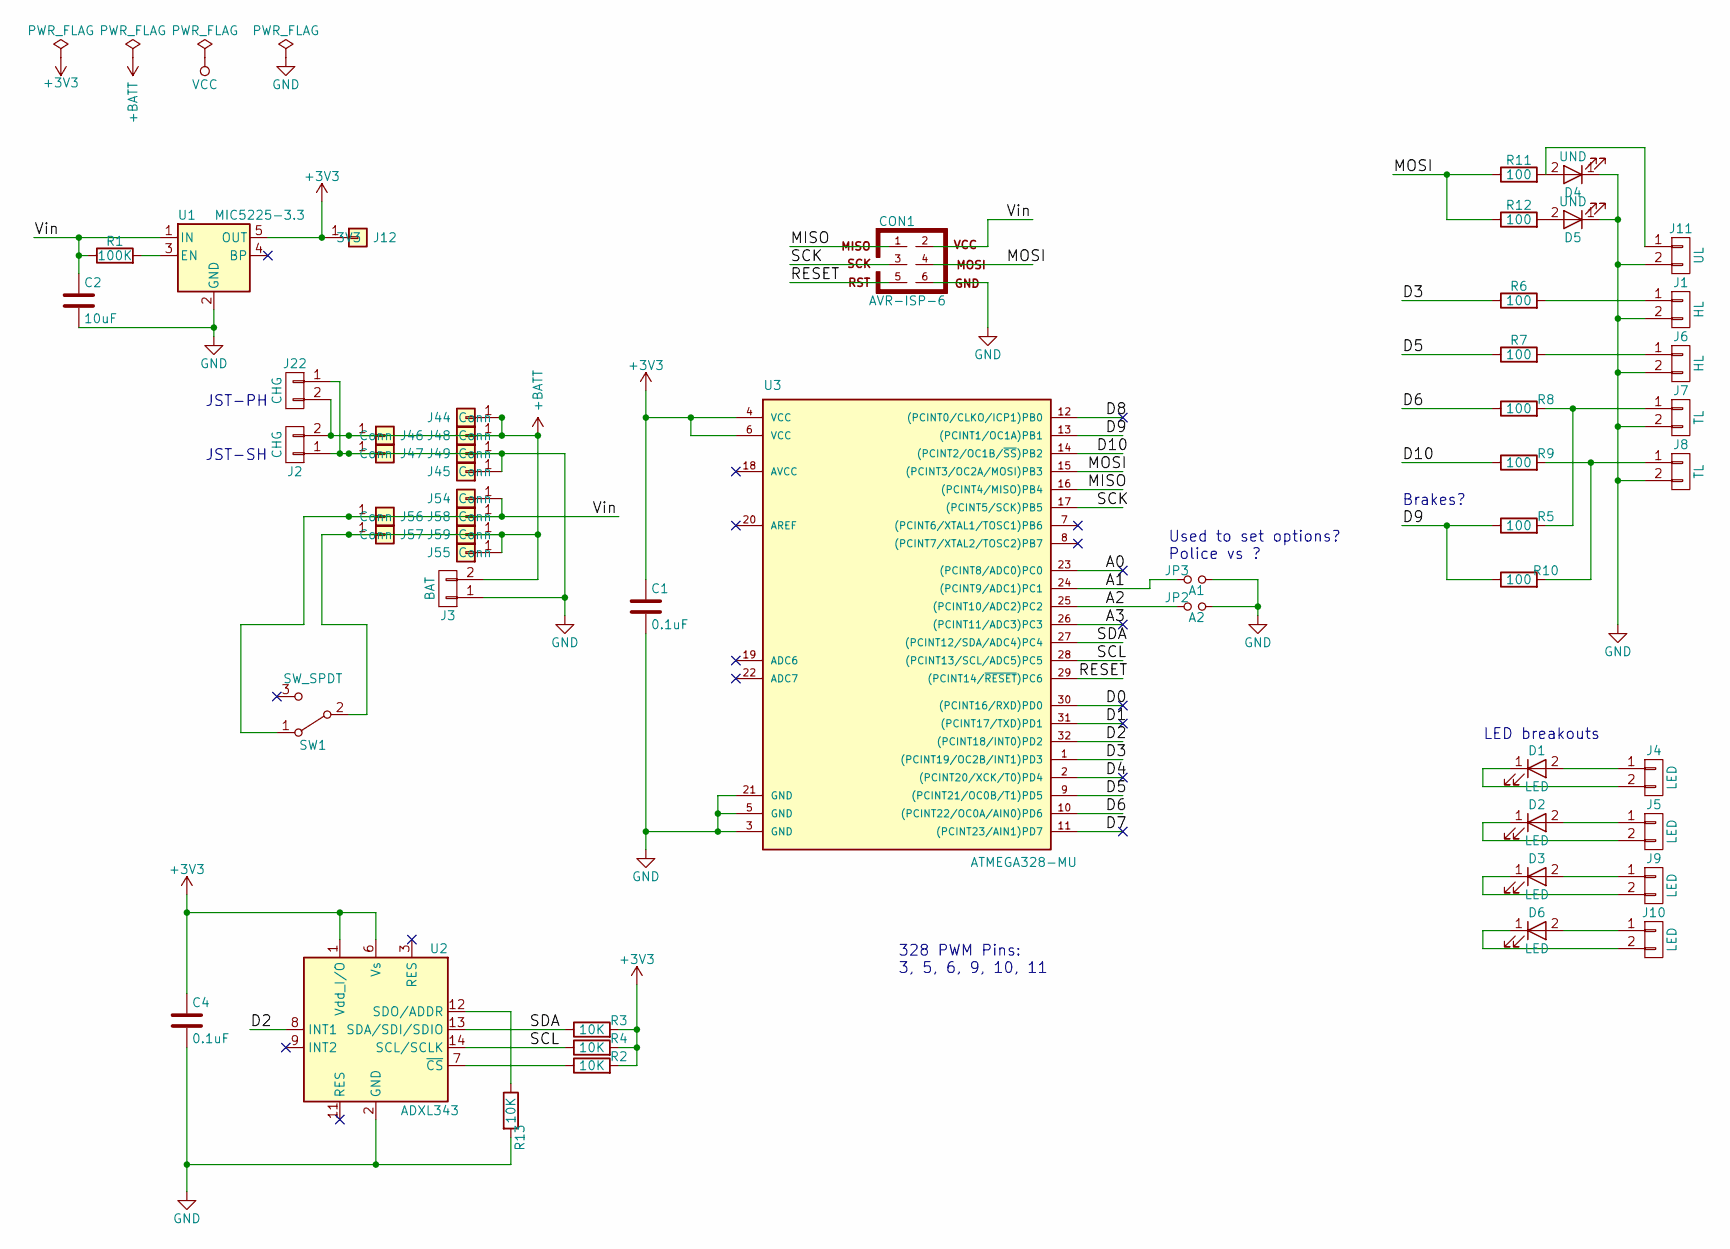
[picture p438: schematic project.sch, Hot Wheels Arduino Lights]

Parts:
C1, C4: 0.1uF; C_0805
C2: 10uF; C_0805
CON1: AVR-ISP-6; Pin_Header_Straight_2x03_Pitch2.54mm
D1, D2, D3, D6: LED; LED_0805_HandSoldering
D4, D5: UND; LED_0805_HandSoldering
J1, J6: HL; PIN_HEADER_LED
J2, J22: CHG; JST_SH_SM02B-SRSS-TB_02x1.00mm_Angled
J3: BAT; JST_SH_SM02B-SRSS-TB_02x1.00mm_Angled
J4, J5, J9, J10: LED; LED_PADS
J7, J8: TL; PIN_HEADER_LED
J11: UL; PIN_HEADER_LED
J12: 3V3; SolderWirePad_single_SMD_5x10mm
J44, J45, J46, J47, J48, J49, J54, J55, J56, J57, J58, J59: Conn; SolderWirePad_single_0-8mmDrill
JP2: A2; Jumper
JP3: A1; Jumper
R1: 100K; R_0603
R2, R3, R4, R13: 10K; R_0603
R5, R6, R7, R8, R9, R10, R11, R12: 100; R_0603
SW1: SW_SPDT; SPST_SMD
U1: MIC5225-3.3; SOT-23-5
U2: ADXL343; lga-14
U3: ATMEGA328-MU; QFN-32-1EP_5x5mm_Pitch0.5mm

Connections:
+3V3: C1.1, C4.1, J12.1, R2.2, R3.2, R4.2, U1.5 (OUT), U2.1 (Vdd_I/O), U2.6 (Vs), U3.4 (VCC), U3.6 (VCC)
+BATT: J2.2, J3.2, J22.2, J44.1, J46.1, J48.1, J55.1, J57.1, J59.1, SW1.2 (B)
/A0: U3.23 ((PCINT8/ADC0)PC0)
/A1: JP3.1, U3.24 ((PCINT9/ADC1)PC1)
/A2: JP2.1, U3.25 ((PCINT10/ADC2)PC2)
/A3: U3.26 ((PCINT11/ADC3)PC3)
/D0: U3.30 ((PCINT16/RXD)PD0)
/D1: U3.31 ((PCINT17/TXD)PD1)
/D2: U2.8 (INT1), U3.32 ((PCINT18/INT0)PD2)
/D3: R6.1, U3.1 ((PCINT19/OC2B/INT1)PD3)
/D4: U3.2 ((PCINT20/XCK/T0)PD4)
/D5: R7.1, U3.9 ((PCINT21/OC0B/T1)PD5)
/D6: R8.1, U3.10 ((PCINT22/OC0A/AIN0)PD6)
/D7: U3.11 ((PCINT23/AIN1)PD7)
/D8: U3.12 ((PCINT0/CLKO/ICP1)PB0)
/D9: R5.1, R10.1, U3.13 ((PCINT1/OC1A)PB1)
/D10: R9.1, U3.14 ((PCINT2/OC1B/~SS~)PB2)
/MISO: CON1.1, U3.16 ((PCINT4/MISO)PB4)
/MOSI: CON1.4, R11.1, R12.1, U3.15 ((PCINT3/OC2A/MOSI)PB3)
/RESET: CON1.5, U3.29 ((PCINT14/~RESET~)PC6)
/SCK: CON1.3, U3.17 ((PCINT5/SCK)PB5)
/SCL: R4.1, U2.14 (SCL/SCLK), U3.28 ((PCINT13/SCL/ADC5)PC5)
/SDA: R3.1, U2.13 (SDA/SDI/SDIO), U3.27 ((PCINT12/SDA/ADC4)PC4)
/Vin: C2.1, CON1.2, J54.1, J56.1, J58.1, R1.1, SW1.1 (A), U1.1 (IN)
GND: C1.2, C2.2, C4.2, CON1.6, D4.1 (K), D5.1 (K), J1.2, J2.1, J3.1, J6.2, J7.2, J8.2, J11.2, J22.1, J45.1, J47.1, J49.1, JP2.2, JP3.2, R13.2, U1.2 (GND), U2.2 (GND), U2.4 (GND), U2.5 (GND), U3.3 (GND), U3.5 (GND), U3.21 (GND)
unnamed: D1.1 (K), J4.2
unnamed: D1.2 (A), J4.1
unnamed: D2.1 (K), J5.2
unnamed: D2.2 (A), J5.1
unnamed: D3.1 (K), J9.2
unnamed: D3.2 (A), J9.1
unnamed: D4.2 (A), J11.1, R11.2
unnamed: D5.2 (A), R12.2
unnamed: D6.1 (K), J10.2
unnamed: D6.2 (A), J10.1
unnamed: J1.1, R6.2
unnamed: J6.1, R7.2
unnamed: J7.1, R5.2, R8.2
unnamed: J8.1, R9.2, R10.2
unnamed: R1.2, U1.3 (EN)
unnamed: R2.1, U2.7 (~CS)
unnamed: R13.1, U2.12 (SDO/ADDR)

Notes on the sheet:
328 PWM Pins: 3, 5, 6, 9, 10, 11
JST-PH
JST-SH
Used to set options? Police vs ?
Brakes?
LED breakouts

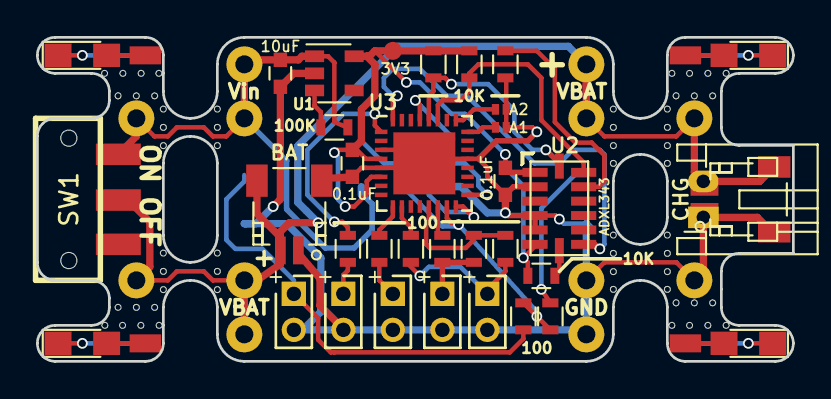
[picture p439: board projects/HotWheels/328 Accel/design_files V0.6/project.kicad_pcb from above]

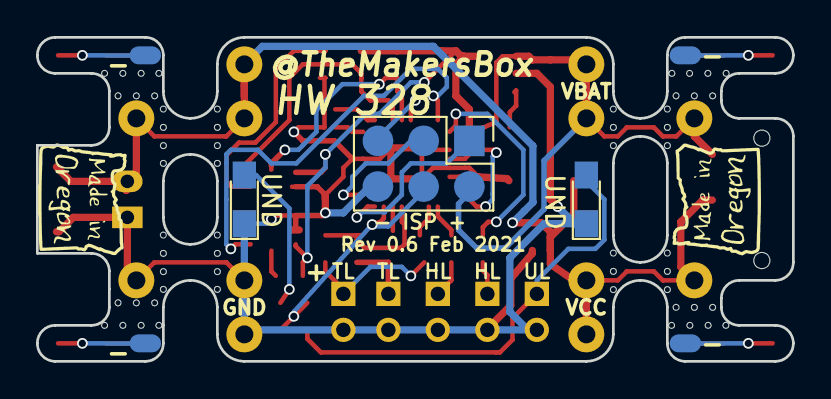
[picture p440: board projects/HotWheels/328 Accel/design_files V0.6/project.kicad_pcb from below]

Board: 2 copper layers, 42.0 x 18.0 mm, 56 parts (3 on the bottom side), 35 nets.

Other parts of the board:
VAL: MadeInOregonRev25
VAL#2: MadeInOregonRev25
