aspro648/KiCad/projects/tester/JST_XSRS/board.kicad_pcb

## KiCad design projects/tester/JST_XSRS/board.kicad_pcb (2020-10-30)

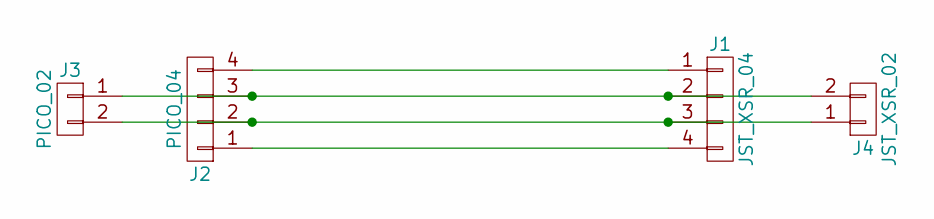
[picture p441: schematic board.sch]

Parts:
J1: JST_XSR_04; JST_SH_BM04B-SRSS-TB_04x1.00mm_Straight
J2: PICO_04; Molex_PicoBlade_53048-0410_04x1.25mm_Angled
J3: PICO_02; Molex_PicoBlade_53048-0210_02x1.25mm_Angled
J4: JST_XSR_02; JST_SH_BM02B-SRSS-TB_02x1.00mm_Straight

Connections:
unnamed: J1.1, J2.4
unnamed: J1.2, J2.3, J3.1, J4.2
unnamed: J1.3, J2.2, J3.2, J4.1
unnamed: J1.4, J2.1

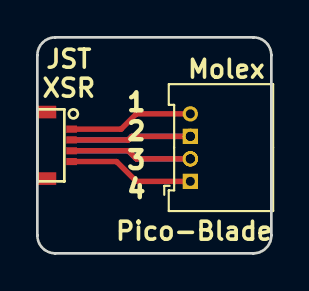
[picture p442: board board.kicad_pcb from above]

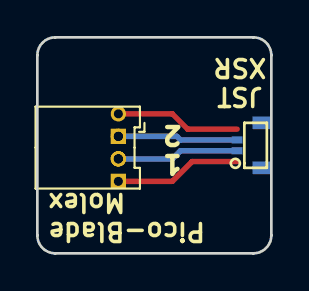
[picture p443: board board.kicad_pcb from below]

Board: 2 copper layers, 13.0 x 12.0 mm, 4 parts (2 on the bottom side), 4 nets.
