aspro648/KiCad/projects/tester/UCT/project.kicad_pcb

## KiCad design projects/tester/UCT/project.kicad_pcb (2021-02-09)

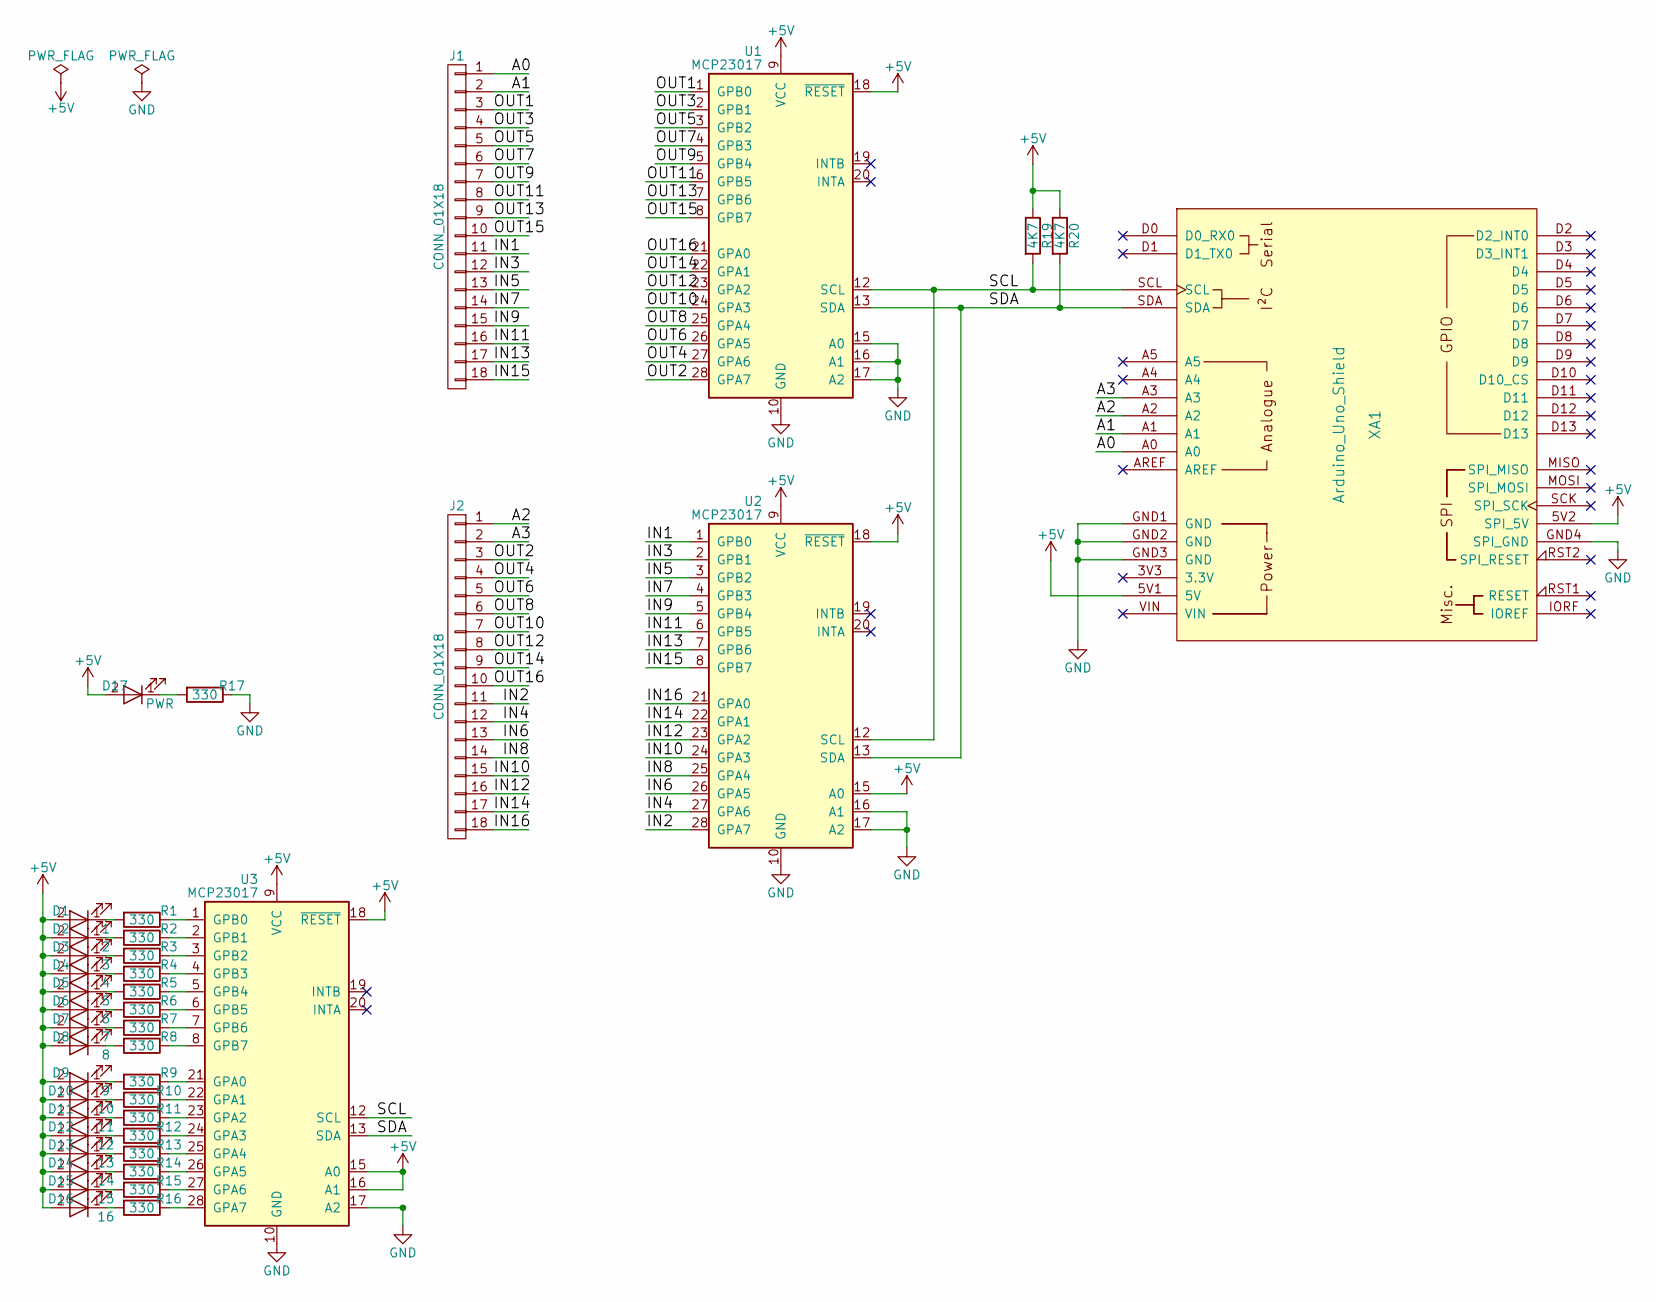
[picture p444: schematic project.sch, Universal Cable Tester]

Parts:
D1: 1; LED_0805_HandSoldering
D2: 2; LED_0805_HandSoldering
D3: 3; LED_0805_HandSoldering
D4: 4; LED_0805_HandSoldering
D5: 5; LED_0805_HandSoldering
D6: 6; LED_0805_HandSoldering
D7: 7; LED_0805_HandSoldering
D8: 8; LED_0805_HandSoldering
D9: 9; LED_0805_HandSoldering
D10: 10; LED_0805_HandSoldering
D11: 11; LED_0805_HandSoldering
D12: 12; LED_0805_HandSoldering
D13: 13; LED_0805_HandSoldering
D14: 14; LED_0805_HandSoldering
D15: 15; LED_0805_HandSoldering
D16: 16; LED_0805_HandSoldering
D17: PWR; LED_0805_HandSoldering
J1, J2: CONN_01X18; Pin_Header_Straight_1x18_Pitch2.54mm
R1, R2, R3, R4, R5, R6, R7, R8, R9, R10, R11, R12, R13, R14, R15, R16, R17: 330; R_0805_HandSoldering
R19, R20: 4K7; R_0805_HandSoldering
U1, U2, U3: MCP23017; SSOP-28_5.3x10.2mm_Pitch0.65mm
XA1: Arduino_Uno_Shield

Connections:
+5V: D1.2 (A), D2.2 (A), D3.2 (A), D4.2 (A), D5.2 (A), D6.2 (A), D7.2 (A), D8.2 (A), D9.2 (A), D10.2 (A), D11.2 (A), D12.2 (A), D13.2 (A), D14.2 (A), D15.2 (A), D16.2 (A), D17.2 (A), R19.1, R20.1, U1.9 (VCC), U1.18 (~RESET), U2.9 (VCC), U2.15 (A0), U2.18 (~RESET), U3.9 (VCC), U3.15 (A0), U3.16 (A1), U3.18 (~RESET), XA1.5V1 (5V), XA1.5V2 (SPI_5V)
/A0: J1.1, XA1.A0
/A1: J1.2, XA1.A1
/A2: J2.1, XA1.A2
/A3: J2.2, XA1.A3
/IN1: J1.11, U2.1 (GPB0)
/IN2: J2.11, U2.28 (GPA7)
/IN3: J1.12, U2.2 (GPB1)
/IN4: J2.12, U2.27 (GPA6)
/IN5: J1.13, U2.3 (GPB2)
/IN6: J2.13, U2.26 (GPA5)
/IN7: J1.14, U2.4 (GPB3)
/IN8: J2.14, U2.25 (GPA4)
/IN9: J1.15, U2.5 (GPB4)
/IN10: J2.15, U2.24 (GPA3)
/IN11: J1.16, U2.6 (GPB5)
/IN12: J2.16, U2.23 (GPA2)
/IN13: J1.17, U2.7 (GPB6)
/IN14: J2.17, U2.22 (GPA1)
/IN15: J1.18, U2.8 (GPB7)
/IN16: J2.18, U2.21 (GPA0)
/OUT1: J1.3, U1.1 (GPB0)
/OUT2: J2.3, U1.28 (GPA7)
/OUT3: J1.4, U1.2 (GPB1)
/OUT4: J2.4, U1.27 (GPA6)
/OUT5: J1.5, U1.3 (GPB2)
/OUT6: J2.5, U1.26 (GPA5)
/OUT7: J1.6, U1.4 (GPB3)
/OUT8: J2.6, U1.25 (GPA4)
/OUT9: J1.7, U1.5 (GPB4)
/OUT10: J2.7, U1.24 (GPA3)
/OUT11: J1.8, U1.6 (GPB5)
/OUT12: J2.8, U1.23 (GPA2)
/OUT13: J1.9, U1.7 (GPB6)
/OUT14: J2.9, U1.22 (GPA1)
/OUT15: J1.10, U1.8 (GPB7)
/OUT16: J2.10, U1.21 (GPA0)
/SCL: R19.2, U1.12 (SCL), U2.12 (SCL), U3.12 (SCL), XA1.SCL
/SDA: R20.2, U1.13 (SDA), U2.13 (SDA), U3.13 (SDA), XA1.SDA
GND: R17.1, U1.10 (GND), U1.15 (A0), U1.16 (A1), U1.17 (A2), U2.10 (GND), U2.16 (A1), U2.17 (A2), U3.10 (GND), U3.17 (A2), XA1.GND1 (GND), XA1.GND2 (GND), XA1.GND3 (GND), XA1.GND4 (SPI_GND)
unnamed: D1.1 (K), R1.2
unnamed: D2.1 (K), R2.2
unnamed: D3.1 (K), R3.2
unnamed: D4.1 (K), R4.2
unnamed: D5.1 (K), R5.2
unnamed: D6.1 (K), R6.2
unnamed: D7.1 (K), R7.2
unnamed: D8.1 (K), R8.2
unnamed: D9.1 (K), R9.2
unnamed: D10.1 (K), R10.2
unnamed: D11.1 (K), R11.2
unnamed: D12.1 (K), R12.2
unnamed: D13.1 (K), R13.2
unnamed: D14.1 (K), R14.2
unnamed: D15.1 (K), R15.2
unnamed: D16.1 (K), R16.2
unnamed: D17.1 (K), R17.2
unnamed: R1.1, U3.1 (GPB0)
unnamed: R2.1, U3.2 (GPB1)
unnamed: R3.1, U3.3 (GPB2)
unnamed: R4.1, U3.4 (GPB3)
unnamed: R5.1, U3.5 (GPB4)
unnamed: R6.1, U3.6 (GPB5)
unnamed: R7.1, U3.7 (GPB6)
unnamed: R8.1, U3.8 (GPB7)
unnamed: R9.1, U3.21 (GPA0)
unnamed: R10.1, U3.22 (GPA1)
unnamed: R11.1, U3.23 (GPA2)
unnamed: R12.1, U3.24 (GPA3)
unnamed: R13.1, U3.25 (GPA4)
unnamed: R14.1, U3.26 (GPA5)
unnamed: R15.1, U3.27 (GPA6)
unnamed: R16.1, U3.28 (GPA7)

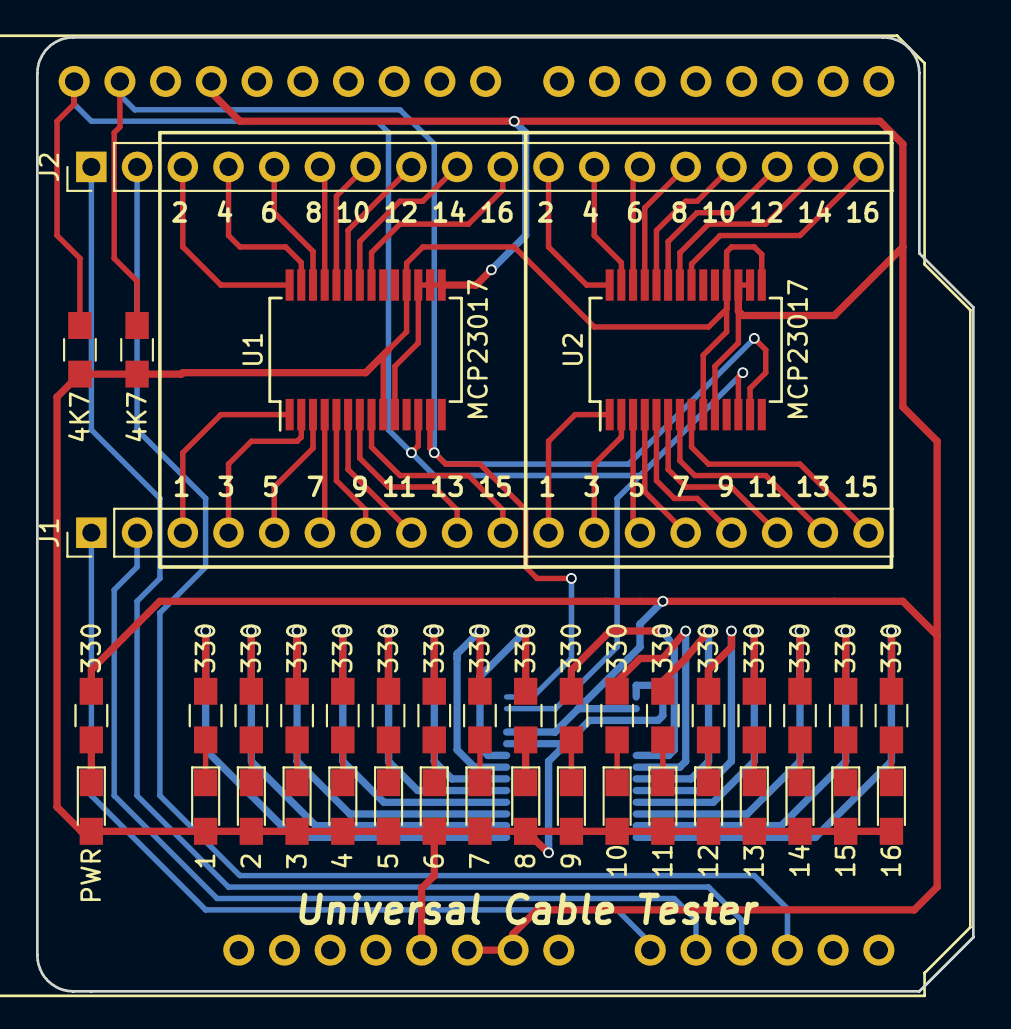
[picture p445: board projects/tester/UCT/project.kicad_pcb from above]

Board: 2 copper layers, 52.0 x 53.0 mm, 42 parts (1 on the bottom side), 73 nets.
