aspro648/KiCad/projects/tester/UCT PicoClasp/project.kicad_pcb

## KiCad design projects/tester/UCT PicoClasp/project.kicad_pcb (2021-02-09)

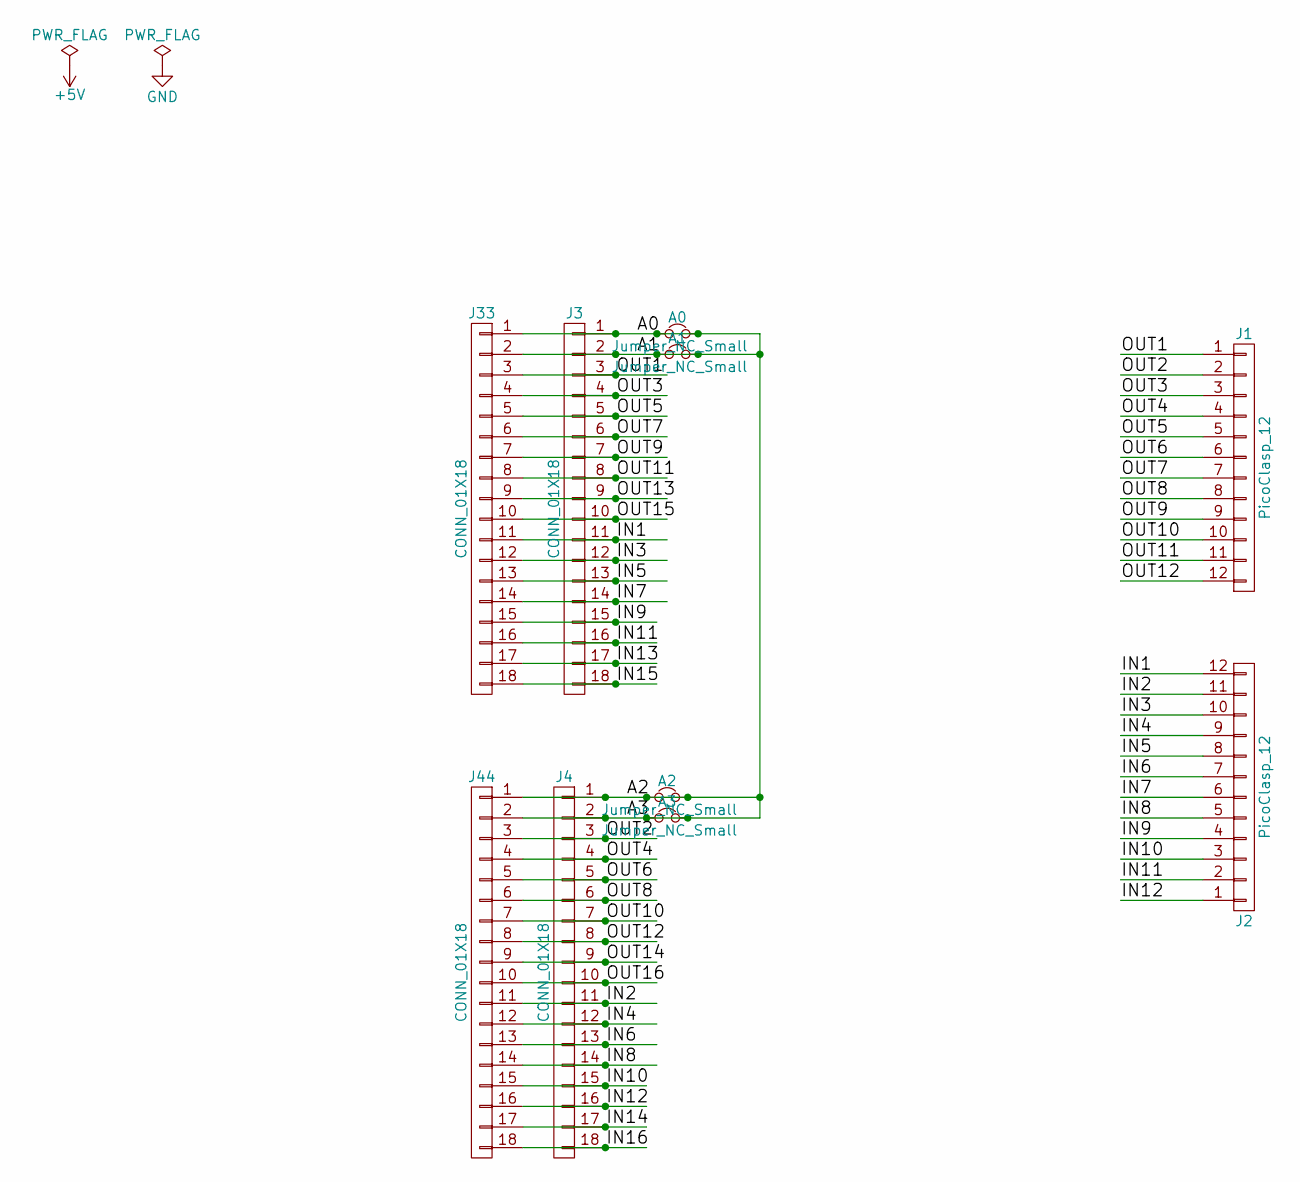
[picture p446: schematic project.sch]

Parts:
A0, A1, A2, A3: Jumper_NC_Small; R_0805_HandSoldering
J1, J2: PicoClasp_12; Molex_PicoClasp_501331-1207_1x12_P1.0mm_Vertical
J3, J4, J33, J44: CONN_01X18; Pin_Header_Straight_1x18_Pitch2.54mm

Connections:
/A0: A0.1, A0.2, A1.1, A1.2, A2.1, A2.2, A3.1, A3.2, J3.1, J3.2, J4.1, J4.2, J33.1, J33.2, J44.1, J44.2
/IN1: J2.12, J3.11, J33.11
/IN2: J2.11, J4.11, J44.11
/IN3: J2.10, J3.12, J33.12
/IN4: J2.9, J4.12, J44.12
/IN5: J2.8, J3.13, J33.13
/IN6: J2.7, J4.13, J44.13
/IN7: J2.6, J3.14, J33.14
/IN8: J2.5, J4.14, J44.14
/IN9: J2.4, J3.15, J33.15
/IN10: J2.3, J4.15, J44.15
/IN11: J2.2, J3.16, J33.16
/IN12: J2.1, J4.16, J44.16
/IN13: J3.17, J33.17
/IN14: J4.17, J44.17
/IN15: J3.18, J33.18
/IN16: J4.18, J44.18
/OUT1: J1.1, J3.3, J33.3
/OUT2: J1.2, J4.3, J44.3
/OUT3: J1.3, J3.4, J33.4
/OUT4: J1.4, J4.4, J44.4
/OUT5: J1.5, J3.5, J33.5
/OUT6: J1.6, J4.5, J44.5
/OUT7: J1.7, J3.6, J33.6
/OUT8: J1.8, J4.6, J44.6
/OUT9: J1.9, J3.7, J33.7
/OUT10: J1.10, J4.7, J44.7
/OUT11: J1.11, J3.8, J33.8
/OUT12: J1.12, J4.8, J44.8
/OUT13: J3.9, J33.9
/OUT14: J4.9, J44.9
/OUT15: J3.10, J33.10
/OUT16: J4.10, J44.10

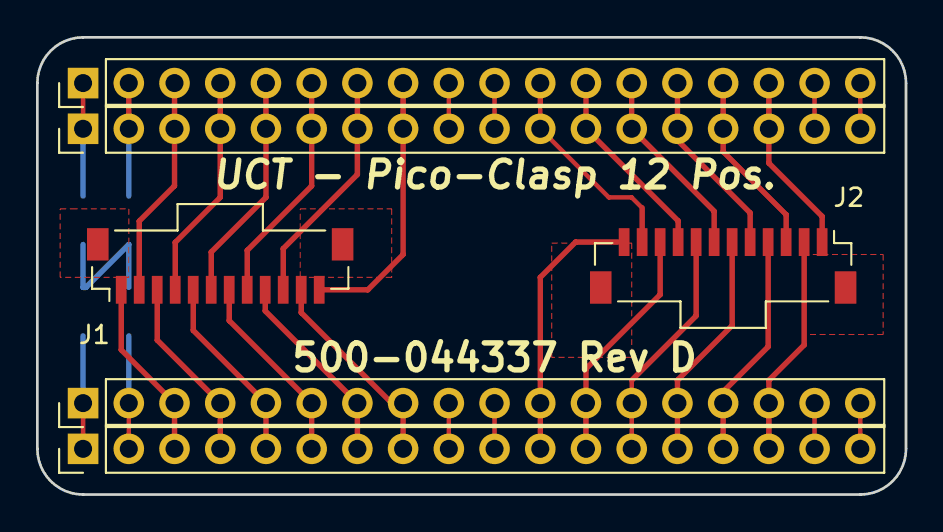
[picture p447: board projects/tester/UCT PicoClasp/project.kicad_pcb from above]

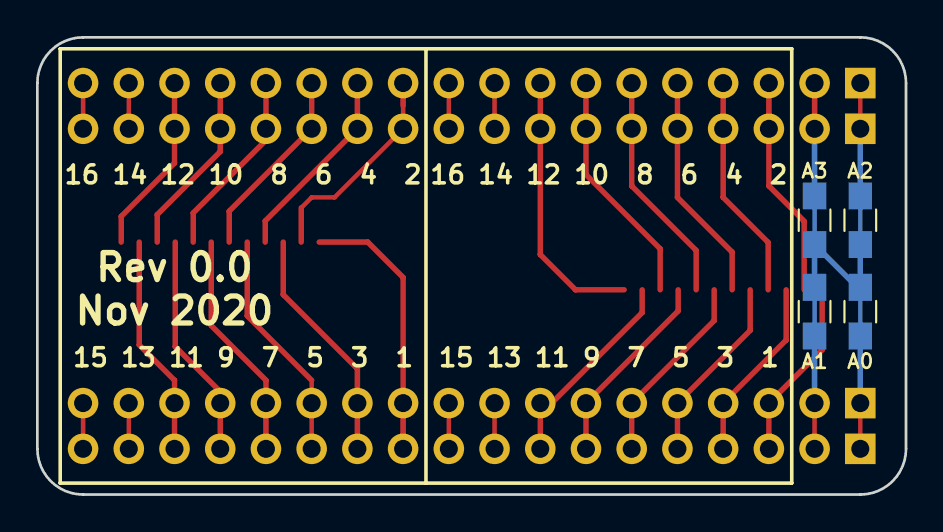
[picture p448: board projects/tester/UCT PicoClasp/project.kicad_pcb from below]

Board: 2 copper layers, 48.3 x 25.4 mm, 10 parts (4 on the bottom side), 33 nets.
