aspro648/KiCad/projects/HotWheels/IR/design_files V0.0/project.kicad_pcb

## KiCad design projects/HotWheels/IR/design_files V0.0/project.kicad_pcb (2020-06-05, an earlier design)

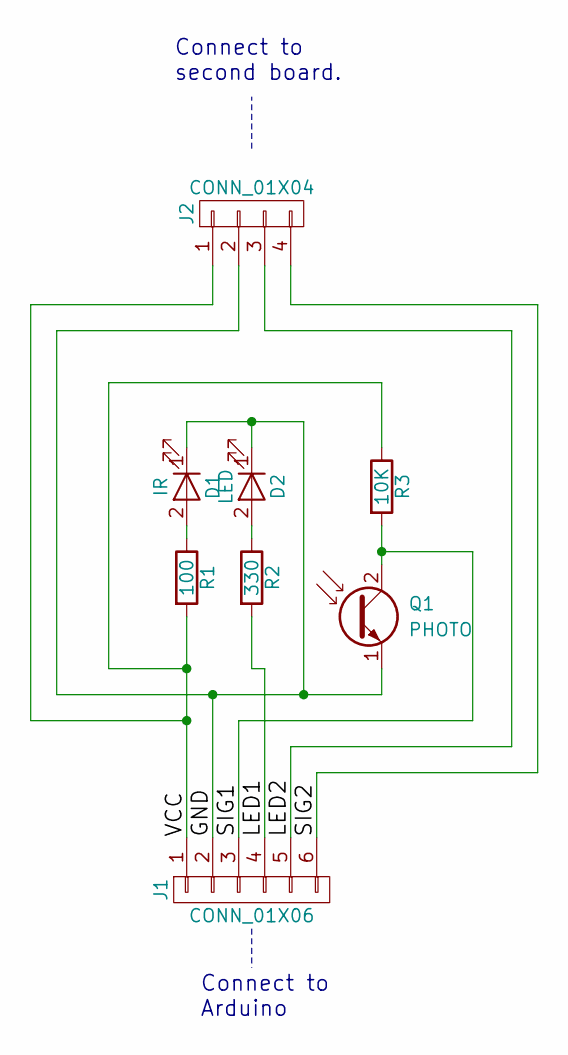
[picture p449: schematic project.sch]

Parts:
D1: IR; LED_0805_HandSoldering
D2: LED; LED_0805_HandSoldering
J1: CONN_01X06; Pin_Header_Straight_1x06_Pitch2.54mm
J2: CONN_01X04; Pin_Header_Straight_1x04_Pitch2.54mm
Q1: PHOTO; LED_0805_HandSoldering
R1: 100; R_0805_HandSoldering
R2: 330; R_0805_HandSoldering
R3: 10K; R_0805_HandSoldering

Connections:
/GND: D1.1 (K), D2.1 (K), J1.2, J2.2, Q1.1 (E)
/LED1: J1.4, R2.2
/LED2: J1.5, J2.3
/SIG1: J1.3, Q1.2 (C), R3.2
/SIG2: J1.6, J2.4
/VCC: J1.1, J2.1, R1.2, R3.1
unnamed: D1.2 (A), R1.1
unnamed: D2.2 (A), R2.1

Notes on the sheet:
Connect to second board.
Connect to Arduino

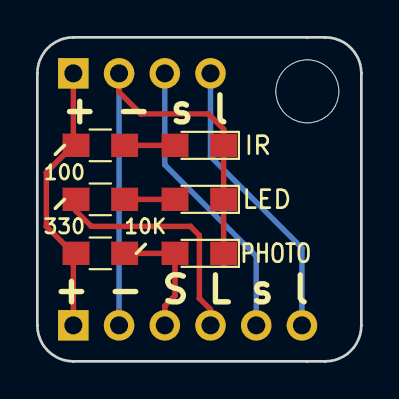
[picture p450: board projects/HotWheels/IR/design_files V0.0/project.kicad_pcb from above]

Board: 2 copper layers, 18.0 x 18.0 mm, 8 parts (0 on the bottom side), 8 nets.
