aspro648/KiCad/projects/Cable/project.sch

## KiCad design projects/Cable/project.sch (2020-06-24)

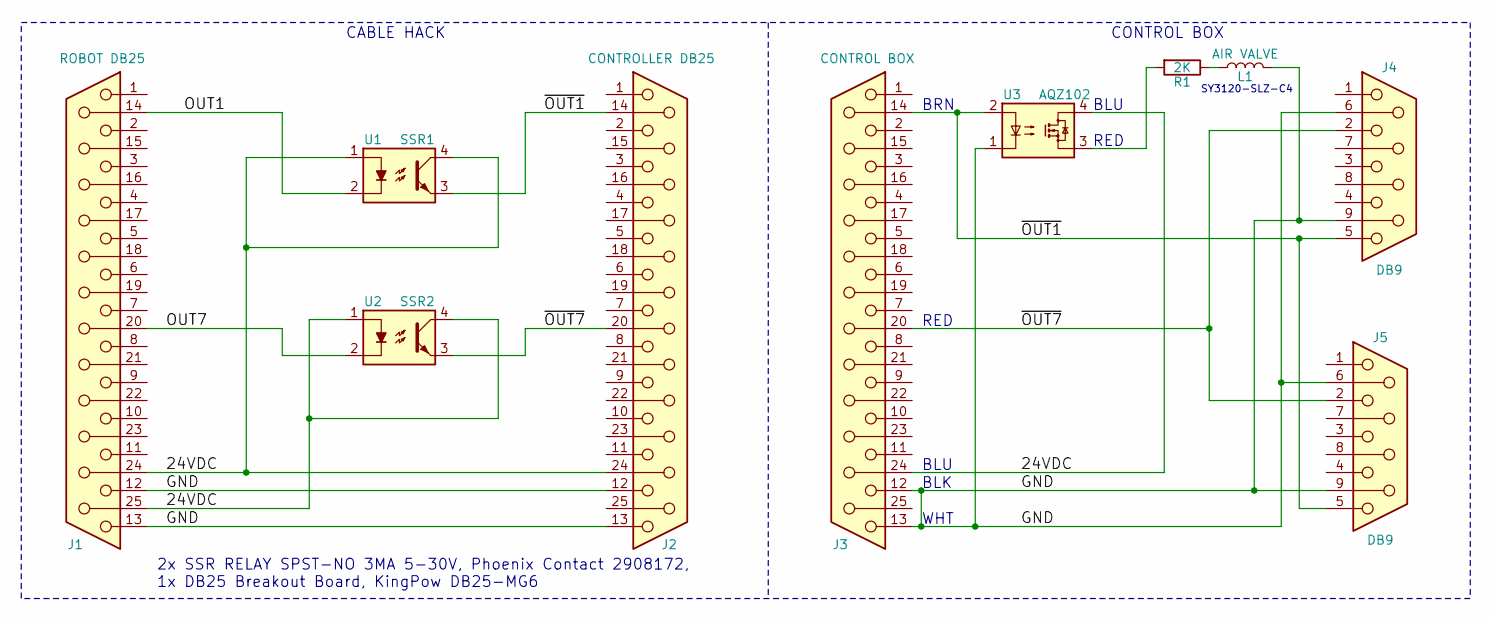
[picture p451: schematic project.sch]

Parts:
J1: ROBOT DB25
J2: CONTROLLER DB25
J3: CONTROL BOX
J4, J5: DB9
L1: AIR VALVE
R1: 2K
U1: SSR1; DIP-4_W7.62mm_SMD
U2: SSR2; DIP-4_W7.62mm_SMD
U3: AQZ102; SOP-4_3.8x4.1mm_P2.54mm

Connections:
24VDC: J1.24, J1.25, J2.24, J3.24, U1.1, U1.4, U2.1, U2.4, U3.4
GND: J1.12, J1.13, J2.12, J2.13, J3.12, J3.13, J4.6, J4.9, J5.6, J5.9, L1.2, U3.1
unnamed: L1.1, R1.1
unnamed: R1.2, U3.3
OUT1: J1.14, U1.2
OUT7: J1.20, U2.2
~OUT1: J2.14, J3.14, J4.5, J5.5, U1.3, U3.2
~OUT7: J2.20, J3.20, J4.2, J5.2, U2.3

Notes on the sheet:
SY3120-SLZ-C4
BRN
RED
BLU
BLK
WHT
CONTROL BOX
CABLE HACK
2x SSR RELAY SPST-NO 3MA 5-30V, Phoenix Contact 2908172, 1x DB25 Breakout Board, KingPow DB25-MG6
