aspro648/KiCad/projects/RPi_Hat_Template-master/RPi_GPIO.sch

## KiCad design projects/RPi_Hat_Template-master/RPi_GPIO.sch (2017-05-26)

Schematic: RPi_GPIO.sch

Parts:
J1: RPi_GPIO; Samtec_HLE-120-02-XXX-DV-BE-XX-XX
J2: RPi_GPIO; Pin_Header_Straight_2x20

Notes on the sheet:
Surface Mount Connector
Thru-Hole Connector
