aspro648/KiCad/projects/brain_board LEGO/base.sch

## KiCad design projects/brain_board LEGO/base.sch (2017-05-26)

Schematic: base.sch

Parts:
C1: 0.1 uF; C_0805
D1: LED; LED-0805
IC1: ATTINY85; SOIC-8-N
P0, P1, P2, P5: CONN_01X01; Lego_Pad
P6, P7: CONN_01X01; Lego_Drill
PG1: CONN_01X01; Lego_Pad
PP1: CONN_01X01; Lego_Pad
R1: R; R_0805
USB1: USB_OTG; USB_Micro-B

Notes on the sheet:
D5/A0
D4/A2
D3/A3
D2/A1
D1/pwm
D0/pwm
