aspro648/KiCad/projects/brain_board/base.sch

## KiCad design projects/brain_board/base.sch (2017-05-26)

Schematic: base.sch

Parts:
BT1: Battery; BATT_CR2032
C1: 0.1 uF; C1
C2: 10uF; C_Radial_D6.3_L11.2_P2.5
D1, D2: ZD3V6; D3
D3: LED; LED-5MM
D4: 1N4001; Diode_DO-41_SOD81_Horizontal_RM10
IC1: ATTINY85; DIP-8__300
J1: USB; USB_B
P1: CONN_01X10; Pin_Header_Straight_1x10
Q1: LIGHT; PHOTO_TRANS
R1, R2: 22; Resistor_Horizontal_RM10mm
R3: 1K5; Resistor_Horizontal_RM10mm
R4: 330; Resistor_Horizontal_RM10mm
SW1: SPST; SW_SPST
TOUCH1: SW_PUSH; SW_PUSH_TOUCH

Notes on the sheet:
D5/A0
D4/A2
D3/A3
D2/A1
D1/pwm
D0/pwm
TOUCH
SOUND
RT EYE
LF EYE
GND
LIGHT
