aspro648/KiCad/projects/buzz/buzz.sch

## KiCad design projects/buzz/buzz.sch (2017-05-26)

Schematic: buzz.sch

Parts:
D1, D2: LED; LED_10MM
P1: CONN_01X10; Pin_Header_Straight_1x10
R1, R2: 220; Resistor_Horizontal_RM10mm
SP1: SPKR; PS1240_piezo
