aspro648/KiCad/projects/mini-breadboard level shifter/mini-breadboard.sch

## KiCad design projects/mini-breadboard level shifter/mini-breadboard.sch (2017-06-26)

Schematic: mini-breadboard.sch

Parts:
J1: TO_TDK; Pin_Header_Straight_1x03_Pitch2.54mm
J2: PHONO; rca_yellow
J3: USB_B
J4: +5V; Pin_Header_Straight_1x01_Pitch1.27mm
J5: GND; Pin_Header_Straight_1x01_Pitch1.27mm
J6: SGNL; Pin_Header_Straight_1x01_Pitch1.27mm
R1, R2, R3, R4, R6: 1K; Resistor_Horz
R5: 0; R_0603
U1: LT1677; DIP-8_W7.62mm
U2: LT1004-2.5; TO-92_Inline_Narrow_Oval

Notes on the sheet:
Bipass Shifter
