aspro648/KiCad/projects/snapNsew/snapNsew.sch

## KiCad design projects/snapNsew/snapNsew.sch (2017-05-26)

Schematic: snapNsew.sch

Parts:
BT1: Battery; BATT_CR2032
C1: 0.1 uF; C1
CON1: ISP; Pin_Header_Straight_2x03
D1: LED; LED-1206
D3: LED; LED-5MM
GND1, GND2, GND3, GND4: CONN_01X01; SEWPAD
IC1: ATTINY85; DIP-8__300
L1, L2: CONN_01X01; SEWPAD
P0, P1, P2, P3, P4: CONN_01X01; SEWPAD
PWR1, PWR2, PWR3: CONN_01X01; SEWPAD
Q1: LIGHT; PHOTO_TRANS
R1: 330; R_1206
R4: 330; Resistor_Horizontal_RM10mm
S1, S2: CONN_01X01; SEWPAD
SP1: SPEAKER; PS1240_piezo
SW1: SPST; mySwitchDPDT
T1, T2: CONN_01X01; SEWPAD
TOUCH1: SW_PUSH; SW_PUSH_TOUCH
Z1, Z2: CONN_01X01; SEWPAD

Notes on the sheet:
D5/A0
D4/A2
D3/A3
D2/A1
D1/pwm
D0/pwm
D0 Speaker D2 Touch A3 Photo D4 LED
