aspro648/KiCad/projects/tacuino R3/tacuino.sch

## KiCad design projects/tacuino R3/tacuino.sch (2017-12-27)

Schematic: tacuino.sch

Parts:
1N4001: DIODE; D3
BT1: BATTERY; BATT_CR2032
B_C1: 1pin-Sew-thin
B_C2: CONN_1; 1pin-Sew-thin
B_N1, B_N2: GND; 1pin-Sew-thin
B_P1, B_P2: PWR; 1pin-Sew-thin
C1: 0.1uF; C1
C2: 10uF; C1V5
D2: PWR; LED-5MM
D3, D5: ZD3V6; D3
D4: LED; LED-3MM
IC1: ATTINY85; DIP-8__300
J1: USB; USB_B
L1_C1, L1_C2: 1pin-Sew-thin
P1, P2: CONN_4; SIL-4
PD0: 0; 1pin-Sew-thin
PD1: 1; 1pin-Sew-thin
PD2: 2; 1pin-Sew-thin
PD3: 3; 1pin-Sew-thin
PD4: 4; 1pin-Sew-thin
PD5: 5; 1pin-Sew-thin
PDGND1, PDGND2, PDGND3: G; 1pin-Sew-thin
PDVCC1: P; 1pin-Sew-thin
P_1, P_2: 1pin-Sew-thin
Q1: PHOTO; LED-3MM
R1: 330; R3-LARGE_PADS
R2: 1k5; R3-LARGE_PADS
R3, R4: 22; R3-LARGE_PADS
R6: 330; R1
SP1: SPEAKER
SW1: TOUCH; SW_PUSH_TOUCH
SW2: ON; SW_SPST
S_C1, S_C2: 1pin-Sew-thin

Notes on the sheet:
GND D4 D3 PWR
D5/A0 D4/A2 D3/A3 D2/A1 D1/pwm D0/pwm
