aspro648/KiCad/projects/test/test.sch

## KiCad design projects/test/test.sch (2019-08-22)

Schematic: test.sch

Parts:
TP1: TEST; Pin_Header_Straight_1x01_Pitch2.54mm
TP2, TP3: TEST
