aspro648/KiCad/projects/32u4/design_files/project.sch

## KiCad design projects/32u4/design_files/project.sch (2018-08-10)

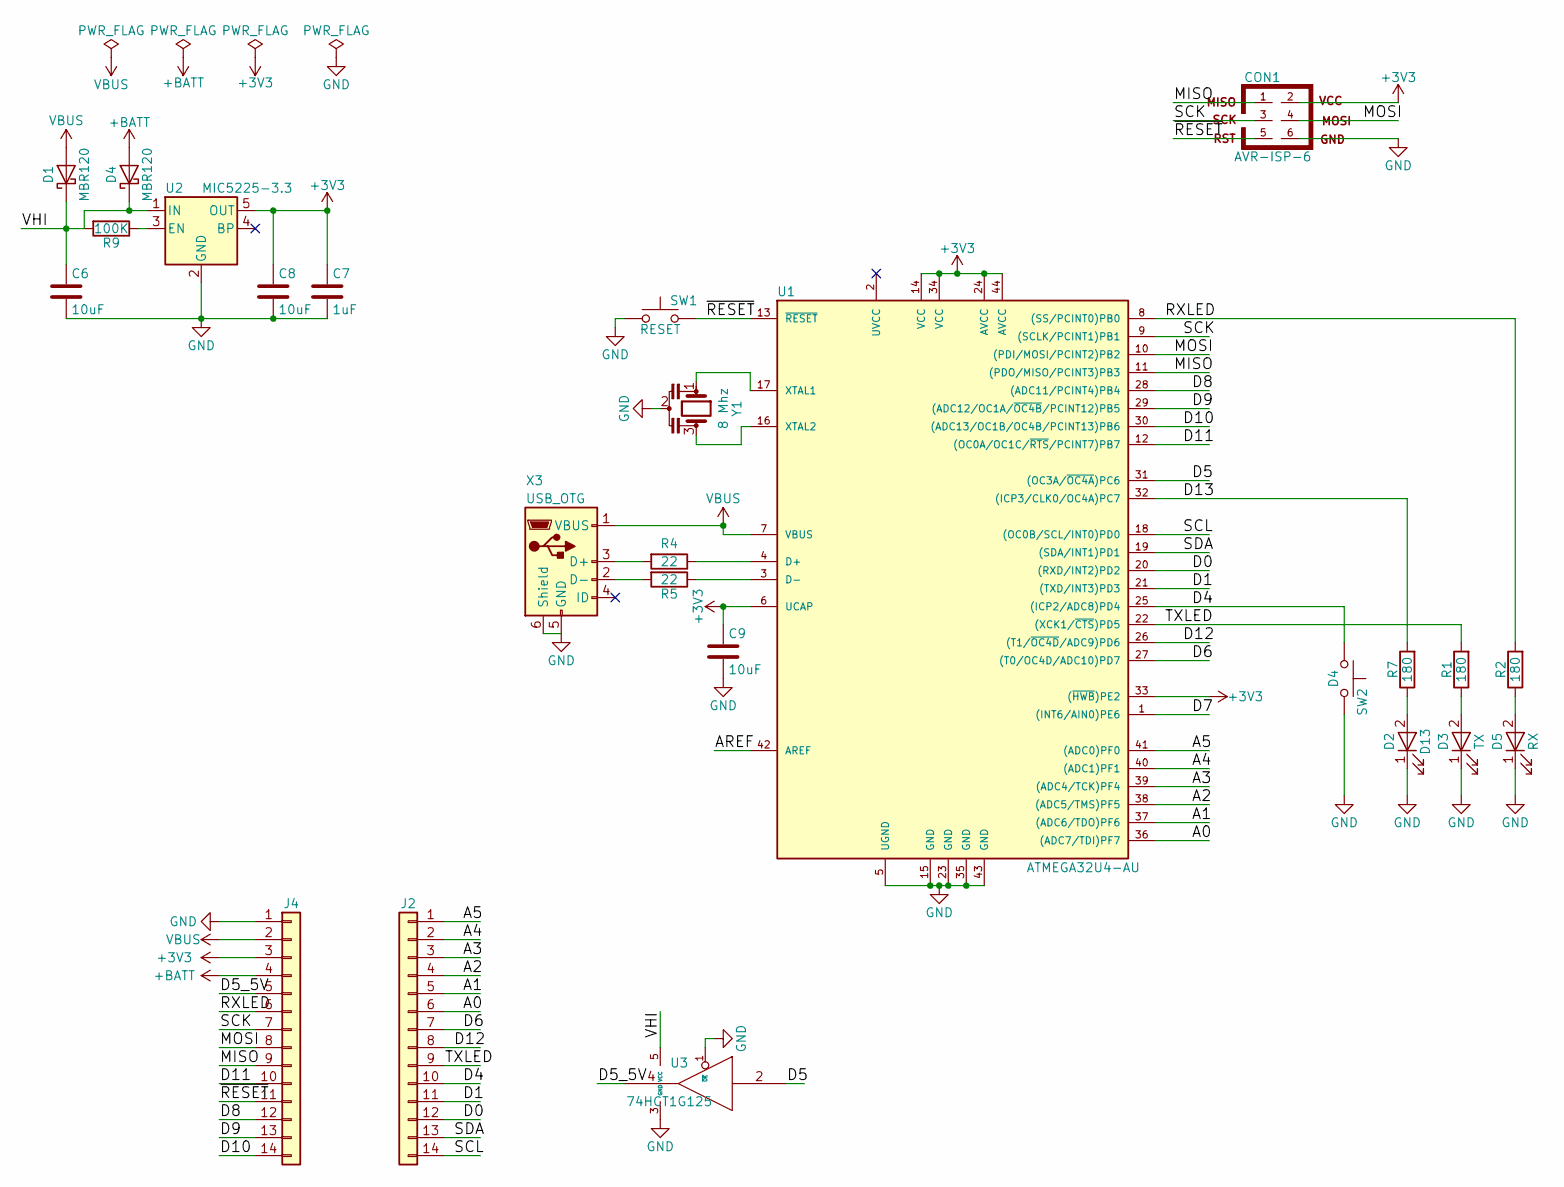
[picture p453: schematic project.sch]

Parts:
C6, C8, C9: 10uF; C_0805
C7: 1uF; C_0603
CON1: AVR-ISP-6; Pin_Header_Straight_2x03_Pitch2.54mm
D1, D4: MBR120; D_SOD-123F
D2: D13; LED_0603
D3: TX; LED_0603
D5: RX; LED_0603
J2, J4: Conn_01x14; Pin_Header_Straight_1x14_Pitch2.54mm
R1, R2, R7: 180; R_0603
R4, R5: 22; R_0603
R9: 100K; R_0603
SW1: RESET; SW_SPST_KMR2
SW2: D4; SW_SPST_KMR2
U1: ATMEGA32U4-AU; TQFP-44_10x10mm_Pitch0.8mm
U2: MIC5225-3.3; SOT-23-5
U3: 74HCT1G125; TSOP-5_1.65x3.05mm_Pitch0.95mm
X3: USB_OTG; USB_Micro-B_Molex-105017-0001
Y1: 8 Mhz; Resonator_SMD_CTSC_1.3mmx3.2mm

Connections:
+3V3: C7.1, C8.1, C9.1, CON1.2, J4.3, U1.6 (UCAP), U1.14 (VCC), U1.24 (AVCC), U1.33 ((~HWB~)PE2), U1.34 (VCC), U1.44 (AVCC), U2.5 (OUT)
+BATT: D4.2 (A), J4.4
A0: J2.6, U1.36 ((ADC7/TDI)PF7)
A1: J2.5, U1.37 ((ADC6/TDO)PF6)
A2: J2.4, U1.38 ((ADC5/TMS)PF5)
A3: J2.3, U1.39 ((ADC4/TCK)PF4)
A4: J2.2, U1.40 ((ADC1)PF1)
A5: J2.1, U1.41 ((ADC0)PF0)
AREF: U1.42 (AREF)
D0: J2.12, U1.20 ((RXD/INT2)PD2)
D1: J2.11, U1.21 ((TXD/INT3)PD3)
D4: J2.10, SW2.1, U1.25 ((ICP2/ADC8)PD4)
D5: U1.31 ((OC3A/~OC4A~)PC6), U3.2
D5_5V: J4.5, U3.4
D6: J2.7, U1.27 ((T0/OC4D/ADC10)PD7)
D7: U1.1 ((INT6/AIN0)PE6)
D8: J4.12, U1.28 ((ADC11/PCINT4)PB4)
D9: J4.13, U1.29 ((ADC12/OC1A/~OC4B~/PCINT12)PB5)
D10: J4.14, U1.30 ((ADC13/OC1B/OC4B/PCINT13)PB6)
D11: J4.10, U1.12 ((OC0A/OC1C/~RTS~/PCINT7)PB7)
D12: J2.8, U1.26 ((T1/~OC4D~/ADC9)PD6)
D13: R7.2, U1.32 ((ICP3/CLK0/OC4A)PC7)
GND: C6.2, C7.2, C8.2, C9.2, CON1.6, D2.1 (K), D3.1 (K), D5.1 (K), J4.1, SW1.1, SW2.2, U1.5 (UGND), U1.15 (GND), U1.23 (GND), U1.35 (GND), U1.43 (GND), U2.2 (GND), U3.1 (~OE), U3.3 (GND), X3.5 (GND), X3.6 (Shield), Y1.2
MISO: CON1.1, J4.9, U1.11 ((PDO/MISO/PCINT3)PB3)
MOSI: CON1.4, J4.8, U1.10 ((PDI/MOSI/PCINT2)PB2)
unnamed: D2.2 (A), R7.1
unnamed: D3.2 (A), R1.1
unnamed: D5.2 (A), R2.1
unnamed: R4.1, U1.4 (D+)
unnamed: R4.2, X3.3 (D+)
unnamed: R5.1, U1.3 (D-)
unnamed: R5.2, X3.2 (D-)
unnamed: R9.1, U2.3 (EN)
unnamed: U1.16 (XTAL2), Y1.3
unnamed: U1.17 (XTAL1), Y1.1
RXLED: J4.6, R2.2, U1.8 ((SS/PCINT0)PB0)
SCK: CON1.3, J4.7, U1.9 ((SCLK/PCINT1)PB1)
SCL: J2.14, U1.18 ((OC0B/SCL/INT0)PD0)
SDA: J2.13, U1.19 ((SDA/INT1)PD1)
TXLED: J2.9, R1.2, U1.22 ((XCK1/~CTS~)PD5)
VBUS: D1.2 (A), J4.2, U1.7 (VBUS), X3.1 (VBUS)
VHI: C6.1, D1.1 (K), D4.1 (K), R9.2, U2.1 (IN), U3.5 (VCC)
~RESET: CON1.5, J4.11, SW1.2, U1.13 (~RESET~)
