aspro648/KiCad/projects/328 Accel/design_files/project.sch

## KiCad design projects/328 Accel/design_files/project.sch (2020-05-22)

Schematic: project.sch

Parts:
C1, C4, C5: 10uF; C_0805
C2, C3: 0.1uF; C_0805
CON1: ISP; Pin_Header_Straight_2x03_Pitch2.54mm
D4, D5: UND; LED_0805_HandSoldering
J1, J6: HL; Pin_Header_Straight_1x02_Pitch2.00mm
J2: CHG; Molex_PicoBlade_53048-0210_02x1.25mm_Angled
J3: BAT; Molex_PicoBlade_53048-0210_02x1.25mm_Angled
J4, J5, J44, J55: CONN; Pin_Header_Straight_1x02_Pitch2.54mm
J7, J8: TL; Pin_Header_Straight_1x02_Pitch2.00mm
J9: DSH; Pin_Header_Straight_1x02_Pitch2.00mm
J10: JST_PH; JST_PH_S2B-PH-K_02x2.00mm_Angled
R1: 10K; R_0805_HandSoldering
R2, R3: 4K7; R_0805_HandSoldering
R4, R5, R6, R7, R8, R9, R10, R11, R12: 100; R_0805_HandSoldering
R13: 100K; R_0805_HandSoldering
SW1: SW_SPDT; SPST_SMD
U1: ATMEGA328-MU; QFN-32-1EP_5x5mm_Pitch0.5mm
U2: LIS3DH
U3: MIC5225-3.3; SOT-23-5
