aspro648/KiCad/projects/Attiny/Attiny84Earring/base.sch

## KiCad design projects/Attiny/Attiny84Earring/base.sch (2017-05-26)

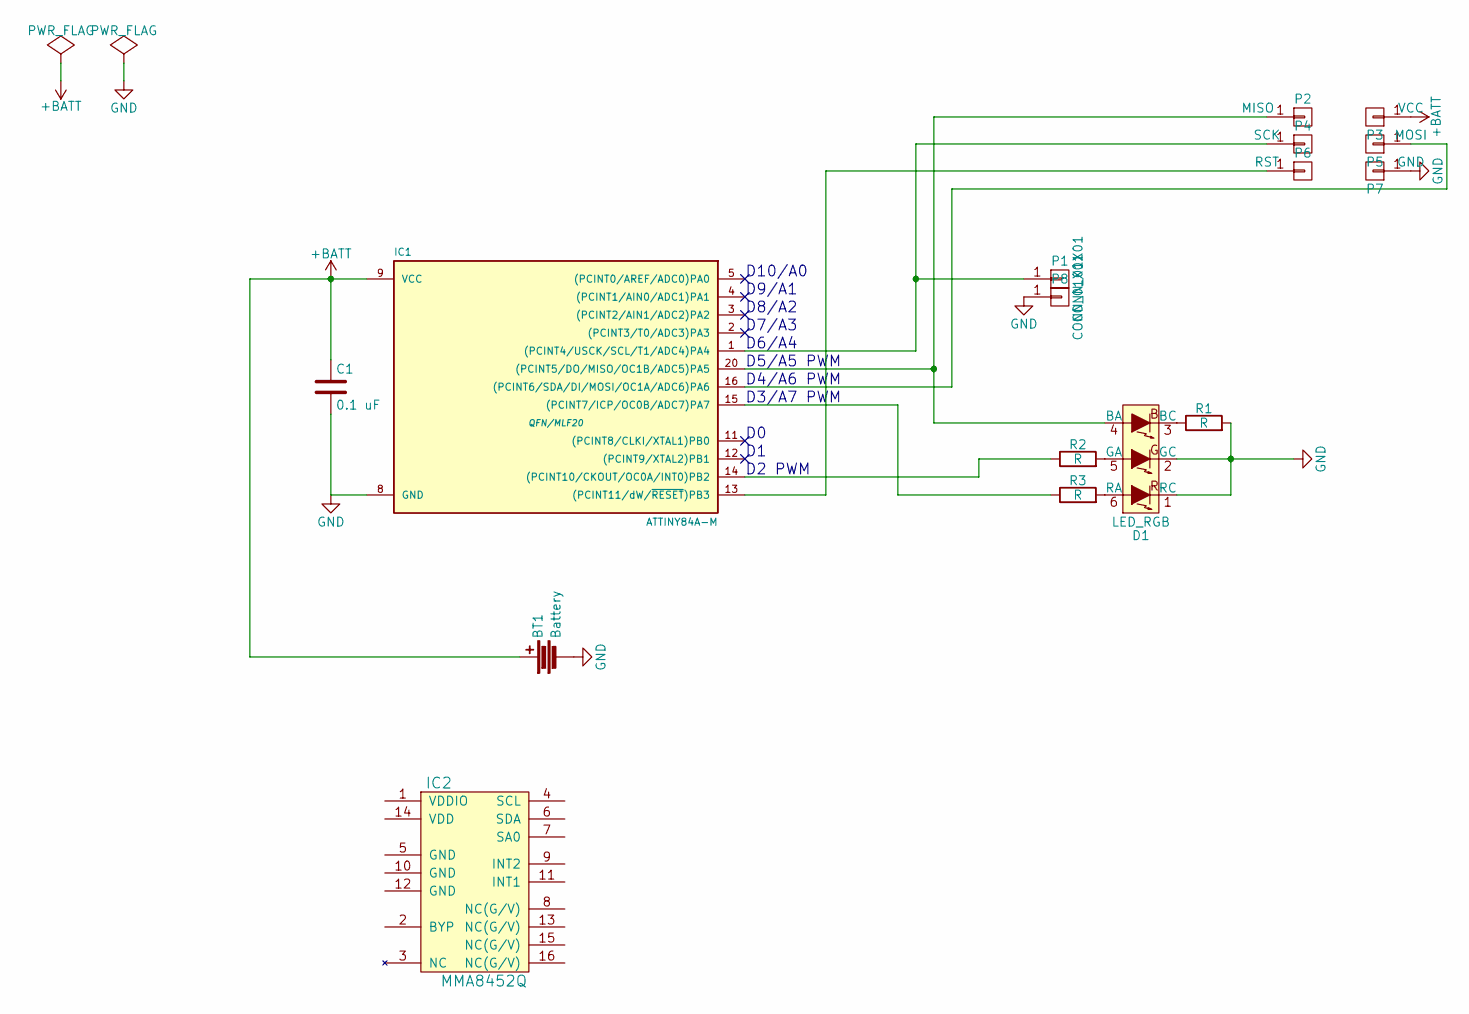
[picture p454: schematic base.sch]

Parts:
BT1: Battery; BATT_12mm_TH
C1: 0.1 uF; C_0805_HandSoldering
D1: LED_RGB; LED_RGB_5050
IC1: ATTINY84A-M; QFN/MLF20
IC2: MMA8452Q
P1, P8: CONN_01X01; Pin_Header_Straight_1x01
P2: MISO; Pin_Header_Straight_1x01
P3: VCC; Pin_Header_Straight_1x01
P4: SCK; Pin_Header_Straight_1x01
P5: MOSI; Pin_Header_Straight_1x01
P6: RST; Pin_Header_Straight_1x01
P7: GND; Pin_Header_Straight_1x01
R1, R2, R3: R; R_0805_HandSoldering

Connections:
+BATT: BT1.1, C1.1, IC1.9 (VCC), P3.1
GND: BT1.2, C1.2, D1.1 (RC), D1.2 (GC), IC1.8 (GND), P7.1, P8.1, R1.2
unnamed: D1.3 (BC), R1.1
unnamed: D1.4 (BA), IC1.20 ((PCINT5/DO/MISO/OC1B/ADC5)PA5), P2.1
unnamed: D1.5 (GA), R2.2
unnamed: D1.6 (RA), R3.2
unnamed: IC1.1 ((PCINT4/USCK/SCL/T1/ADC4)PA4), P1.1, P4.1
unnamed: IC1.13 ((PCINT11/dW/~RESET~)PB3), P6.1
unnamed: IC1.14 ((PCINT10/CKOUT/OC0A/INT0)PB2), R2.1
unnamed: IC1.15 ((PCINT7/ICP/OC0B/ADC7)PA7), R3.1
unnamed: IC1.16 ((PCINT6/SDA/DI/MOSI/OC1A/ADC6)PA6), P5.1

Notes on the sheet:
D2 PWM
D4/A6 PWM
D3/A7 PWM
D5/A5 PWM
D6/A4
D7/A3
D8/A2
D9/A1
D10/A0
