aspro648/KiCad/projects/Attiny/Attiny84EarringProgrammer/base.sch

## KiCad design projects/Attiny/Attiny84EarringProgrammer/base.sch (2017-05-26)

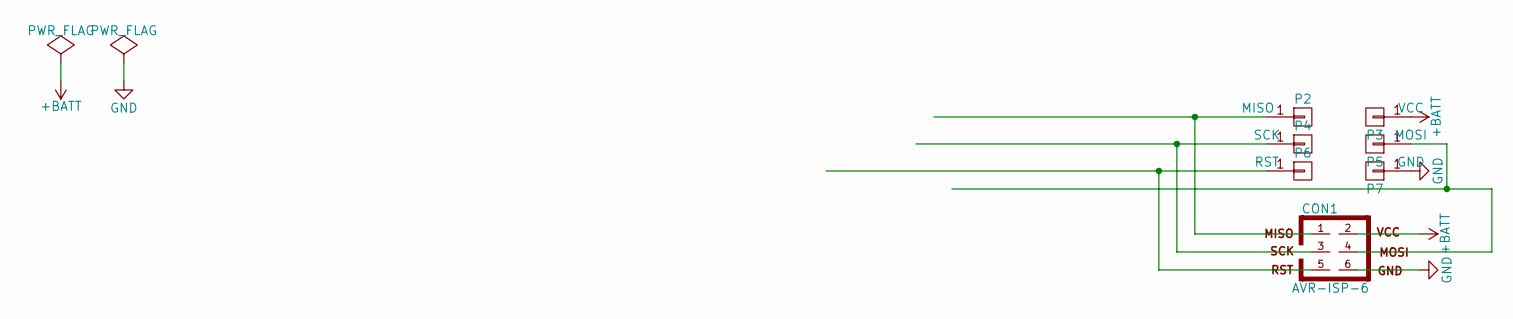
[picture p455: schematic base.sch]

Parts:
CON1: AVR-ISP-6; DIP-6_W7.62mm
P2: MISO; Pin_Header_Straight_1x01
P3: VCC; Pin_Header_Straight_1x01
P4: SCK; Pin_Header_Straight_1x01
P5: MOSI; Pin_Header_Straight_1x01
P6: RST; Pin_Header_Straight_1x01
P7: GND; Pin_Header_Straight_1x01

Connections:
+BATT: CON1.2, P3.1
GND: CON1.6, P7.1
unnamed: CON1.1, P2.1
unnamed: CON1.3, P4.1
unnamed: CON1.4, P5.1
unnamed: CON1.5, P6.1
