aspro648/KiCad/projects/Attiny/Attiny84Heart2/base.sch

## KiCad design projects/Attiny/Attiny84Heart2/base.sch (2017-05-26)

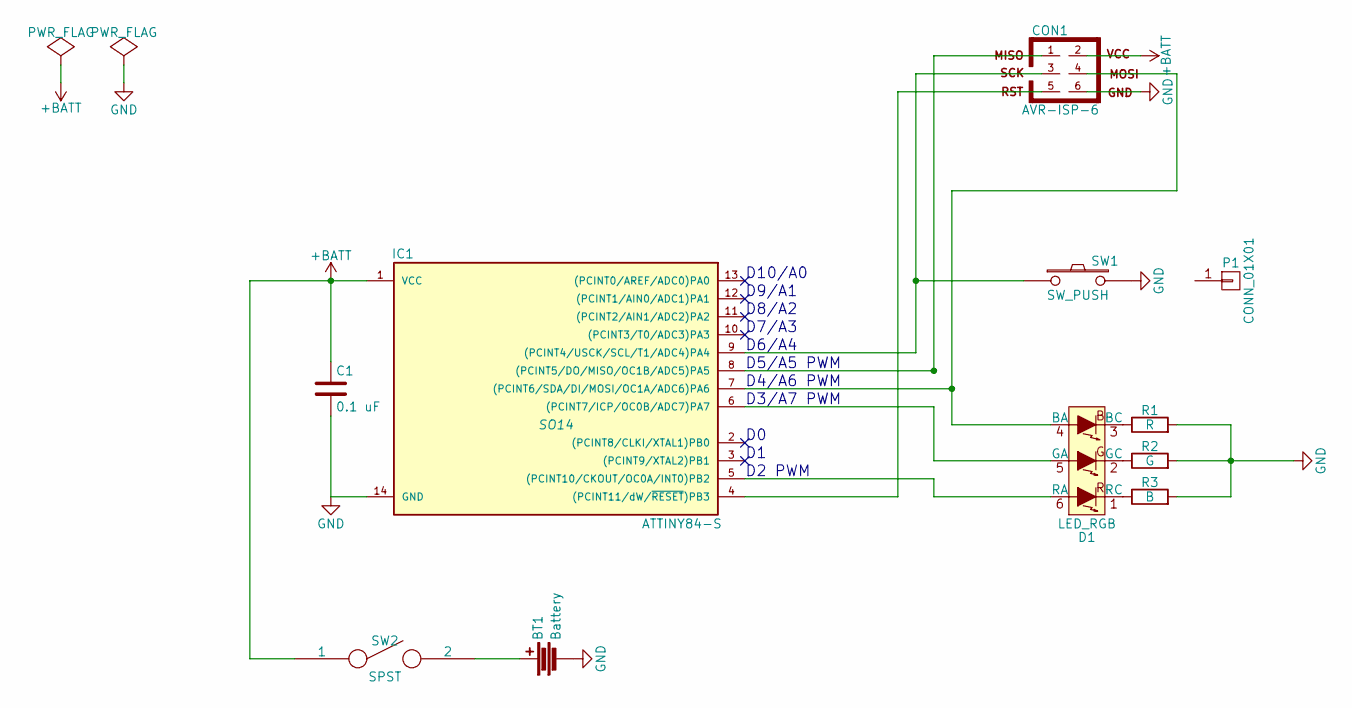
[picture p456: schematic base.sch]

Parts:
BT1: Battery; BATT_CR2032_SMD
C1: 0.1 uF; C_1206
CON1: AVR-ISP-6
D1: LED_RGB; LED_RGB_QBLP679E
IC1: ATTINY84-S; SO14
P1: CONN_01X01; Pin_Header_Angled_1x01
R1: R; R_1206
R2: G; R_1206
R3: B; R_1206
SW1: SW_PUSH; SW_SMD_PUSH
SW2: SPST; SPST_SMD

Connections:
+BATT: C1.1, CON1.2, IC1.1 (VCC), SW2.1
GND: BT1.2, C1.2, CON1.6, IC1.14 (GND), R1.2, R2.2, R3.2, SW1.2
unnamed: BT1.1, SW2.2
unnamed: CON1.1, IC1.8 ((PCINT5/DO/MISO/OC1B/ADC5)PA5)
unnamed: CON1.3, IC1.9 ((PCINT4/USCK/SCL/T1/ADC4)PA4), SW1.1
unnamed: CON1.4, D1.4 (BA), IC1.7 ((PCINT6/SDA/DI/MOSI/OC1A/ADC6)PA6)
unnamed: CON1.5, IC1.4 ((PCINT11/dW/~RESET~)PB3)
unnamed: D1.1 (RC), R3.1
unnamed: D1.2 (GC), R2.1
unnamed: D1.3 (BC), R1.1
unnamed: D1.5 (GA), IC1.6 ((PCINT7/ICP/OC0B/ADC7)PA7)
unnamed: D1.6 (RA), IC1.5 ((PCINT10/CKOUT/OC0A/INT0)PB2)

Notes on the sheet:
D2 PWM
D4/A6 PWM
D3/A7 PWM
D5/A5 PWM
D6/A4
D7/A3
D8/A2
D9/A1
D10/A0
