aspro648/KiCad/projects/Attiny/Attiny84LED/base.sch

## KiCad design projects/Attiny/Attiny84LED/base.sch (2017-05-26)

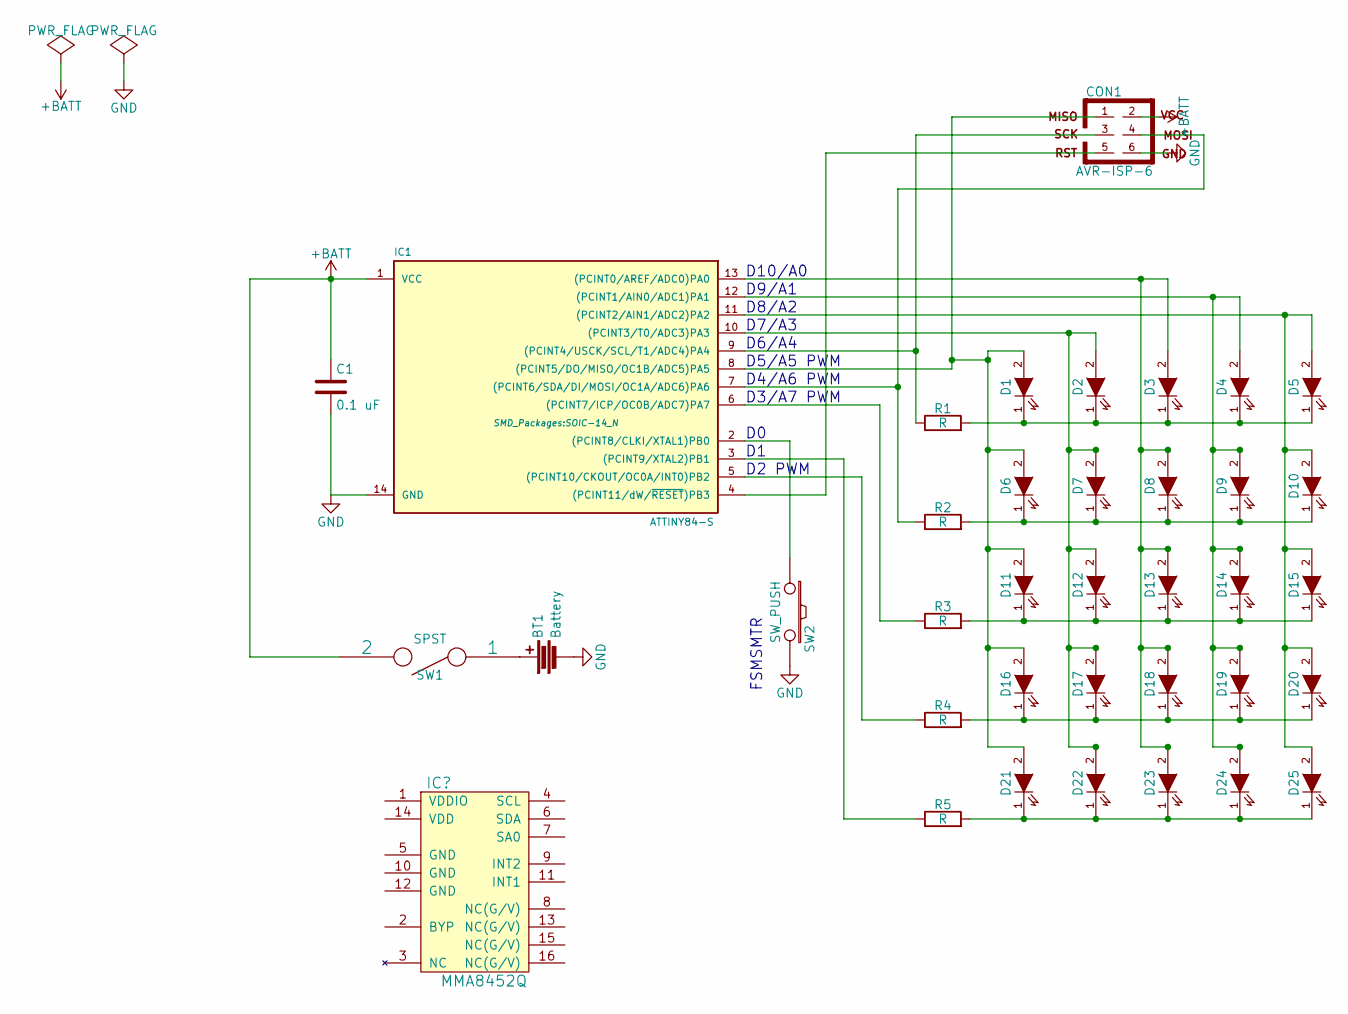
[picture p457: schematic base.sch]

Parts:
BT1: Battery; BATT_CR2032_SMD
C1: 0.1 uF; C_1206
CON1: AVR-ISP-6; Pin_Header_Straight_2x03
D1, D2, D3, D4, D5, D6, D7, D8, D9, D10, D11, D12, D13, D14, D15, D16, D17, D18, D19, D20, D21, D22, D23, D24, D25: LED; LED-1206
IC1: ATTINY84-S; SOIC-14_N
R1, R2, R3, R4, R5: R; R_1206
SW1: SPST; mySwitchDPDT
SW2: SW_PUSH; SW_SPST_EVQPE1

Connections:
+BATT: C1.1, CON1.2, IC1.1 (VCC), SW1.2
GND: BT1.2, C1.2, CON1.6, IC1.14 (GND), SW2.2
unnamed: BT1.1, SW1.1
unnamed: CON1.1, D1.2 (A), D6.2 (A), D11.2 (A), D16.2 (A), D21.2 (A), IC1.8 ((PCINT5/DO/MISO/OC1B/ADC5)PA5)
unnamed: CON1.3, IC1.9 ((PCINT4/USCK/SCL/T1/ADC4)PA4), R1.1
unnamed: CON1.4, IC1.7 ((PCINT6/SDA/DI/MOSI/OC1A/ADC6)PA6), R2.1
unnamed: CON1.5, IC1.4 ((PCINT11/dW/~RESET~)PB3)
unnamed: D1.1 (K), D2.1 (K), D3.1 (K), D4.1 (K), D5.1 (K), R1.2
unnamed: D6.1 (K), D7.1 (K), D8.1 (K), D9.1 (K), D10.1 (K), R2.2
unnamed: D5.2 (A), D10.2 (A), D15.2 (A), D20.2 (A), D25.2 (A), IC1.11 ((PCINT2/AIN1/ADC2)PA2)
unnamed: D11.1 (K), D12.1 (K), D13.1 (K), D14.1 (K), D15.1 (K), R3.2
unnamed: D2.2 (A), D7.2 (A), D12.2 (A), D17.2 (A), D22.2 (A), IC1.10 ((PCINT3/T0/ADC3)PA3)
unnamed: D3.2 (A), D8.2 (A), D13.2 (A), D18.2 (A), D23.2 (A), IC1.13 ((PCINT0/AREF/ADC0)PA0)
unnamed: D4.2 (A), D9.2 (A), D14.2 (A), D19.2 (A), D24.2 (A), IC1.12 ((PCINT1/AIN0/ADC1)PA1)
unnamed: D16.1 (K), D17.1 (K), D18.1 (K), D19.1 (K), D20.1 (K), R4.2
unnamed: D21.1 (K), D22.1 (K), D23.1 (K), D24.1 (K), D25.1 (K), R5.2
unnamed: IC1.2 ((PCINT8/CLKI/XTAL1)PB0), SW2.1
unnamed: IC1.3 ((PCINT9/XTAL2)PB1), R5.1
unnamed: IC1.5 ((PCINT10/CKOUT/OC0A/INT0)PB2), R4.1
unnamed: IC1.6 ((PCINT7/ICP/OC0B/ADC7)PA7), R3.1

Notes on the sheet:
D2 PWM
D4/A6 PWM
D3/A7 PWM
D5/A5 PWM
D6/A4
D7/A3
D8/A2
D9/A1
D10/A0
FSMSMTR
