aspro648/KiCad/projects/Attiny/Attiny84SpinnerTHD_R3/base.sch

## KiCad design projects/Attiny/Attiny84SpinnerTHD_R3/base.sch (2017-07-24)

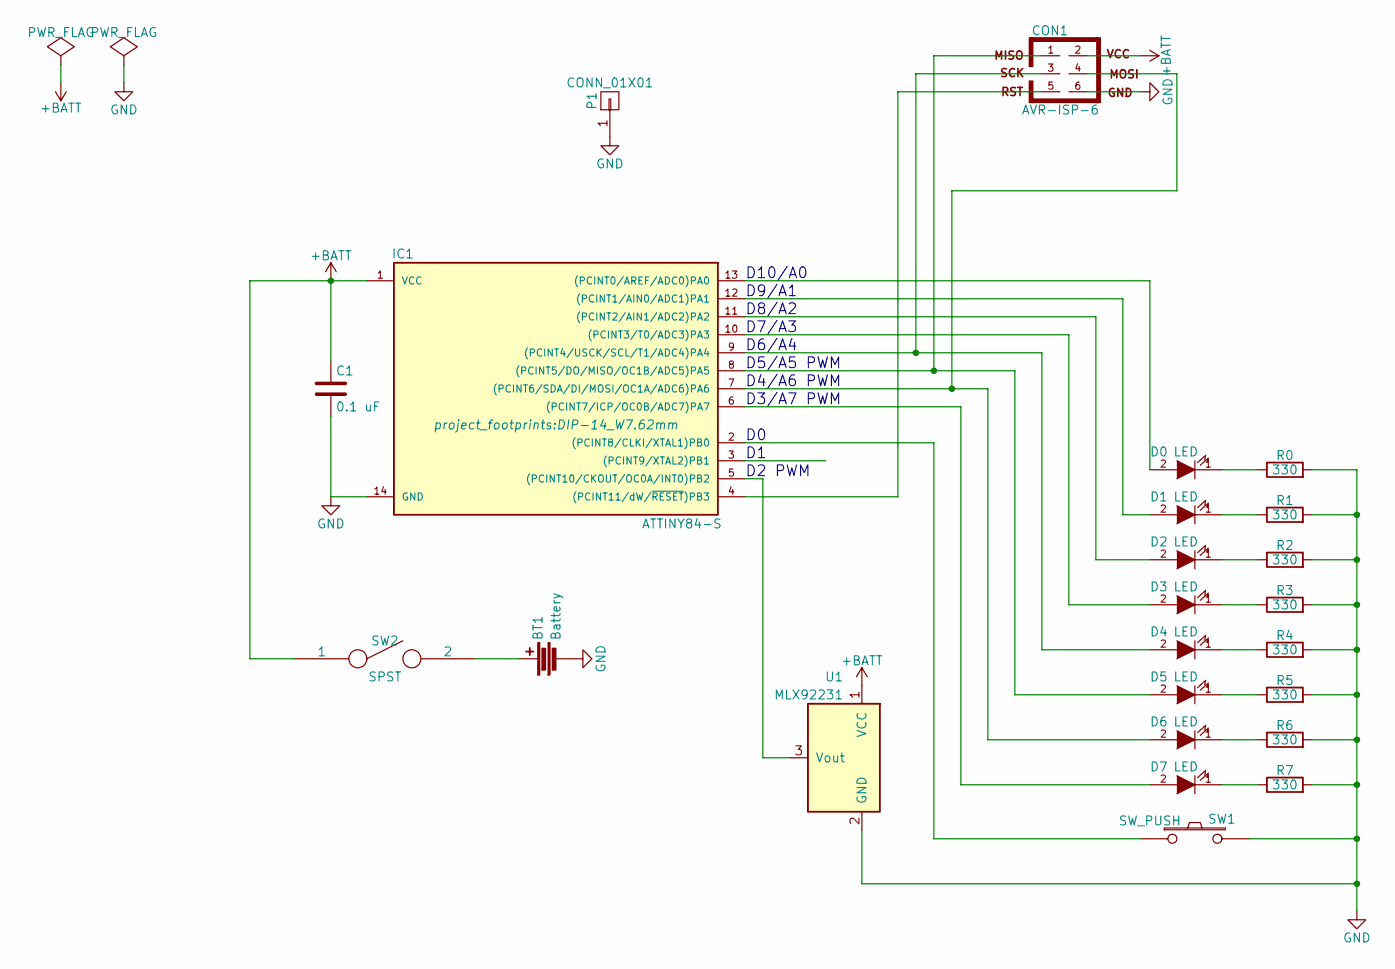
[picture p458: schematic base.sch]

Parts:
BT1: Battery; BATT_12mm_TH
C1: 0.1 uF; C1
CON1: AVR-ISP-6
D0, D1, D2, D3, D4, D5, D6, D7: LED; LED-3MM
IC1: ATTINY84-S; DIP-14_W7.62mm
P1: CONN_01X01; Pin_Header_Straight_1x01
R0, R1, R2, R3, R4, R5, R6, R7: 330; Resistor_Horz
SW1: SW_PUSH; SW_PUSH_SMALL
SW2: SPST; SW_SPST
U1: MLX92231; TO-92_Inline_Wide

Connections:
+BATT: C1.1, CON1.2, IC1.1 (VCC), SW2.1, U1.1 (VCC)
GND: BT1.2, C1.2, CON1.6, IC1.14 (GND), P1.1, R0.2, R1.2, R2.2, R3.2, R4.2, R5.2, R6.2, R7.2, SW1.2, U1.2 (GND)
unnamed: BT1.1, SW2.2
unnamed: CON1.1, D5.2 (A), IC1.8 ((PCINT5/DO/MISO/OC1B/ADC5)PA5)
unnamed: CON1.3, D4.2 (A), IC1.9 ((PCINT4/USCK/SCL/T1/ADC4)PA4)
unnamed: CON1.4, D6.2 (A), IC1.7 ((PCINT6/SDA/DI/MOSI/OC1A/ADC6)PA6)
unnamed: CON1.5, IC1.4 ((PCINT11/dW/~RESET~)PB3)
unnamed: D0.1 (K), R0.1
unnamed: D0.2 (A), IC1.13 ((PCINT0/AREF/ADC0)PA0)
unnamed: D1.1 (K), R1.1
unnamed: D1.2 (A), IC1.12 ((PCINT1/AIN0/ADC1)PA1)
unnamed: D2.1 (K), R2.1
unnamed: D2.2 (A), IC1.11 ((PCINT2/AIN1/ADC2)PA2)
unnamed: D3.1 (K), R3.1
unnamed: D3.2 (A), IC1.10 ((PCINT3/T0/ADC3)PA3)
unnamed: D4.1 (K), R4.1
unnamed: D5.1 (K), R5.1
unnamed: D6.1 (K), R6.1
unnamed: D7.1 (K), R7.1
unnamed: D7.2 (A), IC1.6 ((PCINT7/ICP/OC0B/ADC7)PA7)
unnamed: IC1.2 ((PCINT8/CLKI/XTAL1)PB0), SW1.1
unnamed: IC1.5 ((PCINT10/CKOUT/OC0A/INT0)PB2), U1.3 (Vout)

Notes on the sheet:
D2 PWM
D4/A6 PWM
D3/A7 PWM
D5/A5 PWM
D6/A4
D7/A3
D8/A2
D9/A1
D10/A0
