aspro648/KiCad/projects/Attiny/Attiny85SMD2/base.sch

## KiCad design projects/Attiny/Attiny85SMD2/base.sch (2017-05-26)

Schematic: base.sch

Parts:
BT1: Battery; BATT_CR2032_SMD
C1: 0.1 uF; C_1206_HandSoldering
CON1: AVR-ISP-6
D0, D3, D4: LED; LED-0603
D1: LED; LED-0805
D2: LED; LED-1206
IC1: ATTINY85-S; SOIC-8_3.9x4.9mm_Pitch1.27mm
P1: CONN_01X01; Pin_Header_Angled_1x01
R0: 330; R_0603
R1: 330; R_0805
R2: 330; R_1206
R3: 330; R_0402
R4: 330; R_0201

Notes on the sheet:
D2 PWM
D4/A6 PWM
D3/A7 PWM
D5/A5 PWM
D6/A4
D7/A3
D8/A2
D9/A1
D10/A0
1206 RED
0805 Orange
0603 Yellow
0402 Green
0201 Blue
