aspro648/KiCad/projects/Badge Hello My Name/design_files/project.sch

## KiCad design projects/Badge Hello My Name/design_files/project.sch (2018-07-22)

Schematic: project.sch

Parts:
BT1, BT2: Battery_Cell; BATT_CR2032_SMD
C1: C; C_0805
CON1: AVR-ISP-6
D0, D1, D2, D3, D4, D10, D11, D12, D13, D14, D20, D21, D22, D23, D24, D30, D31, D32, D33, D34, D40, D41, D42, D43, D44, D50, D51, D52, D53, D54, D60, D61, D62, D63, D64, D70, D71, D72, D73, D74, D80, D81, D82, D83, D84, D90, D91, D92, D93, D94, D100, D101, D102, D103, D104, D110, D111, D112, D113, D114, D120, D121, D122, D123, D124, D130, D131, D132, D133, D134, D140, D141, D142, D143, D144: LED; LED_1206_SHORT
J1: Pin; SolderWirePad_single_SMD_5x10mm
Q0, Q1, Q2, Q3, Q4, Q10, Q11, Q12, Q13, Q14, Q15, Q16, Q17, Q18, Q19, Q20, Q21, Q22, Q23, Q24: Q_NPN_BEC; SOT-23
R0, R1, R2, R3, R4, R5, R6, R7, R8, R9, R10, R11, R12, R13, R14: 100; R_0805
SW1: SW_SPDT; SPST_SMD
SW2: SW_Push; SW_SMD_PUSH
U1: ATMEGA328P-AU; TQFP-32_7x7mm_Pitch0.8mm

Notes on the sheet:
COL 1
COL 2
COL 3
COL 4
COL 5
COL 6
COL 7
COL 8
ROW 0
ROW 1
ROW 2
ROW 3
ROW 4
COL 0
COL 9
COL 10
COL 11
COL 12
COL 13
COL 14
A1 A2 A3 A4 A5 A0 D13 D12 D11 D10 D9 D8 D7 D6 D5 D4 D3 D2 D1 D0
