aspro648/KiCad/projects/Badge/design_files/project.sch

## KiCad design projects/Badge/design_files/project.sch (2018-07-06)

Schematic: project.sch

Parts:
BT1: Battery_Cell; BATT_CR2032_SMD
C1: C; C_0805
CON1: AVR-ISP-6
D1, D2, D3, D4, D5, D6, D7, D8, D9, D10, D11, D12, D13, D14, D15, D16, D17, D18, D19, D20, D21, D22, D23, D24, D25, D26, D27, D28, D29, D30, D31, D32, D33, D34, D35, D36, D37, D38, D39, D40, D41, D42, D43, D44, D45, D46, D47, D48, D49, D50, D51, D52, D53, D54, D55, D56, D57, D58, D59, D60, D61, D62, D63, D64: LED; LED_0805
J1: Pin; SolderWirePad_single_SMD_5x10mm
Q1, Q2, Q3, Q4, Q5, Q6, Q7, Q8, Q9, Q10, Q11, Q12, Q13, Q14, Q15, Q16: Q_NPN_BEC; SOT-23
R1, R2, R3, R4, R5, R6, R7, R8: 100; R_0805
SW1: SW_SPDT; SPST_SMD
SW2: SW_Push; SW_SMD_PUSH
U1: ATMEGA328P-AU; TQFP-32_7x7mm_Pitch0.8mm

Notes on the sheet:
https://www.arduino.cc/en/Tutorial/RowColumnScanning
COL 1
COL 2
COL 3
COL 4
COL 5
COL 6
COL 7
COL 8
ROW 1
ROW 2
ROW 3
ROW 4
ROW 5
ROW 6
ROW 7
ROW 8
PB7 PB6 PB5 PB4 PB3 PB2 PB1 PB0 PD0 PD1 PD2 PD3 PD4 PD5 PD6 PD7
