aspro648/KiCad/projects/BinDecHex/design_files/project.sch

## KiCad design projects/BinDecHex/design_files/project.sch (2018-03-28)

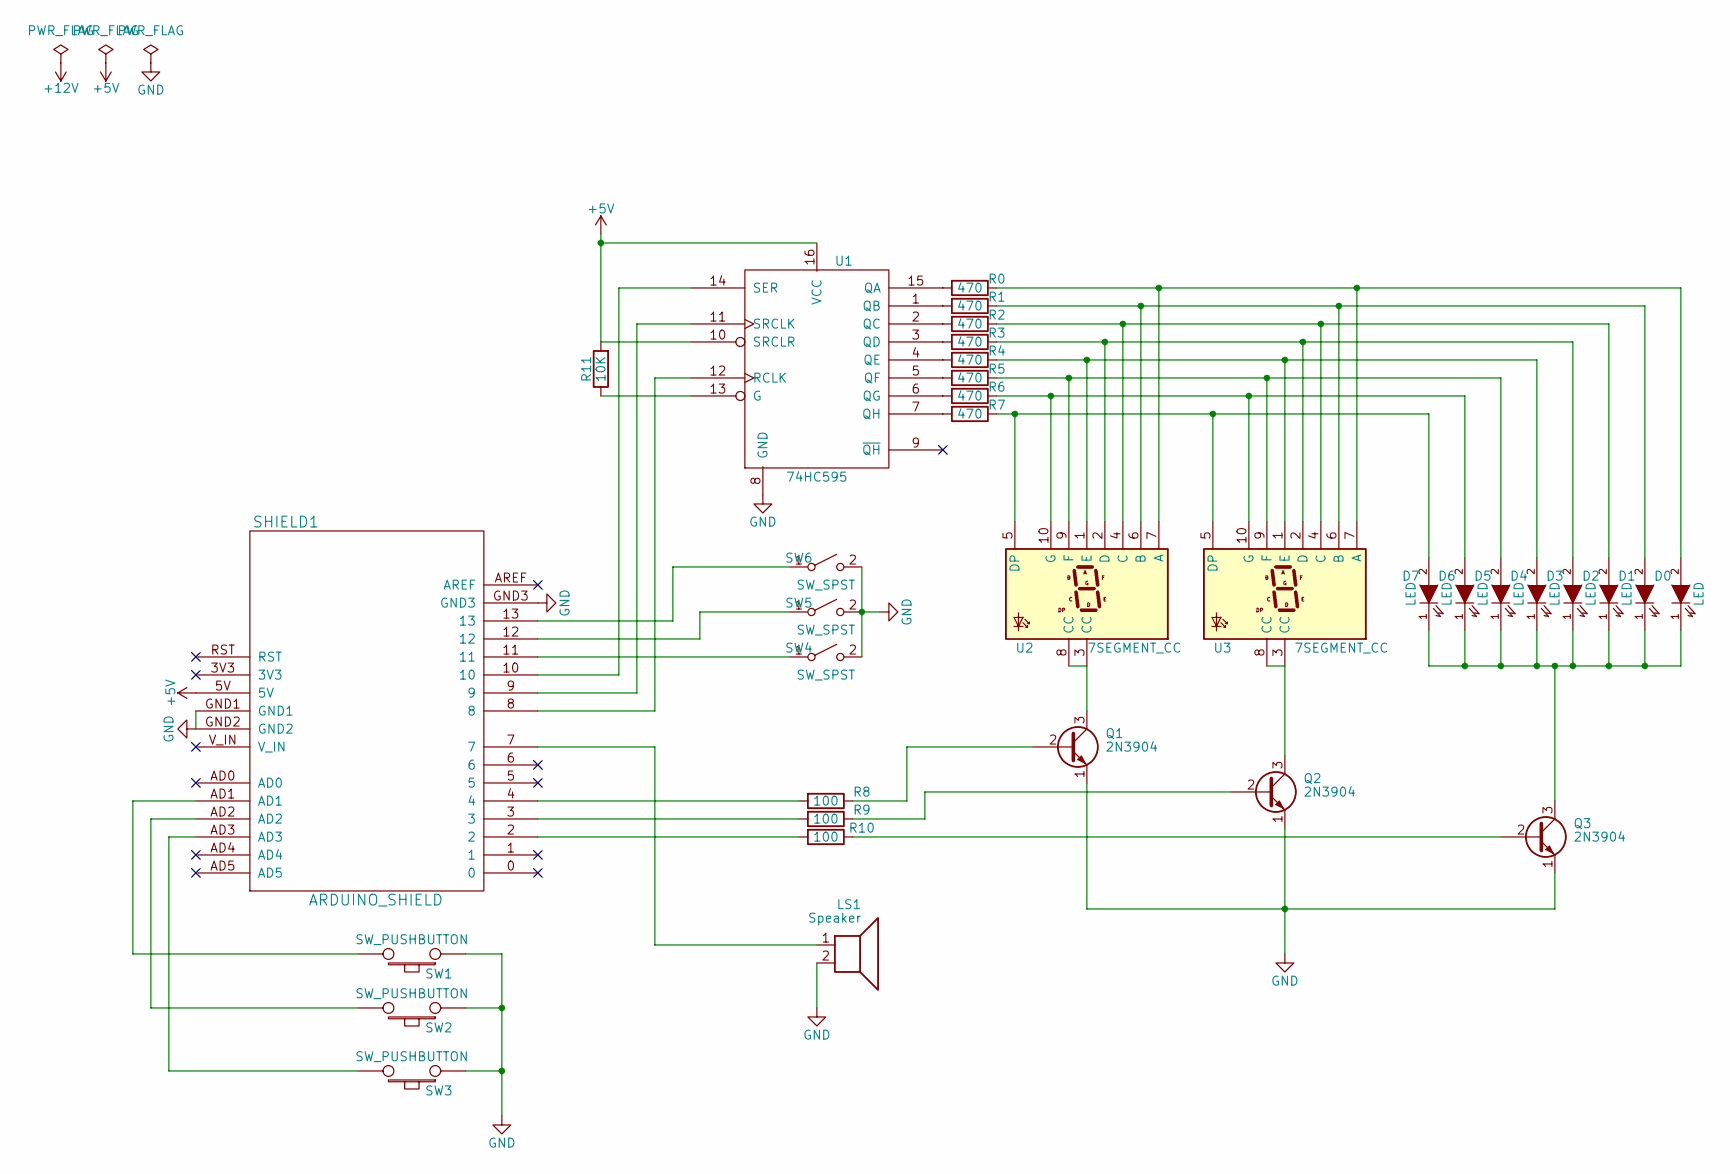
[picture p459: schematic project.sch]

Parts:
D0, D1, D2, D3, D4, D5, D6, D7: LED; LED-3MM
LS1: Speaker; PS1240_piezo
Q1, Q2, Q3: 2N3904; TO-92_NPN_EBC_wide
R0, R1, R2, R3, R4, R5, R6, R7: 470; Resistor_Horz
R8, R9, R10: 100; Resistor_Horz
R11: 10K; Resistor_Horz
SHIELD1: ARDUINO_SHIELD
SW1, SW2, SW3: SW_PUSHBUTTON; SW_PUSH_SMALL
SW4, SW5, SW6: SW_SPST; SW_Micro_SPST
U1: 74HC595; DIP-16_W7.62mm
U2, U3: 7SEGMENT_CC; 7SegmentLED_LTS6760_LTS6780

Connections:
+5V: R11.2, SHIELD1.5V, U1.10 (SRCLR), U1.16 (VCC)
GND: LS1.2, Q1.1 (E), Q2.1 (E), Q3.1 (E), SHIELD1.GND1, SHIELD1.GND2, SHIELD1.GND3, SW1.1, SW2.1, SW3.1, SW4.2 (B), SW5.2 (B), SW6.2 (B), U1.8 (GND)
unnamed: D0.1 (K), D1.1 (K), D2.1 (K), D3.1 (K), D4.1 (K), D5.1 (K), D6.1 (K), D7.1 (K), Q3.3 (C)
unnamed: D0.2 (A), R0.1, U2.7 (A), U3.7 (A)
unnamed: D1.2 (A), R1.1, U2.6 (B), U3.6 (B)
unnamed: D2.2 (A), R2.1, U2.4 (C), U3.4 (C)
unnamed: D3.2 (A), R3.1, U2.2 (D), U3.2 (D)
unnamed: D4.2 (A), R4.1, U2.1 (E), U3.1 (E)
unnamed: D5.2 (A), R5.1, U2.9 (F), U3.9 (F)
unnamed: D6.2 (A), R6.1, U2.10 (G), U3.10 (G)
unnamed: D7.2 (A), R7.1, U2.5 (DP), U3.5 (DP)
unnamed: LS1.1, SHIELD1.7
unnamed: Q1.2 (B), R8.1
unnamed: Q1.3 (C), U2.3 (CC), U2.8 (CC)
unnamed: Q2.2 (B), R9.1
unnamed: Q2.3 (C), U3.3 (CC), U3.8 (CC)
unnamed: Q3.2 (B), R10.1
unnamed: R0.2, U1.15 (QA)
unnamed: R1.2, U1.1 (QB)
unnamed: R2.2, U1.2 (QC)
unnamed: R3.2, U1.3 (QD)
unnamed: R4.2, U1.4 (QE)
unnamed: R5.2, U1.5 (QF)
unnamed: R6.2, U1.6 (QG)
unnamed: R7.2, U1.7 (QH)
unnamed: R8.2, SHIELD1.4
unnamed: R9.2, SHIELD1.3
unnamed: R10.2, SHIELD1.2
unnamed: R11.1, U1.13 (G)
unnamed: SHIELD1.8, U1.12 (RCLK)
unnamed: SHIELD1.9, U1.11 (SRCLK)
unnamed: SHIELD1.10, U1.14 (SER)
unnamed: SHIELD1.11, SW4.1 (A)
unnamed: SHIELD1.12, SW5.1 (A)
unnamed: SHIELD1.13, SW6.1 (A)
unnamed: SHIELD1.AD1, SW1.2
unnamed: SHIELD1.AD2, SW2.2
unnamed: SHIELD1.AD3, SW3.2
