aspro648/KiCad/projects/JouleThief/design_files/JouleThief.sch

## KiCad design projects/JouleThief/design_files/JouleThief.sch (2018-08-10)

Schematic: JouleThief.sch

Parts:
BT1: BATTERY
D1: LED
Q1: PN2222A; TO92
R1: 1000
SW1: SPST
T1: TRANSFO
