aspro648/KiCad/projects/LEDeyes/design_files/project.sch

## KiCad design projects/LEDeyes/design_files/project.sch (2018-05-17)

Schematic: project.sch

Parts:
BT1: Battery_Cell; BATT_CR2032
D1, D2: LED; LED_D5.0mm
D11, D22: LED; LED_D3.0mm
J1, J2, J3, J4, J5, J6, J7, J8: CONN_01X01; SEWPAD
R1, R2: 100; Resistor_Horz
SW1: SW_SPST; mySwitchDPDT
