aspro648/KiCad/projects/LEDeyes/design_files_v01/LEDeyes.sch

## KiCad design projects/LEDeyes/design_files_v01/LEDeyes.sch (2018-05-17)

Schematic: LEDeyes.sch

Parts:
BT1: BATTERY
B_N1, B_N2: GND
B_P1, B_P2: PWR
D1, D2: LED
L1, L1_C1, L1_C2, L2: (no value)
R1, R2: 330
