aspro648/KiCad/projects/LogicBits/LogicBit - BIT R4/BIT.sch

## KiCad design projects/LogicBits/LogicBit - BIT R4/BIT.sch (2017-05-26)

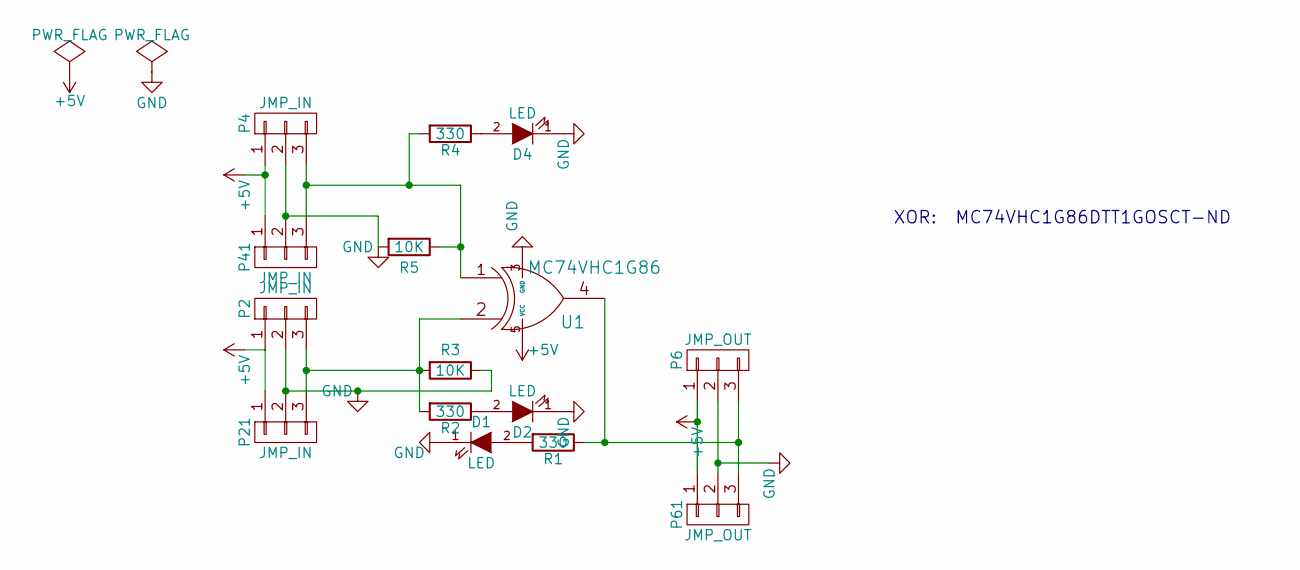
[picture p460: schematic BIT.sch]

Parts:
D1, D2, D4: LED; LED-1206
P2, P4: JMP_IN; Socket_Strip_Angled_1x03
P6: JMP_OUT; Pin_Header_Angled_1x03
P21, P41: JMP_IN; Socket_Strip_Straight_1x03
P61: JMP_OUT; Pin_Header_Straight_1x03
R1: 330; pin_socket_3
R2, R4: 330; R_1206
R3, R5: 10K; R_1206
U1: MC74VHC1G86; SOT-23-5

Connections:
+5V: P2.1, P4.1, P6.1, P21.1, P41.1, P61.1, U1.5 (VCC)
GND: D1.1 (K), D2.1 (K), D4.1 (K), P2.2, P4.2, P6.2, P21.2, P41.2, P61.2, R3.1, R5.2, U1.3 (GND)
unnamed: D1.2 (A), R1.2
unnamed: D2.2 (A), R2.1
unnamed: D4.2 (A), R4.1
unnamed: P2.3, P21.3, R2.2, R3.2, U1.2
unnamed: P4.3, P41.3, R4.2, R5.1, U1.1
unnamed: P6.3, P61.3, R1.1, U1.4

Notes on the sheet:
XOR: MC74VHC1G86DTT1GOSCT-ND
