aspro648/KiCad/projects/LogicBits/LogicBit - INPUT R3/INPUT.sch

## KiCad design projects/LogicBits/LogicBit - INPUT R3/INPUT.sch (2017-06-23)

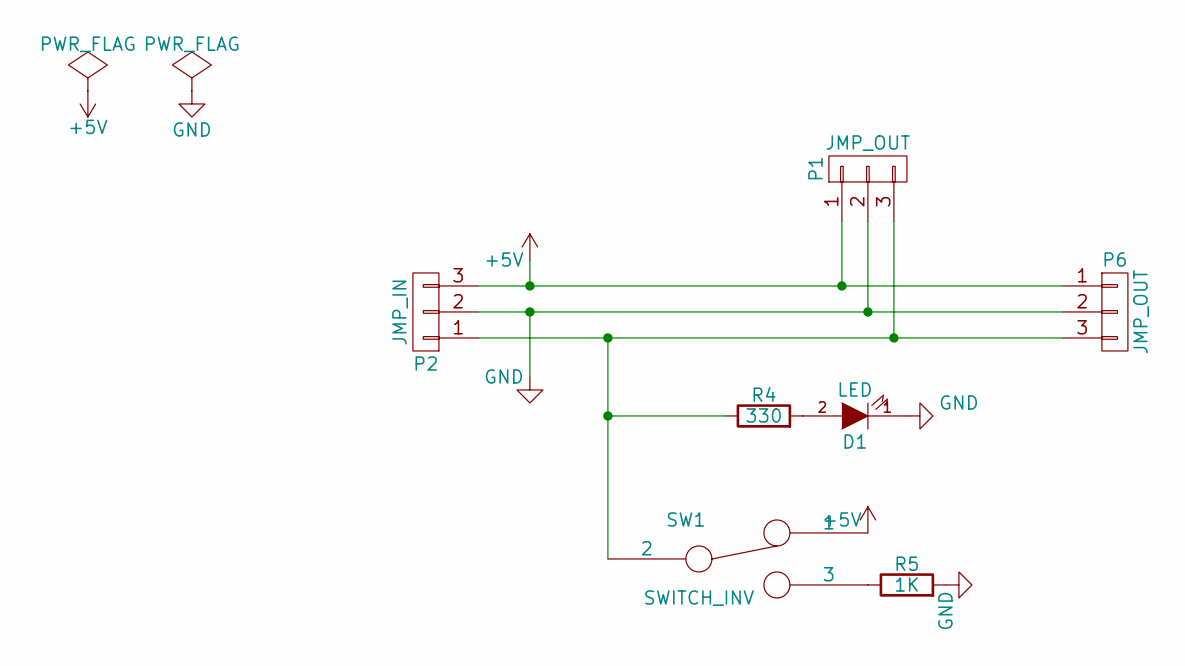
[picture p461: schematic INPUT.sch]

Parts:
D1: LED; LED-1206
P1: JMP_OUT; Pin_Header_Straight_1x03
P2: JMP_IN; Pin_Header_Angled_1x03
P6: JMP_OUT; Pin_Header_Angled_1x03
R4: 330; R_1206
R5: 1K; R_1206
SW1: SWITCH_INV; Pin_Header_Straight_1x03

Connections:
+5V: P1.1, P2.3, P6.1, SW1.1
GND: D1.1 (K), P1.2, P2.2, P6.2, R5.2
unnamed: D1.2 (A), R4.2
unnamed: P1.3, P2.1, P6.3, R4.1, SW1.2
unnamed: R5.1, SW1.3
