aspro648/KiCad/projects/LogicBits/LogicBit - NOT R2/NOT.sch

## KiCad design projects/LogicBits/LogicBit - NOT R2/NOT.sch (2017-05-26)

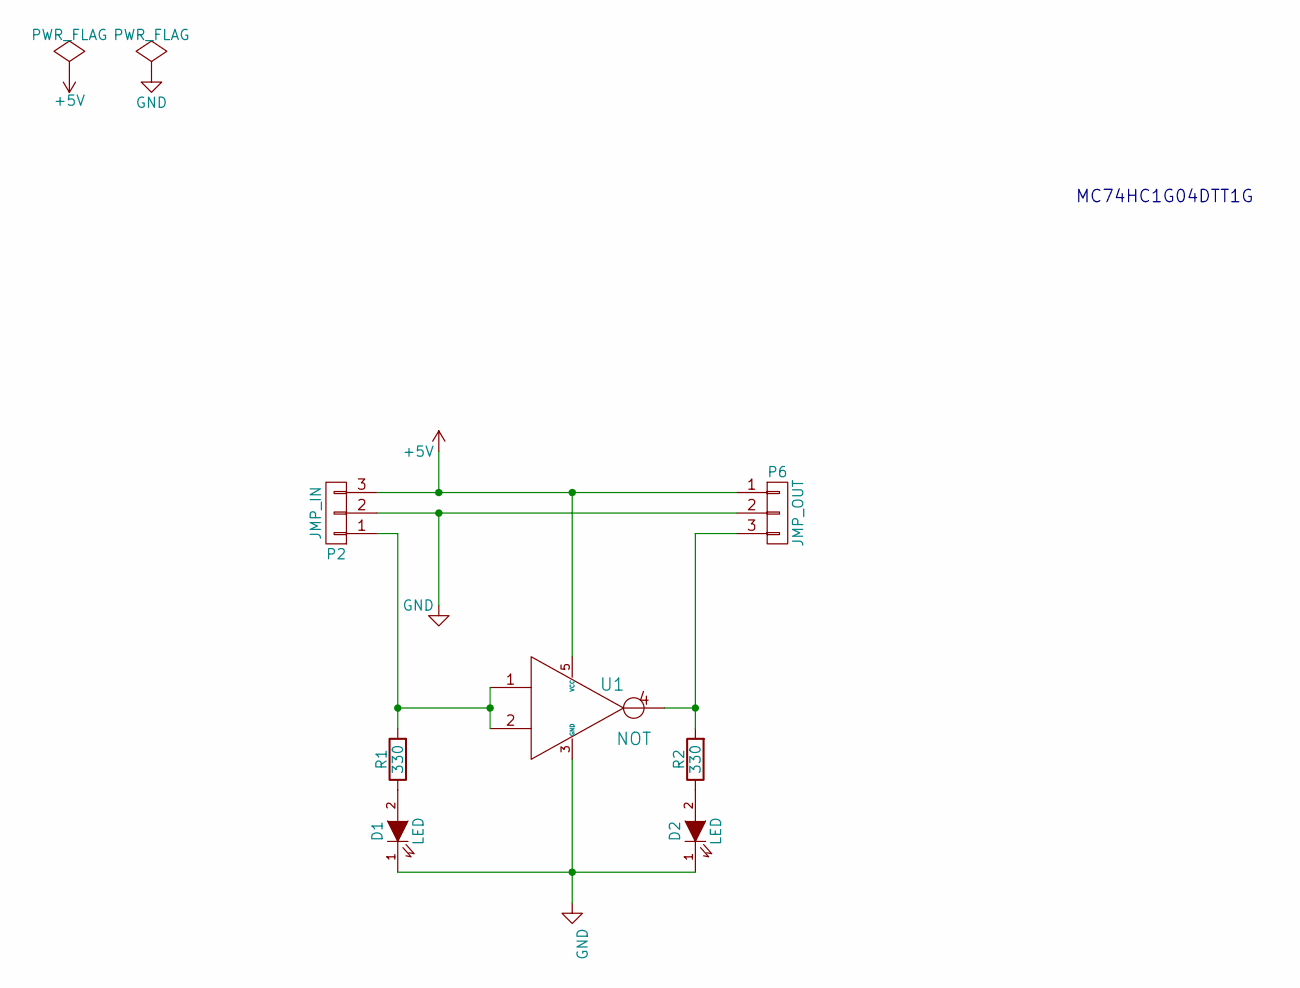
[picture p462: schematic NOT.sch]

Parts:
D1, D2: LED; LED-1206
P2: JMP_IN; Pin_Header_Angled_1x03
P6: JMP_OUT; Pin_Header_Angled_1x03
R1, R2: 330; R_1206
U1: NOT; SOT-23-5

Connections:
+5V: P2.3, P6.1, U1.5 (VCC)
GND: D1.1 (K), D2.1 (K), P2.2, P6.2, U1.3 (GND)
unnamed: D1.2 (A), R1.1
unnamed: D2.2 (A), R2.1
unnamed: P2.1, R1.2, U1.1, U1.2
unnamed: P6.3, R2.2, U1.4

Notes on the sheet:
MC74HC1G04DTT1G
