aspro648/KiCad/projects/LogicBits/LogicBit - OUT R0/OUT.sch

## KiCad design projects/LogicBits/LogicBit - OUT R0/OUT.sch (2017-05-26)

Schematic: OUT.sch

Parts:
D2: LED; LED-10MM
P2: JMP_IN; Pin_Header_Angled_1x03
P6: JMP_OUT; Pin_Header_Angled_1x03
R2: 330; Resistor_Horz

Notes on the sheet:
MC74HC1G04DTT1G
