aspro648/KiCad/projects/LogicBits/LogicBit - POWER R2/POWER.sch

## KiCad design projects/LogicBits/LogicBit - POWER R2/POWER.sch (2017-05-26)

Schematic: POWER.sch

Parts:
D1: LED; LED-1206
P2: JMP_IN; Socket_Strip_Angled_1x03
P3: USB_B; USB_Micro-B
P6: JMP_OUT; Pin_Header_Angled_1x03
R4: 330; R_1206
