aspro648/KiCad/projects/MOSFET_jr/design_files/MOSFET_jr.sch

## KiCad design projects/MOSFET_jr/design_files/MOSFET_jr.sch (2018-04-21)

Schematic: MOSFET_jr.sch

Parts:
C1: 100uf
C2: 10uf
C3: 1uf
D4, D5, D6: 1N4001
D8, D14, D15, D16: LED
JP1: JUMPER
P4: LOAD_4
P5: LOAD_5
P6: LOAD_6
P7: INPUT_1
P8: VCC
P9: INPUT_2
Q4, Q5, Q6: IRLB8721
R4, R5, R6: 10K
R8: 1000
R14, R15, R16: 330
SHIELD1: ARDUINO_SHIELD
U1: LM7809

Notes on the sheet:
Load 4
Load 5
Load 6
VCC (12-30V)
Analog Inputs
Remove JP1 if Arduino powered via USB or jack.
