aspro648/KiCad/projects/OSTR/design_files_Itsy/base.sch

## KiCad design projects/OSTR/design_files_Itsy/base.sch (2018-07-06)

Schematic: base.sch

Parts:
C1: 100uF; C_Radial_D7.5_L11.2_P2.5
C2: 10uF; C_Radial_D5_L11_P2.5
C3: 1uF; C_Disc_D3_P2.5
D2: IR_LED; LED-3MM
D3, D4: LED; LED-3MM
D5: IR LED; LED-3MM
J1: Isty_Left; Pin_Header_Straight_1x14_Pitch2.54mm
J2: Itsy_right; Pin_Header_Straight_1x14_Pitch2.54mm
P3: LEFT_STEPPER; TerminalBlock_Pheonix_MPT-2.54mm_2pol
P4: RIGHT_STEPPER; TerminalBlock_Pheonix_MPT-2.54mm_2pol
P5: BATT1; TerminalBlock_Pheonix_MPT-2.54mm_2pol
P6: BATT2; TerminalBlock_Pheonix_MPT-2.54mm_2pol
P7: SERVO; Pin_Header_Straight_1x03
Q1, Q2: OPTO_NPN; PHOTOTRANS
R1, R8: 0; R_0402
R2, R5: 100; Resistor_Horz
R3, R4: 330; Resistor_Horz
R6, R7: 10K; Resistor_Horz
SW1: SPST; SW_Micro_SPST
SW2: SW_PUSH; SW_PUSH_SMALL
U1: ULN2803; DIP-18_W7.62mm

Notes on the sheet:
https://www.digikey.com/short/qcrr5m B5B-XH-A
USB
- +
s + -
LEFT SIDE RIGHT SIDE
