aspro648/KiCad/projects/OSTR/design_files_MicroBit V1/base.sch

## KiCad design projects/OSTR/design_files_MicroBit V1/base.sch (2019-09-17)

Schematic: base.sch

Parts:
C1: 100uF; C_Radial_D7.5_L11.2_P2.5
C2: 10uF; C_Radial_D5_L11_P2.5
C3, C4: 1uF; C_Disc_D3_P2.5
D1: D; D_DO-41_SOD81_P10.16mm_Horizontal
D2: IR_LED; LED-3MM
D5: IR LED; LED-3MM
J1: microbit_edge_connector; MicroBit40
J2: BATT1; TerminalBlock_Pheonix_PT-3.5mm_2pol
J3: BATT2; TerminalBlock_Pheonix_PT-3.5mm_2pol
J4: LEFT_STEPPER; JST_B5B-XH-A
J5: RIGHT_STEPPER; JST_B5B-XH-A
J6: SERVO; Pin_Header_Straight_1x03
J7: TEST; Pin_Header_Straight_1x03_Pitch1.27mm
LS1: Speaker; SPEAKER
Q1, Q2: OPTO; PHOTOTRANS
Q3: MOSFET; SOT-23
Q4: NPN; TO-92_Inline_Wide
R1: 10K; R_0805_HandSoldering
R2, R5: 22; Resistor_Horz
SW1: SPST; SW_Micro_SPST
U1: ULN2803; DIP-18_W7.62mm
U2: MCP1702; TO-92_Inline_Wide

Notes on the sheet:
https://www.digikey.com/short/qcrr5m B5B-XH-A
- +
s + -
LEFT SIDE RIGHT SIDE
https://github.com/anthonykirby/kicad_microbit_connector
MCP1702 https://www.digikey.com/short/prhctc
P0 Stepper 1B P1 Stepper 4B P2 LEFT IR DET P3 RIGHT IR DET P4 Speaker P5 Button A P6 Stepper 2B P7 Stepper 3B P8 Stepper 1A P9 Stepper 2A P10 Stepper 3A P11 Button B P12 [Reserved] P13 Stepper 4A P14 Motor Enable P15 IR Enable P16 Servo
