aspro648/KiCad/projects/OSTR/design_files_MicroBit V9/base.sch

## KiCad design projects/OSTR/design_files_MicroBit V9/base.sch (2019-10-23)

Schematic: base.sch

Parts:
C1: 100uF; C_Radial_D7.5_L11.2_P2.5
C2: 10uF; C_Radial_D5_L11_P2.5
C3, C4: 1uF; C_Disc_D3_P2.5
J1: microbit_edge_connector; MicroBit40
J2: BATT1; TerminalBlock_Pheonix_PT-3.5mm_2pol
J3: BATT2; TerminalBlock_Pheonix_PT-3.5mm_2pol
J4: RIGHT_STEPPER; JST_B5B-XH-A
J5: LEFT_STEPPER; JST_B5B-XH-A
J6: SERVO; Pin_Header_Straight_1x03
J7: TEST; Pin_Header_Straight_1x03_Pitch1.27mm
J8: Sensors; Pin_Header_Straight_1x04_Pitch2.54mm
J9: Sensors; Pin_Header_Angled_1x04_Pitch2.54mm
LS1: Speaker; SPEAKER
Q4: NPN; TO-92_Inline_Wide
R1, R3: 10K; R__7.62mm
R2: 1K; R__7.62mm
SW1: PWR; SW_Micro_SPST
U1: TLC59213; DIP-20_W7.62mm_LongPads
U2: MCP1702; TO-92_Inline_Wide

Notes on the sheet:
https://www.digikey.com/short/qcrr5m B5B-XH-A
- +
s + -
https://github.com/anthonykirby/kicad_microbit_connector
MCP1702 https://www.digikey.com/short/prhctc
2 coils energized per stepper = 850 mA, 5 W, 7 ohm
P0 D1 P1 D4 P2 INPUT P3 INPUT P4 SPKR P5 Button A P6 D2 P7 D3 P8 D5 P9 D6 P10 D7 P11 Button B P12 Reserved P13 D8 P14 CLK P15 IR_LED P16 Servo
