aspro648/KiCad/projects/OSTR/design_files_MicroBit sensors/base.sch

## KiCad design projects/OSTR/design_files_MicroBit sensors/base.sch (2019-09-17)

Schematic: base.sch

Parts:
D2: IR_LED; LED-3MM
D5: IR LED; LED-3MM
J1: Sensors; Pin_Header_Straight_1x04_Pitch2.54mm
Q1, Q2: OPTO; PHOTOTRANS
R2, R5: 22; Resistor_Horz

Notes on the sheet:
MCP1702 https://www.digikey.com/short/prhctc
