aspro648/KiCad/projects/OSTR/pizero-OSTR/pizero.sch

## KiCad design projects/OSTR/pizero-OSTR/pizero.sch (2018-05-07)

Schematic: pizero.sch

Parts:
C1: 10uF; C_Disc_D3.0mm_W1.6mm_P2.50mm
C2: 10uF; C_Disc_D3.0mm_W2.0mm_P2.50mm
C3: 100uF; C_Radial_D7.5_L11.2_P2.5
C4: 10uF; C_Radial_D5_L11_P2.5
C5: 1uF; C_Disc_D3_P2.5
D1, D3, D4: LED; LED-3MM
D2: IR_LED; LED-3MM
D5: IR LED; LED-3MM
J1: I2C; Pin_Header_Straight_1x04_Pitch2.54mm
J2: JMP; Pin_Header_Straight_1x02_Pitch2.54mm
P0: Raspberry_Pi_+_Conn; pin_socket_20x2; Mouser Part No. 517-30340-6002
P1: BATT1; TerminalBlock_Pheonix_PT-3.5mm_2pol
P2: BATT2; TerminalBlock_Pheonix_PT-3.5mm_2pol
P3: LEFT_STEPPER; JST_B5B-XH-A
P4: RIGHT_STEPPER; JST_B5B-XH-A
P5: SERVO; Pin_Header_Straight_1x03
Q1, Q2: OPTO_NPN; PHOTOTRANS
R1, R3, R4: 330; Resistor_Horz
R2, R5: 100; Resistor_Horz
R6, R7: 10K; Resistor_Horz
R8, R9: 4K7; Resistor_Horz
SW1: SPST; SW_Micro_SPST
SW2: SW_PUSH; SW_PUSH_SMALL
U1: R-78-E
U2: ULN2803; DIP-18_W7.62mm

Notes on the sheet:
Raspberry Pi
https://www.digikey.com/short/qcrr5m B5B-XH-A
- +
- + S
LEFT SIDE RIGHT SIDE
