aspro648/KiCad/projects/clock/design_files_MCP7940/project.sch

## KiCad design projects/clock/design_files_MCP7940/project.sch (2018-02-26)

Schematic: project.sch

Parts:
C1: 0.1uF; C_0603
C2: 100pF; C_0603
CX1, CX2: 10pF; C_0603
Crystal1: 32.768; crystal_smd
D1: D_Schottky; D_0603
JL1: Conn_01x04; Pin_Header_Straight_1x04_Pitch2.54mm
JR1: Conn_01x04; Pin_Header_Straight_1x04_Pitch2.54mm
P1, P2, P3, P4: Pin; Pin_Header_Straight_1x01_Pitch2.54mm
R1: 1K; R_0603
R2, R3: 2K; R_0603
R4: 10K; R_0603
U1: RTC; SOIC-8_3.9x4.9mm_Pitch1.27mm

Notes on the sheet:
https://www.electronicshub.org/arduino-4-digit-7-segment-led-display/
https://www.digikey.com/product-detail/en/adafruit-industries-llc/811/1528-1509-ND/5774235
