aspro648/KiCad/projects/clock/design_files_clock_V1/project.sch

## KiCad design projects/clock/design_files_clock_V1/project.sch (2018-03-28)

Schematic: project.sch

Parts:
BT2: 3V; BATT_12mm_TH
C1, C2: 0.1uF; C_Disc_D3.4mm_W2.1mm_P2.50mm
CON1: ISP; AVR-ISP-6
Crystal1: 32.768; Crystal_C38-LF_d3.0mm_l8.0mm_Horizontal_1EP_style1
J1: PWR; PhoenixContact_MC-G_02x3.50mm_Angled
Q1: Photo; PHOTO_TRANS
Q2, Q3, Q4, Q5: 2N2222; TO-92_NPN_EBC_wide
R1, R7, R8, R9, R10: 100; Resistor_Horz
R3, R4, R5, R6: 1K; Resistor_Horz
SPKR1: Speaker; PS1240_piezo
SW1: PWR; SW_Micro_SPST
SW2, SW3: SW_Push; SW_PUSH_SMALL
U1: ATMEGA328P-PU; DIP-28_W7.62mm
U2: KW4-56xxx; CA56-12CGKWA
U3: DS1302; DIP-8_W7.62mm

Notes on the sheet:
https://www.electronicshub.org/arduino-4-digit-7-segment-led-display/
https://www.digikey.com/product-detail/en/adafruit-industries-llc/811/1528-1509-ND/5774235
