aspro648/KiCad/projects/train/trainShield2/trainShield.sch

## KiCad design projects/train/trainShield2/trainShield.sch (2017-05-26)

Schematic: trainShield.sch

Parts:
C1: 0.1 uF; C1
C2: 47uF; C2
CON2: AVR-ISP-6
D1: 1N4001
D2, D12: LED; LED-3MM
IC1: ATMEGA328P-P; DIP-28_W7.62mm
P0, P1, P2, P3, P4, P5, P6, P7, P8, P9, P10, P11, P12, P13, P14, P15: CONN_01X03; TerminalBlock_Pheonix_MPT-2.54mm_3pol
P16: CONN_01X04; Pin_Header_Straight_1x04
P17: TERM_2; TerminalBlock_Pheonix_PT-3.5mm_2pol
P18, P19, P20, P21: CONN_01X01; Pin_Header_Straight_1x01
R1, R4: 330; Resistor_Horz
R2, R3: 4K7; Resistor_Horz
RB0, RB1, RB2, RB3, RB4, RB5, RB6, RB7, RB8, RB9, RB10, RB11, RB12, RB13, RB14, RB15: 330; Resistor_Horz
RR1, RR2: RR8; Resistor_Array_SIP8
SW3: SW_PUSHBUTTON; SW_PUSH_SMALL
U1: 7805; TO-220_Neutral123_Horizontal
U2, U3: MCP3008; DIP-16_W7.62mm
U4: MCP23017; DIP-28_W7.62mm
X1: RESONATOR; resonator_sip3

Notes on the sheet:
D8 CS1 D9 CLK D10 DOUT D11 DIN D12 CS2 A4 SDA A5 SCK
