aspro648/KiCad/projects/train/trainShield/trainShield.sch

## KiCad design projects/train/trainShield/trainShield.sch (2017-05-26)

Schematic: trainShield.sch

Parts:
C1: 0.1 uF; C1
C2: 47uF; C2
C3: 100uF; C2
C4: 10uF; C2
CON1: BARREL_JACK
D1: 1N4001
D2, D3, D4, D5, D6, D7, D8, D9: 1N4001; Diode_DO-41_SOD81_Vertical_AnodeUp
D10, D11, D12, D13, D14, D15, D16: LED; LED-3MM
P1, P3: TERM_2; TERMx2
P2, P4: TERMx3
P5: CONN_01X04; Pin_Header_Straight_1x04
P6, P7: CONN_01X03; TerminalBlock_Pheonix_MPT-2.54mm_3pol
R1: 2K2; Resistor_Horz
R2, R3, R4, R5, R6, R7: 330; Resistor_Horz
RV1: POT
SHIELD1: ARDUINO_SHIELD
SW1, SW2, SW3: SW_PUSHBUTTON; SW_PUSH_SMALL
U1: 7805; TO-220_Neutral123_Horizontal
U2, U3: L293D; DIP-16_W7.62mm

Notes on the sheet:
Reverser
Throttle
SW1_LED_U
SW1_LED_D
SW1
SW2
MOT_LED_L
MOT_LED_R
SW 2 LED U
SW 2 LED D
Inputs: A0 Throttle A1 Reverser 2 SW1 3 SW2 Outputs: 0 SW1_LED_D 1 SW1_LED_U 4 SW2_LED_U 5 SW2_LED_D 6 SWITCH_2_B 7 SWITCH_2_A 8 SWITCH_1_A 9 SWITCH_1_B 10 MOT_B 11 MOT_A 12 MOT_LED_R 13 MOT_LED_L
SCL SDA GND VCC
A - D
SWITCH 2
SWITCH 1
