aspro648/KiCad/projects/train/trainShieldLED2/trainShield.sch

## KiCad design projects/train/trainShieldLED2/trainShield.sch (2017-05-26)

Schematic: trainShield.sch

Parts:
D1: LED; LED-3MM
P1: CONN_01X03; TerminalBlock_Pheonix_MPT-2.54mm_3pol
Q1: OPTO_NPN; PHOTO_TRANS
