aspro648/KiCad/projects/train/trainShieldLEDb/trainShield.sch

## KiCad design projects/train/trainShieldLEDb/trainShield.sch (2017-10-12)

Schematic: trainShield.sch

Parts:
D1, D2: LED; LED-3MM
P1: CONN_01X06
Q1, Q2: OPTO_NPN; PHOTO_TRANS
