aspro648/KiCad/projects/train/trainSwitch/trainSwitch.sch

## KiCad design projects/train/trainSwitch/trainSwitch.sch (2017-05-26)

Schematic: trainSwitch.sch

Parts:
C1: 0.1 uF; C1
C2: 0.33uF
C3: 0.1uf
D0: LED; LED-5MM
D1: LED; LED-1206
IC1: ATTINY85; DIP-8__300
P1, P2: CONN_01X03
Q1, Q2: PN2222A; TO-92
R1: 330; R_1206
R2: 10K; R_1206
R4: 330; Resistor_Horizontal_RM10mm
TOUCH1: SW_PUSH; SW_PUSH_TOUCH
U1: LM7805

Notes on the sheet:
D5/A0
D4/A2
D3/A3
D2/A1
D1/pwm
D0/pwm
