aspro648/KiCad/projects/Altimeter/KiCad_design_files/rescue-backup/project-2022-04-05-18-08-34.sch

## KiCad design projects/Altimeter/KiCad_design_files/rescue-backup/project-2022-04-05-18-08-34.sch (2019-05-21)

Schematic: project-2022-04-05-18-08-34.sch

Parts:
BT1: Battery_Cell; BATT_CR2032_SMD
C1, C3, C4: 0.1uF; C_0805
C2: 10uF; C_1206
CON1: AVR-ISP-6
D1: LED; LED_0805
J1: Display; Pin_Header_Straight_1x04_Pitch2.54mm
R1, R2, R3: 1K; R_0805
SW1: SW_Reed; REED_SWITCH
SW2: SW_SPDT; SW_SPDT_CK-JS102011SAQN
U1: ATMEGA328P-AU; TQFP-32_7x7mm_Pitch0.8mm
U2: MPL3115A; LGA-8_3x5mm_Pitch1.25mm
