aspro648/KiCad/projects/Attiny/Attin85_HBridge R2/design_files/project.sch

## KiCad design projects/Attiny/Attin85_HBridge R2/design_files/project.sch (2020-03-19)

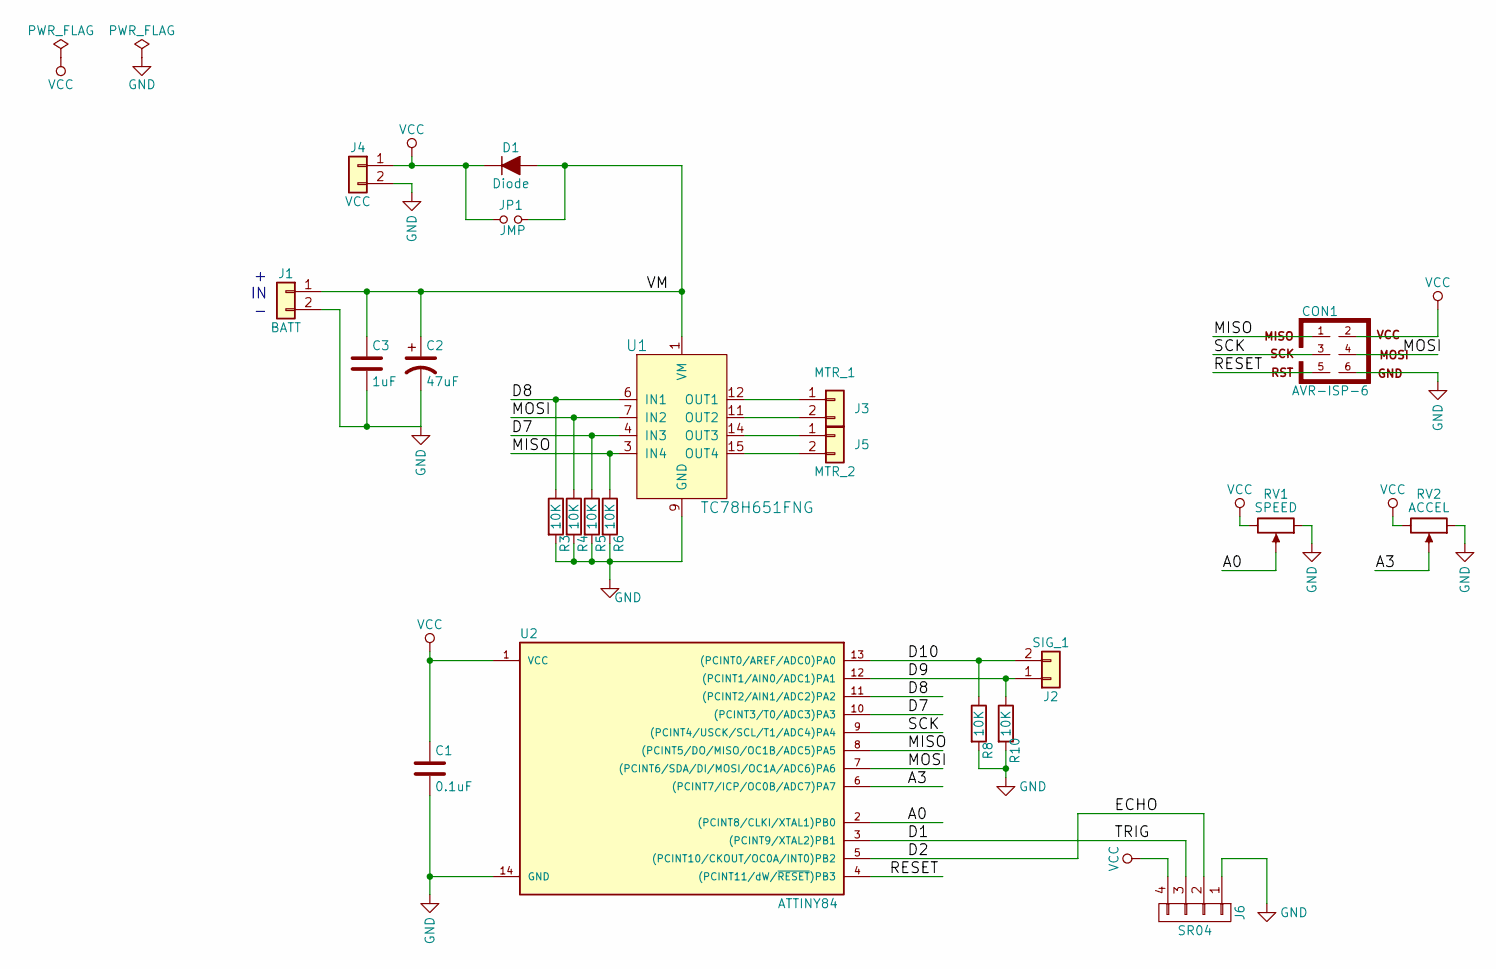
[picture p463: schematic project.sch]

Parts:
C1: 0.1uF; C_0603_HandSoldering
C2: 47uF; CP_Elec_6.3x5.3
C3: 1uF; C_0603_HandSoldering
CON1: AVR-ISP-6; Pin_Header_Straight_2x03_Pitch2.54mm
D1: Diode; D_SOD-323_HandSoldering
J1: BATT; Pin_Header_Straight_1x02_Pitch2.54mm
J2: SIG_1; Pin_Header_Straight_1x02_Pitch2.54mm
J3: MTR_1; Pin_Header_Straight_1x02_Pitch2.54mm
J4: VCC; Pin_Header_Straight_1x02_Pitch2.54mm
J5: MTR_2; Pin_Header_Straight_1x02_Pitch2.54mm
J6: SR04; Pin_Header_Straight_1x04_Pitch2.54mm
JP1: JMP; Jumper
R3, R4, R5, R6, R8, R10: 10K; R_0603_HandSoldering
RV1: SPEED; Pot_Bourns_TC33
RV2: ACCEL; Pot_Bourns_TC33
U1: TC78H651FNG; TSSOP-16_4.4x5mm_Pitch0.65mm
U2: ATTINY84; SOIC-14_3.9x8.7mm_Pitch1.27mm

Connections:
A0: RV1.2, U2.2 ((PCINT8/CLKI/XTAL1)PB0)
A3: RV2.2, U2.6 ((PCINT7/ICP/OC0B/ADC7)PA7)
D1: J6.3, U2.3 ((PCINT9/XTAL2)PB1)
D2: J6.2, U2.5 ((PCINT10/CKOUT/OC0A/INT0)PB2)
D7: R5.1, U1.4 (IN3), U2.10 ((PCINT3/T0/ADC3)PA3)
D8: R3.1, U1.6 (IN1), U2.11 ((PCINT2/AIN1/ADC2)PA2)
D9: J2.1, R10.1, U2.12 ((PCINT1/AIN0/ADC1)PA1)
D10: J2.2, R8.1, U2.13 ((PCINT0/AREF/ADC0)PA0)
GND: C1.2, C2.2, C3.2, CON1.6, J1.2, J4.2, J6.1, R3.2, R4.2, R5.2, R6.2, R8.2, R10.2, RV1.1, RV2.1, U1.9 (GND), U2.14 (GND)
MISO: CON1.1, R6.1, U1.3 (IN4), U2.8 ((PCINT5/DO/MISO/OC1B/ADC5)PA5)
MOSI: CON1.4, R4.1, U1.7 (IN2), U2.7 ((PCINT6/SDA/DI/MOSI/OC1A/ADC6)PA6)
unnamed: J3.1, U1.12 (OUT1)
unnamed: J3.2, U1.11 (OUT2)
unnamed: J5.1, U1.14 (OUT3)
unnamed: J5.2, U1.15 (OUT4)
RESET: CON1.5, U2.4 ((PCINT11/dW/~RESET~)PB3)
SCK: CON1.3, U2.9 ((PCINT4/USCK/SCL/T1/ADC4)PA4)
VCC: C1.1, CON1.2, D1.1 (K), J4.1, J6.4, JP1.1, RV1.3, RV2.3, U2.1 (VCC)
VM: C2.1, C3.1, D1.2 (A), J1.1, JP1.2, U1.1 (VM)

Notes on the sheet:
+ IN -
