aspro648/KiCad/projects/Attiny/Attiny85Challenge2019/design_files/base.sch

## KiCad design projects/Attiny/Attiny85Challenge2019/design_files/base.sch (2018-07-06)

Schematic: base.sch

Parts:
BT1: Battery; BATT_CR2032_SMD
C1: 0.1 uF; C_1206_HandSoldering
CON1: AVR-ISP-6
D0: LED; LED-1206
D1: LED; LED-0805
D2: LED; LED-0603
D3: LED; LED_0402
D4: LED; LED_0201
IC1: IC1; SOIJ-8_5.3x5.3mm_Pitch1.27mm
J1, J2, J3, J4, J5, J6, J7, J8, J9, J10, J11, J12, J13, J14, J15: Conn_01x01; testPad
P5: CONN_01X01; Pin_Header_Straight_1x01
R0: 330; R_1206
R1: 330; R_0805
R2: 330; R_0603
R3: 330; R_0402
R4: 330; R_0201
SW1: SW_Push_SPDT; SPST_SMD

Notes on the sheet:
1206 RED
0805 Orange
0603 Yellow
0402 Green
0201 Blue
