aspro648/KiCad/projects/Attiny/Attiny85ChallengeToorCon/design_files/base.sch

## KiCad design projects/Attiny/Attiny85ChallengeToorCon/design_files/base.sch (2018-07-23)

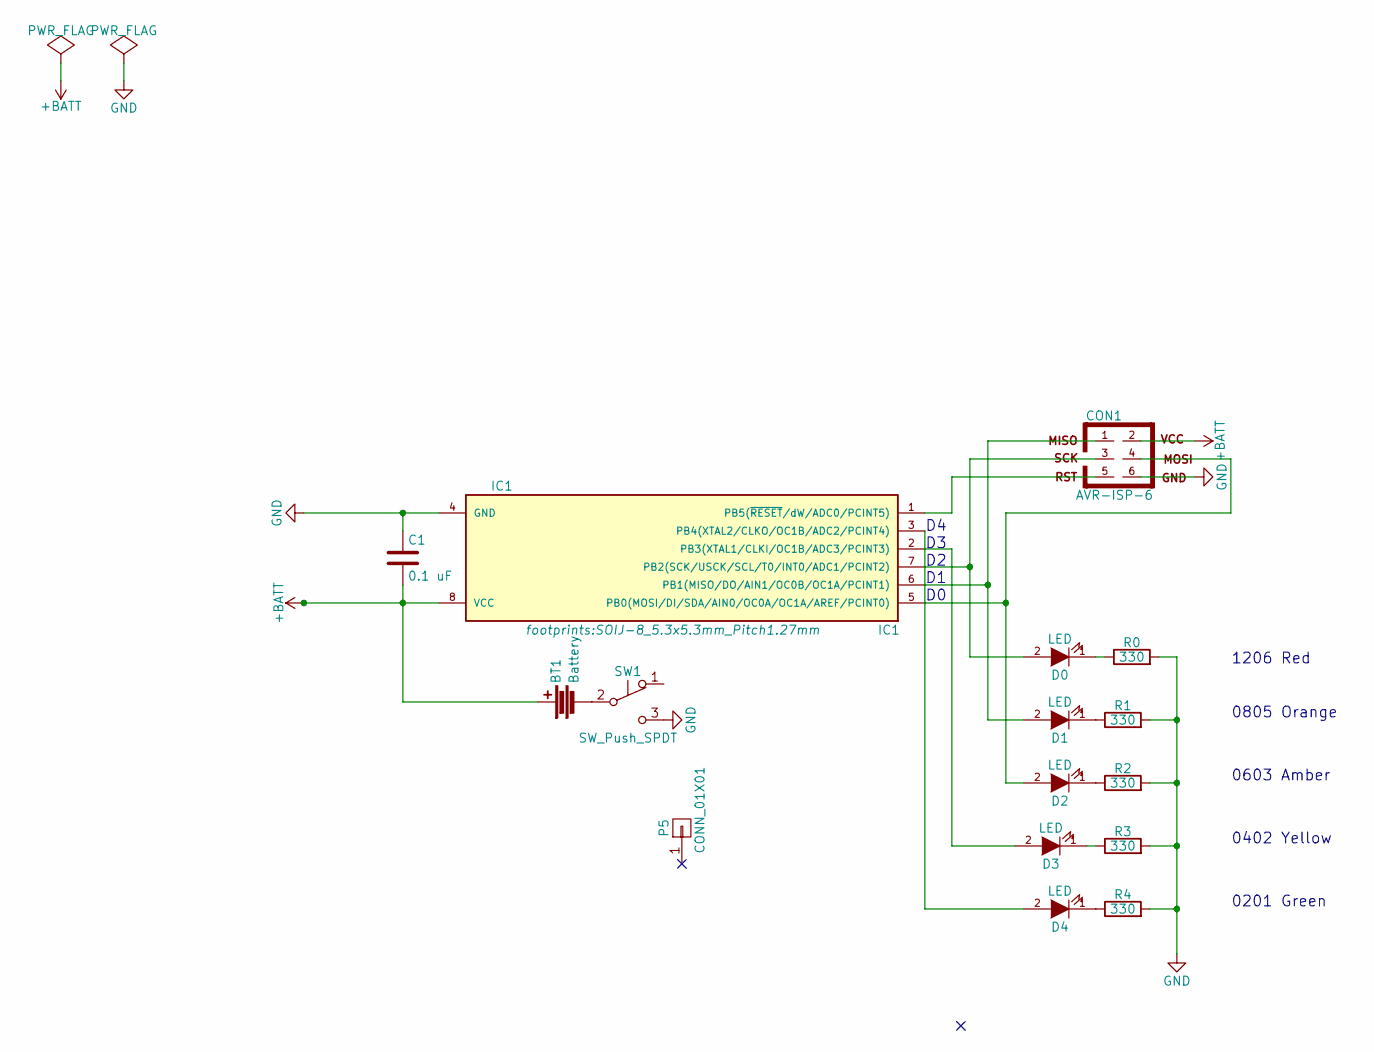
[picture p465: schematic base.sch]

Parts:
BT1: Battery; BATT_CR2032_SMD
C1: 0.1 uF; C_1206_HandSoldering
CON1: AVR-ISP-6
D0: LED; LED-1206
D1: LED; LED-0805
D2: LED; LED-0603
D3: LED; LED_0402
D4: LED; LED_0201
IC1: IC1; SOIJ-8_5.3x5.3mm_Pitch1.27mm
P5: CONN_01X01; Pin_Header_Straight_1x01
R0: 330; R_1206
R1: 330; R_0805
R2: 330; R_0603
R3: 330; R_0402
R4: 330; R_0201
SW1: SW_Push_SPDT; SPST_SMD

Connections:
+BATT: BT1.1, C1.2, CON1.2, IC1.8 (VCC)
GND: C1.1, CON1.6, IC1.4 (GND), R0.2, R1.2, R2.2, R3.2, R4.2, SW1.3 (C)
unnamed: BT1.2, SW1.2 (B)
unnamed: CON1.1, D1.2 (A), IC1.6 (PB1(MISO/DO/AIN1/OC0B/OC1A/PCINT1))
unnamed: CON1.3, D0.2 (A), IC1.7 (PB2(SCK/USCK/SCL/T0/INT0/ADC1/PCINT2))
unnamed: CON1.4, D2.2 (A), IC1.5 (PB0(MOSI/DI/SDA/AIN0/OC0A/OC1A/AREF/PCI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)
unnamed: CON1.5, IC1.1 (PB5(~RESET~/dW/ADC0/PCINT5))
unnamed: D0.1 (K), R0.1
unnamed: D1.1 (K), R1.1
unnamed: D2.1 (K), R2.1
unnamed: D3.1 (K), R3.1
unnamed: D3.2 (A), IC1.2 (PB3(XTAL1/CLKI/OC1B/ADC3/PCINT3))
unnamed: D4.1 (K), R4.1
unnamed: D4.2 (A), IC1.3 (PB4(XTAL2/CLKO/OC1B/ADC2/PCINT4))

Notes on the sheet:
1206 Red
0805 Orange
0603 Amber
0402 Yellow
0201 Green
D4 D3 D2 D1 D0
