aspro648/KiCad/projects/Attiny/Attiny85HeartSMD/design_files/base.sch

## KiCad design projects/Attiny/Attiny85HeartSMD/design_files/base.sch (2018-05-07)

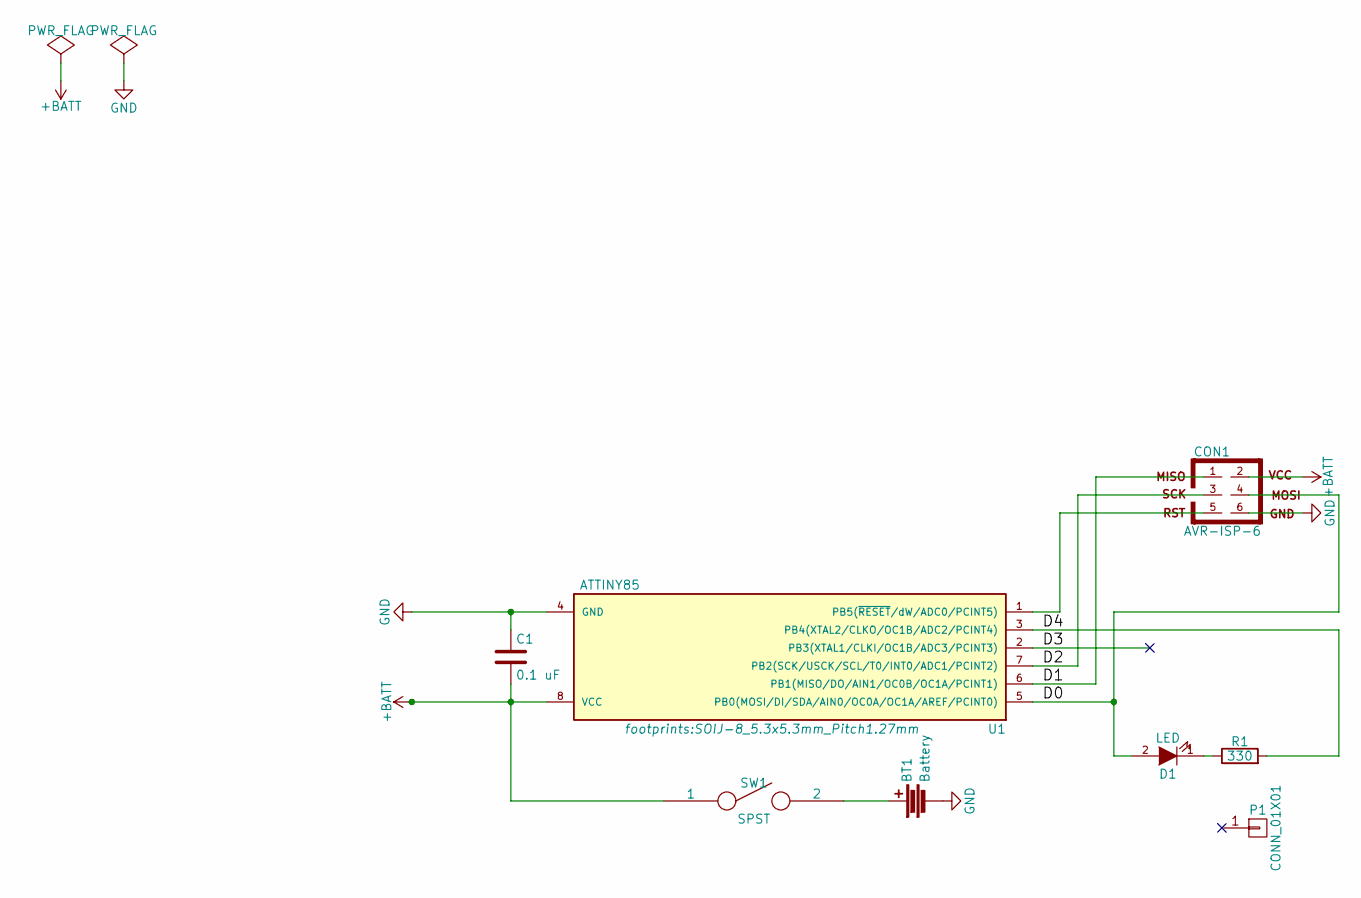
[picture p466: schematic base.sch]

Parts:
BT1: Battery; BATT_CR2032_SMD
C1: 0.1 uF; C_1206_HandSoldering
CON1: AVR-ISP-6
D1: LED; LED-1206
P1: CONN_01X01; Pin_Header_Straight_1x01
R1: 330; R_1206_HandSoldering
SW1: SPST; SPST_SMD
U1: ATTINY85; SOIJ-8_5.3x5.3mm_Pitch1.27mm

Connections:
+BATT: C1.2, CON1.2, SW1.1, U1.8 (VCC)
D0: CON1.4, D1.2 (A), U1.5 (PB0(MOSI/DI/SDA/AIN0/OC0A/OC1A/AREF/PCI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)
D1: CON1.1, U1.6 (PB1(MISO/DO/AIN1/OC0B/OC1A/PCINT1))
D2: CON1.3, U1.7 (PB2(SCK/USCK/SCL/T0/INT0/ADC1/PCINT2))
D3: U1.2 (PB3(XTAL1/CLKI/OC1B/ADC3/PCINT3))
D4: R1.2, U1.3 (PB4(XTAL2/CLKO/OC1B/ADC2/PCINT4))
GND: BT1.2, C1.1, CON1.6, U1.4 (GND)
unnamed: BT1.1, SW1.2
unnamed: CON1.5, U1.1 (PB5(~RESET~/dW/ADC0/PCINT5))
unnamed: D1.1 (K), R1.1
