aspro648/KiCad/projects/Attiny/rroll/design_files V5 sew B/project.sch

## KiCad design projects/Attiny/rroll/design_files V5 sew B/project.sch (2019-04-09)

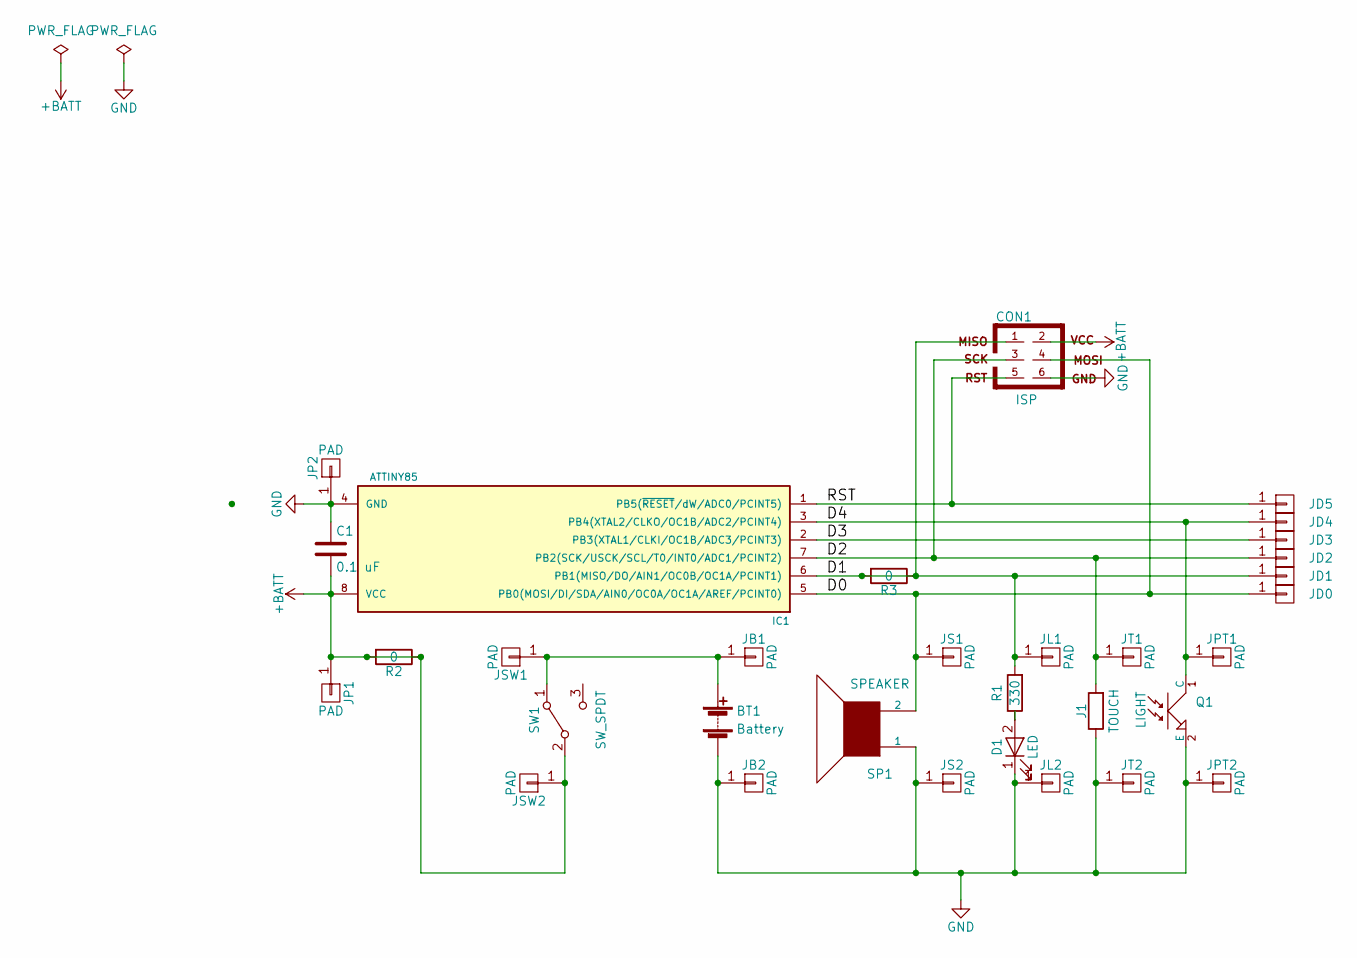
[picture p467: schematic project.sch]

Parts:
BT1: Battery; BATT_CR2032_SMD
C1: 0.1 uF; C_1206
CON1: ISP; Pin_Header_Straight_2x03_Pitch2.54mm
D1: LED; LED_1206
IC1: ATTINY85; SOIJ-8_5.3x5.3mm_Pitch1.27mm
J1: TOUCH; R_1206_HandSoldering
JB1, JB2: PAD; SewPad
JD0, JD1, JD2, JD3, JD4, JD5: PAD; SewPad
JL1, JL2: PAD; SewPad
JP1, JP2: PAD; SewPad
JPT1, JPT2: PAD; SewPad
JS1, JS2: PAD; SewPad
JSW1, JSW2: PAD; SewPad
JT1, JT2: PAD; SewPad
Q1: LIGHT; PhotoDiode_SMD-DIL2_4.5x4
R1: 330; R_1206
R2, R3: 0; R_1206
SP1: SPEAKER; PS1240_piezo
SW1: SW_SPDT; SPST_SMD

Connections:
+BATT: C1.2, CON1.2, IC1.8 (VCC), JP1.1, JSW2.1, R2.1, R2.2, SW1.2 (B)
D0: CON1.4, IC1.5 (PB0(MOSI/DI/SDA/AIN0/OC0A/OC1A/AREF/PCI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), JD0.1, JS1.1, SP1.2
D1: CON1.1, IC1.6 (PB1(MISO/DO/AIN1/OC0B/OC1A/PCINT1)), JD1.1, JL1.1, R1.2, R3.1, R3.2
D2: CON1.3, IC1.7 (PB2(SCK/USCK/SCL/T0/INT0/ADC1/PCINT2)), J1.2, JD2.1, JT1.1
D3: IC1.2 (PB3(XTAL1/CLKI/OC1B/ADC3/PCINT3)), JD3.1
D4: IC1.3 (PB4(XTAL2/CLKO/OC1B/ADC2/PCINT4)), JD4.1, JPT1.1, Q1.1 (C)
GND: BT1.2 (-), C1.1, CON1.6, D1.1 (K), IC1.4 (GND), J1.1, JB2.1, JL2.1, JP2.1, JPT2.1, JS2.1, JT2.1, Q1.2 (E), SP1.1
unnamed: BT1.1 (+), JB1.1, JSW1.1, SW1.1 (A)
unnamed: D1.2 (A), R1.1
RST: CON1.5, IC1.1 (PB5(~RESET~/dW/ADC0/PCINT5)), JD5.1
