aspro648/KiCad/projects/Attiny/rroll/design_files/project - v0.sch

## KiCad design projects/Attiny/rroll/design_files/project - v0.sch (2018-03-30)

Schematic: project - v0.sch

Parts:
BT1: Battery; BATT_CR2032_SMD
C1: 0.1 uF; C_1206_HandSoldering
CON1: ISP; Pin_Header_Straight_2x03_Pitch2.54mm_SMD
D1: LED; LED_1206_HandSoldering
IC1: ATTINY85; SOIC-8_3.9x4.9mm_Pitch1.27mm
J1: JMP; R_1206_HandSoldering
Q1: LIGHT; PHOTO_TRANS
R1: 330; R_1206_HandSoldering
SP1: SPEAKER; PS1240_piezo

Notes on the sheet:
D5/A0
D4/A2
D3/A3
D2/A1
D1/pwm
D0/pwm
D0 Speaker D1 LED A3 Photo D4 Jumper
https://github.com/rogertheriault/firefly
https://www.digikey.com/product-detail/en/murata-electronics-north-america/PKMCS0909E4000-R1/490-9647-1-ND/4878401
https://www.digikey.com/product-detail/en/vishay-semiconductor-opto-division/TEMT6000X01/751-1055-1-ND/1681410
