aspro648/KiCad/projects/Beetje/design_files_32U4x2/rescue-backup/project-2022-04-05-18-07-47.sch

## KiCad design projects/Beetje/design_files_32U4x2/rescue-backup/project-2022-04-05-18-07-47.sch (2018-09-25)

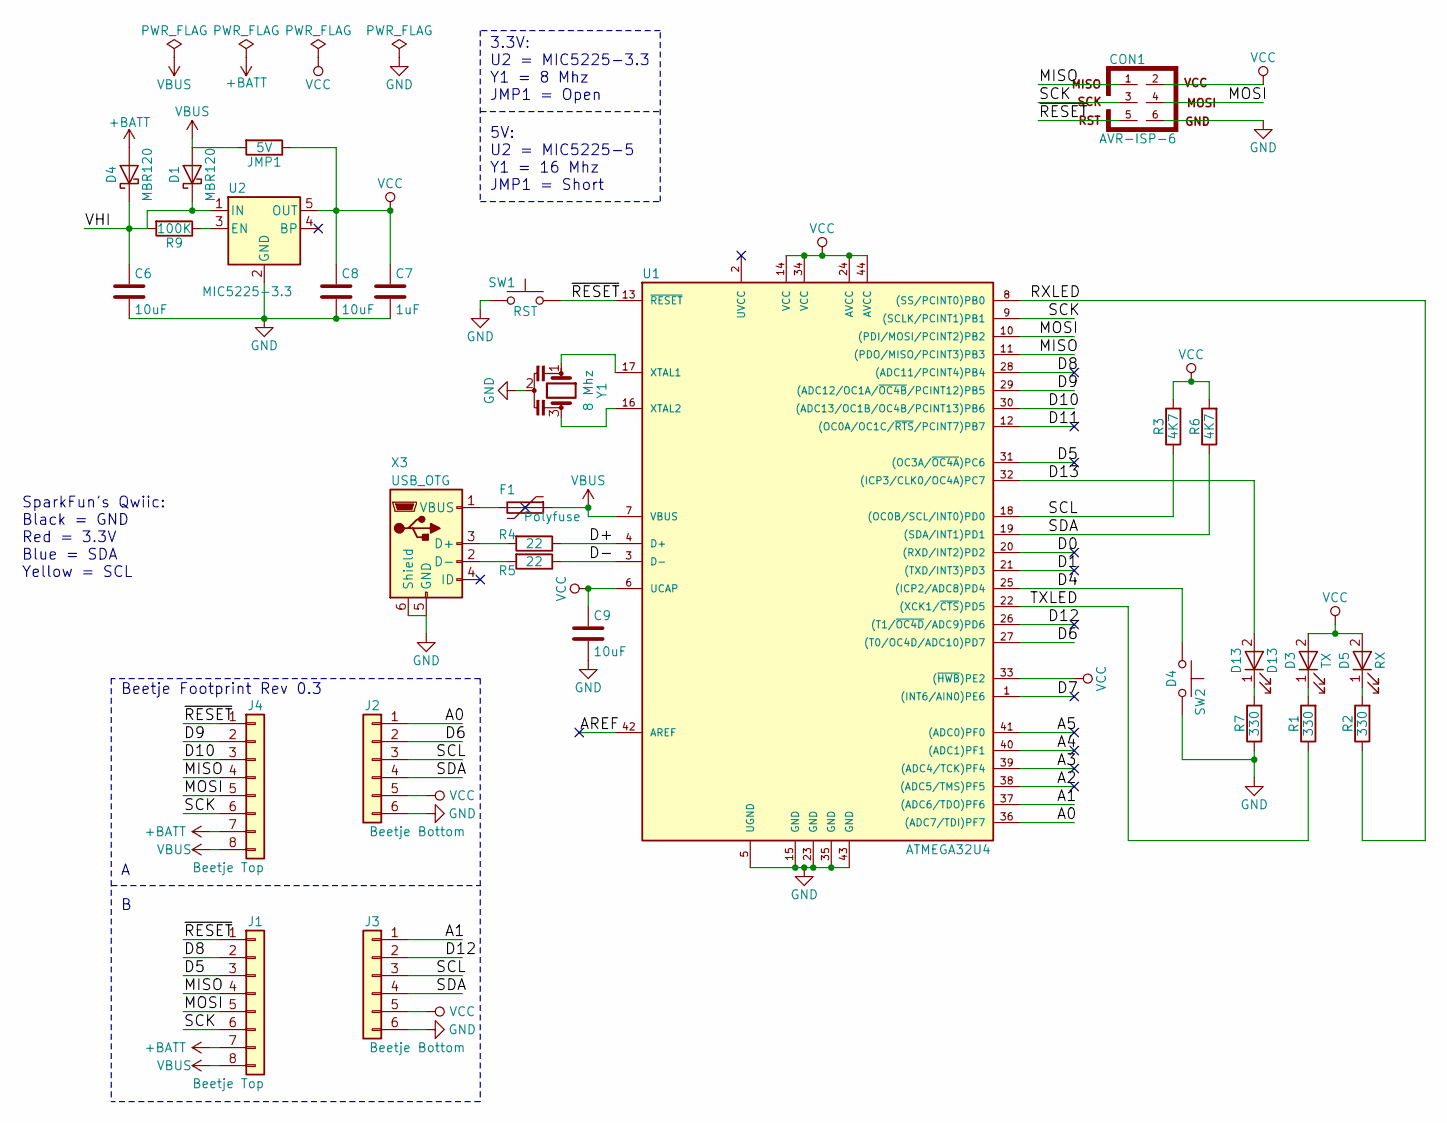
[picture p468: schematic project-2022-04-05-18-07-47.sch]

Parts:
C6, C8, C9: 10uF; C_0805
C7: 1uF; C_0805
CON1: AVR-ISP-6; Pin_Header_Straight_2x03_Pitch2.54mm
D1, D4: MBR120; D_SOD-123F
D3: TX; LED_0805
D5: RX; LED_0805
D13: D13; LED_0805
F1: Polyfuse; R_1206
J1, J4: Beetje Top; Beetje_Top
J2, J3: Beetje Bottom; Beetje_Bottom
JMP1: 5V; Jumper
R1, R2, R7: 330; R_0805
R3, R6: 4K7; R_0805
R4, R5: 22; R_0805
R9: 100K; R_0805
SW1: RST; EVQ-P7A
SW2: D4; EVQ-P7A
U1: ATMEGA32U4; TQFP-44_10x10mm_Pitch0.8mm
U2: MIC5225-3.3; SOT-23-5
X3: USB_OTG; USB_Micro-B_Molex-105017-0001
Y1: 8 Mhz; Resonator_SMD_CTSC_1.3mmx3.2mm

Connections:
+BATT: D4.2 (A), J1.7, J4.7
A0: J2.1, U1.36 ((ADC7/TDI)PF7)
A1: J3.1, U1.37 ((ADC6/TDO)PF6)
A2: U1.38 ((ADC5/TMS)PF5)
A3: U1.39 ((ADC4/TCK)PF4)
A4: U1.40 ((ADC1)PF1)
A5: U1.41 ((ADC0)PF0)
AREF: U1.42 (AREF)
D0: U1.20 ((RXD/INT2)PD2)
D1: U1.21 ((TXD/INT3)PD3)
D4: SW2.1, U1.25 ((ICP2/ADC8)PD4)
D5: J1.3, U1.31 ((OC3A/~OC4A~)PC6)
D6: J2.2, U1.27 ((T0/OC4D/ADC10)PD7)
D7: U1.1 ((INT6/AIN0)PE6)
D8: J1.2, U1.28 ((ADC11/PCINT4)PB4)
D9: J4.2, U1.29 ((ADC12/OC1A/~OC4B~/PCINT12)PB5)
D10: J4.3, U1.30 ((ADC13/OC1B/OC4B/PCINT13)PB6)
D11: U1.12 ((OC0A/OC1C/~RTS~/PCINT7)PB7)
D12: J3.2, U1.26 ((T1/~OC4D~/ADC9)PD6)
D13: D13.2 (A), U1.32 ((ICP3/CLK0/OC4A)PC7)
D+: R4.1, U1.4 (D+)
D-: R5.1, U1.3 (D-)
GND: C6.2, C7.2, C8.2, C9.2, CON1.6, J2.6, J3.6, R7.1, SW1.2, SW2.2, U1.5 (UGND), U1.15 (GND), U1.23 (GND), U1.35 (GND), U1.43 (GND), U2.2 (GND), X3.5 (GND), X3.6 (Shield), Y1.2
MISO: CON1.1, J1.4, J4.4, U1.11 ((PDO/MISO/PCINT3)PB3)
MOSI: CON1.4, J1.5, J4.5, U1.10 ((PDI/MOSI/PCINT2)PB2)
unnamed: D3.1 (K), R1.2
unnamed: D5.1 (K), R2.2
unnamed: D13.1 (K), R7.2
unnamed: F1.2, X3.1 (VBUS)
unnamed: R4.2, X3.3 (D+)
unnamed: R5.2, X3.2 (D-)
unnamed: R9.1, U2.3 (EN)
unnamed: U1.16 (XTAL2), Y1.3
unnamed: U1.17 (XTAL1), Y1.1
RXLED: R2.1, U1.8 ((SS/PCINT0)PB0)
SCK: CON1.3, J1.6, J4.6, U1.9 ((SCLK/PCINT1)PB1)
SCL: J2.3, J3.3, R3.1, U1.18 ((OC0B/SCL/INT0)PD0)
SDA: J2.4, J3.4, R6.1, U1.19 ((SDA/INT1)PD1)
TXLED: R1.1, U1.22 ((XCK1/~CTS~)PD5)
VBUS: D1.2 (A), F1.1, J1.8, J4.8, JMP1.2, U1.7 (VBUS)
VCC: C7.1, C8.1, C9.1, CON1.2, D3.2 (A), D5.2 (A), J2.5, J3.5, JMP1.1, R3.2, R6.2, U1.6 (UCAP), U1.14 (VCC), U1.24 (AVCC), U1.33 ((~HWB~)PE2), U1.34 (VCC), U1.44 (AVCC), U2.5 (OUT)
VHI: C6.1, D1.1 (K), D4.1 (K), R9.2, U2.1 (IN)
~RESET: CON1.5, J1.1, J4.1, SW1.1, U1.13 (~RESET~)

Notes on the sheet:
3.3V: U2 = MIC5225-3.3 Y1 = 8 Mhz JMP1 = Open
5V: U2 = MIC5225-5 Y1 = 16 Mhz JMP1 = Short
Beetje Footprint Rev 0.3
SparkFun's Qwiic: Black = GND Red = 3.3V Blue = SDA Yellow = SCL
A B
