aspro648/KiCad/projects/HW/HW_IR gate/rescue-backup/project-2021-09-20-15-41-16.sch

## KiCad design projects/HW/HW_IR gate/rescue-backup/project-2021-09-20-15-41-16.sch (2020-08-25)

Schematic: project-2021-09-20-15-41-16.sch

Parts:
C1: 0.1uF; C_0805
C2: 1uF; C_0603
C3: 10uF; C_0805
CON1: ISP; Pin_Header_Straight_2x03_Pitch2.54mm
D5, D6: LED; LED_D3.0mm
D7, D8: IR; LED_D3.0mm
F1: Polyfuse; R_1206
J1: I2C; Molex_PicoBlade_53048-0410_04x1.25mm_Angled
J2: RJ45; RJ45_8
J3: SERVO_1; Pin_Header_Angled_1x03_Pitch2.54mm
J4: SERVO; Pin_Header_Angled_1x03_Pitch2.54mm
Q1, Q2: Q_Photo_NPN; PHOTOTRANS
R1, R2, R3, R8: JMP; Jumper
R4, R5: 4K7; R_0603
R6, R7: 22; R_0603
R9, R12: 10K; R_0603
R10, R11: 100; R_0603
R13, R14: 330; R_0603
SW1: D4; SW_PUSH_6mm
U1: ATMEGA32U4-AU; TQFP-44_10x10mm_Pitch0.8mm
X1: USB; USB_Micro-B_Molex-105017-0001
Y1: 8 Mhz; Resonator_SMD_CTSC_1.3mmx3.2mm

Notes on the sheet:
SparkFun's Qwiic: Black = GND Red = 3.3V Blue = SDA Yellow = SCL
