aspro648/KiCad/projects/LEGO/LEGO_LED brick/design_files/LEGO_LED.sch

## KiCad design projects/LEGO/LEGO_LED brick/design_files/LEGO_LED.sch (2020-04-30)

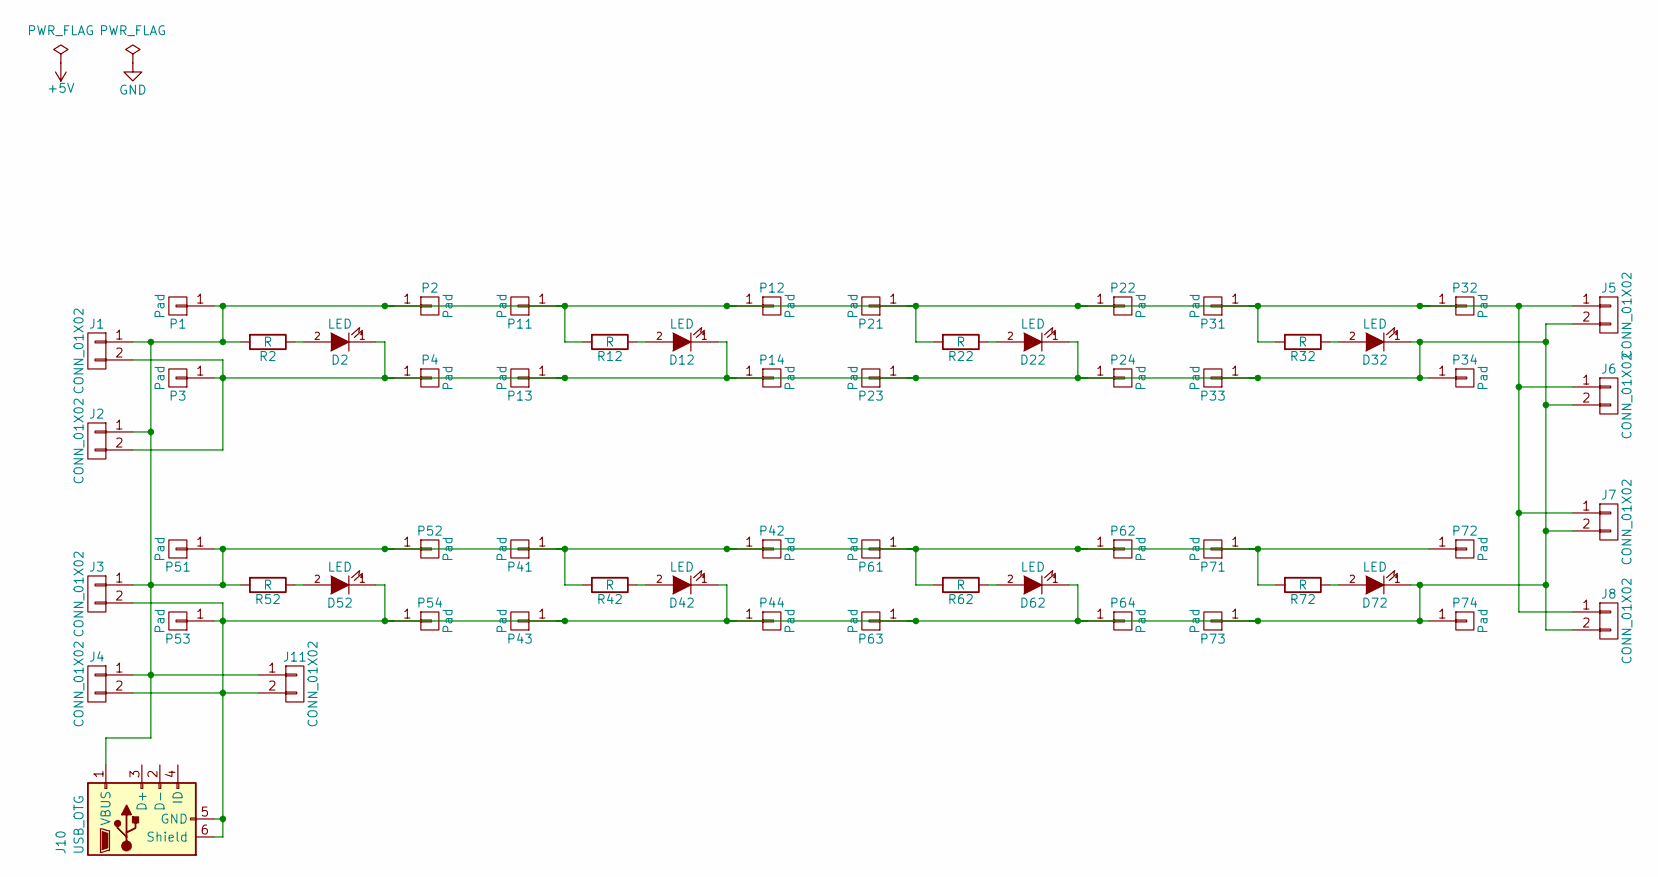
[picture p469: schematic LEGO_LED.sch]

Parts:
D2, D12, D22, D32, D42, D52, D62, D72: LED; LED_0805
J1, J2, J3, J4, J5, J6, J7, J8, J11: CONN_01X02; Molex_PicoBlade_53047-0210_02x1.25mm_Straight
J10: USB_OTG
P1, P2, P3, P4, P11, P12, P13, P14, P21, P22, P23, P24, P31, P32, P33, P34, P41, P42, P43, P44, P51, P52, P53, P54, P61, P62, P63, P64, P71, P72, P73, P74: Pad; Pin_Header_Straight_1x01_Pitch2.00mm
R2, R12, R22, R32, R42, R52, R62, R72: R; R_0805

Connections:
unnamed: D2.2 (A), R2.1
unnamed: D2.1 (K), D12.1 (K), D22.1 (K), D32.1 (K), D42.1 (K), D52.1 (K), D62.1 (K), D72.1 (K), J1.2, J2.2, J3.2, J4.2, J5.2, J6.2, J7.2, J8.2, J10.5 (GND), J10.6 (Shield), J11.2, P3.1, P4.1, P13.1, P14.1, P23.1, P24.1, P33.1, P34.1, P43.1, P44.1, P53.1, P54.1, P63.1, P64.1, P73.1, P74.1
unnamed: D12.2 (A), R12.1
unnamed: D22.2 (A), R22.1
unnamed: D32.2 (A), R32.1
unnamed: D42.2 (A), R42.1
unnamed: D52.2 (A), R52.1
unnamed: D62.2 (A), R62.1
unnamed: D72.2 (A), R72.1
unnamed: J1.1, J2.1, J3.1, J4.1, J5.1, J6.1, J7.1, J8.1, J10.1 (VBUS), J11.1, P1.1, P2.1, P11.1, P12.1, P21.1, P22.1, P31.1, P32.1, P41.1, P42.1, P51.1, P52.1, P61.1, P62.1, P71.1, P72.1, R2.2, R12.2, R22.2, R32.2, R42.2, R52.2, R62.2, R72.2
