aspro648/KiCad/projects/Nerf/ArduStryfe/design_files Stryfe V05/project.sch

## KiCad design projects/Nerf/ArduStryfe/design_files Stryfe V05/project.sch (2019-08-31)

Schematic: project.sch

Parts:
C1, C4: 1uF; C_Disc_D5.0mm_W2.5mm_P2.50mm
C5, C7, C9, C10: 0.1uF; C_Disc_D3.4mm_W2.1mm_P2.50mm
CON1: ISP; Pin_Header_Straight_2x03_Pitch2.54mm
D1: 1N4001; D_DO-41
F1: PTC; Fuse_Littelfuse-LVR125
J1: JAM; Molex_PicoBlade_53047-0210_02x1.25mm_Straight
J2: BATT_IN; TerminalBlock_P3.50mm_Horizontal
J3: LED; Molex_PicoBlade_53047-0210_02x1.25mm_Straight
J5: I2C; Molex_PicoBlade_53047-0410_04x1.25mm_Straight
J6: REV; Molex_PicoBlade_53047-0210_02x1.25mm_Straight
J7: FTDI; Pin_Header_Straight_1x06_Pitch2.54mm
J8: PHOTO; Molex_PicoBlade_53047-0310_03x1.25mm_Straight
J9: FW_MTRS; TerminalBlock_P3.50mm_Horizontal
J12: CLIP; Molex_PicoBlade_53047-0210_02x1.25mm_Straight
J14: NPTH; SolderWirePad_single_2-5mmDrill
J21: BUTTON; Molex_PicoBlade_53047-0210_02x1.25mm_Straight
JP1: 6V; JMP
JP2: 3S; JMP
LS1: Speaker; SPEAKER
Q1: IRLR8729; TO-252-2_hand_soldering
R1, R2, R3: 10K 1%; R_7.5mm
R6, R9, R17, R19, R20: 10K; R__P5.08mm
R7, R18: 1K; R__P5.08mm
R12: 330; R__P5.08mm
R21: 100; R__P5.08mm
U1: MCP1702; TO-92_Inline_Narrow_Oval
U3, U4, U6: HALL SENSOR; Hall_Sensor
U5: ATMEGA328P-PU; DIP-28_W7.62mm
Y1: 16Mhz; Resonator-3pin_w7.0mm_h2.5mm

Notes on the sheet:
VOLTAGE DIVIDER
CLIP DETECT
+ -
A0 BUTTON A1 DART IR A2 A3 Voltage D2 D3 REV SW D4 SPKR D5 D6 D7 CLIP D8 D9 FW MTRS D10 Clip U3 D11 Clip U4 D12 Clip U6 D13 LED
DEBOUNCE
Vbatt =Vmeas * 2
