aspro648/KiCad/projects/Nerf/ArduStryfe_MOSFET/design_files Stryfe MOSFET V01/project.sch

## KiCad design projects/Nerf/ArduStryfe_MOSFET/design_files Stryfe MOSFET V01/project.sch (2019-08-24)

Schematic: project.sch

Parts:
BT1: BATT; Terminal_no_silk
D1: KICKBACK; D_DO-41
F1: FUSE; Fuse_Littelfuse-LVR125
J1: REV_SW; Molex_PicoBlade_53047-0210_02x1.25mm_Straight
J3: SOLDER; Pin_Header_Straight_1x02_Pitch2.00mm
J14: MOUNT; SolderWirePad_single_2-5mmDrill
M1: MTRS; Terminal_no_silk
Q1: MOSFET; TO-220-3_Horizontal
R1: 10K; R__P7mm

Notes on the sheet:
DRAIN
GATE
SOURCE
