aspro648/KiCad/projects/Nerf/NerfMuzzleFlash 2/design_files/project.sch

## KiCad design projects/Nerf/NerfMuzzleFlash 2/design_files/project.sch (2019-04-24)

Schematic: project.sch

Parts:
D1, D2, D3, D4, D5: LED; LED_D5.0mmCentered
D6: IR; LED_IR_SQUARE
J1: CONN_01X04; Pin_Header_Straight_1x04_Pitch2.54mm
Q1: TN0702; TO-92_Inline_Wide
Q2: Q_Photo_NPN; PHOTOTRANS
R1, R2, R3, R4, R5: *R; R_Axial_P5.08mm
R6: 100; R_Axial_P5.08mm
R7, R8: 10K; R_Axial_P5.08mm

Notes on the sheet:
https://www.digikey.com/product-detail/en/microchip-technology/TN0702N3-G/TN0702N3-G-ND/4902376
+ - S G
*R based on 3Vf, 20mA: - 3.7V (1S) = 39 ohm - 4.5V (3AA) = 82 ohm - 7.2V (2S) = 220 ohm - 11V (3S) = 470 ohm
