aspro648/KiCad/projects/Nerf/NerfSwitch SP3T/design_files/_saved_project.sch

## KiCad design projects/Nerf/NerfSwitch SP3T/design_files/_saved_project.sch (2019-05-10)

Schematic: _saved_project.sch

Parts:
J1: CONN_01X04; R_Array_SIP4
SW1: SW_SP3T
