aspro648/KiCad/projects/pizero/pihat-AVRprogrammer/hardware/Ideal_Diode.sch

## KiCad design projects/pizero/pihat-AVRprogrammer/hardware/Ideal_Diode.sch (2017-05-26)

Schematic: Ideal_Diode.sch

Parts:
Q1: BSS138; sot23; Mouser Part No. 621-DMG2305UX-13
R11: 10k; r_0402; Mouser Part No. 71-CRCW0402-10K-E3
R12: 47k; r_0402; Mouser Part No. 667-ERJ-2RKF4702X
U5: DMMT5401; sot23-6; Mouser Part No. 621-DMMT5401-7-F

Notes on the sheet:
*Recomended back powering protection for raspberry pi. Recomended by Raspberyy Pi Foundation https://github.com/raspberrypi/hats/blob/master/designguide.md
