aspro648/KiCad/projects/pizero/pihat-AVRprogrammer/hardware/pihat_template.sch

## KiCad design projects/pizero/pihat-AVRprogrammer/hardware/pihat_template.sch (2017-05-26)

Schematic: pihat_template.sch

Parts:
CON_84, CON_85, CON_328: AVR-ISP-6
CON_ISP1: AVR-ISP-6
D1: LED; LED-3MM
P1: DIL28; Zif_228-3341
P3: Raspberry_Pi_+_Conn; vasch_strip_20x2; Mouser Part No. 517-30340-6002
R1: 330; Resistor_Horz
Y1: 16Mhz; Crystal_HC49-U_Vertical_3Pin

Notes on the sheet:
Pi AVR Programmer
# Linux GPIO configuration for avrdude. # Change the lines below to the GPIO pins connected to the AVR. programmer id = "pi_1"; desc = "Use the Linux sysfs interface to bitbang GPIO lines"; type = "linuxgpio"; reset = 27; sck = 3; mosi = 2; miso = 18; ;
