aspro648/KiCad/projects/HotWheels/328 Accel/firmware/Car2/Car2.ino

/*
  Blink

  Turns an LED on for one second, then off for one second, repeatedly.

  Most Arduinos have an on-board LED you can control. On the UNO, MEGA and ZERO
  it is attached to digital pin 13, on MKR1000 on pin 6. LED_BUILTIN is set to
  the correct LED pin independent of which board is used.
  If you want to know what pin the on-board LED is connected to on your Arduino
  model, check the Technical Specs of your board at:
  https://www.arduino.cc/en/Main/Products

  modified 8 May 2014
  by Scott Fitzgerald
  modified 2 Sep 2016
  by Arturo Guadalupi
  modified 8 Sep 2016
  by Colby Newman

  This example code is in the public domain.

  http://www.arduino.cc/en/Tutorial/Blink
*/

int HL = 10;
int TL = 5;
int BL = 6;
int DL = 9;
int UL = 11;

#include <Wire.h>
#include <SPI.h>
#include <Adafruit_LIS3DH.h>
#include <Adafruit_Sensor.h>

// Used for software SPI
#define LIS3DH_CLK 13
#define LIS3DH_MISO 12
#define LIS3DH_MOSI 11
// Used for hardware & software SPI
#define LIS3DH_CS 10

// I2C
Adafruit_LIS3DH lis = Adafruit_LIS3DH();


// the setup function runs once when you press reset or power the board
void setup() {
  // initialize digital pin LED_BUILTIN as an output.
  pinMode(HL, OUTPUT);
  pinMode(TL, OUTPUT);
  pinMode(BL, OUTPUT);
  pinMode(DL, OUTPUT);
  pinMode(UL, OUTPUT);

  for(int x=0; x<3; x++){
    digitalWrite(TL, HIGH);
    digitalWrite(HL, HIGH);
    digitalWrite(DL, HIGH);  
    digitalWrite(UL, HIGH);
    delay(250);
    digitalWrite(TL, LOW);
    digitalWrite(HL, LOW);
    digitalWrite(DL, LOW);  
    digitalWrite(UL, LOW);
    delay(250);
  }

  if (! lis.begin(0x18)) {   // change this to 0x19 for alternative i2c address
    digitalWrite(BL, HIGH);
    while (1);
  }


  lis.setRange(LIS3DH_RANGE_2_G);   // 2, 4, 8 or 16 G!
  analogWrite(UL, 75);
  analogWrite(TL, 125);
  digitalWrite(HL, HIGH);
}



// the loop function runs over and over again forever
void loop() {


  lis.read();
  if(lis.x > 1000 || lis.x < -1000){
    analogWrite(BL, 125);
  }
  else{
    digitalWrite(BL, LOW);
  }
  delay(10);

/*
  digitalWrite(HL, HIGH);   // turn the LED on (HIGH is the voltage level)
  digitalWrite(TL, LOW);
  delay(1000);                       // wait for a second
  digitalWrite(HL, LOW);    // turn the LED off by making the voltage LOW
  digitalWrite(TL, HIGH);
  delay(500);                       // wait for a second
  digitalWrite(BL, HIGH);
  delay(500);
  digitalWrite(BL, LOW);
  delay(500);
*/
}
