aspro648/KiCad/projects/OSTR/firmware/OSTR_writer/font.ino

void A(){
  penUp();
  turnLeft(90);
  penDown();
  moveForward(3 * scale);
  turnRight(45);
  moveForward(1.41 * scale);
  turnRight(90);
  moveForward(1.41 * scale);
  turnRight(45);
  moveForward(2 * scale);
  turnRight(90);
  moveForward(2 * scale);
  moveBackward(2 * scale);
  turnLeft(90);
  moveForward(1 * scale);
  penUp();
  turnLeft(90);
  moveForward(0.5 * scale);
}

void B(){
  penDown();
  moveForward(1 * scale);
  turnLeft(45);
  moveForward(1.41 * scale);
  turnLeft(90);
  moveForward(1.41 * scale);
  turnRight(90);
  moveForward(1.41 * scale);
  turnLeft(90);
  moveForward(1.41 * scale);
  turnLeft(45);
  moveForward(1 * scale);
  turnLeft(90);
  moveForward(4 * scale);
  penUp();
  turnLeft(90);
  moveForward(2.5 * scale);    
}

void C(){
  penUp();
  turnLeft(90 - 33.7);
  moveForward(3.61 * scale);
  penDown();
  turnLeft(78.7);
  moveForward(1.41 * scale);
  turnLeft(90);
  moveForward(1.41 * scale);
  turnLeft(45);
  moveForward(2 * scale);
  turnLeft(45);
  moveForward(1.41 * scale);
  turnLeft(90);
  moveForward(1.41 * scale);
  penUp();
  turnRight(90);
  moveForward(1.41 * scale);
  turnLeft(45);
  moveBackward(0.5 * scale);
}

void D(){
  penDown();
  moveForward(1 * scale);
  turnLeft(45);
  moveForward(1.41 * scale);
  turnLeft(45);
  moveForward(2 * scale);
  turnLeft(45);
  moveForward(1.41 * scale);
  turnLeft(45);
  moveForward(1 * scale);
  turnLeft(90);
  moveForward(4 * scale);
  penUp();
  turnLeft(90);
  moveForward(2.5 * scale);
}

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
   turnRight(45);
   moveForward(1* scale);
   
   turnRight(180);
   moveForward(1* scale);
   penUp();
   moveForward(1* scale);
   penDown();
   moveForward(1* scale);
   turnRight(180);
   moveForward(1* scale);
   turnLeft(45);
   moveForward(1.41* scale);
   penUp();
   moveForward(50);
 }


void coolS1() { // https://en.wikipedia.org/wiki/Cool_S
  pendown();
  forward(1* scale);
  left(45);
  forward(1.41* scale);
  right(45);
  forward(1* scale);
  right(45);
  forward(1.41* scale);
  right(90); // top
  forward(1.41* scale);
  right(45);
  forward(1* scale);
  right(45);
  forward((1.41* scale) / 2);

  penup();
  right(90);
  forward((1.41* scale)/2);
  right(45);
  forward(1* scale);
  right(180);
  pendown();
  forward(1* scale);
  left(45);
  forward(1.41* scale);
  right(45);
  forward(1* scale);
  right(45);
  forward(1.41* scale);
  right(90); // bottom
  forward(1.41* scale);
  right(45);
  forward(1* scale);
  right(45);
  forward((1.41* scale)/2);
  
  penup();
  forward(150);
}

void coolS2(scale){
    pendown();
  forward(1* scale);
  left(45);
  forward(1.41* scale);
  right(45);
  forward(1* scale);
  right(45);
  forward(1.41* scale);
  left(90); // top

  backward(1.41* scale);
  right(45);

  backward(1* scale);
  right(45);
  backward((1.41* scale) / 2);
  penup();
  
  left(90);
  forward((1.41* scale)/2);
  right(45);
  forward(1* scale);
  pendown();
  backward(1* scale);
  left(45);
  backward(1.41* scale);
  right(45);
  backward(1* scale);
  right(45);
  backward(1.41 * scale);
  left(90);
  forward(1.41 * scale);
  right(45);
  forward(1 * scale);
  right(45);
  forward(1.41 * scale / 2);
  penUp();
  forward(75);
}
