aspro648/KiCad/projects/Attiny/Attiny84SpinnerTHD_R3/firmaware/SMD_spinner_THT_R2/textAndShapes.h

// Place data (except text[]) in program memory to save dynamic memory
// https://playground.arduino.cc/Main/PROGMEM
// http://www.gammon.com.au/progmem

const char text[] = "Hello";
const char string_0[] PROGMEM = "World!";
const char string_1[] PROGMEM = " RPM";   
const char string_2[] PROGMEM = " SEC";
const char string_3[] PROGMEM = " REV";
const char string_4[] PROGMEM = " odo";

const char * const string_table[] PROGMEM = {	   // change "string_table" name to suit
  string_0,
  string_1,
  string_2,
  string_3,
  string_4,
  };

const char PROGMEM shape_1[] = { // heart
  B10000000,
  B01000000,
  B01000000,
  B00100000,
  B00100000,
  B00100000,
  B00010000,
  B00010000,
  B00010000,
  B00010000,
  B00010000,
  B00010000,
  B00010000,
  B00010000,
  B00010000,
  B00010000,
  B00010000,
  B00100000,
  B00100000,
  B00100000,
  B00100000,
  B01000000,
  B01000000,
  B01000000,
  B10000000,
  B10000000,
  B10000000,
  B10000000,
  B10000000,
  B01000000,
  B00100000,
  B00010000,
  B00001000,
  B00000100,
  B00000010,
  B00000001,
  B00000001,
  B00000010,
  B00000100,
  B00001000,
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
};
 

const char PROGMEM shape_2[] = { // smile
  B10001000,
  B10001000,
  B10001000,
  B10001000,
  B10001000,
  B10001000,
  B10001000,
  B10001000,
  B10001000,
  B10001000,
  B10000000,
  B10000000,
  B10000000,
  B10000000,
  B10000000,
  B10000000,
  B10000000,
  B10000000,
  B10000000,
  B10000000,
  B10000000,
  B10000000,
  B10000000,
  B10000000,
  B10000000,
  B10001100,
  B10011110,
  B10011110,
  B10001100,
  B10000000,
  B10000000,
  B10000000,
  B10000000,
  B10000000,
  B10000000,
  B10000000,
  B10000000,
  B10000000,
  B10000000,
  B10000000,
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
};


 /*
 Creative Commons Attribution-Noncommercial-Share Alike 2.5 Australia License
     This page was last modified 14:41, 11 January 2009. This page has been accessed 1,477 times.

     Content is available under Creative Commons Attribution-Noncommercial-Share Alike 2.5 Australia License.
     About Open Source Urbanism
     Disclaimers

    
 Powered by MediaWiki
 */
