aspro648/KiCad/projects/HotWheels/Attiny/design_files Attiny826 V1/firmware/simple/simple.ino

// NeoPixel Ring simple sketch (c) 2013 Shae Erisson
// released under the GPLv3 license to match the rest of the AdaFruit NeoPixel library

#include <tinyNeoPixel.h>


// Which pin on the Arduino is connected to the NeoPixels?
#define PIN            3

// How many NeoPixels are attached to the Arduino?
#define NUMPIXELS      2

// When we setup the NeoPixel library, we tell it how many pixels, and which pin to use to send signals.
// Note that for older NeoPixel strips you might need to change the third parameter--see the strandtest
// example for more information on possible values.
tinyNeoPixel pixels = tinyNeoPixel(NUMPIXELS, PIN, NEO_GRB + NEO_KHZ800);

int delayval = 2; // delay for half a second

void setup() {
  pixels.setBrightness(10); //0-255
  pixels.begin(); // This initializes the NeoPixel library.
}

void loop2() {

  // For a set of NeoPixels the first NeoPixel is 0, second is 1, all the way up to the count of pixels minus one.

  for (int i = 0; i < NUMPIXELS; i++) {

    // pixels.Color takes RGB values, from 0,0,0 up to 255,255,255
    pixels.setPixelColor(i, pixels.Color(0, 150, 0)); // Moderately bright green color.

    pixels.show(); // This sends the updated pixel color to the hardware.

    delay(delayval); // Delay for a period of time (in milliseconds).

  }
}


void loop() { //https://gist.github.com/jimsynz/766994
  unsigned int rgbColour[3];

  // Start off with red.
  rgbColour[0] = 255;
  rgbColour[1] = 0;
  rgbColour[2] = 0;  

  // Choose the colours to increment and decrement.
  for (int decColour = 0; decColour < 2; decColour += 1) {
    //int incColour = decColour == 2 ? 0 : decColour + 1;
    int incColour = !decColour;
    // cross-fade the two colours.
    for(int i = 0; i < 255; i += 1) {
      rgbColour[decColour] -= 1;
      rgbColour[incColour] += 1;
     
   
      for (int i = 0; i < NUMPIXELS; i++) {
    
        // pixels.Color takes RGB values, from 0,0,0 up to 255,255,255
        pixels.setPixelColor(i, pixels.Color(rgbColour[0], rgbColour[1], rgbColour[2])); // Moderately bright green color.
    
        pixels.show(); // This sends the updated pixel color to the hardware.
    
        delay(delayval); // Delay for a period of time (in milliseconds).
    
      }

    }
  }
}
