aspro648/KiCad/(commit log)

2017-05-26 Initial file upload.
    God helpl us all.
    [BIT-B_Cu.gbr, BIT-B_Mask.gbr, BIT-B_SilkS.gbr, BIT-Edge_Cuts.gbr, BIT-F_Cu.gbr, BIT-F_Mask.gbr, BIT-F_SilkS.gbr, BIT.drl]
2017-06-02 MOSFET2 to production
    [pizero.kicad_pcb, pizero.sch]
2017-06-09 Attiny84 spinner to OSHPark
    [base.kicad_pcb, base.sch]
2017-06-09 Thru hole version of spinner
    [base.kicad_pcb, base.sch]
2017-06-10 Still cleaning up.
    [base-B.Cu.gbl, base-B.Mask.gbs, base-B.SilkS.gbo, base-B_Cu.gbl, base-B_Mask.gbs, base-B_SilkS.gbo, base-Edge.Cuts.gm1, base-Edge_Cuts.gm1]
2017-06-13 MOSFET2 cleanup from Probook
    [pizero.kicad_pcb, pizero.sch]
2017-06-16 TDK Level shifter
    [mini-breadboard-B.Cu.gbr, mini-breadboard-B.Mask.gbr, mini-breadboard-B.SilkS.gbr, mini-breadboard-Edge.Cuts.gbr, mini-breadboard-F.Cu.gbr, mini-breadboard-F.Mask.gbr, mini-breadboard-F.SilkS.gbr, mini-breadboard-NPTH.drl]
2017-06-23 Logic bit updates to input and bit.
    [BIT.kicad_pcb, INPUT.kicad_pcb, INPUT.sch, base.kicad_pcb]
2017-06-26 Medium run of Spinner, et. al.
    [base.kicad_pcb]
2017-07-24 SMD Challenge and Heart Documentation
    [base-B.Cu.gbl, base-B.Mask.gbs, base-B.SilkS.gbo, base-B_Cu.gbl, base-B_Mask.gbs, base-B_SilkS.gbo, base-Edge.Cuts.gm1, base-Edge_Cuts.gm1]
2017-07-25 Spinner THD 0.2 to OSH Park
    [base.kicad_pcb]
2017-08-17 OSH Park Badge
    [base.kicad_pcb, base.sch, mask.kicad_pcb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]
2017-08-18 Updating license
    [base.sch]
2017-08-18 Updating OSHPark readme.md
    [base.kicad_pcb, base.sch]
2017-08-25 Geek Spinne THD Update
    [base.kicad_pcb]
2017-08-28 OSHPark badge update
    [base.kicad_pcb, base.sch, mask.kicad_pcb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]
2017-09-22 Weekly update
    [base.kicad_pcb, base.sch, mask.kicad_pcb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]
2017-10-12 Updating OSH Park Badge
    [trainShield.kicad_pcb, trainShield.sch]
2017-10-24 ChickTech Robot Update
    [Blank_Badge.stl, Caster.stl, Chassis.stl, Pen_Collar.stl, Wheel.stl, base.kicad_pcb, base.sch]
2017-10-25 Updating Docs
    [Blank_Badge.stl, Caster.stl, Chassis.stl, Pen_Collar.stl, Wheel.stl, base.kicad_pcb, base.sch]
2017-10-27 Updating filenames
    [Blank_Badge.stl, Caster.stl, Chassis.stl, Pen_Collar.stl, Wheel.stl, base.kicad_pcb, base.sch]
2017-10-27 Updating file structure
    [Blank_Badge.stl, Caster.stl, Chassis.stl, Pen_Collar.stl, Wheel.stl, base.kicad_pcb, base.sch]
2017-11-10 PiFet 3 Update
    [base.kicad_pcb, base.sch, pizero.kicad_pcb, pizero.sch]
2017-12-27 PiFet Instructable published
    [base.kicad_pcb, base.sch, mask.kicad_pcb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]
2018-01-07 Challenge second Chance card
    [base.kicad_pcb, base.sch, pizero.kicad_pcb]
2018-02-22 Update links
    [base.kicad_pcb, base.sch, clock.kicad_pcb, clock.sch, project.kicad_pcb, project.sch]
2018-03-30 Rename chirp to rroll. Rev 0.3
    [project - v0.kicad_pcb, project - v0.sch, project.kicad_pcb, project.sch]
2018-03-30 rroll to fab
    [project.kicad_pcb]
2018-04-21 OSH Park I Can Solder to manufacture
2018-04-26 TARDIS to fab
    [project.kicad_pcb, project.sch]
2018-05-07 Updated to include licence and BOM.
2018-05-16 Pogo V0.1
    [project.kicad_pcb]
2018-05-16 update schematic
2018-05-17 LED Eyes
    [LEDeyes.kicad_pcb, LEDeyes.sch, LEDeyes2.kicad_pcb, LEDeyes2.sch, edge_cuts2.dxf, edge_cuts3.dxf, noname.kicad_pcb, project.kicad_pcb]
2018-07-22 Update from work laptop
    [LEDeyes-B_Cu.gbl, LEDeyes-B_Mask.gbs, LEDeyes-B_SilkS.gbo, LEDeyes-Edge_Cuts.gm1, LEDeyes-F_Cu.gtl, LEDeyes-F_Mask.gts, LEDeyes-F_SilkS.gto, LEDeyes.drl]
2018-08-17 Toorcon release to fab
    [Bom.csv, project.kicad_pcb, project.sch, test2.kicad_pcb, toorcon2018.kicad_pcb]
2018-08-23 Beetje LiPo to production
    [project.kicad_pcb, project.sch]
2020-02-17 Taris silk screen update
    [combined.GKO, combined.gbl, combined.gbs, combined.gtl, combined.gto, combined.gts, project-B.Cu.gbl, project-B.Mask.gbs]
2021-02-09 Updates, Freecad
    [Imapla_negative.stl, Impala.stl, JST_XSRS breakout.step, Mold.FCStd, Mold_negative.FCStd, Uris_negative.stl, Urus.stl, board.FCStd]
2021-03-31 updates :
    [pizza.FCStd, pizza.stl, pizza2.stl, pizza3.stl, pizza4.stl]
2022-05-10 to the FAB!
    [project-2021-12-05-11-35-00.sch, project.kicad_pcb, project.sch]
