aspro648/KiCad/(notices)

Notices in the files:
projects/tester/UCT3/design_files26/3D/C_1206_3216Metric.step:
Copyright (C) 2017, kicad StepUp
This work is licensed under the [Creative Commons CC-BY-SA 4.0 License](https://creativecommons.org/licenses/by-sa/4.0/legalcode),
with the following exception:
To the extent that the creation of electronic designs that use 'Licensed Material' can be considered to be 'Adapted Material',
You are free to use the library data in your own projects without the obligation to share your project files under this or any other license agreement.
projects/tester/RPB/Board/3D/R_0603_1608Metric.step:
Copyright (C) 2018, kicad StepUp
projects/tester/RPB/Board/3D/MEC6-110-02-L-D-RA1-TR.step:
author */ ('License CC BY-ND 4.0'),
parts and their libraries:
Copyright 2016 Accelerated Designs. All rights reserved.
